bradgrantham/griffin/image-tools/smurf-assets/src/backdrop2-forest.png

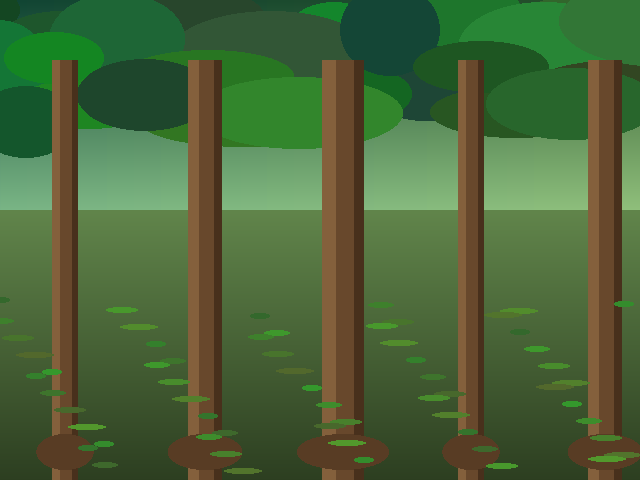
image-tools/smurf-assets/src/backdrop2-forest.png
