bradgrantham/griffin/image-tools/smurf-assets/backdrop1-meadow-preview.png

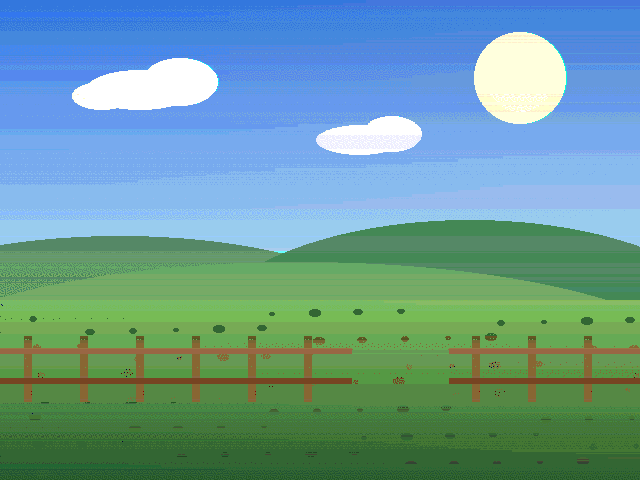
image-tools/smurf-assets/backdrop1-meadow-preview.png
