bradgrantham/griffin/README.md

# m68k-leftovers

An M68000 homebrew SBC.  See the [design notes](griffin.yml).
