bradgrantham/griffin/cpld/compositor/compositor_fit_report.txt

========================================================================
ATF1508 Fitter Report
========================================================================

UTILIZATION SUMMARY
----------------------------------------
  dedicated input                 2/4 	(50%)
  I/O pins                        64/64 	(100%)
  Logic cells                     122/128 	(95%)
  Flip-Flop                       95/128 	(74%)
  Foldback logic                  21/128 	(16%)
  Nodes+FB/MCells                 143/128 	(111%)
  cascade                         0
  input pins                      36
  output pins                     30
  Pts                             389

PER-LAB PLACEMENT
------------------------------------------------------------------------
  LAB A (MC 1-16):  29/16 used  (8 pin, 15 feedback, 6 foldback)  fan-in: 36/40
    MC  3  pin 12  VIDCMD_Q_15
    MC  5  pin 11  VIDCMD_Q_14
    MC  6  pin 10  VIDCMD_Q_9
    MC  8  pin  9  VIDCMD_Q_7
    MC 11  pin  8  RGB_IN_2
    MC 13  pin  6  RGB_IN_1
    MC 14  pin  5  H_ACTIVE
    MC 16  pin  4  set_pix_commit
    MC  1  feedback  staged_word_14
    MC  2  feedback  abc:n321
    MC  3  feedback  XXL_1025
    MC  4  feedback  abc:n341
    MC  5  feedback  sav_src_1
    MC  6  feedback  XXL_1021
    MC  7  feedback  staged_word_9
    MC  8  feedback  staged_word_11
    MC  9  feedback  abc:n325 (QN)
    MC 10  feedback  w_is_set
    MC 11  feedback  abc:n310 (QN)
    MC 12  feedback  abc:n644 (QN)
    MC 13  feedback  XXL_1017
    MC 14  feedback  staged_word_12
    MC 15  feedback  mask_active
    MC  1  FOLDBACK  abc:n340  [from id00117Q]
    MC  7  FOLDBACK  abc:n329 (QN)  [from id00106QN]
    MC  8  FOLDBACK  abc:n293 (QN)  [from id00071QN]
    MC 10  FOLDBACK  abc:n339  [from id00116Q]
    MC 11  FOLDBACK  abc:n295 (QN)  [from id00073QN]
    MC 12  FOLDBACK  abc:n287 (QN)  [from id00065QN]

  LAB B (MC 17-32):  25/16 used  (8 pin, 13 feedback, 4 foldback)  fan-in: 39/40
    MC 17  pin 22  RGB_IN_0
    MC 19  pin 21  RGB_IN_3
    MC 21  pin 20  RGB_IN_4
    MC 24  pin 18  RGB_IN_5
    MC 25  pin 17  RGB_IN_8
    MC 27  pin 16  RGB_IN_7
    MC 29  pin 15  RGB_IN_9
    MC 32  pin 14  TDI
    MC 20  feedback  h_active_d
    MC 21  feedback  staged_word_13
    MC 22  feedback  XXL_1024
    MC 23  feedback  staged_word_3
    MC 24  feedback  abc:n622
    MC 25  feedback  staged_word_5
    MC 26  feedback  staged_word_6
    MC 27  feedback  abc:n609
    MC 28  feedback  cur_src_0
    MC 29  feedback  staged_word_4
    MC 30  feedback  staged_word_2
    MC 31  feedback  abc:n611
    MC 32  feedback  cur_src_1
    MC 29  FOLDBACK  abc:n293 (QN)  [from id00071QN]
    MC 30  FOLDBACK  abc:n340  [from id00117Q]
    MC 31  FOLDBACK  abc:n339  [from id00116Q]
    MC 32  FOLDBACK  abc:n295 (QN)  [from id00073QN]

  LAB C (MC 33-48):  23/16 used  (8 pin, 12 feedback, 3 foldback)  fan-in: 39/40
    MC 35  pin 31  RGB_IN_11
    MC 37  pin 30  RGB_IN_10
    MC 38  pin 29  RGB_IN_6
    MC 40  pin 28  nVIDCMD_RE
    MC 43  pin 27  set_pix_value_7
    MC 45  pin 25  set_pix_target_2
    MC 46  pin 24  set_pix_valid
    MC 48  pin 23  TMS
    MC 33  feedback  ef_at_pop
    MC 34  feedback  staged_word_1
    MC 35  feedback  $abc$1392$nVIDCMD_RE
    MC 36  feedback  abc:n631 (QN)
    MC 37  feedback  abc:n308
    MC 38  feedback  staged_word_7
    MC 39  feedback  staged_word_10
    MC 41  feedback  run_count_0
    MC 42  feedback  run_count_1
    MC 44  feedback  abc:n650
    MC 47  feedback  abc:n653
    MC 48  feedback  XXL_1018
    MC 45  FOLDBACK  abc:n340  [from id00117Q]
    MC 46  FOLDBACK  abc:n339  [from id00116Q]
    MC 47  FOLDBACK  abc:n295 (QN)  [from id00073QN]

  LAB D (MC 49-64):  27/16 used  (8 pin, 13 feedback, 6 foldback)  fan-in: 39/40
    MC 49  pin 41  VIDCMD_Q_4
    MC 51  pin 40  VIDCMD_Q_2
    MC 53  pin 39  VIDCMD_Q_3
    MC 56  pin 37  VIDCMD_Q_6
    MC 57  pin 36  VIDCMD_Q_1
    MC 59  pin 35  VIDCMD_Q_5
    MC 61  pin 34  nVIDCMD_EF
    MC 64  pin 33  VIDCMD_Q_12
    MC 50  feedback  sav_src_0
    MC 52  feedback  cmp_color1_3
    MC 53  feedback  cmp_color1_2
    MC 54  feedback  cmp_color1_4
    MC 55  feedback  staged_word_0
    MC 56  feedback  abc:n617 (QN)
    MC 57  feedback  have_staged
    MC 59  feedback  staged_word_8
    MC 60  feedback  XXL_1023
    MC 61  feedback  XXL_1019
    MC 62  feedback  XXL_1020
    MC 63  feedback  run_count_3
    MC 64  feedback  XXL_1022
    MC 50  FOLDBACK  abc:n295 (QN)  [from id00073QN]
    MC 54  FOLDBACK  abc:n329 (QN)  [from id00106QN]
    MC 55  FOLDBACK  abc:n293 (QN)  [from id00071QN]
    MC 56  FOLDBACK  abc:n340  [from id00117Q]
    MC 57  FOLDBACK  abc:n339  [from id00116Q]
    MC 59  FOLDBACK  abc:n287 (QN)  [from id00065QN]

  LAB E (MC 65-80):  16/16 used  (8 pin, 8 feedback, 0 foldback)  fan-in: 39/40
    MC 65  pin 44  RGB_OUT_7
    MC 67  pin 45  RGB_OUT_8
    MC 69  pin 46  RGB_OUT_5
    MC 72  pin 48  RGB_OUT_4
    MC 73  pin 49  RGB_OUT_3
    MC 75  pin 50  RGB_OUT_0
    MC 77  pin 51  RGB_OUT_1
    MC 80  pin 52  RGB_OUT_2
    MC 66  feedback  cmp_color0_1
    MC 68  feedback  cmp_color0_5
    MC 70  feedback  cmp_color0_2
    MC 71  feedback  cmp_color1_8
    MC 74  feedback  cmp_color1_0
    MC 76  feedback  cmp_color1_7
    MC 78  feedback  cmp_color1_1
    MC 79  feedback  cmp_color1_5

  LAB F (MC 81-96):  18/16 used  (8 pin, 9 feedback, 1 foldback)  fan-in: 32/40
    MC 83  pin 54  set_pix_value_3
    MC 85  pin 55  set_pix_value_1
    MC 86  pin 56  set_pix_value_2
    MC 88  pin 57  RGB_OUT_6
    MC 91  pin 58  RGB_OUT_10
    MC 93  pin 60  RGB_OUT_11
    MC 94  pin 61  RGB_OUT_9
    MC 96  pin 62  TCK
    MC 81  feedback  cmp_color1_10
    MC 82  feedback  run_count_5
    MC 84  feedback  run_count_9
    MC 87  feedback  run_count_10
    MC 89  feedback  run_count_6
    MC 90  feedback  run_count_11
    MC 92  feedback  run_count_7
    MC 95  feedback  XXL_1027
    MC 96  feedback  XXL_1026
    MC 94  FOLDBACK  abc:n645  [from id00422Q]

  LAB G (MC 97-112):  23/16 used  (8 pin, 14 feedback, 1 foldback)  fan-in: 38/40
    MC 97  pin 63  VIDCMD_Q_10
    MC 99  pin 64  VIDCMD_Q_11
    MC101  pin 65  VIDCMD_Q_8
    MC104  pin 67  VIDCMD_Q_13
    MC105  pin 68  VIDCMD_Q_0
    MC107  pin 69  set_pix_value_0
    MC109  pin 70  set_pix_value_5
    MC112  pin 71  TDO
    MC 97  feedback  cmp_color0_0
    MC 98  feedback  cmp_color0_6
    MC 99  feedback  cmp_color1_11
    MC100  feedback  cmp_color0_9
    MC101  feedback  abc:n634 (QN)
    MC102  feedback  cmp_color0_10
    MC103  feedback  cur_colour_0
    MC104  feedback  cmp_color1_6
    MC105  feedback  cur_colour_2
    MC106  feedback  cmp_color1_9
    MC108  feedback  cur_colour_1
    MC110  feedback  cmp_color0_11
    MC111  feedback  cmp_color0_8
    MC112  feedback  abc:n627 (QN)
    MC112  FOLDBACK  abc:n340  [from id00117Q]

  LAB H (MC 113-128):  16/16 used  (8 pin, 8 feedback, 0 foldback)  fan-in: 22/40
    MC115  pin 73  set_pix_value_11
    MC117  pin 74  set_pix_value_10
    MC118  pin 75  set_pix_value_8
    MC120  pin 76  set_pix_value_9
    MC123  pin 77  set_pix_value_6
    MC125  pin 79  set_pix_value_4
    MC126  pin 80  set_pix_target_1
    MC128  pin 81  set_pix_target_0
    MC113  feedback  ef_sync
    MC114  feedback  ef_meta
    MC116  feedback  run_count_8
    MC119  feedback  run_count_2
    MC121  feedback  cmp_color0_7
    MC122  feedback  cmp_color0_3
    MC124  feedback  cmp_color0_4
    MC127  feedback  run_count_4

FOLDBACK ANALYSIS
------------------------------------------------------------------------
  Total foldbacks: 21

  Signals replicated as foldbacks (most replicas first):

    abc:n340                                  5 copies  in LABs: A, B, C, D, G
      consumed by: abc:n617 (QN), abc:n631 (QN), abc:n634 (QN), abc:n627 (QN), abc:n650, abc:n644 (QN), abc:n653, cur_colour_2.D ... +11 more

    abc:n339                                  4 copies  in LABs: A, B, C, D
      consumed by: abc:n609, abc:n611, run_count_1.D, abc:n622, abc:n341, run_count_3.D, XXL_1018, XXL_1019 ... +3 more

    abc:n295 (QN)                             4 copies  in LABs: A, B, C, D
      consumed by: abc:n609, abc:n308, abc:n611, run_count_1.D, abc:n622, run_count_3.D, XXL_1017, XXL_1018 ... +2 more

    abc:n293 (QN)                             3 copies  in LABs: A, B, D
      consumed by: sav_src_1.D, sav_src_0.D, abc:n341, cur_src_0.D, XXL_1025

    abc:n329 (QN)                             2 copies  in LABs: A, D
      consumed by: have_staged.D, XXL_1021, XXL_1025

    abc:n287 (QN)                             2 copies  in LABs: A, D
      consumed by: mask_active.D, have_staged.D, abc:n341

    abc:n645                                  1 copies  in LABs: F
      consumed by: run_count_10.D, run_count_11.D

  Foldback imports per LAB:

    LAB A: 6 foldback(s)
      - abc:n340
      - abc:n329 (QN)
      - abc:n293 (QN)
      - abc:n339
      - abc:n295 (QN)
      - abc:n287 (QN)
    LAB B: 4 foldback(s)
      - abc:n293 (QN)
      - abc:n340
      - abc:n339
      - abc:n295 (QN)
    LAB C: 3 foldback(s)
      - abc:n340
      - abc:n339
      - abc:n295 (QN)
    LAB D: 6 foldback(s)
      - abc:n295 (QN)
      - abc:n329 (QN)
      - abc:n293 (QN)
      - abc:n340
      - abc:n339
      - abc:n287 (QN)
    LAB F: 1 foldback(s)
      - abc:n645
    LAB G: 1 foldback(s)
      - abc:n340

FAN-IN DETAIL
------------------------------------------------------------------------
  LAB A: 36/40 inputs
    I/O pins (6): H_ACTIVE, VIDCMD_Q_14, VIDCMD_Q_15, VIDCMD_Q_9, VIDCMD_Q_11, VIDCMD_Q_12
    Internal (30):
      run_count_9
      staged_word_14
      abc:n310 (QN)
      staged_word_11
      run_count_3
      sav_src_1
      run_count_10
      staged_word_12
      staged_word_13
      w_is_set
      abc:n341
      run_count_0
      $abc$1392$nVIDCMD_RE
      run_count_7
      staged_word_9
      run_count_6
      abc:n308
      staged_word_7
      mask_active
      run_count_2
      cur_src_0
      run_count_5
      cur_src_1
      have_staged
      ef_at_pop
      run_count_1
      staged_word_10
      run_count_8
      run_count_11
      run_count_4

  LAB B: 39/40 inputs
    I/O pins (7): H_ACTIVE, VIDCMD_Q_6, VIDCMD_Q_4, VIDCMD_Q_13, VIDCMD_Q_5, VIDCMD_Q_2, VIDCMD_Q_3
    Internal (32):
      XXL_1021  (unmapped)
      XXL_1025  (unmapped)
      staged_word_3
      staged_word_14
      abc:n310 (QN)
      staged_word_11
      sav_src_1
      mask_active
      run_count_3
      staged_word_1
      staged_word_6
      w_is_set
      run_count_10
      run_count_1
      sav_src_0
      staged_word_2
      abc:n341
      run_count_0
      abc:n308
      have_staged
      staged_word_5
      run_count_5
      run_count_6
      staged_word_13
      staged_word_0
      run_count_11
      run_count_9
      staged_word_4
      run_count_8
      run_count_7
      run_count_2
      run_count_4

  LAB C: 39/40 inputs
    I/O pins (6): H_ACTIVE, VIDCMD_Q_7, VIDCMD_Q_10, VIDCMD_Q_1, nRS, nVIDCMD_EF
    Internal (33):
      XXL_1017  (unmapped)
      XXL_1018  (unmapped)
      ef_sync
      run_count_6
      staged_word_14
      staged_word_1
      mask_active
      staged_word_11
      abc:n310 (QN)
      run_count_10
      run_count_1
      $abc$1392$nVIDCMD_RE
      w_is_set
      run_count_9
      staged_word_8
      run_count_3
      abc:n308
      run_count_7
      staged_word_7
      run_count_0
      run_count_2
      staged_word_12
      staged_word_13
      run_count_4
      run_count_8
      have_staged
      run_count_5
      abc:n609
      staged_word_10
      run_count_11
      ef_meta
      staged_word_5
      ef_at_pop

  LAB D: 39/40 inputs
    I/O pins (4): H_ACTIVE, VIDCMD_Q_0, VIDCMD_Q_8, nRS
    Internal (35):
      XXL_1020  (unmapped)
      run_count_9
      run_count_0
      abc:n310 (QN)
      staged_word_14
      mask_active
      cmp_color1_2
      run_count_3
      sav_src_0
      staged_word_6
      $abc$1392$nVIDCMD_RE
      w_is_set
      run_count_10
      run_count_1
      cmp_color1_4
      staged_word_5
      staged_word_2
      cmp_color1_3
      staged_word_8
      abc:n308
      have_staged
      ef_at_pop
      abc:n611
      run_count_2
      abc:n321
      run_count_6
      run_count_8
      cur_src_0
      run_count_5
      run_count_11
      staged_word_0
      staged_word_4
      run_count_7
      staged_word_3
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
   4 PTs  staged_word_12.D
   4 PTs  staged_word_2.D
   4 PTs  staged_word_5.D
   4 PTs  staged_word_3.D
   4 PTs  staged_word_4.D
   4 PTs  staged_word_7.D
   4 PTs  staged_word_6.D
   4 PTs  staged_word_8.D
   4 PTs  run_count_3.D
   4 PTs  cur_src_1.D
   4 PTs  run_count_7.D

ALL EQUATIONS
------------------------------------------------------------------------
  [ 1 PTs]  nVIDCMD_RE = $abc$1392$nVIDCMD_RE
  [ 1 PTs]  set_pix_target_0.D = staged_word_12
  [ 1 PTs]  set_pix_target_1.D = staged_word_13
  [ 1 PTs]  set_pix_value_0.D = staged_word_0
  [ 1 PTs]  set_pix_value_1.D = staged_word_1
  [ 1 PTs]  set_pix_value_3.D = staged_word_3
  [ 1 PTs]  set_pix_value_2.D = staged_word_2
  [ 1 PTs]  set_pix_value_4.D = staged_word_4
  [ 1 PTs]  set_pix_value_5.D = staged_word_5
  [ 1 PTs]  set_pix_value_6.D = staged_word_6
  [ 1 PTs]  set_pix_value_7.D = staged_word_7
  [ 1 PTs]  set_pix_value_8.D = staged_word_8
  [ 1 PTs]  set_pix_value_9.D = staged_word_9
  [ 1 PTs]  set_pix_value_10.D = staged_word_10
  [ 1 PTs]  h_active_d.D = H_ACTIVE
  [ 1 PTs]  ef_meta.D = nVIDCMD_EF
  [ 1 PTs]  ef_sync.D = ef_meta
  [ 1 PTs]  set_pix_target_2.D = staged_word_14
  [ 1 PTs]  set_pix_value_11.D = staged_word_11
  [ 2 PTs]  ef_at_pop.D = (ef_at_pop # ($abc$1392$nVIDCMD_RE & ef_meta & ef_sync & nVIDCMD_EF))
  [ 3 PTs]  set_pix_valid.D = ((have_staged & !staged_word_14 & w_is_set & staged_word_13) # (have_staged & staged_word_14 & w_is_set & !staged_word_12) # (have_staged & staged_word_14 & w_is_set & !staged_word_13))
  [ 4 PTs]  abc:n310 (QN) = ((run_count_0 & run_count_1 & run_count_2 & run_count_3 & run_count_9 & run_count_4 & run_count_5 & run_count_10 & run_count_6 & run_count_11 & run_count_7 & run_count_8) # (run_count_0 & run_count_1 & run_count_2 & !run_count_3 & mask_active & !ef_at_pop) # (run_count_0 & run_count_1 & run_count_2 & !run_count_3 & mask_active & $abc$1392$nVIDCMD_RE) # !H_ACTIVE)
  [ 2 PTs]  mask_active.D = ((mask_active & abc:n287 (QN)QN) # (H_ACTIVE & run_count_9 & !w_is_set & staged_word_14 & run_count_0 & run_count_1 & run_count_2 & run_count_3 & run_count_4 & run_count_5 & run_count_10 & run_count_6 & have_staged & run_count_11 & run_count_7 & run_count_8))
  [ 2 PTs]  abc:n609 = ((run_count_0 & abc:n295 (QN)QN & staged_word_0) # (run_count_0 & abc:n295 (QN)QN & abc:n339Q))
  [ 3 PTs]  abc:n617 (QN) = ((run_count_5 & abc:n340Q) # (H_ACTIVE & run_count_9 & !w_is_set & run_count_0 & run_count_1 & run_count_2 & run_count_3 & run_count_4 & run_count_5 & run_count_10 & run_count_6 & have_staged & run_count_11 & run_count_7 & run_count_8 & staged_word_5) # (H_ACTIVE & run_count_9 & !w_is_set & staged_word_14 & run_count_0 & run_count_1 & run_count_2 & run_count_3 & run_count_4 & run_count_5 & run_count_10 & run_count_6 & have_staged & run_count_11 & run_count_7 & run_count_8))
  [ 3 PTs]  abc:n631 (QN) = ((run_count_7 & staged_word_7 & H_ACTIVE & run_count_9 & !w_is_set & run_count_0 & run_count_1 & run_count_2 & run_count_3 & run_count_4 & run_count_5 & run_count_10 & run_count_6 & have_staged & run_count_11 & run_count_8) # (run_count_7 & H_ACTIVE & run_count_9 & !w_is_set & staged_word_14 & run_count_0 & run_count_1 & run_count_2 & run_count_3 & run_count_4 & run_count_5 & run_count_10 & run_count_6 & have_staged & run_count_11 & run_count_8) # (run_count_7 & abc:n340Q))
  [ 3 PTs]  abc:n634 (QN) = ((run_count_6 & staged_word_6 & H_ACTIVE & run_count_9 & !w_is_set & run_count_0 & run_count_1 & run_count_2 & run_count_3 & run_count_4 & run_count_5 & run_count_10 & have_staged & run_count_11 & run_count_7 & run_count_8) # (run_count_6 & H_ACTIVE & run_count_9 & !w_is_set & staged_word_14 & run_count_0 & run_count_1 & run_count_2 & run_count_3 & run_count_4 & run_count_5 & run_count_10 & have_staged & run_count_11 & run_count_7 & run_count_8) # (run_count_6 & abc:n340Q))
  [ 3 PTs]  abc:n627 (QN) = ((run_count_8 & abc:n340Q) # (H_ACTIVE & run_count_9 & !w_is_set & run_count_0 & run_count_1 & run_count_2 & run_count_3 & run_count_4 & run_count_5 & run_count_10 & run_count_6 & have_staged & run_count_11 & run_count_7 & run_count_8 & staged_word_8) # (H_ACTIVE & run_count_9 & !w_is_set & staged_word_14 & run_count_0 & run_count_1 & run_count_2 & run_count_3 & run_count_4 & run_count_5 & run_count_10 & run_count_6 & have_staged & run_count_11 & run_count_7 & run_count_8))
  [ 4 PTs]  abc:n650 = ((run_count_11 & !w_is_set & staged_word_12 & staged_word_13 & !staged_word_14) # (run_count_11 & !w_is_set & staged_word_14 & H_ACTIVE & run_count_9 & run_count_0 & run_count_1 & run_count_2 & run_count_3 & run_count_4 & run_count_5 & run_count_10 & run_count_6 & have_staged & run_count_7 & run_count_8) # (run_count_11 & staged_word_11) # (run_count_11 & abc:n340Q))
  [ 4 PTs]  abc:n644 (QN) = ((run_count_9 & !w_is_set & !staged_word_14 & staged_word_12 & staged_word_13) # (run_count_9 & abc:n340Q) # (run_count_9 & staged_word_9) # (H_ACTIVE & run_count_9 & !w_is_set & staged_word_14 & run_count_0 & run_count_1 & run_count_2 & run_count_3 & run_count_4 & run_count_5 & run_count_10 & run_count_6 & have_staged & run_count_11 & run_count_7 & run_count_8))
  [ 4 PTs]  abc:n653 = ((run_count_10 & !w_is_set & staged_word_12 & staged_word_13 & !staged_word_14) # (run_count_10 & !w_is_set & staged_word_14 & H_ACTIVE & run_count_9 & run_count_0 & run_count_1 & run_count_2 & run_count_3 & run_count_4 & run_count_5 & run_count_6 & have_staged & run_count_11 & run_count_7 & run_count_8) # (run_count_10 & staged_word_10) # (run_count_10 & abc:n340Q))
  [ 4 PTs]  RGB_OUT_2.D = ((h_active_d & cur_src_0 & !cur_src_1 & cmp_color1_2) # (h_active_d & cur_src_0 & cur_src_1 & cur_colour_0) # (h_active_d & !cur_src_0 & !cur_src_1 & RGB_IN_2) # (h_active_d & !cur_src_0 & cur_src_1 & cmp_color0_2))
  [ 4 PTs]  RGB_OUT_0.D = ((h_active_d & cur_src_0 & !cur_src_1 & cmp_color1_0) # (h_active_d & cur_src_0 & cur_src_1 & cur_colour_0) # (h_active_d & !cur_src_0 & !cur_src_1 & RGB_IN_0) # (h_active_d & !cur_src_0 & cur_src_1 & cmp_color0_0))
  [ 4 PTs]  RGB_OUT_1.D = ((h_active_d & cur_src_0 & !cur_src_1 & cmp_color1_1) # (h_active_d & cur_src_0 & cur_src_1 & cur_colour_0) # (h_active_d & !cur_src_0 & !cur_src_1 & RGB_IN_1) # (h_active_d & !cur_src_0 & cur_src_1 & cmp_color0_1))
  [ 4 PTs]  RGB_OUT_5.D = ((h_active_d & cur_src_0 & !cur_src_1 & cmp_color1_5) # (h_active_d & cur_src_0 & cur_src_1 & cur_colour_1) # (h_active_d & !cur_src_0 & !cur_src_1 & RGB_IN_5) # (h_active_d & !cur_src_0 & cur_src_1 & cmp_color0_5))
  [ 4 PTs]  RGB_OUT_3.D = ((h_active_d & cur_src_0 & !cur_src_1 & cmp_color1_3) # (h_active_d & !cur_src_0 & cur_src_1 & cmp_color0_3) # (h_active_d & cur_src_0 & cur_src_1 & cur_colour_0) # (h_active_d & !cur_src_0 & !cur_src_1 & RGB_IN_3))
  [ 4 PTs]  RGB_OUT_4.D = ((h_active_d & cur_src_0 & !cur_src_1 & cmp_color1_4) # (h_active_d & cur_src_0 & cur_src_1 & cur_colour_1) # (h_active_d & !cur_src_0 & !cur_src_1 & RGB_IN_4) # (h_active_d & !cur_src_0 & cur_src_1 & cmp_color0_4))
  [ 4 PTs]  RGB_OUT_8.D = ((h_active_d & cur_src_0 & !cur_src_1 & cmp_color1_8) # (h_active_d & cur_src_0 & cur_src_1 & cur_colour_2) # (h_active_d & !cur_src_0 & !cur_src_1 & RGB_IN_8) # (h_active_d & !cur_src_0 & cur_src_1 & cmp_color0_8))
  [ 4 PTs]  RGB_OUT_6.D = ((h_active_d & cur_src_0 & !cur_src_1 & cmp_color1_6) # (h_active_d & cur_src_0 & cur_src_1 & cur_colour_1) # (h_active_d & !cur_src_0 & !cur_src_1 & RGB_IN_6) # (h_active_d & !cur_src_0 & cur_src_1 & cmp_color0_6))
  [ 4 PTs]  RGB_OUT_7.D = ((h_active_d & cur_src_0 & !cur_src_1 & cmp_color1_7) # (h_active_d & !cur_src_0 & cur_src_1 & cmp_color0_7) # (h_active_d & cur_src_0 & cur_src_1 & cur_colour_1) # (h_active_d & !cur_src_0 & !cur_src_1 & RGB_IN_7))
  [ 4 PTs]  RGB_OUT_9.D = ((h_active_d & cur_src_0 & !cur_src_1 & cmp_color1_9) # (h_active_d & cur_src_0 & cur_src_1 & cur_colour_2) # (h_active_d & !cur_src_0 & !cur_src_1 & RGB_IN_9) # (h_active_d & !cur_src_0 & cur_src_1 & cmp_color0_9))
  [ 4 PTs]  RGB_OUT_10.D = ((h_active_d & cur_src_0 & !cur_src_1 & cmp_color1_10) # (h_active_d & !cur_src_0 & cur_src_1 & cmp_color0_10) # (h_active_d & cur_src_0 & cur_src_1 & cur_colour_2) # (h_active_d & !cur_src_0 & !cur_src_1 & RGB_IN_10))
  [ 4 PTs]  RGB_OUT_11.D = ((h_active_d & cur_src_0 & !cur_src_1 & cmp_color1_11) # (h_active_d & cur_src_0 & cur_src_1 & cur_colour_2) # (h_active_d & !cur_src_0 & !cur_src_1 & RGB_IN_11) # (h_active_d & !cur_src_0 & cur_src_1 & cmp_color0_11))
  [ 2 PTs]  cur_colour_2.D = ((abc:n340Q & cur_colour_2) # (staged_word_11 & H_ACTIVE & run_count_9 & !w_is_set & !staged_word_14 & run_count_0 & run_count_1 & run_count_2 & run_count_3 & run_count_4 & run_count_5 & run_count_10 & run_count_6 & have_staged & run_count_11 & run_count_7 & run_count_8))
  [ 3 PTs]  abc:n308 = ((ef_at_pop & !$abc$1392$nVIDCMD_RE & abc:n295 (QN)QN & run_count_9 & run_count_0 & run_count_1 & run_count_2 & run_count_3 & run_count_4 & run_count_5 & run_count_10 & run_count_6 & run_count_11 & run_count_7 & run_count_8 & !have_staged) # (ef_at_pop & !$abc$1392$nVIDCMD_RE & abc:n295 (QN)QN & H_ACTIVE & run_count_9 & run_count_0 & run_count_1 & run_count_2 & run_count_3 & run_count_4 & run_count_5 & run_count_10 & run_count_6 & run_count_11 & run_count_7 & run_count_8) # XXL_1017)
  [ 2 PTs]  cur_colour_0.D = ((abc:n340Q & cur_colour_0) # (staged_word_9 & H_ACTIVE & run_count_9 & !w_is_set & !staged_word_14 & run_count_0 & run_count_1 & run_count_2 & run_count_3 & run_count_4 & run_count_5 & run_count_10 & run_count_6 & have_staged & run_count_11 & run_count_7 & run_count_8))
  [ 2 PTs]  cur_colour_1.D = ((abc:n340Q & cur_colour_1) # (staged_word_10 & H_ACTIVE & run_count_9 & !w_is_set & !staged_word_14 & run_count_0 & run_count_1 & run_count_2 & run_count_3 & run_count_4 & run_count_5 & run_count_10 & run_count_6 & have_staged & run_count_11 & run_count_7 & run_count_8))
  [ 3 PTs]  sav_src_1.D = ((sav_src_1 & abc:n293 (QN)QN) # (!mask_active & cur_src_1 & H_ACTIVE & !w_is_set & staged_word_14 & have_staged & run_count_6 & run_count_5 & run_count_4 & run_count_11 & run_count_10 & run_count_9 & run_count_8 & run_count_7 & run_count_0 & run_count_2 & run_count_1 & run_count_3) # (mask_active & sav_src_1))
  [ 3 PTs]  sav_src_0.D = ((sav_src_0 & abc:n293 (QN)QN) # (!mask_active & cur_src_0 & H_ACTIVE & !w_is_set & staged_word_14 & have_staged & run_count_6 & run_count_5 & run_count_4 & run_count_11 & run_count_10 & run_count_9 & run_count_8 & run_count_7 & run_count_0 & run_count_2 & run_count_1 & run_count_3) # (mask_active & sav_src_0))
  [ 2 PTs]  abc:n321 = ((!staged_word_13 & !staged_word_14 & w_is_set & have_staged & !staged_word_12 & !H_ACTIVE) # (!staged_word_13 & !staged_word_14 & w_is_set & have_staged & !staged_word_12 & run_count_9 & run_count_0 & run_count_1 & run_count_2 & run_count_3 & run_count_4 & run_count_5 & run_count_10 & run_count_6 & run_count_11 & run_count_7 & run_count_8))
  [ 2 PTs]  abc:n325 (QN) = ((w_is_set & staged_word_12 & !staged_word_13 & !staged_word_14 & have_staged & run_count_9 & run_count_0 & run_count_1 & run_count_2 & run_count_3 & run_count_4 & run_count_5 & run_count_10 & run_count_6 & run_count_11 & run_count_7 & run_count_8) # (w_is_set & staged_word_12 & !staged_word_13 & !staged_word_14 & have_staged & !H_ACTIVE))
  [ 4 PTs]  w_is_set.D = ((!abc:n308Q & w_is_set & abc:n310 (QN)QN) # (!abc:n308Q & mask_active & !abc:n310 (QN)QN & staged_word_13) # (abc:n308Q & VIDCMD_Q_15) # (!abc:n308Q & !mask_active & w_is_set))
  [ 4 PTs]  abc:n611 = ((run_count_1 & abc:n295 (QN)QN & run_count_0 & staged_word_1 & staged_word_0 & !abc:n310 (QN)QN) # (run_count_1 & abc:n295 (QN)QN & run_count_0 & abc:n339Q & !abc:n310 (QN)QN) # (run_count_1 & abc:n295 (QN)QN & run_count_0 & H_ACTIVE & run_count_9 & !w_is_set & !staged_word_14 & run_count_2 & run_count_3 & run_count_4 & run_count_5 & run_count_10 & run_count_6 & have_staged & run_count_11 & run_count_7 & run_count_8 & staged_word_1 & staged_word_0) # (run_count_1 & abc:n295 (QN)QN & run_count_0 & abc:n339Q & H_ACTIVE & run_count_9 & !w_is_set & !staged_word_14 & run_count_2 & run_count_3 & run_count_4 & run_count_5 & run_count_10 & run_count_6 & have_staged & run_count_11 & run_count_7 & run_count_8))
  [ 3 PTs]  run_count_0.D = ((!abc:n609Q & H_ACTIVE & run_count_9 & !w_is_set & !staged_word_14 & run_count_0 & run_count_1 & run_count_2 & run_count_3 & run_count_4 & run_count_5 & run_count_10 & run_count_6 & have_staged & run_count_11 & run_count_7 & run_count_8) # (!abc:n609Q & !abc:n310 (QN)QN) # (abc:n609Q & abc:n310 (QN)QN & abc:n340Q))
  [ 4 PTs]  staged_word_13.D = ((!abc:n308Q & staged_word_13 & abc:n310 (QN)QN) # (!abc:n308Q & mask_active & !abc:n310 (QN)QN & staged_word_11) # (abc:n308Q & VIDCMD_Q_13) # (!abc:n308Q & !mask_active & staged_word_13))
  [ 4 PTs]  staged_word_14.D = ((!abc:n308Q & staged_word_14 & abc:n310 (QN)QN) # (!abc:n308Q & mask_active & !abc:n310 (QN)QN & staged_word_12) # (abc:n308Q & VIDCMD_Q_14) # (!abc:n308Q & !mask_active & staged_word_14))
  [ 3 PTs]  have_staged.D = ((!abc:n308Q & have_staged & !H_ACTIVE & !w_is_set) # (!abc:n308Q & have_staged & H_ACTIVE & abc:n287 (QN)QN) # (abc:n308Q & abc:n329 (QN)QN))
  [ 3 PTs]  run_count_1.D = ((!abc:n609Q & run_count_1 & abc:n295 (QN)QN & abc:n339Q) # (abc:n609Q & !run_count_1 & !abc:n310 (QN)QN) # XXL_1018)
  [ 3 PTs]  abc:n622 = ((run_count_0 & run_count_1 & run_count_2 & run_count_3 & abc:n295 (QN)QN & run_count_4 & abc:n340Q & !abc:n310 (QN)QN & abc:n339Q) # (run_count_0 & run_count_1 & run_count_2 & run_count_3 & abc:n295 (QN)QN & staged_word_0 & staged_word_1 & staged_word_2 & staged_word_3 & run_count_4 & abc:n340Q & !abc:n310 (QN)QN) # (run_count_0 & run_count_1 & run_count_2 & run_count_3 & abc:n295 (QN)QN & staged_word_0 & staged_word_1 & staged_word_2 & staged_word_3 & run_count_4 & staged_word_4 & H_ACTIVE & run_count_9 & !w_is_set & !staged_word_14 & run_count_5 & run_count_10 & run_count_6 & have_staged & run_count_11 & run_count_7 & run_count_8))
  [ 2 PTs]  abc:n341 = ((abc:n293 (QN)QN & abc:n339Q & !mask_active) # (abc:n293 (QN)QN & abc:n339Q & abc:n310 (QN)QN & abc:n287 (QN)QN))
  [ 2 PTs]  cmp_color0_2.D = ((!abc:n325 (QN)QN & cmp_color0_2) # (abc:n325 (QN)QN & staged_word_2))
  [ 4 PTs]  staged_word_9.D = ((abc:n308Q & VIDCMD_Q_9) # (!abc:n308Q & mask_active & !abc:n310 (QN)QN & staged_word_7) # (!abc:n308Q & staged_word_9 & abc:n310 (QN)QN) # (!abc:n308Q & staged_word_9 & !mask_active))
  [ 4 PTs]  staged_word_10.D = ((abc:n308Q & VIDCMD_Q_10) # (!abc:n308Q & mask_active & !abc:n310 (QN)QN & staged_word_8) # (!abc:n308Q & staged_word_10 & abc:n310 (QN)QN) # (!abc:n308Q & staged_word_10 & !mask_active))
  [ 2 PTs]  cmp_color0_3.D = ((!abc:n325 (QN)QN & cmp_color0_3) # (abc:n325 (QN)QN & staged_word_3))
  [ 4 PTs]  staged_word_11.D = ((abc:n308Q & VIDCMD_Q_11) # (!abc:n308Q & mask_active & !abc:n310 (QN)QN & staged_word_9) # (!abc:n308Q & staged_word_11 & abc:n310 (QN)QN) # (!abc:n308Q & staged_word_11 & !mask_active))
  [ 4 PTs]  staged_word_12.D = ((abc:n308Q & VIDCMD_Q_12) # (!abc:n308Q & mask_active & !abc:n310 (QN)QN & staged_word_10) # (!abc:n308Q & staged_word_12 & abc:n310 (QN)QN) # (!abc:n308Q & staged_word_12 & !mask_active))
  [ 2 PTs]  cmp_color0_5.D = ((!abc:n325 (QN)QN & cmp_color0_5) # (abc:n325 (QN)QN & staged_word_5))
  [ 1 PTs]  run_count_2.D = (XXL_1019)
  [ 2 PTs]  cmp_color0_4.D = ((!abc:n325 (QN)QN & cmp_color0_4) # (abc:n325 (QN)QN & staged_word_4))
  [ 2 PTs]  cmp_color0_8.D = ((!abc:n325 (QN)QN & cmp_color0_8) # (abc:n325 (QN)QN & staged_word_8))
  [ 2 PTs]  cmp_color0_6.D = ((!abc:n325 (QN)QN & cmp_color0_6) # (abc:n325 (QN)QN & staged_word_6))
  [ 2 PTs]  cmp_color0_7.D = ((!abc:n325 (QN)QN & cmp_color0_7) # (abc:n325 (QN)QN & staged_word_7))
  [ 2 PTs]  cmp_color0_10.D = ((!abc:n325 (QN)QN & cmp_color0_10) # (abc:n325 (QN)QN & staged_word_10))
  [ 2 PTs]  cmp_color1_11.D = ((!abc:n321Q & cmp_color1_11) # (abc:n321Q & staged_word_11))
  [ 2 PTs]  cmp_color0_9.D = ((!abc:n325 (QN)QN & cmp_color0_9) # (abc:n325 (QN)QN & staged_word_9))
  [ 2 PTs]  cmp_color1_2.D = ((!abc:n321Q & cmp_color1_2) # (abc:n321Q & staged_word_2))
  [ 2 PTs]  cmp_color1_0.D = ((!abc:n321Q & cmp_color1_0) # (abc:n321Q & staged_word_0))
  [ 2 PTs]  cmp_color1_1.D = ((!abc:n321Q & cmp_color1_1) # (abc:n321Q & staged_word_1))
  [ 2 PTs]  cmp_color1_5.D = ((!abc:n321Q & cmp_color1_5) # (abc:n321Q & staged_word_5))
  [ 2 PTs]  cmp_color1_3.D = ((!abc:n321Q & cmp_color1_3) # (abc:n321Q & staged_word_3))
  [ 2 PTs]  cmp_color1_4.D = ((!abc:n321Q & cmp_color1_4) # (abc:n321Q & staged_word_4))
  [ 2 PTs]  cmp_color1_8.D = ((!abc:n321Q & cmp_color1_8) # (abc:n321Q & staged_word_8))
  [ 2 PTs]  cmp_color1_6.D = ((!abc:n321Q & cmp_color1_6) # (abc:n321Q & staged_word_6))
  [ 2 PTs]  cmp_color1_7.D = ((!abc:n321Q & cmp_color1_7) # (abc:n321Q & staged_word_7))
  [ 2 PTs]  cmp_color1_10.D = ((!abc:n321Q & cmp_color1_10) # (abc:n321Q & staged_word_10))
  [ 2 PTs]  cmp_color0_11.D = ((!abc:n325 (QN)QN & cmp_color0_11) # (abc:n325 (QN)QN & staged_word_11))
  [ 2 PTs]  cmp_color1_9.D = ((!abc:n321Q & cmp_color1_9) # (abc:n321Q & staged_word_9))
  [ 4 PTs]  staged_word_2.D = ((abc:n308Q & VIDCMD_Q_2) # (!abc:n308Q & mask_active & !abc:n310 (QN)QN & staged_word_0) # (!abc:n308Q & staged_word_2 & abc:n310 (QN)QN) # (!abc:n308Q & staged_word_2 & !mask_active))
  [ 3 PTs]  staged_word_0.D = ((!abc:n308Q & staged_word_0 & abc:n310 (QN)QN) # (!abc:n308Q & staged_word_0 & !mask_active) # (abc:n308Q & VIDCMD_Q_0))
  [ 3 PTs]  staged_word_1.D = ((!abc:n308Q & staged_word_1 & abc:n310 (QN)QN) # (!abc:n308Q & staged_word_1 & !mask_active) # (abc:n308Q & VIDCMD_Q_1))
  [ 4 PTs]  staged_word_5.D = ((abc:n308Q & VIDCMD_Q_5) # (!abc:n308Q & mask_active & !abc:n310 (QN)QN & staged_word_3) # (!abc:n308Q & staged_word_5 & abc:n310 (QN)QN) # (!abc:n308Q & staged_word_5 & !mask_active))
  [ 4 PTs]  staged_word_3.D = ((abc:n308Q & VIDCMD_Q_3) # (!abc:n308Q & mask_active & !abc:n310 (QN)QN & staged_word_1) # (!abc:n308Q & staged_word_3 & abc:n310 (QN)QN) # (!abc:n308Q & staged_word_3 & !mask_active))
  [ 4 PTs]  staged_word_4.D = ((abc:n308Q & VIDCMD_Q_4) # (!abc:n308Q & mask_active & !abc:n310 (QN)QN & staged_word_2) # (!abc:n308Q & staged_word_4 & abc:n310 (QN)QN) # (!abc:n308Q & staged_word_4 & !mask_active))
  [ 4 PTs]  staged_word_7.D = ((abc:n308Q & VIDCMD_Q_7) # (!abc:n308Q & mask_active & !abc:n310 (QN)QN & staged_word_5) # (!abc:n308Q & staged_word_7 & abc:n310 (QN)QN) # (!abc:n308Q & staged_word_7 & !mask_active))
  [ 4 PTs]  staged_word_6.D = ((abc:n308Q & VIDCMD_Q_6) # (!abc:n308Q & mask_active & !abc:n310 (QN)QN & staged_word_4) # (!abc:n308Q & staged_word_6 & abc:n310 (QN)QN) # (!abc:n308Q & staged_word_6 & !mask_active))
  [ 2 PTs]  cmp_color0_0.D = ((!abc:n325 (QN)QN & cmp_color0_0) # (abc:n325 (QN)QN & staged_word_0))
  [ 4 PTs]  staged_word_8.D = ((abc:n308Q & VIDCMD_Q_8) # (!abc:n308Q & mask_active & !abc:n310 (QN)QN & staged_word_6) # (!abc:n308Q & staged_word_8 & abc:n310 (QN)QN) # (!abc:n308Q & staged_word_8 & !mask_active))
  [ 2 PTs]  cmp_color0_1.D = ((!abc:n325 (QN)QN & cmp_color0_1) # (abc:n325 (QN)QN & staged_word_1))
  [ 4 PTs]  run_count_3.D = ((run_count_3 & abc:n295 (QN)QN & !abc:n611Q & abc:n339Q) # (!run_count_3 & abc:n295 (QN)QN & abc:n611Q & run_count_2 & staged_word_2) # (!run_count_3 & abc:n295 (QN)QN & abc:n611Q & run_count_2 & abc:n339Q) # XXL_1020)
  [ 4 PTs]  cur_src_1.D = ((!abc:n341Q & !mask_active & sav_src_1 & abc:n340Q) # (!abc:n341Q & staged_word_13 & H_ACTIVE & run_count_9 & !w_is_set & run_count_0 & run_count_1 & run_count_2 & run_count_3 & run_count_4 & run_count_5 & run_count_10 & run_count_6 & have_staged & run_count_11 & run_count_7 & run_count_8 & abc:n310 (QN)QN) # (!abc:n341Q & staged_word_13 & H_ACTIVE & run_count_9 & !w_is_set & run_count_0 & run_count_1 & run_count_2 & run_count_3 & run_count_4 & run_count_5 & run_count_10 & run_count_6 & have_staged & run_count_11 & run_count_7 & run_count_8 & !mask_active) # XXL_1021)
  [ 3 PTs]  run_count_4.D = (XXL_1022 # XXL_1023 # XXL_1024)
  [ 2 PTs]  run_count_5.D = ((!abc:n617 (QN)QN & abc:n622Q) # (abc:n617 (QN)QN & !abc:n622Q))
  [ 3 PTs]  cur_src_0.D = ((!abc:n341Q & abc:n293 (QN)QN & abc:n340Q & sav_src_0 & abc:n310 (QN)QN) # (!abc:n341Q & abc:n293 (QN)QN & abc:n340Q & sav_src_0 & !mask_active) # XXL_1025)
  [ 2 PTs]  run_count_10.D = ((abc:n653Q & abc:n645Q) # (!abc:n653Q & abc:n617 (QN)QN & abc:n622Q & abc:n627 (QN)QN & abc:n631 (QN)QN & abc:n634 (QN)QN & abc:n644 (QN)QN))
  [ 2 PTs]  run_count_9.D = ((abc:n644 (QN)QN & !abc:n622Q) # XXL_1026)
  [ 4 PTs]  run_count_7.D = ((!abc:n631 (QN)QN & abc:n634 (QN)QN & abc:n622Q & abc:n617 (QN)QN) # (abc:n631 (QN)QN & !abc:n617 (QN)QN) # (abc:n631 (QN)QN & !abc:n622Q) # (abc:n631 (QN)QN & !abc:n634 (QN)QN))
  [ 3 PTs]  run_count_6.D = ((!abc:n634 (QN)QN & abc:n622Q & abc:n617 (QN)QN) # (abc:n634 (QN)QN & !abc:n617 (QN)QN) # (abc:n634 (QN)QN & !abc:n622Q))
  [ 3 PTs]  run_count_11.D = ((abc:n650Q & !abc:n653Q) # (!abc:n650Q & abc:n653Q & abc:n617 (QN)QN & abc:n622Q & abc:n627 (QN)QN & abc:n631 (QN)QN & abc:n634 (QN)QN & abc:n644 (QN)QN) # (abc:n650Q & abc:n645Q))
  [ 1 PTs]  run_count_8.D = (XXL_1027)
  [ 5 PTs]  XXL_1017 = ((ef_at_pop & !$abc$1392$nVIDCMD_RE & abc:n295 (QN)QN & !H_ACTIVE & !mask_active & w_is_set) # (ef_at_pop & !$abc$1392$nVIDCMD_RE & abc:n295 (QN)QN & run_count_9 & run_count_0 & run_count_1 & run_count_2 & run_count_3 & run_count_4 & run_count_5 & run_count_10 & run_count_6 & run_count_11 & run_count_7 & run_count_8 & w_is_set) # (ef_at_pop & !$abc$1392$nVIDCMD_RE & H_ACTIVE & run_count_0 & run_count_1 & run_count_2 & !run_count_3 & mask_active & !have_staged) # (ef_at_pop & !$abc$1392$nVIDCMD_RE & H_ACTIVE & !run_count_0 & run_count_1 & run_count_2 & run_count_3 & mask_active & !have_staged) # (ef_at_pop & !$abc$1392$nVIDCMD_RE & abc:n295 (QN)QN & !mask_active & !have_staged))
  [ 5 PTs]  XXL_1018 = ((abc:n609Q & !abc:n310 (QN)QN & H_ACTIVE & run_count_9 & !w_is_set & staged_word_14 & run_count_0 & run_count_2 & run_count_3 & run_count_4 & run_count_5 & run_count_10 & run_count_6 & have_staged & run_count_11 & run_count_7 & run_count_8) # (abc:n609Q & run_count_1 & H_ACTIVE & run_count_9 & !w_is_set & !staged_word_14 & run_count_0 & run_count_2 & run_count_3 & run_count_4 & run_count_5 & run_count_10 & run_count_6 & have_staged & run_count_11 & run_count_7 & run_count_8 & !staged_word_1) # (run_count_1 & abc:n310 (QN)QN & staged_word_1 & abc:n340Q & abc:n295 (QN)QN) # (run_count_1 & abc:n310 (QN)QN & abc:n340Q & abc:n295 (QN)QN & abc:n339Q) # (!abc:n609Q & run_count_1 & staged_word_1 & abc:n295 (QN)QN))
  [ 5 PTs]  XXL_1019 = ((abc:n611Q & !run_count_2) # (abc:n611Q & H_ACTIVE & run_count_9 & !w_is_set & staged_word_14 & run_count_0 & run_count_1 & run_count_3 & run_count_4 & run_count_5 & run_count_10 & run_count_6 & have_staged & run_count_11 & run_count_7 & run_count_8) # (abc:n611Q & H_ACTIVE & run_count_9 & !w_is_set & run_count_0 & run_count_1 & run_count_3 & run_count_4 & run_count_5 & run_count_10 & run_count_6 & have_staged & run_count_11 & run_count_7 & run_count_8 & !staged_word_2) # (!abc:n611Q & abc:n295 (QN)QN & run_count_2 & staged_word_2) # (!abc:n611Q & abc:n295 (QN)QN & run_count_2 & abc:n339Q))
  [ 5 PTs]  XXL_1020 = ((abc:n295 (QN)QN & abc:n611Q & run_count_2 & staged_word_2 & !staged_word_3 & H_ACTIVE & run_count_9 & !w_is_set & !staged_word_14 & run_count_0 & run_count_1 & run_count_4 & run_count_5 & run_count_10 & run_count_6 & have_staged & run_count_11 & run_count_7 & run_count_8) # (run_count_3 & abc:n295 (QN)QN & !run_count_2 & staged_word_3) # (run_count_3 & abc:n295 (QN)QN & !staged_word_2 & staged_word_3 & H_ACTIVE & run_count_9 & !w_is_set & !staged_word_14 & run_count_0 & run_count_1 & run_count_4 & run_count_5 & run_count_10 & run_count_6 & have_staged & run_count_11 & run_count_7 & run_count_8) # (run_count_3 & abc:n295 (QN)QN & !abc:n611Q & staged_word_3) # (run_count_3 & abc:n295 (QN)QN & !run_count_2 & abc:n339Q))
  [ 5 PTs]  XXL_1021 = ((abc:n341Q & cur_src_1) # (!abc:n341Q & H_ACTIVE & run_count_0 & run_count_1 & run_count_2 & !run_count_3 & mask_active & !abc:n310 (QN)QN & VIDCMD_Q_15 & !VIDCMD_Q_14 & ef_at_pop & !$abc$1392$nVIDCMD_RE) # (!abc:n341Q & H_ACTIVE & run_count_9 & !w_is_set & run_count_0 & run_count_1 & run_count_2 & run_count_3 & run_count_4 & run_count_5 & run_count_10 & run_count_6 & have_staged & run_count_11 & run_count_7 & run_count_8 & staged_word_14) # (!abc:n341Q & staged_word_13 & mask_active & !abc:n310 (QN)QN & abc:n329 (QN)QN & !staged_word_12) # (!abc:n341Q & abc:n310 (QN)QN & sav_src_1 & abc:n340Q))
  [ 5 PTs]  XXL_1022 = ((run_count_4 & abc:n340Q & !abc:n611Q) # (run_count_2 & staged_word_4 & H_ACTIVE & run_count_9 & !w_is_set & run_count_0 & run_count_1 & run_count_3 & run_count_4 & run_count_5 & run_count_10 & run_count_6 & have_staged & run_count_11 & run_count_7 & run_count_8 & !abc:n611Q) # (run_count_2 & !staged_word_4 & run_count_3 & !run_count_4 & staged_word_2 & abc:n611Q & staged_word_3) # (run_count_2 & run_count_3 & !run_count_4 & abc:n611Q & abc:n339Q) # (run_count_2 & !staged_word_4 & H_ACTIVE & run_count_9 & !w_is_set & run_count_0 & run_count_1 & run_count_3 & run_count_5 & run_count_10 & run_count_6 & have_staged & run_count_11 & run_count_7 & run_count_8 & staged_word_2 & abc:n611Q & staged_word_3))
  [ 5 PTs]  XXL_1023 = ((run_count_2 & H_ACTIVE & run_count_9 & !w_is_set & run_count_0 & run_count_1 & run_count_3 & run_count_5 & run_count_10 & run_count_6 & have_staged & run_count_11 & run_count_7 & run_count_8 & abc:n611Q & abc:n339Q) # (!run_count_3 & run_count_4 & abc:n340Q) # (H_ACTIVE & run_count_9 & !w_is_set & run_count_0 & run_count_1 & run_count_4 & run_count_5 & run_count_10 & run_count_6 & have_staged & run_count_11 & run_count_7 & run_count_8 & abc:n340Q & !staged_word_3) # (run_count_2 & staged_word_4 & H_ACTIVE & run_count_9 & !w_is_set & run_count_0 & run_count_1 & run_count_3 & run_count_4 & run_count_5 & run_count_10 & run_count_6 & have_staged & run_count_11 & run_count_7 & run_count_8 & !staged_word_3) # (run_count_2 & H_ACTIVE & run_count_9 & !w_is_set & run_count_0 & run_count_1 & run_count_3 & run_count_4 & run_count_5 & run_count_10 & run_count_6 & have_staged & run_count_11 & run_count_7 & run_count_8 & staged_word_14))
  [ 3 PTs]  XXL_1024 = ((!run_count_2 & run_count_4 & abc:n340Q) # (H_ACTIVE & run_count_9 & !w_is_set & run_count_0 & run_count_1 & run_count_4 & run_count_5 & run_count_10 & run_count_6 & have_staged & run_count_11 & run_count_7 & run_count_8 & !staged_word_2 & abc:n340Q) # (run_count_2 & staged_word_4 & H_ACTIVE & run_count_9 & !w_is_set & run_count_0 & run_count_1 & run_count_3 & run_count_4 & run_count_5 & run_count_10 & run_count_6 & have_staged & run_count_11 & run_count_7 & run_count_8 & !staged_word_2))
  [ 5 PTs]  XXL_1025 = ((!abc:n341Q & abc:n293 (QN)QN & abc:n310 (QN)QN & staged_word_12 & H_ACTIVE & run_count_9 & !w_is_set & !staged_word_14 & run_count_0 & run_count_1 & run_count_2 & run_count_3 & run_count_4 & run_count_5 & run_count_10 & run_count_6 & have_staged & run_count_11 & run_count_7 & run_count_8) # (!abc:n341Q & abc:n293 (QN)QN & !mask_active & staged_word_12 & H_ACTIVE & run_count_9 & !w_is_set & !staged_word_14 & run_count_0 & run_count_1 & run_count_2 & run_count_3 & run_count_4 & run_count_5 & run_count_10 & run_count_6 & have_staged & run_count_11 & run_count_7 & run_count_8) # (abc:n341Q & cur_src_0) # (!abc:n341Q & mask_active & !abc:n310 (QN)QN & staged_word_12 & abc:n329 (QN)QN & staged_word_13) # (!abc:n341Q & mask_active & !abc:n310 (QN)QN & H_ACTIVE & run_count_0 & run_count_1 & run_count_2 & !run_count_3 & VIDCMD_Q_15 & VIDCMD_Q_14 & ef_at_pop & !$abc$1392$nVIDCMD_RE))
  [ 5 PTs]  XXL_1026 = ((abc:n644 (QN)QN & !abc:n631 (QN)QN) # (abc:n644 (QN)QN & !abc:n634 (QN)QN) # (!abc:n644 (QN)QN & abc:n622Q & abc:n631 (QN)QN & abc:n634 (QN)QN & abc:n617 (QN)QN & abc:n627 (QN)QN) # (abc:n644 (QN)QN & !abc:n627 (QN)QN) # (abc:n644 (QN)QN & !abc:n617 (QN)QN))
  [ 5 PTs]  XXL_1027 = ((abc:n627 (QN)QN & !abc:n631 (QN)QN) # (abc:n627 (QN)QN & !abc:n634 (QN)QN) # (!abc:n627 (QN)QN & abc:n622Q & abc:n631 (QN)QN & abc:n634 (QN)QN & abc:n617 (QN)QN) # (abc:n627 (QN)QN & !abc:n617 (QN)QN) # (abc:n627 (QN)QN & !abc:n622Q))
  [ 1 PTs]  set_pix_target_0.C = PIXEL_CLK
  [ 1 PTs]  set_pix_target_0.AR = !nRS
  [ 1 PTs]  set_pix_target_1.C = PIXEL_CLK
  [ 1 PTs]  set_pix_target_1.AR = !nRS
  [ 1 PTs]  set_pix_value_0.C = PIXEL_CLK
  [ 1 PTs]  set_pix_value_0.AR = !nRS
  [ 1 PTs]  set_pix_value_1.C = PIXEL_CLK
  [ 1 PTs]  set_pix_value_1.AR = !nRS
  [ 1 PTs]  set_pix_value_3.C = PIXEL_CLK
  [ 1 PTs]  set_pix_value_3.AR = !nRS
  [ 1 PTs]  set_pix_value_2.C = PIXEL_CLK
  [ 1 PTs]  set_pix_value_2.AR = !nRS
  [ 1 PTs]  set_pix_value_4.C = PIXEL_CLK
  [ 1 PTs]  set_pix_value_4.AR = !nRS
  [ 1 PTs]  set_pix_value_5.C = PIXEL_CLK
  [ 1 PTs]  set_pix_value_5.AR = !nRS
  [ 1 PTs]  set_pix_value_6.C = PIXEL_CLK
  [ 1 PTs]  set_pix_value_6.AR = !nRS
  [ 1 PTs]  set_pix_value_7.C = PIXEL_CLK
  [ 1 PTs]  set_pix_value_7.AR = !nRS
  [ 1 PTs]  set_pix_value_8.C = PIXEL_CLK
  [ 1 PTs]  set_pix_value_8.AR = !nRS
  [ 1 PTs]  set_pix_value_9.C = PIXEL_CLK
  [ 1 PTs]  set_pix_value_9.AR = !nRS
  [ 1 PTs]  set_pix_value_10.C = PIXEL_CLK
  [ 1 PTs]  set_pix_value_10.AR = !nRS
  [ 1 PTs]  h_active_d.C = PIXEL_CLK
  [ 1 PTs]  h_active_d.AR = !nRS
  [ 1 PTs]  ef_meta.C = PIXEL_CLK
  [ 1 PTs]  ef_meta.AR = !nRS
  [ 1 PTs]  ef_sync.C = PIXEL_CLK
  [ 1 PTs]  ef_sync.AR = !nRS
  [ 1 PTs]  set_pix_target_2.C = PIXEL_CLK
  [ 1 PTs]  set_pix_target_2.AR = !nRS
  [ 1 PTs]  set_pix_value_11.C = PIXEL_CLK
  [ 1 PTs]  set_pix_value_11.AR = !nRS
  [ 1 PTs]  ef_at_pop.C = PIXEL_CLK
  [ 1 PTs]  ef_at_pop.AR = !nRS
  [ 1 PTs]  set_pix_valid.C = PIXEL_CLK
  [ 1 PTs]  set_pix_valid.AR = !nRS
  [ 1 PTs]  mask_active.C = PIXEL_CLK
  [ 1 PTs]  mask_active.AR = !nRS
  [ 1 PTs]  RGB_OUT_2.C = PIXEL_CLK
  [ 1 PTs]  RGB_OUT_2.AR = !nRS
  [ 1 PTs]  RGB_OUT_0.C = PIXEL_CLK
  [ 1 PTs]  RGB_OUT_0.AR = !nRS
  [ 1 PTs]  RGB_OUT_1.C = PIXEL_CLK
  [ 1 PTs]  RGB_OUT_1.AR = !nRS
  [ 1 PTs]  RGB_OUT_5.C = PIXEL_CLK
  [ 1 PTs]  RGB_OUT_5.AR = !nRS
  [ 1 PTs]  RGB_OUT_3.C = PIXEL_CLK
  [ 1 PTs]  RGB_OUT_3.AR = !nRS
  [ 1 PTs]  RGB_OUT_4.C = PIXEL_CLK
  [ 1 PTs]  RGB_OUT_4.AR = !nRS
  [ 1 PTs]  RGB_OUT_8.C = PIXEL_CLK
  [ 1 PTs]  RGB_OUT_8.AR = !nRS
  [ 1 PTs]  RGB_OUT_6.C = PIXEL_CLK
  [ 1 PTs]  RGB_OUT_6.AR = !nRS
  [ 1 PTs]  RGB_OUT_7.C = PIXEL_CLK
  [ 1 PTs]  RGB_OUT_7.AR = !nRS
  [ 1 PTs]  RGB_OUT_9.C = PIXEL_CLK
  [ 1 PTs]  RGB_OUT_9.AR = !nRS
  [ 1 PTs]  RGB_OUT_10.C = PIXEL_CLK
  [ 1 PTs]  RGB_OUT_10.AR = !nRS
  [ 1 PTs]  RGB_OUT_11.C = PIXEL_CLK
  [ 1 PTs]  RGB_OUT_11.AR = !nRS
  [ 1 PTs]  cur_colour_2.C = PIXEL_CLK
  [ 1 PTs]  cur_colour_2.AR = !nRS
  [ 1 PTs]  cur_colour_0.C = PIXEL_CLK
  [ 1 PTs]  cur_colour_0.AR = !nRS
  [ 1 PTs]  cur_colour_1.C = PIXEL_CLK
  [ 1 PTs]  cur_colour_1.AR = !nRS
  [ 1 PTs]  sav_src_1.C = PIXEL_CLK
  [ 1 PTs]  sav_src_1.AR = !nRS
  [ 1 PTs]  set_pix_commit.C = PIXEL_CLK
  [ 1 PTs]  set_pix_commit.AR = !nRS
  [ 1 PTs]  sav_src_0.C = PIXEL_CLK
  [ 1 PTs]  sav_src_0.AR = !nRS
  [ 1 PTs]  w_is_set.C = PIXEL_CLK
  [ 1 PTs]  w_is_set.AR = !nRS
  [ 1 PTs]  run_count_0.C = PIXEL_CLK
  [ 1 PTs]  run_count_0.AP = !nRS
  [ 1 PTs]  staged_word_13.C = PIXEL_CLK
  [ 1 PTs]  staged_word_13.AR = !nRS
  [ 1 PTs]  staged_word_14.C = PIXEL_CLK
  [ 1 PTs]  staged_word_14.AR = !nRS
  [ 1 PTs]  have_staged.C = PIXEL_CLK
  [ 1 PTs]  have_staged.AR = !nRS
  [ 1 PTs]  run_count_1.C = PIXEL_CLK
  [ 1 PTs]  run_count_1.AP = !nRS
  [ 1 PTs]  $abc$1392$nVIDCMD_RE.C = PIXEL_CLK
  [ 1 PTs]  $abc$1392$nVIDCMD_RE.AP = !nRS
  [ 1 PTs]  cmp_color0_2.C = PIXEL_CLK
  [ 1 PTs]  cmp_color0_2.AR = !nRS
  [ 1 PTs]  staged_word_9.C = PIXEL_CLK
  [ 1 PTs]  staged_word_9.AR = !nRS
  [ 1 PTs]  staged_word_10.C = PIXEL_CLK
  [ 1 PTs]  staged_word_10.AR = !nRS
  [ 1 PTs]  cmp_color0_3.C = PIXEL_CLK
  [ 1 PTs]  cmp_color0_3.AR = !nRS
  [ 1 PTs]  staged_word_11.C = PIXEL_CLK
  [ 1 PTs]  staged_word_11.AR = !nRS
  [ 1 PTs]  staged_word_12.C = PIXEL_CLK
  [ 1 PTs]  staged_word_12.AR = !nRS
  [ 1 PTs]  cmp_color0_5.C = PIXEL_CLK
  [ 1 PTs]  cmp_color0_5.AR = !nRS
  [ 1 PTs]  run_count_2.C = PIXEL_CLK
  [ 1 PTs]  run_count_2.AP = !nRS
  [ 1 PTs]  cmp_color0_4.C = PIXEL_CLK
  [ 1 PTs]  cmp_color0_4.AR = !nRS
  [ 1 PTs]  cmp_color0_8.C = PIXEL_CLK
  [ 1 PTs]  cmp_color0_8.AR = !nRS
  [ 1 PTs]  cmp_color0_6.C = PIXEL_CLK
  [ 1 PTs]  cmp_color0_6.AR = !nRS
  [ 1 PTs]  cmp_color0_7.C = PIXEL_CLK
  [ 1 PTs]  cmp_color0_7.AR = !nRS
  [ 1 PTs]  cmp_color0_10.C = PIXEL_CLK
  [ 1 PTs]  cmp_color0_10.AR = !nRS
  [ 1 PTs]  cmp_color1_11.C = PIXEL_CLK
  [ 1 PTs]  cmp_color1_11.AP = !nRS
  [ 1 PTs]  cmp_color0_9.C = PIXEL_CLK
  [ 1 PTs]  cmp_color0_9.AR = !nRS
  [ 1 PTs]  cmp_color1_2.C = PIXEL_CLK
  [ 1 PTs]  cmp_color1_2.AP = !nRS
  [ 1 PTs]  cmp_color1_0.C = PIXEL_CLK
  [ 1 PTs]  cmp_color1_0.AP = !nRS
  [ 1 PTs]  cmp_color1_1.C = PIXEL_CLK
  [ 1 PTs]  cmp_color1_1.AP = !nRS
  [ 1 PTs]  cmp_color1_5.C = PIXEL_CLK
  [ 1 PTs]  cmp_color1_5.AP = !nRS
  [ 1 PTs]  cmp_color1_3.C = PIXEL_CLK
  [ 1 PTs]  cmp_color1_3.AP = !nRS
  [ 1 PTs]  cmp_color1_4.C = PIXEL_CLK
  [ 1 PTs]  cmp_color1_4.AP = !nRS
  [ 1 PTs]  cmp_color1_8.C = PIXEL_CLK
  [ 1 PTs]  cmp_color1_8.AP = !nRS
  [ 1 PTs]  cmp_color1_6.C = PIXEL_CLK
  [ 1 PTs]  cmp_color1_6.AP = !nRS
  [ 1 PTs]  cmp_color1_7.C = PIXEL_CLK
  [ 1 PTs]  cmp_color1_7.AP = !nRS
  [ 1 PTs]  cmp_color1_10.C = PIXEL_CLK
  [ 1 PTs]  cmp_color1_10.AP = !nRS
  [ 1 PTs]  cmp_color0_11.C = PIXEL_CLK
  [ 1 PTs]  cmp_color0_11.AR = !nRS
  [ 1 PTs]  cmp_color1_9.C = PIXEL_CLK
  [ 1 PTs]  cmp_color1_9.AP = !nRS
  [ 1 PTs]  staged_word_2.C = PIXEL_CLK
  [ 1 PTs]  staged_word_2.AR = !nRS
  [ 1 PTs]  staged_word_0.C = PIXEL_CLK
  [ 1 PTs]  staged_word_0.AR = !nRS
  [ 1 PTs]  staged_word_1.C = PIXEL_CLK
  [ 1 PTs]  staged_word_1.AR = !nRS
  [ 1 PTs]  staged_word_5.C = PIXEL_CLK
  [ 1 PTs]  staged_word_5.AR = !nRS
  [ 1 PTs]  staged_word_3.C = PIXEL_CLK
  [ 1 PTs]  staged_word_3.AR = !nRS
  [ 1 PTs]  staged_word_4.C = PIXEL_CLK
  [ 1 PTs]  staged_word_4.AR = !nRS
  [ 1 PTs]  staged_word_7.C = PIXEL_CLK
  [ 1 PTs]  staged_word_7.AR = !nRS
  [ 1 PTs]  staged_word_6.C = PIXEL_CLK
  [ 1 PTs]  staged_word_6.AR = !nRS
  [ 1 PTs]  cmp_color0_0.C = PIXEL_CLK
  [ 1 PTs]  cmp_color0_0.AR = !nRS
  [ 1 PTs]  staged_word_8.C = PIXEL_CLK
  [ 1 PTs]  staged_word_8.AR = !nRS
  [ 1 PTs]  cmp_color0_1.C = PIXEL_CLK
  [ 1 PTs]  cmp_color0_1.AR = !nRS
  [ 1 PTs]  run_count_3.C = PIXEL_CLK
  [ 1 PTs]  run_count_3.AP = !nRS
  [ 1 PTs]  cur_src_1.C = PIXEL_CLK
  [ 1 PTs]  cur_src_1.AR = !nRS
  [ 1 PTs]  run_count_4.C = PIXEL_CLK
  [ 1 PTs]  run_count_4.AP = !nRS
  [ 1 PTs]  run_count_5.C = PIXEL_CLK
  [ 1 PTs]  run_count_5.AP = !nRS
  [ 1 PTs]  cur_src_0.C = PIXEL_CLK
  [ 1 PTs]  cur_src_0.AR = !nRS
  [ 1 PTs]  run_count_10.C = PIXEL_CLK
  [ 1 PTs]  run_count_10.AP = !nRS
  [ 1 PTs]  run_count_9.C = PIXEL_CLK
  [ 1 PTs]  run_count_9.AP = !nRS
  [ 1 PTs]  run_count_7.C = PIXEL_CLK
  [ 1 PTs]  run_count_7.AP = !nRS
  [ 1 PTs]  run_count_6.C = PIXEL_CLK
  [ 1 PTs]  run_count_6.AP = !nRS
  [ 1 PTs]  run_count_11.C = PIXEL_CLK
  [ 1 PTs]  run_count_11.AP = !nRS
  [ 1 PTs]  run_count_8.C = PIXEL_CLK
  [ 1 PTs]  run_count_8.AP = !nRS
