bradgrantham/griffin/cpld/engine/super-engine-work/edma2_lever2_fit_report.txt

========================================================================
ATF1508 Fitter Report
========================================================================

UTILIZATION SUMMARY
----------------------------------------
  dedicated input                 4/4 	(100%)
  I/O pins                        58/64 	(90%)
  Logic cells                     124/128 	(96%)
  Flip-Flop                       75/128 	(58%)
  Foldback logic                  20/128 	(15%)
  Nodes+FB/MCells                 143/128 	(111%)
  cascade                         1
  input pins                      25
  output pins                     37
  Pts                             434

PER-LAB PLACEMENT
------------------------------------------------------------------------
  LAB A (MC 1-16):  22/16 used  (7 pin, 11 feedback, 4 foldback)  fan-in: 37/40
    MC  3  pin 12  D_4
    MC  5  pin 11  D_5
    MC  6  pin 10  dest_0
    MC  8  pin  9  nDEPOSIT
    MC 11  pin  8  dest_1
    MC 13  pin  6  dest_2
    MC 14  pin  5  nENGINE_IRQ
    MC  1  feedback  abc:n320
    MC  2  feedback  abc:n295  «bus cycle gate»
    MC  3  feedback  state_3
    MC  4  feedback  state_2
    MC  5  feedback  abc:n403  «bus cycle gate»
    MC  7  feedback  state_6
    MC  9  feedback  $abc$2512$nBGACK
    MC 10  feedback  XXL_1032
    MC 12  feedback  XXL_1033
    MC 15  feedback  XXL_1034
    MC 16  feedback  state_0
    MC  5  FOLDBACK  abc:n281  [from id00029Q]
    MC 11  FOLDBACK  abc:n370  [from id00118Q]
    MC 13  FOLDBACK  abc:n359 (QN)  [from id00107QN]
    MC 14  FOLDBACK  abc:n282  [from id00030Q]

  LAB B (MC 17-32):  24/16 used  (8 pin, 14 feedback, 2 foldback)  fan-in: 37/40
    MC 17  pin 22  nUDS
    MC 19  pin 21  nAS
    MC 21  pin 20  D_11
    MC 24  pin 18  D_0
    MC 25  pin 17  D_2
    MC 27  pin 16  D_8
    MC 29  pin 15  D_3
    MC 32  pin 14  TDI
    MC 18  feedback  src_addr_19
    MC 20  feedback  src_addr_1
    MC 21  feedback  src_addr_2
    MC 22  feedback  src_addr_21
    MC 23  feedback  src_addr_18
    MC 24  feedback  src_addr_3
    MC 25  feedback  XXL_1035
    MC 26  feedback  XXL_1042
    MC 27  feedback  src_addr_22
    MC 28  feedback  src_addr_16
    MC 29  feedback  src_addr_17
    MC 30  feedback  XXL_1041
    MC 31  feedback  XXL_1040
    MC 32  feedback  XXL_1039
    MC 22  FOLDBACK  abc:n405  «bus cycle gate»  [from id00153Q]
    MC 29  FOLDBACK  abc:n309  «bus cycle gate»  [from id00057Q]

  LAB C (MC 33-48):  20/16 used  (8 pin, 9 feedback, 3 foldback)  fan-in: 37/40
    MC 35  pin 31  A_17
    MC 37  pin 30  A_18
    MC 38  pin 29  A_11
    MC 40  pin 28  A_20
    MC 43  pin 27  D_15
    MC 45  pin 25  R_nW
    MC 46  pin 24  D_13
    MC 48  pin 23  TMS
    MC 33  feedback  wait_hblank
    MC 34  feedback  desc_ptr_12
    MC 36  feedback  state_5
    MC 39  feedback  nAS_meta
    MC 42  feedback  stop_after
    MC 43  feedback  desc_ptr_11
    MC 44  feedback  desc_ptr_13
    MC 46  feedback  desc_ptr_6
    MC 47  feedback  desc_ptr_14
    MC 43  FOLDBACK  abc:n387  [from id00135Q]
    MC 44  FOLDBACK  abc:n385  [from id00133Q]
    MC 45  FOLDBACK  abc:n282  [from id00030Q]

  LAB D (MC 49-64):  20/16 used  (6 pin, 10 feedback, 4 foldback)  fan-in: 32/40
    MC 53  pin 39  A_9
    MC 56  pin 37  A_10
    MC 57  pin 36  A_12
    MC 59  pin 35  FC_2
    MC 61  pin 34  FC_1
    MC 64  pin 33  FC_0
    MC 49  feedback  src_addr_4
    MC 50  feedback  src_addr_10
    MC 51  feedback  src_addr_5
    MC 52  feedback  src_addr_9
    MC 54  feedback  src_addr_12
    MC 55  feedback  src_addr_15
    MC 58  feedback  src_addr_6
    MC 60  feedback  src_addr_11
    MC 62  feedback  src_addr_13
    MC 63  feedback  XXL_1036
    MC 57  FOLDBACK  abc:n309  «bus cycle gate»  [from id00057Q]
    MC 59  FOLDBACK  abc:n304  «bus cycle gate»  [from id00052Q]
    MC 61  FOLDBACK  abc:n306  «bus cycle gate»  [from id00054Q]
    MC 64  FOLDBACK  abc:n299  «bus cycle gate»  [from id00047Q]

  LAB E (MC 65-80):  17/16 used  (7 pin, 7 feedback, 3 foldback)  fan-in: 37/40
    MC 65  pin 44  A_8
    MC 67  pin 45  A_7
    MC 72  pin 48  A_0
    MC 73  pin 49  A_1
    MC 75  pin 50  A_6
    MC 77  pin 51  A_2
    MC 80  pin 52  A_5
    MC 66  feedback  desc_ptr_7
    MC 68  feedback  desc_ptr_9
    MC 70  feedback  src_addr_7
    MC 71  feedback  XXL_1037
    MC 74  feedback  desc_ptr_8
    MC 76  feedback  desc_ptr_10
    MC 79  feedback  src_addr_8
    MC 75  FOLDBACK  abc:n383  [from id00131Q]
    MC 77  FOLDBACK  abc:n381  [from id00129Q]
    MC 80  FOLDBACK  abc:n282  [from id00030Q]

  LAB F (MC 81-96):  20/16 used  (8 pin, 9 feedback, 3 foldback)  fan-in: 36/40
    MC 83  pin 54  A_3
    MC 85  pin 55  A_4
    MC 86  pin 56  A_15
    MC 88  pin 57  A_16
    MC 91  pin 58  A_19
    MC 93  pin 60  A_21
    MC 94  pin 61  A_22
    MC 96  pin 62  TCK
    MC 81  feedback  src_addr_20
    MC 82  feedback  desc_ptr_2
    MC 84  feedback  desc_ptr_0
    MC 87  feedback  desc_ptr_3
    MC 89  feedback  dma_en
    MC 90  feedback  words_left_1
    MC 92  feedback  desc_ptr_4
    MC 95  feedback  desc_ptr_1
    MC 96  feedback  desc_ptr_5
    MC 92  FOLDBACK  abc:n378  [from id00126Q]
    MC 93  FOLDBACK  abc:n282  [from id00030Q]
    MC 94  FOLDBACK  abc:n281  [from id00029Q]

  LAB G (MC 97-112):  24/16 used  (8 pin, 15 feedback, 1 foldback)  fan-in: 37/40
    MC 97  pin 63  D_14
    MC 99  pin 64  nLDS
    MC101  pin 65  D_12
    MC104  pin 67  D_10
    MC105  pin 68  D_1
    MC107  pin 69  D_9
    MC109  pin 70  D_7
    MC112  pin 71  TDO
    MC 97  feedback  state_8
    MC 98  feedback  XXL_1043
    MC100  feedback  state_10
    MC101  feedback  abc:n635 (QN)
    MC102  feedback  words_left_0
    MC103  feedback  state_1
    MC104  feedback  words_left_3
    MC105  feedback  words_left_5
    MC106  feedback  abc:n398
    MC107  feedback  words_left_6
    MC108  feedback  words_left_2
    MC109  feedback  XXL_1038
    MC110  feedback  words_left_4
    MC111  feedback  phase_payload
    MC112  feedback  state_4
    MC107  FOLDBACK  abc:n329  [from id00077Q]

  LAB H (MC 113-128):  17/16 used  (6 pin, 11 feedback, 0 foldback)  fan-in: 29/40
    MC115  pin 73  D_6
    MC117  pin 74  A_14
    MC118  pin 75  A_13
    MC120  pin 76  nBG
    MC123  pin 77  nBGACK
    MC125  pin 79  nBR
    MC113  feedback  hblank_sync_d
    MC114  feedback  hblank_meta
    MC115  feedback  nBG_meta
    MC116  feedback  nAS_sync
    MC119  feedback  state_7
    MC120  feedback  nBG_sync
    MC121  feedback  hblank_sync
    MC122  feedback  state_9
    MC124  feedback  src_addr_14
    MC127  feedback  state_11
    MC128  feedback  lds_out

FOLDBACK ANALYSIS
------------------------------------------------------------------------
  Total foldbacks: 20

  Signals replicated as foldbacks (most replicas first):

    abc:n282                                  4 copies  in LABs: A, C, E, F
      consumed by: desc_ptr_2.D, desc_ptr_0.D, desc_ptr_1.D, desc_ptr_3.D, desc_ptr_4.D, desc_ptr_5.D, desc_ptr_7.D, desc_ptr_9.D ... +7 more

    abc:n281                                  2 copies  in LABs: A, F
      consumed by: dma_en.D

    abc:n309  «bus cycle gate»                2 copies  in LABs: B, D
      consumed by: src_addr_15.D, src_addr_16.D

    abc:n370                                  1 copies  in LABs: A
      consumed by: nDEPOSIT.D

    abc:n359 (QN)                             1 copies  in LABs: A

    abc:n405  «bus cycle gate»                1 copies  in LABs: B
      consumed by: src_addr_17.D, src_addr_18.D, src_addr_21.D, XXL_1039, XXL_1040, XXL_1041

    abc:n387                                  1 copies  in LABs: C
      consumed by: desc_ptr_14.D, desc_ptr_13.D

    abc:n385                                  1 copies  in LABs: C
      consumed by: desc_ptr_12.D, desc_ptr_11.D

    abc:n304  «bus cycle gate»                1 copies  in LABs: D
      consumed by: src_addr_10.D, src_addr_9.D, src_addr_11.D

    abc:n306  «bus cycle gate»                1 copies  in LABs: D
      consumed by: src_addr_12.D, src_addr_13.D, XXL_1036

    abc:n299  «bus cycle gate»                1 copies  in LABs: D
      consumed by: src_addr_4.D, src_addr_5.D

    abc:n383                                  1 copies  in LABs: E
      consumed by: desc_ptr_9.D, desc_ptr_10.D

    abc:n381                                  1 copies  in LABs: E
      consumed by: desc_ptr_7.D, desc_ptr_8.D

    abc:n378                                  1 copies  in LABs: F
      consumed by: desc_ptr_3.D, desc_ptr_4.D, desc_ptr_5.D

    abc:n329                                  1 copies  in LABs: G
      consumed by: state_1.D, words_left_6.D, XXL_1043

  Foldback imports per LAB:

    LAB A: 4 foldback(s)
      - abc:n281
      - abc:n370
      - abc:n359 (QN)
      - abc:n282
    LAB B: 2 foldback(s)
      - abc:n405  «bus cycle gate»
      - abc:n309  «bus cycle gate»
    LAB C: 3 foldback(s)
      - abc:n387
      - abc:n385
      - abc:n282
    LAB D: 4 foldback(s)
      - abc:n309  «bus cycle gate»
      - abc:n304  «bus cycle gate»
      - abc:n306  «bus cycle gate»
      - abc:n299  «bus cycle gate»
    LAB E: 3 foldback(s)
      - abc:n383
      - abc:n381
      - abc:n282
    LAB F: 3 foldback(s)
      - abc:n378
      - abc:n282
      - abc:n281
    LAB G: 1 foldback(s)
      - abc:n329

FAN-IN DETAIL
------------------------------------------------------------------------
  LAB A: 37/40 inputs
    I/O pins (16): A_0, A_1, D_12, D_13, D_11, R_nW, dest_2, dest_1, dest_0, nLDS, nDEPOSIT, nBR, nENGINE_IRQ, nRESET, nENGINE_SELECT, nAS
    Internal (21):
      hblank_sync_d
      state_5
      state_1
      state_0
      state_4
      $abc$2512$nBGACK
      desc_ptr_0
      state_3
      hblank_sync
      dma_en
      state_6
      state_9
      state_8
      phase_payload
      nBG_sync
      state_2
      state_10
      nAS_sync
      desc_ptr_1
      state_7
      state_11

  LAB B: 37/40 inputs
    I/O pins (7): D_5, D_0, D_4, D_2, D_3, D_1, D_6
    Internal (30):
      XXL_1041  (unmapped)
      XXL_1040  (unmapped)
      XXL_1042  (unmapped)
      src_addr_19
      src_addr_1
      src_addr_5
      lds_out
      abc:n403  «bus cycle gate»
      src_addr_4
      src_addr_11
      src_addr_10
      src_addr_8
      src_addr_2
      $abc$2512$nBGACK
      src_addr_18
      src_addr_3
      src_addr_9
      src_addr_14
      state_7
      abc:n295  «bus cycle gate»
      src_addr_6
      src_addr_12
      src_addr_16
      src_addr_15
      src_addr_22
      src_addr_21
      src_addr_17
      src_addr_7
      src_addr_20
      src_addr_13

  LAB C: 37/40 inputs
    I/O pins (12): A_0, A_1, D_15, D_14, D_13, D_12, D_11, R_nW, nLDS, nENGINE_SELECT, nAS, nRESET
    Internal (25):
      XXL_1037  (unmapped)
      src_addr_19
      desc_ptr_7
      desc_ptr_12
      stop_after
      desc_ptr_6
      src_addr_18
      phase_payload
      desc_ptr_0
      $abc$2512$nBGACK
      desc_ptr_13
      desc_ptr_3
      desc_ptr_9
      desc_ptr_10
      src_addr_21
      desc_ptr_11
      desc_ptr_2
      desc_ptr_1
      src_addr_12
      state_8
      desc_ptr_14
      desc_ptr_8
      desc_ptr_4
      wait_hblank
      desc_ptr_5

  LAB D: 32/40 inputs
    I/O pins (10): D_15, D_9, D_4, D_14, D_11, D_13, D_6, D_5, D_12, D_10
    Internal (22):
      phase_payload
      src_addr_9
      src_addr_14
      src_addr_1
      src_addr_8
      src_addr_4
      src_addr_2
      src_addr_5
      $abc$2512$nBGACK
      abc:n295  «bus cycle gate»
      src_addr_13
      src_addr_3
      state_7
      src_addr_11
      desc_ptr_12
      desc_ptr_10
      src_addr_12
      src_addr_10
      src_addr_7
      desc_ptr_9
      src_addr_15
      src_addr_6

  LAB E: 37/40 inputs
    I/O pins (11): A_0, A_1, D_7, D_9, D_8, D_6, D_10, R_nW, nLDS, nENGINE_SELECT, nAS
    Internal (26):
      XXL_1035  (unmapped)
      src_addr_9
      src_addr_3
      desc_ptr_7
      desc_ptr_3
      src_addr_6
      desc_ptr_6
      $abc$2512$nBGACK
      desc_ptr_0
      desc_ptr_4
      src_addr_1
      src_addr_8
      src_addr_4
      desc_ptr_1
      desc_ptr_9
      desc_ptr_10
      state_7
      src_addr_2
      phase_payload
      src_addr_5
      desc_ptr_2
      desc_ptr_8
      src_addr_7
      state_8
      abc:n295  «bus cycle gate»
      desc_ptr_5

  LAB F: 36/40 inputs
    I/O pins (12): A_1, A_0, D_5, D_0, D_1, D_2, D_4, D_3, R_nW, nLDS, nAS, nENGINE_SELECT
    Internal (24):
      XXL_1039  (unmapped)
      abc:n320
      state_8
      phase_payload
      $abc$2512$nBGACK
      src_addr_4
      src_addr_16
      src_addr_5
      src_addr_22
      desc_ptr_0
      desc_ptr_4
      src_addr_18
      src_addr_20
      dma_en
      desc_ptr_3
      src_addr_17
      abc:n403  «bus cycle gate»
      state_7
      state_4
      desc_ptr_2
      desc_ptr_1
      words_left_1
      words_left_0
      desc_ptr_5

  LAB G: 37/40 inputs
    I/O pins (6): D_8, D_7, D_4, D_9, D_6, D_10
    Internal (31):
      XXL_1043  (unmapped)
      XXL_1038  (unmapped)
      dma_en
      abc:n320
      state_0
      words_left_5
      state_3
      state_5
      stop_after
      $abc$2512$nBGACK
      state_2
      phase_payload
      desc_ptr_0
      state_6
      words_left_4
      state_1
      lds_out
      wait_hblank
      state_9
      state_7
      desc_ptr_1
      abc:n635 (QN)
      words_left_2
      words_left_0
      words_left_1
      words_left_3
      words_left_6
      state_8
      state_4
      state_10
      state_11

  LAB H: 29/40 inputs
    I/O pins (3): HBLANK, nBG, nRESET
    Internal (26):
      XXL_1033  (unmapped)
      XXL_1034  (unmapped)
      XXL_1036  (unmapped)
      XXL_1032  (unmapped)
      state_3
      hblank_meta
      nBG_meta
      state_1
      state_11
      state_7
      src_addr_13
      nAS_meta
      phase_payload
      src_addr_15
      hblank_sync
      hblank_sync_d
      desc_ptr_13
      dma_en
      state_9
      src_addr_14
      lds_out
      nAS_sync
      $abc$2512$nBGACK
      abc:n398
      state_5
      desc_ptr_14

PRODUCT TERM USAGE (signals using >3 PTs)
------------------------------------------------------------------------
  10 PTs  src_addr_8.D
   5 PTs  src_addr_3.D
   5 PTs  words_left_2.D
   5 PTs  words_left_4.D
   5 PTs  src_addr_7.D
   5 PTs  src_addr_11.D
   5 PTs  src_addr_13.D
   5 PTs  desc_ptr_2.D
   5 PTs  src_addr_16.D
   5 PTs  desc_ptr_5.D
   5 PTs  desc_ptr_6.D
   5 PTs  src_addr_18.D
   5 PTs  desc_ptr_8.D
   5 PTs  desc_ptr_12.D
   5 PTs  desc_ptr_10.D
   5 PTs  desc_ptr_14.D
   5 PTs  src_addr_22.D
   5 PTs  phase_payload.D
   5 PTs  XXL_1032
   5 PTs  XXL_1033
   5 PTs  XXL_1034
   5 PTs  XXL_1035
   5 PTs  XXL_1036
   5 PTs  XXL_1037
   5 PTs  XXL_1038
   5 PTs  XXL_1039
   5 PTs  XXL_1040
   5 PTs  XXL_1041
   5 PTs  XXL_1042
   5 PTs  XXL_1043
   4 PTs  state_6.D
   4 PTs  dest_1.D
   4 PTs  src_addr_4.D
   4 PTs  dest_2.D
   4 PTs  wait_hblank.D
   4 PTs  src_addr_5.D
   4 PTs  src_addr_12.D
   4 PTs  stop_after.D
   4 PTs  dest_0.D
   4 PTs  src_addr_2.D
   4 PTs  words_left_1.D
   4 PTs  words_left_3.D
   4 PTs  src_addr_15.D
   4 PTs  src_addr_10.D
   4 PTs  src_addr_9.D
   4 PTs  desc_ptr_1.D
   4 PTs  desc_ptr_3.D
   4 PTs  desc_ptr_4.D
   4 PTs  desc_ptr_7.D
   4 PTs  src_addr_17.D
   4 PTs  desc_ptr_9.D
   4 PTs  desc_ptr_11.D
   4 PTs  abc:n398
   4 PTs  words_left_5.D
   4 PTs  desc_ptr_13.D
   4 PTs  src_addr_21.D
   4 PTs  words_left_6.D

ALL EQUATIONS
------------------------------------------------------------------------
  [ 1 PTs]  nBGACK = $abc$2512$nBGACK
  [ 1 PTs]  hblank_sync.D = hblank_meta
  [ 1 PTs]  hblank_meta.D = HBLANK
  [ 1 PTs]  state_7.D = state_1
  [ 1 PTs]  state_8.D = state_2
  [ 1 PTs]  nAS_sync.D = nAS_meta
  [ 1 PTs]  nAS_meta.D = nAS.PIN
  [ 1 PTs]  nBG_sync.D = nBG_meta
  [ 1 PTs]  nBG_meta.D = nBG
  [ 0 PTs]  FC_1 = 0
  [ 0 PTs]  FC_0 = 1
  [ 1 PTs]  A_21 = (phase_payload & src_addr_22)
  [ 2 PTs]  A_14 = ((phase_payload & src_addr_15) # (!phase_payload & desc_ptr_14))
  [ 2 PTs]  A_13 = ((phase_payload & src_addr_14) # (!phase_payload & desc_ptr_13))
  [ 2 PTs]  A_12 = ((phase_payload & src_addr_13) # (!phase_payload & desc_ptr_12))
  [ 2 PTs]  A_11 = ((phase_payload & src_addr_12) # (!phase_payload & desc_ptr_11))
  [ 2 PTs]  A_10 = ((phase_payload & src_addr_11) # (!phase_payload & desc_ptr_10))
  [ 2 PTs]  A_9 = ((phase_payload & src_addr_10) # (!phase_payload & desc_ptr_9))
  [ 2 PTs]  A_8 = ((phase_payload & src_addr_9) # (!phase_payload & desc_ptr_8))
  [ 2 PTs]  A_7 = ((phase_payload & src_addr_8) # (!phase_payload & desc_ptr_7))
  [ 2 PTs]  A_6 = ((phase_payload & src_addr_7) # (!phase_payload & desc_ptr_6))
  [ 2 PTs]  A_5 = ((phase_payload & src_addr_6) # (!phase_payload & desc_ptr_5))
  [ 2 PTs]  A_4 = ((phase_payload & src_addr_5) # (!phase_payload & desc_ptr_4))
  [ 2 PTs]  A_3 = ((phase_payload & src_addr_4) # (!phase_payload & desc_ptr_3))
  [ 2 PTs]  A_2 = ((phase_payload & src_addr_3) # (!phase_payload & desc_ptr_2))
  [ 2 PTs]  A_1 = ((phase_payload & src_addr_2) # (!phase_payload & desc_ptr_1))
  [ 2 PTs]  A_0 = ((phase_payload & src_addr_1) # (!phase_payload & desc_ptr_0))
  [ 1 PTs]  hblank_sync_d.D = hblank_sync
  [ 1 PTs]  nLDS = lds_out
  [ 0 PTs]  FC_2 = 1
  [ 1 PTs]  nUDS = lds_out
  [ 0 PTs]  R_nW = 1
  [ 1 PTs]  nAS = lds_out
  [ 0 PTs]  A_22 = 0
  [ 2 PTs]  state_3.D = ((dma_en & !nAS_sync & state_3) # (dma_en & !nBG_sync & state_6))
  [ 1 PTs]  state_9.D = (nAS_sync & state_3 & dma_en)
  [ 2 PTs]  abc:n295  «bus cycle gate» = ((!state_8 & state_7) # (state_8 & !desc_ptr_0 & desc_ptr_1))
  [ 2 PTs]  abc:n320 = ((state_8 & !desc_ptr_0 & !desc_ptr_1) # (!state_8 & state_7))
  [ 2 PTs]  abc:n403  «bus cycle gate» = ((!state_8 & state_7) # (state_8 & !desc_ptr_1 & desc_ptr_0))
  [ 3 PTs]  state_11.D = ((state_11 & dma_en & !hblank_sync_d) # state_5 # (state_11 & dma_en & !hblank_sync))
  [ 3 PTs]  state_2.D = ((state_8 & !desc_ptr_0) # (state_8 & !desc_ptr_1) # (state_9 & !phase_payload))
  [ 4 PTs]  state_6.D = ((dma_en & nBG_sync & state_6) # (dma_en & state_0) # (dma_en & hblank_sync & hblank_sync_d & state_11) # state_10)
  [ 2 PTs]  abc:n635 (QN) = ((abc:n320Q & words_left_0 & words_left_1 & words_left_2 & words_left_3) # (abc:n320Q & !state_7))
  [ 3 PTs]  words_left_0.D = ((abc:n320Q & state_7 & !words_left_0) # (!abc:n320Q & words_left_0) # (abc:n320Q & !state_7 & !D_4))
  [ 4 PTs]  dest_1.D = ((desc_ptr_1 & dest_1.Q) # (!state_8 & dest_1.Q) # (desc_ptr_0 & dest_1.Q) # (!desc_ptr_0 & state_8 & !desc_ptr_1 & D_12))
  [ 3 PTs]  src_addr_1.D = ((abc:n295Q & !src_addr_1 & state_7) # (abc:n295Q & !state_7 & D_1) # (!abc:n295Q & src_addr_1))
  [ 4 PTs]  src_addr_4.D = ((state_7 & abc:n299Q & src_addr_4) # (abc:n295Q & !state_7 & D_4) # (!abc:n295Q & src_addr_4) # (abc:n295Q & state_7 & abc:n299Q & src_addr_3 & src_addr_2 & src_addr_1))
  [ 4 PTs]  dest_2.D = ((desc_ptr_1 & dest_2.Q) # (!state_8 & dest_2.Q) # (desc_ptr_0 & dest_2.Q) # (!desc_ptr_0 & state_8 & !desc_ptr_1 & D_13))
  [ 1 PTs]  state_5.D = (state_8 & desc_ptr_0 & desc_ptr_1 & wait_hblank)
  [ 4 PTs]  wait_hblank.D = ((desc_ptr_1 & wait_hblank) # (!state_8 & wait_hblank) # (desc_ptr_0 & wait_hblank) # (!desc_ptr_0 & state_8 & !desc_ptr_1 & D_15))
  [ 4 PTs]  src_addr_5.D = ((src_addr_5 & state_7 & abc:n299Q) # (abc:n295Q & !state_7 & D_5) # (!abc:n295Q & src_addr_5) # (abc:n295Q & !src_addr_5 & state_7 & src_addr_4 & src_addr_3 & src_addr_2 & src_addr_1))
  [ 2 PTs]  nDEPOSIT.D = ((!state_1 & !state_6 & !state_5 & !state_0 & !state_3 & !state_4 & !state_11 & !state_10 & !state_2 & !state_8 & !state_9) # (abc:n370Q & nDEPOSIT.Q))
  [ 3 PTs]  nBR.D = (XXL_1033 # XXL_1034 # XXL_1032)
  [ 4 PTs]  src_addr_12.D = ((abc:n295Q & !state_7 & D_12) # (!src_addr_12 & abc:n295Q & state_7 & src_addr_7 & src_addr_8 & src_addr_9 & src_addr_10 & src_addr_11 & src_addr_1 & src_addr_2 & src_addr_3 & src_addr_4 & src_addr_5 & src_addr_6) # (src_addr_12 & state_7 & abc:n306Q) # (src_addr_12 & !abc:n295Q))
  [ 4 PTs]  stop_after.D = ((desc_ptr_1 & stop_after) # (!state_8 & stop_after) # (desc_ptr_0 & stop_after) # (!desc_ptr_0 & state_8 & !desc_ptr_1 & D_14))
  [ 4 PTs]  dest_0.D = ((desc_ptr_1 & dest_0.Q) # (!state_8 & dest_0.Q) # (desc_ptr_0 & dest_0.Q) # (!desc_ptr_0 & state_8 & !desc_ptr_1 & D_11))
  [ 4 PTs]  src_addr_2.D = ((state_7 & src_addr_2 & !src_addr_1) # (!abc:n295Q & src_addr_2) # (abc:n295Q & !state_7 & D_2) # (abc:n295Q & state_7 & !src_addr_2 & src_addr_1))
  [ 4 PTs]  words_left_1.D = ((words_left_1 & state_7 & !words_left_0) # (abc:n320Q & !state_7 & !D_5) # (abc:n320Q & !words_left_1 & state_7 & words_left_0) # (!abc:n320Q & words_left_1))
  [ 5 PTs]  src_addr_3.D = ((src_addr_3 & !abc:n295Q) # (!state_7 & abc:n295Q & D_3) # (state_7 & !src_addr_3 & src_addr_1 & abc:n295Q & src_addr_2) # (state_7 & src_addr_3 & !src_addr_2) # (state_7 & src_addr_3 & !src_addr_1))
  [ 5 PTs]  words_left_2.D = ((!abc:n320Q & words_left_2) # (state_7 & words_left_2 & !words_left_0) # (state_7 & abc:n320Q & !words_left_2 & words_left_0 & words_left_1) # (state_7 & words_left_2 & !words_left_1) # (!state_7 & abc:n320Q & !D_6))
  [ 4 PTs]  words_left_3.D = ((words_left_3 & !abc:n635 (QN)QN) # (!D_7 & !state_7 & abc:n320Q) # (!abc:n635 (QN)QN & abc:n320Q & words_left_0 & words_left_1 & words_left_2) # (!D_7 & !state_7 & words_left_3))
  [ 5 PTs]  words_left_4.D = ((!state_7 & words_left_4 & !D_8) # (!abc:n635 (QN)QN & words_left_4) # (abc:n320Q & !state_7 & !D_8) # (abc:n320Q & words_left_3 & words_left_0 & words_left_1 & words_left_2 & state_7 & !words_left_4) # (abc:n320Q & words_left_3 & words_left_0 & words_left_1 & words_left_2 & !abc:n635 (QN)QN))
  [ 4 PTs]  src_addr_15.D = ((abc:n295Q & !state_7 & D_15) # (!src_addr_15 & abc:n295Q & state_7 & src_addr_12 & src_addr_13 & src_addr_14 & src_addr_7 & src_addr_8 & src_addr_9 & src_addr_10 & src_addr_11 & src_addr_1 & src_addr_2 & src_addr_3 & src_addr_4 & src_addr_5 & src_addr_6) # (src_addr_15 & state_7 & abc:n309Q) # (src_addr_15 & !abc:n295Q))
  [ 3 PTs]  dma_en.D = ((!state_4 & !A_0.PIN & !nAS.PIN & !nLDS.PIN & !R_nW.PIN & !nENGINE_SELECT & A_1.PIN & D_0) # (!state_4 & abc:n281Q & A_0.PIN & !nAS.PIN & !nLDS.PIN & !R_nW.PIN & !nENGINE_SELECT & !A_1.PIN) # (!state_4 & abc:n281Q & dma_en))
  [ 5 PTs]  src_addr_7.D = ((!src_addr_7 & state_7 & src_addr_6 & abc:n295Q & src_addr_1 & src_addr_2 & src_addr_3 & src_addr_4 & src_addr_5) # (!state_7 & abc:n295Q & D_7) # (src_addr_7 & !abc:n295Q) # XXL_1035 # (src_addr_7 & state_7 & !src_addr_6))
  [ 4 PTs]  src_addr_10.D = ((src_addr_10 & state_7 & abc:n304Q) # (abc:n295Q & !state_7 & D_10) # (abc:n295Q & !src_addr_10 & state_7 & src_addr_7 & src_addr_8 & src_addr_9 & src_addr_1 & src_addr_2 & src_addr_3 & src_addr_4 & src_addr_5 & src_addr_6) # (!abc:n295Q & src_addr_10))
  [10 PTs]  src_addr_8.D = ((src_addr_8 & state_7 & !src_addr_1) # (src_addr_8 & state_7 & !src_addr_2) # (src_addr_8 & state_7 & !src_addr_3) # (src_addr_8 & state_7 & !src_addr_4) # (src_addr_8 & state_7 & !src_addr_5) # (src_addr_8 & state_7 & !src_addr_6) # (!src_addr_8 & state_7 & src_addr_7 & src_addr_1 & src_addr_2 & src_addr_3 & src_addr_4 & src_addr_5 & src_addr_6 & abc:n295Q) # (!state_7 & abc:n295Q & D_8) # (src_addr_8 & !abc:n295Q) # (src_addr_8 & state_7 & !src_addr_7))
  [ 4 PTs]  src_addr_9.D = ((!state_7 & abc:n295Q & D_9) # (src_addr_9 & !abc:n295Q) # (state_7 & abc:n304Q & abc:n295Q & src_addr_1 & src_addr_2 & src_addr_3 & src_addr_4 & src_addr_5 & src_addr_6 & src_addr_7 & src_addr_8) # (state_7 & abc:n304Q & src_addr_9))
  [ 2 PTs]  src_addr_14.D = (XXL_1036 # (state_7 & src_addr_14 & !src_addr_13))
  [ 5 PTs]  src_addr_11.D = ((abc:n295Q & !state_7 & D_11) # (src_addr_11 & state_7 & abc:n304Q) # (src_addr_11 & state_7 & !src_addr_10) # (!src_addr_11 & abc:n295Q & state_7 & src_addr_10 & src_addr_7 & src_addr_8 & src_addr_9 & src_addr_1 & src_addr_2 & src_addr_3 & src_addr_4 & src_addr_5 & src_addr_6) # (src_addr_11 & !abc:n295Q))
  [ 5 PTs]  src_addr_13.D = ((abc:n295Q & !state_7 & D_13) # (!src_addr_13 & abc:n295Q & state_7 & src_addr_12 & src_addr_7 & src_addr_8 & src_addr_9 & src_addr_10 & src_addr_11 & src_addr_1 & src_addr_2 & src_addr_3 & src_addr_4 & src_addr_5 & src_addr_6) # (src_addr_13 & state_7 & !src_addr_12) # (src_addr_13 & state_7 & abc:n306Q) # (src_addr_13 & !abc:n295Q))
  [ 5 PTs]  desc_ptr_2.D = ((state_8 & desc_ptr_2 & !desc_ptr_0) # (!state_8 & D_2 & A_0.PIN & !nAS.PIN & !nLDS.PIN & !R_nW.PIN & !nENGINE_SELECT & !A_1.PIN) # (state_8 & desc_ptr_2 & !desc_ptr_1) # (!state_8 & desc_ptr_2 & abc:n282Q) # (state_8 & !desc_ptr_2 & desc_ptr_1 & desc_ptr_0))
  [ 3 PTs]  desc_ptr_0.D = ((!state_8 & desc_ptr_0 & abc:n282Q) # (state_8 & !desc_ptr_0) # (!state_8 & D_0 & A_0.PIN & !nAS.PIN & !nLDS.PIN & !R_nW.PIN & !nENGINE_SELECT & !A_1.PIN))
  [ 4 PTs]  desc_ptr_1.D = ((!state_8 & desc_ptr_1 & abc:n282Q) # (!state_8 & D_1 & A_0.PIN & !nAS.PIN & !nLDS.PIN & !R_nW.PIN & !nENGINE_SELECT & !A_1.PIN) # (state_8 & !desc_ptr_1 & desc_ptr_0) # (state_8 & desc_ptr_1 & !desc_ptr_0))
  [ 4 PTs]  desc_ptr_3.D = ((state_8 & abc:n378Q & desc_ptr_2 & desc_ptr_0 & desc_ptr_1) # (state_8 & desc_ptr_3 & abc:n378Q) # (!state_8 & D_3 & A_0.PIN & !nAS.PIN & !nLDS.PIN & !R_nW.PIN & !nENGINE_SELECT & !A_1.PIN) # (!state_8 & desc_ptr_3 & abc:n282Q))
  [ 5 PTs]  src_addr_16.D = ((src_addr_16 & !abc:n403Q) # (!state_7 & abc:n403Q & D_0) # (state_7 & src_addr_16 & abc:n309Q) # (state_7 & src_addr_16 & !src_addr_15) # (state_7 & !src_addr_16 & src_addr_15 & abc:n403Q & src_addr_12 & src_addr_13 & src_addr_14 & src_addr_7 & src_addr_8 & src_addr_9 & src_addr_10 & src_addr_11 & src_addr_1 & src_addr_2 & src_addr_3 & src_addr_4 & src_addr_5 & src_addr_6))
  [ 4 PTs]  desc_ptr_4.D = ((!state_8 & D_4 & A_0.PIN & !nAS.PIN & !nLDS.PIN & !R_nW.PIN & !nENGINE_SELECT & !A_1.PIN) # (!state_8 & desc_ptr_4 & abc:n282Q) # (state_8 & desc_ptr_4 & abc:n378Q) # (state_8 & !desc_ptr_4 & desc_ptr_2 & desc_ptr_3 & desc_ptr_0 & desc_ptr_1))
  [ 5 PTs]  desc_ptr_5.D = ((state_8 & desc_ptr_5 & !desc_ptr_4) # (state_8 & desc_ptr_5 & abc:n378Q) # (!state_8 & D_5 & A_0.PIN & !nAS.PIN & !nLDS.PIN & !R_nW.PIN & !nENGINE_SELECT & !A_1.PIN) # (!state_8 & desc_ptr_5 & abc:n282Q) # (state_8 & !desc_ptr_5 & desc_ptr_4 & desc_ptr_2 & desc_ptr_3 & desc_ptr_0 & desc_ptr_1))
  [ 4 PTs]  desc_ptr_7.D = ((!state_8 & D_7 & A_0.PIN & !nAS.PIN & !nLDS.PIN & !R_nW.PIN & !nENGINE_SELECT & !A_1.PIN) # (!state_8 & desc_ptr_7 & abc:n282Q) # (state_8 & desc_ptr_7 & abc:n381Q) # (state_8 & !desc_ptr_7 & desc_ptr_6 & desc_ptr_0 & desc_ptr_1 & desc_ptr_2 & desc_ptr_3 & desc_ptr_4 & desc_ptr_5))
  [ 4 PTs]  src_addr_17.D = ((src_addr_17 & state_7 & abc:n405Q) # (abc:n403Q & !state_7 & D_1) # (abc:n403Q & !src_addr_17 & state_7 & src_addr_15 & src_addr_16 & src_addr_12 & src_addr_13 & src_addr_14 & src_addr_7 & src_addr_8 & src_addr_9 & src_addr_10 & src_addr_11 & src_addr_1 & src_addr_2 & src_addr_3 & src_addr_4 & src_addr_5 & src_addr_6) # (!abc:n403Q & src_addr_17))
  [ 5 PTs]  desc_ptr_6.D = ((desc_ptr_6 & state_8 & !desc_ptr_2) # (desc_ptr_6 & state_8 & !desc_ptr_3) # (desc_ptr_6 & state_8 & !desc_ptr_4) # XXL_1037 # (desc_ptr_6 & state_8 & !desc_ptr_1))
  [ 4 PTs]  desc_ptr_9.D = ((!state_8 & D_9 & A_0.PIN & !nAS.PIN & !nLDS.PIN & !R_nW.PIN & !nENGINE_SELECT & !A_1.PIN) # (!state_8 & desc_ptr_9 & abc:n282Q) # (state_8 & desc_ptr_9 & abc:n383Q) # (state_8 & !desc_ptr_9 & desc_ptr_6 & desc_ptr_7 & desc_ptr_8 & desc_ptr_0 & desc_ptr_1 & desc_ptr_2 & desc_ptr_3 & desc_ptr_4 & desc_ptr_5))
  [ 5 PTs]  src_addr_18.D = ((!abc:n403Q & src_addr_18) # (state_7 & src_addr_18 & !src_addr_17) # (state_7 & src_addr_18 & abc:n405Q) # (!state_7 & abc:n403Q & D_2) # (state_7 & abc:n403Q & !src_addr_18 & src_addr_17 & src_addr_15 & src_addr_16 & src_addr_12 & src_addr_13 & src_addr_14 & src_addr_7 & src_addr_8 & src_addr_9 & src_addr_10 & src_addr_11 & src_addr_1 & src_addr_2 & src_addr_3 & src_addr_4 & src_addr_5 & src_addr_6))
  [ 5 PTs]  desc_ptr_8.D = ((state_8 & desc_ptr_8 & !desc_ptr_7) # (state_8 & desc_ptr_8 & abc:n381Q) # (!state_8 & D_8 & A_0.PIN & !nAS.PIN & !nLDS.PIN & !R_nW.PIN & !nENGINE_SELECT & !A_1.PIN) # (!state_8 & desc_ptr_8 & abc:n282Q) # (state_8 & !desc_ptr_8 & desc_ptr_7 & desc_ptr_6 & desc_ptr_0 & desc_ptr_1 & desc_ptr_2 & desc_ptr_3 & desc_ptr_4 & desc_ptr_5))
  [ 5 PTs]  desc_ptr_12.D = ((state_8 & desc_ptr_12 & !desc_ptr_11) # (state_8 & desc_ptr_12 & abc:n385Q) # (!state_8 & D_12 & A_0.PIN & !nAS.PIN & !nLDS.PIN & !R_nW.PIN & !nENGINE_SELECT & !A_1.PIN) # (!state_8 & desc_ptr_12 & abc:n282Q) # (state_8 & !desc_ptr_12 & desc_ptr_11 & desc_ptr_9 & desc_ptr_10 & desc_ptr_6 & desc_ptr_7 & desc_ptr_8 & desc_ptr_0 & desc_ptr_1 & desc_ptr_2 & desc_ptr_3 & desc_ptr_4 & desc_ptr_5))
  [ 5 PTs]  desc_ptr_10.D = ((state_8 & desc_ptr_10 & !desc_ptr_9) # (state_8 & desc_ptr_10 & abc:n383Q) # (!state_8 & D_10 & A_0.PIN & !nAS.PIN & !nLDS.PIN & !R_nW.PIN & !nENGINE_SELECT & !A_1.PIN) # (!state_8 & desc_ptr_10 & abc:n282Q) # (state_8 & !desc_ptr_10 & desc_ptr_9 & desc_ptr_6 & desc_ptr_7 & desc_ptr_8 & desc_ptr_0 & desc_ptr_1 & desc_ptr_2 & desc_ptr_3 & desc_ptr_4 & desc_ptr_5))
  [ 4 PTs]  desc_ptr_11.D = ((!state_8 & D_11 & A_0.PIN & !nAS.PIN & !nLDS.PIN & !R_nW.PIN & !nENGINE_SELECT & !A_1.PIN) # (!state_8 & desc_ptr_11 & abc:n282Q) # (state_8 & desc_ptr_11 & abc:n385Q) # (state_8 & !desc_ptr_11 & desc_ptr_9 & desc_ptr_10 & desc_ptr_6 & desc_ptr_7 & desc_ptr_8 & desc_ptr_0 & desc_ptr_1 & desc_ptr_2 & desc_ptr_3 & desc_ptr_4 & desc_ptr_5))
  [ 4 PTs]  abc:n398 = ((!state_10 & !state_0 & !state_1 & !state_2 & !state_3 & !state_4 & !state_5 & !state_6 & !state_11 & words_left_6 & words_left_4 & words_left_5 & words_left_3 & words_left_0 & words_left_1 & words_left_2 & wait_hblank & desc_ptr_0 & desc_ptr_1) # (!state_10 & !state_0 & !state_1 & !state_2 & !state_3 & !state_4 & !state_5 & !state_6 & !state_11 & !state_8 & !state_7) # (!state_10 & !state_0 & !state_1 & !state_2 & !state_3 & !state_4 & !state_5 & !state_6 & !state_11 & wait_hblank & desc_ptr_0 & desc_ptr_1 & !state_7) # (!state_10 & !state_0 & !state_1 & !state_2 & !state_3 & !state_4 & !state_5 & !state_6 & !state_11 & !state_8 & words_left_6 & words_left_4 & words_left_5 & words_left_3 & words_left_0 & words_left_1 & words_left_2))
  [ 5 PTs]  desc_ptr_14.D = ((!state_8 & desc_ptr_14 & abc:n282Q) # (!state_8 & D_14 & A_0.PIN & !nAS.PIN & !nLDS.PIN & !R_nW.PIN & !nENGINE_SELECT & !A_1.PIN) # (state_8 & !desc_ptr_14 & desc_ptr_13 & desc_ptr_11 & desc_ptr_12 & desc_ptr_9 & desc_ptr_10 & desc_ptr_6 & desc_ptr_7 & desc_ptr_8 & desc_ptr_0 & desc_ptr_1 & desc_ptr_2 & desc_ptr_3 & desc_ptr_4 & desc_ptr_5) # (state_8 & desc_ptr_14 & !desc_ptr_13) # (state_8 & desc_ptr_14 & abc:n387Q))
  [ 4 PTs]  words_left_5.D = ((abc:n320Q & state_7 & !words_left_5 & words_left_4 & words_left_3 & words_left_0 & words_left_1 & words_left_2) # (!abc:n320Q & words_left_5) # XXL_1038 # (abc:n320Q & !state_7 & !D_9))
  [ 3 PTs]  state_1.D = ((state_8 & desc_ptr_0 & desc_ptr_1 & !wait_hblank) # (state_7 & abc:n329Q) # (phase_payload & state_9))
  [ 3 PTs]  src_addr_20.D = ((src_addr_20 & state_7 & !src_addr_18) # XXL_1039 # (src_addr_20 & !abc:n403Q))
  [ 5 PTs]  src_addr_22.D = ((state_7 & abc:n403Q & !src_addr_22 & src_addr_18 & src_addr_19 & src_addr_20 & src_addr_21 & src_addr_17 & src_addr_15 & src_addr_16 & src_addr_12 & src_addr_13 & src_addr_14 & src_addr_7 & src_addr_8 & src_addr_9 & src_addr_10 & src_addr_11 & src_addr_1 & src_addr_2 & src_addr_3 & src_addr_4 & src_addr_5 & src_addr_6) # (!abc:n403Q & src_addr_22) # (state_7 & src_addr_22 & !src_addr_18) # XXL_1040 # (!state_7 & abc:n403Q & D_6))
  [ 2 PTs]  src_addr_19.D = (XXL_1041 # (state_7 & abc:n403Q & !src_addr_19 & src_addr_17 & src_addr_18 & src_addr_15 & src_addr_16 & src_addr_12 & src_addr_13 & src_addr_14 & src_addr_7 & src_addr_8 & src_addr_9 & src_addr_10 & src_addr_11 & src_addr_1 & src_addr_2 & src_addr_3 & src_addr_4 & src_addr_5 & src_addr_6))
  [ 4 PTs]  desc_ptr_13.D = ((state_8 & desc_ptr_13 & abc:n387Q) # (state_8 & !desc_ptr_13 & desc_ptr_11 & desc_ptr_12 & desc_ptr_9 & desc_ptr_10 & desc_ptr_6 & desc_ptr_7 & desc_ptr_8 & desc_ptr_0 & desc_ptr_1 & desc_ptr_2 & desc_ptr_3 & desc_ptr_4 & desc_ptr_5) # (!state_8 & desc_ptr_13 & abc:n282Q) # (!state_8 & D_13 & A_0.PIN & !nAS.PIN & !nLDS.PIN & !R_nW.PIN & !nENGINE_SELECT & !A_1.PIN))
  [ 4 PTs]  src_addr_21.D = ((src_addr_21 & state_7 & abc:n405Q) # (src_addr_21 & state_7 & !src_addr_17) # XXL_1042 # (src_addr_21 & state_7 & !src_addr_20))
  [ 1 PTs]  state_10.D = (state_7 & !stop_after & words_left_6 & words_left_4 & words_left_5 & words_left_3 & words_left_0 & words_left_1 & words_left_2)
  [ 1 PTs]  state_4.D = (state_7 & stop_after & words_left_6 & words_left_4 & words_left_5 & words_left_3 & words_left_0 & words_left_1 & words_left_2)
  [ 2 PTs]  lds_out.D = ((!abc:n398Q & lds_out) # (abc:n398Q & !state_9))
  [ 4 PTs]  words_left_6.D = ((abc:n320Q & state_7 & abc:n329Q & words_left_4 & words_left_5 & words_left_3 & words_left_0 & words_left_1 & words_left_2) # (words_left_6 & state_7 & abc:n329Q) # (abc:n320Q & !state_7 & !D_10) # (!abc:n320Q & words_left_6))
  [ 5 PTs]  phase_payload.D = ((state_8 & desc_ptr_0 & desc_ptr_1 & !state_0 & !stop_after & words_left_6 & words_left_4 & words_left_5 & words_left_3 & words_left_0 & words_left_1 & words_left_2) # (state_8 & desc_ptr_0 & desc_ptr_1 & !stop_after & words_left_6 & words_left_4 & words_left_5 & words_left_3 & words_left_0 & words_left_1 & words_left_2 & dma_en) # (state_8 & desc_ptr_0 & desc_ptr_1 & !state_7 & dma_en) # XXL_1043 # (state_8 & desc_ptr_0 & desc_ptr_1 & !state_7 & !state_0))
  [ 5 PTs]  XXL_1032 = ((nBR.Q & dma_en & state_3 & !nAS_sync) # (nBR.Q & state_1) # (nBR.Q & state_2) # (nBR.Q & state_8) # (nBR.Q & state_6 & dma_en))
  [ 5 PTs]  XXL_1033 = ((nBR.Q & state_7) # (nBR.Q & state_5) # (nBR.Q & !dma_en & state_0) # (nBR.Q & !dma_en & state_11) # (nBR.Q & state_9))
  [ 5 PTs]  XXL_1034 = ((!state_11 & !state_1 & !state_2 & !state_8 & !state_9 & !state_7 & !state_5 & !state_0 & !state_10 & !dma_en) # (!state_11 & !state_6 & !state_1 & !state_2 & !state_8 & !state_9 & !state_7 & !state_5 & !state_0 & !state_10 & nAS_sync) # (state_11 & nBR.Q & !hblank_sync) # (state_11 & nBR.Q & !hblank_sync_d) # (!state_11 & !state_6 & !state_3 & !state_1 & !state_2 & !state_8 & !state_9 & !state_7 & !state_5 & !state_0 & !state_10))
  [ 5 PTs]  XXL_1035 = ((src_addr_7 & state_7 & !src_addr_2) # (src_addr_7 & state_7 & !src_addr_3) # (src_addr_7 & state_7 & !src_addr_4) # (src_addr_7 & state_7 & !src_addr_5) # (src_addr_7 & state_7 & !src_addr_1))
  [ 5 PTs]  XXL_1036 = ((src_addr_14 & !abc:n295Q) # (!state_7 & abc:n295Q & D_14) # (state_7 & src_addr_14 & !src_addr_12) # (state_7 & src_addr_14 & abc:n306Q) # (state_7 & !src_addr_14 & src_addr_13 & src_addr_12 & abc:n295Q & src_addr_7 & src_addr_8 & src_addr_9 & src_addr_10 & src_addr_11 & src_addr_1 & src_addr_2 & src_addr_3 & src_addr_4 & src_addr_5 & src_addr_6))
  [ 5 PTs]  XXL_1037 = ((!desc_ptr_6 & state_8 & desc_ptr_5 & desc_ptr_4 & desc_ptr_3 & desc_ptr_2 & desc_ptr_1 & desc_ptr_0) # (!state_8 & D_6 & A_0.PIN & !nAS.PIN & !nLDS.PIN & !R_nW.PIN & !nENGINE_SELECT & !A_1.PIN) # (desc_ptr_6 & !state_8 & abc:n282Q) # (desc_ptr_6 & state_8 & !desc_ptr_0) # (desc_ptr_6 & state_8 & !desc_ptr_5))
  [ 5 PTs]  XXL_1038 = ((words_left_5 & state_7 & !words_left_3) # (words_left_5 & state_7 & !words_left_0) # (words_left_5 & state_7 & !words_left_1) # (words_left_5 & state_7 & !words_left_2) # (words_left_5 & state_7 & !words_left_4))
  [ 5 PTs]  XXL_1039 = ((src_addr_20 & state_7 & abc:n405Q) # (src_addr_20 & state_7 & !src_addr_17) # (!state_7 & abc:n403Q & D_4) # (!src_addr_20 & state_7 & src_addr_19 & src_addr_17 & abc:n403Q & src_addr_18 & src_addr_15 & src_addr_16 & src_addr_12 & src_addr_13 & src_addr_14 & src_addr_7 & src_addr_8 & src_addr_9 & src_addr_10 & src_addr_11 & src_addr_1 & src_addr_2 & src_addr_3 & src_addr_4 & src_addr_5 & src_addr_6) # (src_addr_20 & state_7 & !src_addr_19))
  [ 5 PTs]  XXL_1040 = ((src_addr_22 & state_7 & !src_addr_20) # (src_addr_22 & state_7 & !src_addr_21) # (src_addr_22 & state_7 & abc:n405Q) # (src_addr_22 & state_7 & !src_addr_17) # (src_addr_22 & state_7 & !src_addr_19))
  [ 5 PTs]  XXL_1041 = ((src_addr_19 & state_7 & !src_addr_18) # (src_addr_19 & state_7 & abc:n405Q) # (src_addr_19 & state_7 & !src_addr_17) # (abc:n403Q & !state_7 & D_3) # (!abc:n403Q & src_addr_19))
  [ 5 PTs]  XXL_1042 = ((state_7 & abc:n403Q & !src_addr_21 & src_addr_17 & src_addr_20 & src_addr_19 & src_addr_18 & src_addr_15 & src_addr_16 & src_addr_12 & src_addr_13 & src_addr_14 & src_addr_7 & src_addr_8 & src_addr_9 & src_addr_10 & src_addr_11 & src_addr_1 & src_addr_2 & src_addr_3 & src_addr_4 & src_addr_5 & src_addr_6) # (!abc:n403Q & src_addr_21) # (state_7 & src_addr_21 & !src_addr_18) # (state_7 & src_addr_21 & !src_addr_19) # (!state_7 & abc:n403Q & D_5))
  [ 5 PTs]  XXL_1043 = ((phase_payload & state_7 & abc:n329Q) # (phase_payload & state_7 & stop_after) # (phase_payload & state_8) # (!state_0 & phase_payload & !state_7) # (!dma_en & state_0 & phase_payload))
  [ 1 PTs]  hblank_sync.C = CPUCLK
  [ 1 PTs]  hblank_sync.AR = !nRESET
  [ 1 PTs]  hblank_meta.C = CPUCLK
  [ 1 PTs]  hblank_meta.AR = !nRESET
  [ 1 PTs]  state_7.C = CPUCLK
  [ 1 PTs]  state_7.AR = !nRESET
  [ 1 PTs]  state_8.C = CPUCLK
  [ 1 PTs]  state_8.AR = !nRESET
  [ 1 PTs]  nAS_sync.C = CPUCLK
  [ 1 PTs]  nAS_sync.AP = !nRESET
  [ 1 PTs]  nAS_meta.C = CPUCLK
  [ 1 PTs]  nAS_meta.AP = !nRESET
  [ 1 PTs]  nBG_sync.C = CPUCLK
  [ 1 PTs]  nBG_sync.AP = !nRESET
  [ 1 PTs]  nBG_meta.C = CPUCLK
  [ 1 PTs]  nBG_meta.AP = !nRESET
  [ 1 PTs]  FC_1.OE = !$abc$2512$nBGACK
  [ 1 PTs]  FC_0.OE = !$abc$2512$nBGACK
  [ 1 PTs]  A_21.OE = !$abc$2512$nBGACK
  [ 1 PTs]  A_20.OE = !$abc$2512$nBGACK
  [ 1 PTs]  A_19.OE = !$abc$2512$nBGACK
  [ 1 PTs]  A_18.OE = !$abc$2512$nBGACK
  [ 1 PTs]  A_17.OE = !$abc$2512$nBGACK
  [ 1 PTs]  A_16.OE = !$abc$2512$nBGACK
  [ 1 PTs]  A_15.OE = !$abc$2512$nBGACK
  [ 1 PTs]  A_14.OE = !$abc$2512$nBGACK
  [ 1 PTs]  A_13.OE = !$abc$2512$nBGACK
  [ 1 PTs]  A_12.OE = !$abc$2512$nBGACK
  [ 1 PTs]  A_11.OE = !$abc$2512$nBGACK
  [ 1 PTs]  A_10.OE = !$abc$2512$nBGACK
  [ 1 PTs]  A_9.OE = !$abc$2512$nBGACK
  [ 1 PTs]  A_8.OE = !$abc$2512$nBGACK
  [ 1 PTs]  A_7.OE = !$abc$2512$nBGACK
  [ 1 PTs]  A_6.OE = !$abc$2512$nBGACK
  [ 1 PTs]  A_5.OE = !$abc$2512$nBGACK
  [ 1 PTs]  A_4.OE = !$abc$2512$nBGACK
  [ 1 PTs]  A_3.OE = !$abc$2512$nBGACK
  [ 1 PTs]  A_2.OE = !$abc$2512$nBGACK
  [ 1 PTs]  A_1.OE = !$abc$2512$nBGACK
  [ 1 PTs]  A_0.OE = !$abc$2512$nBGACK
  [ 1 PTs]  hblank_sync_d.C = CPUCLK
  [ 1 PTs]  hblank_sync_d.AR = !nRESET
  [ 1 PTs]  nLDS.OE = !$abc$2512$nBGACK
  [ 1 PTs]  FC_2.OE = !$abc$2512$nBGACK
  [ 1 PTs]  nUDS.OE = !$abc$2512$nBGACK
  [ 1 PTs]  R_nW.OE = !$abc$2512$nBGACK
  [ 1 PTs]  nAS.OE = !$abc$2512$nBGACK
  [ 1 PTs]  A_22.OE = !$abc$2512$nBGACK
  [ 1 PTs]  state_0.C = CPUCLK
  [ 1 PTs]  state_0.AP = !nRESET
  [ 1 PTs]  state_3.C = CPUCLK
  [ 1 PTs]  state_3.AR = !nRESET
  [ 1 PTs]  state_9.C = CPUCLK
  [ 1 PTs]  state_9.AR = !nRESET
  [ 1 PTs]  state_11.C = CPUCLK
  [ 1 PTs]  state_11.AR = !nRESET
  [ 1 PTs]  state_2.C = CPUCLK
  [ 1 PTs]  state_2.AR = !nRESET
  [ 1 PTs]  state_6.C = CPUCLK
  [ 1 PTs]  state_6.AR = !nRESET
  [ 1 PTs]  $abc$2512$nBGACK.C = CPUCLK
  [ 1 PTs]  $abc$2512$nBGACK.AP = !nRESET
  [ 1 PTs]  words_left_0.C = CPUCLK
  [ 1 PTs]  words_left_0.AR = !nRESET
  [ 1 PTs]  dest_1.C = CPUCLK
  [ 1 PTs]  dest_1.AR = !nRESET
  [ 1 PTs]  src_addr_1.C = CPUCLK
  [ 1 PTs]  src_addr_1.AR = !nRESET
  [ 1 PTs]  src_addr_4.C = CPUCLK
  [ 1 PTs]  src_addr_4.AR = !nRESET
  [ 1 PTs]  dest_2.C = CPUCLK
  [ 1 PTs]  dest_2.AR = !nRESET
  [ 1 PTs]  state_5.C = CPUCLK
  [ 1 PTs]  state_5.AR = !nRESET
  [ 1 PTs]  wait_hblank.C = CPUCLK
  [ 1 PTs]  wait_hblank.AR = !nRESET
  [ 1 PTs]  src_addr_5.C = CPUCLK
  [ 1 PTs]  src_addr_5.AR = !nRESET
  [ 1 PTs]  nDEPOSIT.C = CPUCLK
  [ 1 PTs]  nDEPOSIT.AP = !nRESET
  [ 1 PTs]  nBR.C = CPUCLK
  [ 1 PTs]  nBR.AP = !nRESET
  [ 1 PTs]  src_addr_12.C = CPUCLK
  [ 1 PTs]  src_addr_12.AR = !nRESET
  [ 1 PTs]  stop_after.C = CPUCLK
  [ 1 PTs]  stop_after.AR = !nRESET
  [ 1 PTs]  dest_0.C = CPUCLK
  [ 1 PTs]  dest_0.AR = !nRESET
  [ 1 PTs]  src_addr_2.C = CPUCLK
  [ 1 PTs]  src_addr_2.AR = !nRESET
  [ 1 PTs]  words_left_1.C = CPUCLK
  [ 1 PTs]  words_left_1.AR = !nRESET
  [ 1 PTs]  src_addr_3.C = CPUCLK
  [ 1 PTs]  src_addr_3.AR = !nRESET
  [ 1 PTs]  words_left_2.C = CPUCLK
  [ 1 PTs]  words_left_2.AR = !nRESET
  [ 1 PTs]  words_left_3.C = CPUCLK
  [ 1 PTs]  words_left_3.AR = !nRESET
  [ 1 PTs]  src_addr_6.C = CPUCLK
  [ 1 PTs]  src_addr_6.AR = !nRESET
  [ 1 PTs]  words_left_4.C = CPUCLK
  [ 1 PTs]  words_left_4.AR = !nRESET
  [ 1 PTs]  src_addr_15.C = CPUCLK
  [ 1 PTs]  src_addr_15.AR = !nRESET
  [ 1 PTs]  nENGINE_IRQ.C = CPUCLK
  [ 1 PTs]  nENGINE_IRQ.AP = !nRESET
  [ 1 PTs]  dma_en.C = CPUCLK
  [ 1 PTs]  dma_en.AR = !nRESET
  [ 1 PTs]  src_addr_7.C = CPUCLK
  [ 1 PTs]  src_addr_7.AR = !nRESET
  [ 1 PTs]  src_addr_10.C = CPUCLK
  [ 1 PTs]  src_addr_10.AR = !nRESET
  [ 1 PTs]  src_addr_8.C = CPUCLK
  [ 1 PTs]  src_addr_8.AR = !nRESET
  [ 1 PTs]  src_addr_9.C = CPUCLK
  [ 1 PTs]  src_addr_9.AR = !nRESET
  [ 1 PTs]  src_addr_14.C = CPUCLK
  [ 1 PTs]  src_addr_14.AR = !nRESET
  [ 1 PTs]  src_addr_11.C = CPUCLK
  [ 1 PTs]  src_addr_11.AR = !nRESET
  [ 1 PTs]  src_addr_13.C = CPUCLK
  [ 1 PTs]  src_addr_13.AR = !nRESET
  [ 1 PTs]  desc_ptr_2.C = CPUCLK
  [ 1 PTs]  desc_ptr_2.AR = !nRESET
  [ 1 PTs]  desc_ptr_0.C = CPUCLK
  [ 1 PTs]  desc_ptr_0.AR = !nRESET
  [ 1 PTs]  desc_ptr_1.C = CPUCLK
  [ 1 PTs]  desc_ptr_1.AR = !nRESET
  [ 1 PTs]  desc_ptr_3.C = CPUCLK
  [ 1 PTs]  desc_ptr_3.AR = !nRESET
  [ 1 PTs]  src_addr_16.C = CPUCLK
  [ 1 PTs]  src_addr_16.AR = !nRESET
  [ 1 PTs]  desc_ptr_4.C = CPUCLK
  [ 1 PTs]  desc_ptr_4.AR = !nRESET
  [ 1 PTs]  desc_ptr_5.C = CPUCLK
  [ 1 PTs]  desc_ptr_5.AR = !nRESET
  [ 1 PTs]  desc_ptr_7.C = CPUCLK
  [ 1 PTs]  desc_ptr_7.AR = !nRESET
  [ 1 PTs]  src_addr_17.C = CPUCLK
  [ 1 PTs]  src_addr_17.AR = !nRESET
  [ 1 PTs]  desc_ptr_6.C = CPUCLK
  [ 1 PTs]  desc_ptr_6.AR = !nRESET
  [ 1 PTs]  desc_ptr_9.C = CPUCLK
  [ 1 PTs]  desc_ptr_9.AR = !nRESET
  [ 1 PTs]  src_addr_18.C = CPUCLK
  [ 1 PTs]  src_addr_18.AR = !nRESET
  [ 1 PTs]  desc_ptr_8.C = CPUCLK
  [ 1 PTs]  desc_ptr_8.AR = !nRESET
  [ 1 PTs]  desc_ptr_12.C = CPUCLK
  [ 1 PTs]  desc_ptr_12.AR = !nRESET
  [ 1 PTs]  desc_ptr_10.C = CPUCLK
  [ 1 PTs]  desc_ptr_10.AR = !nRESET
  [ 1 PTs]  desc_ptr_11.C = CPUCLK
  [ 1 PTs]  desc_ptr_11.AR = !nRESET
  [ 1 PTs]  desc_ptr_14.C = CPUCLK
  [ 1 PTs]  desc_ptr_14.AR = !nRESET
  [ 1 PTs]  words_left_5.C = CPUCLK
  [ 1 PTs]  words_left_5.AR = !nRESET
  [ 1 PTs]  state_1.C = CPUCLK
  [ 1 PTs]  state_1.AR = !nRESET
  [ 1 PTs]  src_addr_20.C = CPUCLK
  [ 1 PTs]  src_addr_20.AR = !nRESET
  [ 1 PTs]  src_addr_22.C = CPUCLK
  [ 1 PTs]  src_addr_22.AR = !nRESET
  [ 1 PTs]  src_addr_19.C = CPUCLK
  [ 1 PTs]  src_addr_19.AR = !nRESET
  [ 1 PTs]  desc_ptr_13.C = CPUCLK
  [ 1 PTs]  desc_ptr_13.AR = !nRESET
  [ 1 PTs]  src_addr_21.C = CPUCLK
  [ 1 PTs]  src_addr_21.AR = !nRESET
  [ 1 PTs]  state_10.C = CPUCLK
  [ 1 PTs]  state_10.AR = !nRESET
  [ 1 PTs]  state_4.C = CPUCLK
  [ 1 PTs]  state_4.AR = !nRESET
  [ 1 PTs]  lds_out.C = CPUCLK
  [ 1 PTs]  lds_out.AP = !nRESET
  [ 1 PTs]  words_left_6.C = CPUCLK
  [ 1 PTs]  words_left_6.AR = !nRESET
  [ 1 PTs]  phase_payload.C = CPUCLK
  [ 1 PTs]  phase_payload.AR = !nRESET
