bradgrantham/griffin/image-tools/smurf-assets/README.md

# smurf-assets

Generated art for the smurf demo, plus everything the target needs to display
it.  Nothing in this directory is hand-drawn: `make_smurf_assets` writes the
source PNGs in `src/`, `clut_encode` turns the backdrops into `.gc4` pictures,
and `sprite2spans` turns the sprite sheets into a header.  Regenerate the lot
with

    make -C image-tools all assets check

**2026-09-20: the backdrops were micro-HAM and are now 4bpp half rate.**  PIXEL
became index-only behind a sixteen-entry palette RAM; micro-HAM, `pal_fg`,
`pal_bg` and `ham_held` went with it, and `microham_encode` / `microham.h` /
`microham_roundtrip` are deleted.  The replacement is the same 80 words per
line, so nothing about the demo's descriptor budget moved.

## What is here

| file | what it is |
| --- | --- |
| `src/*.png` | generated source art, 8-bit RGB(A) |
| `backdropN-*.gc4` | 4bpp half-rate picture + palette, 77808 bytes |
| `backdropN-*-preview.png` | what the hardware will show, for eyeballing quality |
| `smurf_sprites.h` | span lists for every sprite frame |

## The backdrop mode, in one screen

**320 x 480, four bits per group, half rate.**  Each group is a four-bit index
into the sixteen-entry palette RAM and is held two pixel clocks, so 320 groups
cover the 640-clock line and a line is **80 words** — the same bandwidth
micro-HAM used.  Words are consumed MSB first out of consecutive big-endian
16-bit words; the first group of a line is bits 15..12 of word 0.

The backdrops are encoded with **K = 0**: ONE sixteen-colour palette for the
whole screen, carried in the file's header and loaded once per frame in vertical
blanking as sixteen three-word VIDCMD palette entries.  That is the right
trade for this demo and not a limitation of the format — `clut_encode --k 1..8`
reloads up to eight entries per LINE, which is what a photograph wants
(`image-tools/gc4_format.h`).  The game spends its per-line VIDCMD packet on
sprite spans and has nothing left to pay per-line palette loads with.

Why not attribute mode, the other 80-word-per-line option?  It keeps 640
horizontal resolution but allows only two colours per eight-pixel cell.  These
backdrops are painted scenery with soft vertical gradients, not tiles; the
gradients are exactly what an attribute cell cannot hold, and the sprites are a
COMPOSITOR overlay that never wanted the extra horizontal resolution.

The normative statement of the mode is `cpld/pixel/pixel.v` and
`cpld/pixel/pixel_tb.v`; the model is `super-engine/render.cpp`, and
`clut_roundtrip` fails the build if `clut_encode` and that model ever disagree.

## `.gc4` — the picture

`image-tools/gc4_format.h` is the specification and
`image-tools/gc4_target.h` is the 68000 reader.  In brief, all fields
big-endian:

    0   48 bytes   header: magic 'GCL4', version, K, 320, height, 80,
                   pix_mode, then the sixteen-entry initial palette
    48             palette section: height x (1 + K) words
                   (a load count, then K slots of {index[15:12], colour[11:0]})
    +              pixel section: height x 80 words, contiguous

Both sections are fixed stride and word aligned on purpose: a program reads the
pixel section straight into RAM and points ENGINE descriptors at it without
touching a word, and line n's palette record is a multiply rather than a walk.
At K = 0 the palette section is 480 words of zero counts and costs 960 bytes.

## `smurf_sprites.h` — sprite spans

Generated by `sprite2spans` from a sheet whose transparent colour is magenta
`0xFF00FF`.  Every row of every frame becomes a list of solid horizontal spans:

    struct SpriteSpan { uint16_t x, width, rgb444; };
    struct SpriteRow  { uint16_t first, count; };   // index into the frame's spans
    struct SpriteFrame
    {
        const char *name; uint16_t width, height, max_row_spans;
        const SpriteRow *rows; const SpriteSpan *spans;
    };

`SPRITE_FRAMES[]` / `SPRITE_FRAME_COUNT` enumerate them.  Frames shipped here:

| frame | size | worst row |
| --- | --- | --- |
| `SMURF_WALK0`, `SMURF_WALK1` | 24x32 | 5 spans |
| `SMURF_JUMP`, `SMURF_DUCK`, `SMURF_DEATH` | 24x32 | 5 spans |
| `SMURFETTE_WALK0`, `SMURFETTE_WALK1` | 24x32 | 5 spans |
| `BAT_FLAP0`, `BAT_FLAP1` | 24x16 | 5 spans |
| `FENCE` | 32x40 | 4 spans |

The header stores an `rgb444` per span and takes no position on how it is drawn.
That is the app's call at draw time, and it is not the same cost either way: a
span can go out as a `LITERAL` (two pixels, one word) or `LITERAL` + `HOLD(w-2)`
(any width from four, two words), any colour, exact width, held colours
untouched — widths 1 and 3 cannot be painted that way — or as a SET of
`cmp_held_fg` plus a RUN of `held_fg`, two words and one extra slot.
(`apps/smurf` keeps literals for the eight saturated corners, which were
`RUN_COLOR` words until that record was retired on 2026-10-03.)  The generator
warns above six spans in a row (`--max-spans`), which is the delivery budget for
overlay art; none of the shipped frames exceed it.

## Regeneration

    make -C image-tools assets        # art -> .gc4/-preview.png + header
    make -C image-tools check         # round trip vs the super-engine model

or by hand, which is what the Makefile runs:

    ./make_smurf_assets smurf-assets/src
    ./clut_encode --k 0 --dither fs \
        --preview smurf-assets/backdrop1-meadow-preview.png \
        smurf-assets/src/backdrop1-meadow.png smurf-assets/backdrop1-meadow.gc4
    ./sprite2spans -o smurf-assets/smurf_sprites.h --key FF00FF --max-spans 6 \
        smurf-assets/src/smurf.png,24,32,smurf_walk0,smurf_walk1,smurf_jump,smurf_duck,smurf_death \
        smurf-assets/src/smurfette.png,24,32,smurfette_walk0,smurfette_walk1 \
        smurf-assets/src/bat.png,24,16,bat_flap0,bat_flap1 \
        smurf-assets/src/fence.png,32,40,fence
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
