bradgrantham/griffin/image-tools/smurf-assets/backdrop3-clearing-preview.png

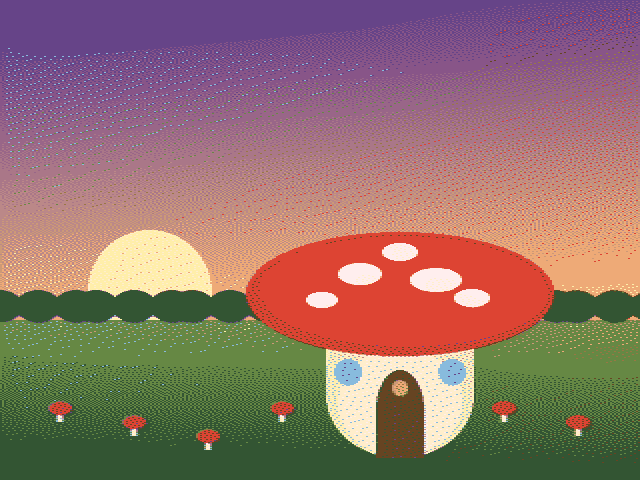
image-tools/smurf-assets/backdrop3-clearing-preview.png
