bradgrantham/griffin/image-tools/smurf-assets/src/backdrop1-meadow.png

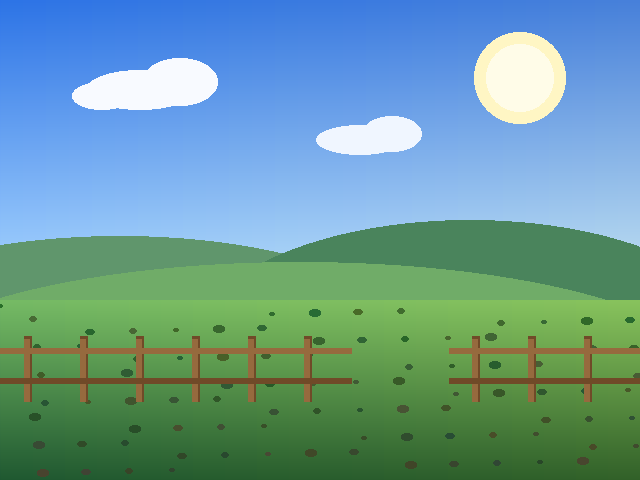
image-tools/smurf-assets/src/backdrop1-meadow.png
