bradgrantham/griffin/package2-evidence/console-shot-after.png

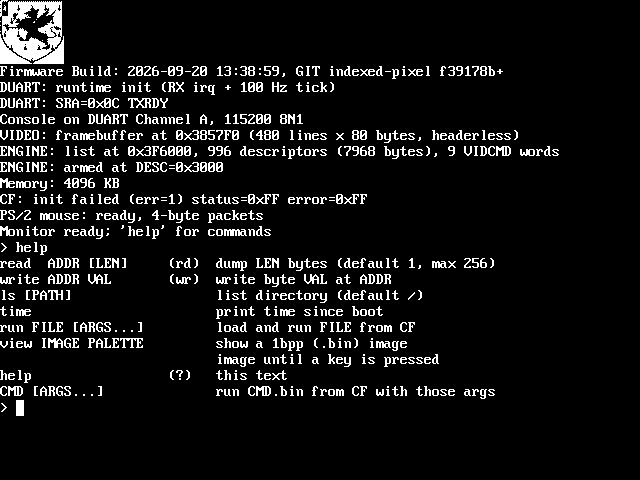
package2-evidence/console-shot-after.png
