bradgrantham/griffin/package2-evidence/console-shot-negative-control.png

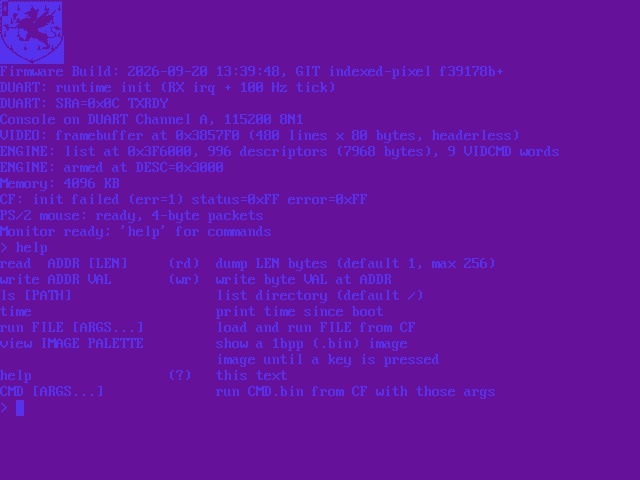
package2-evidence/console-shot-negative-control.png
