bradgrantham/griffin/package3-evidence/shot-console-after.png

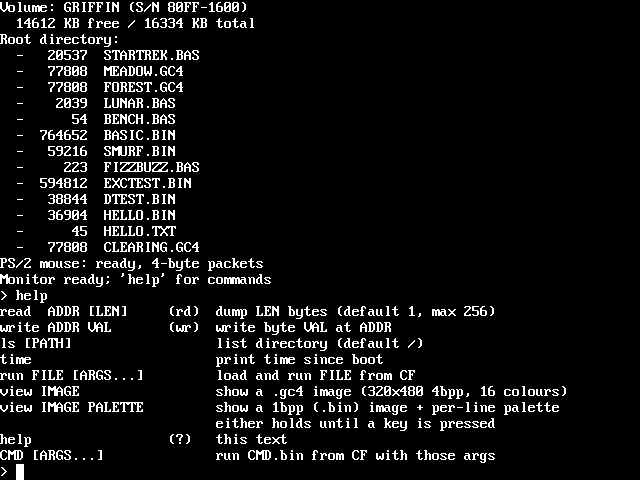
package3-evidence/shot-console-after.png
