bradgrantham/griffin/package3-evidence/shot-dmabench-C1.png

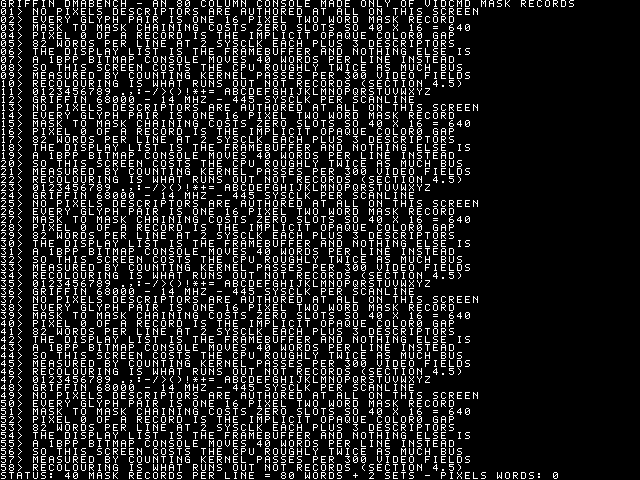
package3-evidence/shot-dmabench-C1.png
