bradgrantham/griffin/package3-evidence/shot-dmabench-C3.png

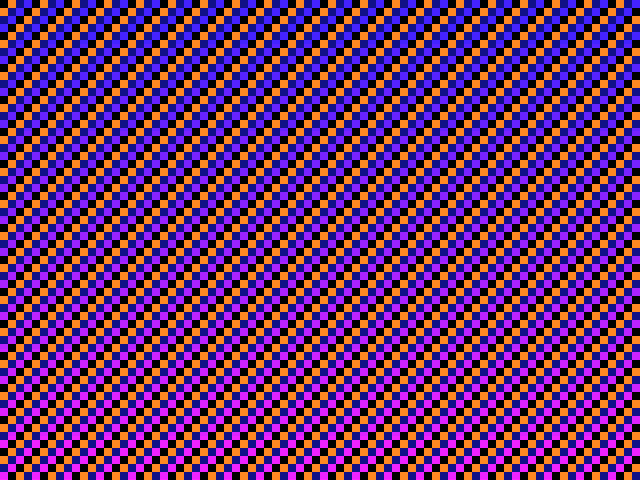
package3-evidence/shot-dmabench-C3.png
