bradgrantham/griffin/package3-evidence/shot-dtest.png

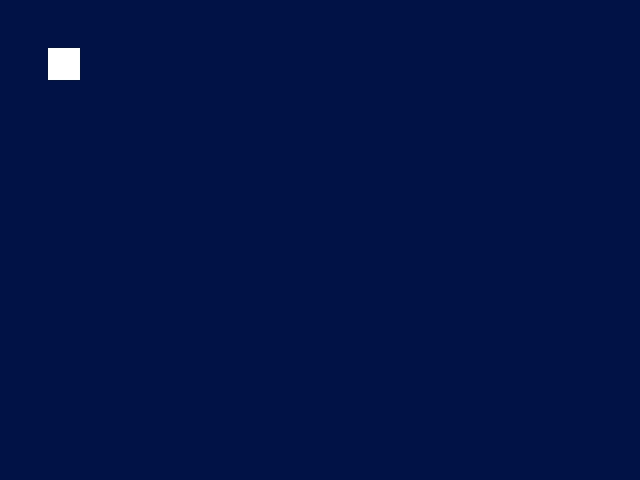
package3-evidence/shot-dtest.png
