bradgrantham/griffin/package3-evidence/shot-smurf-title.png

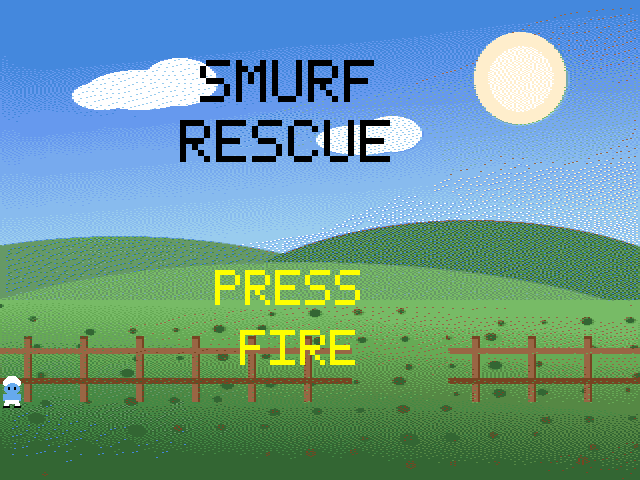
package3-evidence/shot-smurf-title.png
