bradgrantham/griffin/package3-evidence/smurf-meadow-preview-AFTER-4bpp.png

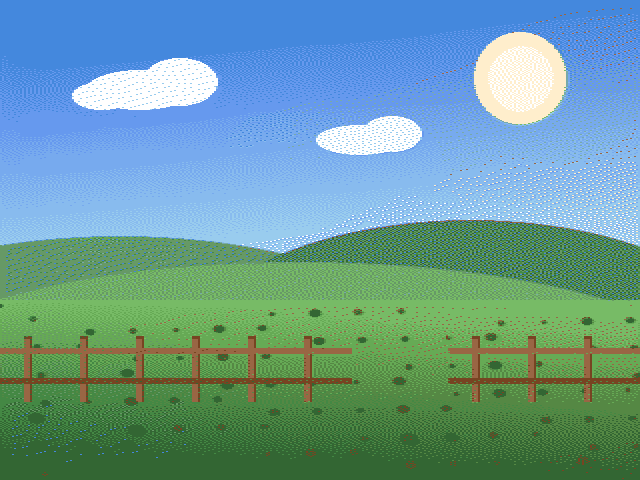
package3-evidence/smurf-meadow-preview-AFTER-4bpp.png
