bradgrantham/griffin/cpld/experiments/literal/pins_r2_pfree.txt

// harvested by the fitter, r2_pfree (free placement) -- NOT FROZEN
//PIN: H_ACTIVE          : 29   (block C)
//PIN: nRS               : 1   (block A)
//PIN: nVIDCMD_EF        : 79   (block H)
//PIN: nVIDCMD_RE        : 24   (block C)
//PIN: PIXEL_CLK         : 83   (block A)
//PIN: RGB_IN_0          : 40   (block D)
//PIN: RGB_IN_1          : 39   (block D)
//PIN: RGB_IN_10         : 37   (block D)
//PIN: RGB_IN_11         : 45   (block E)
//PIN: RGB_IN_2          : 54   (block F)
//PIN: RGB_IN_3          : 55   (block F)
//PIN: RGB_IN_4          : 22   (block B)
//PIN: RGB_IN_5          : 20   (block B)
//PIN: RGB_IN_6          : 21   (block B)
//PIN: RGB_IN_7          : 44   (block E)
//PIN: RGB_IN_8          : 31   (block C)
//PIN: RGB_IN_9          : 25   (block C)
//PIN: RGB_OUT_0         : 52   (block E)
//PIN: RGB_OUT_1         : 51   (block E)
//PIN: RGB_OUT_10        : 69   (block G)
//PIN: RGB_OUT_11        : 67   (block G)
//PIN: RGB_OUT_2         : 50   (block E)
//PIN: RGB_OUT_3         : 49   (block E)
//PIN: RGB_OUT_4         : 61   (block F)
//PIN: RGB_OUT_5         : 58   (block F)
//PIN: RGB_OUT_6         : 60   (block F)
//PIN: RGB_OUT_7         : 68   (block G)
//PIN: RGB_OUT_8         : 57   (block F)
//PIN: RGB_OUT_9         : 70   (block G)
//PIN: set_pix_commit    : 81   (block H)
//PIN: set_pix_target_0  : 16   (block B)
//PIN: set_pix_target_1  : 17   (block B)
//PIN: set_pix_target_2  : 18   (block B)
//PIN: set_pix_valid     : 15   (block B)
//PIN: set_pix_value_0   : 4   (block A)
//PIN: set_pix_value_1   : 6   (block A)
//PIN: set_pix_value_10  : 35   (block D)
//PIN: set_pix_value_11  : 36   (block D)
//PIN: set_pix_value_2   : 5   (block A)
//PIN: set_pix_value_3   : 8   (block A)
//PIN: set_pix_value_4   : 10   (block A)
//PIN: set_pix_value_5   : 9   (block A)
//PIN: set_pix_value_6   : 33   (block D)
//PIN: set_pix_value_7   : 11   (block A)
//PIN: set_pix_value_8   : 34   (block D)
//PIN: set_pix_value_9   : 12   (block A)
//PIN: VIDCMD_Q_0        : 74   (block H)
//PIN: VIDCMD_Q_1        : 80   (block H)
//PIN: VIDCMD_Q_10       : 77   (block H)
//PIN: VIDCMD_Q_11       : 48   (block E)
//PIN: VIDCMD_Q_12       : 56   (block F)
//PIN: VIDCMD_Q_13       : 75   (block H)
//PIN: VIDCMD_Q_14       : 64   (block G)
//PIN: VIDCMD_Q_15       : 27   (block C)
//PIN: VIDCMD_Q_2        : 73   (block H)
//PIN: VIDCMD_Q_3        : 63   (block G)
//PIN: VIDCMD_Q_4        : 76   (block H)
//PIN: VIDCMD_Q_5        : 28   (block C)
//PIN: VIDCMD_Q_6        : 30   (block C)
//PIN: VIDCMD_Q_7        : 65   (block G)
//PIN: VIDCMD_Q_8        : 41   (block D)
//PIN: VIDCMD_Q_9        : 46   (block E)
