bradgrantham/griffin/cpld/experiments/literal/pins_r2s_pfree.txt

// harvested by the fitter, r2s_pfree (free placement) -- NOT FROZEN
//PIN: H_ACTIVE          : 31   (block C)
//PIN: nRS               : 1   (block A)
//PIN: nVIDCMD_EF        : 30   (block C)
//PIN: nVIDCMD_RE        : 34   (block D)
//PIN: PIXEL_CLK         : 83   (block A)
//PIN: RGB_IN_0          : 55   (block F)
//PIN: RGB_IN_1          : 74   (block H)
//PIN: RGB_IN_10         : 56   (block F)
//PIN: RGB_IN_11         : 48   (block E)
//PIN: RGB_IN_2          : 73   (block H)
//PIN: RGB_IN_3          : 28   (block C)
//PIN: RGB_IN_4          : 22   (block B)
//PIN: RGB_IN_5          : 41   (block D)
//PIN: RGB_IN_6          : 39   (block D)
//PIN: RGB_IN_7          : 40   (block D)
//PIN: RGB_IN_8          : 45   (block E)
//PIN: RGB_IN_9          : 46   (block E)
//PIN: RGB_OUT_0         : 52   (block E)
//PIN: RGB_OUT_1         : 50   (block E)
//PIN: RGB_OUT_10        : 67   (block G)
//PIN: RGB_OUT_11        : 68   (block G)
//PIN: RGB_OUT_2         : 51   (block E)
//PIN: RGB_OUT_3         : 61   (block F)
//PIN: RGB_OUT_4         : 49   (block E)
//PIN: RGB_OUT_5         : 60   (block F)
//PIN: RGB_OUT_6         : 57   (block F)
//PIN: RGB_OUT_7         : 58   (block F)
//PIN: RGB_OUT_8         : 70   (block G)
//PIN: RGB_OUT_9         : 69   (block G)
//PIN: set_pix_commit    : 15   (block B)
//PIN: set_pix_target_0  : 17   (block B)
//PIN: set_pix_target_1  : 18   (block B)
//PIN: set_pix_target_2  : 12   (block A)
//PIN: set_pix_valid     : 16   (block B)
//PIN: set_pix_value_0   : 33   (block D)
//PIN: set_pix_value_1   : 35   (block D)
//PIN: set_pix_value_10  : 25   (block C)
//PIN: set_pix_value_11  : 27   (block C)
//PIN: set_pix_value_2   : 4   (block A)
//PIN: set_pix_value_3   : 5   (block A)
//PIN: set_pix_value_4   : 6   (block A)
//PIN: set_pix_value_5   : 8   (block A)
//PIN: set_pix_value_6   : 10   (block A)
//PIN: set_pix_value_7   : 9   (block A)
//PIN: set_pix_value_8   : 11   (block A)
//PIN: set_pix_value_9   : 24   (block C)
//PIN: VIDCMD_Q_0        : 81   (block H)
//PIN: VIDCMD_Q_1        : 80   (block H)
//PIN: VIDCMD_Q_10       : 65   (block G)
//PIN: VIDCMD_Q_11       : 75   (block H)
//PIN: VIDCMD_Q_12       : 21   (block B)
//PIN: VIDCMD_Q_13       : 37   (block D)
//PIN: VIDCMD_Q_14       : 54   (block F)
//PIN: VIDCMD_Q_15       : 44   (block E)
//PIN: VIDCMD_Q_2        : 20   (block B)
//PIN: VIDCMD_Q_3        : 63   (block G)
//PIN: VIDCMD_Q_4        : 29   (block C)
//PIN: VIDCMD_Q_5        : 79   (block H)
//PIN: VIDCMD_Q_6        : 76   (block H)
//PIN: VIDCMD_Q_7        : 36   (block D)
//PIN: VIDCMD_Q_8        : 64   (block G)
//PIN: VIDCMD_Q_9        : 77   (block H)
