bradgrantham/griffin/cpld/experiments/literal/pins_r2st_pfree.txt

// harvested by the fitter, r2st_pfree (free placement) -- NOT FROZEN
//PIN: H_ACTIVE          : 31   (block C)
//PIN: nRS               : 1   (block A)
//PIN: nVIDCMD_EF        : 68   (block G)
//PIN: nVIDCMD_RE        : 17   (block B)
//PIN: PIXEL_CLK         : 83   (block A)
//PIN: RGB_IN_0          : 29   (block C)
//PIN: RGB_IN_1          : 30   (block C)
//PIN: RGB_IN_10         : 65   (block G)
//PIN: RGB_IN_11         : 67   (block G)
//PIN: RGB_IN_2          : 28   (block C)
//PIN: RGB_IN_3          : 41   (block D)
//PIN: RGB_IN_4          : 40   (block D)
//PIN: RGB_IN_5          : 44   (block E)
//PIN: RGB_IN_6          : 35   (block D)
//PIN: RGB_IN_7          : 45   (block E)
//PIN: RGB_IN_8          : 46   (block E)
//PIN: RGB_IN_9          : 54   (block F)
//PIN: RGB_OUT_0         : 51   (block E)
//PIN: RGB_OUT_1         : 52   (block E)
//PIN: RGB_OUT_10        : 70   (block G)
//PIN: RGB_OUT_11        : 69   (block G)
//PIN: RGB_OUT_2         : 50   (block E)
//PIN: RGB_OUT_3         : 49   (block E)
//PIN: RGB_OUT_4         : 48   (block E)
//PIN: RGB_OUT_5         : 60   (block F)
//PIN: RGB_OUT_6         : 61   (block F)
//PIN: RGB_OUT_7         : 58   (block F)
//PIN: RGB_OUT_8         : 57   (block F)
//PIN: RGB_OUT_9         : 56   (block F)
//PIN: set_pix_commit    : 15   (block B)
//PIN: set_pix_target_0  : 20   (block B)
//PIN: set_pix_target_1  : 18   (block B)
//PIN: set_pix_target_2  : 21   (block B)
//PIN: set_pix_valid     : 16   (block B)
//PIN: set_pix_value_0   : 4   (block A)
//PIN: set_pix_value_1   : 5   (block A)
//PIN: set_pix_value_10  : 33   (block D)
//PIN: set_pix_value_11  : 34   (block D)
//PIN: set_pix_value_2   : 6   (block A)
//PIN: set_pix_value_3   : 8   (block A)
//PIN: set_pix_value_4   : 10   (block A)
//PIN: set_pix_value_5   : 9   (block A)
//PIN: set_pix_value_6   : 11   (block A)
//PIN: set_pix_value_7   : 25   (block C)
//PIN: set_pix_value_8   : 24   (block C)
//PIN: set_pix_value_9   : 27   (block C)
//PIN: VIDCMD_Q_0        : 81   (block H)
//PIN: VIDCMD_Q_1        : 80   (block H)
//PIN: VIDCMD_Q_10       : 76   (block H)
//PIN: VIDCMD_Q_11       : 75   (block H)
//PIN: VIDCMD_Q_12       : 74   (block H)
//PIN: VIDCMD_Q_13       : 73   (block H)
//PIN: VIDCMD_Q_14       : 12   (block A)
//PIN: VIDCMD_Q_15       : 63   (block G)
//PIN: VIDCMD_Q_2        : 39   (block D)
//PIN: VIDCMD_Q_3        : 37   (block D)
//PIN: VIDCMD_Q_4        : 36   (block D)
//PIN: VIDCMD_Q_5        : 79   (block H)
//PIN: VIDCMD_Q_6        : 77   (block H)
//PIN: VIDCMD_Q_7        : 22   (block B)
//PIN: VIDCMD_Q_8        : 55   (block F)
//PIN: VIDCMD_Q_9        : 64   (block G)
