bradgrantham/griffin/cpld/experiments/literal/pins_r4_pfree.txt

// harvested by the fitter, r4_pfree (free placement) -- NOT FROZEN
//PIN: H_ACTIVE          : 31   (block C)
//PIN: nRS               : 1   (block A)
//PIN: nVIDCMD_EF        : 48   (block E)
//PIN: nVIDCMD_RE        : 6   (block A)
//PIN: PIXEL_CLK         : 83   (block A)
//PIN: RGB_IN_0          : 54   (block F)
//PIN: RGB_IN_1          : 55   (block F)
//PIN: RGB_IN_10         : 65   (block G)
//PIN: RGB_IN_11         : 51   (block E)
//PIN: RGB_IN_2          : 56   (block F)
//PIN: RGB_IN_3          : 30   (block C)
//PIN: RGB_IN_4          : 22   (block B)
//PIN: RGB_IN_5          : 29   (block C)
//PIN: RGB_IN_6          : 28   (block C)
//PIN: RGB_IN_7          : 37   (block D)
//PIN: RGB_IN_8          : 52   (block E)
//PIN: RGB_IN_9          : 64   (block G)
//PIN: RGB_OUT_0         : 60   (block F)
//PIN: RGB_OUT_1         : 58   (block F)
//PIN: RGB_OUT_10        : 77   (block H)
//PIN: RGB_OUT_11        : 61   (block F)
//PIN: RGB_OUT_2         : 57   (block F)
//PIN: RGB_OUT_3         : 69   (block G)
//PIN: RGB_OUT_4         : 70   (block G)
//PIN: RGB_OUT_5         : 68   (block G)
//PIN: RGB_OUT_6         : 67   (block G)
//PIN: RGB_OUT_7         : 81   (block H)
//PIN: RGB_OUT_8         : 80   (block H)
//PIN: RGB_OUT_9         : 79   (block H)
//PIN: set_pix_commit    : 4   (block A)
//PIN: set_pix_target_0  : 9   (block A)
//PIN: set_pix_target_1  : 8   (block A)
//PIN: set_pix_target_2  : 10   (block A)
//PIN: set_pix_valid     : 5   (block A)
//PIN: set_pix_value_0   : 24   (block C)
//PIN: set_pix_value_1   : 33   (block D)
//PIN: set_pix_value_10  : 16   (block B)
//PIN: set_pix_value_11  : 25   (block C)
//PIN: set_pix_value_2   : 17   (block B)
//PIN: set_pix_value_3   : 15   (block B)
//PIN: set_pix_value_4   : 20   (block B)
//PIN: set_pix_value_5   : 18   (block B)
//PIN: set_pix_value_6   : 21   (block B)
//PIN: set_pix_value_7   : 34   (block D)
//PIN: set_pix_value_8   : 35   (block D)
//PIN: set_pix_value_9   : 36   (block D)
//PIN: VIDCMD_Q_0        : 49   (block E)
//PIN: VIDCMD_Q_1        : 11   (block A)
//PIN: VIDCMD_Q_10       : 75   (block H)
//PIN: VIDCMD_Q_11       : 73   (block H)
//PIN: VIDCMD_Q_12       : 76   (block H)
//PIN: VIDCMD_Q_13       : 46   (block E)
//PIN: VIDCMD_Q_14       : 45   (block E)
//PIN: VIDCMD_Q_15       : 44   (block E)
//PIN: VIDCMD_Q_2        : 50   (block E)
//PIN: VIDCMD_Q_3        : 63   (block G)
//PIN: VIDCMD_Q_4        : 12   (block A)
//PIN: VIDCMD_Q_5        : 41   (block D)
//PIN: VIDCMD_Q_6        : 27   (block C)
//PIN: VIDCMD_Q_7        : 39   (block D)
//PIN: VIDCMD_Q_8        : 40   (block D)
//PIN: VIDCMD_Q_9        : 74   (block H)
