bradgrantham/griffin/cpld/experiments/literal/pins_r4s_pfree.txt

// harvested by the fitter, r4s_pfree (free placement) -- NOT FROZEN
//PIN: H_ACTIVE          : 12   (block A)
//PIN: nRS               : 1   (block A)
//PIN: nVIDCMD_EF        : 17   (block B)
//PIN: nVIDCMD_RE        : 5   (block A)
//PIN: PIXEL_CLK         : 83   (block A)
//PIN: RGB_IN_0          : 54   (block F)
//PIN: RGB_IN_1          : 44   (block E)
//PIN: RGB_IN_10         : 37   (block D)
//PIN: RGB_IN_11         : 39   (block D)
//PIN: RGB_IN_2          : 11   (block A)
//PIN: RGB_IN_3          : 63   (block G)
//PIN: RGB_IN_4          : 74   (block H)
//PIN: RGB_IN_5          : 22   (block B)
//PIN: RGB_IN_6          : 18   (block B)
//PIN: RGB_IN_7          : 25   (block C)
//PIN: RGB_IN_8          : 41   (block D)
//PIN: RGB_IN_9          : 40   (block D)
//PIN: RGB_OUT_0         : 50   (block E)
//PIN: RGB_OUT_1         : 51   (block E)
//PIN: RGB_OUT_10        : 67   (block G)
//PIN: RGB_OUT_11        : 52   (block E)
//PIN: RGB_OUT_2         : 60   (block F)
//PIN: RGB_OUT_3         : 49   (block E)
//PIN: RGB_OUT_4         : 61   (block F)
//PIN: RGB_OUT_5         : 58   (block F)
//PIN: RGB_OUT_6         : 57   (block F)
//PIN: RGB_OUT_7         : 70   (block G)
//PIN: RGB_OUT_8         : 69   (block G)
//PIN: RGB_OUT_9         : 68   (block G)
//PIN: set_pix_commit    : 81   (block H)
//PIN: set_pix_target_0  : 6   (block A)
//PIN: set_pix_target_1  : 8   (block A)
//PIN: set_pix_target_2  : 10   (block A)
//PIN: set_pix_valid     : 4   (block A)
//PIN: set_pix_value_0   : 33   (block D)
//PIN: set_pix_value_1   : 15   (block B)
//PIN: set_pix_value_10  : 24   (block C)
//PIN: set_pix_value_11  : 9   (block A)
//PIN: set_pix_value_2   : 34   (block D)
//PIN: set_pix_value_3   : 48   (block E)
//PIN: set_pix_value_4   : 46   (block E)
//PIN: set_pix_value_5   : 56   (block F)
//PIN: set_pix_value_6   : 55   (block F)
//PIN: set_pix_value_7   : 45   (block E)
//PIN: set_pix_value_8   : 35   (block D)
//PIN: set_pix_value_9   : 36   (block D)
//PIN: VIDCMD_Q_0        : 79   (block H)
//PIN: VIDCMD_Q_1        : 80   (block H)
//PIN: VIDCMD_Q_10       : 75   (block H)
//PIN: VIDCMD_Q_11       : 29   (block C)
//PIN: VIDCMD_Q_12       : 76   (block H)
//PIN: VIDCMD_Q_13       : 16   (block B)
//PIN: VIDCMD_Q_14       : 20   (block B)
//PIN: VIDCMD_Q_15       : 21   (block B)
//PIN: VIDCMD_Q_2        : 27   (block C)
//PIN: VIDCMD_Q_3        : 77   (block H)
//PIN: VIDCMD_Q_4        : 64   (block G)
//PIN: VIDCMD_Q_5        : 30   (block C)
//PIN: VIDCMD_Q_6        : 28   (block C)
//PIN: VIDCMD_Q_7        : 2   (block A)
//PIN: VIDCMD_Q_8        : 65   (block G)
//PIN: VIDCMD_Q_9        : 73   (block H)
