bradgrantham/griffin/cpld/experiments/literal/pins_r4st_pfree.txt

// harvested by the fitter, r4st_pfree (free placement) -- NOT FROZEN
//PIN: H_ACTIVE          : 21   (block B)
//PIN: nRS               : 1   (block A)
//PIN: nVIDCMD_EF        : 77   (block H)
//PIN: nVIDCMD_RE        : 5   (block A)
//PIN: PIXEL_CLK         : 83   (block A)
//PIN: RGB_IN_0          : 15   (block B)
//PIN: RGB_IN_1          : 31   (block C)
//PIN: RGB_IN_10         : 73   (block H)
//PIN: RGB_IN_11         : 16   (block B)
//PIN: RGB_IN_2          : 29   (block C)
//PIN: RGB_IN_3          : 30   (block C)
//PIN: RGB_IN_4          : 54   (block F)
//PIN: RGB_IN_5          : 63   (block G)
//PIN: RGB_IN_6          : 36   (block D)
//PIN: RGB_IN_7          : 64   (block G)
//PIN: RGB_IN_8          : 18   (block B)
//PIN: RGB_IN_9          : 22   (block B)
//PIN: RGB_OUT_0         : 52   (block E)
//PIN: RGB_OUT_1         : 51   (block E)
//PIN: RGB_OUT_10        : 68   (block G)
//PIN: RGB_OUT_11        : 33   (block D)
//PIN: RGB_OUT_2         : 49   (block E)
//PIN: RGB_OUT_3         : 50   (block E)
//PIN: RGB_OUT_4         : 60   (block F)
//PIN: RGB_OUT_5         : 58   (block F)
//PIN: RGB_OUT_6         : 61   (block F)
//PIN: RGB_OUT_7         : 57   (block F)
//PIN: RGB_OUT_8         : 69   (block G)
//PIN: RGB_OUT_9         : 70   (block G)
//PIN: set_pix_commit    : 24   (block C)
//PIN: set_pix_target_0  : 6   (block A)
//PIN: set_pix_target_1  : 9   (block A)
//PIN: set_pix_target_2  : 8   (block A)
//PIN: set_pix_valid     : 4   (block A)
//PIN: set_pix_value_0   : 25   (block C)
//PIN: set_pix_value_1   : 35   (block D)
//PIN: set_pix_value_10  : 34   (block D)
//PIN: set_pix_value_11  : 10   (block A)
//PIN: set_pix_value_2   : 48   (block E)
//PIN: set_pix_value_3   : 45   (block E)
//PIN: set_pix_value_4   : 46   (block E)
//PIN: set_pix_value_5   : 44   (block E)
//PIN: set_pix_value_6   : 55   (block F)
//PIN: set_pix_value_7   : 56   (block F)
//PIN: set_pix_value_8   : 27   (block C)
//PIN: set_pix_value_9   : 28   (block C)
//PIN: VIDCMD_Q_0        : 80   (block H)
//PIN: VIDCMD_Q_1        : 81   (block H)
//PIN: VIDCMD_Q_10       : 75   (block H)
//PIN: VIDCMD_Q_11       : 79   (block H)
//PIN: VIDCMD_Q_12       : 74   (block H)
//PIN: VIDCMD_Q_13       : 76   (block H)
//PIN: VIDCMD_Q_14       : 17   (block B)
//PIN: VIDCMD_Q_15       : 20   (block B)
//PIN: VIDCMD_Q_2        : 40   (block D)
//PIN: VIDCMD_Q_3        : 41   (block D)
//PIN: VIDCMD_Q_4        : 39   (block D)
//PIN: VIDCMD_Q_5        : 37   (block D)
//PIN: VIDCMD_Q_6        : 67   (block G)
//PIN: VIDCMD_Q_7        : 65   (block G)
//PIN: VIDCMD_Q_8        : 12   (block A)
//PIN: VIDCMD_Q_9        : 11   (block A)
