bradgrantham/griffin/cpld/experiments/literal/pins_r5n_pfree.txt

// harvested by the fitter, r5n_pfree (free placement) -- NOT FROZEN
//PIN: H_ACTIVE          : 11   (block A)
//PIN: nRS               : 1   (block A)
//PIN: nVIDCMD_EF        : 44   (block E)
//PIN: nVIDCMD_RE        : 61   (block F)
//PIN: PIXEL_CLK         : 83   (block A)
//PIN: RGB_IN_0          : 55   (block F)
//PIN: RGB_IN_1          : 69   (block G)
//PIN: RGB_IN_10         : 68   (block G)
//PIN: RGB_IN_11         : 40   (block D)
//PIN: RGB_IN_2          : 84   (block A)
//PIN: RGB_IN_3          : 45   (block E)
//PIN: RGB_IN_4          : 76   (block H)
//PIN: RGB_IN_5          : 73   (block H)
//PIN: RGB_IN_6          : 74   (block H)
//PIN: RGB_IN_7          : 80   (block H)
//PIN: RGB_IN_8          : 75   (block H)
//PIN: RGB_IN_9          : 10   (block A)
//PIN: RGB_OUT_0         : 15   (block B)
//PIN: RGB_OUT_1         : 17   (block B)
//PIN: RGB_OUT_10        : 51   (block E)
//PIN: RGB_OUT_11        : 50   (block E)
//PIN: RGB_OUT_2         : 16   (block B)
//PIN: RGB_OUT_3         : 24   (block C)
//PIN: RGB_OUT_4         : 34   (block D)
//PIN: RGB_OUT_5         : 25   (block C)
//PIN: RGB_OUT_6         : 27   (block C)
//PIN: RGB_OUT_7         : 35   (block D)
//PIN: RGB_OUT_8         : 33   (block D)
//PIN: RGB_OUT_9         : 52   (block E)
//PIN: set_pix_commit    : 4   (block A)
//PIN: set_pix_target_0  : 6   (block A)
//PIN: set_pix_target_1  : 18   (block B)
//PIN: set_pix_target_2  : 31   (block C)
//PIN: set_pix_valid     : 5   (block A)
//PIN: set_pix_value_0   : 20   (block B)
//PIN: set_pix_value_1   : 22   (block B)
//PIN: set_pix_value_10  : 46   (block E)
//PIN: set_pix_value_11  : 49   (block E)
//PIN: set_pix_value_2   : 21   (block B)
//PIN: set_pix_value_3   : 28   (block C)
//PIN: set_pix_value_4   : 37   (block D)
//PIN: set_pix_value_5   : 30   (block C)
//PIN: set_pix_value_6   : 29   (block C)
//PIN: set_pix_value_7   : 39   (block D)
//PIN: set_pix_value_8   : 36   (block D)
//PIN: set_pix_value_9   : 48   (block E)
//PIN: VIDCMD_Q_0        : 81   (block H)
//PIN: VIDCMD_Q_1        : 12   (block A)
//PIN: VIDCMD_Q_10       : 58   (block F)
//PIN: VIDCMD_Q_11       : 56   (block F)
//PIN: VIDCMD_Q_12       : 2   (block A)
//PIN: VIDCMD_Q_13       : 54   (block F)
//PIN: VIDCMD_Q_14       : 8   (block A)
//PIN: VIDCMD_Q_15       : 41   (block D)
//PIN: VIDCMD_Q_2        : 67   (block G)
//PIN: VIDCMD_Q_3        : 79   (block H)
//PIN: VIDCMD_Q_4        : 65   (block G)
//PIN: VIDCMD_Q_5        : 64   (block G)
//PIN: VIDCMD_Q_6        : 77   (block H)
//PIN: VIDCMD_Q_7        : 60   (block F)
//PIN: VIDCMD_Q_8        : 63   (block G)
//PIN: VIDCMD_Q_9        : 57   (block F)
