bradgrantham/griffin/board_rev_2_schematic.pdf

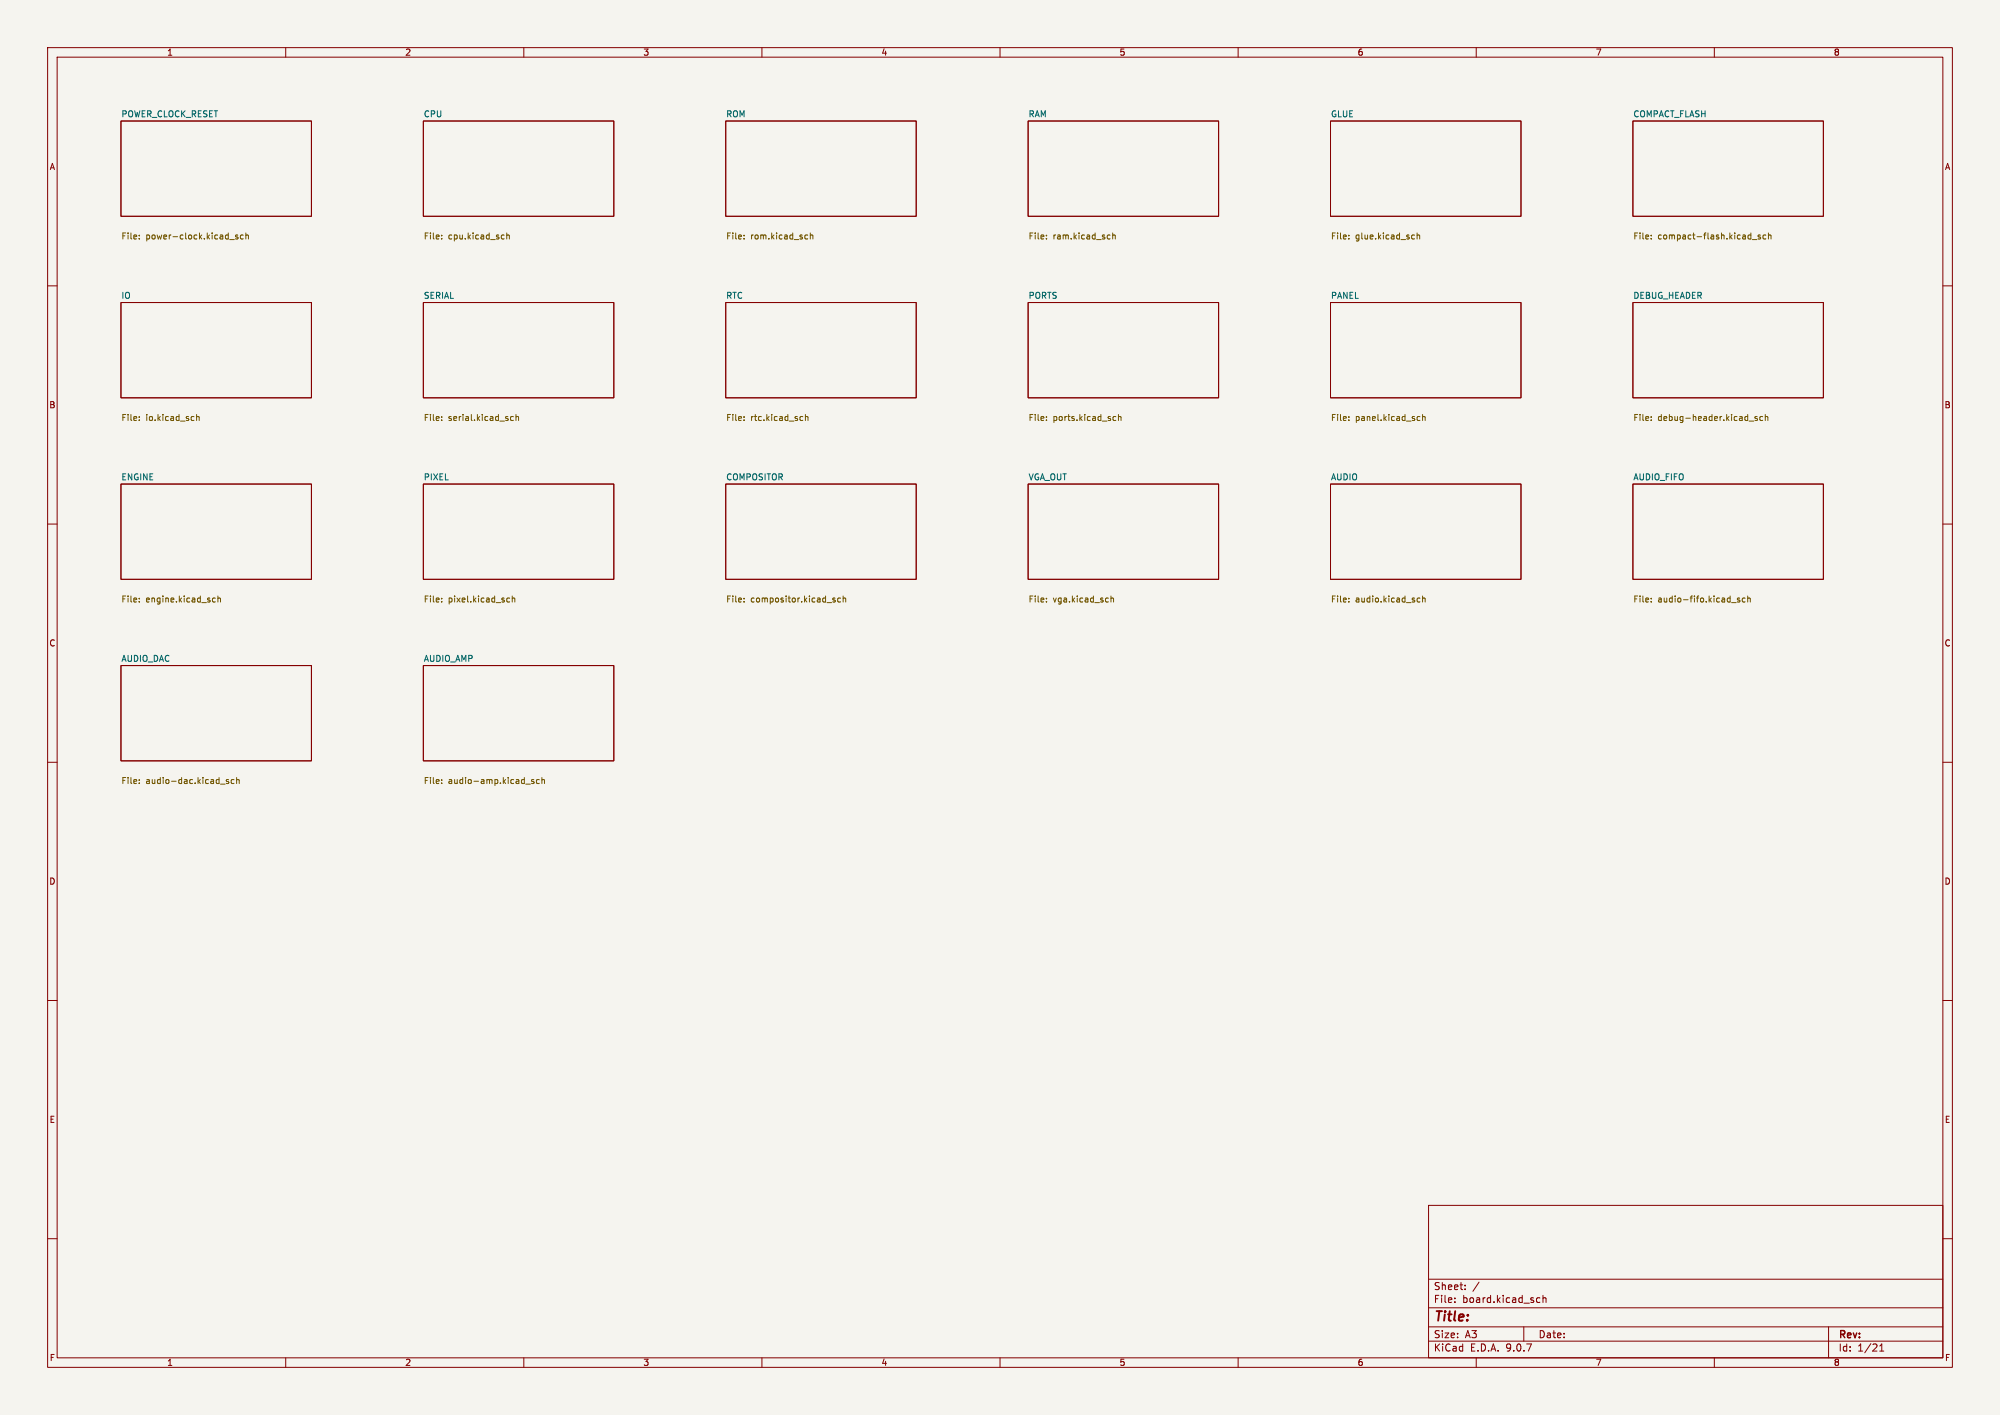
[picture p13: page 1]

File: audio-fifo.kicad_sch PIXEL File: pixel.kicad_sch ENGINE

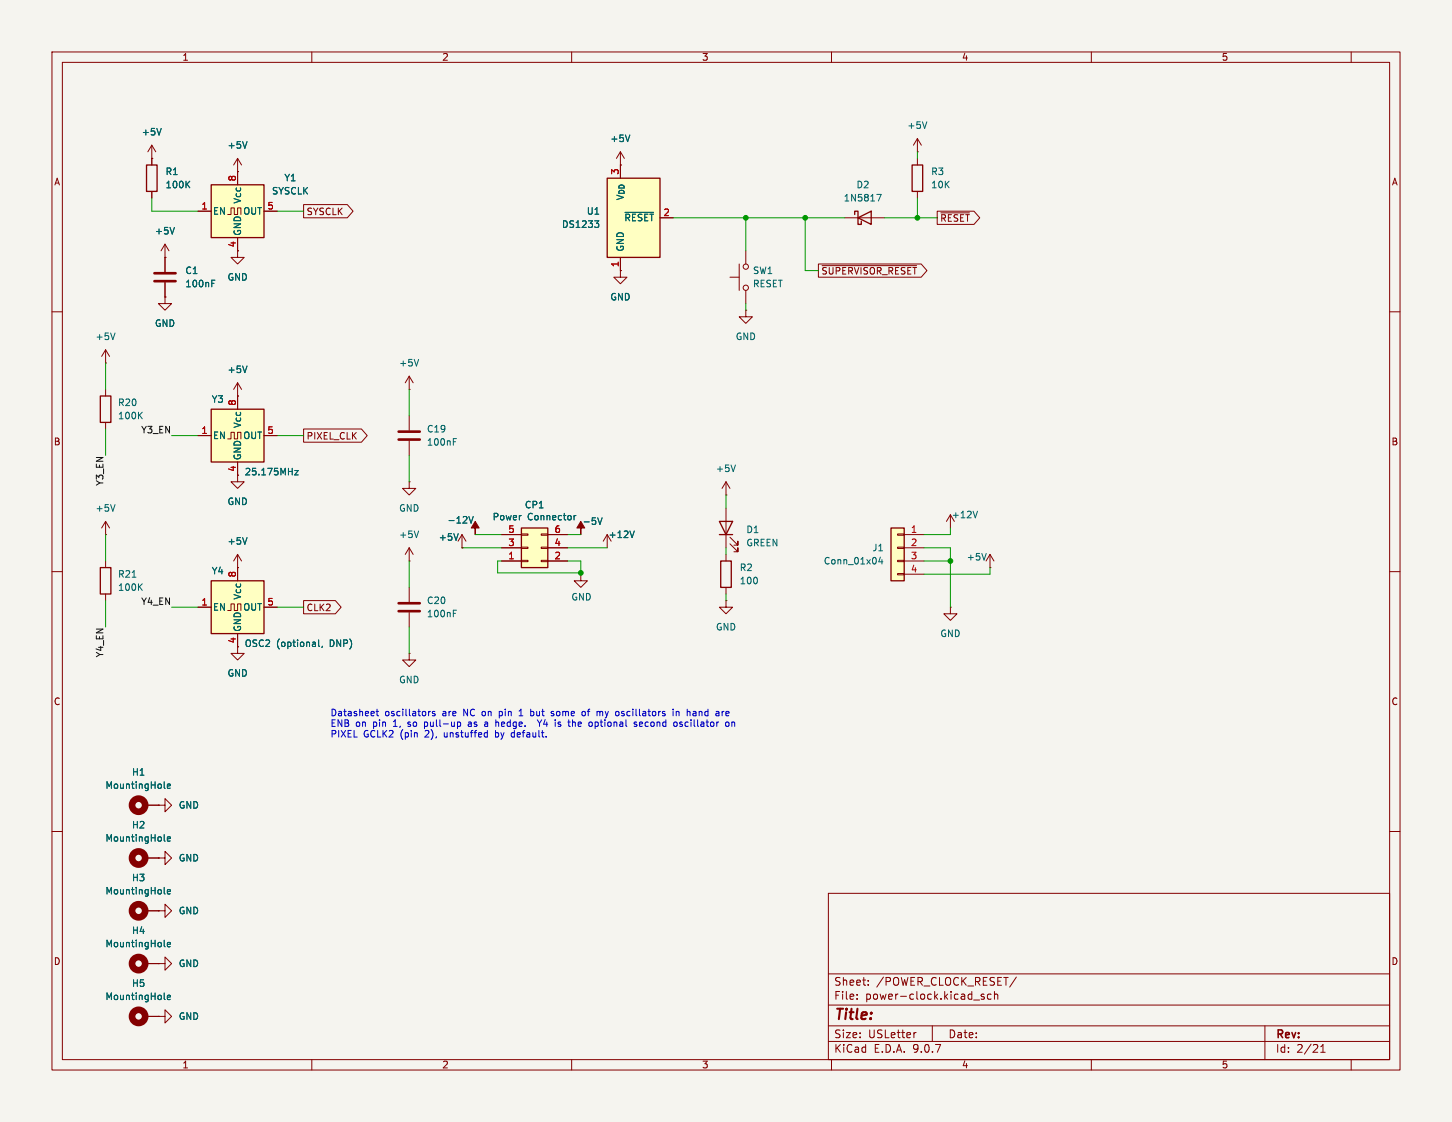
[picture p14: page 2]

1 ~{RESET} U1 2 DS1233 EN 1 Vcc 8 GND

Id: 2/21 Title: File: power-clock.kicad_sch Sheet: /POWER_CLOCK_RESET/ H2 MountingHole

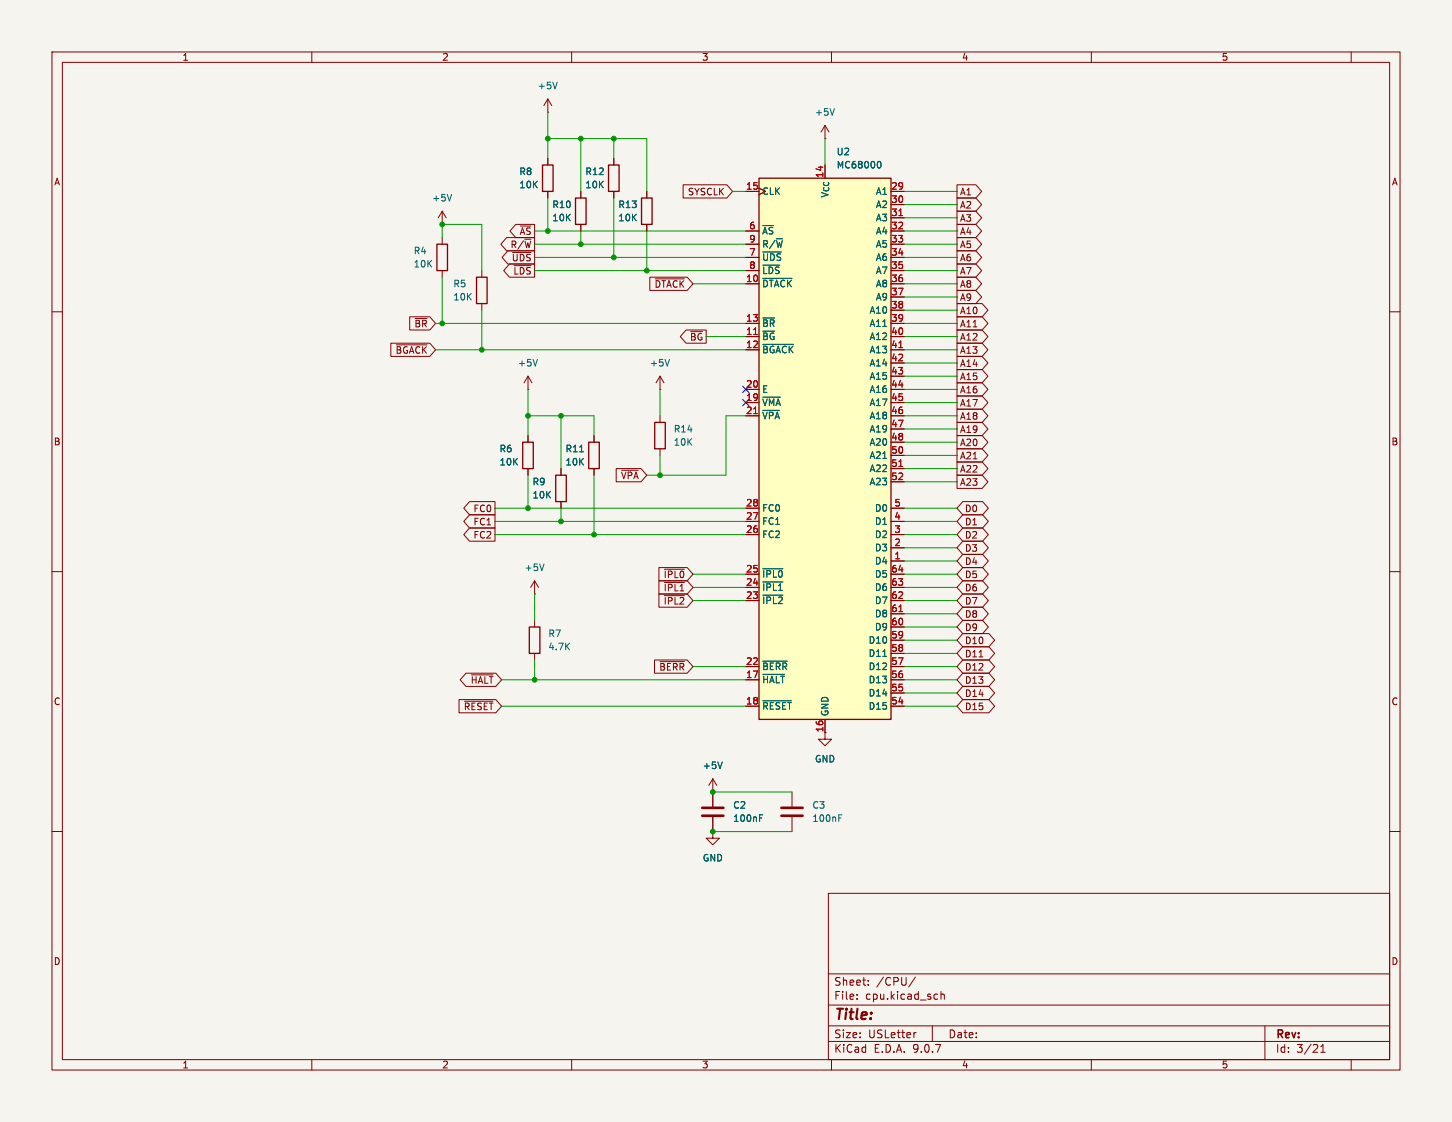
[picture p15: page 3]

Id: 3/21 Title: File: cpu.kicad_sch Sheet: /CPU/

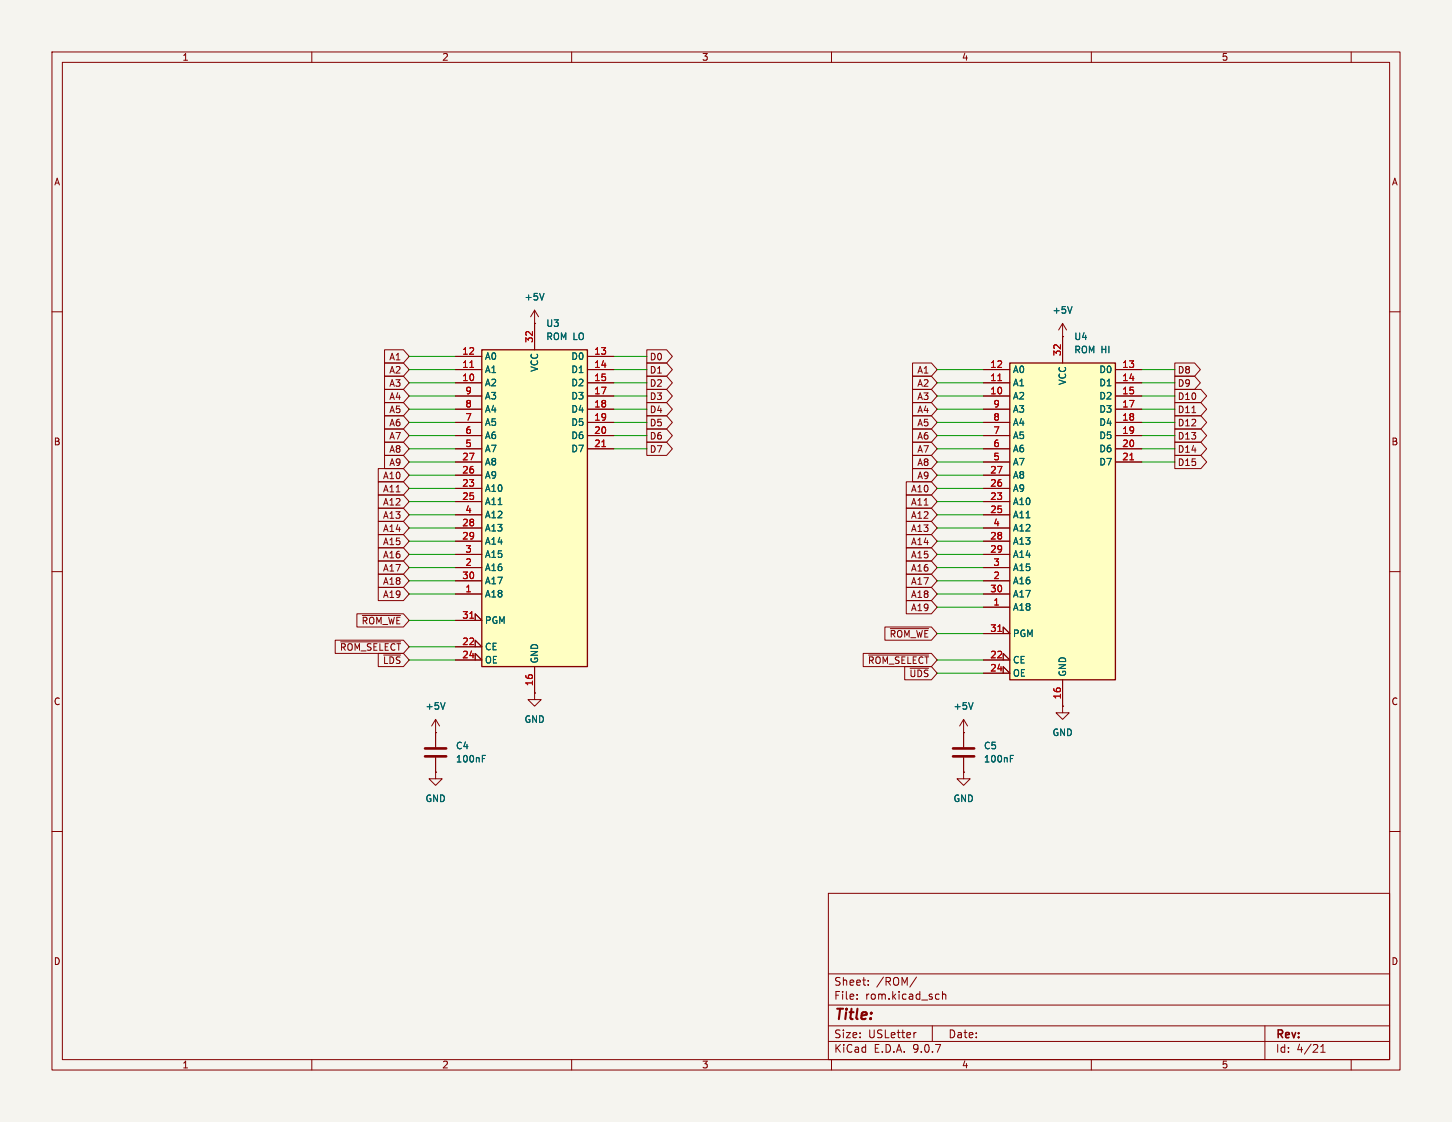
[picture p16: page 4]

Id: 4/21 Title: File: rom.kicad_sch Sheet: /ROM/ GND

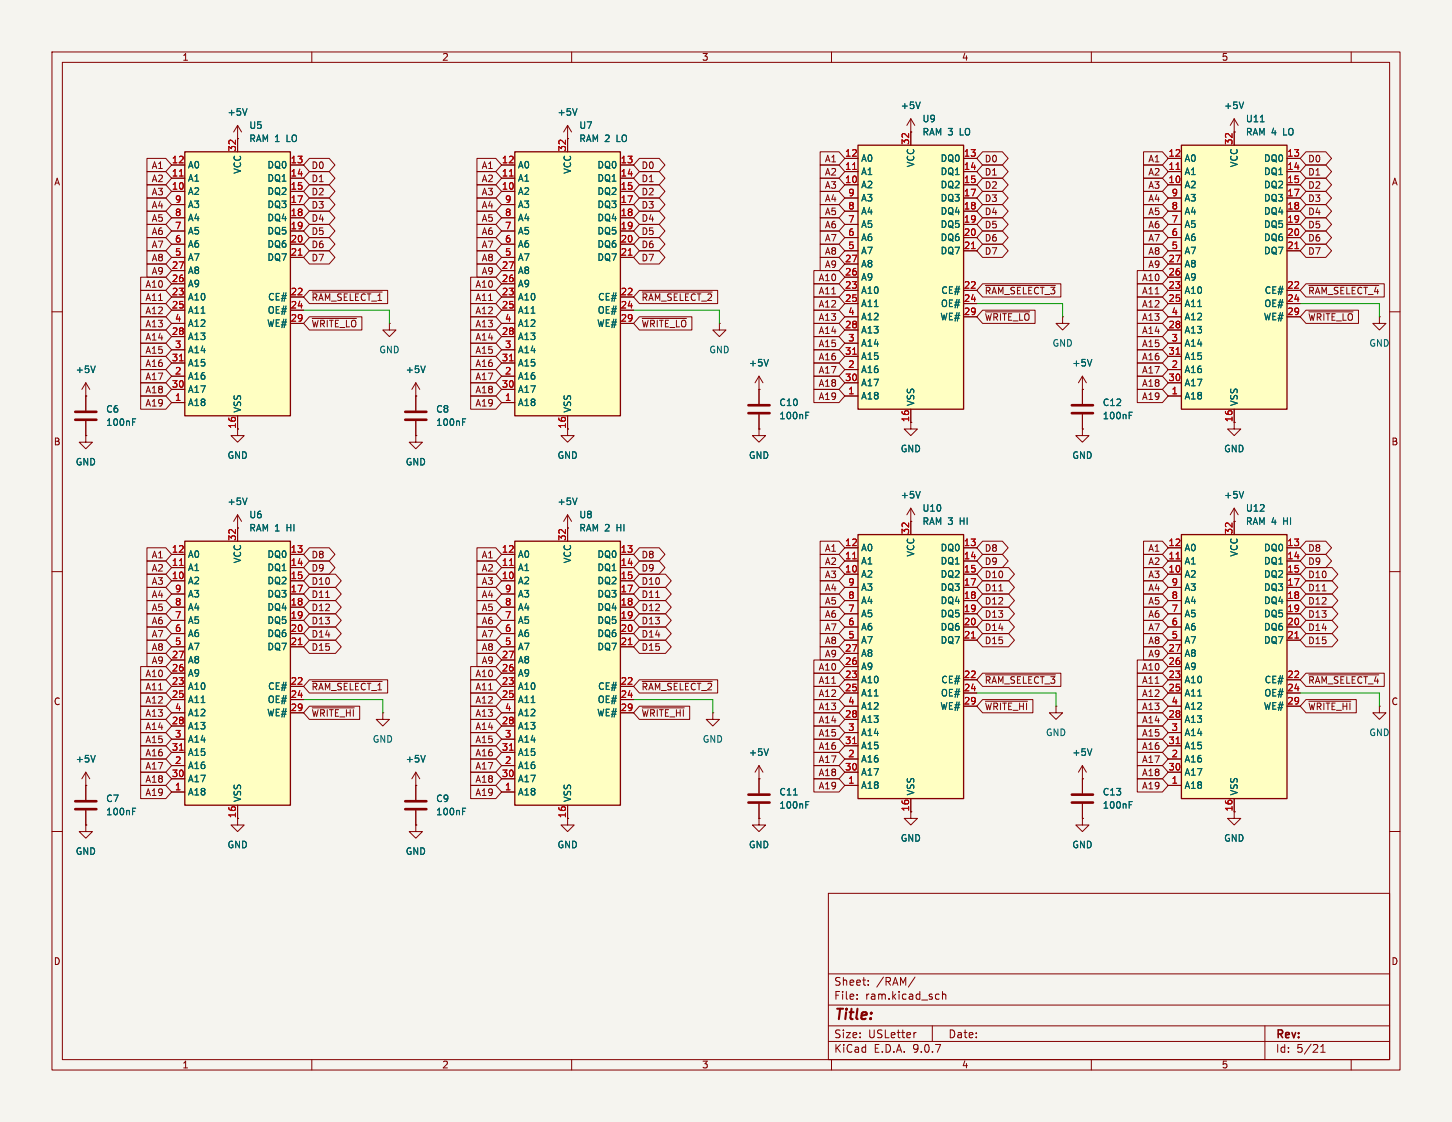
[picture p17: page 5]

Id: 5/21 Title: File: ram.kicad_sch Sheet: /RAM/

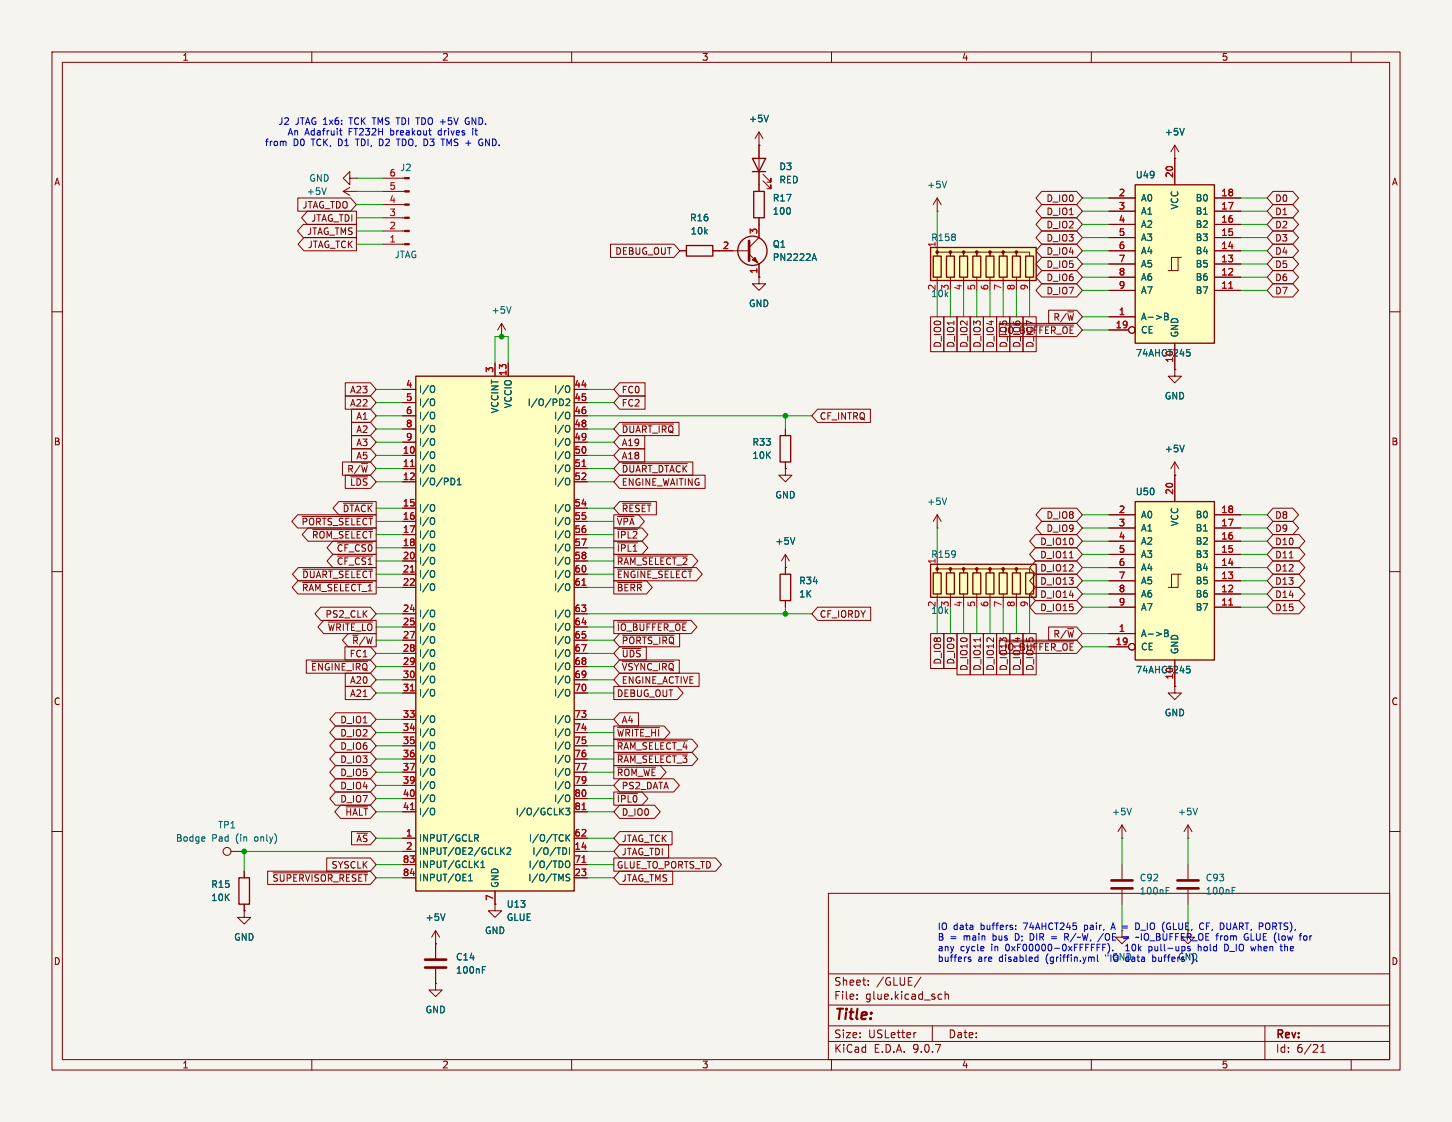
[picture p18: page 6]

Id: 6/21 Title: File: glue.kicad_sch Sheet: /GLUE/ R15
10K GND

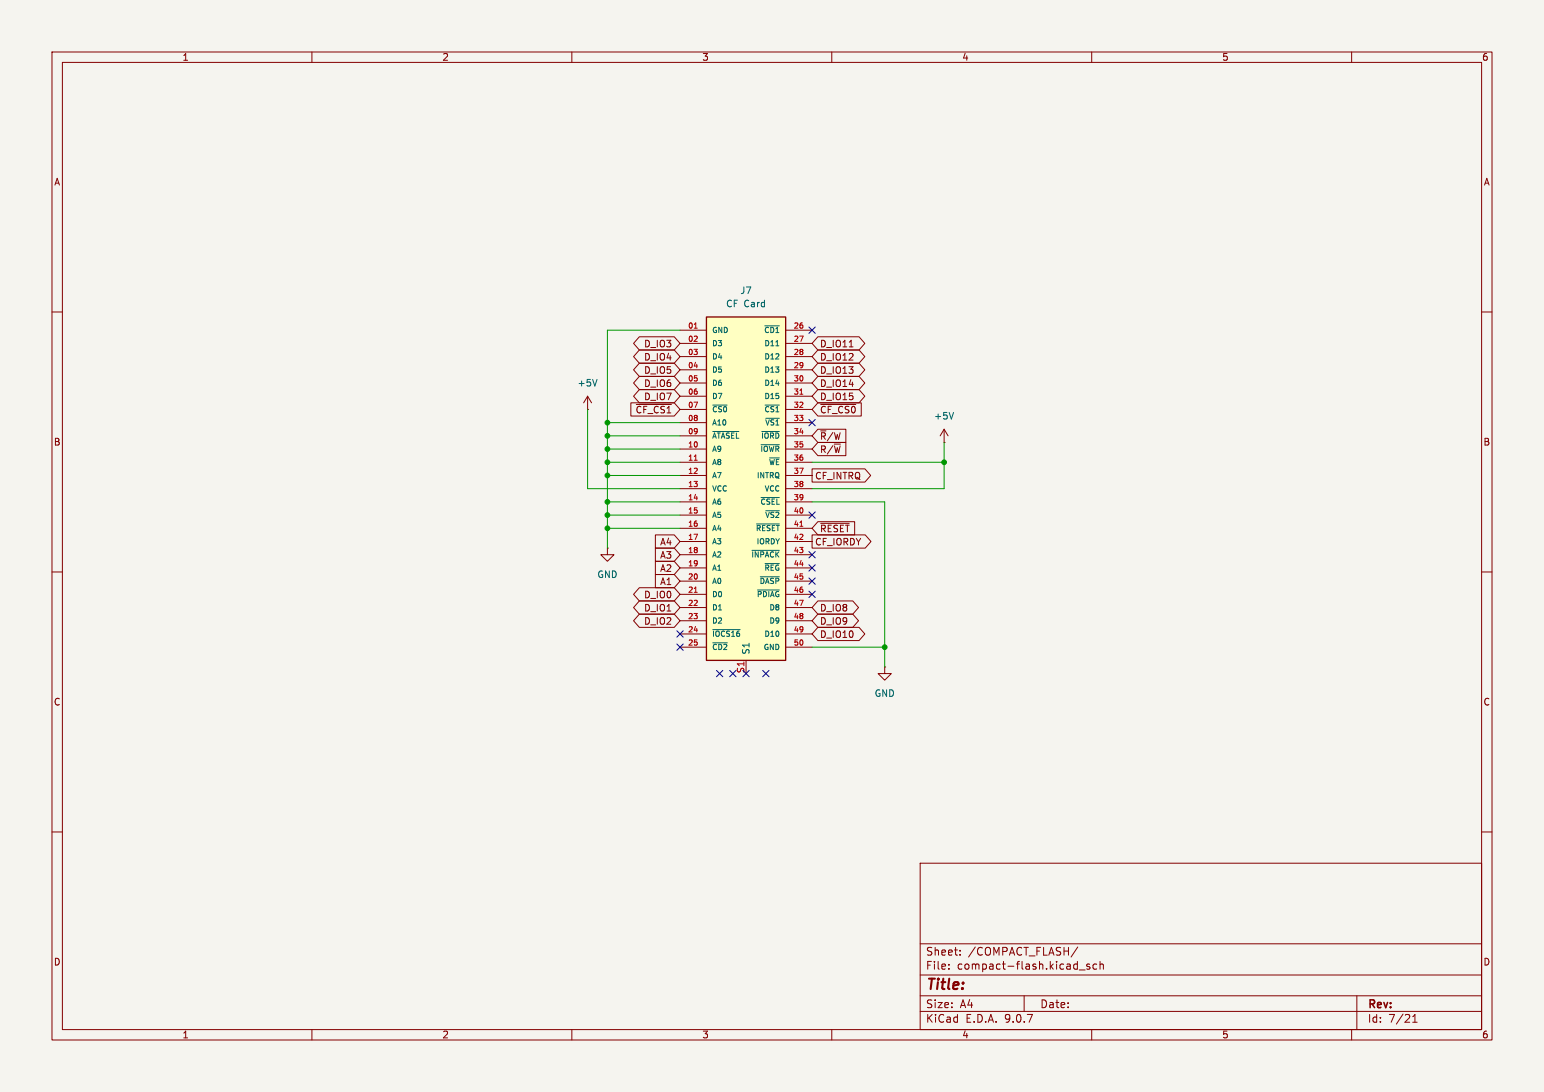
[picture p19: page 7]

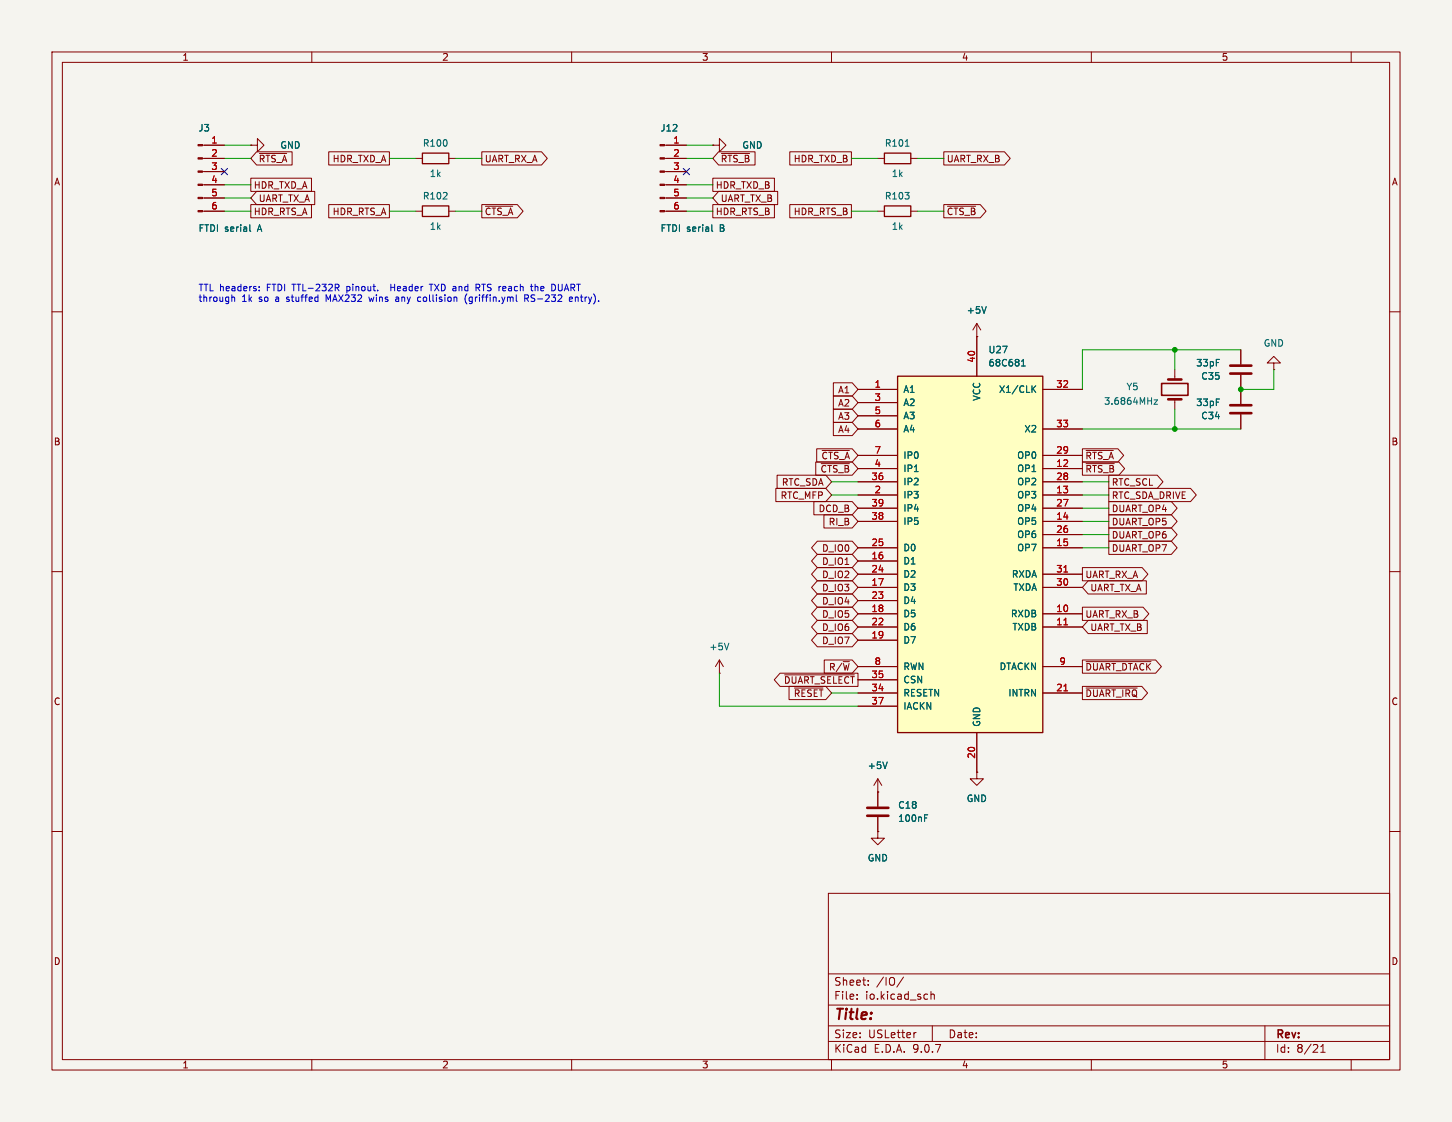
[picture p20: page 8]

Id: 8/21 Title: File: io.kicad_sch Sheet: /IO/

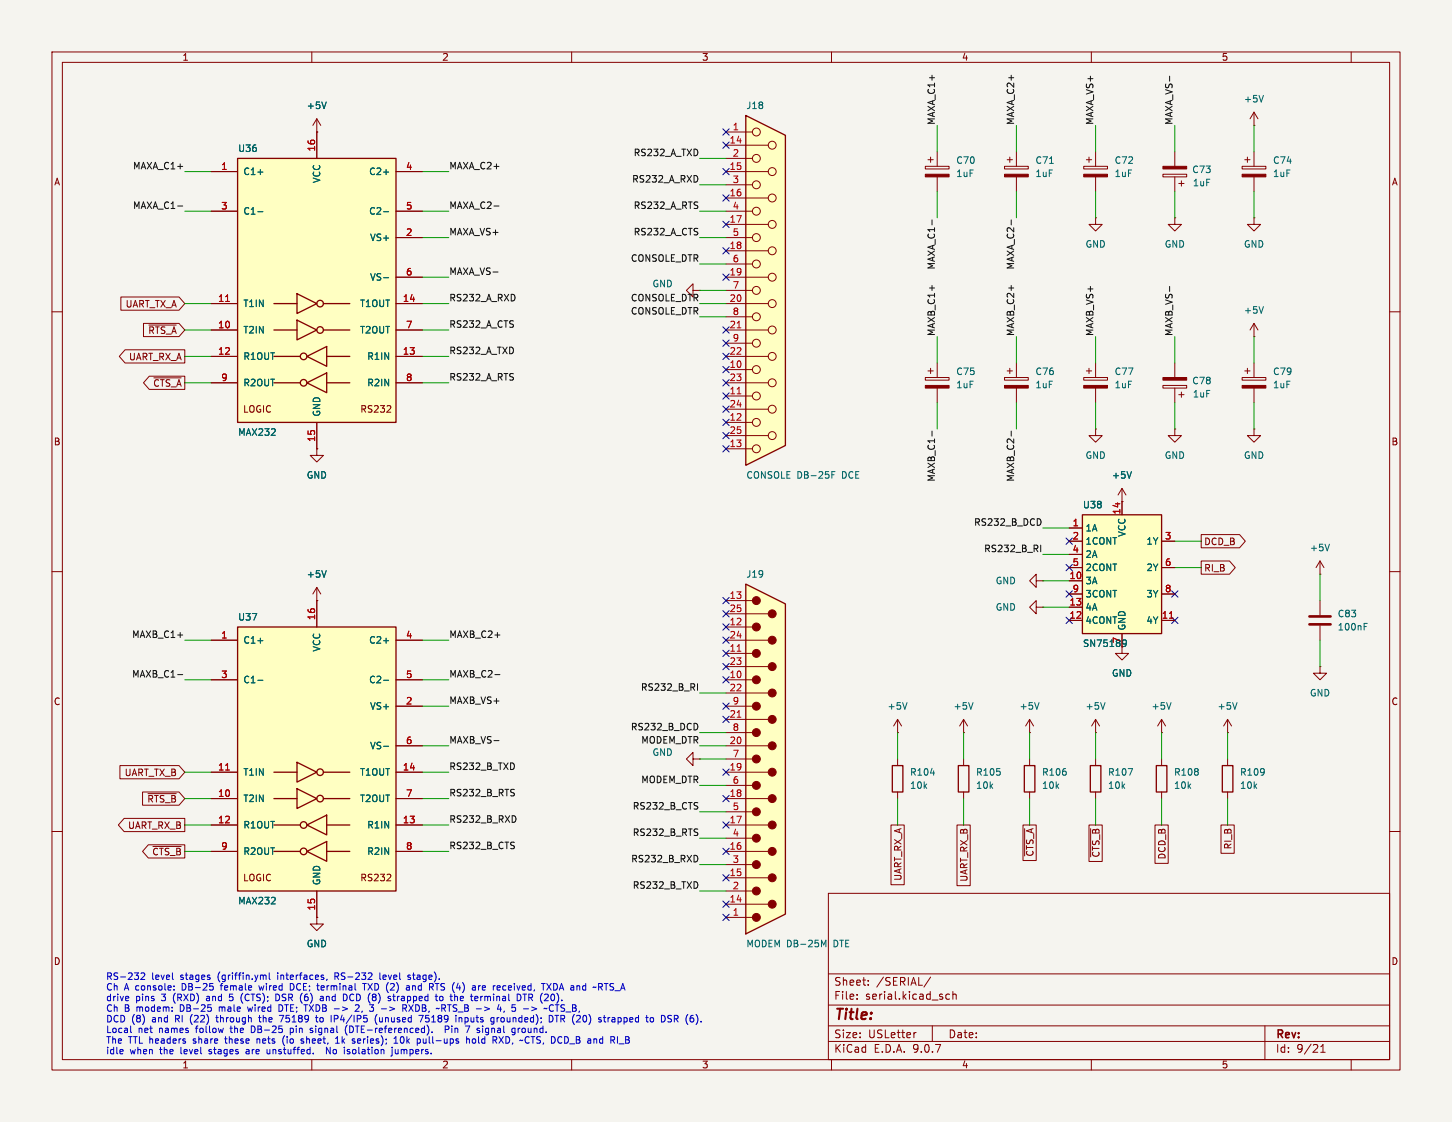
[picture p21: page 9]

Id: 9/21 Title: File: serial.kicad_sch Sheet: /SERIAL/

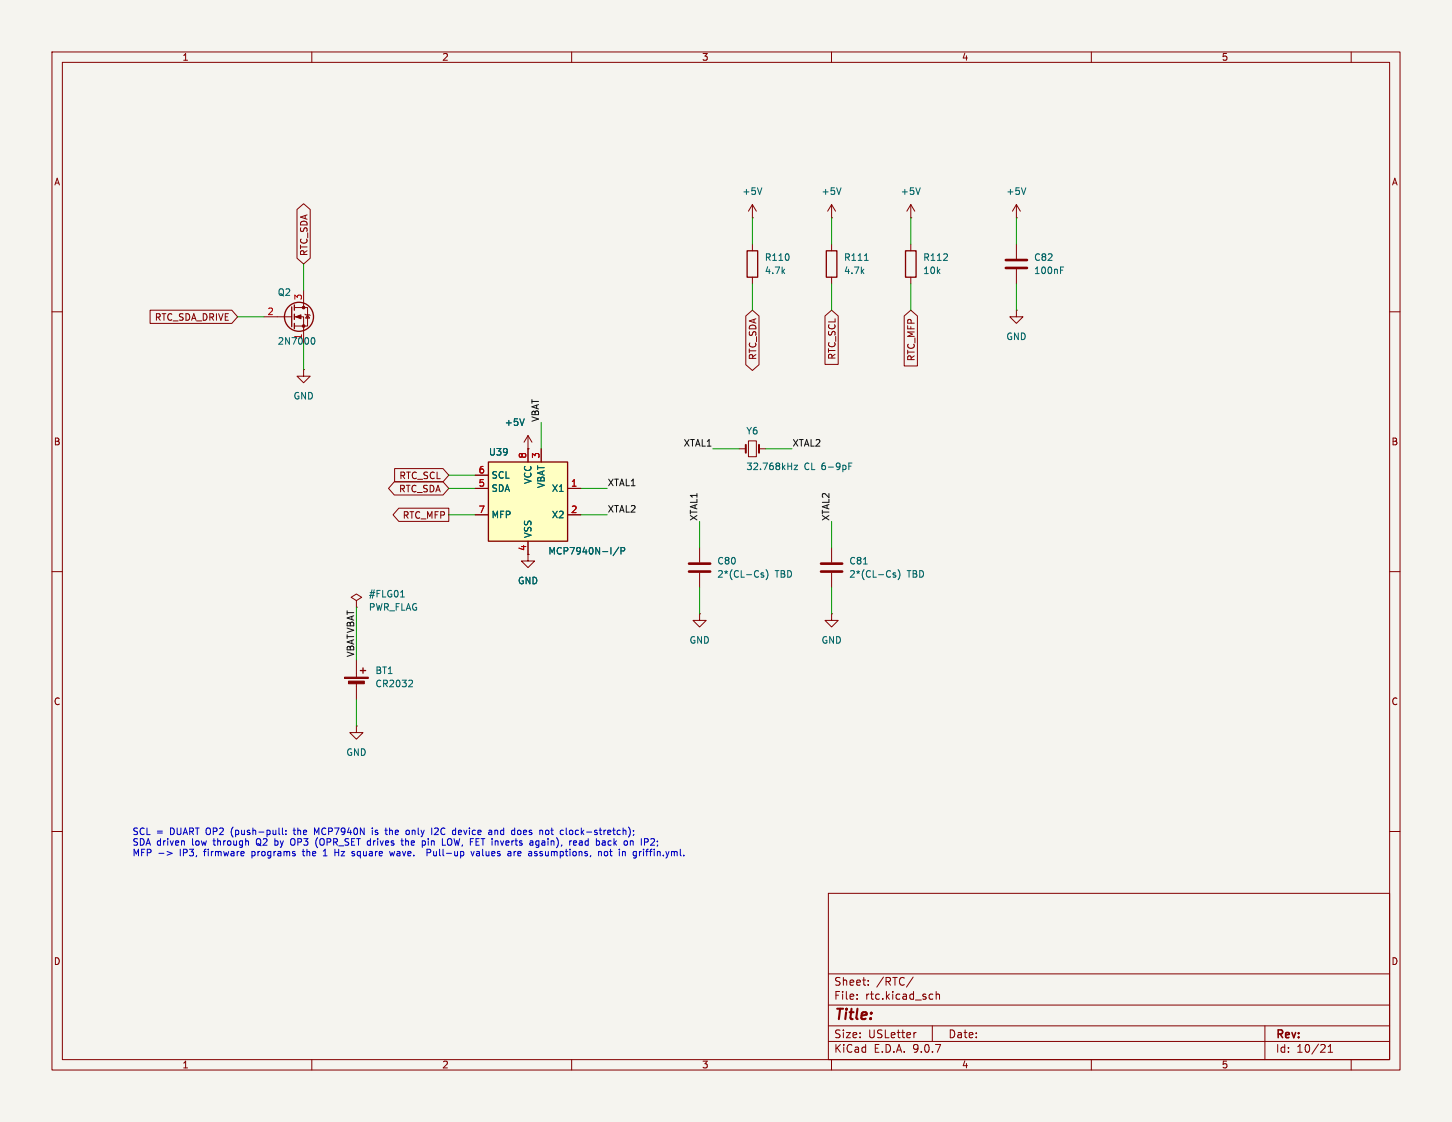
[picture p22: page 10]

Id: 10/21 Title: File: rtc.kicad_sch Sheet: /RTC/ GND

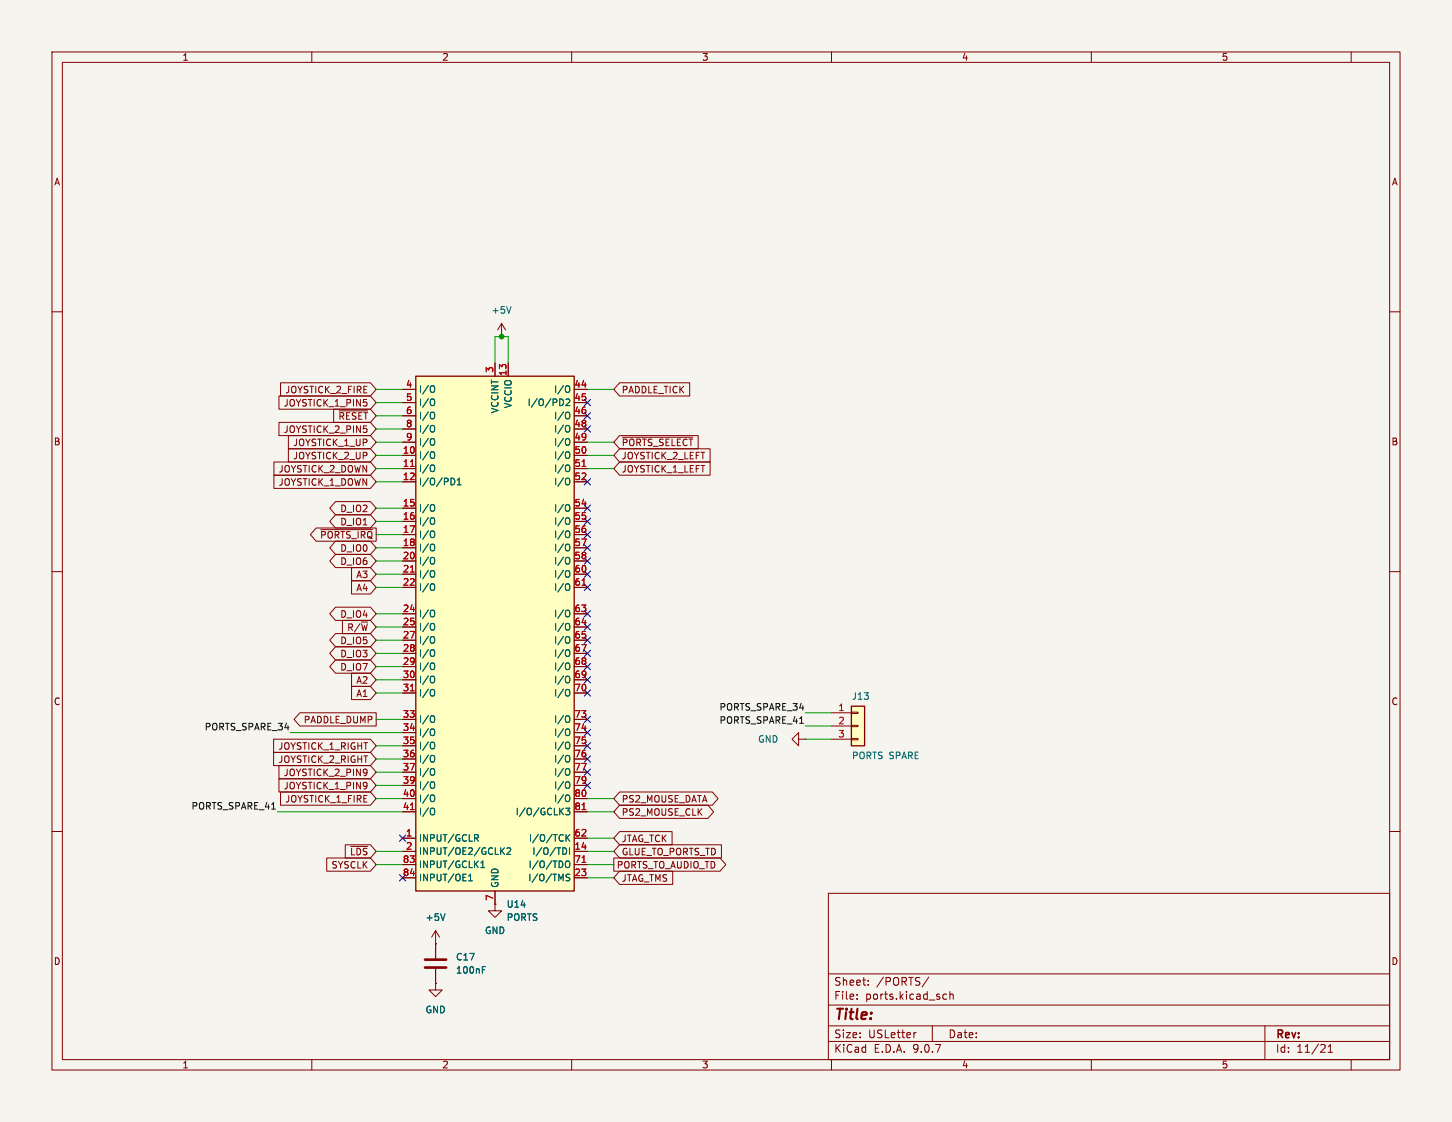
[picture p23: page 11]

J13 PORTS SPARE
Id: 11/21 Title: File: ports.kicad_sch Sheet: /PORTS/ 123

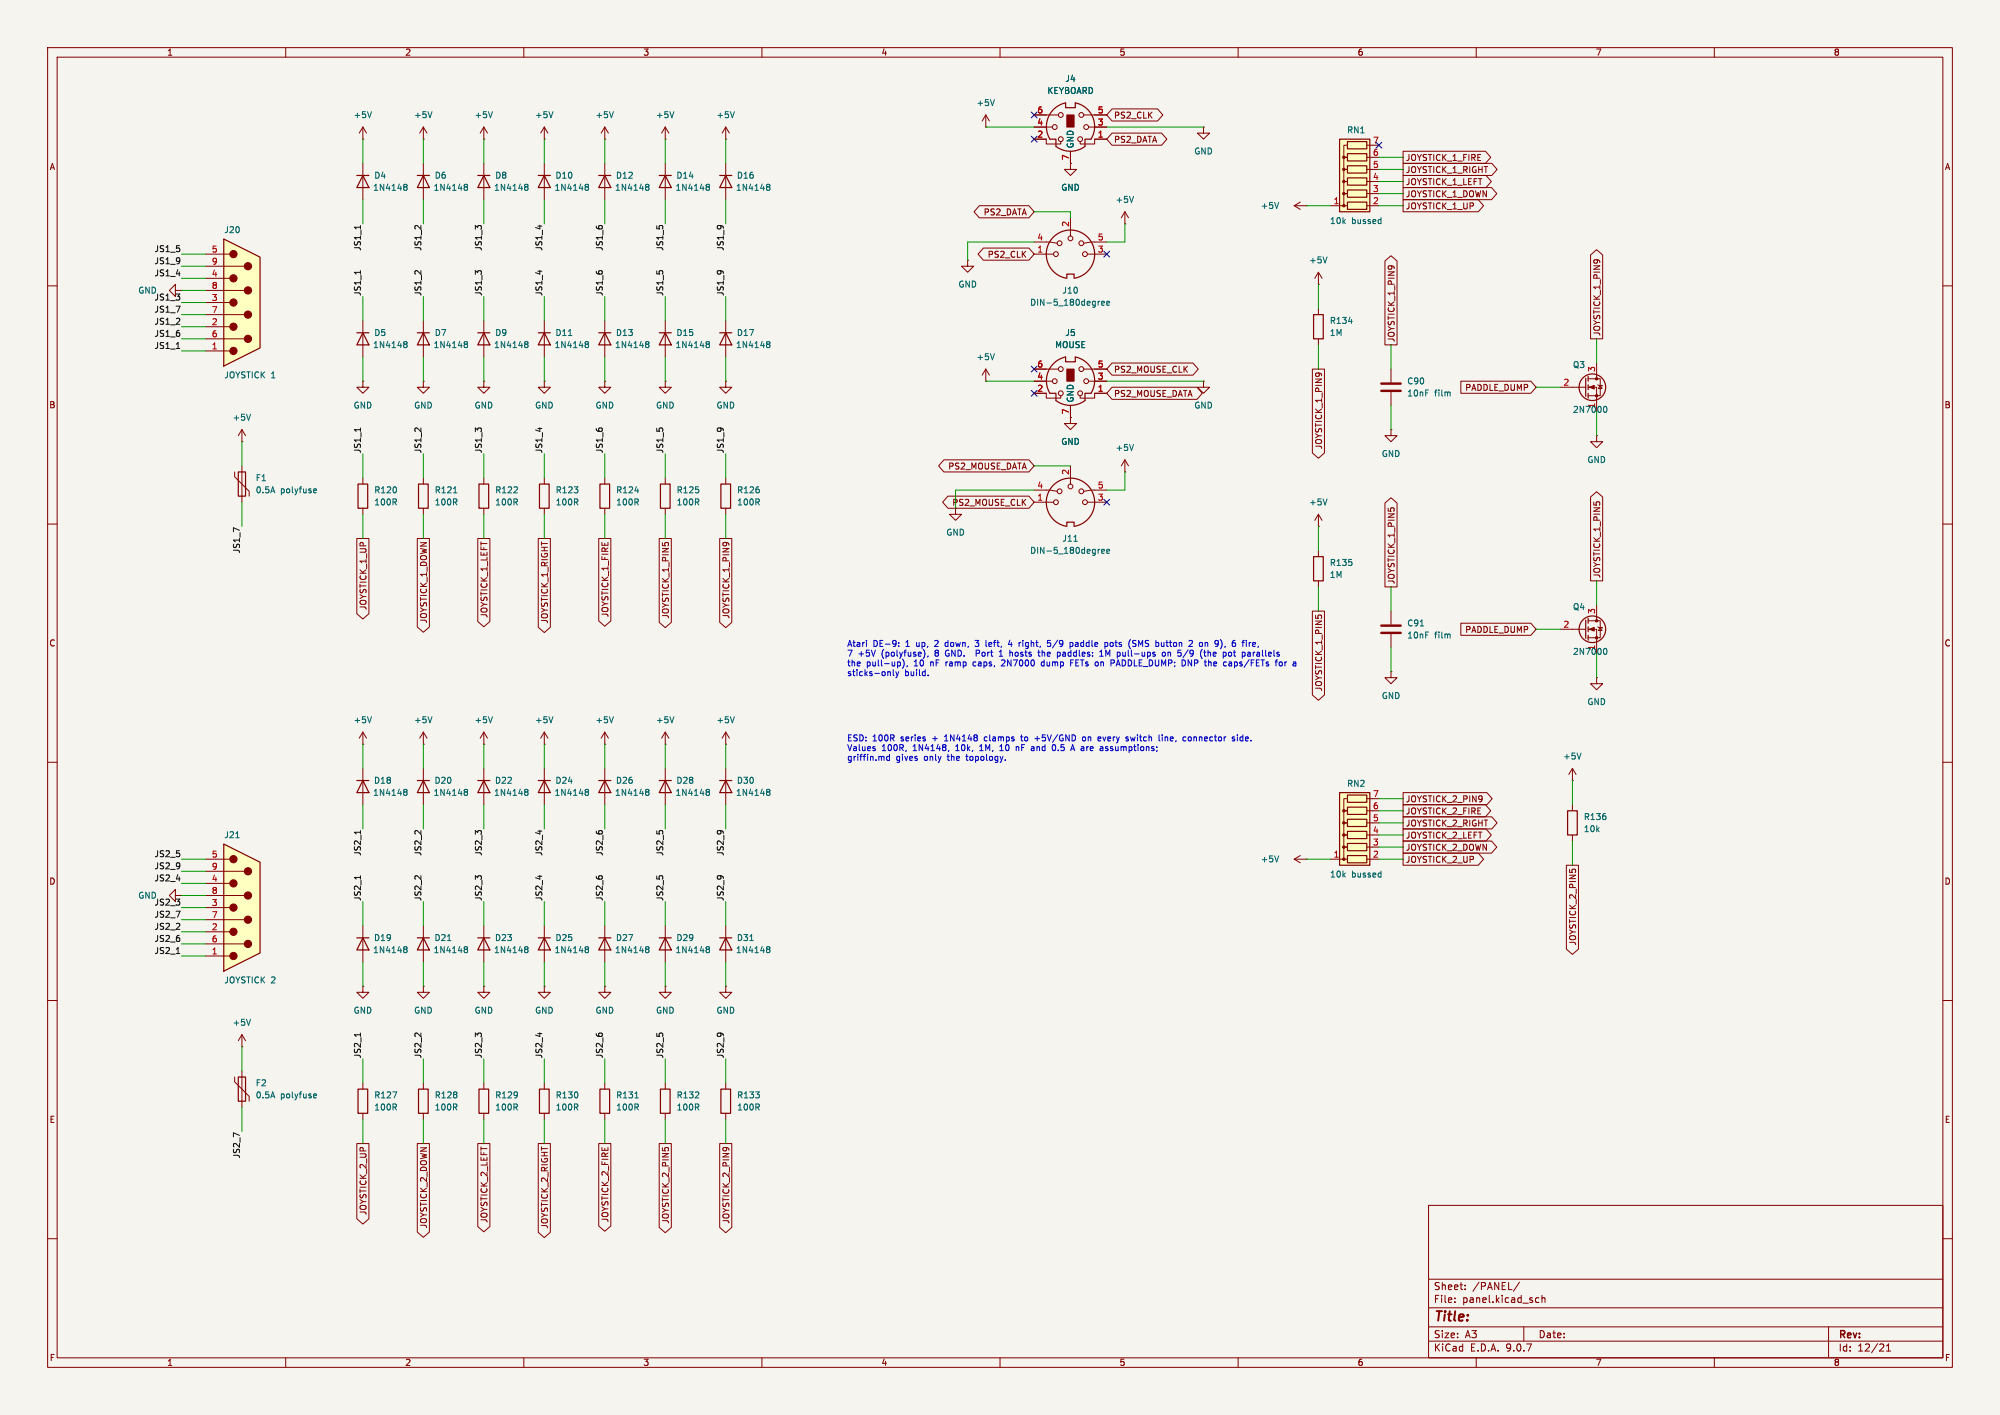
[picture p24: page 12]

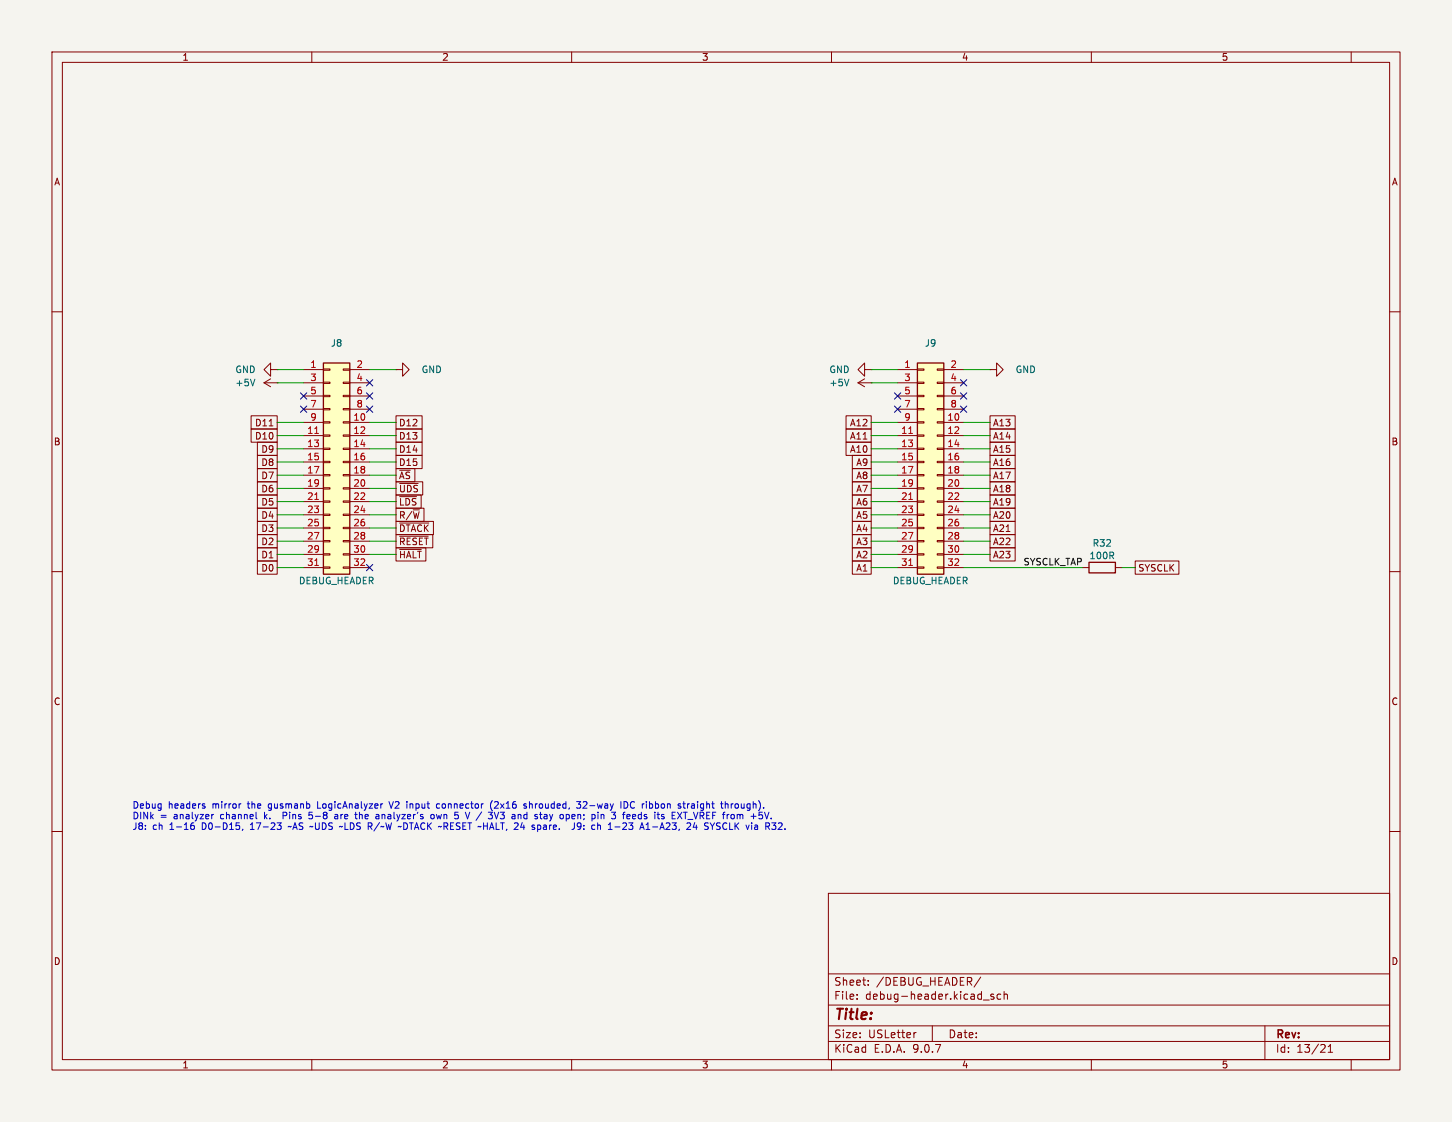
[picture p25: page 13]

Id: 13/21 Title: File: debug-header.kicad_sch Sheet: /DEBUG_HEADER/

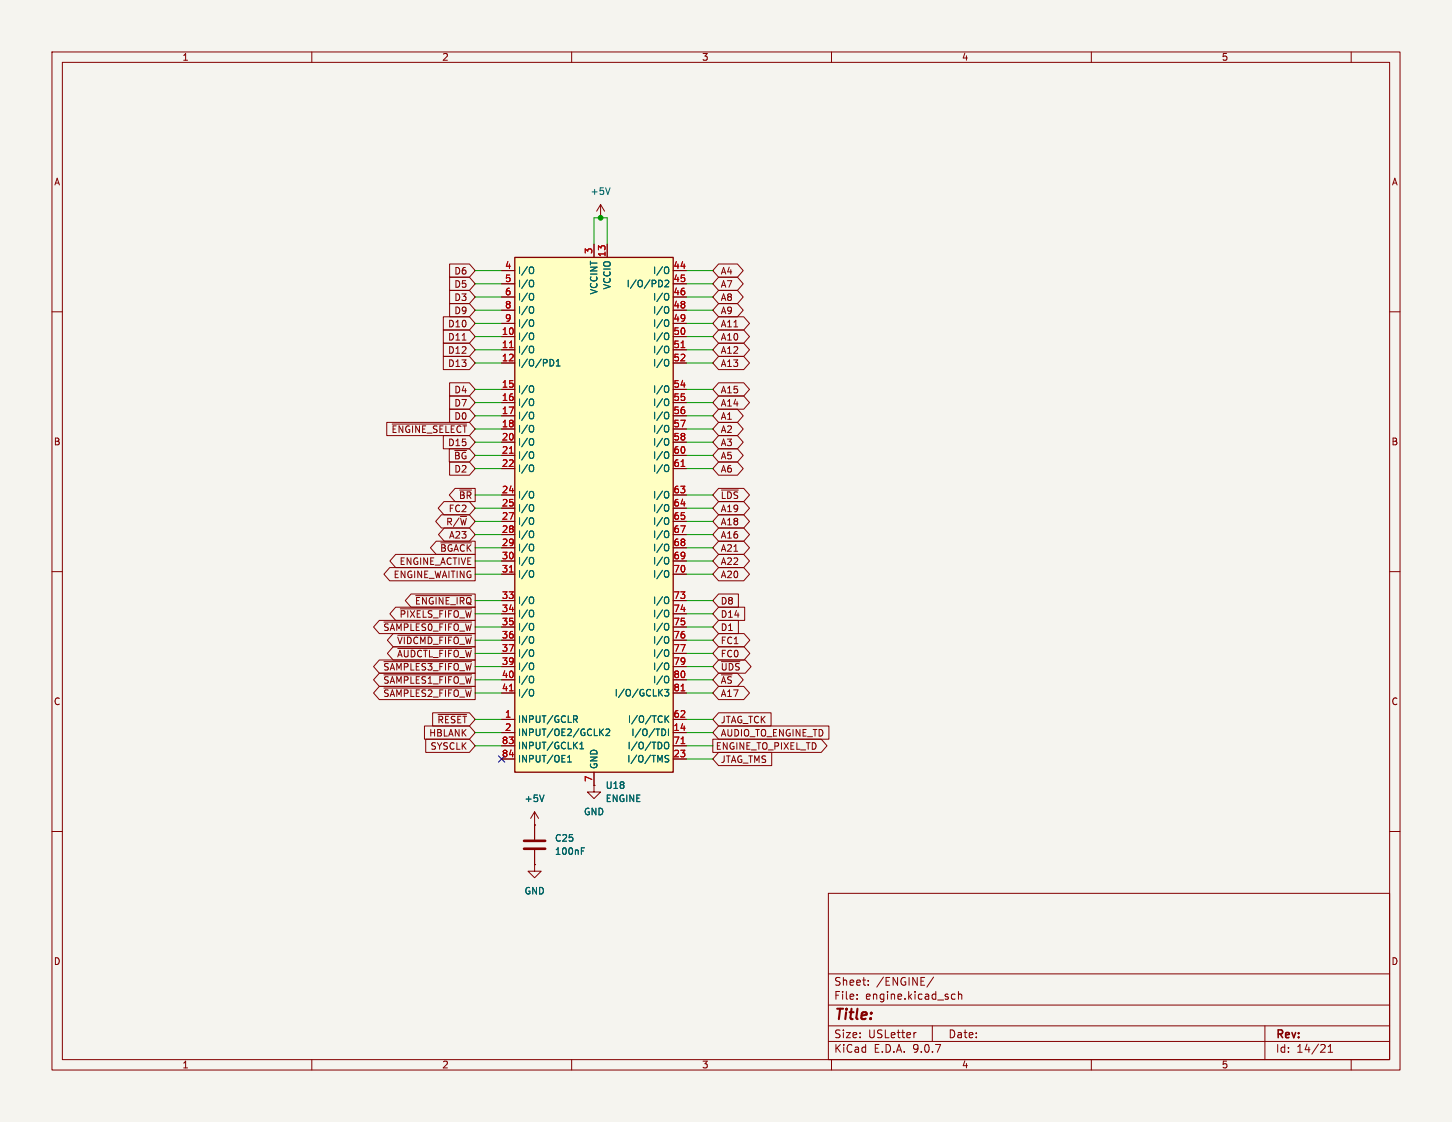
[picture p26: page 14]

Id: 14/21 Title: File: engine.kicad_sch Sheet: /ENGINE/

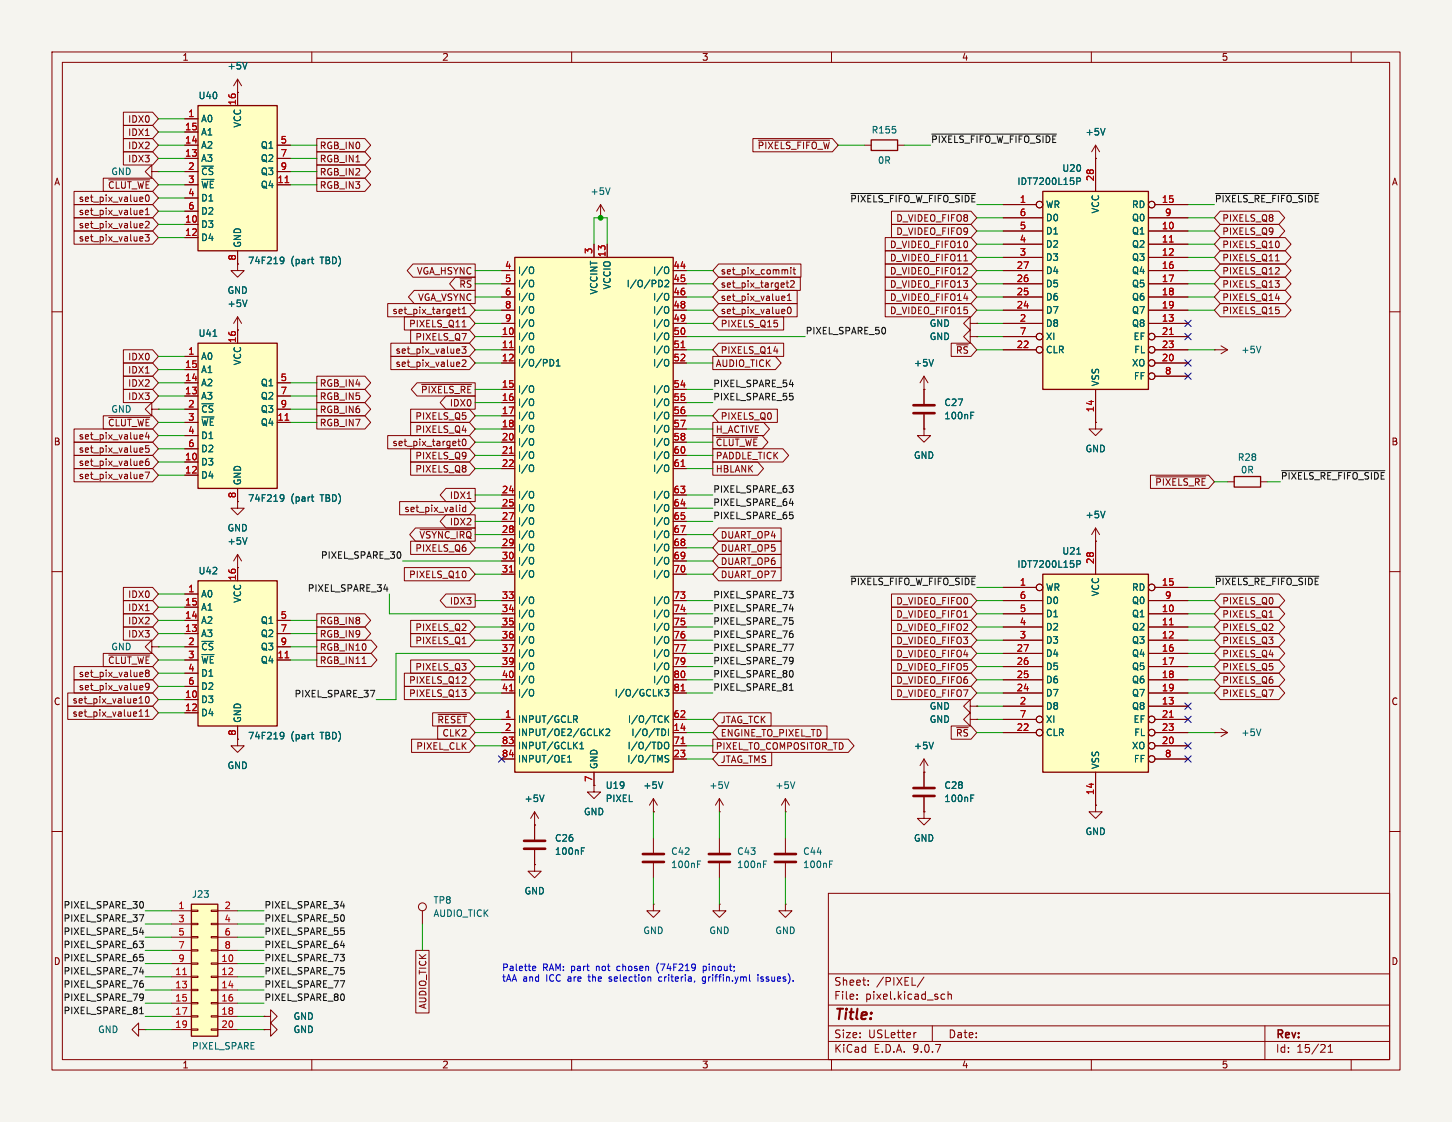
[picture p27: page 15]

Id: 15/21 Title: File: pixel.kicad_sch Sheet: /PIXEL/

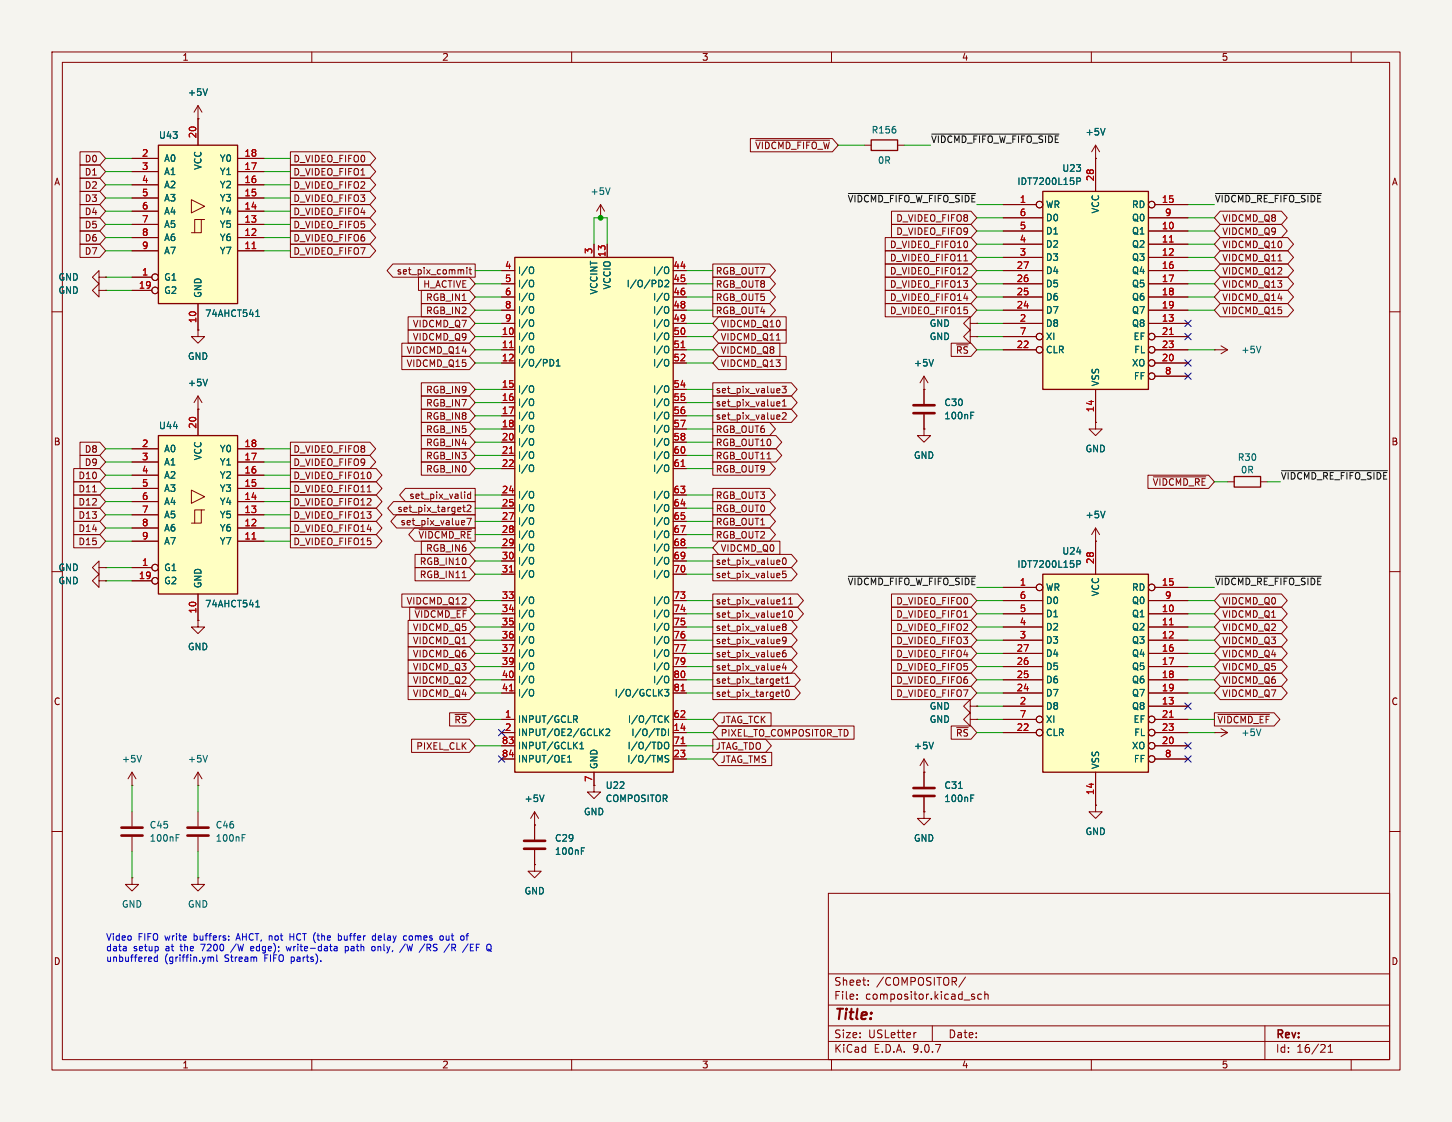
[picture p28: page 16]

Id: 16/21 Title: File: compositor.kicad_sch Sheet: /COMPOSITOR/ GND

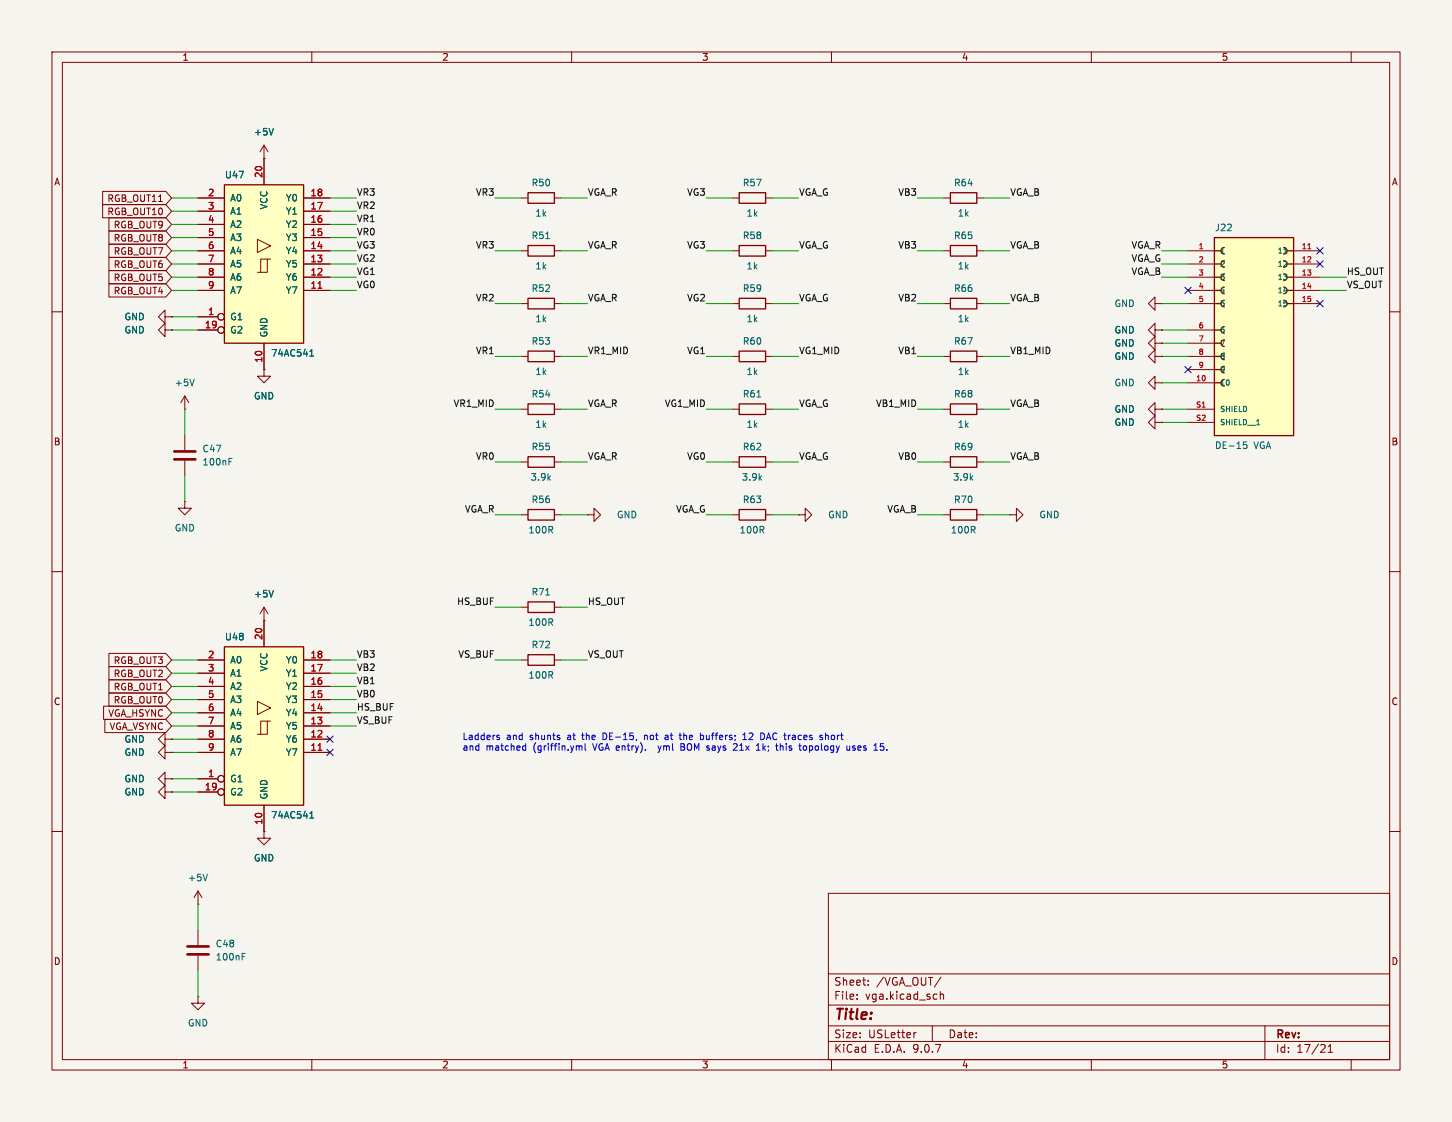
[picture p29: page 17]

Id: 17/21 Title: File: vga.kicad_sch Sheet: /VGA_OUT/

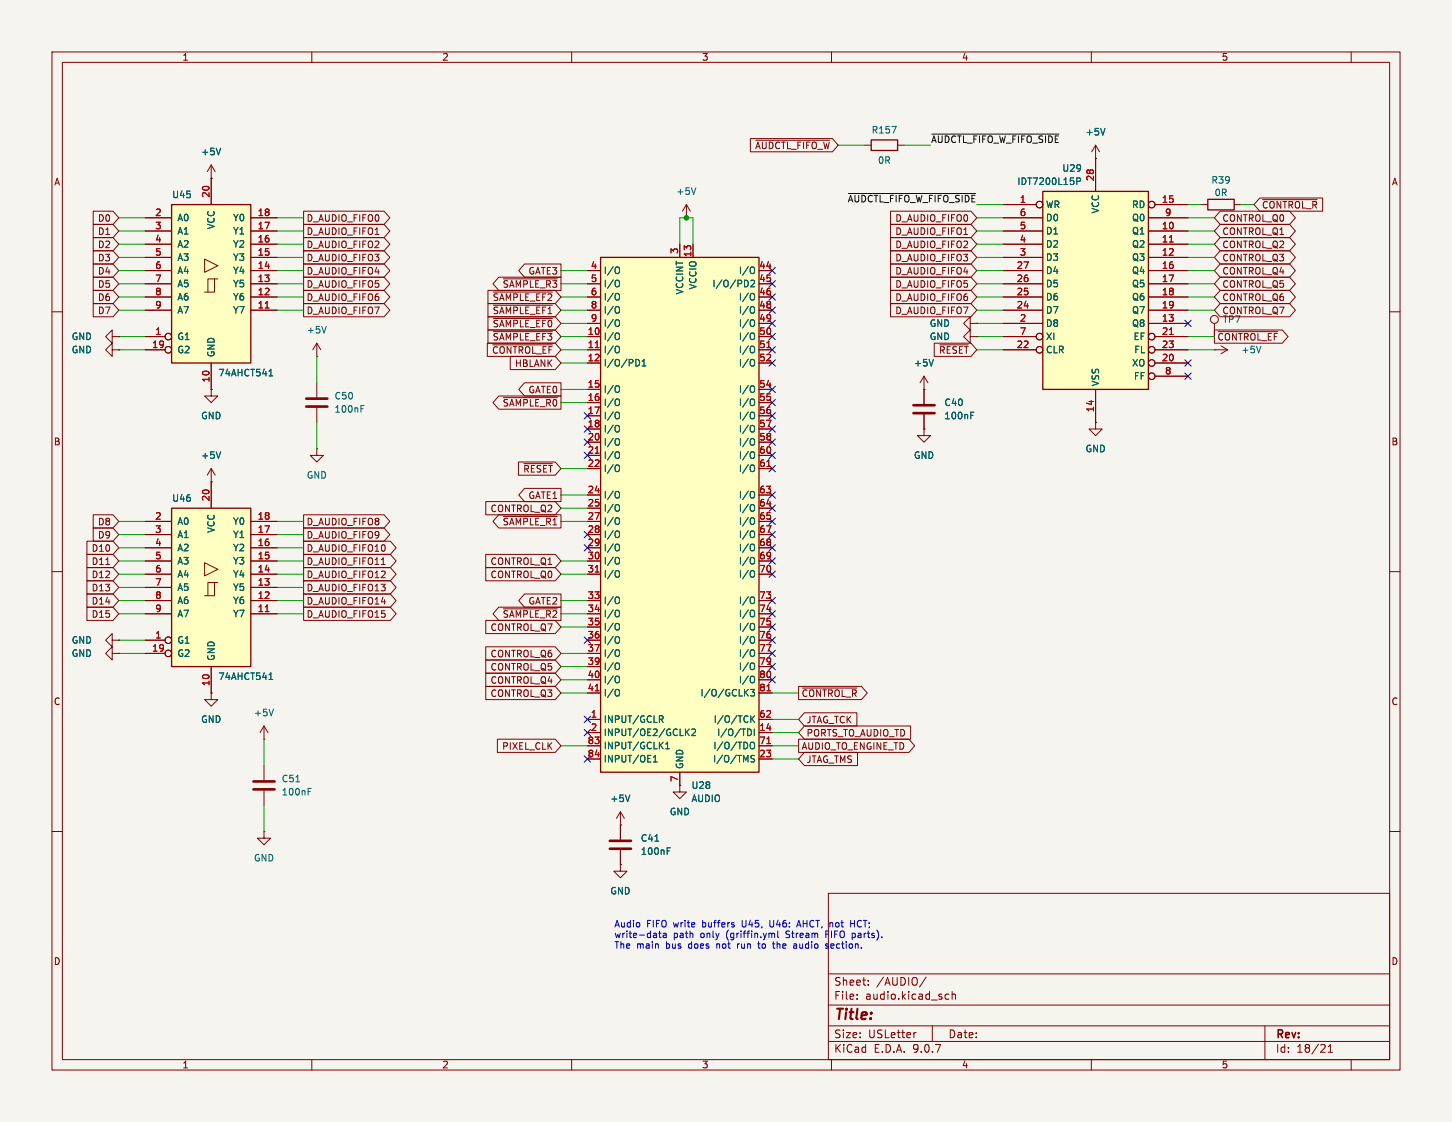
[picture p30: page 18]

Id: 18/21 Title: File: audio.kicad_sch Sheet: /AUDIO/

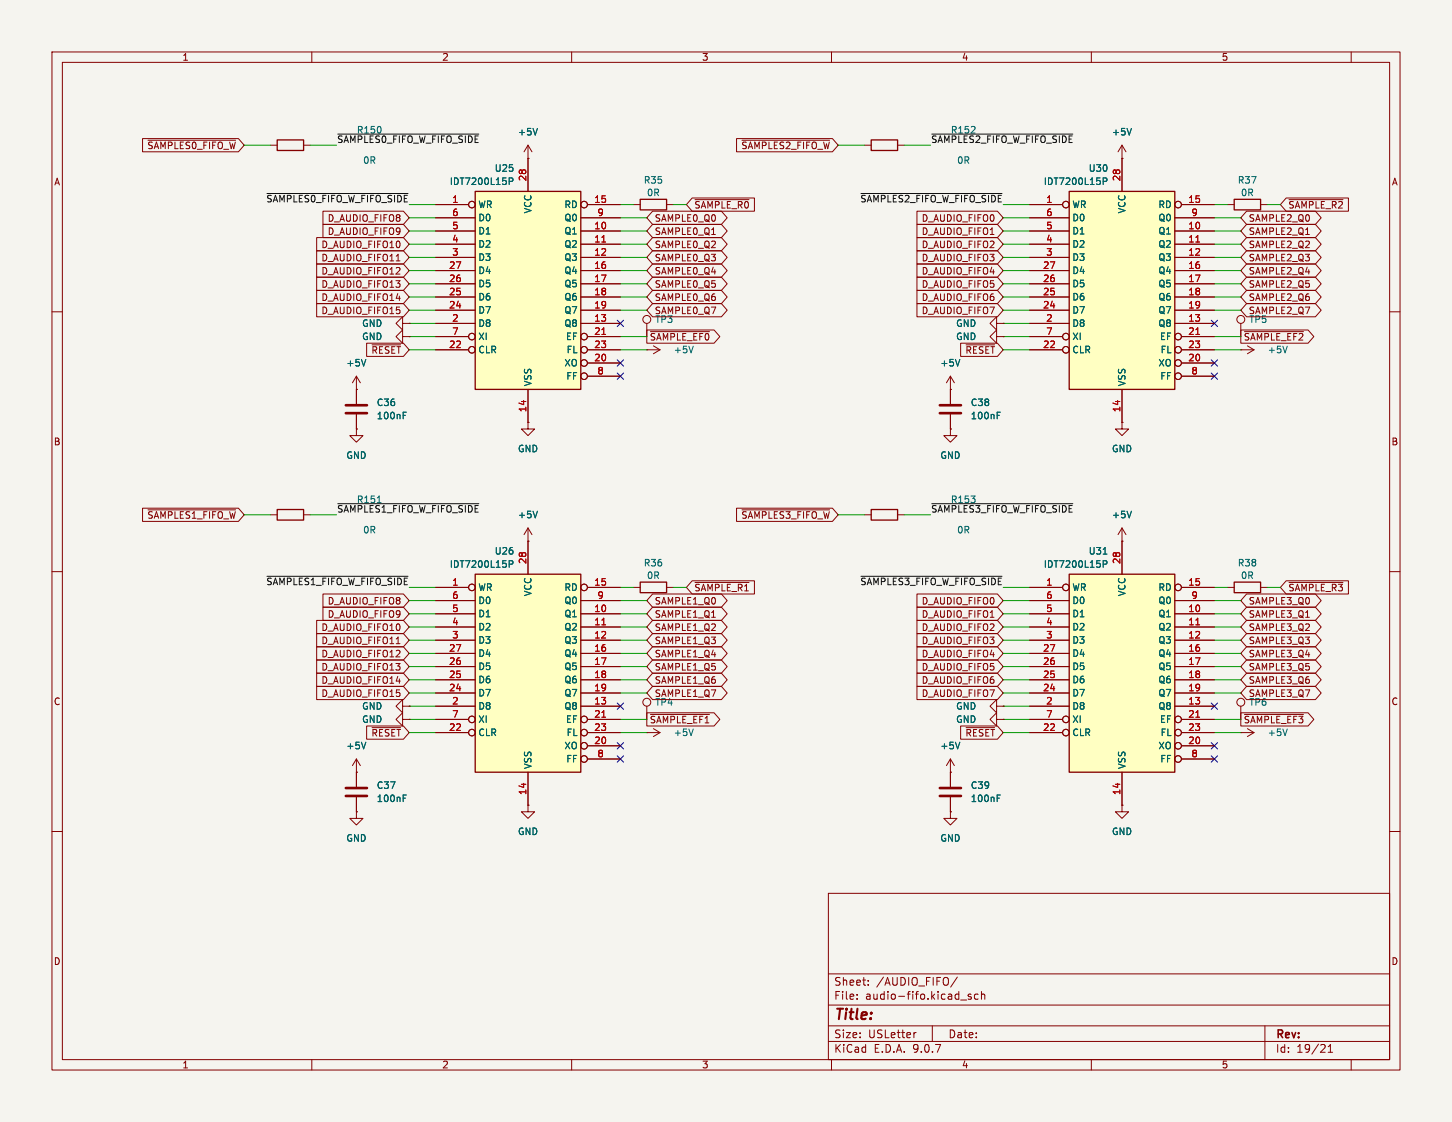
[picture p31: page 19]

Id: 19/21 Title: File: audio-fifo.kicad_sch Sheet: /AUDIO_FIFO/ GND GND

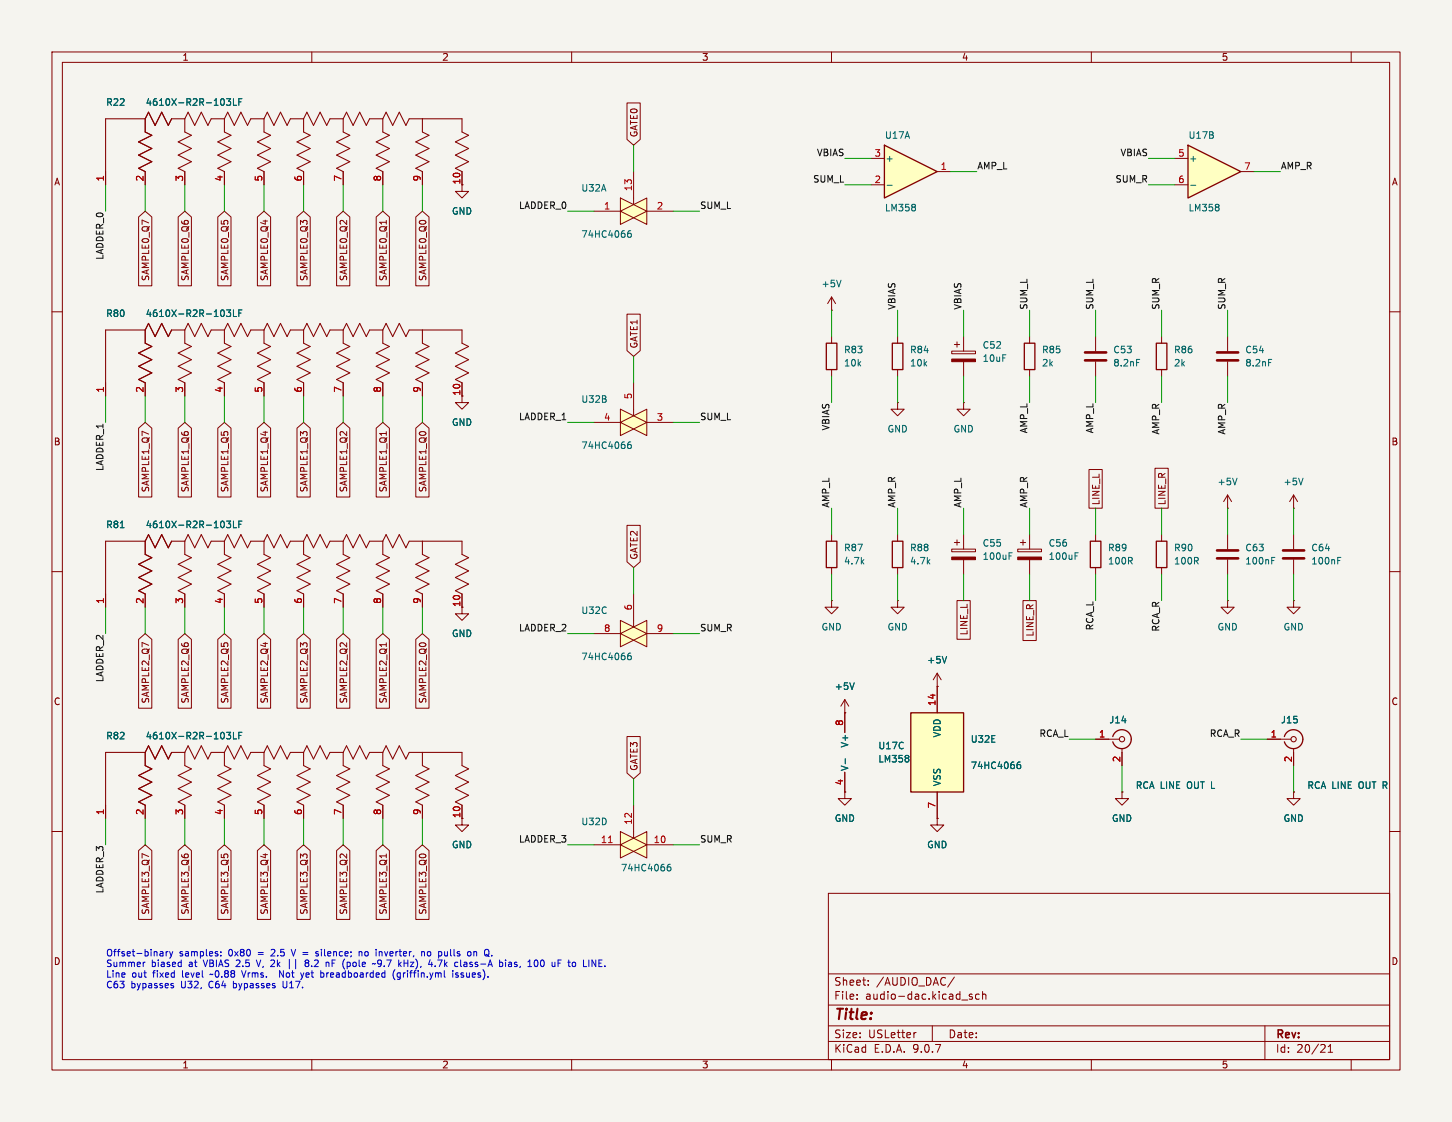
[picture p32: page 20]

2 GND GND GND GND

J15 RCA LINE OUT R GND

Id: 20/21 Title: File: audio-dac.kicad_sch Sheet: /AUDIO_DAC/ GND

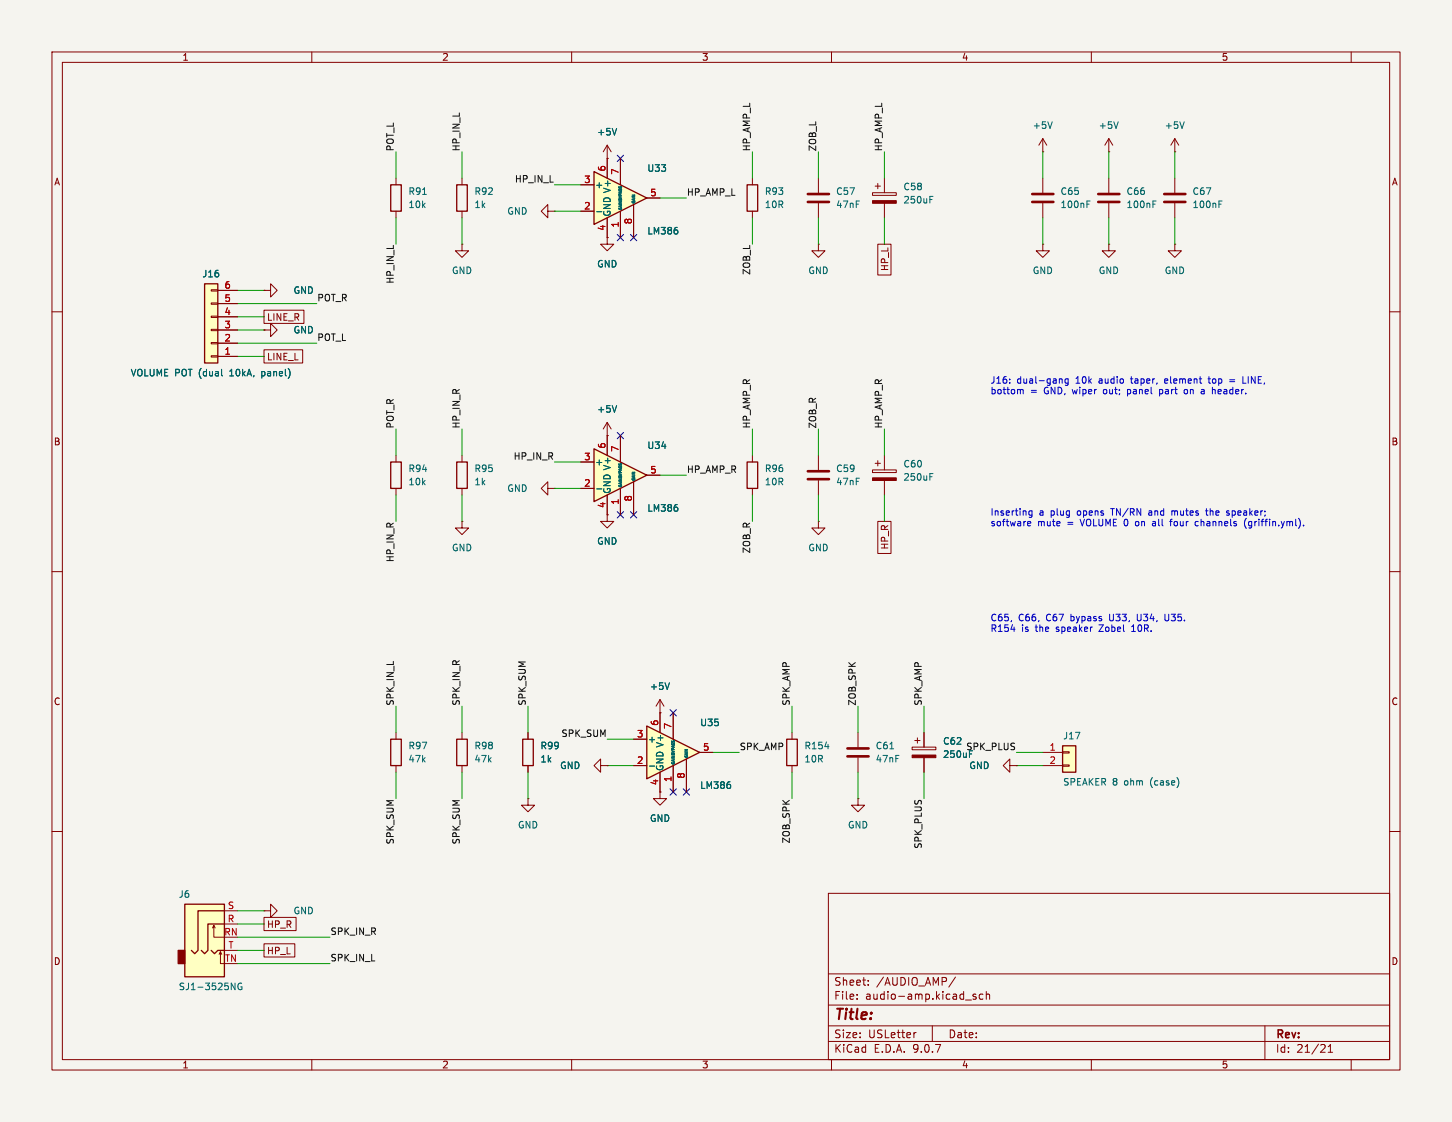
[picture p33: page 21]

J16 VOLUME POT (dual 10kA, panel) 1

Id: 21/21 Title: File: audio-amp.kicad_sch Sheet: /AUDIO_AMP/
