bradgrantham/griffin/board/board_rev_1_pcb.pdf

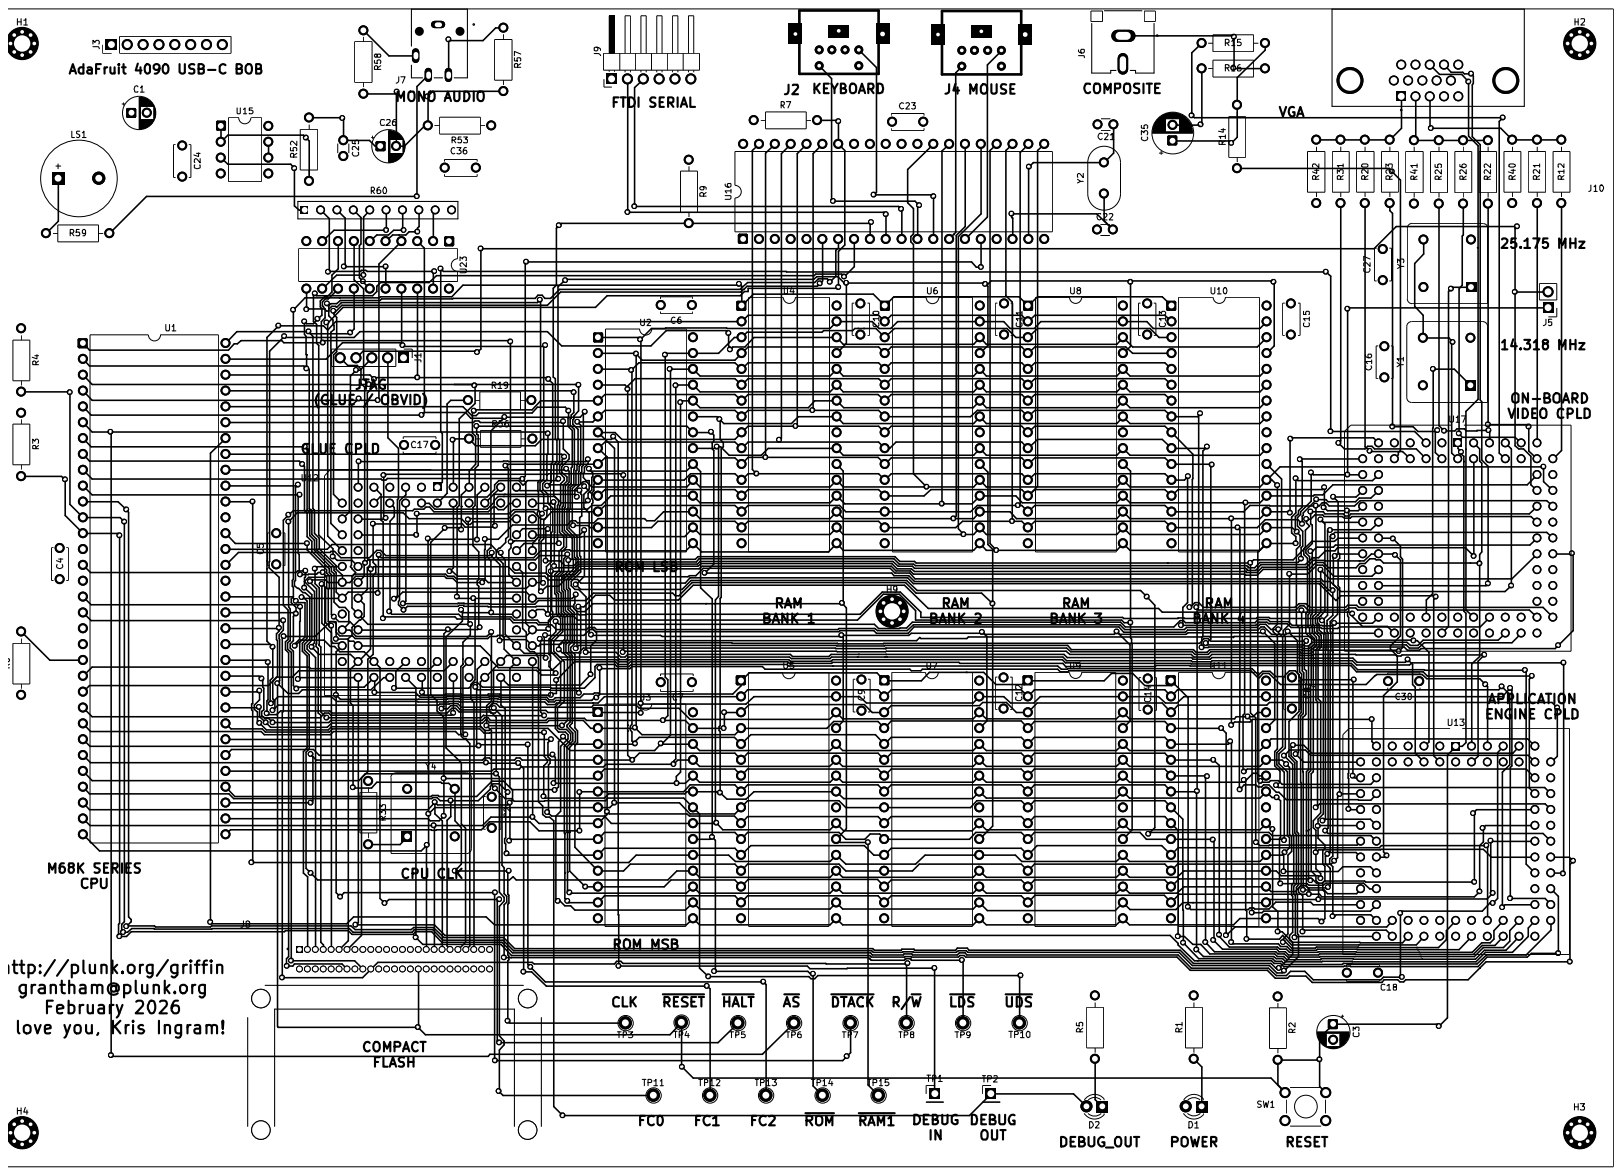
[picture p46: page 1]
