bradgrantham/griffin/board/board.kicad_pcb

## KiCad design board/board.kicad_pcb (2026-11-06)

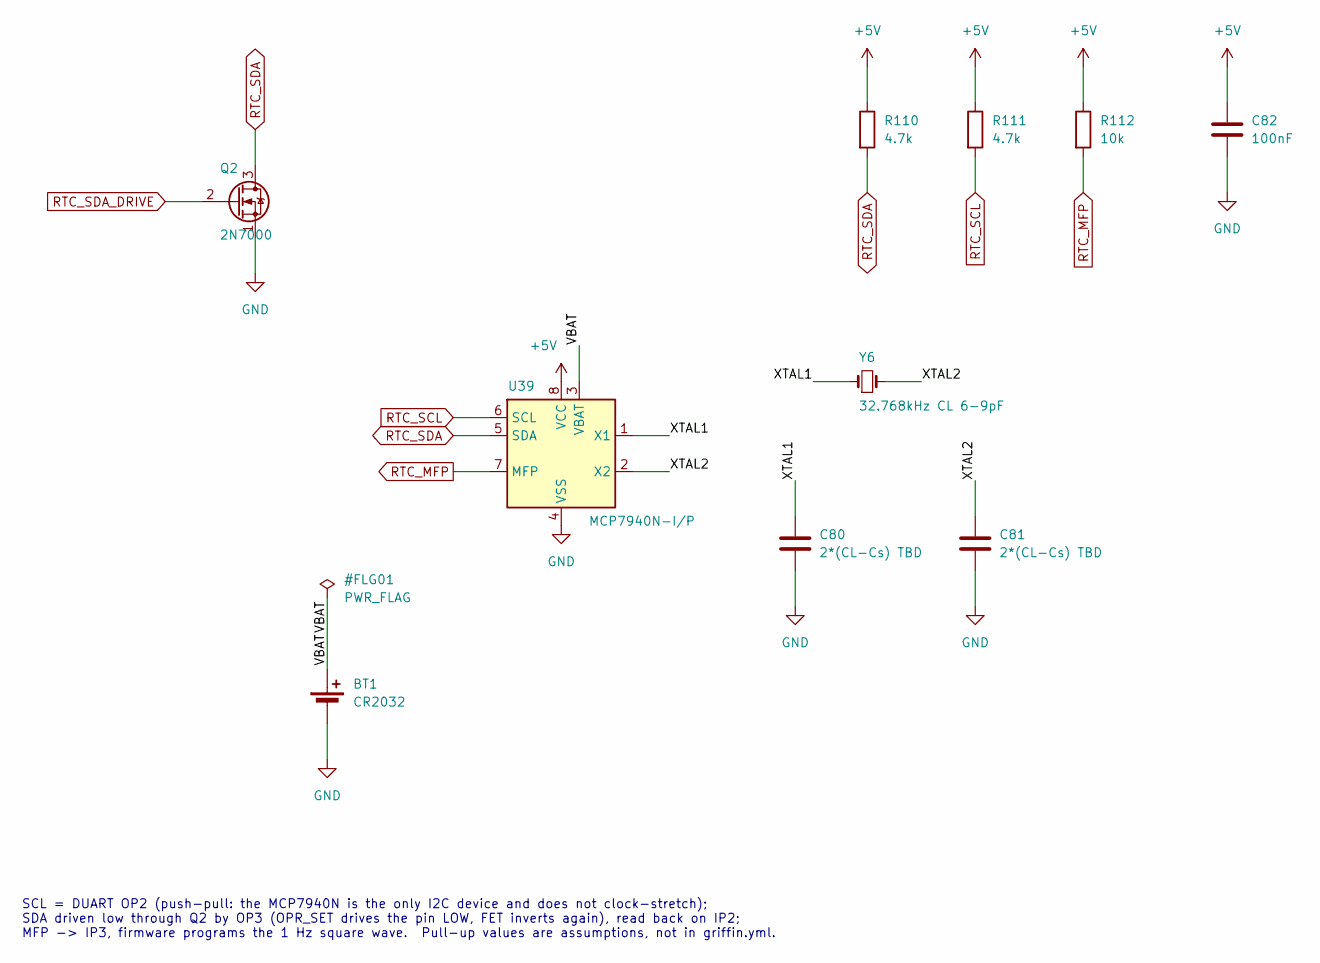
[picture p47: schematic rtc.kicad_sch]

Parts:
BT1: CR2032; BatteryHolder_Keystone_3034_1x20mm
C80, C81: 2*(CL-Cs) TBD; C_Disc_D5.0mm_W2.5mm_P5.00mm
C82: 100nF; C_Disc_D5.0mm_W2.5mm_P5.00mm
Q2: 2N7000; TO-92_Inline
R110, R111: 4.7k; R_Axial_DIN0207_L6.3mm_D2.5mm_P10.16mm_Horizontal
R112: 10k; R_Axial_DIN0207_L6.3mm_D2.5mm_P10.16mm_Horizontal
U39: MCP7940N-I/P; DIP-8_W7.62mm
Y6: 32.768kHz CL 6-9pF; Crystal_C26-LF_D2.1mm_L6.5mm_Vertical

Connections:
+5V: C82.1, R110.1, R111.1, R112.1, U39.8 (VCC); also elsewhere on the board
/RTC/XTAL1: C80.1, U39.1 (X1), Y6.1
/RTC/XTAL2: C81.1, U39.2 (X2), Y6.2
GND: BT1.2 (-), C80.2, C81.2, C82.2, Q2.1 (S), U39.4 (VSS); also elsewhere on the board
RTC_MFP: R112.2, U39.7 (MFP)
RTC_SCL: R111.2, U39.6 (SCL)
RTC_SDA: Q2.3 (D), R110.2, U39.5 (SDA)
RTC_SDA_DRIVE: Q2.2 (G)

Notes on the sheet:
SCL = DUART OP2 (push-pull: the MCP7940N is the only I2C device and does not clock-stretch); SDA driven low through Q2 by OP3 (OPR_SET drives the pin LOW, FET inverts again), read back on IP2; MFP -> IP3, firmware programs the 1 Hz square wave. Pull-up values are assumptions, not in griffin.yml.

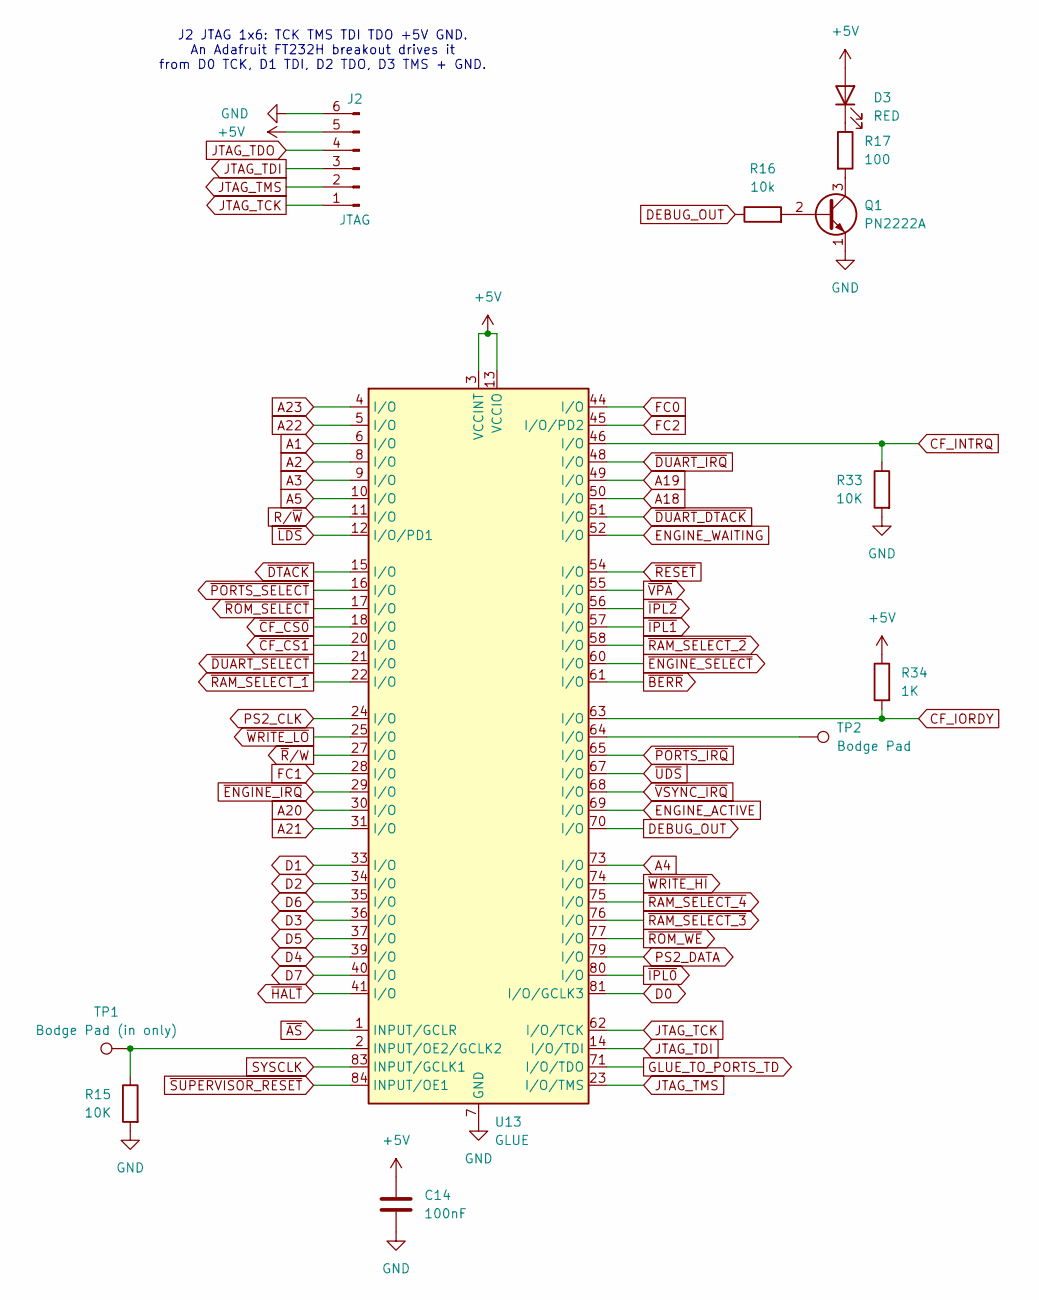
[picture p48: schematic glue.kicad_sch]

Parts:
C14: 100nF; C_Disc_D5.0mm_W2.5mm_P5.00mm
D3: RED; LED_D3.0mm
J2: JTAG; PinHeader_1x06_P2.54mm_Vertical
Q1: PN2222A; TO-92_Inline
R15, R33: 10K; R_Axial_DIN0207_L6.3mm_D2.5mm_P10.16mm_Horizontal
R16: 10k; R_Axial_DIN0207_L6.3mm_D2.5mm_P10.16mm_Horizontal
R17: 100; R_Axial_DIN0207_L6.3mm_D2.5mm_P10.16mm_Horizontal
R34: 1K; R_Axial_DIN0207_L6.3mm_D2.5mm_P10.16mm_Horizontal
TP1: Bodge Pad (in only)
TP2: Bodge Pad
U13: GLUE; PLCC-84_THT-Socket

Connections:
+5V: C14.1, D3.2 (A), J2.5, R34.1, U13.3 (VCCINT), U13.13 (VCCIO), U13.26 (VCCIO), U13.38 (VCCIO), U13.43 (VCCINT), U13.53 (VCCIO), U13.66 (VCCIO), U13.78 (VCCIO); also elsewhere on the board
A1: U13.6 (I/O); also elsewhere on the board
A2: U13.8 (I/O); also elsewhere on the board
A3: U13.9 (I/O); also elsewhere on the board
A4: U13.73 (I/O); also elsewhere on the board
A5: U13.10 (I/O); also elsewhere on the board
A18: U13.50 (I/O); also elsewhere on the board
A19: U13.49 (I/O); also elsewhere on the board
A20: U13.30 (I/O); also elsewhere on the board
A21: U13.31 (I/O); also elsewhere on the board
A22: U13.5 (I/O); also elsewhere on the board
A23: U13.4 (I/O); also elsewhere on the board
CF_INTRQ: R33.1, U13.46 (I/O); also elsewhere on the board
CF_IORDY: R34.2, U13.63 (I/O); also elsewhere on the board
D0: U13.81 (I/O/GCLK3); also elsewhere on the board
D1: U13.33 (I/O); also elsewhere on the board
D2: U13.34 (I/O); also elsewhere on the board
D3: U13.36 (I/O); also elsewhere on the board
D4: U13.39 (I/O); also elsewhere on the board
D5: U13.37 (I/O); also elsewhere on the board
D6: U13.35 (I/O); also elsewhere on the board
D7: U13.40 (I/O); also elsewhere on the board
DEBUG_OUT: R16.1, U13.70 (I/O)
ENGINE_ACTIVE: U13.69 (I/O); also elsewhere on the board
ENGINE_WAITING: U13.52 (I/O); also elsewhere on the board
FC0: U13.44 (I/O); also elsewhere on the board
FC1: U13.28 (I/O); also elsewhere on the board
FC2: U13.45 (I/O/PD2); also elsewhere on the board
GLUE_TO_PORTS_TD: U13.71 (I/O/TDO); also elsewhere on the board
GND: C14.2, J2.6, Q1.1 (E), R15.2, R33.2, U13.7 (GND), U13.19 (GND), U13.32 (GND), U13.42 (GND), U13.47 (GND), U13.59 (GND), U13.72 (GND), U13.82 (GND); also elsewhere on the board
JTAG_TCK: J2.1, U13.62 (I/O/TCK); also elsewhere on the board
JTAG_TDI: J2.3, U13.14 (I/O/TDI)
JTAG_TDO: J2.4; also elsewhere on the board
JTAG_TMS: J2.2, U13.23 (I/O/TMS); also elsewhere on the board
unnamed: D3.1 (K), R17.1
unnamed: Q1.2 (B), R16.2
unnamed: Q1.3 (C), R17.2
unnamed: TP2.1, U13.64 (I/O)
unnamed: R15.1, TP1.1, U13.2 (INPUT/OE2/GCLK2)
PS2_CLK: U13.24 (I/O); also elsewhere on the board
PS2_DATA: U13.79 (I/O); also elsewhere on the board
R/~W: U13.11 (I/O); also elsewhere on the board
SYSCLK: U13.83 (INPUT/GCLK1); also elsewhere on the board
~AS: U13.1 (INPUT/GCLR); also elsewhere on the board
~BERR: U13.61 (I/O); also elsewhere on the board
~CF_CS0: U13.18 (I/O); also elsewhere on the board
~CF_CS1: U13.20 (I/O); also elsewhere on the board
~DTACK: U13.15 (I/O); also elsewhere on the board
~DUART_DTACK: U13.51 (I/O)
~DUART_IRQ: U13.48 (I/O)
~DUART_SELECT: U13.21 (I/O)
~ENGINE_IRQ: U13.29 (I/O); also elsewhere on the board
~ENGINE_SELECT: U13.60 (I/O); also elsewhere on the board
~HALT: U13.41 (I/O); also elsewhere on the board
~IPL0: U13.80 (I/O); also elsewhere on the board
~IPL1: U13.57 (I/O); also elsewhere on the board
~IPL2: U13.56 (I/O); also elsewhere on the board
~LDS: U13.12 (I/O/PD1); also elsewhere on the board
~PORTS_IRQ: U13.65 (I/O); also elsewhere on the board
~PORTS_SELECT: U13.16 (I/O); also elsewhere on the board
~RAM_SELECT_1: U13.22 (I/O); also elsewhere on the board
~RAM_SELECT_2: U13.58 (I/O); also elsewhere on the board
~RAM_SELECT_3: U13.76 (I/O); also elsewhere on the board
~RAM_SELECT_4: U13.75 (I/O); also elsewhere on the board
~RESET: U13.54 (I/O); also elsewhere on the board
~ROM_SELECT: U13.17 (I/O); also elsewhere on the board
~ROM_WE: U13.77 (I/O); also elsewhere on the board
~R/W: U13.27 (I/O); also elsewhere on the board
~SUPERVISOR_RESET: U13.84 (INPUT/OE1); also elsewhere on the board
~UDS: U13.67 (I/O); also elsewhere on the board
~VPA: U13.55 (I/O); also elsewhere on the board
~VSYNC_IRQ: U13.68 (I/O); also elsewhere on the board
~WRITE_HI: U13.74 (I/O); also elsewhere on the board
~WRITE_LO: U13.25 (I/O); also elsewhere on the board

Notes on the sheet:
J2 JTAG 1x6: TCK TMS TDI TDO +5V GND. An Adafruit FT232H breakout drives it from D0 TCK, D1 TDI, D2 TDO, D3 TMS + GND.

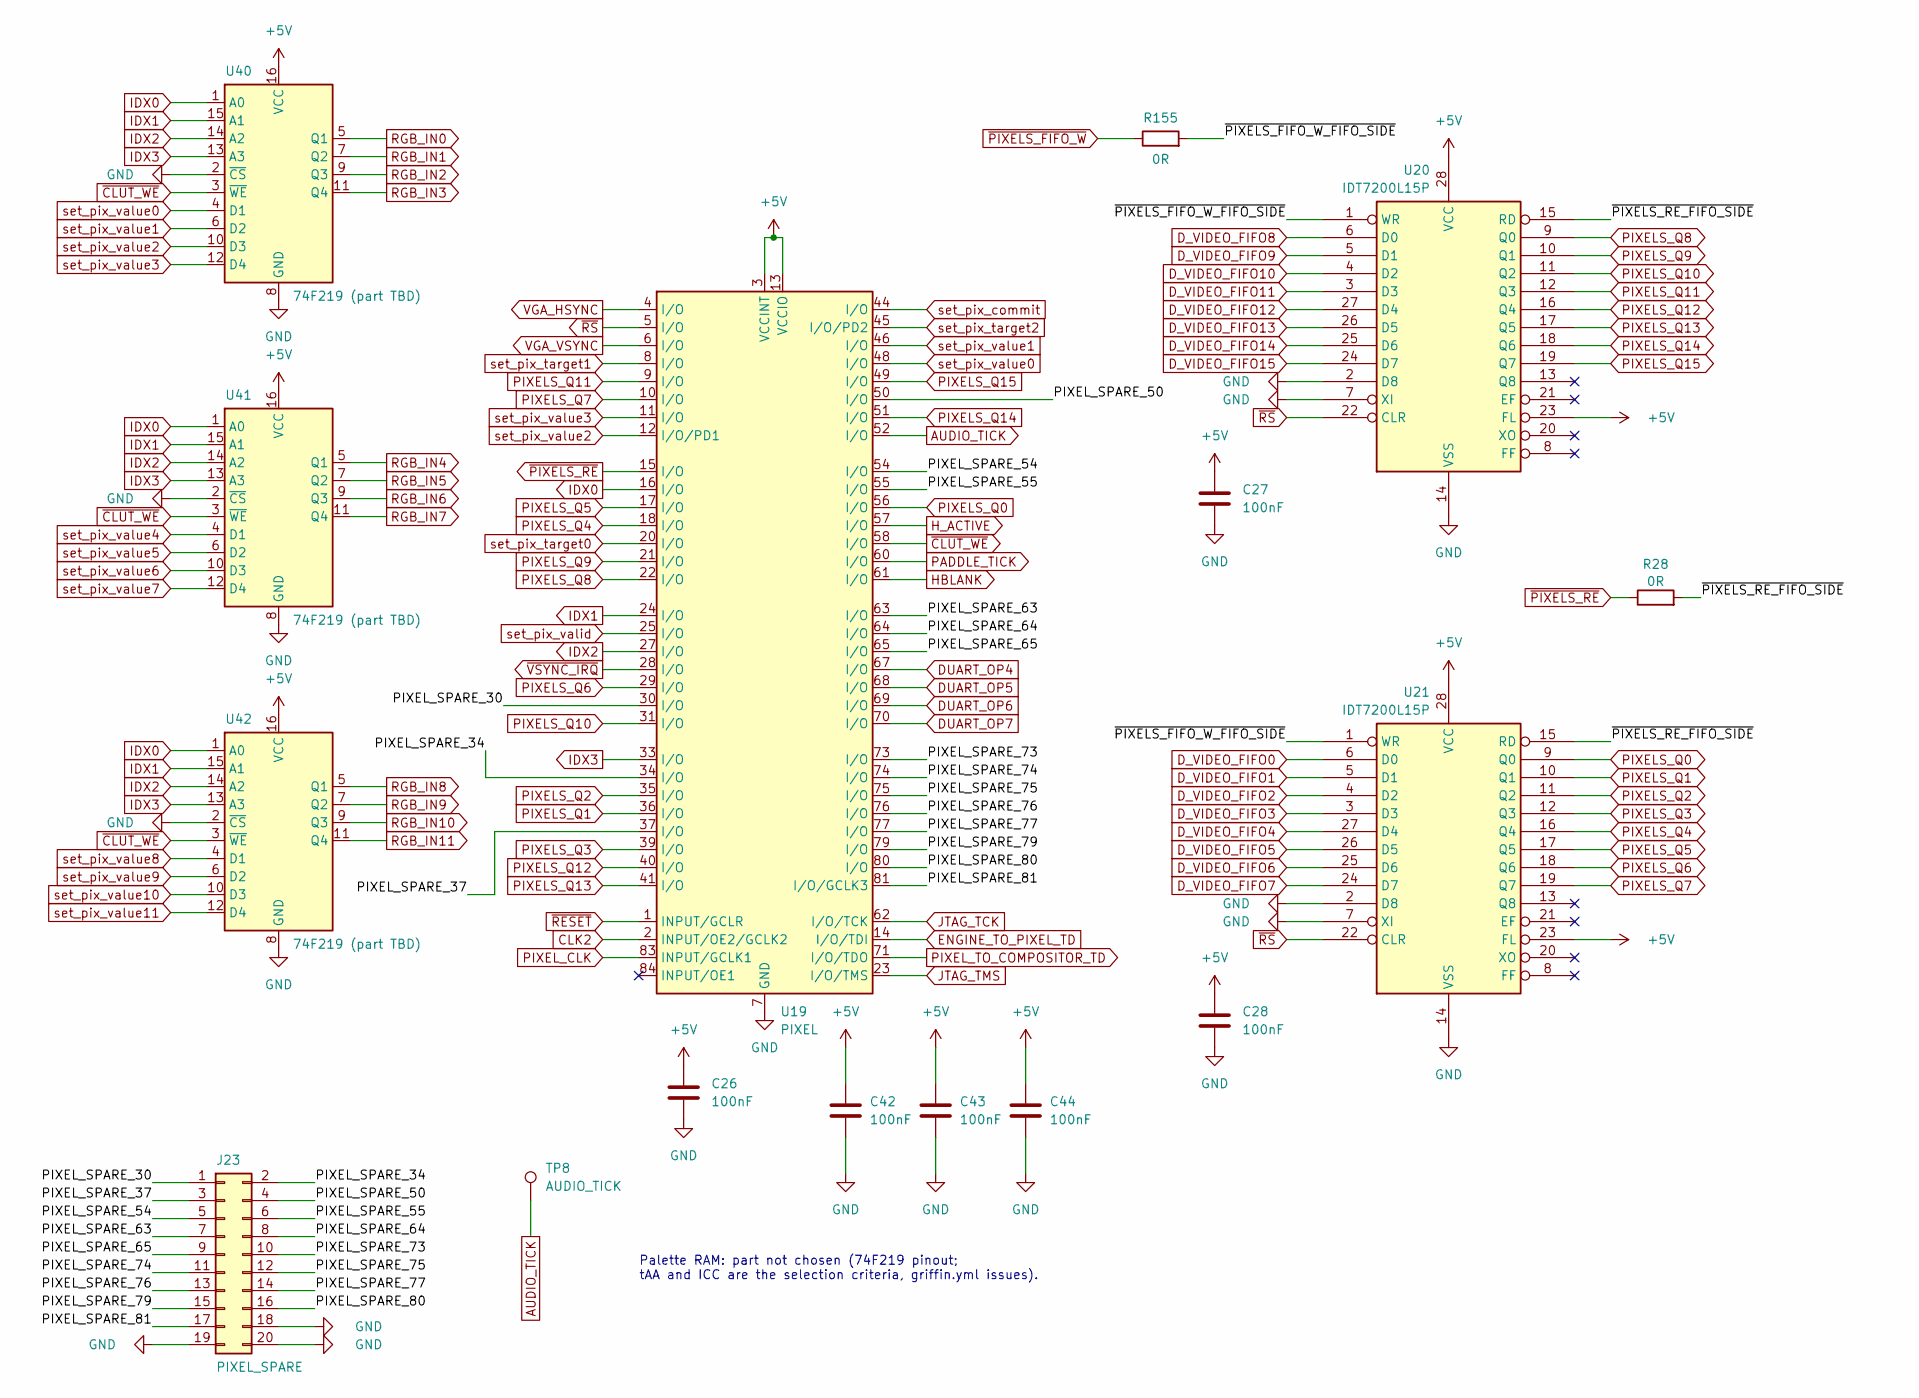
[picture p49: schematic pixel.kicad_sch]

Parts:
C26, C27, C28, C42, C43, C44: 100nF; C_Disc_D5.0mm_W2.5mm_P5.00mm
J23: PIXEL_SPARE; PinHeader_2x10_P2.54mm_Vertical
R28, R155: 0R; R_Axial_DIN0207_L6.3mm_D2.5mm_P10.16mm_Horizontal
TP8: AUDIO_TICK; TestPoint_Pad_D1.5mm
U19: PIXEL; PLCC-84_THT-Socket
U20, U21: IDT7200L15P; DIP-28_W7.62mm
U40, U41, U42: 74F219 (part TBD); DIP-16_W7.62mm

Connections:
+5V: C26.1, C27.1, C28.1, C42.1, C43.1, C44.1, U19.3 (VCCINT), U19.13 (VCCIO), U19.26 (VCCIO), U19.38 (VCCIO), U19.43 (VCCINT), U19.53 (VCCIO), U19.66 (VCCIO), U19.78 (VCCIO), U20.23 (FL), U20.28 (VCC), U21.23 (FL), U21.28 (VCC), U40.16 (VCC), U41.16 (VCC), U42.16 (VCC); also elsewhere on the board
/PIXEL/PIXEL_SPARE_30: J23.1, U19.30 (I/O)
/PIXEL/PIXEL_SPARE_34: J23.2, U19.34 (I/O)
/PIXEL/PIXEL_SPARE_37: J23.3, U19.37 (I/O)
/PIXEL/PIXEL_SPARE_50: J23.4, U19.50 (I/O)
/PIXEL/PIXEL_SPARE_54: J23.5, U19.54 (I/O)
/PIXEL/PIXEL_SPARE_55: J23.6, U19.55 (I/O)
/PIXEL/PIXEL_SPARE_63: J23.7, U19.63 (I/O)
/PIXEL/PIXEL_SPARE_64: J23.8, U19.64 (I/O)
/PIXEL/PIXEL_SPARE_65: J23.9, U19.65 (I/O)
/PIXEL/PIXEL_SPARE_73: J23.10, U19.73 (I/O)
/PIXEL/PIXEL_SPARE_74: J23.11, U19.74 (I/O)
/PIXEL/PIXEL_SPARE_75: J23.12, U19.75 (I/O)
/PIXEL/PIXEL_SPARE_76: J23.13, U19.76 (I/O)
/PIXEL/PIXEL_SPARE_77: J23.14, U19.77 (I/O)
/PIXEL/PIXEL_SPARE_79: J23.15, U19.79 (I/O)
/PIXEL/PIXEL_SPARE_80: J23.16, U19.80 (I/O)
/PIXEL/PIXEL_SPARE_81: J23.17, U19.81 (I/O/GCLK3)
/PIXEL/~PIXELS_FIFO_W_FIFO_SIDE: R155.2, U20.1 (WR), U21.1 (WR)
/PIXEL/~PIXELS_RE_FIFO_SIDE: R28.2, U20.15 (RD), U21.15 (RD)
AUDIO_TICK: TP8.1, U19.52 (I/O)
CLK2: U19.2 (INPUT/OE2/GCLK2); also elsewhere on the board
DUART_OP4: U19.67 (I/O)
DUART_OP5: U19.68 (I/O)
DUART_OP6: U19.69 (I/O)
DUART_OP7: U19.70 (I/O)
D_VIDEO_FIFO0: U21.6 (D0); also elsewhere on the board
D_VIDEO_FIFO1: U21.5 (D1); also elsewhere on the board
D_VIDEO_FIFO2: U21.4 (D2); also elsewhere on the board
D_VIDEO_FIFO3: U21.3 (D3); also elsewhere on the board
D_VIDEO_FIFO4: U21.27 (D4); also elsewhere on the board
D_VIDEO_FIFO5: U21.26 (D5); also elsewhere on the board
D_VIDEO_FIFO6: U21.25 (D6); also elsewhere on the board
D_VIDEO_FIFO7: U21.24 (D7); also elsewhere on the board
D_VIDEO_FIFO8: U20.6 (D0); also elsewhere on the board
D_VIDEO_FIFO9: U20.5 (D1); also elsewhere on the board
D_VIDEO_FIFO10: U20.4 (D2); also elsewhere on the board
D_VIDEO_FIFO11: U20.3 (D3); also elsewhere on the board
D_VIDEO_FIFO12: U20.27 (D4); also elsewhere on the board
D_VIDEO_FIFO13: U20.26 (D5); also elsewhere on the board
D_VIDEO_FIFO14: U20.25 (D6); also elsewhere on the board
D_VIDEO_FIFO15: U20.24 (D7); also elsewhere on the board
ENGINE_TO_PIXEL_TD: U19.14 (I/O/TDI); also elsewhere on the board
GND: C26.2, C27.2, C28.2, C42.2, C43.2, C44.2, J23.18, J23.19, J23.20, U19.7 (GND), U19.19 (GND), U19.32 (GND), U19.42 (GND), U19.47 (GND), U19.59 (GND), U19.72 (GND), U19.82 (GND), U20.2 (D8), U20.7 (XI), U20.14 (VSS), U21.2 (D8), U21.7 (XI), U21.14 (VSS), U40.2 (~CS), U40.8 (GND), U41.2 (~CS), U41.8 (GND), U42.2 (~CS), U42.8 (GND); also elsewhere on the board
HBLANK: U19.61 (I/O); also elsewhere on the board
H_ACTIVE: U19.57 (I/O); also elsewhere on the board
IDX0: U19.16 (I/O), U40.1 (A0), U41.1 (A0), U42.1 (A0)
IDX1: U19.24 (I/O), U40.15 (A1), U41.15 (A1), U42.15 (A1)
IDX2: U19.27 (I/O), U40.14 (A2), U41.14 (A2), U42.14 (A2)
IDX3: U19.33 (I/O), U40.13 (A3), U41.13 (A3), U42.13 (A3)
JTAG_TCK: U19.62 (I/O/TCK); also elsewhere on the board
JTAG_TMS: U19.23 (I/O/TMS); also elsewhere on the board
PADDLE_TICK: U19.60 (I/O); also elsewhere on the board
PIXELS_Q0: U19.56 (I/O), U21.9 (Q0)
PIXELS_Q1: U19.36 (I/O), U21.10 (Q1)
PIXELS_Q2: U19.35 (I/O), U21.11 (Q2)
PIXELS_Q3: U19.39 (I/O), U21.12 (Q3)
PIXELS_Q4: U19.18 (I/O), U21.16 (Q4)
PIXELS_Q5: U19.17 (I/O), U21.17 (Q5)
PIXELS_Q6: U19.29 (I/O), U21.18 (Q6)
PIXELS_Q7: U19.10 (I/O), U21.19 (Q7)
PIXELS_Q8: U19.22 (I/O), U20.9 (Q0)
PIXELS_Q9: U19.21 (I/O), U20.10 (Q1)
PIXELS_Q10: U19.31 (I/O), U20.11 (Q2)
PIXELS_Q11: U19.9 (I/O), U20.12 (Q3)
PIXELS_Q12: U19.40 (I/O), U20.16 (Q4)
PIXELS_Q13: U19.41 (I/O), U20.17 (Q5)
PIXELS_Q14: U19.51 (I/O), U20.18 (Q6)
PIXELS_Q15: U19.49 (I/O), U20.19 (Q7)
PIXEL_CLK: U19.83 (INPUT/GCLK1); also elsewhere on the board
PIXEL_TO_COMPOSITOR_TD: U19.71 (I/O/TDO); also elsewhere on the board
RGB_IN0: U40.5 (Q1); also elsewhere on the board
RGB_IN1: U40.7 (Q2); also elsewhere on the board
RGB_IN2: U40.9 (Q3); also elsewhere on the board
RGB_IN3: U40.11 (Q4); also elsewhere on the board
RGB_IN4: U41.5 (Q1); also elsewhere on the board
RGB_IN5: U41.7 (Q2); also elsewhere on the board
RGB_IN6: U41.9 (Q3); also elsewhere on the board
RGB_IN7: U41.11 (Q4); also elsewhere on the board
RGB_IN8: U42.5 (Q1); also elsewhere on the board
RGB_IN9: U42.7 (Q2); also elsewhere on the board
RGB_IN10: U42.9 (Q3); also elsewhere on the board
RGB_IN11: U42.11 (Q4); also elsewhere on the board
VGA_HSYNC: U19.4 (I/O); also elsewhere on the board
VGA_VSYNC: U19.6 (I/O); also elsewhere on the board
set_pix_commit: U19.44 (I/O); also elsewhere on the board
set_pix_target0: U19.20 (I/O); also elsewhere on the board
set_pix_target1: U19.8 (I/O); also elsewhere on the board
set_pix_target2: U19.45 (I/O/PD2); also elsewhere on the board
set_pix_valid: U19.25 (I/O); also elsewhere on the board
set_pix_value0: U19.48 (I/O), U40.4 (D1); also elsewhere on the board
set_pix_value1: U19.46 (I/O), U40.6 (D2); also elsewhere on the board
set_pix_value2: U19.12 (I/O/PD1), U40.10 (D3); also elsewhere on the board
set_pix_value3: U19.11 (I/O), U40.12 (D4); also elsewhere on the board
set_pix_value4: U41.4 (D1); also elsewhere on the board
set_pix_value5: U41.6 (D2); also elsewhere on the board
set_pix_value6: U41.10 (D3); also elsewhere on the board
set_pix_value7: U41.12 (D4); also elsewhere on the board
set_pix_value8: U42.4 (D1); also elsewhere on the board
set_pix_value9: U42.6 (D2); also elsewhere on the board
set_pix_value10: U42.10 (D3); also elsewhere on the board
set_pix_value11: U42.12 (D4); also elsewhere on the board
~CLUT_WE: U19.58 (I/O), U40.3 (~WE), U41.3 (~WE), U42.3 (~WE)
~PIXELS_FIFO_W: R155.1; also elsewhere on the board
~PIXELS_RE: R28.1, U19.15 (I/O)
~RESET: U19.1 (INPUT/GCLR); also elsewhere on the board
~RS: U19.5 (I/O), U20.22 (CLR), U21.22 (CLR); also elsewhere on the board
~VSYNC_IRQ: U19.28 (I/O); also elsewhere on the board

Notes on the sheet:
Palette RAM: part not chosen (74F219 pinout; tAA and ICC are the selection criteria, griffin.yml issues).

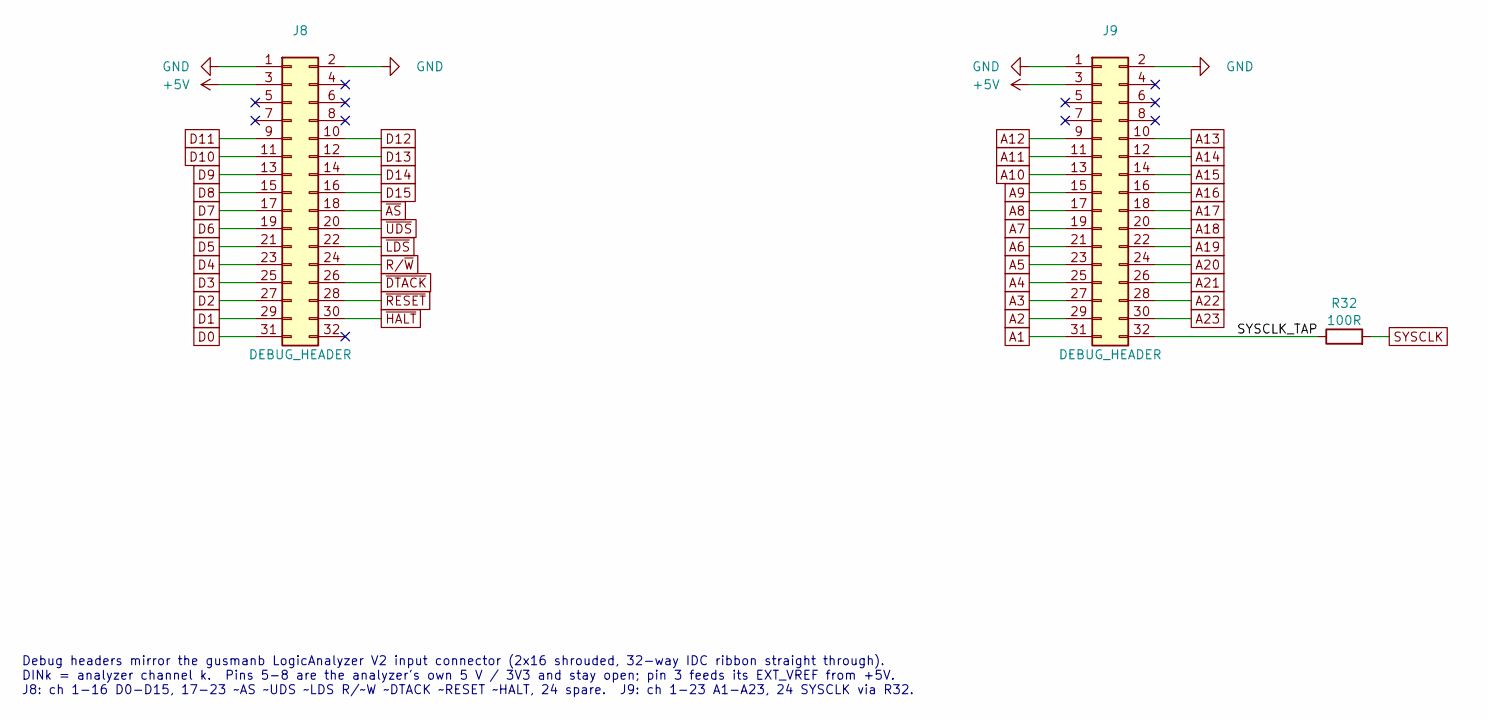
[picture p50: schematic debug-header.kicad_sch]

Parts:
J8, J9: DEBUG_HEADER; IDC-Header_2x16_P2.54mm_Vertical
R32: 100R; R_Axial_DIN0207_L6.3mm_D2.5mm_P10.16mm_Horizontal

Connections:
+5V: J8.3, J9.3; also elsewhere on the board
/DEBUG_HEADER/SYSCLK_TAP: J9.32, R32.1
A1: J9.31; also elsewhere on the board
A2: J9.29; also elsewhere on the board
A3: J9.27; also elsewhere on the board
A4: J9.25; also elsewhere on the board
A5: J9.23; also elsewhere on the board
A6: J9.21; also elsewhere on the board
A7: J9.19; also elsewhere on the board
A8: J9.17; also elsewhere on the board
A9: J9.15; also elsewhere on the board
A10: J9.13; also elsewhere on the board
A11: J9.11; also elsewhere on the board
A12: J9.9; also elsewhere on the board
A13: J9.10; also elsewhere on the board
A14: J9.12; also elsewhere on the board
A15: J9.14; also elsewhere on the board
A16: J9.16; also elsewhere on the board
A17: J9.18; also elsewhere on the board
A18: J9.20; also elsewhere on the board
A19: J9.22; also elsewhere on the board
A20: J9.24; also elsewhere on the board
A21: J9.26; also elsewhere on the board
A22: J9.28; also elsewhere on the board
A23: J9.30; also elsewhere on the board
D0: J8.31; also elsewhere on the board
D1: J8.29; also elsewhere on the board
D2: J8.27; also elsewhere on the board
D3: J8.25; also elsewhere on the board
D4: J8.23; also elsewhere on the board
D5: J8.21; also elsewhere on the board
D6: J8.19; also elsewhere on the board
D7: J8.17; also elsewhere on the board
D8: J8.15; also elsewhere on the board
D9: J8.13; also elsewhere on the board
D10: J8.11; also elsewhere on the board
D11: J8.9; also elsewhere on the board
D12: J8.10; also elsewhere on the board
D13: J8.12; also elsewhere on the board
D14: J8.14; also elsewhere on the board
D15: J8.16; also elsewhere on the board
GND: J8.1, J8.2, J9.1, J9.2; also elsewhere on the board
R/~W: J8.24; also elsewhere on the board
SYSCLK: R32.2; also elsewhere on the board
~AS: J8.18; also elsewhere on the board
~DTACK: J8.26; also elsewhere on the board
~HALT: J8.30; also elsewhere on the board
~LDS: J8.22; also elsewhere on the board
~RESET: J8.28; also elsewhere on the board
~UDS: J8.20; also elsewhere on the board

Notes on the sheet:
Debug headers mirror the gusmanb LogicAnalyzer V2 input connector (2x16 shrouded, 32-way IDC ribbon straight through). DINk = analyzer channel k. Pins 5-8 are the analyzer's own 5 V / 3V3 and stay open; pin 3 feeds its EXT_VREF from +5V. J8: ch 1-16 D0-D15, 17-23 ~AS ~UDS ~LDS R/~W ~DTACK ~RESET ~H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

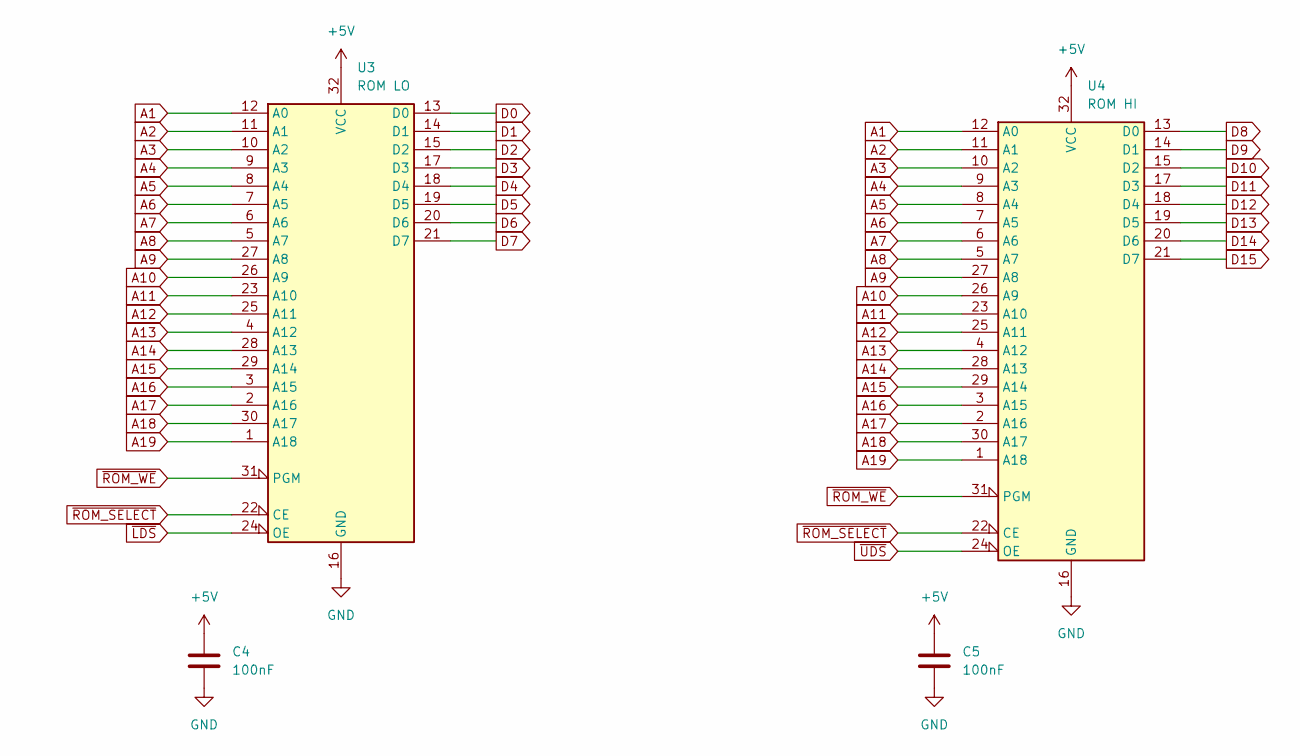
[picture p51: schematic rom.kicad_sch]

Parts:
C4, C5: 100nF; C_Disc_D5.0mm_W2.5mm_P5.00mm
U3: ROM LO; DIP-32_W15.24mm
U4: ROM HI; DIP-32_W15.24mm

Connections:
+5V: C4.1, C5.1, U3.32 (VCC), U4.32 (VCC); also elsewhere on the board
A1: U3.12 (A0), U4.12 (A0); also elsewhere on the board
A2: U3.11 (A1), U4.11 (A1); also elsewhere on the board
A3: U3.10 (A2), U4.10 (A2); also elsewhere on the board
A4: U3.9 (A3), U4.9 (A3); also elsewhere on the board
A5: U3.8 (A4), U4.8 (A4); also elsewhere on the board
A6: U3.7 (A5), U4.7 (A5); also elsewhere on the board
A7: U3.6 (A6), U4.6 (A6); also elsewhere on the board
A8: U3.5 (A7), U4.5 (A7); also elsewhere on the board
A9: U3.27 (A8), U4.27 (A8); also elsewhere on the board
A10: U3.26 (A9), U4.26 (A9); also elsewhere on the board
A11: U3.23 (A10), U4.23 (A10); also elsewhere on the board
A12: U3.25 (A11), U4.25 (A11); also elsewhere on the board
A13: U3.4 (A12), U4.4 (A12); also elsewhere on the board
A14: U3.28 (A13), U4.28 (A13); also elsewhere on the board
A15: U3.29 (A14), U4.29 (A14); also elsewhere on the board
A16: U3.3 (A15), U4.3 (A15); also elsewhere on the board
A17: U3.2 (A16), U4.2 (A16); also elsewhere on the board
A18: U3.30 (A17), U4.30 (A17); also elsewhere on the board
A19: U3.1 (A18), U4.1 (A18); also elsewhere on the board
D0: U3.13 (D0); also elsewhere on the board
D1: U3.14 (D1); also elsewhere on the board
D2: U3.15 (D2); also elsewhere on the board
D3: U3.17 (D3); also elsewhere on the board
D4: U3.18 (D4); also elsewhere on the board
D5: U3.19 (D5); also elsewhere on the board
D6: U3.20 (D6); also elsewhere on the board
D7: U3.21 (D7); also elsewhere on the board
D8: U4.13 (D0); also elsewhere on the board
D9: U4.14 (D1); also elsewhere on the board
D10: U4.15 (D2); also elsewhere on the board
D11: U4.17 (D3); also elsewhere on the board
D12: U4.18 (D4); also elsewhere on the board
D13: U4.19 (D5); also elsewhere on the board
D14: U4.20 (D6); also elsewhere on the board
D15: U4.21 (D7); also elsewhere on the board
GND: C4.2, C5.2, U3.16 (GND), U4.16 (GND); also elsewhere on the board
~LDS: U3.24 (OE); also elsewhere on the board
~ROM_SELECT: U3.22 (CE), U4.22 (CE); also elsewhere on the board
~ROM_WE: U3.31 (PGM), U4.31 (PGM); also elsewhere on the board
~UDS: U4.24 (OE); also elsewhere on the board

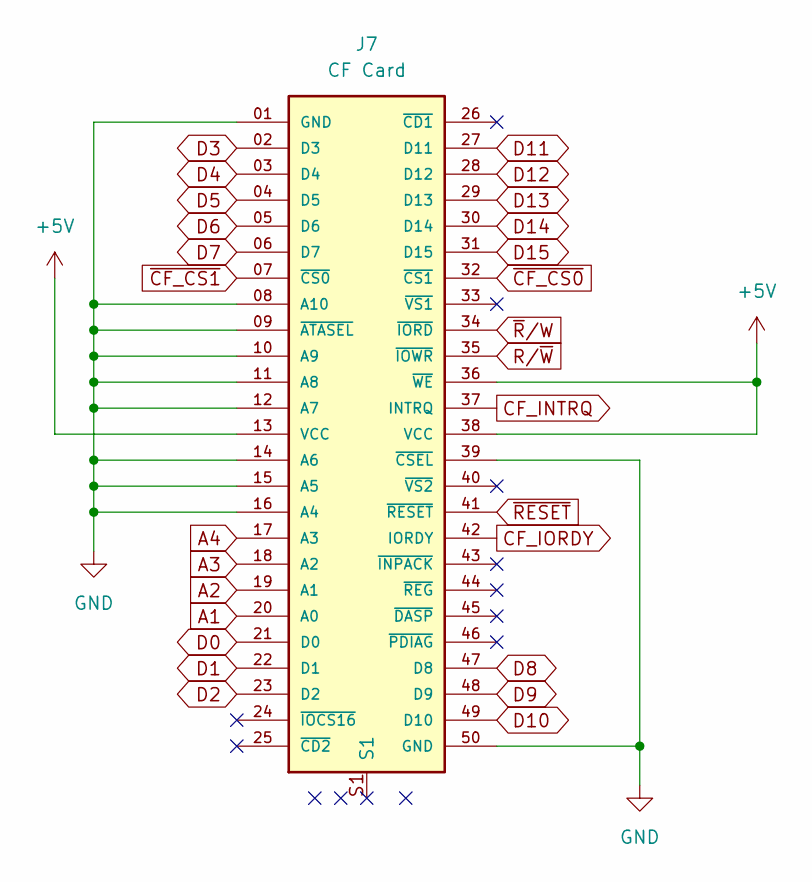
[picture p52: schematic compact-flash.kicad_sch]

Parts:
J7: CF Card; SAMTEC_CFT-125-01-L-D-RA-01-SL; PARTREV A

Connections:
+5V: J7.13 (VCC), J7.36 (~WE), J7.38 (VCC); also elsewhere on the board
A1: J7.20 (A0); also elsewhere on the board
A2: J7.19 (A1); also elsewhere on the board
A3: J7.18 (A2); also elsewhere on the board
A4: J7.17 (A3); also elsewhere on the board
CF_INTRQ: J7.37 (INTRQ); also elsewhere on the board
CF_IORDY: J7.42 (IORDY); also elsewhere on the board
D0: J7.21 (D0); also elsewhere on the board
D1: J7.22 (D1); also elsewhere on the board
D2: J7.23 (D2); also elsewhere on the board
D3: J7.02 (D3); also elsewhere on the board
D4: J7.03 (D4); also elsewhere on the board
D5: J7.04 (D5); also elsewhere on the board
D6: J7.05 (D6); also elsewhere on the board
D7: J7.06 (D7); also elsewhere on the board
D8: J7.47 (D8); also elsewhere on the board
D9: J7.48 (D9); also elsewhere on the board
D10: J7.49 (D10); also elsewhere on the board
D11: J7.27 (D11); also elsewhere on the board
D12: J7.28 (D12); also elsewhere on the board
D13: J7.29 (D13); also elsewhere on the board
D14: J7.30 (D14); also elsewhere on the board
D15: J7.31 (D15); also elsewhere on the board
GND: J7.01 (GND), J7.08 (A10), J7.09 (~ATASEL), J7.10 (A9), J7.11 (A8), J7.12 (A7), J7.14 (A6), J7.15 (A5), J7.16 (A4), J7.39 (~CSEL), J7.50 (GND); also elsewhere on the board
R/~W: J7.35 (~IOWR); also elsewhere on the board
S2: J7.S2
S3: J7.S3
S4: J7.S4
~CF_CS0: J7.32 (~CS1); also elsewhere on the board
~CF_CS1: J7.07 (~CS0); also elsewhere on the board
~RESET: J7.41 (~RESET); also elsewhere on the board
~R/W: J7.34 (~IORD); also elsewhere on the board

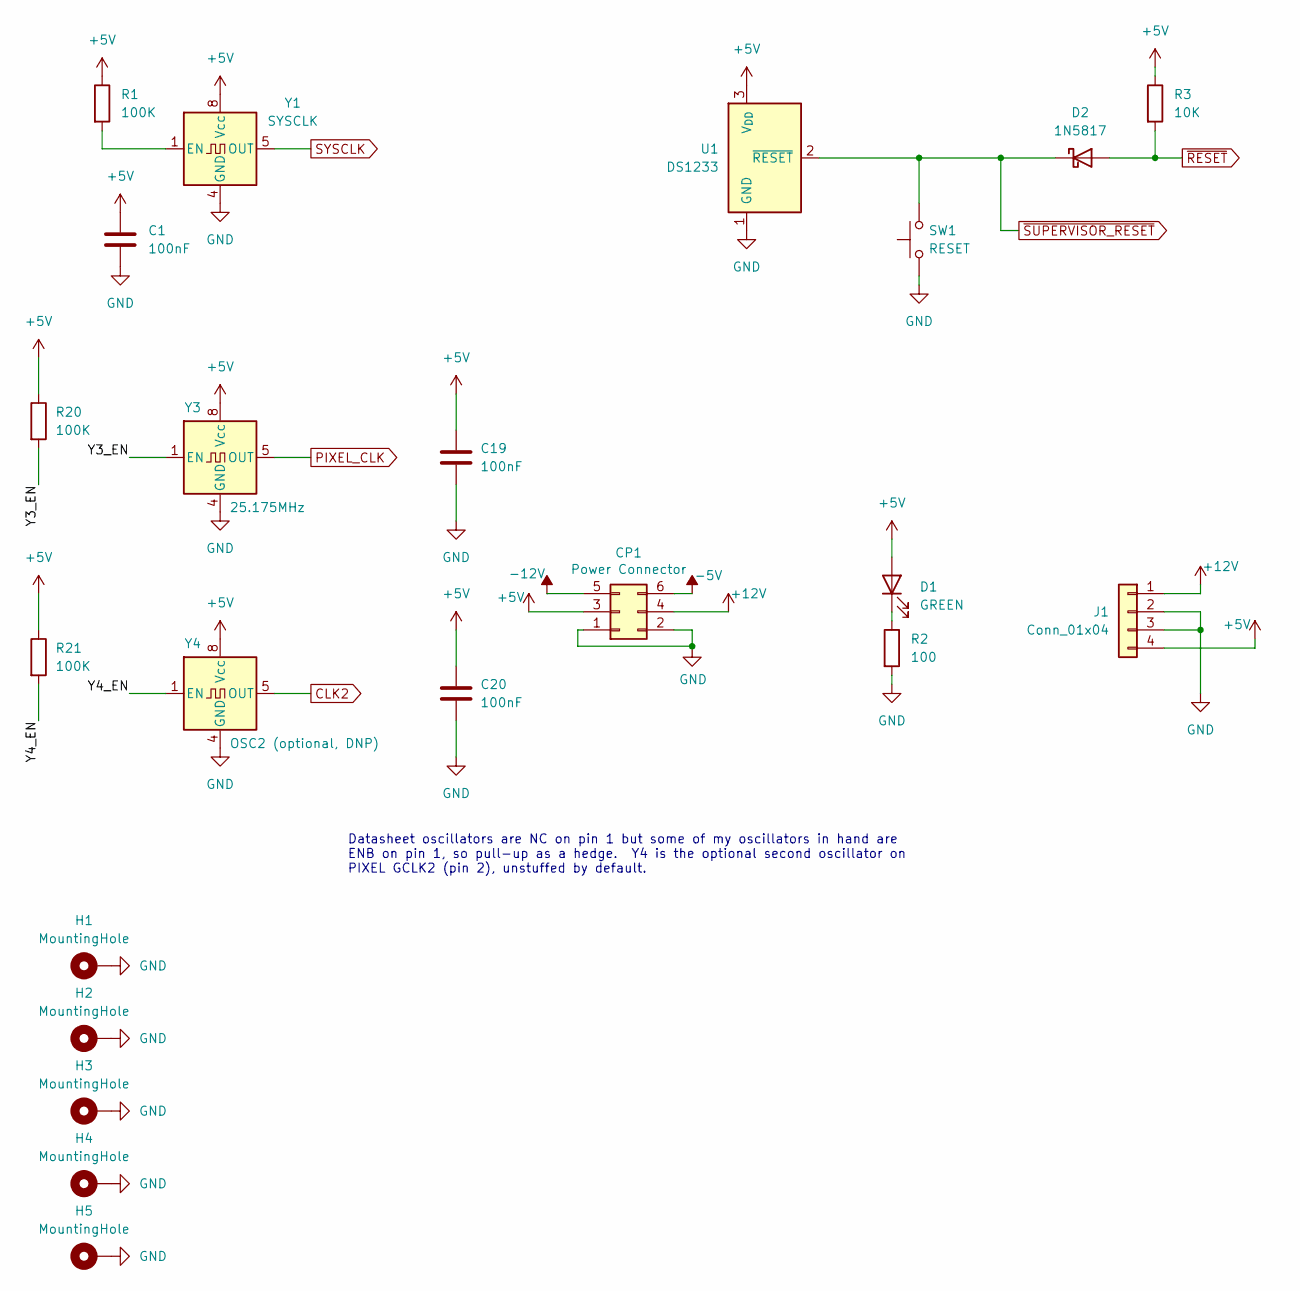
[picture p53: schematic power-clock.kicad_sch]

Parts:
C1, C19, C20: 100nF; C_Disc_D5.0mm_W2.5mm_P5.00mm
CP1: Power Connector; POWER; DigiKey A14226-ND
D1: GREEN; LED_D3.0mm
D2: 1N5817; D_DO-41_SOD81_P10.16mm_Horizontal
H1, H2, H3, H4, H5: MountingHole; MountingHole_2.5mm_Pad_Via
J1: Conn_01x04
R1, R20, R21: 100K; R_Axial_DIN0207_L6.3mm_D2.5mm_P10.16mm_Horizontal
R2: 100; R_Axial_DIN0207_L6.3mm_D2.5mm_P10.16mm_Horizontal
R3: 10K; R_Axial_DIN0207_L6.3mm_D2.5mm_P10.16mm_Horizontal
SW1: RESET; SW_TH_Tactile_Omron_B3F-106x
U1: DS1233
Y1: SYSCLK; Oscillator_DIP-8
Y3: 25.175MHz; Oscillator_DIP-8
Y4: OSC2 (optional, DNP); Oscillator_DIP-8

Connections:
+5V: C1.1, C19.1, C20.1, CP1.3, D1.2 (A), J1.4, R1.1, R3.1, R20.1, R21.1, U1.3 (V_{DD}), Y1.8 (Vcc), Y3.8 (Vcc), Y4.8 (Vcc); also elsewhere on the board
/POWER_CLOCK_RESET/Y3_EN: R20.2, Y3.1 (EN)
/POWER_CLOCK_RESET/Y4_EN: R21.2, Y4.1 (EN)
CLK2: Y4.5 (OUT); also elsewhere on the board
GND: C1.2, C19.2, C20.2, CP1.1, CP1.2, H1.1, H2.1, H3.1, H4.1, H5.1, J1.2, J1.3, R2.2, SW1.1, U1.1 (GND), Y1.4 (GND), Y3.4 (GND), Y4.4 (GND); also elsewhere on the board
unnamed: CP1.4, J1.1
unnamed: D1.1 (K), R2.1
unnamed: R1.2, Y1.1 (EN)
PIXEL_CLK: Y3.5 (OUT); also elsewhere on the board
SYSCLK: Y1.5 (OUT); also elsewhere on the board
~RESET: D2.2 (A), R3.2; also elsewhere on the board
~SUPERVISOR_RESET: D2.1 (K), SW1.2, U1.2 (~RESET); also elsewhere on the board

Notes on the sheet:
Datasheet oscillators are NC on pin 1 but some of my oscillators in hand are ENB on pin 1, so pull-up as a hedge. Y4 is the optional second oscillator on PIXEL GCLK2 (pin 2), unstuffed by default.
