bradgrantham/griffin/board/board.kicad_pcb

## KiCad design board/board.kicad_pcb (continued)

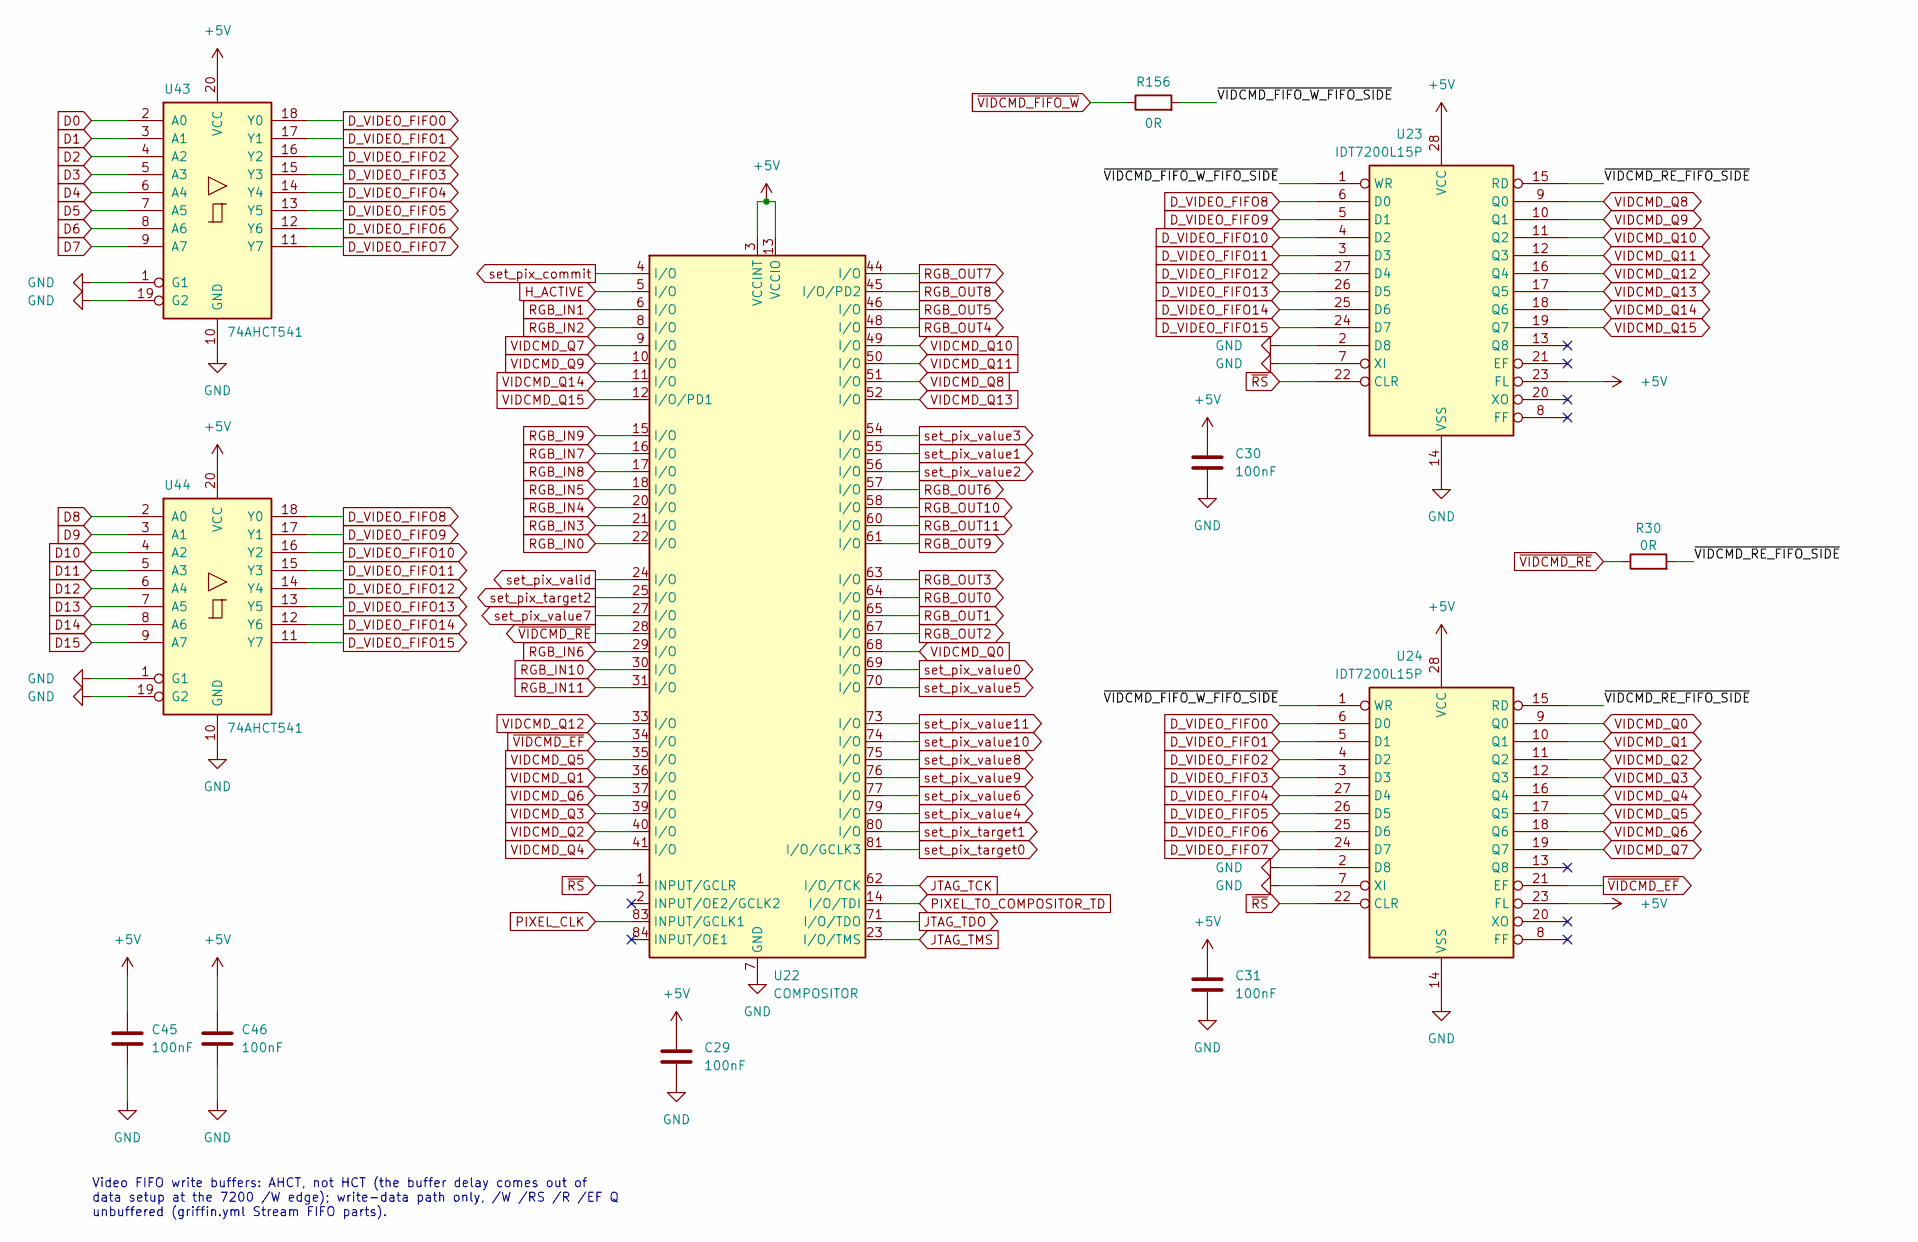
[picture p54: schematic compositor.kicad_sch]

Parts:
C29, C30, C31, C45, C46: 100nF; C_Disc_D5.0mm_W2.5mm_P5.00mm
R30, R156: 0R; R_Axial_DIN0207_L6.3mm_D2.5mm_P10.16mm_Horizontal
U22: COMPOSITOR; PLCC-84_THT-Socket
U23, U24: IDT7200L15P; DIP-28_W7.62mm
U43, U44: 74AHCT541; DIP-20_W7.62mm

Connections:
+5V: C29.1, C30.1, C31.1, C45.1, C46.1, U22.3 (VCCINT), U22.13 (VCCIO), U22.26 (VCCIO), U22.38 (VCCIO), U22.43 (VCCINT), U22.53 (VCCIO), U22.66 (VCCIO), U22.78 (VCCIO), U23.23 (FL), U23.28 (VCC), U24.23 (FL), U24.28 (VCC), U43.20 (VCC), U44.20 (VCC); also elsewhere on the board
/COMPOSITOR/~VIDCMD_FIFO_W_FIFO_SIDE: R156.2, U23.1 (WR), U24.1 (WR)
/COMPOSITOR/~VIDCMD_RE_FIFO_SIDE: R30.2, U23.15 (RD), U24.15 (RD)
D0: U43.2 (A0); also elsewhere on the board
D1: U43.3 (A1); also elsewhere on the board
D2: U43.4 (A2); also elsewhere on the board
D3: U43.5 (A3); also elsewhere on the board
D4: U43.6 (A4); also elsewhere on the board
D5: U43.7 (A5); also elsewhere on the board
D6: U43.8 (A6); also elsewhere on the board
D7: U43.9 (A7); also elsewhere on the board
D8: U44.2 (A0); also elsewhere on the board
D9: U44.3 (A1); also elsewhere on the board
D10: U44.4 (A2); also elsewhere on the board
D11: U44.5 (A3); also elsewhere on the board
D12: U44.6 (A4); also elsewhere on the board
D13: U44.7 (A5); also elsewhere on the board
D14: U44.8 (A6); also elsewhere on the board
D15: U44.9 (A7); also elsewhere on the board
D_VIDEO_FIFO0: U24.6 (D0), U43.18 (Y0); also elsewhere on the board
D_VIDEO_FIFO1: U24.5 (D1), U43.17 (Y1); also elsewhere on the board
D_VIDEO_FIFO2: U24.4 (D2), U43.16 (Y2); also elsewhere on the board
D_VIDEO_FIFO3: U24.3 (D3), U43.15 (Y3); also elsewhere on the board
D_VIDEO_FIFO4: U24.27 (D4), U43.14 (Y4); also elsewhere on the board
D_VIDEO_FIFO5: U24.26 (D5), U43.13 (Y5); also elsewhere on the board
D_VIDEO_FIFO6: U24.25 (D6), U43.12 (Y6); also elsewhere on the board
D_VIDEO_FIFO7: U24.24 (D7), U43.11 (Y7); also elsewhere on the board
D_VIDEO_FIFO8: U23.6 (D0), U44.18 (Y0); also elsewhere on the board
D_VIDEO_FIFO9: U23.5 (D1), U44.17 (Y1); also elsewhere on the board
D_VIDEO_FIFO10: U23.4 (D2), U44.16 (Y2); also elsewhere on the board
D_VIDEO_FIFO11: U23.3 (D3), U44.15 (Y3); also elsewhere on the board
D_VIDEO_FIFO12: U23.27 (D4), U44.14 (Y4); also elsewhere on the board
D_VIDEO_FIFO13: U23.26 (D5), U44.13 (Y5); also elsewhere on the board
D_VIDEO_FIFO14: U23.25 (D6), U44.12 (Y6); also elsewhere on the board
D_VIDEO_FIFO15: U23.24 (D7), U44.11 (Y7); also elsewhere on the board
GND: C29.2, C30.2, C31.2, C45.2, C46.2, U22.7 (GND), U22.19 (GND), U22.32 (GND), U22.42 (GND), U22.47 (GND), U22.59 (GND), U22.72 (GND), U22.82 (GND), U23.2 (D8), U23.7 (XI), U23.14 (VSS), U24.2 (D8), U24.7 (XI), U24.14 (VSS), U43.1 (G1), U43.10 (GND), U43.19 (G2), U44.1 (G1), U44.10 (GND), U44.19 (G2); also elsewhere on the board
H_ACTIVE: U22.5 (I/O); also elsewhere on the board
JTAG_TCK: U22.62 (I/O/TCK); also elsewhere on the board
JTAG_TDO: U22.71 (I/O/TDO); also elsewhere on the board
JTAG_TMS: U22.23 (I/O/TMS); also elsewhere on the board
PIXEL_CLK: U22.83 (INPUT/GCLK1); also elsewhere on the board
PIXEL_TO_COMPOSITOR_TD: U22.14 (I/O/TDI); also elsewhere on the board
RGB_IN0: U22.22 (I/O); also elsewhere on the board
RGB_IN1: U22.6 (I/O); also elsewhere on the board
RGB_IN2: U22.8 (I/O); also elsewhere on the board
RGB_IN3: U22.21 (I/O); also elsewhere on the board
RGB_IN4: U22.20 (I/O); also elsewhere on the board
RGB_IN5: U22.18 (I/O); also elsewhere on the board
RGB_IN6: U22.29 (I/O); also elsewhere on the board
RGB_IN7: U22.16 (I/O); also elsewhere on the board
RGB_IN8: U22.17 (I/O); also elsewhere on the board
RGB_IN9: U22.15 (I/O); also elsewhere on the board
RGB_IN10: U22.30 (I/O); also elsewhere on the board
RGB_IN11: U22.31 (I/O); also elsewhere on the board
RGB_OUT0: U22.64 (I/O); also elsewhere on the board
RGB_OUT1: U22.65 (I/O); also elsewhere on the board
RGB_OUT2: U22.67 (I/O); also elsewhere on the board
RGB_OUT3: U22.63 (I/O); also elsewhere on the board
RGB_OUT4: U22.48 (I/O); also elsewhere on the board
RGB_OUT5: U22.46 (I/O); also elsewhere on the board
RGB_OUT6: U22.57 (I/O); also elsewhere on the board
RGB_OUT7: U22.44 (I/O); also elsewhere on the board
RGB_OUT8: U22.45 (I/O/PD2); also elsewhere on the board
RGB_OUT9: U22.61 (I/O); also elsewhere on the board
RGB_OUT10: U22.58 (I/O); also elsewhere on the board
RGB_OUT11: U22.60 (I/O); also elsewhere on the board
VIDCMD_Q0: U22.68 (I/O), U24.9 (Q0)
VIDCMD_Q1: U22.36 (I/O), U24.10 (Q1)
VIDCMD_Q2: U22.40 (I/O), U24.11 (Q2)
VIDCMD_Q3: U22.39 (I/O), U24.12 (Q3)
VIDCMD_Q4: U22.41 (I/O), U24.16 (Q4)
VIDCMD_Q5: U22.35 (I/O), U24.17 (Q5)
VIDCMD_Q6: U22.37 (I/O), U24.18 (Q6)
VIDCMD_Q7: U22.9 (I/O), U24.19 (Q7)
VIDCMD_Q8: U22.51 (I/O), U23.9 (Q0)
VIDCMD_Q9: U22.10 (I/O), U23.10 (Q1)
VIDCMD_Q10: U22.49 (I/O), U23.11 (Q2)
VIDCMD_Q11: U22.50 (I/O), U23.12 (Q3)
VIDCMD_Q12: U22.33 (I/O), U23.16 (Q4)
VIDCMD_Q13: U22.52 (I/O), U23.17 (Q5)
VIDCMD_Q14: U22.11 (I/O), U23.18 (Q6)
VIDCMD_Q15: U22.12 (I/O/PD1), U23.19 (Q7)
set_pix_commit: U22.4 (I/O); also elsewhere on the board
set_pix_target0: U22.81 (I/O/GCLK3); also elsewhere on the board
set_pix_target1: U22.80 (I/O); also elsewhere on the board
set_pix_target2: U22.25 (I/O); also elsewhere on the board
set_pix_valid: U22.24 (I/O); also elsewhere on the board
set_pix_value0: U22.69 (I/O); also elsewhere on the board
set_pix_value1: U22.55 (I/O); also elsewhere on the board
set_pix_value2: U22.56 (I/O); also elsewhere on the board
set_pix_value3: U22.54 (I/O); also elsewhere on the board
set_pix_value4: U22.79 (I/O); also elsewhere on the board
set_pix_value5: U22.70 (I/O); also elsewhere on the board
set_pix_value6: U22.77 (I/O); also elsewhere on the board
set_pix_value7: U22.27 (I/O); also elsewhere on the board
set_pix_value8: U22.75 (I/O); also elsewhere on the board
set_pix_value9: U22.76 (I/O); also elsewhere on the board
set_pix_value10: U22.74 (I/O); also elsewhere on the board
set_pix_value11: U22.73 (I/O); also elsewhere on the board
~RS: U22.1 (INPUT/GCLR), U23.22 (CLR), U24.22 (CLR); also elsewhere on the board
~VIDCMD_EF: U22.34 (I/O), U24.21 (EF)
~VIDCMD_FIFO_W: R156.1; also elsewhere on the board
~VIDCMD_RE: R30.1, U22.28 (I/O)

Notes on the sheet:
Video FIFO write buffers: AHCT, not HCT (the buffer delay comes out of data setup at the 7200 /W edge); write-data path only, /W /RS /R /EF Q unbuffered (griffin.yml Stream FIFO parts).

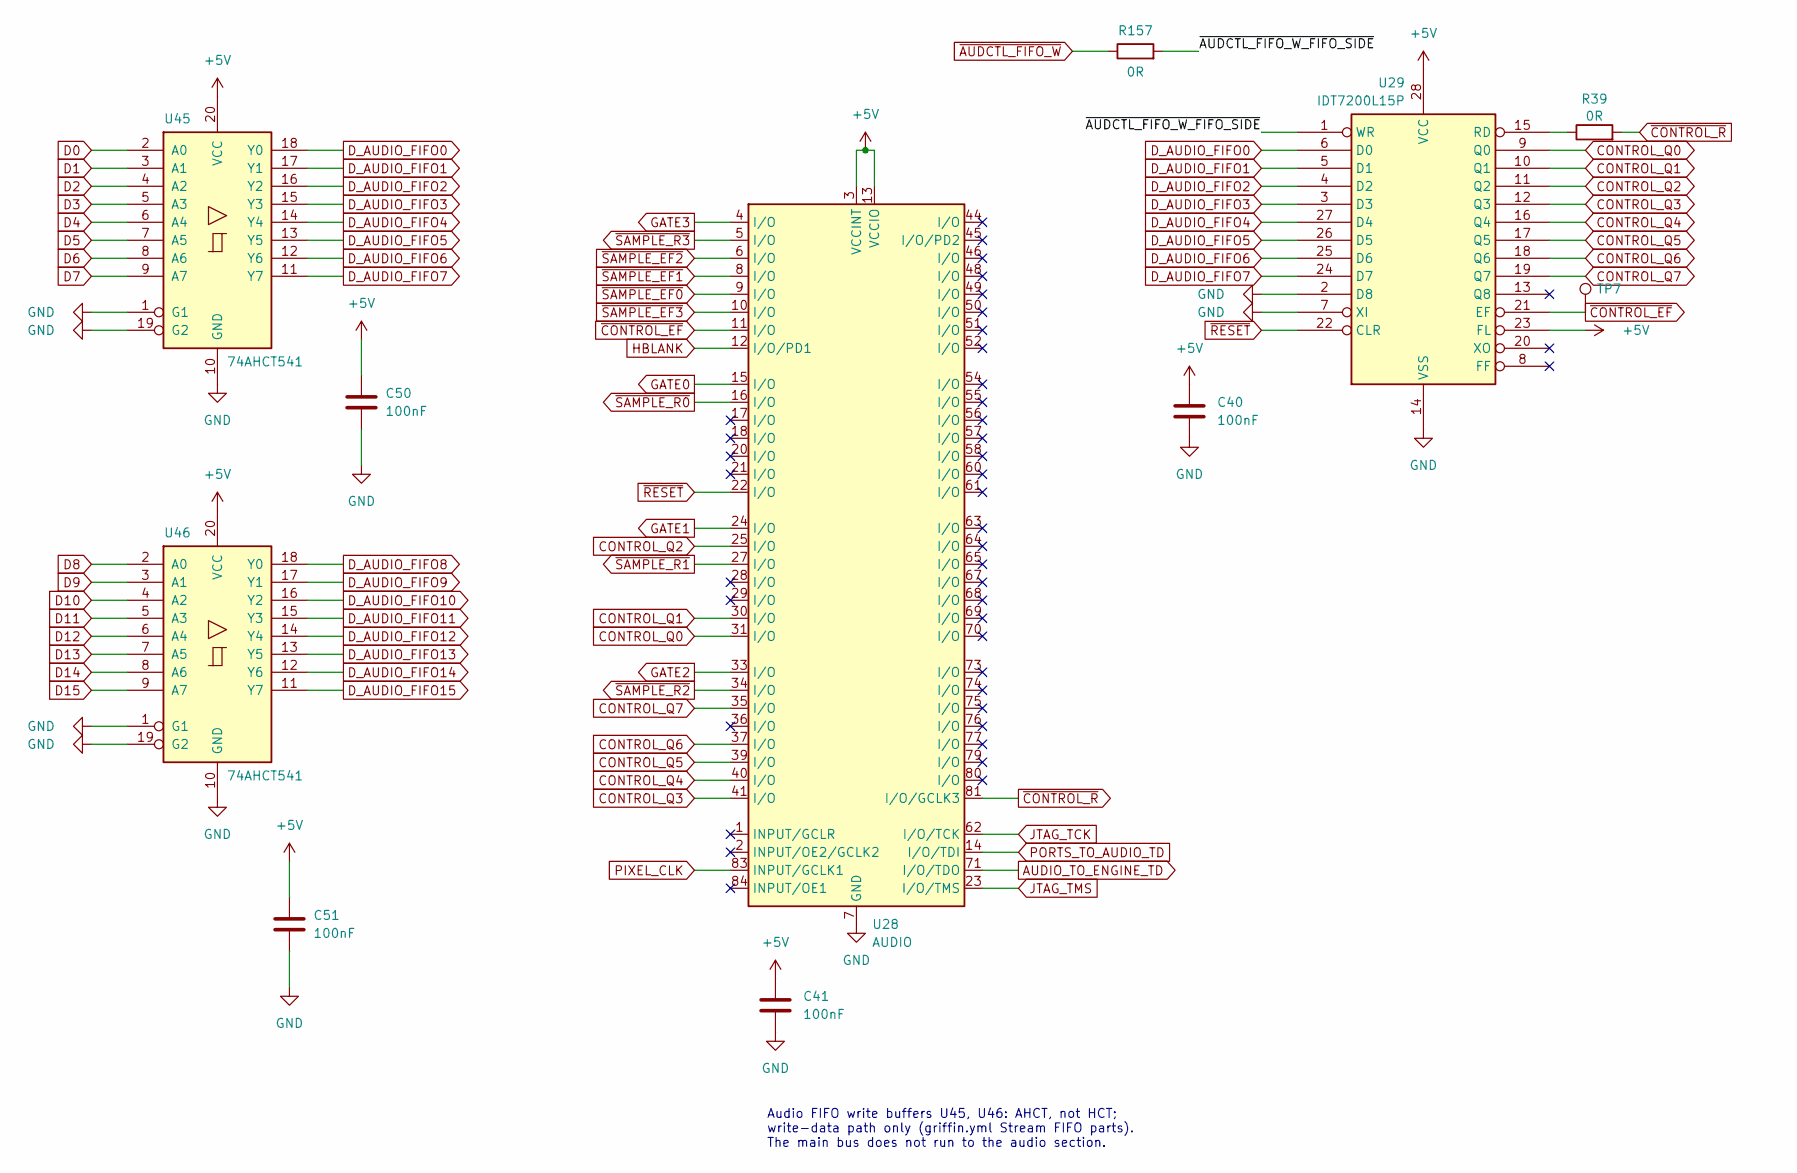
[picture p55: schematic audio.kicad_sch]

Parts:
C40, C41, C50, C51: 100nF; C_Disc_D5.0mm_W2.5mm_P5.00mm
R39, R157: 0R; R_Axial_DIN0207_L6.3mm_D2.5mm_P10.16mm_Horizontal
TP7: TestPoint; TestPoint_Pad_D1.5mm
U28: AUDIO; PLCC-84_THT-Socket
U29: IDT7200L15P; DIP-28_W7.62mm
U45, U46: 74AHCT541; DIP-20_W7.62mm

Connections:
+5V: C40.1, C41.1, C50.1, C51.1, U28.3 (VCCINT), U28.13 (VCCIO), U28.26 (VCCIO), U28.38 (VCCIO), U28.43 (VCCINT), U28.53 (VCCIO), U28.66 (VCCIO), U28.78 (VCCIO), U29.23 (FL), U29.28 (VCC), U45.20 (VCC), U46.20 (VCC); also elsewhere on the board
/AUDIO/~AUDCTL_FIFO_W_FIFO_SIDE: R157.2, U29.1 (WR)
AUDIO_TO_ENGINE_TD: U28.71 (I/O/TDO); also elsewhere on the board
CONTROL_Q0: U28.31 (I/O), U29.9 (Q0)
CONTROL_Q1: U28.30 (I/O), U29.10 (Q1)
CONTROL_Q2: U28.25 (I/O), U29.11 (Q2)
CONTROL_Q3: U28.41 (I/O), U29.12 (Q3)
CONTROL_Q4: U28.40 (I/O), U29.16 (Q4)
CONTROL_Q5: U28.39 (I/O), U29.17 (Q5)
CONTROL_Q6: U28.37 (I/O), U29.18 (Q6)
CONTROL_Q7: U28.35 (I/O), U29.19 (Q7)
D0: U45.2 (A0); also elsewhere on the board
D1: U45.3 (A1); also elsewhere on the board
D2: U45.4 (A2); also elsewhere on the board
D3: U45.5 (A3); also elsewhere on the board
D4: U45.6 (A4); also elsewhere on the board
D5: U45.7 (A5); also elsewhere on the board
D6: U45.8 (A6); also elsewhere on the board
D7: U45.9 (A7); also elsewhere on the board
D8: U46.2 (A0); also elsewhere on the board
D9: U46.3 (A1); also elsewhere on the board
D10: U46.4 (A2); also elsewhere on the board
D11: U46.5 (A3); also elsewhere on the board
D12: U46.6 (A4); also elsewhere on the board
D13: U46.7 (A5); also elsewhere on the board
D14: U46.8 (A6); also elsewhere on the board
D15: U46.9 (A7); also elsewhere on the board
D_AUDIO_FIFO0: U29.6 (D0), U45.18 (Y0); also elsewhere on the board
D_AUDIO_FIFO1: U29.5 (D1), U45.17 (Y1); also elsewhere on the board
D_AUDIO_FIFO2: U29.4 (D2), U45.16 (Y2); also elsewhere on the board
D_AUDIO_FIFO3: U29.3 (D3), U45.15 (Y3); also elsewhere on the board
D_AUDIO_FIFO4: U29.27 (D4), U45.14 (Y4); also elsewhere on the board
D_AUDIO_FIFO5: U29.26 (D5), U45.13 (Y5); also elsewhere on the board
D_AUDIO_FIFO6: U29.25 (D6), U45.12 (Y6); also elsewhere on the board
D_AUDIO_FIFO7: U29.24 (D7), U45.11 (Y7); also elsewhere on the board
D_AUDIO_FIFO8: U46.18 (Y0); also elsewhere on the board
D_AUDIO_FIFO9: U46.17 (Y1); also elsewhere on the board
D_AUDIO_FIFO10: U46.16 (Y2); also elsewhere on the board
D_AUDIO_FIFO11: U46.15 (Y3); also elsewhere on the board
D_AUDIO_FIFO12: U46.14 (Y4); also elsewhere on the board
D_AUDIO_FIFO13: U46.13 (Y5); also elsewhere on the board
D_AUDIO_FIFO14: U46.12 (Y6); also elsewhere on the board
D_AUDIO_FIFO15: U46.11 (Y7); also elsewhere on the board
GATE0: U28.15 (I/O); also elsewhere on the board
GATE1: U28.24 (I/O); also elsewhere on the board
GATE2: U28.33 (I/O); also elsewhere on the board
GATE3: U28.4 (I/O); also elsewhere on the board
GND: C40.2, C41.2, C50.2, C51.2, U28.7 (GND), U28.19 (GND), U28.32 (GND), U28.42 (GND), U28.47 (GND), U28.59 (GND), U28.72 (GND), U28.82 (GND), U29.2 (D8), U29.7 (XI), U29.14 (VSS), U45.1 (G1), U45.10 (GND), U45.19 (G2), U46.1 (G1), U46.10 (GND), U46.19 (G2); also elsewhere on the board
HBLANK: U28.12 (I/O/PD1); also elsewhere on the board
JTAG_TCK: U28.62 (I/O/TCK); also elsewhere on the board
JTAG_TMS: U28.23 (I/O/TMS); also elsewhere on the board
unnamed: R39.1, U29.15 (RD)
PIXEL_CLK: U28.83 (INPUT/GCLK1); also elsewhere on the board
PORTS_TO_AUDIO_TD: U28.14 (I/O/TDI); also elsewhere on the board
~AUDCTL_FIFO_W: R157.1; also elsewhere on the board
~CONTROL_EF: TP7.1, U28.11 (I/O), U29.21 (EF)
~CONTROL_R: R39.2, U28.81 (I/O/GCLK3)
~RESET: U28.22 (I/O), U29.22 (CLR); also elsewhere on the board
~SAMPLE_EF0: U28.9 (I/O); also elsewhere on the board
~SAMPLE_EF1: U28.8 (I/O); also elsewhere on the board
~SAMPLE_EF2: U28.6 (I/O); also elsewhere on the board
~SAMPLE_EF3: U28.10 (I/O); also elsewhere on the board
~SAMPLE_R0: U28.16 (I/O); also elsewhere on the board
~SAMPLE_R1: U28.27 (I/O); also elsewhere on the board
~SAMPLE_R2: U28.34 (I/O); also elsewhere on the board
~SAMPLE_R3: U28.5 (I/O); also elsewhere on the board

Notes on the sheet:
Audio FIFO write buffers U45, U46: AHCT, not HCT; write-data path only (griffin.yml Stream FIFO parts). The main bus does not run to the audio section.

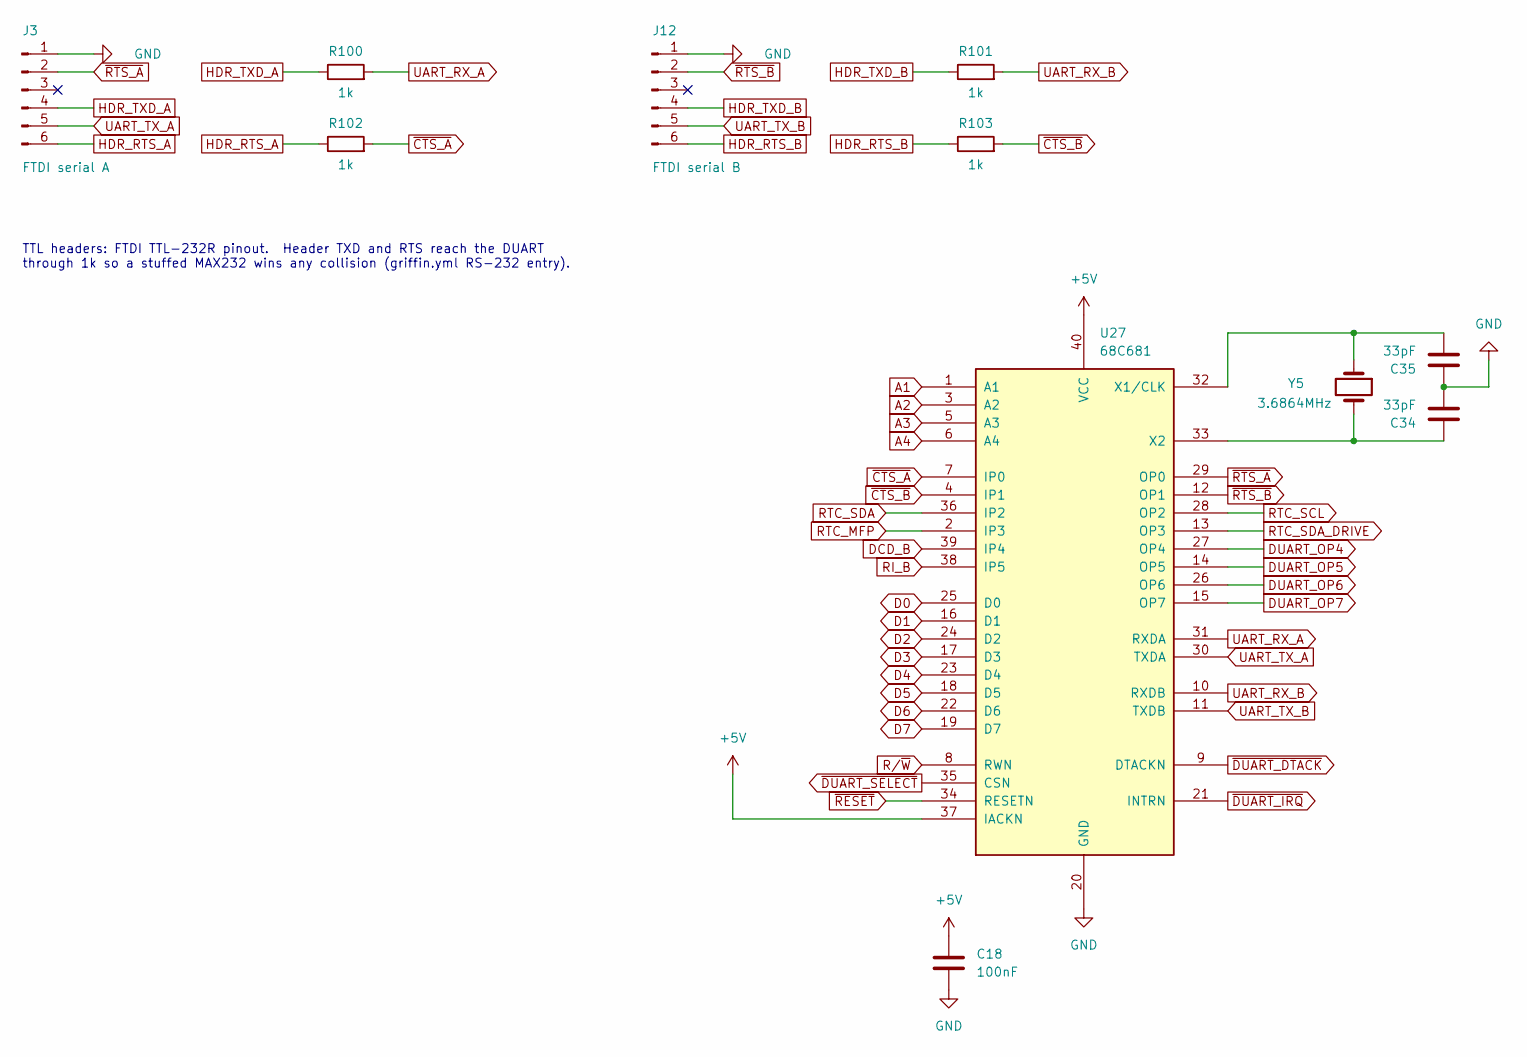
[picture p56: schematic io.kicad_sch]

Parts:
C18: 100nF; C_Disc_D5.0mm_W2.5mm_P5.00mm
C34, C35: 33pF; C_Disc_D3.0mm_W1.6mm_P2.50mm
J3: FTDI serial A; PinHeader_1x06_P2.54mm_Vertical
J12: FTDI serial B; PinHeader_1x06_P2.54mm_Vertical
R100, R101, R102, R103: 1k; R_Axial_DIN0207_L6.3mm_D2.5mm_P10.16mm_Horizontal
U27: 68C681
Y5: 3.6864MHz; Resonator-2Pin_W10.0mm_H5.0mm

Connections:
+5V: C18.1, U27.37 (IACKN), U27.40 (VCC); also elsewhere on the board
GND: C18.2, C34.2, C35.1, J3.1, J12.1, U27.20 (GND); also elsewhere on the board
HDR_RTS_A: J3.6, R102.1
HDR_RTS_B: J12.6, R103.1
HDR_TXD_A: J3.4, R100.1
HDR_TXD_B: J12.4, R101.1
unnamed: C35.2, U27.32 (X1/CLK), Y5.1
unnamed: C34.1, U27.33 (X2), Y5.2
UART_RX_A: R100.2, U27.31 (RXDA); also elsewhere on the board
UART_RX_B: R101.2, U27.10 (RXDB); also elsewhere on the board
UART_TX_A: J3.5, U27.30 (TXDA); also elsewhere on the board
UART_TX_B: J12.5, U27.11 (TXDB); also elsewhere on the board
~CTS_A: R102.2, U27.7 (IP0); also elsewhere on the board
~CTS_B: R103.2, U27.4 (IP1); also elsewhere on the board
~RTS_A: J3.2, U27.29 (OP0); also elsewhere on the board
~RTS_B: J12.2, U27.12 (OP1); also elsewhere on the board

Notes on the sheet:
TTL headers: FTDI TTL-232R pinout. Header TXD and RTS reach the DUART through 1k so a stuffed MAX232 wins any collision (griffin.yml RS-232 entry).

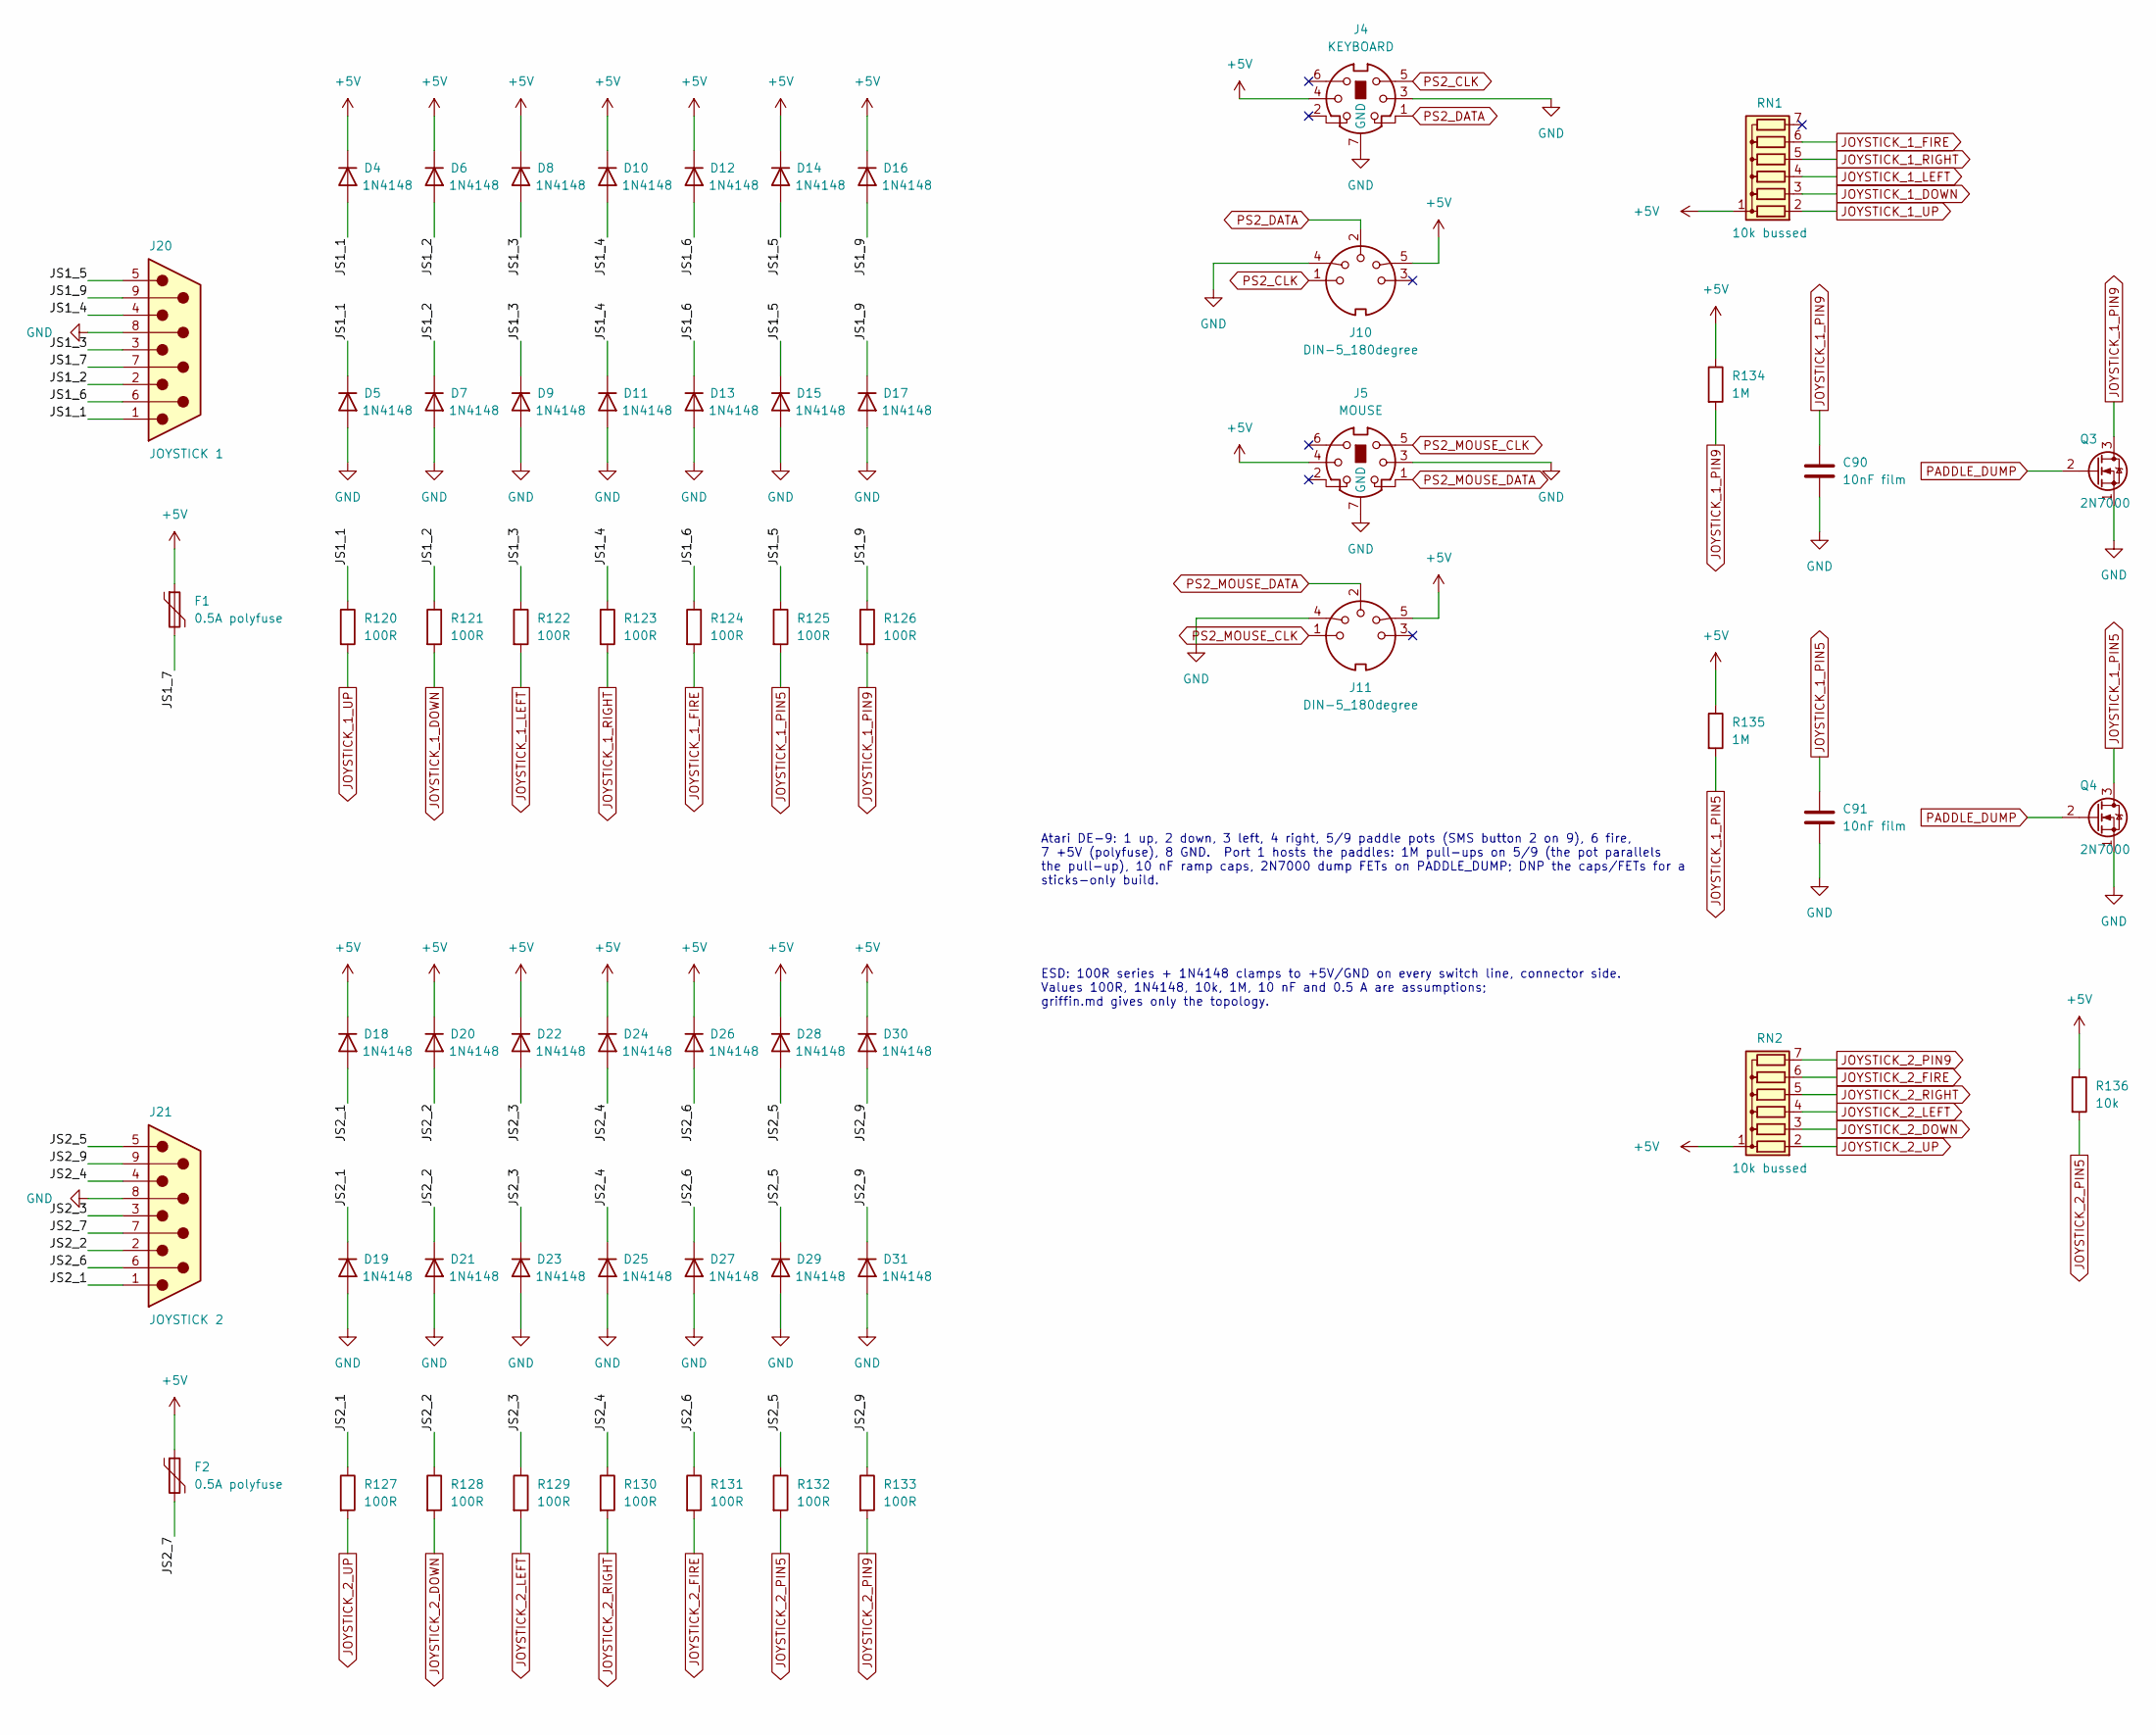
[picture p57: schematic panel.kicad_sch]

Parts:
C90, C91: 10nF film; C_Rect_L7.2mm_W2.5mm_P5.00mm
D4, D5, D6, D7, D8, D9, D10, D11, D12, D13, D14, D15, D16, D17, D18, D19, D20, D21, D22, D23, D24, D25, D26, D27, D28, D29, D30, D31: 1N4148; D_DO-35_SOD27_P7.62mm_Horizontal
F1, F2: 0.5A polyfuse; Fuse_Bourns_MF-RHT050
J4: KEYBOARD; Mini_din6
J5: MOUSE; Mini_din6
J10, J11: DIN-5_180degree
J20: JOYSTICK 1; DSUB-9_Pins_Horizontal_P2.77x2.84mm_EdgePinOffset4.94mm_Hou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
J21: JOYSTICK 2; DSUB-9_Pins_Horizontal_P2.77x2.84mm_EdgePinOffset4.94mm_Hou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
Q3, Q4: 2N7000; TO-92_Inline
R120, R121, R122, R123, R124, R125, R126, R127, R128, R129, R130, R131, R132, R133: 100R; R_Axial_DIN0207_L6.3mm_D2.5mm_P10.16mm_Horizontal
R134, R135: 1M; R_Axial_DIN0207_L6.3mm_D2.5mm_P10.16mm_Horizontal
R136: 10k; R_Axial_DIN0207_L6.3mm_D2.5mm_P10.16mm_Horizontal
RN1, RN2: 10k bussed; R_Array_SIP7

Connections:
+5V: D4.1 (K), D6.1 (K), D8.1 (K), D10.1 (K), D12.1 (K), D14.1 (K), D16.1 (K), D18.1 (K), D20.1 (K), D22.1 (K), D24.1 (K), D26.1 (K), D28.1 (K), D30.1 (K), F1.1, F2.1, J4.4, J5.4, J10.5, J11.5, R134.1, R135.1, R136.1, RN1.1 (common), RN2.1 (common); also elsewhere on the board
/PANEL/JS1_1: D4.2 (A), D5.1 (K), J20.1, R120.1
/PANEL/JS1_2: D6.2 (A), D7.1 (K), J20.2, R121.1
/PANEL/JS1_3: D8.2 (A), D9.1 (K), J20.3, R122.1
/PANEL/JS1_4: D10.2 (A), D11.1 (K), J20.4, R123.1
/PANEL/JS1_5: D14.2 (A), D15.1 (K), J20.5, R125.1
/PANEL/JS1_6: D12.2 (A), D13.1 (K), J20.6, R124.1
/PANEL/JS1_7: F1.2, J20.7
/PANEL/JS1_9: D16.2 (A), D17.1 (K), J20.9, R126.1
/PANEL/JS2_1: D18.2 (A), D19.1 (K), J21.1, R127.1
/PANEL/JS2_2: D20.2 (A), D21.1 (K), J21.2, R128.1
/PANEL/JS2_3: D22.2 (A), D23.1 (K), J21.3, R129.1
/PANEL/JS2_4: D24.2 (A), D25.1 (K), J21.4, R130.1
/PANEL/JS2_5: D28.2 (A), D29.1 (K), J21.5, R132.1
/PANEL/JS2_6: D26.2 (A), D27.1 (K), J21.6, R131.1
/PANEL/JS2_7: F2.2, J21.7
/PANEL/JS2_9: D30.2 (A), D31.1 (K), J21.9, R133.1
GND: C90.2, C91.2, D5.2 (A), D7.2 (A), D9.2 (A), D11.2 (A), D13.2 (A), D15.2 (A), D17.2 (A), D19.2 (A), D21.2 (A), D23.2 (A), D25.2 (A), D27.2 (A), D29.2 (A), D31.2 (A), J4.3, J4.7 (GND), J5.3, J5.7 (GND), J10.4, J11.4, J20.8, J21.8, Q3.1 (S), Q4.1 (S); also elsewhere on the board
JOYSTICK_1_DOWN: R121.2, RN1.3 (R2); also elsewhere on the board
JOYSTICK_1_FIRE: R124.2, RN1.6 (R5); also elsewhere on the board
JOYSTICK_1_LEFT: R122.2, RN1.4 (R3); also elsewhere on the board
JOYSTICK_1_PIN5: C91.1, Q4.3 (D), R125.2, R135.2; also elsewhere on the board
JOYSTICK_1_PIN9: C90.1, Q3.3 (D), R126.2, R134.2; also elsewhere on the board
JOYSTICK_1_RIGHT: R123.2, RN1.5 (R4); also elsewhere on the board
JOYSTICK_1_UP: R120.2, RN1.2 (R1); also elsewhere on the board
JOYSTICK_2_DOWN: R128.2, RN2.3 (R2); also elsewhere on the board
JOYSTICK_2_FIRE: R131.2, RN2.6 (R5); also elsewhere on the board
JOYSTICK_2_LEFT: R129.2, RN2.4 (R3); also elsewhere on the board
JOYSTICK_2_PIN5: R132.2, R136.2; also elsewhere on the board
JOYSTICK_2_PIN9: R133.2, RN2.7 (R6); also elsewhere on the board
JOYSTICK_2_RIGHT: R130.2, RN2.5 (R4); also elsewhere on the board
JOYSTICK_2_UP: R127.2, RN2.2 (R1); also elsewhere on the board
PADDLE_DUMP: Q3.2 (G), Q4.2 (G); also elsewhere on the board
PS2_CLK: J4.5, J10.1; also elsewhere on the board
PS2_DATA: J4.1, J10.2; also elsewhere on the board
PS2_MOUSE_CLK: J5.5, J11.1; also elsewhere on the board
PS2_MOUSE_DATA: J5.1, J11.2; also elsewhere on the board

Notes on the sheet:
Atari DE-9: 1 up, 2 down, 3 left, 4 right, 5/9 paddle pots (SMS button 2 on 9), 6 fire, 7 +5V (polyfuse), 8 GND. Port 1 hosts the paddles: 1M pull-ups on 5/9 (the pot parallels the pull-up), 10 nF ramp caps, 2N7000 dump FETs on PADDLE_DUMP; DNP the caps/FETs for a sticks-only build.
ESD: 100R series + 1N4148 clamps to +5V/GND on every switch line, connector side. Values 100R, 1N4148, 10k, 1M, 10 nF and 0.5 A are assumptions; griffin.md gives only the topology.
