bradgrantham/griffin/board/board.kicad_pcb

## KiCad design board/board.kicad_pcb (continued)

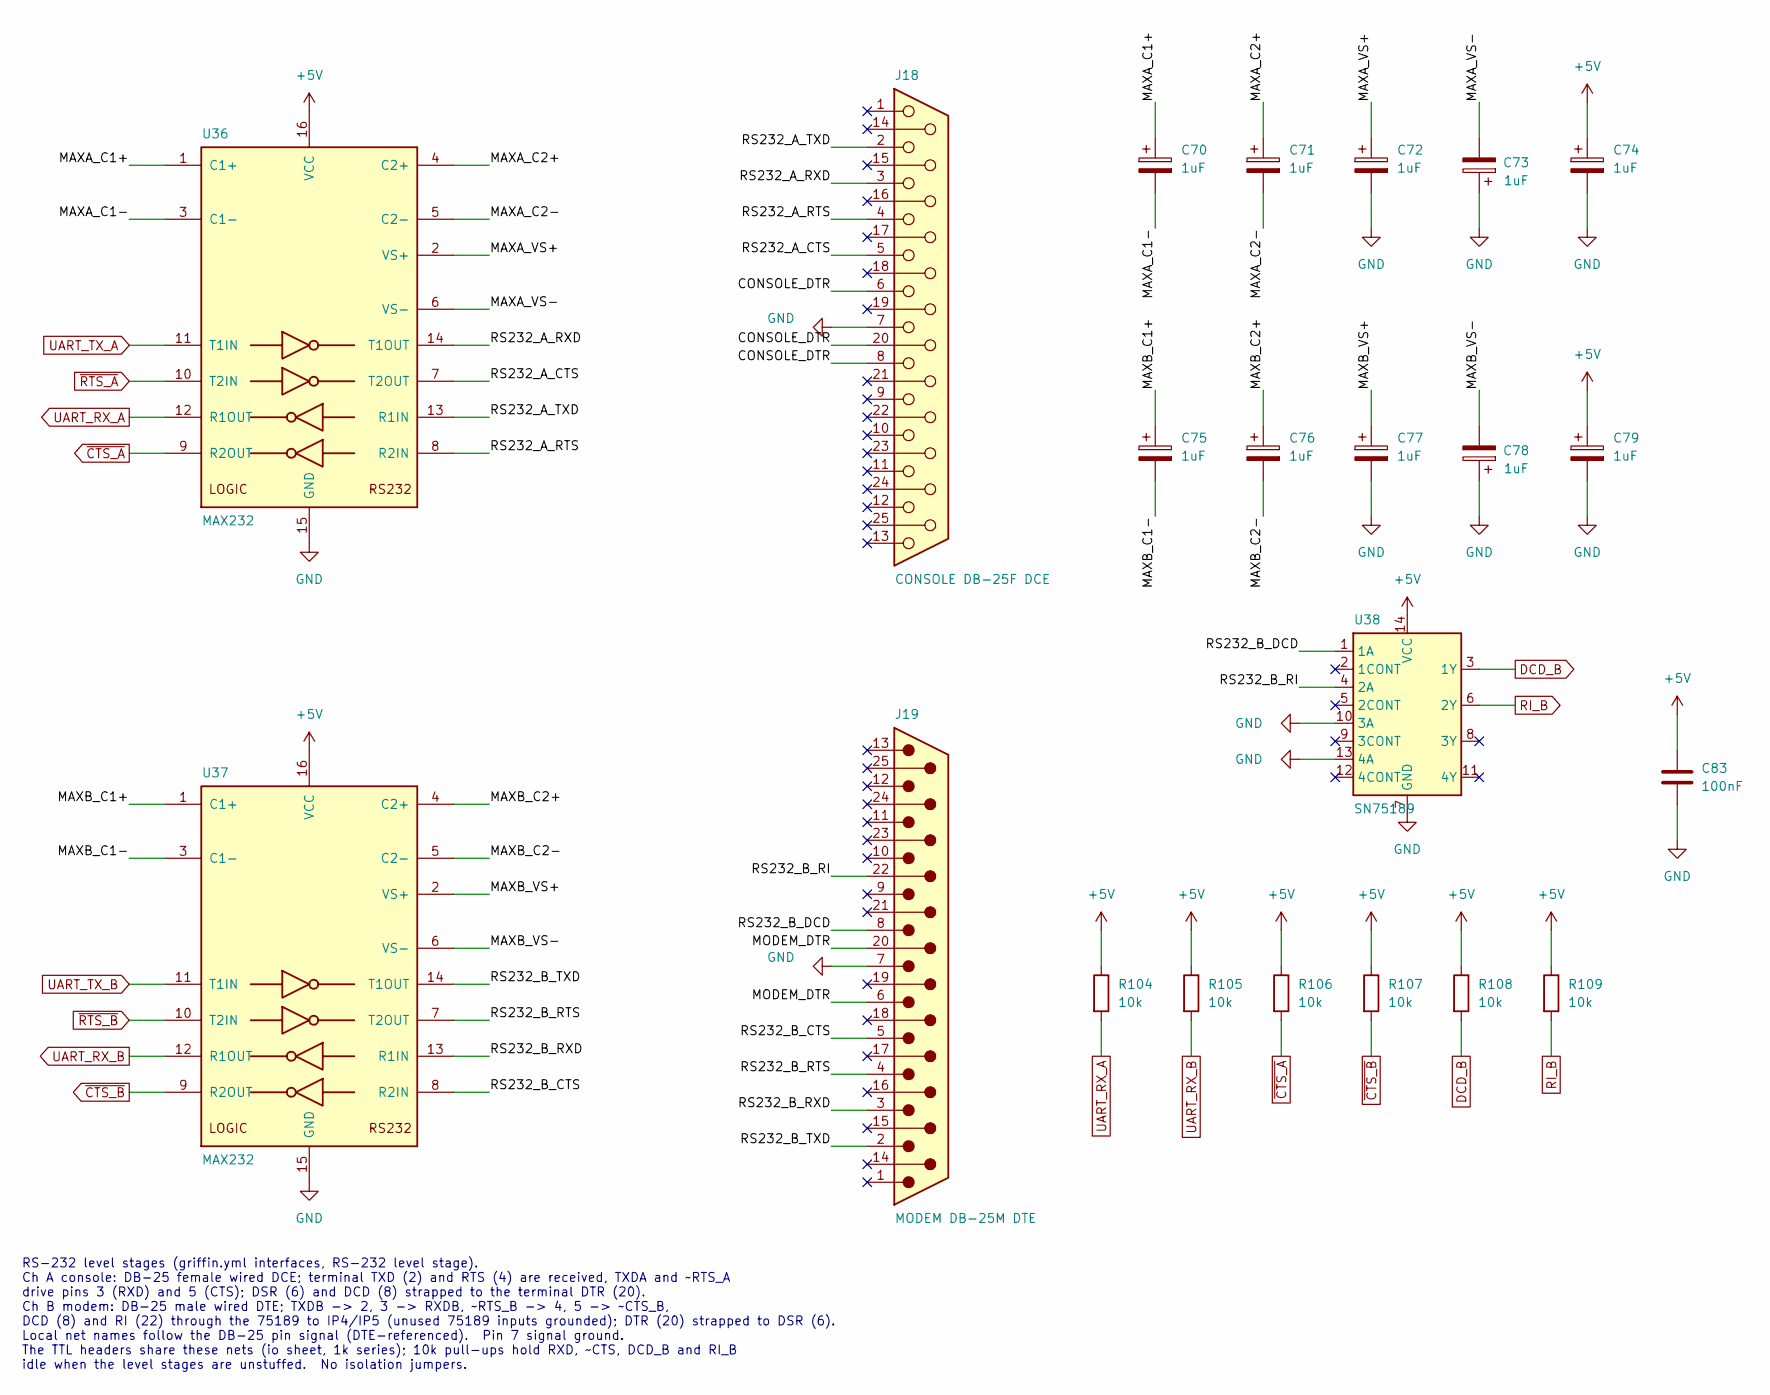
[picture p58: schematic serial.kicad_sch]

Parts:
C70, C71, C72, C73, C74, C75, C76, C77, C78, C79: 1uF; CP_Radial_D5.0mm_P2.00mm
C83: 100nF; C_Disc_D5.0mm_W2.5mm_P5.00mm
J18: CONSOLE DB-25F DCE; DSUB-25_Socket_Horizontal_P2.77x2.84mm_EdgePinOffset7.70mm_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
J19: MODEM DB-25M DTE; DSUB-25_Pins_Horizontal_P2.77x2.84mm_EdgePinOffset7.70mm_Ho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
R104, R105, R106, R107, R108, R109: 10k; R_Axial_DIN0207_L6.3mm_D2.5mm_P10.16mm_Horizontal
U36, U37: MAX232; DIP-16_W7.62mm
U38: SN75189; DIP-14_W7.62mm

Connections:
+5V: C74.1, C79.1, C83.1, R104.1, R105.1, R106.1, R107.1, R108.1, R109.1, U36.16 (VCC), U37.16 (VCC), U38.14 (VCC); also elsewhere on the board
/SERIAL/CONSOLE_DTR: J18.6, J18.8, J18.20
/SERIAL/MAXA_C1+: C70.1, U36.1 (C1+)
/SERIAL/MAXA_C1-: C70.2, U36.3 (C1-)
/SERIAL/MAXA_C2+: C71.1, U36.4 (C2+)
/SERIAL/MAXA_C2-: C71.2, U36.5 (C2-)
/SERIAL/MAXA_VS+: C72.1, U36.2 (VS+)
/SERIAL/MAXA_VS-: C73.2, U36.6 (VS-)
/SERIAL/MAXB_C1+: C75.1, U37.1 (C1+)
/SERIAL/MAXB_C1-: C75.2, U37.3 (C1-)
/SERIAL/MAXB_C2+: C76.1, U37.4 (C2+)
/SERIAL/MAXB_C2-: C76.2, U37.5 (C2-)
/SERIAL/MAXB_VS+: C77.1, U37.2 (VS+)
/SERIAL/MAXB_VS-: C78.2, U37.6 (VS-)
/SERIAL/MODEM_DTR: J19.6, J19.20
/SERIAL/RS232_A_CTS: J18.5, U36.7 (T2OUT)
/SERIAL/RS232_A_RTS: J18.4, U36.8 (R2IN)
/SERIAL/RS232_A_RXD: J18.3, U36.14 (T1OUT)
/SERIAL/RS232_A_TXD: J18.2, U36.13 (R1IN)
/SERIAL/RS232_B_CTS: J19.5, U37.8 (R2IN)
/SERIAL/RS232_B_DCD: J19.8, U38.1 (1A)
/SERIAL/RS232_B_RI: J19.22, U38.4 (2A)
/SERIAL/RS232_B_RTS: J19.4, U37.7 (T2OUT)
/SERIAL/RS232_B_RXD: J19.3, U37.13 (R1IN)
/SERIAL/RS232_B_TXD: J19.2, U37.14 (T1OUT)
DCD_B: R108.2, U38.3 (1Y)
GND: C72.2, C73.1, C74.2, C77.2, C78.1, C79.2, C83.2, J18.7, J19.7, U36.15 (GND), U37.15 (GND), U38.7 (GND), U38.10 (3A), U38.13 (4A); also elsewhere on the board
RI_B: R109.2, U38.6 (2Y)
UART_RX_A: R104.2, U36.12 (R1OUT); also elsewhere on the board
UART_RX_B: R105.2, U37.12 (R1OUT); also elsewhere on the board
UART_TX_A: U36.11 (T1IN); also elsewhere on the board
UART_TX_B: U37.11 (T1IN); also elsewhere on the board
~CTS_A: R106.2, U36.9 (R2OUT); also elsewhere on the board
~CTS_B: R107.2, U37.9 (R2OUT); also elsewhere on the board
~RTS_A: U36.10 (T2IN); also elsewhere on the board
~RTS_B: U37.10 (T2IN); also elsewhere on the board

Notes on the sheet:
RS-232 level stages (griffin.yml interfaces, RS-232 level stage). Ch A console: DB-25 female wired DCE; terminal TXD (2) and RTS (4) are received, TXDA and ~RTS_A drive pins 3 (RXD) and 5 (CTS); DSR (6) and DCD (8) strapped to the terminal DTR (20). Ch B modem: DB-25 male wired DTE; TXDB -> 2, 3 ->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

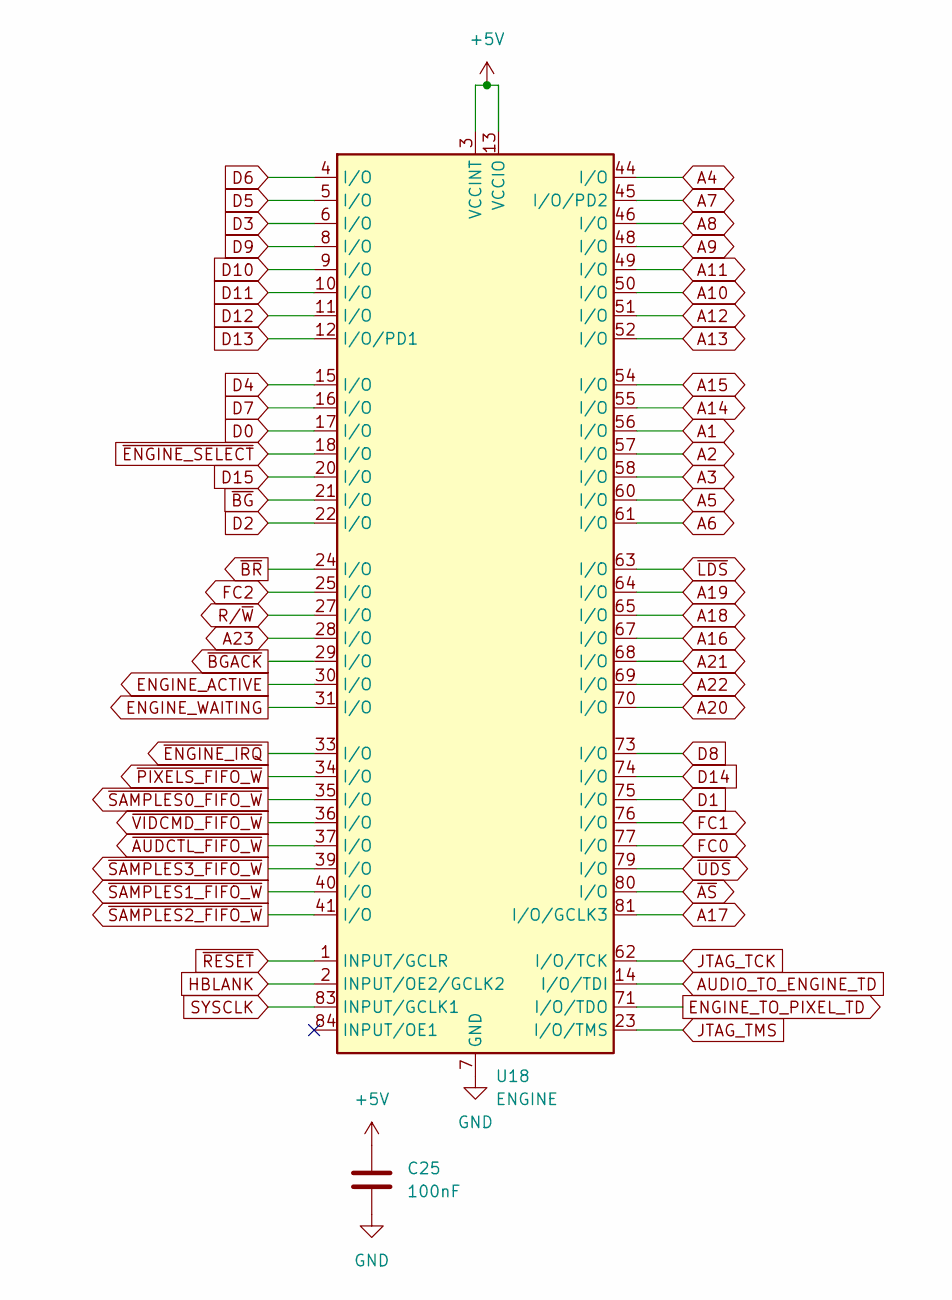
[picture p59: schematic engine.kicad_sch]

Parts:
C25: 100nF; C_Disc_D5.0mm_W2.5mm_P5.00mm
U18: ENGINE; PLCC-84_THT-Socket

Connections:
+5V: C25.1, U18.3 (VCCINT), U18.13 (VCCIO), U18.26 (VCCIO), U18.38 (VCCIO), U18.43 (VCCINT), U18.53 (VCCIO), U18.66 (VCCIO), U18.78 (VCCIO); also elsewhere on the board
A1: U18.56 (I/O); also elsewhere on the board
A2: U18.57 (I/O); also elsewhere on the board
A3: U18.58 (I/O); also elsewhere on the board
A4: U18.44 (I/O); also elsewhere on the board
A5: U18.60 (I/O); also elsewhere on the board
A6: U18.61 (I/O); also elsewhere on the board
A7: U18.45 (I/O/PD2); also elsewhere on the board
A8: U18.46 (I/O); also elsewhere on the board
A9: U18.48 (I/O); also elsewhere on the board
A10: U18.50 (I/O); also elsewhere on the board
A11: U18.49 (I/O); also elsewhere on the board
A12: U18.51 (I/O); also elsewhere on the board
A13: U18.52 (I/O); also elsewhere on the board
A14: U18.55 (I/O); also elsewhere on the board
A15: U18.54 (I/O); also elsewhere on the board
A16: U18.67 (I/O); also elsewhere on the board
A17: U18.81 (I/O/GCLK3); also elsewhere on the board
A18: U18.65 (I/O); also elsewhere on the board
A19: U18.64 (I/O); also elsewhere on the board
A20: U18.70 (I/O); also elsewhere on the board
A21: U18.68 (I/O); also elsewhere on the board
A22: U18.69 (I/O); also elsewhere on the board
A23: U18.28 (I/O); also elsewhere on the board
AUDIO_TO_ENGINE_TD: U18.14 (I/O/TDI); also elsewhere on the board
D0: U18.17 (I/O); also elsewhere on the board
D1: U18.75 (I/O); also elsewhere on the board
D2: U18.22 (I/O); also elsewhere on the board
D3: U18.6 (I/O); also elsewhere on the board
D4: U18.15 (I/O); also elsewhere on the board
D5: U18.5 (I/O); also elsewhere on the board
D6: U18.4 (I/O); also elsewhere on the board
D7: U18.16 (I/O); also elsewhere on the board
D8: U18.73 (I/O); also elsewhere on the board
D9: U18.8 (I/O); also elsewhere on the board
D10: U18.9 (I/O); also elsewhere on the board
D11: U18.10 (I/O); also elsewhere on the board
D12: U18.11 (I/O); also elsewhere on the board
D13: U18.12 (I/O/PD1); also elsewhere on the board
D14: U18.74 (I/O); also elsewhere on the board
D15: U18.20 (I/O); also elsewhere on the board
ENGINE_ACTIVE: U18.30 (I/O); also elsewhere on the board
ENGINE_TO_PIXEL_TD: U18.71 (I/O/TDO); also elsewhere on the board
ENGINE_WAITING: U18.31 (I/O); also elsewhere on the board
FC0: U18.77 (I/O); also elsewhere on the board
FC1: U18.76 (I/O); also elsewhere on the board
FC2: U18.25 (I/O); also elsewhere on the board
GND: C25.2, U18.7 (GND), U18.19 (GND), U18.32 (GND), U18.42 (GND), U18.47 (GND), U18.59 (GND), U18.72 (GND), U18.82 (GND); also elsewhere on the board
HBLANK: U18.2 (INPUT/OE2/GCLK2); also elsewhere on the board
JTAG_TCK: U18.62 (I/O/TCK); also elsewhere on the board
JTAG_TMS: U18.23 (I/O/TMS); also elsewhere on the board
R/~W: U18.27 (I/O); also elsewhere on the board
SYSCLK: U18.83 (INPUT/GCLK1); also elsewhere on the board
~AS: U18.80 (I/O); also elsewhere on the board
~AUDCTL_FIFO_W: U18.37 (I/O); also elsewhere on the board
~BGACK: U18.29 (I/O); also elsewhere on the board
~BG: U18.21 (I/O); also elsewhere on the board
~BR: U18.24 (I/O); also elsewhere on the board
~ENGINE_IRQ: U18.33 (I/O); also elsewhere on the board
~ENGINE_SELECT: U18.18 (I/O); also elsewhere on the board
~LDS: U18.63 (I/O); also elsewhere on the board
~PIXELS_FIFO_W: U18.34 (I/O); also elsewhere on the board
~RESET: U18.1 (INPUT/GCLR); also elsewhere on the board
~SAMPLES0_FIFO_W: U18.35 (I/O); also elsewhere on the board
~SAMPLES1_FIFO_W: U18.40 (I/O); also elsewhere on the board
~SAMPLES2_FIFO_W: U18.41 (I/O); also elsewhere on the board
~SAMPLES3_FIFO_W: U18.39 (I/O); also elsewhere on the board
~UDS: U18.79 (I/O); also elsewhere on the board
~VIDCMD_FIFO_W: U18.36 (I/O); also elsewhere on the board

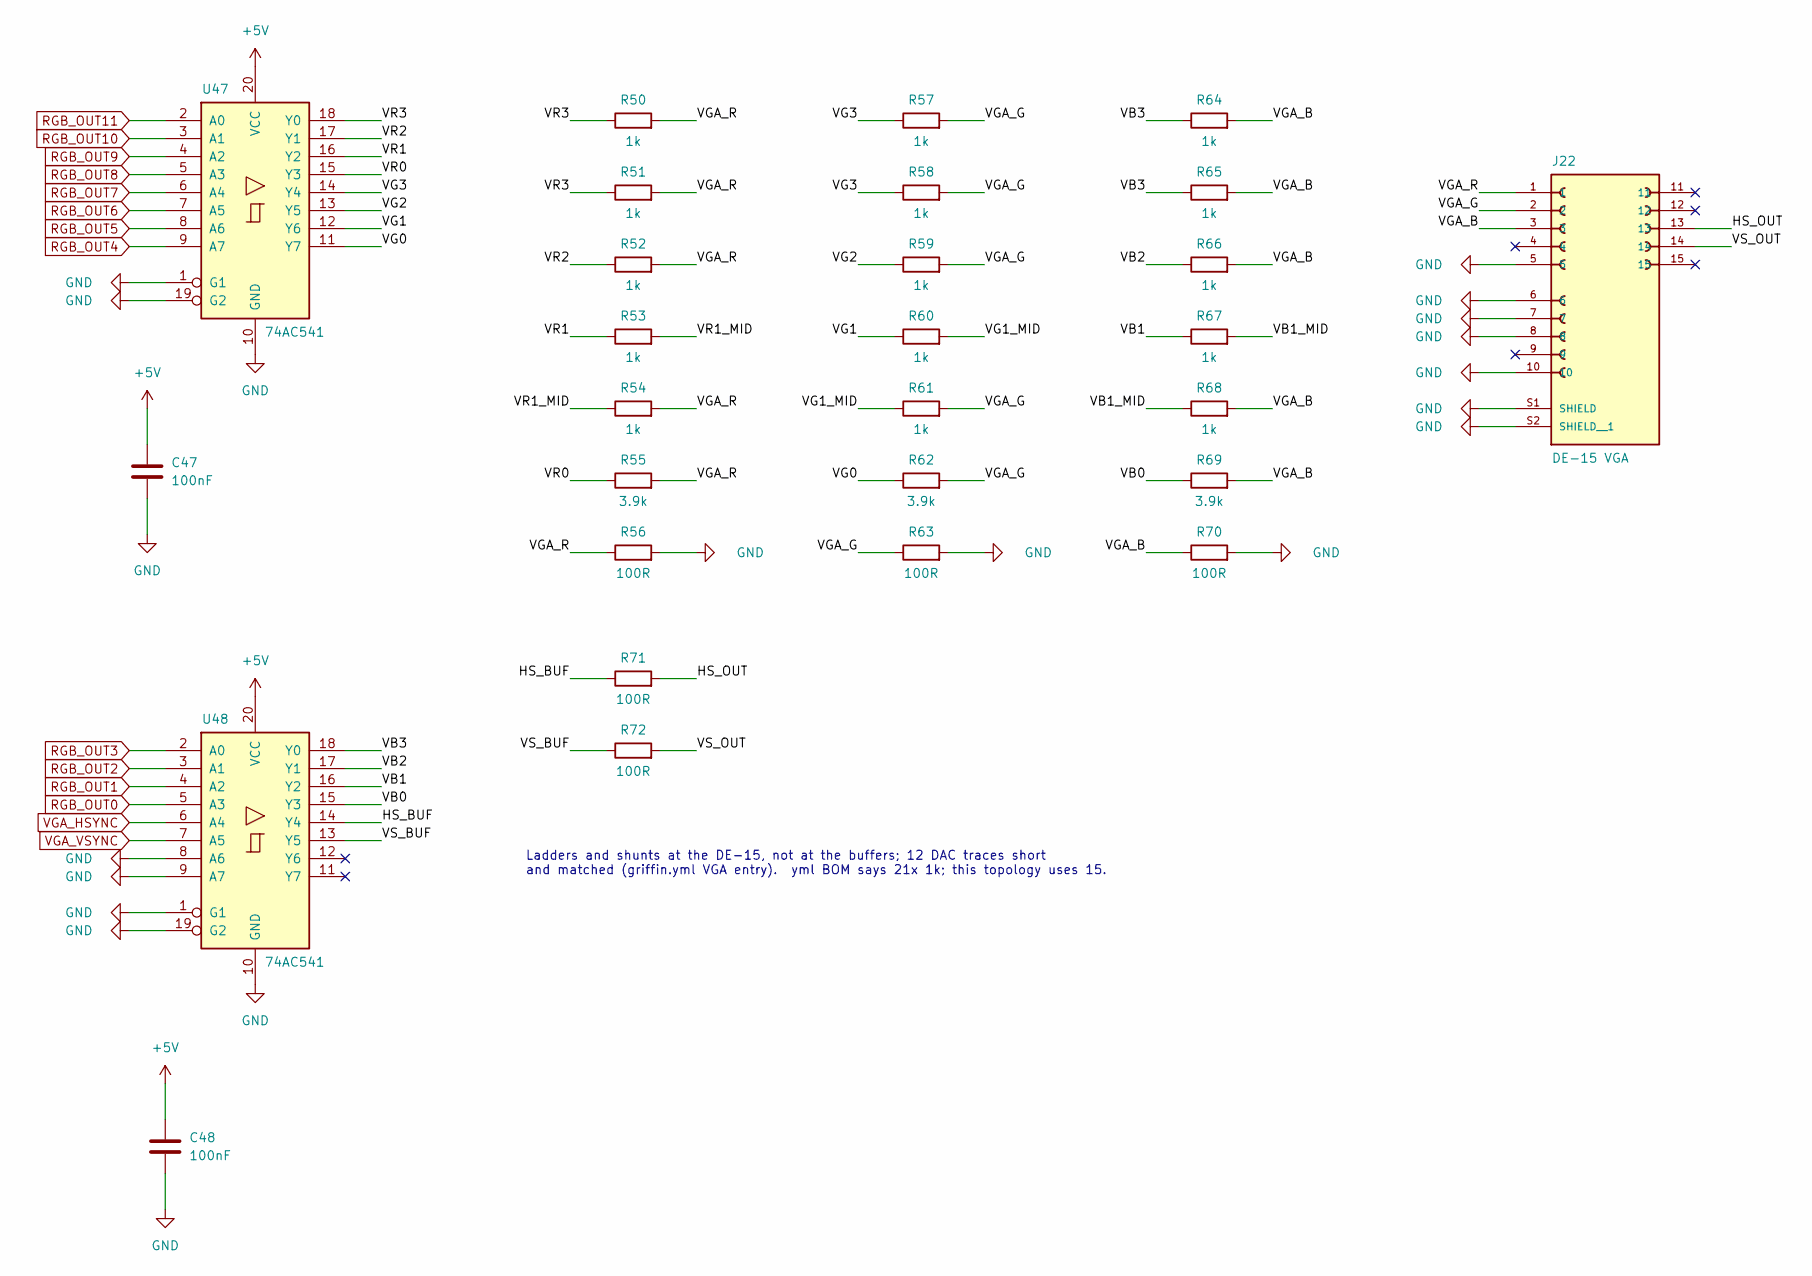
[picture p60: schematic vga.kicad_sch]

Parts:
C47, C48: 100nF; C_Disc_D5.0mm_W2.5mm_P5.00mm
J22: DE-15 VGA; AMPHENOL_ICD15S13E4GX00LF
R50, R51, R52, R53, R54, R57, R58, R59, R60, R61, R64, R65, R66, R67, R68: 1k; R_Axial_DIN0207_L6.3mm_D2.5mm_P10.16mm_Horizontal
R55, R62, R69: 3.9k; R_Axial_DIN0207_L6.3mm_D2.5mm_P10.16mm_Horizontal
R56, R63, R70, R71, R72: 100R; R_Axial_DIN0207_L6.3mm_D2.5mm_P10.16mm_Horizontal
U47, U48: 74AC541; DIP-20_W7.62mm

Connections:
+5V: C47.1, C48.1, U47.20 (VCC), U48.20 (VCC); also elsewhere on the board
/VGA_OUT/HS_BUF: R71.1, U48.14 (Y4)
/VGA_OUT/HS_OUT: J22.13, R71.2
/VGA_OUT/VB0: R69.1, U48.15 (Y3)
/VGA_OUT/VB1: R67.1, U48.16 (Y2)
/VGA_OUT/VB1_MID: R67.2, R68.1
/VGA_OUT/VB2: R66.1, U48.17 (Y1)
/VGA_OUT/VB3: R64.1, R65.1, U48.18 (Y0)
/VGA_OUT/VG0: R62.1, U47.11 (Y7)
/VGA_OUT/VG1: R60.1, U47.12 (Y6)
/VGA_OUT/VG1_MID: R60.2, R61.1
/VGA_OUT/VG2: R59.1, U47.13 (Y5)
/VGA_OUT/VG3: R57.1, R58.1, U47.14 (Y4)
/VGA_OUT/VGA_B: J22.3, R64.2, R65.2, R66.2, R68.2, R69.2, R70.1
/VGA_OUT/VGA_G: J22.2, R57.2, R58.2, R59.2, R61.2, R62.2, R63.1
/VGA_OUT/VGA_R: J22.1, R50.2, R51.2, R52.2, R54.2, R55.2, R56.1
/VGA_OUT/VR0: R55.1, U47.15 (Y3)
/VGA_OUT/VR1: R53.1, U47.16 (Y2)
/VGA_OUT/VR1_MID: R53.2, R54.1
/VGA_OUT/VR2: R52.1, U47.17 (Y1)
/VGA_OUT/VR3: R50.1, R51.1, U47.18 (Y0)
/VGA_OUT/VS_BUF: R72.1, U48.13 (Y5)
/VGA_OUT/VS_OUT: J22.14, R72.2
GND: C47.2, C48.2, J22.5, J22.6, J22.7, J22.8, J22.10, J22.S1 (SHIELD), J22.S2 (SHIELD__1), R56.2, R63.2, R70.2, U47.1 (G1), U47.10 (GND), U47.19 (G2), U48.1 (G1), U48.8 (A6), U48.9 (A7), U48.10 (GND), U48.19 (G2); also elsewhere on the board
RGB_OUT0: U48.5 (A3); also elsewhere on the board
RGB_OUT1: U48.4 (A2); also elsewhere on the board
RGB_OUT2: U48.3 (A1); also elsewhere on the board
RGB_OUT3: U48.2 (A0); also elsewhere on the board
RGB_OUT4: U47.9 (A7); also elsewhere on the board
RGB_OUT5: U47.8 (A6); also elsewhere on the board
RGB_OUT6: U47.7 (A5); also elsewhere on the board
RGB_OUT7: U47.6 (A4); also elsewhere on the board
RGB_OUT8: U47.5 (A3); also elsewhere on the board
RGB_OUT9: U47.4 (A2); also elsewhere on the board
RGB_OUT10: U47.3 (A1); also elsewhere on the board
RGB_OUT11: U47.2 (A0); also elsewhere on the board
VGA_HSYNC: U48.6 (A4); also elsewhere on the board
VGA_VSYNC: U48.7 (A5); also elsewhere on the board

Notes on the sheet:
Ladders and shunts at the DE-15, not at the buffers; 12 DAC traces short and matched (griffin.yml VGA entry). yml BOM says 21x 1k; this topology uses 15.

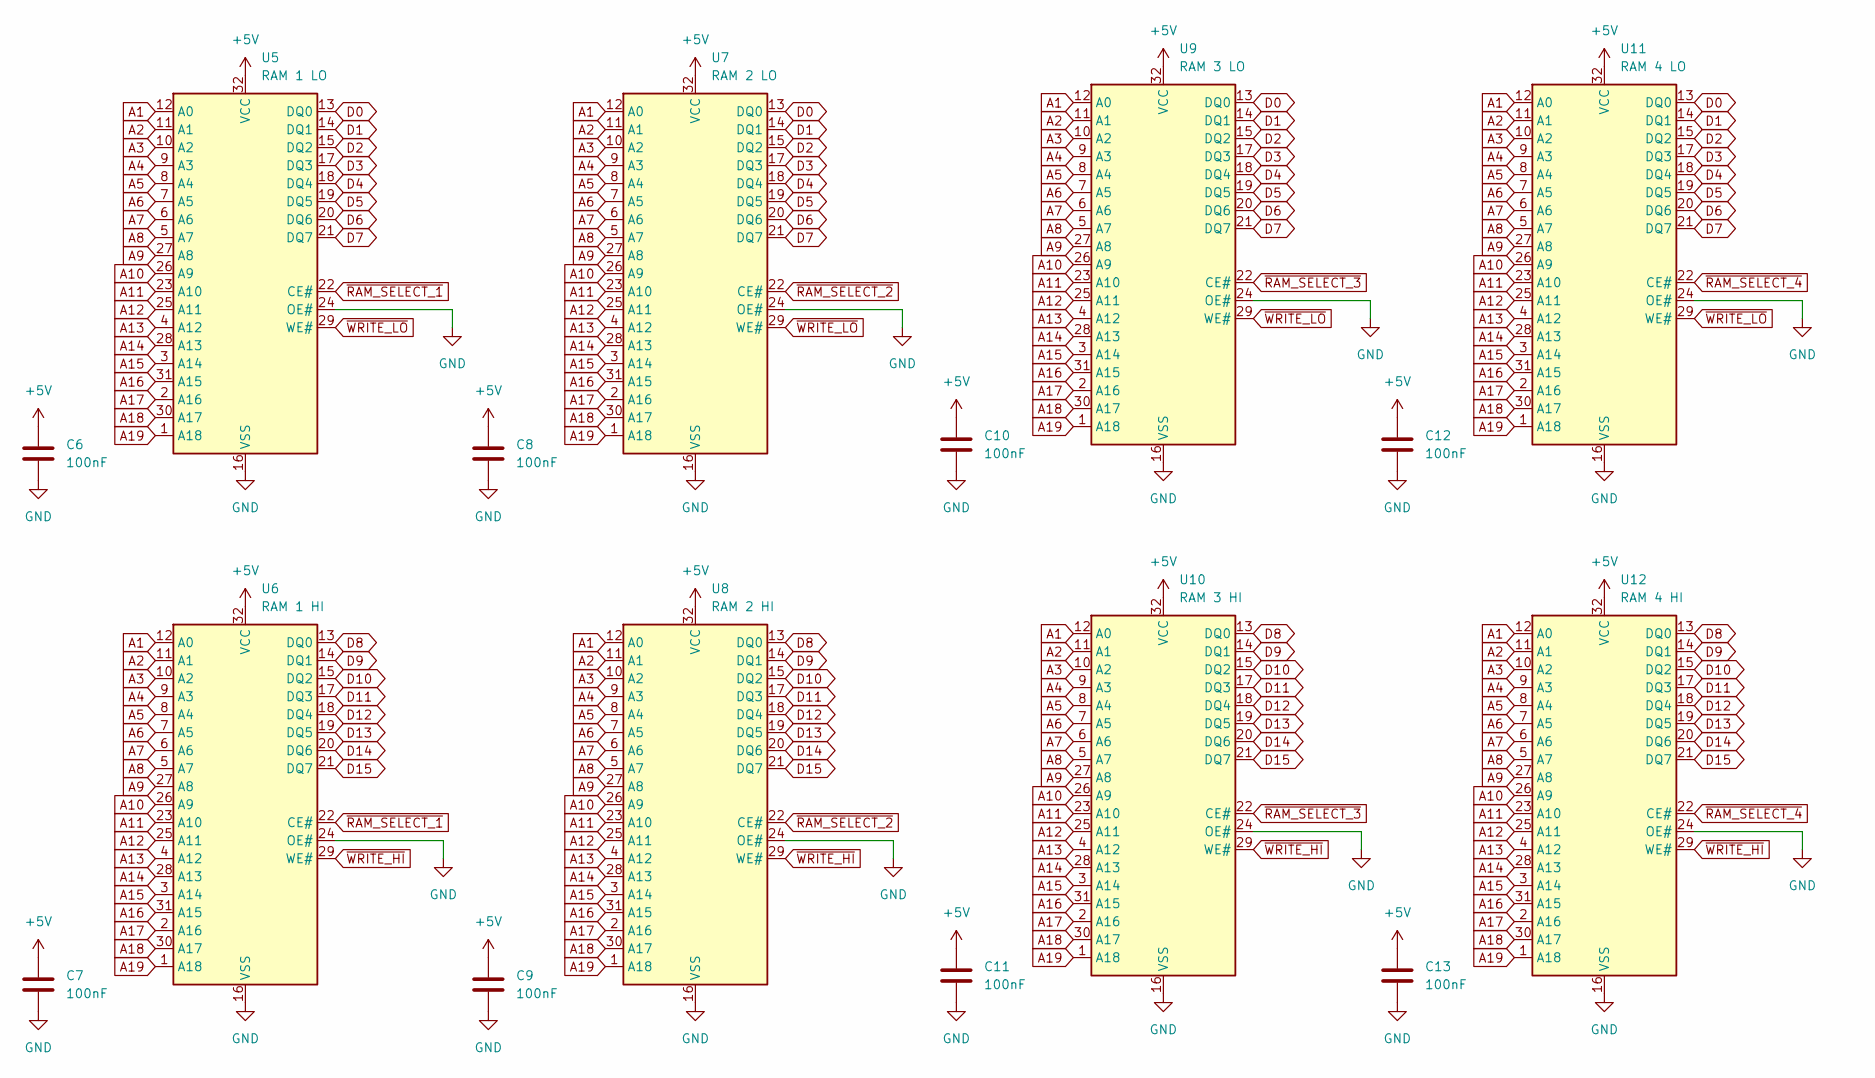
[picture p61: schematic ram.kicad_sch]

Parts:
C6, C7, C8, C9, C10, C11, C12, C13: 100nF; C_Disc_D5.0mm_W2.5mm_P5.00mm
U5: RAM 1 LO; DIP-32_W15.24mm
U6: RAM 1 HI; DIP-32_W15.24mm
U7: RAM 2 LO; DIP-32_W15.24mm
U8: RAM 2 HI; DIP-32_W15.24mm
U9: RAM 3 LO; DIP-32_W15.24mm
U10: RAM 3 HI; DIP-32_W15.24mm
U11: RAM 4 LO; DIP-32_W15.24mm
U12: RAM 4 HI; DIP-32_W15.24mm

Connections:
+5V: C6.1, C7.1, C8.1, C9.1, C10.1, C11.1, C12.1, C13.1, U5.32 (VCC), U6.32 (VCC), U7.32 (VCC), U8.32 (VCC), U9.32 (VCC), U10.32 (VCC), U11.32 (VCC), U12.32 (VCC); also elsewhere on the board
A1: U5.12 (A0), U6.12 (A0), U7.12 (A0), U8.12 (A0), U9.12 (A0), U10.12 (A0), U11.12 (A0), U12.12 (A0); also elsewhere on the board
A2: U5.11 (A1), U6.11 (A1), U7.11 (A1), U8.11 (A1), U9.11 (A1), U10.11 (A1), U11.11 (A1), U12.11 (A1); also elsewhere on the board
A3: U5.10 (A2), U6.10 (A2), U7.10 (A2), U8.10 (A2), U9.10 (A2), U10.10 (A2), U11.10 (A2), U12.10 (A2); also elsewhere on the board
A4: U5.9 (A3), U6.9 (A3), U7.9 (A3), U8.9 (A3), U9.9 (A3), U10.9 (A3), U11.9 (A3), U12.9 (A3); also elsewhere on the board
A5: U5.8 (A4), U6.8 (A4), U7.8 (A4), U8.8 (A4), U9.8 (A4), U10.8 (A4), U11.8 (A4), U12.8 (A4); also elsewhere on the board
A6: U5.7 (A5), U6.7 (A5), U7.7 (A5), U8.7 (A5), U9.7 (A5), U10.7 (A5), U11.7 (A5), U12.7 (A5); also elsewhere on the board
A7: U5.6 (A6), U6.6 (A6), U7.6 (A6), U8.6 (A6), U9.6 (A6), U10.6 (A6), U11.6 (A6), U12.6 (A6); also elsewhere on the board
A8: U5.5 (A7), U6.5 (A7), U7.5 (A7), U8.5 (A7), U9.5 (A7), U10.5 (A7), U11.5 (A7), U12.5 (A7); also elsewhere on the board
A9: U5.27 (A8), U6.27 (A8), U7.27 (A8), U8.27 (A8), U9.27 (A8), U10.27 (A8), U11.27 (A8), U12.27 (A8); also elsewhere on the board
A10: U5.26 (A9), U6.26 (A9), U7.26 (A9), U8.26 (A9), U9.26 (A9), U10.26 (A9), U11.26 (A9), U12.26 (A9); also elsewhere on the board
A11: U5.23 (A10), U6.23 (A10), U7.23 (A10), U8.23 (A10), U9.23 (A10), U10.23 (A10), U11.23 (A10), U12.23 (A10); also elsewhere on the board
A12: U5.25 (A11), U6.25 (A11), U7.25 (A11), U8.25 (A11), U9.25 (A11), U10.25 (A11), U11.25 (A11), U12.25 (A11); also elsewhere on the board
A13: U5.4 (A12), U6.4 (A12), U7.4 (A12), U8.4 (A12), U9.4 (A12), U10.4 (A12), U11.4 (A12), U12.4 (A12); also elsewhere on the board
A14: U5.28 (A13), U6.28 (A13), U7.28 (A13), U8.28 (A13), U9.28 (A13), U10.28 (A13), U11.28 (A13), U12.28 (A13); also elsewhere on the board
A15: U5.3 (A14), U6.3 (A14), U7.3 (A14), U8.3 (A14), U9.3 (A14), U10.3 (A14), U11.3 (A14), U12.3 (A14); also elsewhere on the board
A16: U5.31 (A15), U6.31 (A15), U7.31 (A15), U8.31 (A15), U9.31 (A15), U10.31 (A15), U11.31 (A15), U12.31 (A15); also elsewhere on the board
A17: U5.2 (A16), U6.2 (A16), U7.2 (A16), U8.2 (A16), U9.2 (A16), U10.2 (A16), U11.2 (A16), U12.2 (A16); also elsewhere on the board
A18: U5.30 (A17), U6.30 (A17), U7.30 (A17), U8.30 (A17), U9.30 (A17), U10.30 (A17), U11.30 (A17), U12.30 (A17); also elsewhere on the board
A19: U5.1 (A18), U6.1 (A18), U7.1 (A18), U8.1 (A18), U9.1 (A18), U10.1 (A18), U11.1 (A18), U12.1 (A18); also elsewhere on the board
D0: U5.13 (DQ0), U7.13 (DQ0), U9.13 (DQ0), U11.13 (DQ0); also elsewhere on the board
D1: U5.14 (DQ1), U7.14 (DQ1), U9.14 (DQ1), U11.14 (DQ1); also elsewhere on the board
D2: U5.15 (DQ2), U7.15 (DQ2), U9.15 (DQ2), U11.15 (DQ2); also elsewhere on the board
D3: U5.17 (DQ3), U7.17 (DQ3), U9.17 (DQ3), U11.17 (DQ3); also elsewhere on the board
D4: U5.18 (DQ4), U7.18 (DQ4), U9.18 (DQ4), U11.18 (DQ4); also elsewhere on the board
D5: U5.19 (DQ5), U7.19 (DQ5), U9.19 (DQ5), U11.19 (DQ5); also elsewhere on the board
D6: U5.20 (DQ6), U7.20 (DQ6), U9.20 (DQ6), U11.20 (DQ6); also elsewhere on the board
D7: U5.21 (DQ7), U7.21 (DQ7), U9.21 (DQ7), U11.21 (DQ7); also elsewhere on the board
D8: U6.13 (DQ0), U8.13 (DQ0), U10.13 (DQ0), U12.13 (DQ0); also elsewhere on the board
D9: U6.14 (DQ1), U8.14 (DQ1), U10.14 (DQ1), U12.14 (DQ1); also elsewhere on the board
D10: U6.15 (DQ2), U8.15 (DQ2), U10.15 (DQ2), U12.15 (DQ2); also elsewhere on the board
D11: U6.17 (DQ3), U8.17 (DQ3), U10.17 (DQ3), U12.17 (DQ3); also elsewhere on the board
D12: U6.18 (DQ4), U8.18 (DQ4), U10.18 (DQ4), U12.18 (DQ4); also elsewhere on the board
D13: U6.19 (DQ5), U8.19 (DQ5), U10.19 (DQ5), U12.19 (DQ5); also elsewhere on the board
D14: U6.20 (DQ6), U8.20 (DQ6), U10.20 (DQ6), U12.20 (DQ6); also elsewhere on the board
D15: U6.21 (DQ7), U8.21 (DQ7), U10.21 (DQ7), U12.21 (DQ7); also elsewhere on the board
GND: C6.2, C7.2, C8.2, C9.2, C10.2, C11.2, C12.2, C13.2, U5.16 (VSS), U5.24 (OE#), U6.16 (VSS), U6.24 (OE#), U7.16 (VSS), U7.24 (OE#), U8.16 (VSS), U8.24 (OE#), U9.16 (VSS), U9.24 (OE#), U10.16 (VSS), U10.24 (OE#), U11.16 (VSS), U11.24 (OE#), U12.16 (VSS), U12.24 (OE#); also elsewhere on the board
~RAM_SELECT_1: U5.22 (CE#), U6.22 (CE#); also elsewhere on the board
~RAM_SELECT_2: U7.22 (CE#), U8.22 (CE#); also elsewhere on the board
~RAM_SELECT_3: U9.22 (CE#), U10.22 (CE#); also elsewhere on the board
~RAM_SELECT_4: U11.22 (CE#), U12.22 (CE#); also elsewhere on the board
~WRITE_HI: U6.29 (WE#), U8.29 (WE#), U10.29 (WE#), U12.29 (WE#); also elsewhere on the board
~WRITE_LO: U5.29 (WE#), U7.29 (WE#), U9.29 (WE#), U11.29 (WE#); also elsewhere on the board

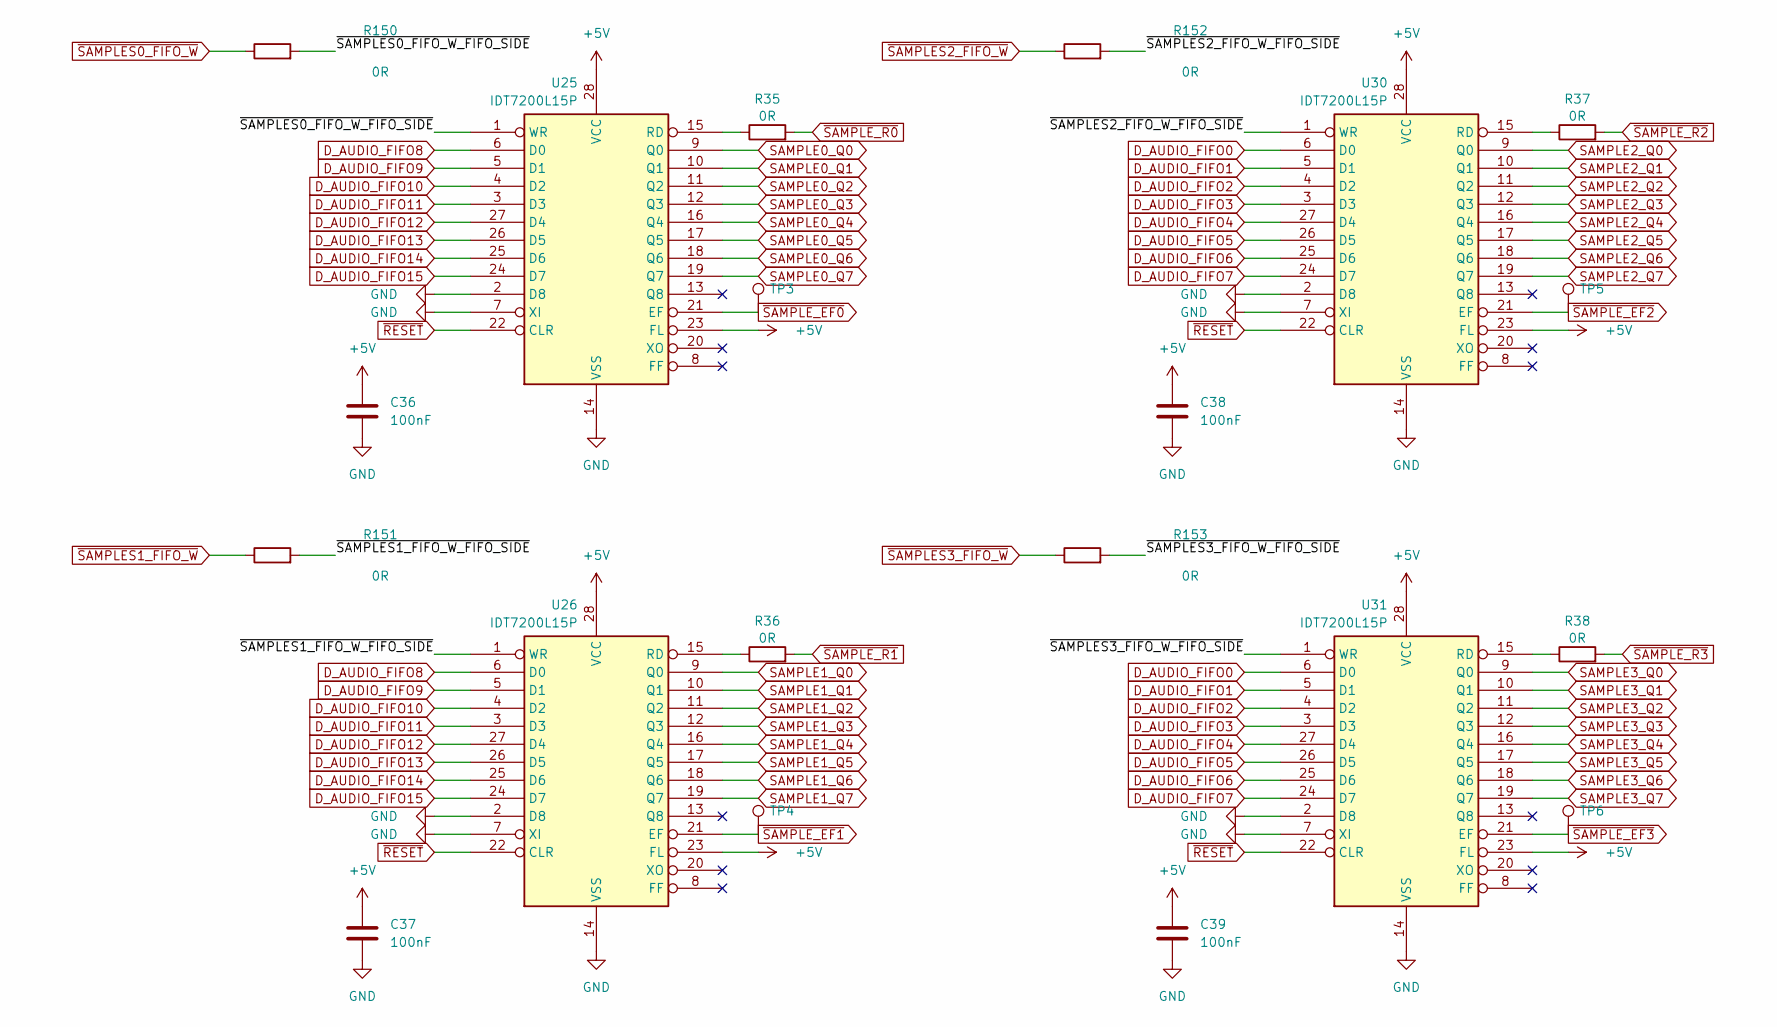
[picture p62: schematic audio-fifo.kicad_sch]

Parts:
C36, C37, C38, C39: 100nF; C_Disc_D5.0mm_W2.5mm_P5.00mm
R35, R36, R37, R38, R150, R151, R152, R153: 0R; R_Axial_DIN0207_L6.3mm_D2.5mm_P10.16mm_Horizontal
TP3, TP4, TP5, TP6: TestPoint; TestPoint_Pad_D1.5mm
U25, U26, U30, U31: IDT7200L15P; DIP-28_W7.62mm

Connections:
+5V: C36.1, C37.1, C38.1, C39.1, U25.23 (FL), U25.28 (VCC), U26.23 (FL), U26.28 (VCC), U30.23 (FL), U30.28 (VCC), U31.23 (FL), U31.28 (VCC); also elsewhere on the board
/AUDIO_FIFO/~SAMPLES0_FIFO_W_FIFO_SIDE: R150.2, U25.1 (WR)
/AUDIO_FIFO/~SAMPLES1_FIFO_W_FIFO_SIDE: R151.2, U26.1 (WR)
/AUDIO_FIFO/~SAMPLES2_FIFO_W_FIFO_SIDE: R152.2, U30.1 (WR)
/AUDIO_FIFO/~SAMPLES3_FIFO_W_FIFO_SIDE: R153.2, U31.1 (WR)
D_AUDIO_FIFO0: U30.6 (D0), U31.6 (D0); also elsewhere on the board
D_AUDIO_FIFO1: U30.5 (D1), U31.5 (D1); also elsewhere on the board
D_AUDIO_FIFO2: U30.4 (D2), U31.4 (D2); also elsewhere on the board
D_AUDIO_FIFO3: U30.3 (D3), U31.3 (D3); also elsewhere on the board
D_AUDIO_FIFO4: U30.27 (D4), U31.27 (D4); also elsewhere on the board
D_AUDIO_FIFO5: U30.26 (D5), U31.26 (D5); also elsewhere on the board
D_AUDIO_FIFO6: U30.25 (D6), U31.25 (D6); also elsewhere on the board
D_AUDIO_FIFO7: U30.24 (D7), U31.24 (D7); also elsewhere on the board
D_AUDIO_FIFO8: U25.6 (D0), U26.6 (D0); also elsewhere on the board
D_AUDIO_FIFO9: U25.5 (D1), U26.5 (D1); also elsewhere on the board
D_AUDIO_FIFO10: U25.4 (D2), U26.4 (D2); also elsewhere on the board
D_AUDIO_FIFO11: U25.3 (D3), U26.3 (D3); also elsewhere on the board
D_AUDIO_FIFO12: U25.27 (D4), U26.27 (D4); also elsewhere on the board
D_AUDIO_FIFO13: U25.26 (D5), U26.26 (D5); also elsewhere on the board
D_AUDIO_FIFO14: U25.25 (D6), U26.25 (D6); also elsewhere on the board
D_AUDIO_FIFO15: U25.24 (D7), U26.24 (D7); also elsewhere on the board
GND: C36.2, C37.2, C38.2, C39.2, U25.2 (D8), U25.7 (XI), U25.14 (VSS), U26.2 (D8), U26.7 (XI), U26.14 (VSS), U30.2 (D8), U30.7 (XI), U30.14 (VSS), U31.2 (D8), U31.7 (XI), U31.14 (VSS); also elsewhere on the board
unnamed: R35.1, U25.15 (RD)
unnamed: R36.1, U26.15 (RD)
unnamed: R37.1, U30.15 (RD)
unnamed: R38.1, U31.15 (RD)
SAMPLE0_Q0: U25.9 (Q0); also elsewhere on the board
SAMPLE0_Q1: U25.10 (Q1); also elsewhere on the board
SAMPLE0_Q2: U25.11 (Q2); also elsewhere on the board
SAMPLE0_Q3: U25.12 (Q3); also elsewhere on the board
SAMPLE0_Q4: U25.16 (Q4); also elsewhere on the board
SAMPLE0_Q5: U25.17 (Q5); also elsewhere on the board
SAMPLE0_Q6: U25.18 (Q6); also elsewhere on the board
SAMPLE0_Q7: U25.19 (Q7); also elsewhere on the board
SAMPLE1_Q0: U26.9 (Q0); also elsewhere on the board
SAMPLE1_Q1: U26.10 (Q1); also elsewhere on the board
SAMPLE1_Q2: U26.11 (Q2); also elsewhere on the board
SAMPLE1_Q3: U26.12 (Q3); also elsewhere on the board
SAMPLE1_Q4: U26.16 (Q4); also elsewhere on the board
SAMPLE1_Q5: U26.17 (Q5); also elsewhere on the board
SAMPLE1_Q6: U26.18 (Q6); also elsewhere on the board
SAMPLE1_Q7: U26.19 (Q7); also elsewhere on the board
SAMPLE2_Q0: U30.9 (Q0); also elsewhere on the board
SAMPLE2_Q1: U30.10 (Q1); also elsewhere on the board
SAMPLE2_Q2: U30.11 (Q2); also elsewhere on the board
SAMPLE2_Q3: U30.12 (Q3); also elsewhere on the board
SAMPLE2_Q4: U30.16 (Q4); also elsewhere on the board
SAMPLE2_Q5: U30.17 (Q5); also elsewhere on the board
SAMPLE2_Q6: U30.18 (Q6); also elsewhere on the board
SAMPLE2_Q7: U30.19 (Q7); also elsewhere on the board
SAMPLE3_Q0: U31.9 (Q0); also elsewhere on the board
SAMPLE3_Q1: U31.10 (Q1); also elsewhere on the board
SAMPLE3_Q2: U31.11 (Q2); also elsewhere on the board
SAMPLE3_Q3: U31.12 (Q3); also elsewhere on the board
SAMPLE3_Q4: U31.16 (Q4); also elsewhere on the board
SAMPLE3_Q5: U31.17 (Q5); also elsewhere on the board
SAMPLE3_Q6: U31.18 (Q6); also elsewhere on the board
SAMPLE3_Q7: U31.19 (Q7); also elsewhere on the board
~RESET: U25.22 (CLR), U26.22 (CLR), U30.22 (CLR), U31.22 (CLR); also elsewhere on the board
~SAMPLES0_FIFO_W: R150.1; also elsewhere on the board
~SAMPLES1_FIFO_W: R151.1; also elsewhere on the board
~SAMPLES2_FIFO_W: R152.1; also elsewhere on the board
~SAMPLES3_FIFO_W: R153.1; also elsewhere on the board
~SAMPLE_EF0: TP3.1, U25.21 (EF); also elsewhere on the board
~SAMPLE_EF1: TP4.1, U26.21 (EF); also elsewhere on the board
~SAMPLE_EF2: TP5.1, U30.21 (EF); also elsewhere on the board
~SAMPLE_EF3: TP6.1, U31.21 (EF); also elsewhere on the board
~SAMPLE_R0: R35.2; also elsewhere on the board
~SAMPLE_R1: R36.2; also elsewhere on the board
~SAMPLE_R2: R37.2; also elsewhere on the board
~SAMPLE_R3: R38.2; also elsewhere on the board
