bradgrantham/griffin/board/board.kicad_pcb

## KiCad design board/board.kicad_pcb (continued)

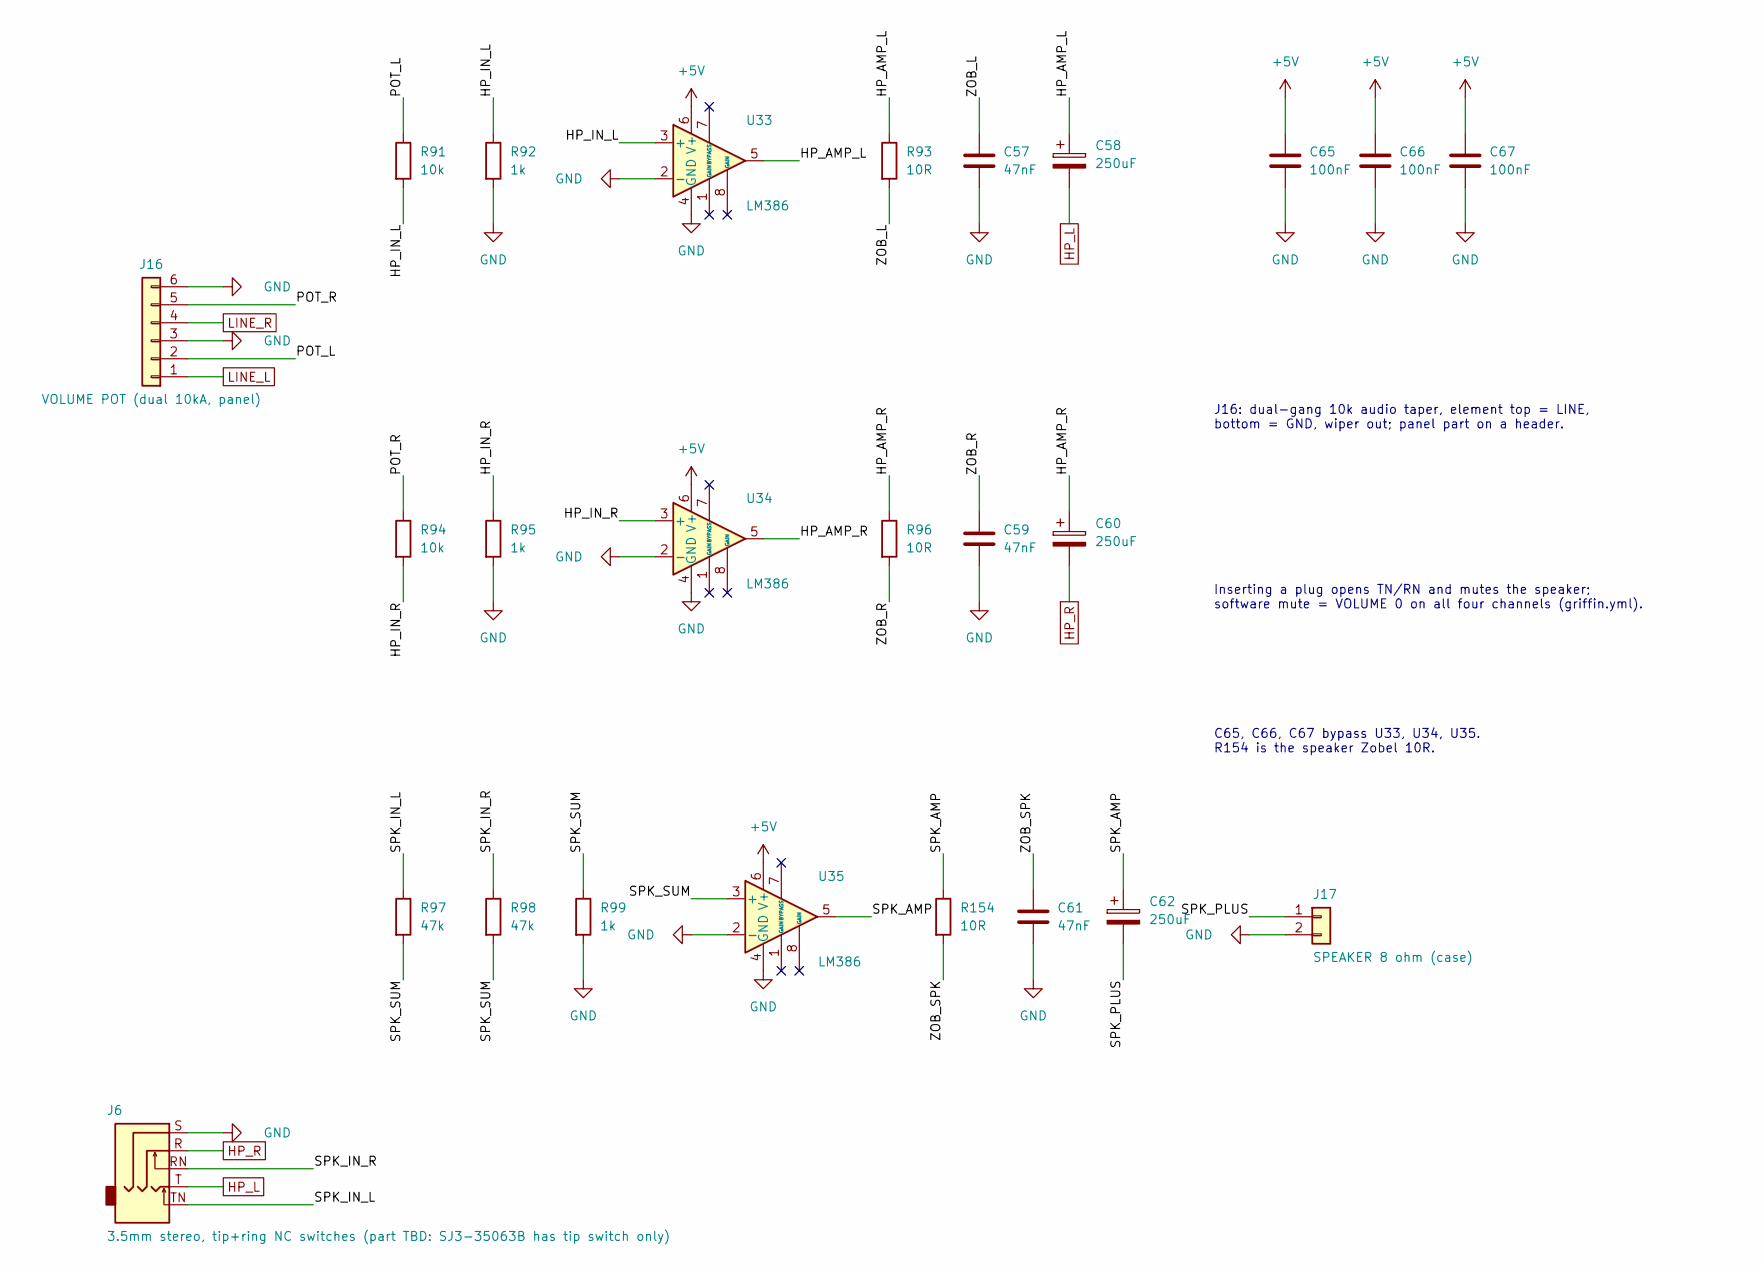
[picture p63: schematic audio-amp.kicad_sch]

Parts:
C57, C59, C61: 47nF; C_Rect_L7.2mm_W2.5mm_P5.00mm
C58, C60, C62: 250uF; CP_Radial_D8.0mm_P3.50mm
C65, C66, C67: 100nF; C_Disc_D5.0mm_W2.5mm_P5.00mm
J6: 3.5mm stereo, tip+ring NC switches (part TBD: SJ3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
J16: VOLUME POT (dual 10kA, panel); PinHeader_1x06_P2.54mm_Vertical
J17: SPEAKER 8 ohm (case); PinHeader_1x02_P2.54mm_Vertical
R91, R94: 10k; R_Axial_DIN0207_L6.3mm_D2.5mm_P10.16mm_Horizontal
R92, R95, R99: 1k; R_Axial_DIN0207_L6.3mm_D2.5mm_P10.16mm_Horizontal
R93, R96, R154: 10R; R_Axial_DIN0207_L6.3mm_D2.5mm_P10.16mm_Horizontal
R97, R98: 47k; R_Axial_DIN0207_L6.3mm_D2.5mm_P10.16mm_Horizontal
U33, U34, U35: LM386; DIP-8_W7.62mm

Connections:
+5V: C65.1, C66.1, C67.1, U33.6 (V+), U34.6 (V+), U35.6 (V+); also elsewhere on the board
/AUDIO_AMP/HP_AMP_L: C58.1, R93.1, U33.5
/AUDIO_AMP/HP_AMP_R: C60.1, R96.1, U34.5
/AUDIO_AMP/HP_IN_L: R91.2, R92.1, U33.3 (+)
/AUDIO_AMP/HP_IN_R: R94.2, R95.1, U34.3 (+)
/AUDIO_AMP/POT_L: J16.2, R91.1
/AUDIO_AMP/POT_R: J16.5, R94.1
/AUDIO_AMP/SPK_AMP: C62.1, R154.1, U35.5
/AUDIO_AMP/SPK_IN_L: J6.TN, R97.1
/AUDIO_AMP/SPK_IN_R: J6.RN, R98.1
/AUDIO_AMP/SPK_PLUS: C62.2, J17.1
/AUDIO_AMP/SPK_SUM: R97.2, R98.2, R99.1, U35.3 (+)
/AUDIO_AMP/ZOB_L: C57.1, R93.2
/AUDIO_AMP/ZOB_R: C59.1, R96.2
/AUDIO_AMP/ZOB_SPK: C61.1, R154.2
GND: C57.2, C59.2, C61.2, C65.2, C66.2, C67.2, J6.S, J16.3, J16.6, J17.2, R92.2, R95.2, R99.2, U33.2 (-), U33.4 (GND), U34.2 (-), U34.4 (GND), U35.2 (-), U35.4 (GND); also elsewhere on the board
HP_L: C58.2, J6.T
HP_R: C60.2, J6.R
LINE_L: J16.1; also elsewhere on the board
LINE_R: J16.4; also elsewhere on the board

Notes on the sheet:
Inserting a plug opens TN/RN and mutes the speaker; software mute = VOLUME 0 on all four channels (griffin.yml).
C65, C66, C67 bypass U33, U34, U35. R154 is the speaker Zobel 10R.
J16: dual-gang 10k audio taper, element top = LINE, bottom = GND, wiper out; panel part on a header.

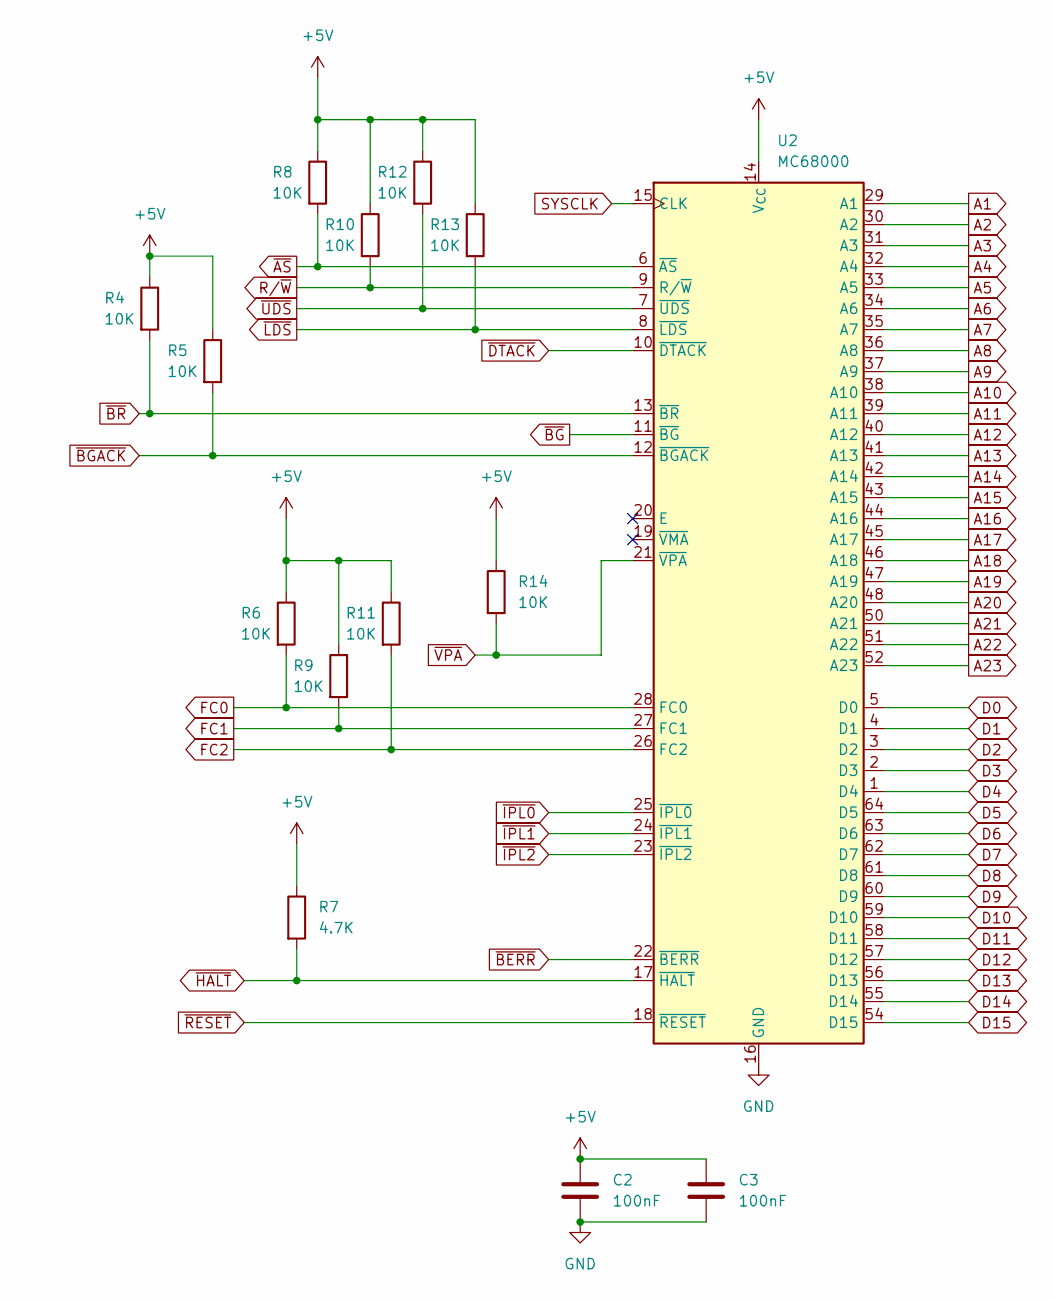
[picture p64: schematic cpu.kicad_sch]

Parts:
C2, C3: 100nF; C_Disc_D5.0mm_W2.5mm_P5.00mm
R4, R5, R6, R8, R9, R10, R11, R12, R13, R14: 10K; R_Axial_DIN0207_L6.3mm_D2.5mm_P10.16mm_Horizontal
R7: 4.7K; R_Axial_DIN0207_L6.3mm_D2.5mm_P10.16mm_Horizontal
U2: MC68000; DIP-64_W22.86mm

Connections:
+5V: C2.1, C3.1, R4.1, R5.1, R6.1, R7.1, R8.1, R9.1, R10.1, R11.1, R12.1, R13.1, R14.1, U2.14 (V_{CC}), U2.49 (V_{CC}); also elsewhere on the board
A1: U2.29 (A1); also elsewhere on the board
A2: U2.30 (A2); also elsewhere on the board
A3: U2.31 (A3); also elsewhere on the board
A4: U2.32 (A4); also elsewhere on the board
A5: U2.33 (A5); also elsewhere on the board
A6: U2.34 (A6); also elsewhere on the board
A7: U2.35 (A7); also elsewhere on the board
A8: U2.36 (A8); also elsewhere on the board
A9: U2.37 (A9); also elsewhere on the board
A10: U2.38 (A10); also elsewhere on the board
A11: U2.39 (A11); also elsewhere on the board
A12: U2.40 (A12); also elsewhere on the board
A13: U2.41 (A13); also elsewhere on the board
A14: U2.42 (A14); also elsewhere on the board
A15: U2.43 (A15); also elsewhere on the board
A16: U2.44 (A16); also elsewhere on the board
A17: U2.45 (A17); also elsewhere on the board
A18: U2.46 (A18); also elsewhere on the board
A19: U2.47 (A19); also elsewhere on the board
A20: U2.48 (A20); also elsewhere on the board
A21: U2.50 (A21); also elsewhere on the board
A22: U2.51 (A22); also elsewhere on the board
A23: U2.52 (A23); also elsewhere on the board
D0: U2.5 (D0); also elsewhere on the board
D1: U2.4 (D1); also elsewhere on the board
D2: U2.3 (D2); also elsewhere on the board
D3: U2.2 (D3); also elsewhere on the board
D4: U2.1 (D4); also elsewhere on the board
D5: U2.64 (D5); also elsewhere on the board
D6: U2.63 (D6); also elsewhere on the board
D7: U2.62 (D7); also elsewhere on the board
D8: U2.61 (D8); also elsewhere on the board
D9: U2.60 (D9); also elsewhere on the board
D10: U2.59 (D10); also elsewhere on the board
D11: U2.58 (D11); also elsewhere on the board
D12: U2.57 (D12); also elsewhere on the board
D13: U2.56 (D13); also elsewhere on the board
D14: U2.55 (D14); also elsewhere on the board
D15: U2.54 (D15); also elsewhere on the board
FC0: R6.2, U2.28 (FC0); also elsewhere on the board
FC1: R9.2, U2.27 (FC1); also elsewhere on the board
FC2: R11.2, U2.26 (FC2); also elsewhere on the board
GND: C2.2, C3.2, U2.16 (GND), U2.53 (GND); also elsewhere on the board
R/~W: R10.2, U2.9 (R/~W); also elsewhere on the board
SYSCLK: U2.15 (CLK); also elsewhere on the board
~AS: R8.2, U2.6 (~AS); also elsewhere on the board
~BERR: U2.22 (~BERR); also elsewhere on the board
~BGACK: R5.2, U2.12 (~BGACK); also elsewhere on the board
~BG: U2.11 (~BG); also elsewhere on the board
~BR: R4.2, U2.13 (~BR); also elsewhere on the board
~DTACK: U2.10 (~DTACK); also elsewhere on the board
~HALT: R7.2, U2.17 (~HALT); also elsewhere on the board
~IPL0: U2.25 (~IPL0); also elsewhere on the board
~IPL1: U2.24 (~IPL1); also elsewhere on the board
~IPL2: U2.23 (~IPL2); also elsewhere on the board
~LDS: R13.2, U2.8 (~LDS); also elsewhere on the board
~RESET: U2.18 (~RESET); also elsewhere on the board
~UDS: R12.2, U2.7 (~UDS); also elsewhere on the board
~VPA: R14.2, U2.21 (~VPA); also elsewhere on the board

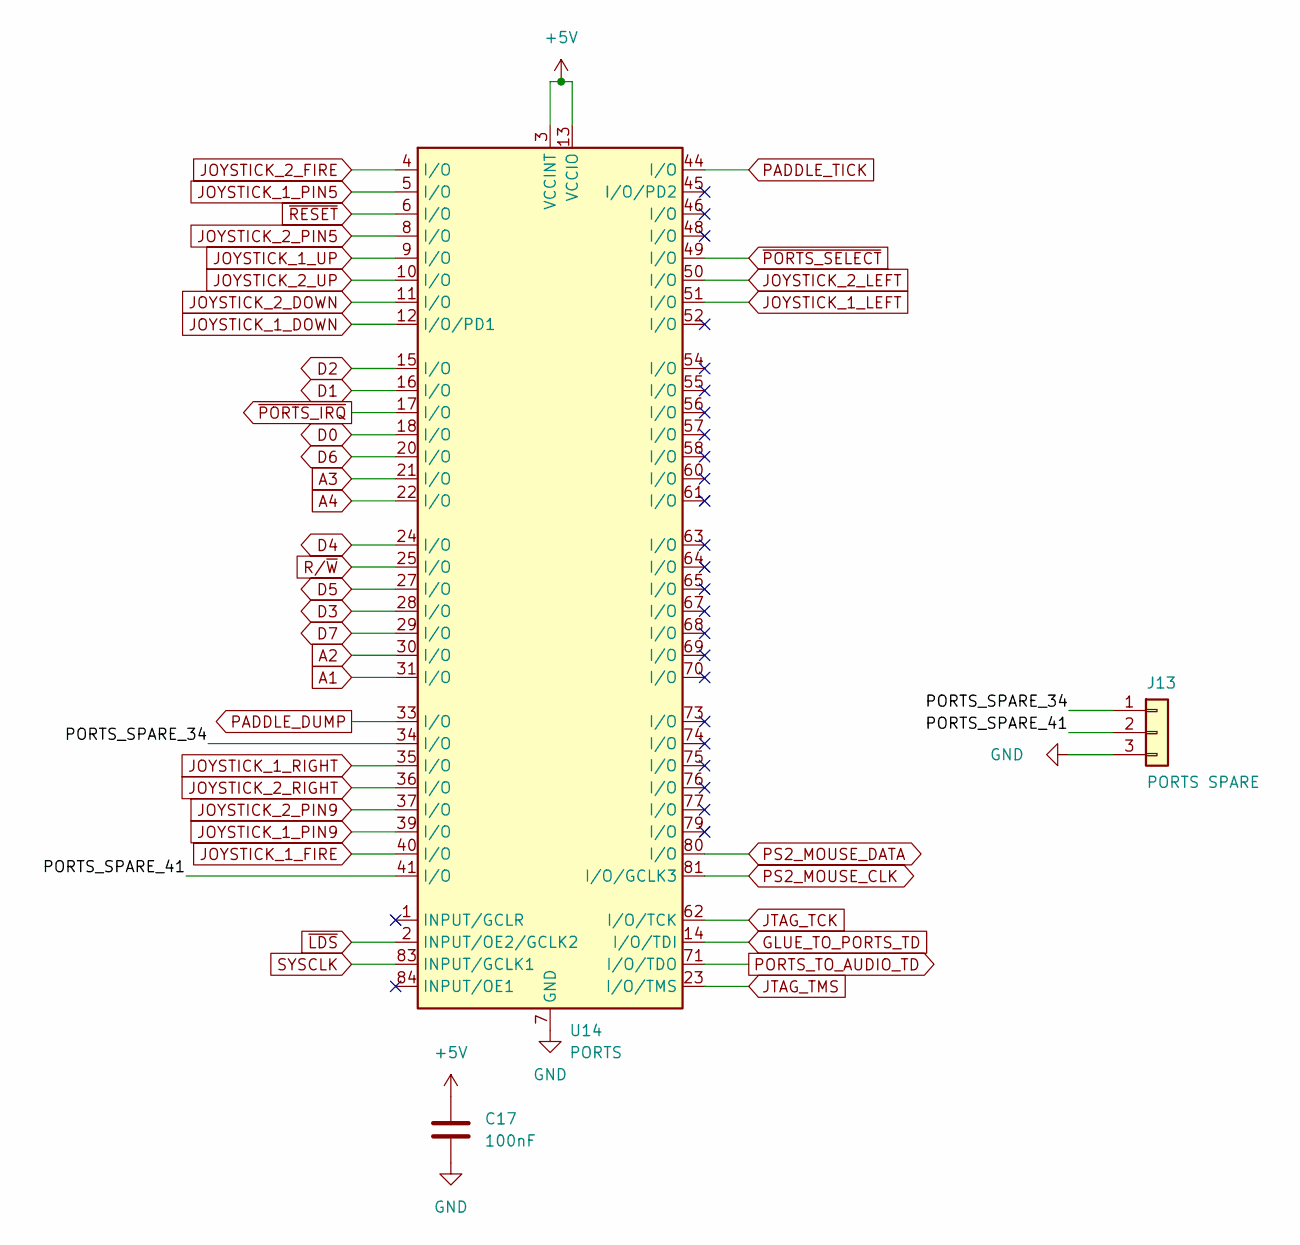
[picture p65: schematic ports.kicad_sch]

Parts:
C17: 100nF; C_Disc_D5.0mm_W2.5mm_P5.00mm
J13: PORTS SPARE; PinHeader_1x03_P2.54mm_Vertical
U14: PORTS; PLCC-84_THT-Socket

Connections:
+5V: C17.1, U14.3 (VCCINT), U14.13 (VCCIO), U14.26 (VCCIO), U14.38 (VCCIO), U14.43 (VCCINT), U14.53 (VCCIO), U14.66 (VCCIO), U14.78 (VCCIO); also elsewhere on the board
/PORTS/PORTS_SPARE_34: J13.1, U14.34 (I/O)
/PORTS/PORTS_SPARE_41: J13.2, U14.41 (I/O)
A1: U14.31 (I/O); also elsewhere on the board
A2: U14.30 (I/O); also elsewhere on the board
A3: U14.21 (I/O); also elsewhere on the board
A4: U14.22 (I/O); also elsewhere on the board
D0: U14.18 (I/O); also elsewhere on the board
D1: U14.16 (I/O); also elsewhere on the board
D2: U14.15 (I/O); also elsewhere on the board
D3: U14.28 (I/O); also elsewhere on the board
D4: U14.24 (I/O); also elsewhere on the board
D5: U14.27 (I/O); also elsewhere on the board
D6: U14.20 (I/O); also elsewhere on the board
D7: U14.29 (I/O); also elsewhere on the board
GLUE_TO_PORTS_TD: U14.14 (I/O/TDI); also elsewhere on the board
GND: C17.2, J13.3, U14.7 (GND), U14.19 (GND), U14.32 (GND), U14.42 (GND), U14.47 (GND), U14.59 (GND), U14.72 (GND), U14.82 (GND); also elsewhere on the board
JOYSTICK_1_DOWN: U14.12 (I/O/PD1); also elsewhere on the board
JOYSTICK_1_FIRE: U14.40 (I/O); also elsewhere on the board
JOYSTICK_1_LEFT: U14.51 (I/O); also elsewhere on the board
JOYSTICK_1_PIN5: U14.5 (I/O); also elsewhere on the board
JOYSTICK_1_PIN9: U14.39 (I/O); also elsewhere on the board
JOYSTICK_1_RIGHT: U14.35 (I/O); also elsewhere on the board
JOYSTICK_1_UP: U14.9 (I/O); also elsewhere on the board
JOYSTICK_2_DOWN: U14.11 (I/O); also elsewhere on the board
JOYSTICK_2_FIRE: U14.4 (I/O); also elsewhere on the board
JOYSTICK_2_LEFT: U14.50 (I/O); also elsewhere on the board
JOYSTICK_2_PIN5: U14.8 (I/O); also elsewhere on the board
JOYSTICK_2_PIN9: U14.37 (I/O); also elsewhere on the board
JOYSTICK_2_RIGHT: U14.36 (I/O); also elsewhere on the board
JOYSTICK_2_UP: U14.10 (I/O); also elsewhere on the board
JTAG_TCK: U14.62 (I/O/TCK); also elsewhere on the board
JTAG_TMS: U14.23 (I/O/TMS); also elsewhere on the board
PADDLE_DUMP: U14.33 (I/O); also elsewhere on the board
PADDLE_TICK: U14.44 (I/O); also elsewhere on the board
PORTS_TO_AUDIO_TD: U14.71 (I/O/TDO); also elsewhere on the board
PS2_MOUSE_CLK: U14.81 (I/O/GCLK3); also elsewhere on the board
PS2_MOUSE_DATA: U14.80 (I/O); also elsewhere on the board
R/~W: U14.25 (I/O); also elsewhere on the board
SYSCLK: U14.83 (INPUT/GCLK1); also elsewhere on the board
~LDS: U14.2 (INPUT/OE2/GCLK2); also elsewhere on the board
~PORTS_IRQ: U14.17 (I/O); also elsewhere on the board
~PORTS_SELECT: U14.49 (I/O); also elsewhere on the board
~RESET: U14.6 (I/O); also elsewhere on the board

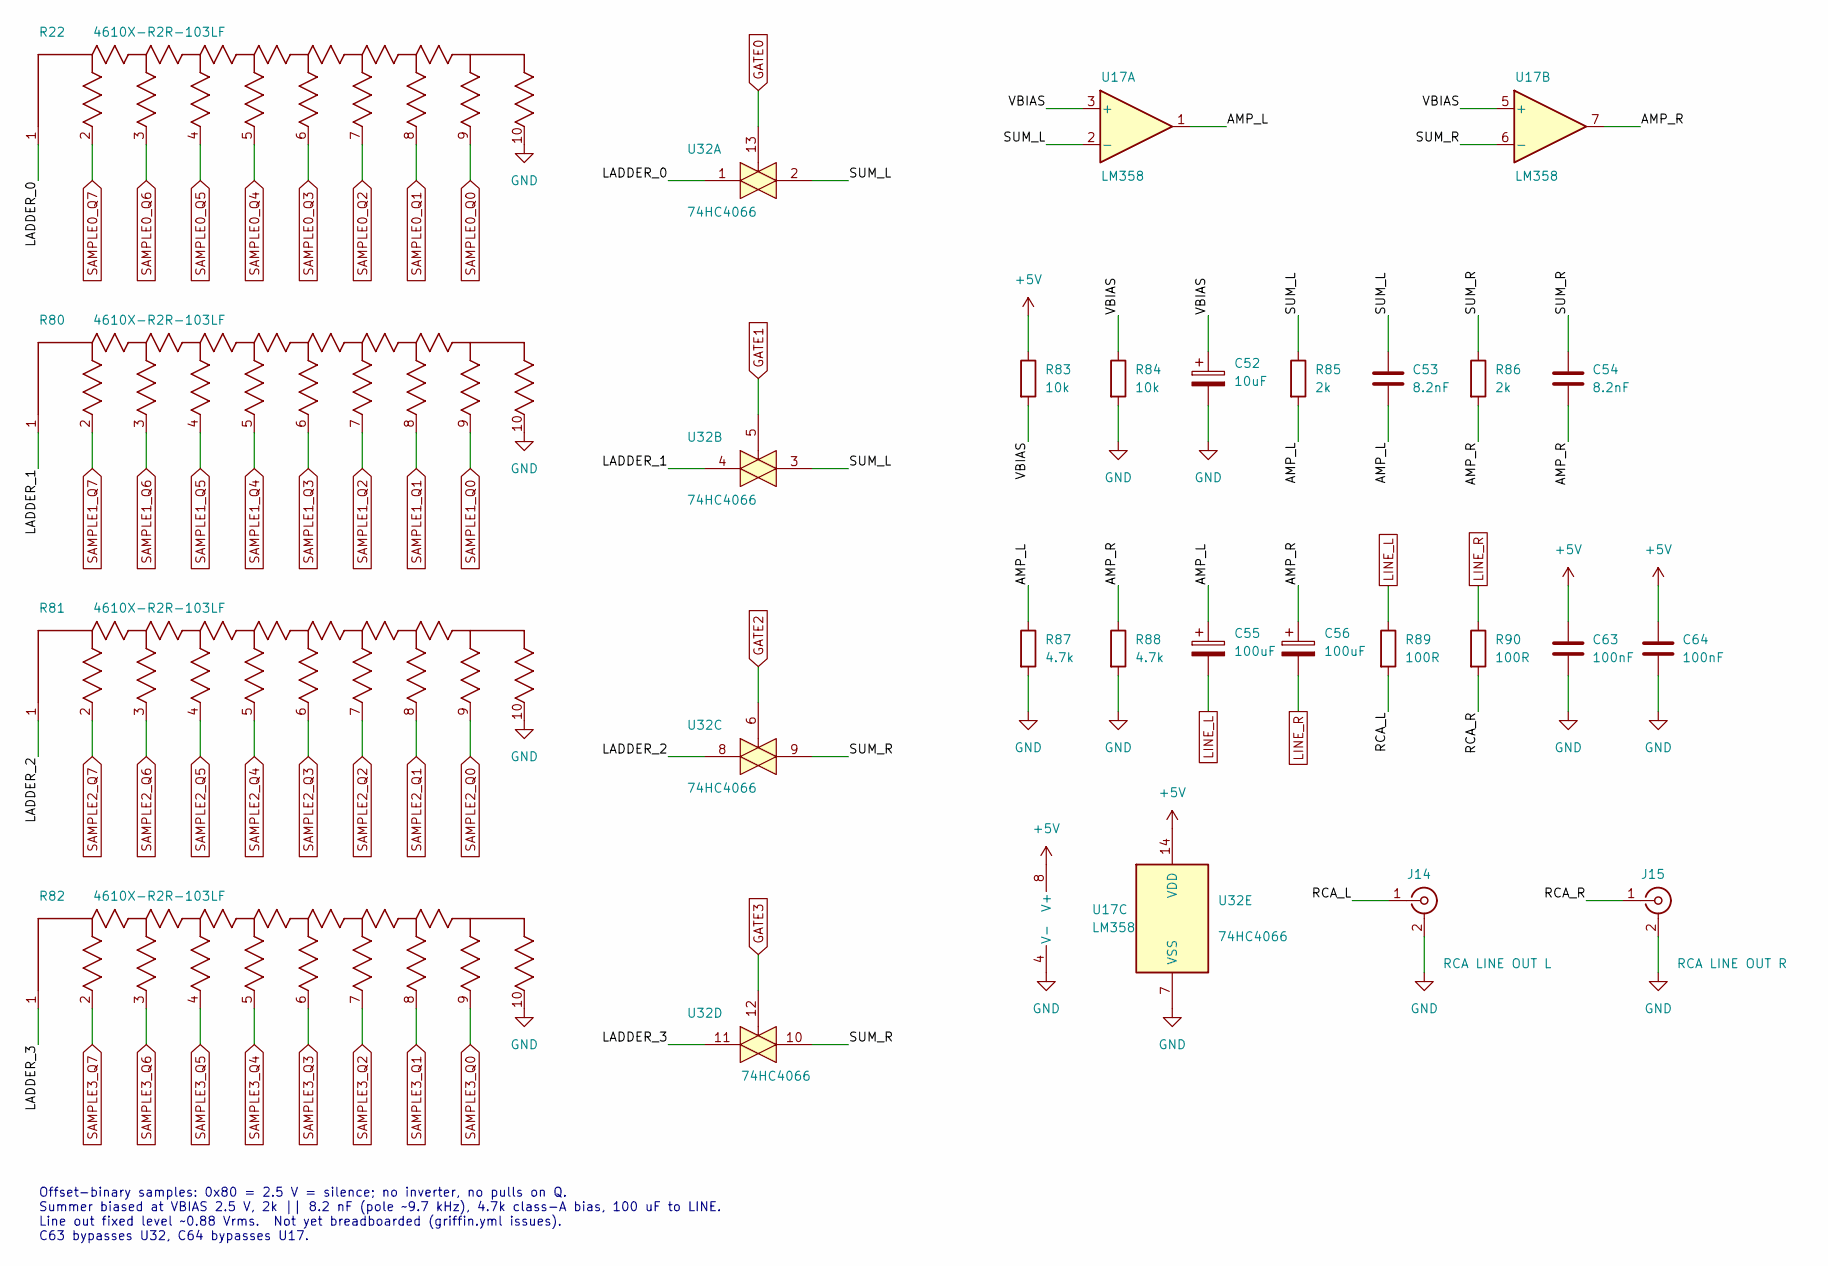
[picture p66: schematic audio-dac.kicad_sch]

Parts:
C52: 10uF; CP_Radial_D5.0mm_P2.00mm
C53, C54: 8.2nF; C_Rect_L7.2mm_W2.5mm_P5.00mm
C55, C56: 100uF; CP_Radial_D6.3mm_P2.50mm
C63, C64: 100nF; C_Disc_D5.0mm_W2.5mm_P5.00mm
J14: RCA LINE OUT L; CUI_RCJ-044
J15: RCA LINE OUT R; CUI_RCJ-044
R22, R80, R81, R82: 4610X-R2R-103LF; BO_4610X
R83, R84: 10k; R_Axial_DIN0207_L6.3mm_D2.5mm_P10.16mm_Horizontal
R85, R86: 2k; R_Axial_DIN0207_L6.3mm_D2.5mm_P10.16mm_Horizontal
R87, R88: 4.7k; R_Axial_DIN0207_L6.3mm_D2.5mm_P10.16mm_Horizontal
R89, R90: 100R; R_Axial_DIN0207_L6.3mm_D2.5mm_P10.16mm_Horizontal
U17: LM358; DIP-8_W7.62mm
U32: 74HC4066; DIP-14_W7.62mm

Connections:
+5V: C63.1, C64.1, R83.1, U17.8 (V+), U32.14 (VDD); also elsewhere on the board
/AUDIO_DAC/AMP_L: C53.2, C55.1, R85.2, R87.1, U17.1
/AUDIO_DAC/AMP_R: C54.2, C56.1, R86.2, R88.1, U17.7
/AUDIO_DAC/LADDER_0: R22.1, U32.1
/AUDIO_DAC/LADDER_1: R80.1, U32.4
/AUDIO_DAC/LADDER_2: R81.1, U32.8
/AUDIO_DAC/LADDER_3: R82.1, U32.11
/AUDIO_DAC/RCA_L: J14.1 (In), R89.2
/AUDIO_DAC/RCA_R: J15.1 (In), R90.2
/AUDIO_DAC/SUM_L: C53.1, R85.1, U17.2 (-), U32.2, U32.3
/AUDIO_DAC/SUM_R: C54.1, R86.1, U17.6 (-), U32.9, U32.10
/AUDIO_DAC/VBIAS: C52.1, R83.2, R84.1, U17.3 (+), U17.5 (+)
GATE0: U32.13; also elsewhere on the board
GATE1: U32.5; also elsewhere on the board
GATE2: U32.6; also elsewhere on the board
GATE3: U32.12; also elsewhere on the board
GND: C52.2, C63.2, C64.2, J14.2 (Ext), J15.2 (Ext), R22.10, R80.10, R81.10, R82.10, R84.2, R87.2, R88.2, U17.4 (V-), U32.7 (VSS); also elsewhere on the board
LINE_L: C55.2, R89.1; also elsewhere on the board
LINE_R: C56.2, R90.1; also elsewhere on the board
SAMPLE0_Q0: R22.9; also elsewhere on the board
SAMPLE0_Q1: R22.8; also elsewhere on the board
SAMPLE0_Q2: R22.7; also elsewhere on the board
SAMPLE0_Q3: R22.6; also elsewhere on the board
SAMPLE0_Q4: R22.5; also elsewhere on the board
SAMPLE0_Q5: R22.4; also elsewhere on the board
SAMPLE0_Q6: R22.3; also elsewhere on the board
SAMPLE0_Q7: R22.2; also elsewhere on the board
SAMPLE1_Q0: R80.9; also elsewhere on the board
SAMPLE1_Q1: R80.8; also elsewhere on the board
SAMPLE1_Q2: R80.7; also elsewhere on the board
SAMPLE1_Q3: R80.6; also elsewhere on the board
SAMPLE1_Q4: R80.5; also elsewhere on the board
SAMPLE1_Q5: R80.4; also elsewhere on the board
SAMPLE1_Q6: R80.3; also elsewhere on the board
SAMPLE1_Q7: R80.2; also elsewhere on the board
SAMPLE2_Q0: R81.9; also elsewhere on the board
SAMPLE2_Q1: R81.8; also elsewhere on the board
SAMPLE2_Q2: R81.7; also elsewhere on the board
SAMPLE2_Q3: R81.6; also elsewhere on the board
SAMPLE2_Q4: R81.5; also elsewhere on the board
SAMPLE2_Q5: R81.4; also elsewhere on the board
SAMPLE2_Q6: R81.3; also elsewhere on the board
SAMPLE2_Q7: R81.2; also elsewhere on the board
SAMPLE3_Q0: R82.9; also elsewhere on the board
SAMPLE3_Q1: R82.8; also elsewhere on the board
SAMPLE3_Q2: R82.7; also elsewhere on the board
SAMPLE3_Q3: R82.6; also elsewhere on the board
SAMPLE3_Q4: R82.5; also elsewhere on the board
SAMPLE3_Q5: R82.4; also elsewhere on the board
SAMPLE3_Q6: R82.3; also elsewhere on the board
SAMPLE3_Q7: R82.2; also elsewhere on the board

Notes on the sheet:
Offset-binary samples: 0x80 = 2.5 V = silence; no inverter, no pulls on Q. Summer biased at VBIAS 2.5 V, 2k || 8.2 nF (pole ~9.7 kHz), 4.7k class-A bias, 100 uF to LINE. Line out fixed level ~0.88 Vrms. Not yet breadboarded (griffin.yml issues). C63 bypasses U32, C64 bypasses U17.

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
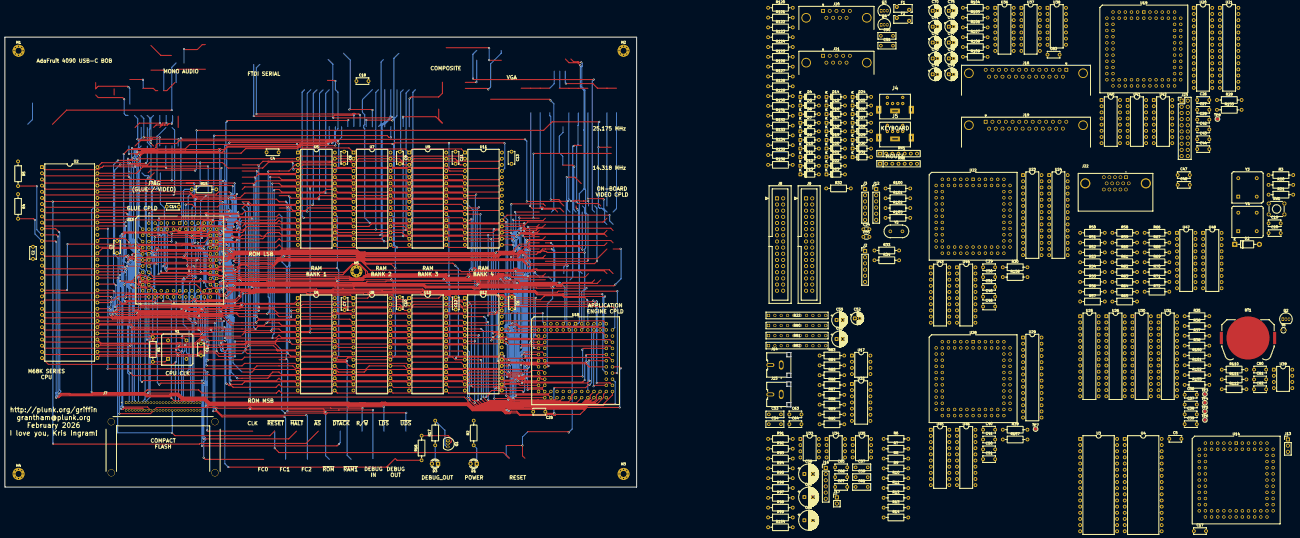
[picture p67: board board.kicad_pcb from above]

Board: 4 copper layers, 324.3 x 185.6 mm, 305 parts (0 on the bottom side), 443 nets.
