bradgrantham/griffin/super-engine/main.cpp

// main.cpp — drive every validation case, print the budget report, write the
// artifacts, and exit nonzero if anything failed.
//
// First host-side test in this repo, so: no test framework, assert-with-message
// only.  A failing check prints file:line and a sentence and bumps a counter;
// every case still runs, because the point of the suite is the *table*, not the
// first stop.  Everything is integer arithmetic seeded from constants, so two
// runs produce byte-identical stdout and byte-identical artifacts.

#include <cstdint>
#include <cstdio>
#include <cstdlib>
#include <cstring>
#include <string>
#include <vector>

#include "author.h"
#include "descriptor.h"
#include "interpret.h"
#include "render.h"

#include "../apps/lib/griffin_cursor.h"
#include "../apps/lib/griffin_cursor_chain.h"

using namespace SuperEngine;

namespace
{

int g_failures = 0;

#define CHECK(cond, ...)                                              \
    do                                                                \
    {                                                                 \
        if (!(cond))                                                  \
        {                                                             \
            fprintf(stderr, "  FAIL %s:%d: ", __FILE__, __LINE__);     \
            fprintf(stderr, __VA_ARGS__);                             \
            fprintf(stderr, "\n");                                    \
            g_failures++;                                             \
        }                                                             \
    } while (0)

// ---------------------------------------------------------------------------
// RAM map for the suite
// ---------------------------------------------------------------------------
//
// One flat 4 MB image, exactly what the engine sees.  Regions are spaced out
// rather than packed so a descriptor that walks off the end of one lands in
// zeroes rather than in the next region's data.
//
// Note what is NOT here any more: there is no palette table and no register
// scratch area.  Palette, mode and pixel_skip values now live inside the VIDCMD
// SET words themselves, which removed a whole class of aliasing bug — the
// previous round of this suite had two frames' lists sharing one MODE scratch
// word, and frame N+1's pixel_skip leaked into frame N's deposits.

constexpr uint32_t FB_BASE            = 0x001000;
constexpr uint32_t FB_STRIDE_BYTES    = 88;    // 704 pixels: 640 visible + 64 of scroll
constexpr uint32_t FB_WORDS_PER_LINE  = FB_STRIDE_BYTES / 2;
constexpr uint32_t FB_LINES           = 600;   // 480 visible + 120 of vertical scroll

// The two entries a plain 1bpp playfield selects at pix_base 0.  Distinct from
// every held colour the sprite cases use, so a visibility count can tell
// composited pixels from playfield ones.
inline constexpr Rgb444 PLAYFIELD_BG = rgb444(0, 0, 5);
inline constexpr Rgb444 PLAYFIELD_FG = rgb444(10, 10, 2);

// The sixteen-entry palette the deeper modes load, once per frame.  Distinct,
// non-black and nowhere near the compositor's held colours, so a pixel's colour
// names its entry and a missing load (the RAM powers up random) is obvious.
inline constexpr std::array<Rgb444, PALETTE_ENTRIES> TEST_PALETTE = {
    rgb444(1, 1, 1),    rgb444(15, 0, 0),   rgb444(0, 15, 0),   rgb444(0, 0, 15),
    rgb444(15, 15, 0),  rgb444(15, 0, 15),  rgb444(0, 15, 15),  rgb444(9, 9, 9),
    rgb444(7, 3, 0),    rgb444(3, 7, 0),    rgb444(0, 3, 7),    rgb444(7, 0, 3),
    rgb444(12, 6, 3),   rgb444(3, 12, 6),   rgb444(6, 3, 12),   rgb444(14, 14, 10),
};

constexpr uint32_t FB_SOLID_BASE      = 0x010000;   // every bit set, for the slot regression
constexpr uint32_t FB_WEB_BASE        = 0x040000;   // the Tempest wireframe, drawn once

// The three deeper planes, all 80 words a line and all given the same 88-word
// stride with scroll headroom.  ONE buffer serves both rates in each: a
// HALF-RATE line consumes the first half of the words, so the half-rate
// expectation is the full-rate one indexed by k/2.
constexpr uint32_t FB_IDX2_BASE       = 0x080000;   // 2bpp, 80 words
constexpr uint32_t FB_IDX2_STRIDE     = 176;
constexpr uint32_t FB_IDX4_BASE       = 0x020000;   // 4bpp half rate, 80 words
constexpr uint32_t FB_IDX4_STRIDE     = 176;
constexpr uint32_t FB_ATTR_BASE       = 0x0A0000;   // attribute cells, 80 / 40 words
constexpr uint32_t FB_ATTR_STRIDE     = 176;

// The VIDCMD records are per-frame data — they carry this frame's palette
// ramp, its pixel_skip and its tile masks — so they need double buffering
// exactly as much as the descriptor table does.  Only the table has to live in
// the top 64K; the VIDCMD regions are ordinary RAM, which makes it easy to
// forget that the CPU is authoring frame N+1's records while the engine is
// still reading frame N's.
// m11-static-pieces: the read-only fragments a sprite line is assembled from,
// and the scratch area the monolithic form copies them into.  Both are written
// once, before any frame, which is the whole claim of the pieces form.
constexpr uint32_t SP_DATA_BASE         = 0x200000;
constexpr uint32_t SP_PROGRAM_BASE      = 0x210000;

constexpr uint32_t VIDCMD_BASE          = 0x100000;
constexpr uint32_t VIDCMD_REGION_BYTES  = 0x028000;   // 480 lines x 320 bytes, rounded up
constexpr uint32_t AUDIO_BASE           = 0x060000;
constexpr uint32_t AUDIO_SOURCE_PAIRS = 1024;

// Two 32K halves of the 64K descriptor window: the CPU authors the next frame's
// list into the half the engine is not reading.  M5 asserts the halves really
// are disjoint from every address the running list touches.
constexpr uint32_t TABLE_A            = DESC_TABLE_BASE;
constexpr uint32_t TABLE_B            = DESC_TABLE_BASE + DESC_TABLE_BYTES / 2;
constexpr uint32_t TABLE_HALF_BYTES   = DESC_TABLE_BYTES / 2;

// The audio FIFOs start empty, so the very first list has to prime them as
// well as carry vertical blanking's share.  A real driver does this once at
// startup (audio/scheduler.h keeps a margin instead); here it is one bigger
// preamble on list A.  Without it the steady-state low water is 1 sample.
constexpr uint32_t AUDIO_PRIME_PAIRS  = 48;

// ---------------------------------------------------------------------------
// Frame lock
// ---------------------------------------------------------------------------
//
// Every list ends on a wait_hblank/stop_after pacer, so nENGINE_IRQ always
// fires just after raster line 479's HBLANK edge no matter how heavy the frame
// was.  The ISR then re-arms somewhere inside line 480, and the list's leading
// wait_hblank pacers walk it to the top of frame: lines 480..523 is 44 HBLANK
// edges, after which the first *pixel* group's wait lands on line 524's edge
// and its words are consumed by line 0 of the next raster frame.
//
// Consequence: the images this suite renders are raster frames 1 and 2, never
// frame 0, which is the frame during which the engine gets armed.
constexpr uint32_t VBLANK_PACING_LINES = 44;
constexpr uint32_t FIRST_ARM_LINE      = 480;
constexpr uint32_t FIRST_ARM_PIXEL     = 100;   // comfortably before that line's h=640
constexpr uint32_t RENDER_FIRST_FRAME  = 1;
constexpr uint32_t RENDER_FRAMES       = 2;

// 68000 interrupt latency plus the ISR's table swap and DESC write.  200 SYSCLK
// is 14.3 us at 14 MHz; case M5 measures how much more the list can absorb
// before it slips a line.
constexpr uint64_t REARM_LATENCY_CYCLES = 200;

uint64_t first_arm_cycle()
{
    return sysclk_of_pixel(static_cast<uint64_t>(FIRST_ARM_LINE) * H_TOTAL + FIRST_ARM_PIXEL);
}

uint64_t run_end_cycle()
{
    const uint64_t frames = RENDER_FIRST_FRAME + RENDER_FRAMES;
    return sysclk_of_pixel((frames * V_TOTAL + 1) * static_cast<uint64_t>(H_TOTAL));
}

// ---------------------------------------------------------------------------
// Artifact writers
// ---------------------------------------------------------------------------

void write_ppm(const std::string &path, const FrameImage &img)
{
    FILE *f = fopen(path.c_str(), "wb");
    if (f == nullptr)
    {
        fprintf(stderr, "  FAIL cannot open %s for writing\n", path.c_str());
        g_failures++;
        return;
    }
    fprintf(f, "P6\n%u %u\n255\n", H_ACTIVE, V_ACTIVE);
    std::vector<uint8_t> row(static_cast<size_t>(H_ACTIVE) * 3);
    for (uint32_t y = 0; y < V_ACTIVE; y++)
    {
        for (uint32_t x = 0; x < H_ACTIVE; x++)
        {
            uint8_t r = 0;
            uint8_t g = 0;
            uint8_t b = 0;
            rgb444_to_rgb888(img.pixels[y * H_ACTIVE + x], r, g, b);
            row[x * 3 + 0] = r;
            row[x * 3 + 1] = g;
            row[x * 3 + 2] = b;
        }
        fwrite(row.data(), 1, row.size(), f);
    }
    fclose(f);
}

void put_u32_le(FILE *f, uint32_t v)
{
    const uint8_t b[4] = {static_cast<uint8_t>(v), static_cast<uint8_t>(v >> 8),
                          static_cast<uint8_t>(v >> 16), static_cast<uint8_t>(v >> 24)};
    fwrite(b, 1, 4, f);
}

void put_u16_le(FILE *f, uint16_t v)
{
    const uint8_t b[2] = {static_cast<uint8_t>(v), static_cast<uint8_t>(v >> 8)};
    fwrite(b, 1, 2, f);
}

// 8-bit unsigned stereo PCM, the format the deposit word already is.  Audio was
// not touched by the move to 12-bit colour.
void write_wav(const std::string &path, const std::vector<uint8_t> &samples)
{
    FILE *f = fopen(path.c_str(), "wb");
    if (f == nullptr)
    {
        fprintf(stderr, "  FAIL cannot open %s for writing\n", path.c_str());
        g_failures++;
        return;
    }
    const uint32_t data_bytes = static_cast<uint32_t>(samples.size());
    fwrite("RIFF", 1, 4, f);
    put_u32_le(f, 36 + data_bytes);
    fwrite("WAVEfmt ", 1, 8, f);
    put_u32_le(f, 16);                       // PCM fmt chunk size
    put_u16_le(f, 1);                        // PCM
    put_u16_le(f, 2);                        // stereo
    put_u32_le(f, AUDIO_SAMPLE_RATE);
    put_u32_le(f, AUDIO_SAMPLE_RATE * 2);    // byte rate
    put_u16_le(f, 2);                        // block align
    put_u16_le(f, 8);                        // bits per sample
    fwrite("data", 1, 4, f);
    put_u32_le(f, data_bytes);
    fwrite(samples.data(), 1, data_bytes, f);
    fclose(f);
}

// ---------------------------------------------------------------------------
// Static-asset drawing: the Tempest well
// ---------------------------------------------------------------------------
//
// This models the CPU rasterizing a level's wireframe into the 1bpp bitmap
// once, at level start.  Integer Bresenham, no floating point, so the asset is
// byte-identical on every host and between runs.  Nothing here runs per frame —
// that is the entire claim the tempest-web case exists to demonstrate.

void plot_1bpp(Memory ram, uint32_t base, uint32_t stride, int32_t x, int32_t y)
{
    if (x < 0 || y < 0 || x >= static_cast<int32_t>(H_ACTIVE) ||
        y >= static_cast<int32_t>(V_ACTIVE))
    {
        return;
    }
    const uint32_t addr = base + static_cast<uint32_t>(y) * stride +
                          (static_cast<uint32_t>(x) / 16u) * 2u;
    ram[addr] = static_cast<uint16_t>(ram[addr] | (0x8000u >> (static_cast<uint32_t>(x) % 16u)));
}

void draw_line_1bpp(Memory ram, uint32_t base, uint32_t stride,
                    int32_t x0, int32_t y0, int32_t x1, int32_t y1)
{
    const int32_t dx = (x1 > x0) ? (x1 - x0) : (x0 - x1);
    const int32_t dy = (y1 > y0) ? (y0 - y1) : (y1 - y0);   // negative magnitude
    const int32_t sx = (x0 < x1) ? 1 : -1;
    const int32_t sy = (y0 < y1) ? 1 : -1;
    int32_t err = dx + dy;

    for (;;)
    {
        plot_1bpp(ram, base, stride, x0, y0);
        if (x0 == x1 && y0 == y1)
        {
            break;
        }
        const int32_t e2 = 2 * err;
        if (e2 >= dy)
        {
            err += dy;
            x0 += sx;
        }
        if (e2 <= dx)
        {
            err += dx;
            y0 += sy;
        }
    }
}

// 16 lanes: the near (outer) rim polygon, the far (inner) rim polygon, and a
// spoke joining each pair of corresponding vertices.
void draw_tempest_web(Memory ram, uint32_t base, uint32_t stride)
{
    for (uint32_t i = 0; i < TEMPEST_LANES; i++)
    {
        const uint32_t j = (i + 1) % TEMPEST_LANES;
        draw_line_1bpp(ram, base, stride, tempest_outer_x(i), tempest_outer_y(i),
                       tempest_outer_x(j), tempest_outer_y(j));
        draw_line_1bpp(ram, base, stride, tempest_inner_x(i), tempest_inner_y(i),
                       tempest_inner_x(j), tempest_inner_y(j));
        draw_line_1bpp(ram, base, stride, tempest_inner_x(i), tempest_inner_y(i),
                       tempest_outer_x(i), tempest_outer_y(i));
    }
}

// Cheap order-sensitive checksum, used to prove the bitmap is never rewritten.
uint32_t checksum_region(Memory ram, uint32_t base, uint32_t bytes)
{
    uint32_t h = 2166136261u;
    for (uint32_t off = 0; off < bytes; off += 2)
    {
        h = (h ^ ram[base + off]) * 16777619u;
    }
    return h;
}

// ---------------------------------------------------------------------------
// Case plumbing
// ---------------------------------------------------------------------------

struct CaseSpec
{
    std::string name;
    std::string title;
    FrameParams base;
    uint32_t    v_scroll_step = 0;
    uint32_t    h_scroll_step = 0;
};

struct GroupBudget
{
    uint32_t max_busy   = 0;
    double   mean_busy  = 0.0;
    uint32_t max_spill  = 0;
    double   mean_spill = 0.0;
    uint32_t max_active = 0;
};

// Per-line budget over the groups that actually feed displayed lines; the 44
// vblank pacers and the vblank preamble are deliberately excluded so the
// numbers mean "what a visible scanline costs".
GroupBudget group_budget(const InterpretResult &ir)
{
    GroupBudget b;
    uint64_t total_busy  = 0;
    uint64_t total_spill = 0;
    uint32_t n           = 0;

    for (uint32_t frame = RENDER_FIRST_FRAME; frame < RENDER_FIRST_FRAME + RENDER_FRAMES; frame++)
    {
        for (uint32_t line = 0; line < V_ACTIVE; line++)
        {
            const size_t g = static_cast<size_t>(frame) * V_TOTAL + line;
            if (g >= ir.groups.size() || !ir.groups[g].used)
            {
                continue;
            }
            const GroupStat &s = ir.groups[g];
            total_busy += s.busy_cycles;
            n++;
            if (s.busy_cycles > b.max_busy)
            {
                b.max_busy = s.busy_cycles;
            }
            if (s.active_busy_cycles > b.max_active)
            {
                b.max_active = s.active_busy_cycles;
            }

            const uint64_t hblank_end = sysclk_of_pixel(static_cast<uint64_t>(g) * H_TOTAL);
            const uint32_t spill = (s.last_busy_end > hblank_end)
                                       ? static_cast<uint32_t>(s.last_busy_end - hblank_end)
                                       : 0u;
            total_spill += spill;
            if (spill > b.max_spill)
            {
                b.max_spill = spill;
            }
        }
    }

    if (n > 0)
    {
        b.mean_busy  = static_cast<double>(total_busy) / n;
        b.mean_spill = static_cast<double>(total_spill) / n;
    }
    return b;
}

struct CaseResult
{
    AuthorResult    author[RENDER_FRAMES];
    InterpretResult interp;
    RenderResult    rendered;
    GroupBudget     budget;
    uint32_t        vidcmd_words_total = 0;
    uint32_t        vidcmd_words_min   = 0xFFFFFFFF;
    uint32_t        vidcmd_words_max   = 0;
    double          vidcmd_words_mean  = 0.0;
    uint32_t        vidcmd_records_max = 0;
    double          vidcmd_records_mean = 0.0;
    uint32_t        vidcmd_slot_min    = 0xFFFFFFFF;
    uint32_t        vidcmd_slot_max    = 0;
    uint32_t        vidcmd_stretch_max = 0;
    uint32_t        vidcmd_stretch_lines = 0;
    std::vector<uint8_t>     line_words;   // frame 2's per-line VIDCMD word count
    std::vector<std::string> artifacts;
};

// Build both frames' lists and run them back to back through the interpreter.
CaseResult run_case(const CaseSpec &spec, Memory ram, uint64_t rearm_latency)
{
    CaseResult out;

    const uint32_t tables[RENDER_FRAMES] = {TABLE_A, TABLE_B};
    InterpretParams ip;
    ip.arbitration_cycles   = spec.base.arbitration_cycles;
    ip.start_cycle          = first_arm_cycle();
    ip.end_cycle            = run_end_cycle();
    ip.rearm_latency_cycles = rearm_latency;

    std::vector<uint8_t>  line_words(V_ACTIVE, 0);
    std::vector<uint8_t>  line_records(V_ACTIVE, 0);
    std::vector<uint16_t> line_slots(V_ACTIVE, 0);
    std::vector<uint16_t> line_stretch(V_ACTIVE, 0);

    uint32_t audio_pair_cursor = 0;
    for (uint32_t f = 0; f < RENDER_FRAMES; f++)
    {
        FrameParams fp         = spec.base;
        fp.table_base          = tables[f];
        fp.table_bytes         = TABLE_HALF_BYTES;
        fp.vidcmd_base         = spec.base.vidcmd_base + f * VIDCMD_REGION_BYTES;
        fp.frame_index         = spec.base.frame_index + f;
        fp.v_scroll_lines      = spec.base.v_scroll_lines + f * spec.v_scroll_step;
        fp.h_scroll_pixels     = spec.base.h_scroll_pixels + f * spec.h_scroll_step;
        fp.vblank_pacing_lines = VBLANK_PACING_LINES;
        fp.audio_preamble_pairs =
            spec.base.audio_preamble_pairs + ((f == 0) ? AUDIO_PRIME_PAIRS : 0);
        fp.audio_frame_pair_base = audio_pair_cursor;
        audio_pair_cursor += fp.audio_preamble_pairs +
                             (V_ACTIVE / spec.base.audio_burst_interval) * spec.base.audio_burst_pairs;

        write_vidcmd_records(fp, ram, line_words, line_records, line_slots, line_stretch);

        out.author[f] = author_frame(fp, ram, line_words);
        ip.arm_addresses.push_back(tables[f]);

        // Accumulate over BOTH frames: the tempest case moves its objects
        // between them, so frame 2 can be the denser one.
        uint32_t words_sum   = 0;
        uint32_t records_sum = 0;
        for (uint32_t line = 0; line < V_ACTIVE; line++)
        {
            words_sum += line_words[line];
            records_sum += line_records[line];
            if (line_words[line] < out.vidcmd_words_min)   { out.vidcmd_words_min = line_words[line]; }
            if (line_words[line] > out.vidcmd_words_max)   { out.vidcmd_words_max = line_words[line]; }
            if (line_records[line] > out.vidcmd_records_max) { out.vidcmd_records_max = line_records[line]; }
            if (line_slots[line] < out.vidcmd_slot_min)    { out.vidcmd_slot_min = line_slots[line]; }
            if (line_slots[line] > out.vidcmd_slot_max)    { out.vidcmd_slot_max = line_slots[line]; }
            if (line_stretch[line] > out.vidcmd_stretch_max)
            {
                out.vidcmd_stretch_max = line_stretch[line];
            }
            if (line_stretch[line] > 0)
            {
                out.vidcmd_stretch_lines++;
            }
        }
        if (f == 0)
        {
            out.vidcmd_words_total = words_sum;
        }
        out.vidcmd_words_mean   = static_cast<double>(words_sum) / V_ACTIVE;
        out.vidcmd_records_mean = static_cast<double>(records_sum) / V_ACTIVE;
        out.line_words          = line_words;
    }

    out.interp = interpret(ram, ip);

    RenderParams rp;
    rp.first_frame   = RENDER_FIRST_FRAME;
    rp.frame_count   = RENDER_FRAMES;
    rp.audio_enabled = spec.base.audio;
    rp.skew_pix      = spec.base.skew_pix;
    rp.skew_cmp      = spec.base.skew_cmp;
    out.rendered     = render(out.interp.events, rp);

    out.budget = group_budget(out.interp);
    return out;
}

void print_report(const CaseSpec &spec, const CaseResult &res)
{
    printf("\n=== %s — %s ===\n", spec.name.c_str(), spec.title.c_str());

    const AuthorResult &a0 = res.author[0];
    const AuthorResult &a1 = res.author[1];
    const InterpretResult &ir = res.interp;
    const RenderResult &rr = res.rendered;

    const uint64_t span = (ir.last_cycle > ir.first_cycle) ? (ir.last_cycle - ir.first_cycle) : 1;
    const double util = 100.0 * static_cast<double>(ir.busy_cycles) / static_cast<double>(span);

    printf("  descriptors/frame   %6u          table bytes %6u / %u per half (%u total window)\n",
           a0.descriptor_count, a0.table_bytes, TABLE_HALF_BYTES, DESC_TABLE_BYTES);
    printf("  payload words/frame %6u          of which pacing %u\n",
           a0.payload_words, a0.pacing_words);
    printf("  PIXELS words/line   %6u          VIDCMD words/line %u..%u (mean %.2f), %u/frame\n",
           spec.base.pure_vidcmd
               ? 0u
               : pixel_words_for(spec.base.mode, spec.base.h_scroll_pixels % 16),
           res.vidcmd_words_min, res.vidcmd_words_max, res.vidcmd_words_mean,
           res.vidcmd_words_total);
    printf("  VIDCMD records/line max %3u  mean %.2f\n",
           res.vidcmd_records_max, res.vidcmd_records_mean);
    printf("  VIDCMD slots/line   %6u..%-6u framing %s (%s)\n",
           res.vidcmd_slot_min, res.vidcmd_slot_max,
           (spec.base.framing == FramingMode::CUSHION) ? "CUSHION" : "JIT    ",
           (spec.base.framing == FramingMode::CUSHION) ? "occupancy must be exactly 640"
                                                       : "<= 640, hold covers the rest");
    printf("  VIDCMD cadence      stretch max %3u slot(s) on %u of %u lines "
           "(fetch = %u slots/word)\n",
           res.vidcmd_stretch_max, res.vidcmd_stretch_lines, V_ACTIVE * RENDER_FRAMES,
           VIDCMD_SLOTS_PER_WORD);
    printf("  bus utilization     %6.1f%%         over %llu SYSCLK of the 2-frame run\n",
           util, static_cast<unsigned long long>(span));
    printf("  per-line SYSCLK     max %4u  mean %6.1f   (line = %llu SYSCLK, %.0f%% worst)\n",
           res.budget.max_busy, res.budget.mean_busy,
           static_cast<unsigned long long>(LINE_SYSCLK),
           100.0 * res.budget.max_busy / static_cast<double>(LINE_SYSCLK));
    printf("  HBLANK spill        max %4u  mean %6.1f   (HBLANK = %llu SYSCLK)\n",
           res.budget.max_spill, res.budget.mean_spill,
           static_cast<unsigned long long>(HBLANK_SYSCLK));
    printf("  active-video steal  max %4u SYSCLK/line\n", res.budget.max_active);
    printf("  IRQ count           %6u          descriptors executed %u\n",
           ir.irq_count, ir.descriptor_count);
    printf("  table window used   0x%06X..0x%06X\n", ir.table_low, ir.table_high);

    if (a1.descriptor_count != a0.descriptor_count || a1.table_bytes != a0.table_bytes)
    {
        printf("  frame 2 list        %6u descriptors, %u bytes\n",
               a1.descriptor_count, a1.table_bytes);
    }

    printf("  PIXELS FIFO         high %3u  low %3u  tiled words %u  overflows %u  (depth %u)\n",
           rr.stats.pixels_fifo_high, rr.stats.pixels_fifo_low, rr.stats.pixels_tiled_words,
           rr.stats.pixels_overflows, PIXELS_FIFO_WORDS);
    printf("  PIXELS line-start   banked words min %3u  max %3u\n",
           rr.stats.pixels_line_start_min, rr.stats.pixels_line_start_max);
    printf("  palette             writes %u  bad fillers %u  disturbed-on-DAC %u  "
           "unloaded reads %u\n",
           res.rendered.stats.palette_writes, res.rendered.stats.palette_bad_filler,
           res.rendered.stats.palette_disturbed_visible,
           res.rendered.stats.palette_unwritten_reads);
    printf("  VIDCMD FIFO         high %3u  low %3u  popped %u  overflows %u\n",
           rr.stats.vidcmd_fifo_high, rr.stats.vidcmd_fifo_low, rr.stats.vidcmd_words_popped,
           rr.stats.vidcmd_overflows);
    printf("  VIDCMD holds        cadence %u  starved %u   (cadence = the 2-clock fetch, "
           "starved = a dry FIFO)\n",
           rr.stats.vidcmd_cadence_slots, rr.stats.vidcmd_hold_slots);
    printf("  VIDCMD framing      overruns %u  late words %u  LITERAL %u  MASK %u "
           "(mask stalls %u)  stream leftovers %u\n",
           rr.stats.vidcmd_overruns, rr.stats.vidcmd_late_words, rr.stats.vidcmd_literals,
           rr.stats.vidcmd_mask_records, rr.stats.vidcmd_mask_stalls,
           rr.stats.vidcmd_stream_leftovers);
    if (spec.base.audio)
    {
        printf("  AUDIO FIFO (ch 0)   high %4u low %4u underruns %u  overflows %u  (depth %u)\n",
               rr.audio_fifo_high, rr.audio_fifo_low, rr.audio_underruns,
               rr.audio_overflows, AUDIO_FIFO_SAMPLES);
        printf("  AUDIO samples/ch    %u deposited inside the %u rendered frames, %u consumed\n",
               rr.audio_pairs_deposited, RENDER_FRAMES, rr.audio_pairs_consumed);
    }

    for (const std::string &v : ir.violations)
    {
        printf("  VIOLATION  %s\n", v.c_str());
    }

    if (!res.artifacts.empty())
    {
        printf("  artifacts          ");
        for (const std::string &s : res.artifacts)
        {
            printf(" %s", s.c_str());
        }
        printf("\n");
    }
}

// Common structural checks every case must satisfy.
void check_case(const CaseSpec &spec, const CaseResult &res)
{
    const AuthorResult &a0 = res.author[0];
    const AuthorResult &a1 = res.author[1];
    const InterpretResult &ir = res.interp;
    const RenderResult &rr = res.rendered;

    CHECK(!a0.table_overflow, "%s: frame 1 list overflowed its %u-byte table half",
          spec.name.c_str(), TABLE_HALF_BYTES);
    CHECK(!a1.table_overflow, "%s: frame 2 list overflowed its %u-byte table half",
          spec.name.c_str(), TABLE_HALF_BYTES);
    CHECK(ir.violations.empty(), "%s: interpreter reported %zu structural violations",
          spec.name.c_str(), ir.violations.size());
    CHECK(ir.irq_count == RENDER_FRAMES, "%s: expected %u IRQs, got %u",
          spec.name.c_str(), RENDER_FRAMES, ir.irq_count);
    CHECK(ir.descriptor_count == a0.descriptor_count + a1.descriptor_count,
          "%s: executed %u descriptors, authored %u",
          spec.name.c_str(), ir.descriptor_count, a0.descriptor_count + a1.descriptor_count);
    CHECK(res.budget.max_busy < LINE_SYSCLK,
          "%s: worst line costs %u SYSCLK, more than the %llu-SYSCLK line",
          spec.name.c_str(), res.budget.max_busy, static_cast<unsigned long long>(LINE_SYSCLK));

    // Framing: the two disciplines make different promises, so the checker
    // asserts different things.  This is the whole point of FramingMode — the
    // hardware rule is one rule, and only the list builder knows which contract
    // it signed up to.
    if (spec.base.framing == FramingMode::CUSHION)
    {
        // Records are buffered ahead in VBLANK, so the OCCUPANCY must close
        // exactly and hold must never engage for want of data.  The occupancy
        // the author reports comes from vidcmd_plan_line(); the render model
        // drives the same fetch engine independently against real deposit
        // cycles, so the overrun counter below is what cross-checks the two —
        // if the planner's arithmetic were wrong the line would overrun here.
        CHECK(res.vidcmd_slot_min == H_ACTIVE && res.vidcmd_slot_max == H_ACTIVE,
              "%s: cushion list occupancy ranges %u..%u, must be exactly %u on every line",
              spec.name.c_str(), res.vidcmd_slot_min, res.vidcmd_slot_max, H_ACTIVE);
        CHECK(rr.stats.vidcmd_hold_slots == 0,
              "%s: cushion list held on an empty FIFO for %u slots — the cushion ran out",
              spec.name.c_str(), rr.stats.vidcmd_hold_slots);
        CHECK(rr.stats.vidcmd_overruns == 0,
              "%s: %u records were still running at the h=%u fall, so a leftover plays at "
              "slot 0 of the next line", spec.name.c_str(), rr.stats.vidcmd_overruns, H_ACTIVE);
    }
    else
    {
        // JIT lists deliberately under-fill and let hold replicate the last
        // source, so hold slots are the mechanism rather than a fault.  What
        // must hold instead is the DELIVERY DEADLINE: every word of a line's
        // packet has to be in the FIFO before that line's pixel 0, or the
        // packet resumes at the wrong x and only self-heals at the next empty
        // boundary (compositor_tb's LATE_FILL).
        CHECK(res.vidcmd_slot_max <= H_ACTIVE,
              "%s: JIT list has a line of %u slots, more than the %u available",
              spec.name.c_str(), res.vidcmd_slot_max, H_ACTIVE);
        CHECK(rr.stats.vidcmd_late_words == 0,
              "%s: %u VIDCMD words arrived after their line had already started — the "
              "hblank delivery deadline was missed",
              spec.name.c_str(), rr.stats.vidcmd_late_words);
    }

    // PIXELS tiling is legal by construction (pixel.v has no empty flag and a
    // 7200 holds Q), so a short fill is a bandwidth compressor.  The bitmap
    // cases do not want one, so a nonzero count means the list is wrong; the
    // pure-VIDCMD screens never fill PIXELS at all and tile on purpose, which is
    // exactly what makes passthrough a settable third colour there.
    if (!spec.base.pure_vidcmd)
    {
        CHECK(rr.stats.pixels_tiled_words == 0,
              "%s: PIXEL tiled its last word %u times — the pixel stream came up short",
              spec.name.c_str(), rr.stats.pixels_tiled_words);
    }
    CHECK(rr.stats.pixels_overflows == 0, "%s: PIXELS FIFO overflowed %u times",
          spec.name.c_str(), rr.stats.pixels_overflows);

    // THE PALETTE, and all three of these are list-builder bugs rather than
    // model assertions: nothing in hardware clears the RAM, the filler is not
    // optional, and a write steals four pixel slots (vidcmd-spec.md §3.2).
    CHECK(rr.stats.palette_unwritten_reads == 0,
          "%s: %u pixels were painted out of palette entries the list never loaded — the "
          "RAM powers up UNDEFINED", spec.name.c_str(), rr.stats.palette_unwritten_reads);
    CHECK(rr.stats.palette_bad_filler == 0,
          "%s: %u palette writes stored the wrong colour — a three-word entry's filler is "
          "missing or carries a different value", spec.name.c_str(),
          rr.stats.palette_bad_filler);
    CHECK(rr.stats.palette_disturbed_visible == 0,
          "%s: %u palette-write slots reached the DAC through passthrough — the four slots "
          "after a clut_data SET must be in blanking or covered", spec.name.c_str(),
          rr.stats.palette_disturbed_visible);
    CHECK(rr.stats.vidcmd_overflows == 0, "%s: VIDCMD FIFO overflowed %u times",
          spec.name.c_str(), rr.stats.vidcmd_overflows);
    CHECK(rr.stats.vidcmd_mask_stalls == 0,
          "%s: a MASK stalled for %u slots waiting for its data word — the record's two "
          "words were not delivered together", spec.name.c_str(), rr.stats.vidcmd_mask_stalls);
    if (spec.base.screen == ScreenStyle::NONE && spec.base.sprites != SpriteStyle::MASK_SPRITES)
    {
        CHECK(rr.stats.vidcmd_mask_records == 0,
              "%s: %u stray `01` MASK records reached the compositor — this case emits none",
              spec.name.c_str(), rr.stats.vidcmd_mask_records);
    }

    if (spec.base.audio)
    {
        CHECK(rr.audio_underruns == 0, "%s: audio underran %u times",
              spec.name.c_str(), rr.audio_underruns);
        CHECK(rr.audio_overflows == 0, "%s: audio FIFO overflowed %u times",
              spec.name.c_str(), rr.audio_overflows);
    }
}

void write_artifacts(const CaseSpec &spec, CaseResult &res)
{
    for (uint32_t f = 0; f < RENDER_FRAMES; f++)
    {
        const std::string path = spec.name + "-f" + std::to_string(f + 1) + ".ppm";
        write_ppm(path, res.rendered.frames[f]);
        res.artifacts.push_back(path);
    }
    if (spec.base.audio && !res.rendered.audio.empty())
    {
        const std::string path = spec.name + ".wav";
        write_wav(path, res.rendered.audio);
        res.artifacts.push_back(path);
    }
}

// ---------------------------------------------------------------------------
// Case-specific content checks
// ---------------------------------------------------------------------------

Rgb444 at(const FrameImage &img, uint32_t x, uint32_t y)
{
    return img.pixels[y * H_ACTIVE + x];
}

// The vertical scroll must move the image by exactly `step` lines and nothing
// else, so frame 2 row y has to equal frame 1 row y+step everywhere.
void check_vertical_scroll(const CaseSpec &spec, const CaseResult &res, uint32_t step)
{
    if (step == 0)
    {
        return;
    }
    const FrameImage &f1 = res.rendered.frames[0];
    const FrameImage &f2 = res.rendered.frames[1];
    uint32_t mismatched = 0;
    for (uint32_t y = 0; y + step < V_ACTIVE; y++)
    {
        for (uint32_t x = 0; x < H_ACTIVE; x++)
        {
            if (at(f2, x, y) != at(f1, x, y + step))
            {
                mismatched++;
            }
        }
    }
    printf("  scroll check        frame 2 == frame 1 shifted up %u lines: %u mismatched pixels\n",
           step, mismatched);
    CHECK(mismatched == 0, "%s: vertical scroll of %u lines does not match (%u pixels differ)",
          spec.name.c_str(), step, mismatched);
}

// The sprites must actually be visible.  With TILE gone every painted pixel
// comes from a RUN whose source is a held colour, so counting pixels that equal
// held_fg or held_bg counts exactly the art — and the total is hand-derivable
// from the bitmap, which is what makes it a real check rather than a tautology.
void check_tiles_visible(const CaseSpec &spec, const CaseResult &res, uint32_t expect)
{
    const FrameImage &f1 = res.rendered.frames[0];
    uint32_t painted = 0;
    for (uint32_t y = 0; y < V_ACTIVE; y++)
    {
        for (uint32_t x = 0; x < H_ACTIVE; x++)
        {
            const Rgb444 c = at(f1, x, y);
            if (c == spec.base.held_fg || c == spec.base.held_bg)
            {
                painted++;
            }
        }
    }
    printf("  span coverage       %u pixels painted with a held colour (expected %u)\n",
           painted, expect);
    CHECK(painted == expect, "%s: spans painted %u pixels, expected exactly %u",
          spec.name.c_str(), painted, expect);
}

// The emulator will not drive these models the way make check does: it holds a
// PixelUnit and a CompositorUnit across scanlines and advances them a line at a
// time, lumping each line's deposits into its HBLANK.  Running that driver here
// against the same events is what keeps the two paths from diverging — and it
// is a real check, because the two disagree the moment a list is starved
// enough for delivery ORDER within a line to matter.
void check_incremental_api(const CaseSpec &spec, const CaseResult &res)
{
    RenderParams rp;
    rp.first_frame   = RENDER_FIRST_FRAME;
    rp.frame_count   = RENDER_FRAMES;
    rp.audio_enabled = spec.base.audio;
    rp.skew_pix      = spec.base.skew_pix;
    rp.skew_cmp      = spec.base.skew_cmp;

    const RenderResult inc = render_line_at_a_time(res.interp.events, rp);

    uint32_t differing = 0;
    for (uint32_t f = 0; f < RENDER_FRAMES; f++)
    {
        for (size_t i = 0; i < inc.frames[f].pixels.size(); i++)
        {
            if (inc.frames[f].pixels[i] != res.rendered.frames[f].pixels[i])
            {
                differing++;
            }
        }
    }
    printf("  incremental API     line-at-a-time driver vs clock-accurate: %u differing pixels\n",
           differing);
    CHECK(differing == 0,
          "%s: the per-line driver the emulator will use disagrees with the clock-accurate "
          "one on %u pixels", spec.name.c_str(), differing);
}

// ---------------------------------------------------------------------------
// Fetch-cadence traces — the model against compositor_tb.v's normative ones
// ---------------------------------------------------------------------------
//
// These drive the two units the way the testbench drives the DUT — push a
// line's words, run one HBLANK, then take slots — instead of going through a
// display list, so they pin the COMPOSITOR laws themselves rather than a
// list builder's use of them.  Every expectation below is DERIVED from
// compositor.v's header and matches a named check in compositor_tb.v:
//
//   L1  entry-edge commit: a record's effect lands on the edge ending the slot
//       it occupies, and that slot's pixel shows it.
//   L2  one slot per record when it executes; RUN(N) banked before the line
//       occupies slots 0..N-1.
//   L4  fetch cadence 2 slots per word: a word captured on the edge ending
//       slot k executes no earlier than the edge ending slot k+1.
//   L5  banked pair: a record staged with a second parked on Q executes on
//       slot k and the parked one on slot k+1.
//
// The pixel stream is all ones, so passthrough resolves to pix_pal_fg and a
// passthrough span is distinguishable from every held colour used here.
// Drive one palette entry into PIXEL the way the three-word VIDCMD entry does,
// but directly — no COMPOSITOR here, so the bus is held by hand.  The clock
// count is the measured sequence: the data SET's commit, then the three-clock
// address window with the pulse in the middle, then the recovery guard.
void palette_load_direct(PixelUnit &pix, uint32_t index, Rgb444 colour)
{
    pix.set_register(SET_PIX_CLUT_INDEX, index);
    pix.set_value_bus(colour);
    pix.blank_clock();

    pix.set_register(SET_PIX_CLUT_DATA, colour);   // clock 0: the commit
    pix.set_value_bus(colour);
    pix.blank_clock();                            // clock 1: setup
    pix.set_value_bus(colour);                    // the filler holds the bus
    pix.blank_clock();                            // clock 2: the pulse
    pix.blank_clock();                            // clock 3: hold / recovery
    pix.blank_clock();                            // clock 4: the guard
}

// The direct form of a RUN-ON entry: no index SET, so the write lands where the
// previous write's post-increment left clut_index (pixel.v, clut_pair_tb S2r).
void palette_load_next_direct(PixelUnit &pix, Rgb444 colour)
{
    pix.set_register(SET_PIX_CLUT_DATA, colour);   // clock 0: the commit
    pix.set_value_bus(colour);
    pix.blank_clock();                            // clock 1: setup
    pix.set_value_bus(colour);                    // the filler holds the bus
    pix.blank_clock();                            // clock 2: the pulse
    pix.blank_clock();                            // clock 3: hold / recovery
    pix.blank_clock();                            // clock 4: the guard
}

void palette_load_identity(PixelUnit &pix)
{
    // One indexed entry and fifteen run-on entries, so every case that loads
    // the identity palette through here also exercises the post-increment.
    palette_load_direct(pix, 0, static_cast<Rgb444>(0));
    for (uint32_t i = 1; i < PALETTE_ENTRIES; i++)
    {
        palette_load_next_direct(pix, static_cast<Rgb444>(i));
    }
}

constexpr Rgb444 TRACE_PASSTHROUGH = rgb444(9, 10, 3);

// A palette write needs the four slots after its data SET covered by a
// non-passthrough source.  The SOURCE is what covers them, not the record: a SET
// does not touch cur_src, so one opaque RUN in front of an entry holds the cover
// over the entry's own slots and the guard, and the first record that may resume
// passthrough is the one after the filler's successor (vidcmd-spec.md §3.2).
constexpr uint32_t PALETTE_COVER_SLOTS = 1;

std::vector<Rgb444> trace_slots(const std::vector<uint16_t> &words, uint32_t slots)
{
    PixelUnit      pix;
    CompositorUnit cmp;
    pix.power_on_reset();
    cmp.reset();          // the traces are a line INSIDE a frame, i.e. after /RS

    // The playfield is all ones, so 1bpp at base 0 selects PALETTE ENTRY 1: load
    // it and passthrough has a known colour.  Nothing else in the palette is
    // touched, so a trace that accidentally read another entry would show the
    // RAM's random power-up contents.
    palette_load_direct(pix, 1, TRACE_PASSTHROUGH);
    for (uint32_t i = 0; i < PIXELS_WORDS_1BPP + 1; i++)
    {
        pix.push_word(0xFFFF);
    }
    for (uint16_t w : words)
    {
        cmp.push_word(w);
    }
    for (uint32_t i = 0; i < H_BLANK; i++)
    {
        // PIX_PRELOAD, where the raster generator puts it: without it the line's
        // first word is never fetched and its first sixteen pixels come out of
        // the shifter's reset value.
        if (i == H_BLANK - PIXEL_FETCH_LEAD)
        {
            pix.arm_preload();
        }
        cmp.blank_clock(pix);
    }
    pix.begin_line();

    std::vector<Rgb444> out;
    out.reserve(slots);
    for (uint32_t i = 0; i < slots; i++)
    {
        out.push_back(cmp.active_slot(pix));
    }
    return out;
}

void check_cadence_traces()
{
    printf("\n=== compositor-cadence — the model against compositor_tb.v's traces ===\n");

    const Rgb444 reset_fg = VIDCMD_RESET_HELD_FG;

    // NORMATIVE_M0.  RUN(fg,1) and the SET are banked as a pair in HBLANK, so
    // L5 puts the SET on slot 1 — exactly where the 1-word-per-clock design put
    // it.  L4 then puts the tail RUN on slot 3, and slot 2 HOLDs the held_fg
    // the SET just wrote, so the tail is blind to the cadence.
    {
        const std::vector<uint16_t> w = {vidcmd_run(RUN_SRC_HELD_FG, 1),
                                         vidcmd_set(SET_CMP_HELD_FG, 0x0F0),
                                         vidcmd_run(RUN_SRC_HELD_FG, 637)};
        const std::vector<Rgb444> px = trace_slots(w, H_ACTIVE);
        uint32_t bad = 0;
        for (uint32_t i = 1; i < H_ACTIVE; i++)
        {
            if (px[i] != 0x0F0)
            {
                bad++;
            }
        }
        printf("  M0                  px0 0x%03X px1 0x%03X px2 0x%03X, %u tail exceptions\n",
               px[0], px[1], px[2], bad);
        CHECK(px[0] == reset_fg, "trace M0: pixel 0 is 0x%03X, expected the pre-SET held_fg 0x%03X",
              px[0], reset_fg);
        CHECK(px[1] == 0x0F0, "trace M0: the SET must land on pixel 1 (banked pair), got 0x%03X",
              px[1]);
        CHECK(bad == 0, "trace M0: %u pixels of the tail are not the SET value", bad);
    }

    // PAIR_LOCAL.  RUN(fg,4) occupies slots 0..3 (L2) and banks SET(fg) staged
    // with SET(bg) parked while it counts, so the two SETs execute on slots 4
    // and 5 (L5).  Slot 6 is the HOLD behind the pair (L4) and RUN(bg) follows
    // on slot 7.
    {
        const std::vector<uint16_t> w = {vidcmd_run(RUN_SRC_HELD_FG, 4),
                                         vidcmd_set(SET_CMP_HELD_FG, 0x1B2),
                                         vidcmd_set(SET_CMP_HELD_BG, 0x3C4),
                                         vidcmd_run(RUN_SRC_HELD_BG, 600)};
        const std::vector<Rgb444> px = trace_slots(w, 16);
        printf("  pair                slots 0..7 %03X %03X %03X %03X %03X %03X %03X %03X\n",
               px[0], px[1], px[2], px[3], px[4], px[5], px[6], px[7]);
        CHECK(px[0] == reset_fg && px[3] == reset_fg,
              "trace pair: slots 0..3 must be the old held_fg");
        CHECK(px[4] == 0x1B2 && px[5] == 0x1B2,
              "trace pair: the SETs must land on slots 4 and 5 (banked pair), got 0x%03X 0x%03X",
              px[4], px[5]);
        CHECK(px[6] == 0x1B2, "trace pair: slot 6 must HOLD the new held_fg, got 0x%03X", px[6]);
        CHECK(px[7] == 0x3C4, "trace pair: RUN(bg) must start on slot 7, got 0x%03X", px[7]);
    }

    // BACK_TO_BACK_SETS.  L5 gives the first SET slot 1 behind a one-slot RUN;
    // L4 gives every SET after that a slot of its own plus a HOLD slot, so the
    // burst lands on slots 1, 3, 5.
    {
        const std::vector<uint16_t> w = {vidcmd_run(RUN_SRC_HELD_FG, 1),
                                         vidcmd_set(SET_CMP_HELD_FG, 0x111),
                                         vidcmd_set(SET_CMP_HELD_FG, 0x222),
                                         vidcmd_set(SET_CMP_HELD_FG, 0x333),
                                         vidcmd_run(RUN_SRC_HELD_FG, 600)};
        const std::vector<Rgb444> px = trace_slots(w, 16);
        printf("  triple burst        slots 0..6 %03X %03X %03X %03X %03X %03X %03X\n",
               px[0], px[1], px[2], px[3], px[4], px[5], px[6]);
        CHECK(px[0] == reset_fg, "trace burst: slot 0 is the RUN's own pixel");
        CHECK(px[1] == 0x111 && px[3] == 0x222 && px[5] == 0x333,
              "trace burst: the three SETs must land on slots 1, 3, 5 — got 0x%03X 0x%03X 0x%03X "
              "at those slots", px[1], px[3], px[5]);
        CHECK(px[2] == 0x111 && px[4] == 0x222,
              "trace burst: slots 2 and 4 must HOLD the value behind them");
    }

    // ONE_PX_SPANS.  Three one-slot RUNs, c1 (RED), c0 (GREEN), c1 again, the
    // held colours loaded eagerly in HBLANK (RUN_COLOR, which this trace used
    // to use, is retired; the record class and so the timing are the same).
    // RED is staged and GREEN parked at the line
    // start, so RED takes slot 0 and GREEN slot 1 (L5); slot 2 HOLDs GREEN; the
    // third record is captured on the edge ending slot 2 and executes on slot 3
    // (L4) with slot 4 its HOLD; the passthrough RUN then executes on slot 5.
    {
        const std::vector<uint16_t> w = {vidcmd_set(SET_CMP_COLOR1, 0xF00),
                                         vidcmd_set(SET_CMP_COLOR0, 0x0F0),
                                         vidcmd_run(RUN_SRC_COLOR1, 1),
                                         vidcmd_run(RUN_SRC_COLOR0, 1),
                                         vidcmd_run(RUN_SRC_COLOR1, 1),
                                         vidcmd_run(RUN_SRC_PASSTHROUGH, 637)};
        const std::vector<Rgb444> px = trace_slots(w, H_ACTIVE);
        uint32_t bad = 0;
        for (uint32_t i = 5; i < H_ACTIVE; i++)
        {
            if (px[i] != TRACE_PASSTHROUGH)
            {
                bad++;
            }
        }
        printf("  one-px spans        slots 0..5 %03X %03X %03X %03X %03X %03X, %u tail "
               "exceptions\n", px[0], px[1], px[2], px[3], px[4], px[5], bad);
        CHECK(px[0] == 0xF00 && px[1] == 0x0F0 && px[2] == 0x0F0,
              "trace 1px: R then G on adjacent slots (pair) with slot 2 holding G");
        CHECK(px[3] == 0xF00 && px[4] == 0xF00,
              "trace 1px: the third span is one cadence later, slots 3 and 4");
        CHECK(bad == 0, "trace 1px: passthrough must resume at slot 5 (%u exceptions)", bad);
    }

    // SUSTAINED_2SLOT.  A line of one-slot RUNs alternating c1 (RED) and c0
    // (GREEN), loaded eagerly in HBLANK: record 1 paints slot 0 as
    // the staged half of the opening pair, and every record after that paints
    // its own slot plus the HOLD slot behind it, so record k >= 2 covers slots
    // 2k-3 and 2k-2 and N records reach only slot 2N-2.  A full 256-word FIFO
    // therefore covers 511 of the 640 slots — the cadence, not the depth, is
    // what a dense line runs out of.
    {
        constexpr uint32_t RECORDS = VIDCMD_FIFO_WORDS;
        constexpr uint32_t COVERED = 2 * RECORDS - 1;
        std::vector<uint16_t> w = {vidcmd_set(SET_CMP_COLOR1, 0xF00),
                                   vidcmd_set(SET_CMP_COLOR0, 0x0F0)};
        for (uint32_t i = 0; i < RECORDS - 2; i++)
        {
            w.push_back(vidcmd_run((i % 2) == 0 ? RUN_SRC_COLOR1 : RUN_SRC_COLOR0, 1));
        }
        // The two eager SETs take two of the FIFO's words, so the line has two
        // records fewer than the FIFO's depth: 254 records reach slot 506.
        const std::vector<Rgb444> px = trace_slots(w, COVERED - 4);
        uint32_t off = 0;
        for (uint32_t i = 0; i < COVERED - 4; i++)
        {
            const Rgb444 want = (i == 0) ? 0xF00 : ((((i - 1) / 2) % 2) == 0 ? 0x0F0 : 0xF00);
            if (px[i] != want)
            {
                off++;
            }
        }
        printf("  sustained 2-slot    %u of %u one-slot records reach the screen, %u pixels off "
               "the pattern\n", RECORDS, H_ACTIVE, off);
        CHECK(off == 0,
              "trace sustained: %u pixels do not follow the 2-slot cadence pattern", off);
    }

    // THE CADENCE CEILING, clean-room: 1-px spans at a fixed pitch, with the
    // whole line already in the FIFO so nothing about DELIVERY can confound it.
    // A span alternating with a (pitch-1)-px gap averages pitch/2 slots per
    // record against the fetch's requirement of VIDCMD_SLOTS_PER_WORD, so the
    // tightest pitch that still lands where it was authored is
    // TEMPEST_STRESS_MIN_PITCH = 4.  Hand-derived pixel counts:
    //
    //   pitch >= 4  no HOLD lands inside the band: SPANS spans, SPANS pixels.
    //   pitch 3     half a slot lost per record, so the deficit lands as one
    //               HOLD per span (widening it to 2 px, same count as pitch 2)
    //               AND as a rightward drift of one pixel per span, which the
    //               count cannot see and the pitch-4 case is the guard against.
    //   pitch 2     the bank pays for the first span only, every span after it
    //               carries a HOLD, and a HOLD keeps the span's own source —
    //               so each of those renders 2 px: 1 + 2*(SPANS-1).
    {
        constexpr uint32_t SPANS   = 32;
        constexpr uint32_t FIRST_X = 64;
        printf("  cadence ceiling     pitch  authored px  painted px  verdict\n");
        for (uint32_t pitch : {2u, 3u, 4u, 6u})
        {
            const Rgb444 magenta = rgb444(15, 0, 15);
            std::vector<uint16_t> w = {vidcmd_set(SET_CMP_COLOR1, magenta)};
            uint32_t x = 0;
            for (uint32_t i = 0; i < SPANS; i++)
            {
                const uint32_t sx = FIRST_X + i * pitch;
                if (sx > x)
                {
                    w.push_back(vidcmd_run(RUN_SRC_PASSTHROUGH, sx - x));
                }
                w.push_back(vidcmd_run(RUN_SRC_COLOR1, 1));
                x = sx + 1;
            }
            w.push_back(vidcmd_run(RUN_SRC_PASSTHROUGH, H_ACTIVE - x));

            const std::vector<Rgb444> px = trace_slots(w, H_ACTIVE);
            uint32_t painted = 0;
            for (Rgb444 c : px)
            {
                if (c == magenta)
                {
                    painted++;
                }
            }
            const bool sustains = pitch >= TEMPEST_STRESS_MIN_PITCH;
            printf("                      %5u  %11u  %10u  %s\n", pitch, SPANS, painted,
                   sustains ? "lands as authored" : "STRETCHED, spans widen");
            if (sustains)
            {
                CHECK(painted == SPANS,
                      "trace cadence: a %u-pixel pitch averages %u slots per record and must "
                      "land as authored — %u pixels painted, expected %u",
                      pitch, pitch / 2, painted, SPANS);
            }
            if (pitch == 2)
            {
                CHECK(painted == 1 + 2 * (SPANS - 1),
                      "trace cadence: at a 2-pixel pitch every span but the banked first one "
                      "must render two pixels wide — %u painted, expected %u",
                      painted, 1 + 2 * (SPANS - 1));
            }
        }
    }
}

// ---------------------------------------------------------------------------
// PIXEL mode traces — the model against cpld/pixel/pixel_tb.v
// ---------------------------------------------------------------------------
//
// These drive PixelUnit ALONE, the way pixel_tb.v drives the DUT: SET the
// registers during blanking, load the palette, fill the FIFO with a line's
// stream, run the raster's blanking with PIX_PRELOAD in it, then take 640 pixel
// clocks.  Every case names the pixel_tb.v case it mirrors, and every
// expectation is derived from the mode definition here — not read out of the
// model — so a disagreement is a real disagreement.
//
// WHAT IS ASSERTED PER CASE, and the second one is the reason this section was
// rewritten: (1) the 640 per-pixel indices, and (2) THE WORDS THE LINE READ.
// The old model had no fetch cadence at all — it pulled bits out of a buffer on
// demand — so it could not see the read count, which is how it missed two
// shipped RTL bugs.  This model reads the FIFO on the clocks the chip does, so
// `words_consumed` is pixel_tb.v's per-line /RE count, and the whole
// mode-by-skip matrix below is that bench's table at the real 640 width.
//
// THE PALETTE IS PART OF EVERY CASE.  PIXEL emits an index; the colour comes
// from a RAM that nothing resets.  The traces load an IDENTITY palette (entry i
// holds colour i), so an index error and a colour error are the same error and
// the expectation is the index itself.  PALETTE_UNLOADED at the end is the
// negative control on that: a case that forgets an entry reads the RAM's random
// power-up contents and the model says so.

struct PixelLine
{
    std::vector<uint32_t> idx;              // the palette index of each pixel
    uint32_t              words_consumed = 0;
    uint32_t              tiled_words    = 0;
    uint32_t              unwritten      = 0;
};

// One visible line out of a freshly powered-up PixelUnit, with the raster's own
// blanking in front of it so PIX_PRELOAD lands where timing.v puts it:
// PIXEL_FETCH_LEAD clocks before the first consumption clock.
PixelLine pixel_line(uint32_t mode, const std::vector<uint16_t> &words,
                     uint32_t base, uint32_t skip, bool load_palette = true)
{
    RenderStats stats;
    PixelUnit   pix;
    pix.power_on_reset();
    pix.attach_stats(&stats);
    pix.set_counting(true);

    if (load_palette)
    {
        palette_load_identity(pix);
    }

    pix.set_register(SET_PIX_BASE, base);
    pix.blank_clock();
    pix.set_register(SET_PIX_MODE, mode);
    pix.blank_clock();
    pix.set_register(SET_PIX_PIXEL_SKIP, skip);
    pix.blank_clock();

    for (uint16_t w : words)
    {
        pix.push_word(w);
    }

    const uint32_t before = pix.fifo_count();
    for (uint32_t h = 0; h < H_BLANK; h++)
    {
        if (h == H_BLANK - PIXEL_FETCH_LEAD)
        {
            pix.arm_preload();
        }
        pix.blank_clock();
    }
    pix.begin_line();

    PixelLine out;
    out.idx.reserve(H_ACTIVE);
    for (uint32_t i = 0; i < H_ACTIVE; i++)
    {
        // With the identity palette the colour IS the index.
        out.idx.push_back(pix.next_pixel() & 0xFu);
    }
    out.words_consumed = before - pix.fifo_count();
    out.tiled_words    = stats.pixels_tiled_words;
    out.unwritten      = stats.palette_unwritten_reads;
    return out;
}

// A line's stream, long enough for any mode: a fixed pseudo-random word list, so
// every expectation below is a function of the mode and not of the data.
std::vector<uint16_t> stream_words(uint32_t n)
{
    std::vector<uint16_t> w;
    w.reserve(n);
    uint32_t x = 0xA53C1234u;
    for (uint32_t i = 0; i < n; i++)
    {
        x ^= x << 13;
        x ^= x >> 17;
        x ^= x << 5;
        w.push_back(static_cast<uint16_t>(x & 0xFFFFu));
    }
    return w;
}

// THE EXPECTATION, derived from the mode definition and nothing else: group g of
// the line is `w` bits of the words the line read, concatenated, starting at
// stream bit `skip_fine + g*w`, MSB first, and zero once those words run out.
// This is pixel_tb.v's model_group(), and with production clamps its
// displacement and lead-deficit terms are both zero.
uint32_t stream_group(const std::vector<uint16_t> &words, uint32_t reads,
                      uint32_t start_bit, uint32_t g, uint32_t w)
{
    uint32_t v = 0;
    for (uint32_t i = 0; i < w; i++)
    {
        const uint32_t bitn = start_bit + g * w + i;
        const uint32_t wi   = bitn / 16u;
        const uint32_t bit  = (wi < reads) ? ((words[wi] >> (15u - (bitn % 16u))) & 1u) : 0u;
        v = (v << 1) | bit;
    }
    return v;
}

// The index a mode makes of a group, straight out of the table in descriptor.h.
uint32_t mode_index(uint32_t mode, uint32_t base, uint32_t group, uint32_t attr_colour)
{
    switch (pixel_mode_depth(mode))
    {
        case PIXEL_DEPTH_ATTR:
            return (group != 0) ? ((attr_colour >> 4) & 0xFu) : (attr_colour & 0xFu);
        case PIXEL_DEPTH_4BPP:
            return group & 0xFu;
        case PIXEL_DEPTH_2BPP:
            return (base & 0xCu) | (group & 3u);
        default:
            return (base & 0xEu) | (group & 1u);
    }
}

// The whole line's expectation for a non-attribute mode.
std::vector<uint32_t> expect_line(uint32_t mode, uint32_t base, uint32_t skip,
                                  const std::vector<uint16_t> &words, uint32_t reads)
{
    const uint32_t w    = pixels_bits_per_group(mode);
    const bool     half = pixel_mode_half_rate(mode);
    const uint32_t s    = pixels_skip_effective(mode, skip);

    std::vector<uint32_t> want(H_ACTIVE);
    for (uint32_t p = 0; p < H_ACTIVE; p++)
    {
        const uint32_t g = half ? (p / 2u) : p;
        want[p] = mode_index(mode, base, stream_group(words, reads, s, g, w), 0);
    }
    return want;
}

// Attribute mode's expectation: one word per eight-group cell, PIXELS_Q[15:8]
// the colour byte and PIXELS_Q[7:0] the pattern, pattern MSB first.
std::vector<uint32_t> expect_attr_line(uint32_t mode, const std::vector<uint16_t> &words)
{
    const bool half = pixel_mode_half_rate(mode);

    std::vector<uint32_t> want(H_ACTIVE);
    for (uint32_t p = 0; p < H_ACTIVE; p++)
    {
        const uint32_t g      = half ? (p / 2u) : p;
        const uint32_t cell   = g / 8u;
        const uint32_t colour = (words[cell] >> 8) & 0xFFu;
        const uint32_t bit    = (words[cell] >> (7u - (g % 8u))) & 1u;
        want[p] = bit != 0 ? ((colour >> 4) & 0xFu) : (colour & 0xFu);
    }
    return want;
}

uint32_t index_mismatches(const PixelLine &line, const std::vector<uint32_t> &want,
                          uint32_t first, uint32_t last)
{
    uint32_t bad = 0;
    for (uint32_t k = first; k <= last; k++)
    {
        if (line.idx[k] != want[k])
        {
            bad++;
        }
    }
    return bad;
}

void report_pixel_case(const char *name, const char *tb_case, const PixelLine &line,
                       uint32_t bad, uint32_t checked, uint32_t want_words)
{
    printf("  %-16s %-10s %4u pixels checked, %u wrong, %2u words read (want %u)\n",
           name, tb_case, checked, bad, line.words_consumed, want_words);
    CHECK(bad == 0, "pixel trace %s: %u of %u checked pixels are wrong", name, bad, checked);
    CHECK(line.words_consumed == want_words,
          "pixel trace %s: the line read %u PIXELS words, pixel_tb.v's /RE count law says "
          "%u", name, line.words_consumed, want_words);
    CHECK(line.unwritten == 0,
          "pixel trace %s: %u pixels came out of palette entries nobody loaded", name,
          line.unwritten);
}

void check_pixel_modes()
{
    printf("\n=== pixel-modes — the model against cpld/pixel/pixel_tb.v ===\n");

    const std::vector<uint16_t> w = stream_words(128);

    // --- the four depths at full rate, and both rates where defined ---------
    //
    // pixel_tb.v cases A (1bpp full), B (2bpp full), C (4bpp half), D (attr
    // full), E (attr half), F (1bpp half), each re-run at the real 640 width by
    // its case W.  pix_base picks the PAIR in 1bpp and the QUAD in 2bpp.
    struct ModeCase
    {
        const char *name;
        const char *tb;
        uint32_t    mode;
        uint32_t    base;
        uint32_t    words;
    };
    const ModeCase MODES[] = {
        {"1BPP",      "A / W", pixel_mode(PIXEL_DEPTH_1BPP, false), 0xA, PIXELS_WORDS_1BPP},
        {"1BPP_HALF", "F / W", pixel_mode(PIXEL_DEPTH_1BPP, true),  0xA, PIXELS_WORDS_1BPP_HALF},
        {"2BPP",      "B / W", pixel_mode(PIXEL_DEPTH_2BPP, false), 0xC, PIXELS_WORDS_2BPP},
        {"2BPP_HALF", "W",     pixel_mode(PIXEL_DEPTH_2BPP, true),  0xC, PIXELS_WORDS_2BPP_HALF},
        {"4BPP_HALF", "C / W", pixel_mode(PIXEL_DEPTH_4BPP, true),  0x0, PIXELS_WORDS_4BPP_HALF},
    };
    for (const ModeCase &m : MODES)
    {
        const PixelLine line = pixel_line(m.mode, w, m.base, 0);
        const std::vector<uint32_t> want = expect_line(m.mode, m.base, 0, w, m.words);
        report_pixel_case(m.name, m.tb, line,
                          index_mismatches(line, want, 0, H_ACTIVE - 1), H_ACTIVE, m.words);
    }

    // --- the attribute word, both rates (pixel_tb.v D / E / D2 / E2) --------
    {
        const uint32_t mode = pixel_mode(PIXEL_DEPTH_ATTR, false);
        const PixelLine line = pixel_line(mode, w, 0, 0);
        report_pixel_case("ATTR", "D / D2", line,
                          index_mismatches(line, expect_attr_line(mode, w), 0, H_ACTIVE - 1),
                          H_ACTIVE, PIXELS_WORDS_ATTR);
    }
    {
        const uint32_t mode = pixel_mode(PIXEL_DEPTH_ATTR, true);
        const PixelLine line = pixel_line(mode, w, 0, 0);
        report_pixel_case("ATTR_HALF", "E / E2", line,
                          index_mismatches(line, expect_attr_line(mode, w), 0, H_ACTIVE - 1),
                          H_ACTIVE, PIXELS_WORDS_ATTR_HALF);
    }

    // --- pix_base: 1bpp selects a PAIR, 2bpp a QUAD -------------------------
    //
    // The same stream through two different bases must paint the same PATTERN
    // out of different entries, which is what makes a per-line base change a
    // free recolour and a mid-line one pixel-exact (m0/m2).
    {
        const uint32_t mode = pixel_mode(PIXEL_DEPTH_1BPP, false);
        const PixelLine a = pixel_line(mode, w, 0x0, 0);
        const PixelLine b = pixel_line(mode, w, 0x6, 0);
        uint32_t bad = 0;
        for (uint32_t k = 0; k < H_ACTIVE; k++)
        {
            if ((a.idx[k] & 1u) != (b.idx[k] & 1u) || (b.idx[k] & 0xEu) != 0x6u)
            {
                bad++;
            }
        }
        printf("  %-16s %-10s pair 0/1 vs 6/7: %u pixels disagree\n",
               "BASE_PAIR", "A", bad);
        CHECK(bad == 0, "pixel trace BASE_PAIR: %u pixels do not follow {base[3:1], bit}",
              bad);
    }
    {
        const uint32_t mode = pixel_mode(PIXEL_DEPTH_2BPP, false);
        const PixelLine a = pixel_line(mode, w, 0x0, 0);
        const PixelLine b = pixel_line(mode, w, 0x8, 0);
        uint32_t bad = 0;
        for (uint32_t k = 0; k < H_ACTIVE; k++)
        {
            if ((a.idx[k] & 3u) != (b.idx[k] & 3u) || (b.idx[k] & 0xCu) != 0x8u)
            {
                bad++;
            }
        }
        printf("  %-16s %-10s quad 0..3 vs 8..B: %u pixels disagree\n",
               "BASE_QUAD", "B", bad);
        CHECK(bad == 0, "pixel trace BASE_QUAD: %u pixels do not follow {base[3:2], dibit}",
              bad);
    }

    // --- pixel_skip: the whole matrix, words AND leading pixels -------------
    //
    // pixel_tb.v's SKIP_TABLE at the real 640 width.  The word count is
    //
    //     record + (effective skip != 0)
    //
    // and the effective skip is the register truncated to four bits, then the
    // depth clamp, then the cap — 14 (1bpp either rate), 12 (2bpp full), 14
    // (2bpp half), 12 (4bpp half).  Attribute mode refuses skip entirely.  The
    // leading pixels are checked against the same start-bit law, which is what
    // proves the clamp CLAMPS rather than being ignored.
    {
        const struct { const char *name; uint32_t mode; uint32_t base; uint32_t record; } SK[] = {
            {"1bpp",      pixel_mode(PIXEL_DEPTH_1BPP, false), 0xA, PIXELS_WORDS_1BPP},
            {"1bpp half", pixel_mode(PIXEL_DEPTH_1BPP, true),  0xA, PIXELS_WORDS_1BPP_HALF},
            {"2bpp",      pixel_mode(PIXEL_DEPTH_2BPP, false), 0xC, PIXELS_WORDS_2BPP},
            {"2bpp half", pixel_mode(PIXEL_DEPTH_2BPP, true),  0xC, PIXELS_WORDS_2BPP_HALF},
            {"4bpp half", pixel_mode(PIXEL_DEPTH_4BPP, true),  0x0, PIXELS_WORDS_4BPP_HALF},
            {"attr",      pixel_mode(PIXEL_DEPTH_ATTR, false), 0x0, PIXELS_WORDS_ATTR},
        };
        uint32_t cells = 0;
        uint32_t bad_words = 0;
        uint32_t bad_px = 0;
        for (const auto &m : SK)
        {
            for (uint32_t skip = 0; skip <= 17; skip++)
            {
                const uint32_t eff  = pixels_skip_effective(m.mode, skip);
                const uint32_t want = m.record + (eff != 0 ? PIXELS_SKIP_EXTRA_WORDS : 0u);
                const PixelLine line = pixel_line(m.mode, w, m.base, skip);
                cells++;
                if (line.words_consumed != want)
                {
                    bad_words++;
                    printf("    skip %2u %-9s read %u words, want %u\n", skip, m.name,
                           line.words_consumed, want);
                }
                if (pixel_mode_depth(m.mode) != PIXEL_DEPTH_ATTR)
                {
                    const std::vector<uint32_t> exp =
                        expect_line(m.mode, m.base, skip, w, want);
                    // The leading 64 pixels: enough to cover the first four
                    // words in every mode, and independent of the tail.
                    const uint32_t b = index_mismatches(line, exp, 0, 63);
                    if (b != 0)
                    {
                        bad_px += b;
                        printf("    skip %2u %-9s %u of the leading 64 pixels wrong\n",
                               skip, m.name, b);
                    }
                }
            }
        }
        printf("  %-16s %-10s %u mode/skip cells: %u word counts wrong, %u leading "
               "pixels wrong\n", "SKIP_MATRIX", "W / skip", cells, bad_words, bad_px);
        CHECK(bad_words == 0, "SKIP_MATRIX: %u of %u cells read the wrong number of words",
              bad_words, cells);
        CHECK(bad_px == 0, "SKIP_MATRIX: %u leading pixels are wrong under skip", bad_px);
    }

    // --- THE SKIPPED LINE'S TAIL SHOWS REAL DATA ----------------------------
    //
    // The one visible semantic change from the retired byte engine: with the
    // extra word read, the last pixels of a scrolled line are stream data, not
    // the zeros the old decoder shifted in.  pixel_tb.v's mut5 is the negative
    // control on the allowance itself.
    {
        const uint32_t mode = pixel_mode(PIXEL_DEPTH_1BPP, false);
        const PixelLine line = pixel_line(mode, w, 0x0, 3);
        const std::vector<uint32_t> want =
            expect_line(mode, 0x0, 3, w, PIXELS_WORDS_1BPP + 1);
        const uint32_t bad = index_mismatches(line, want, H_ACTIVE - 16, H_ACTIVE - 1);
        uint32_t nonzero = 0;
        for (uint32_t k = H_ACTIVE - 16; k < H_ACTIVE; k++)
        {
            nonzero += (line.idx[k] & 1u);
        }
        printf("  %-16s %-10s skip 3: %u words, last 16 pixels %u wrong, %u of them set\n",
               "SKIP_TAIL", "skip", line.words_consumed, bad, nonzero);
        CHECK(bad == 0, "SKIP_TAIL: %u of the last 16 pixels are wrong", bad);
        CHECK(line.words_consumed == PIXELS_WORDS_1BPP + 1,
              "SKIP_TAIL: a skipped line must read record+1 = %u words, not %u",
              PIXELS_WORDS_1BPP + 1, line.words_consumed);
    }

    // --- RESET: an untouched chip is 1bpp full rate out of entries 0 and 1 --
    {
        RenderStats stats;
        PixelUnit   pix;
        pix.power_on_reset();
        pix.attach_stats(&stats);
        pix.set_counting(true);
        palette_load_identity(pix);
        pix.reset();                 // /RS, which does NOT clear the RAM
        for (uint16_t v : w)
        {
            pix.push_word(v);
        }
        for (uint32_t h = 0; h < H_BLANK; h++)
        {
            if (h == H_BLANK - PIXEL_FETCH_LEAD)
            {
                pix.arm_preload();
            }
            pix.blank_clock();
        }
        pix.begin_line();
        uint32_t bad = 0;
        for (uint32_t k = 0; k < H_ACTIVE; k++)
        {
            const uint32_t got  = pix.next_pixel() & 0xFu;
            const uint32_t want = (w[k / 16] >> (15u - (k % 16u))) & 1u;
            bad += (got == want) ? 0u : 1u;
        }
        printf("  %-16s %-10s /RS leaves mode 0, base 0, skip 0 and the RAM LOADED: "
               "%u wrong, %u unloaded reads\n", "RESET_1BPP", "R", bad,
               stats.palette_unwritten_reads);
        CHECK(bad == 0, "RESET_1BPP: an untouched chip must render 1bpp out of entries 0 "
              "and 1 — %u pixels wrong", bad);
        CHECK(stats.palette_unwritten_reads == 0,
              "RESET_1BPP: /RS must NOT clear the palette RAM, but %u reads found entries "
              "unloaded", stats.palette_unwritten_reads);
    }

    // --- THE NEGATIVE CONTROL ON THE RANDOM POWER-UP ------------------------
    //
    // A case that forgets to load the entries it displays must FAIL, and this is
    // the proof that it does: the same line with no palette load at all comes
    // out of the RAM's reproducible random contents, so it does not match the
    // identity expectation and the model counts every unloaded read.
    {
        const uint32_t mode = pixel_mode(PIXEL_DEPTH_1BPP, false);
        const PixelLine line = pixel_line(mode, w, 0xA, 0, false);
        const std::vector<uint32_t> want = expect_line(mode, 0xA, 0, w, PIXELS_WORDS_1BPP);
        const uint32_t bad = index_mismatches(line, want, 0, H_ACTIVE - 1);
        printf("  %-16s %-10s no palette load: %u of %u pixels wrong, %u unloaded reads\n",
               "PALETTE_UNLOADED", "S0", bad, H_ACTIVE, line.unwritten);
        CHECK(bad > 0,
              "PALETTE_UNLOADED: the RAM must power up UNDEFINED — with no load at all the "
              "line matched the loaded expectation, so something is clearing it to a "
              "convenient value");
        CHECK(line.unwritten == H_ACTIVE,
              "PALETTE_UNLOADED: %u of %u pixels should have been flagged as reads of "
              "entries nobody loaded", line.unwritten, H_ACTIVE);
    }

    printf("  MEASURED         words/line 40/20 1bpp, 80/40 2bpp, -/80 4bpp, 80/40 attr; "
           "skip caps 14/12/14/12; +1 word on any non-zero skip\n");
}
// ---------------------------------------------------------------------------
// PALETTE traces — the model against cpld/pixel/clut_pair_tb.v
// ---------------------------------------------------------------------------
//
// clut_pair_tb.v instantiates COMPOSITOR, PIXEL and three behavioural RAMs and
// is GROUND TRUTH for everything here.  Its cases and the checks below:
//
//   S1a/S1b  the two illegal third words — another PIXEL-target SET, a
//            COMPOSITOR colour SET — both of which STORE THEIR OWN PAYLOAD in
//            the entry.  DETECTED, and the model stores the wrong colour too.
//   S1c      the contract: SET clut_index, SET clut_data, same-value SET 7.
//   S3       eight entries reloaded in ONE HBLANK, then the line that uses them.
//   S6       a write behind a cmp_color RUN mid-line: undisturbed.
//   S6-neg   the same write under passthrough: three clocks of undefined RGB
//            reach RGB_OUT.  DETECTED.
//   S8       a sixteen-entry load in vertical blank, then one line per mode.
//
// These drive the two units directly, like the cadence and mask traces, because
// the claim is about the WRITE WINDOW and not about a list builder.

struct PaletteTrace
{
    std::vector<Rgb444> px;
    RenderStats         stats;
    Rgb444              entry_after[PALETTE_ENTRIES] = {};
};
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
int main()
{
    std::vector<uint16_t> ram_words(RAM_BYTES / 2, 0);
    Memory ram{std::span<uint16_t>(ram_words)};

    // Source data every case shares.
    write_test_pattern_1bpp(ram, FB_BASE, FB_STRIDE_BYTES, FB_WORDS_PER_LINE, FB_LINES);
    write_solid_pattern_1bpp(ram, FB_SOLID_BASE, FB_STRIDE_BYTES, FB_WORDS_PER_LINE, FB_LINES);
    write_test_pattern_indexed2(ram, FB_IDX2_BASE, FB_IDX2_STRIDE, FB_LINES);
    write_test_pattern_indexed4_half(ram, FB_IDX4_BASE, FB_IDX4_STRIDE, FB_LINES);
    write_test_pattern_attr(ram, FB_ATTR_BASE, FB_ATTR_STRIDE, PIXELS_WORDS_ATTR, FB_LINES);
    write_audio_source(ram, AUDIO_BASE, AUDIO_SOURCE_PAIRS);
    draw_tempest_web(ram, FB_WEB_BASE, FB_STRIDE_BYTES);

    FrameParams common;
    common.fb_base         = FB_BASE;
    common.fb_stride_bytes = FB_STRIDE_BYTES;
    common.vidcmd_base     = VIDCMD_BASE;
    common.audio_base      = AUDIO_BASE;
    common.audio_source_pairs = AUDIO_SOURCE_PAIRS;

    printf("Griffin super-engine display-list + VIDCMD validation suite\n");
    printf("  SYSCLK %llu Hz, pixel clock %llu Hz, %ux%u of %ux%u, line %llu SYSCLK, "
           "HBLANK %llu SYSCLK\n",
           static_cast<unsigned long long>(SYSCLK_HZ),
           static_cast<unsigned long long>(PIXEL_CLK_HZ),
           H_ACTIVE, V_ACTIVE, H_TOTAL, V_TOTAL,
           static_cast<unsigned long long>(LINE_SYSCLK),
           static_cast<unsigned long long>(HBLANK_SYSCLK));
    printf("  colour R4G4B4 (12-bit), 3 deposit strobes + 1 spare, VIDCMD slot framing\n");
    printf("  arbitration model %u SYSCLK/descriptor, re-arm latency %llu SYSCLK, "
           "%u vblank pacing lines\n",
           ENGINE_ARBITRATION_CYCLES, static_cast<unsigned long long>(REARM_LATENCY_CYCLES),
           VBLANK_PACING_LINES);
    printf("  skew MEASURED: SET->PIXEL %u px, SET->COMPOSITOR %u px (dedicated value bus, "
           "both land in the SET's own slot)\n",
           SKEW_PIX_TARGET, SKEW_CMP_TARGET);
    printf("  rendering raster frames %u and %u (frame 0 is the arming frame)\n",
           RENDER_FIRST_FRAME, RENDER_FIRST_FRAME + 1);
    printf("  VIDCMD fetch %u slots/word, banked pair gap %u slot, on-chip bank %u records\n",
           VIDCMD_SLOTS_PER_WORD, VIDCMD_PAIR_SLOT_GAP, VIDCMD_BANK_DEPTH);
    printf("  PIXEL is INDEX-ONLY: mode[1:0] depth (1bpp / 2bpp / 4bpp / attribute), "
           "mode[2] half rate, mode[3] reserved\n");
    printf("  palette 16 x 12 in external RAM, NEVER RESET, random at power-up; "
           "%u VIDCMD words per entry\n", PALETTE_WORDS_PER_ENTRY);
    printf("  PIXELS words/line   full rate %u 1bpp, %u 2bpp, %u attr (4bpp UNDEFINED); "
           "half rate %u / %u / %u / %u 4bpp\n",
           PIXELS_WORDS_1BPP, PIXELS_WORDS_2BPP, PIXELS_WORDS_ATTR,
           PIXELS_WORDS_1BPP_HALF, PIXELS_WORDS_2BPP_HALF, PIXELS_WORDS_ATTR_HALF,
           PIXELS_WORDS_4BPP_HALF);

    // The laws first, directly against the two units, before any list builder
    // gets to interpret them.
    check_pixel_modes();
    check_palette_traces();
    check_cadence_traces();
    check_mask_traces();
    check_literal_traces();

    // --- Normative slot-arithmetic regression ---------------------------------
    {
        CaseSpec s;
        s.name  = "m0-slot-regression";
        s.title = "NORMATIVE: RUN(pt,1) SET(pix_pal_fg,C2) RUN(pt,637) over all-fg bits";
        s.base  = common;
        s.base.fb_base         = FB_SOLID_BASE;
        s.base.slot_regression = true;
        s.base.regression_c1   = rgb444(15, 0, 0);
        s.base.regression_c2   = rgb444(0, 0, 15);
        // The two PAIRS the mid-line SET(pix_base) switches between, loaded once
        // per frame in vertical blanking: base 0 is {c1, c1} and base
        // REGRESSION_BASE_HI is {c2, c2}, so the pixel a SET lands on is named by
        // its colour and not by the bitmap.
        s.base.palette[0] = s.base.regression_c1;
        s.base.palette[1] = s.base.regression_c1;
        s.base.palette[REGRESSION_BASE_HI | 0] = s.base.regression_c2;
        s.base.palette[REGRESSION_BASE_HI | 1] = s.base.regression_c2;
        s.base.palette_entries = PALETTE_ENTRIES;
        CaseResult r = run_case(s, ram, REARM_LATENCY_CYCLES);
        write_artifacts(s, r);
        print_report(s, r);
        check_case(s, r);

        const FrameImage &f1 = r.rendered.frames[0];
        uint32_t bad_first = 0;
        uint32_t bad_rest  = 0;
        for (uint32_t y = 0; y < V_ACTIVE; y++)
        {
            if (at(f1, 0, y) != s.base.regression_c1)
            {
                bad_first++;
            }
            for (uint32_t x = 1; x < H_ACTIVE; x++)
            {
                if (at(f1, x, y) != s.base.regression_c2)
                {
                    bad_rest++;
                }
            }
        }
        printf("  normative result    pixel 0 = 0x%03X on %u/%u lines, pixels 1..639 = 0x%03X "
               "with %u exceptions\n",
               s.base.regression_c1, V_ACTIVE - bad_first, V_ACTIVE, s.base.regression_c2, bad_rest);
        CHECK(bad_first == 0,
              "m0-slot-regression: pixel 0 is not C1 on %u lines — the SET committed too early",
              bad_first);
        CHECK(bad_rest == 0,
              "m0-slot-regression: %u pixels in 1..639 are not C2 — the SET committed too late",
              bad_rest);
    }

    // --- M1: vertical scroll, and the JIT / short-line discipline -------------
    {
        CaseSpec s;
        s.name  = "m1-vscroll-jit";
        s.title = "1bpp vertical scroll with a 9-word-per-FRAME VIDCMD preamble";
        s.base  = common;
        s.base.framing            = FramingMode::JIT;
        s.base.jit_frame_preamble = true;
        // Deliberately NOT the /RS defaults (0xFFF/0x000), so the render proves
        // the preamble's SETs actually landed rather than passing by accident.
        s.base.held_fg = rgb444(13, 13, 15);
        s.base.held_bg = rgb444(0, 0, 2);
        s.v_scroll_step = 16;
        CaseResult r = run_case(s, ram, REARM_LATENCY_CYCLES);
        write_artifacts(s, r);
        print_report(s, r);
        check_case(s, r);
        check_vertical_scroll(s, r, s.v_scroll_step);
        check_incremental_api(s, r);

        // This is the firmware console's list shape: NINE VIDCMD words buy the
        // whole 480-line frame, because compositor.v holds the last source to
        // the end of a line and a line that gets no fill keeps holding.  Nine
        // and not three since the palette became a RAM: two three-word table
        // entries for the console's two colours, then SET(pix_base),
        // SET(pix_mode) and the one-slot passthrough RUN.
        printf("  JIT framing         %u VIDCMD words for the whole frame (%u..%u per line); "
               "hold covered %u slots\n",
               r.vidcmd_words_total, r.vidcmd_words_min, r.vidcmd_words_max,
               r.rendered.stats.vidcmd_hold_slots);
        CHECK(r.vidcmd_words_total == 2 * PALETTE_WORDS_PER_ENTRY + 3,
              "m1-vscroll-jit: expected exactly %u VIDCMD words per frame (two palette "
              "entries, base, mode and the RUN), got %u",
              2 * PALETTE_WORDS_PER_ENTRY + 3, r.vidcmd_words_total);
        CHECK(r.rendered.stats.vidcmd_hold_slots > 0,
              "m1-vscroll-jit: hold never engaged, so the short-line discipline is not "
              "actually being exercised");

        // Every pixel must be one of the preamble's two colours: hold has to
        // carry passthrough across 479 lines that were never filled.
        const FrameImage &f1 = r.rendered.frames[0];
        uint32_t off_palette = 0;
        for (Rgb444 c : f1.pixels)
        {
            if (c != s.base.held_fg && c != s.base.held_bg)
            {
                off_palette++;
            }
        }
        printf("  hold coverage       %u of %u pixels are neither preamble colour\n",
               off_palette, static_cast<uint32_t>(f1.pixels.size()));
        CHECK(off_palette == 0,
              "m1-vscroll-jit: %u pixels are not one of the preamble colours, so hold did "
              "not carry the frame", off_palette);
    }

    // --- M2: per-line colours + horizontal scroll -----------------------------
    GroupBudget m2_budget;
    {
        CaseSpec s;
        s.name  = "m2-perline";
        s.title = "per-line palette / mode / pixel_skip as blank-region VIDCMD SETs";
        s.base  = common;
        s.base.per_line_palette = true;
        s.base.per_line_mode    = true;
        s.h_scroll_step         = 3;
        CaseResult r = run_case(s, ram, REARM_LATENCY_CYCLES);
        write_artifacts(s, r);
        print_report(s, r);
        check_case(s, r);
        m2_budget = r.budget;

        // Frame 2 scrolls 3 pixels: word offset 0, pixel_skip 3.  Under the old
        // 3-bit MODE field this was near the edge of what was representable; a
        // 12-bit SET value now covers a whole word's worth of skip.
        const FrameImage &f1 = r.rendered.frames[0];
        const FrameImage &f2 = r.rendered.frames[1];
        uint32_t matched = 0;
        for (uint32_t x = 0; x + 3 < H_ACTIVE; x++)
        {
            if (at(f2, x, 250) == at(f1, x + 3, 250))
            {
                matched++;
            }
        }
        check_incremental_api(s, r);
        printf("  h-scroll check      frame 2 row 250 == frame 1 shifted left 3 px: %u/%u\n",
               matched, H_ACTIVE - 3);
        CHECK(matched == H_ACTIVE - 3, "m2-perline: horizontal scroll of 3 px matched only %u/%u",
              matched, H_ACTIVE - 3);
    }

    // --- M2b: mid-line palette change, now pixel-exact -------------------------
    {
        CaseSpec s;
        s.name  = "m2-split";
        s.title = "mid-line recolour by SET(pix_base), placed by VIDCMD slot arithmetic";
        s.base  = common;
        s.base.per_line_palette = true;
        s.base.per_line_mode    = true;
        s.base.mid_line_split   = true;
        s.base.split_pixel      = 320;
        s.base.split_fg         = rgb444(15, 0, 0);
        s.base.split_bg         = rgb444(0, 15, 0);
        // The two PAIRS the banked SET(pix_base) pair switches to, loaded once
        // per frame in vertical blanking.  Both entries of each pair carry ONE
        // colour, so the pixel a SET landed on is named by its colour whatever
        // the bitmap says there.  Entries 0 and 1 are the per-line ramp and are
        // rewritten in every HBLANK.
        s.base.palette[SPLIT_BASE_MID | 0] = s.base.split_bg;
        s.base.palette[SPLIT_BASE_MID | 1] = s.base.split_bg;
        s.base.palette[SPLIT_BASE_HI  | 0] = s.base.split_fg;
        s.base.palette[SPLIT_BASE_HI  | 1] = s.base.split_fg;
        s.base.palette_entries  = PALETTE_ENTRIES;
        CaseResult r = run_case(s, ram, REARM_LATENCY_CYCLES);
        write_artifacts(s, r);
        print_report(s, r);
        check_case(s, r);

        // Hand-computed expectation on line 100 of frame 1 (h_scroll 0):
        //   entries 0/1 are the line's own ramp: fg rgb444(3,12,15), bg (0,0,5)
        //   pattern bit(x,y) = ((x+y)/16)&1, and line 100 is not a marker row
        //   x=319: (419/16)=26 even -> bit 0 -> entry 0, the line's own bg
        //   x=320: the FIRST SET(pix_base) owns this slot -> the MID pair, which
        //          carries split_bg in BOTH entries
        //   x=336: the SECOND SET owned slot 321 -> the HI pair, split_fg
        const FrameImage &f1 = r.rendered.frames[0];
        const Rgb444 line_fg = line_palette_fg(100);
        const Rgb444 line_bg = line_palette_bg(100);
        printf("  split check         x=319 0x%03X (want 0x%03X), x=320 0x%03X (want 0x%03X), "
               "x=336 0x%03X (want 0x%03X)\n",
               at(f1, 319, 100), line_bg, at(f1, 320, 100), s.base.split_bg,
               at(f1, 336, 100), s.base.split_fg);
        CHECK(at(f1, 319, 100) == line_bg,
              "m2-split: pixel 319 is 0x%03X, expected the line's own bg 0x%03X",
              at(f1, 319, 100), line_bg);
        CHECK(at(f1, 320, 100) == s.base.split_bg,
              "m2-split: pixel 320 is 0x%03X, expected the MID pair's 0x%03X — the first "
              "SET(pix_base) did not land on its own slot", at(f1, 320, 100), s.base.split_bg);
        CHECK(at(f1, 336, 100) == s.base.split_fg,
              "m2-split: pixel 336 is 0x%03X, expected the split fg 0x%03X",
              at(f1, 336, 100), s.base.split_fg);

        // Nothing before the split may have changed.
        uint32_t early = 0;
        for (uint32_t x = 0; x < 320; x++)
        {
            const Rgb444 c = at(f1, x, 100);
            if (c != line_fg && c != line_bg)
            {
                early++;
            }
        }
        CHECK(early == 0, "m2-split: %u pixels before the split already show a split colour",
              early);
        (void)line_fg;

        // Skew compensation: re-author and re-render with a nonzero, asymmetric
        // cross-chip skew.  The list changes shape (the leading RUN shortens),
        // but the image must not, or the compensation is not doing its job.
        CaseSpec sk = s;
        sk.base.skew_pix = 3;
        sk.base.skew_cmp = 1;
        CaseResult rk = run_case(sk, ram, REARM_LATENCY_CYCLES);
        bool identical = true;
        for (uint32_t f = 0; f < RENDER_FRAMES && identical; f++)
        {
            identical = (rk.rendered.frames[f].pixels == r.rendered.frames[f].pixels);
        }
        printf("  skew compensation   re-run at SET->PIXEL %u px / SET->COMPOSITOR %u px: "
               "image %s\n",
               sk.base.skew_pix, sk.base.skew_cmp, identical ? "IDENTICAL" : "DIFFERS");
        CHECK(identical,
              "m2-split: compensating for a %u-pixel PIXEL-target skew changed the image, so "
              "the list builder's compensation is wrong", sk.base.skew_pix);

        // Restore the case's own authoring so the report and artifacts match.
        run_case(s, ram, REARM_LATENCY_CYCLES);
    }

    // --- ATTRIBUTE MODE, full rate: 80-column coloured text cells --------------
    //
    // One {fg[3:0], bg[3:0], pattern[7:0]} word per eight-pixel cell, so a
    // coloured 80-column text screen costs the same 80 words a line a 2bpp
    // picture does and needs no per-cell VIDCMD at all: the colours are IN the
    // stream.  With a TMS9918 palette loaded this is its Graphics II word.
    {
        CaseSpec s;
        s.name  = "m2-attr";
        s.title = "attribute mode: 80 coloured text cells a line, colours in the stream";
        s.base  = common;
        s.base.mode             = PixelMode::ATTR;
        s.base.fb_base          = FB_ATTR_BASE;
        s.base.fb_stride_bytes  = FB_ATTR_STRIDE;
        s.base.per_line_mode    = true;
        s.base.palette          = TEST_PALETTE;
        s.base.palette_entries  = PALETTE_ENTRIES;
        CaseResult r = run_case(s, ram, REARM_LATENCY_CYCLES);
        write_artifacts(s, r);
        print_report(s, r);
        check_case(s, r);

        const uint32_t words = pixel_words_for(s.base.mode, 0);
        printf("  stream cost         %u words/line, one per eight-pixel cell\n", words);
        CHECK(words == PIXELS_WORDS_ATTR,
              "m2-attr: %u words/line, expected %u", words, PIXELS_WORDS_ATTR);

        const FrameImage ref = attr_reference_frame(s.base);
        const uint32_t differing = compare_frames("attr", r, ref);
        CHECK(differing == 0,
              "m2-attr: %u pixels differ from the host-rasterized reference — the colour "
              "byte, the pattern byte or the cell boundary is wrong", differing);

        // The colour byte must belong to ITS OWN cell.  attr_colour changes one
        // clock after the load, which is the only edge that keeps the previous
        // cell's last pixel out of the new cell's colours (pixel.v; pixel_tb.v's
        // mut4 and mut6 are the negative controls).  Measured here as: the two
        // pixels either side of a cell boundary follow their own cells.
        const FrameImage &f1 = r.rendered.frames[0];
        uint32_t seam_bad = 0;
        for (uint32_t y = 0; y < V_ACTIVE; y++)
        {
            for (uint32_t cell = 1; cell < PIXELS_WORDS_ATTR; cell++)
            {
                const uint32_t x = cell * 8u;
                if (at(f1, x, y) != ref.pixels[y * H_ACTIVE + x] ||
                    at(f1, x - 1, y) != ref.pixels[y * H_ACTIVE + x - 1])
                {
                    seam_bad++;
                }
            }
        }
        printf("  cell seams          %u boundaries checked, %u wrong: the colour byte "
               "changes on the cell's first pixel and not before\n",
               (PIXELS_WORDS_ATTR - 1) * V_ACTIVE, seam_bad);
        CHECK(seam_bad == 0, "m2-attr: %u cell boundaries take the wrong cell's colour",
              seam_bad);
    }

    // --- M8: 2bpp, four entries a line, and a mid-line QUAD switch -------------
    uint32_t m8_vidcmd_words = 0;
    {
        CaseSpec s;
        s.name  = "m8-idx2bpp";
        s.title = "2bpp: 80 words/line, a palette quad, and a mid-line SET(pix_base)";
        s.base  = common;
        s.base.mode             = PixelMode::TWO_BPP;
        s.base.fb_base          = FB_IDX2_BASE;
        s.base.fb_stride_bytes  = FB_IDX2_STRIDE;
        s.base.per_line_mode    = true;
        s.base.palette          = TEST_PALETTE;
        s.base.palette_entries  = PALETTE_ENTRIES;
        // THE WHOLE PALETTE ONCE PER FRAME, in the frame's own preamble: sixteen
        // three-word entries, 48 words, all of them in blanking where the write's
        // four disturbed pixel slots cannot be seen.  Nothing in hardware clears
        // the RAM, so this is also the assertion that the entries survive 479
        // lines and the /RS between frames.
        //
        // A mid-line recolour of all four indices at once, by switching the QUAD
        // rather than by writing the RAM: two SET(pix_base) records as the
        // leading RUN's banked pair, so they land on consecutive slots.  A
        // mid-line palette WRITE would need three words per entry and four
        // covered slots; a base switch is one word and is pixel-exact.
        s.base.mid_line_split   = true;
        s.base.split_pixel      = 320;
        CaseResult r = run_case(s, ram, REARM_LATENCY_CYCLES);
        write_artifacts(s, r);
        print_report(s, r);
        check_case(s, r);

        const uint32_t words = pixel_words_for(s.base.mode, 0);
        printf("  stream rate         %u words/line at two stream bits per pixel clock\n",
               words);
        CHECK(words == PIXELS_WORDS_2BPP,
              "m8-idx2bpp: %u words/line, expected %u", words, PIXELS_WORDS_2BPP);

        const FrameImage ref = indexed2_reference_frame(s.base);
        const uint32_t differing = compare_frames("idx2bpp", r, ref);
        CHECK(differing == 0,
              "m8-idx2bpp: %u pixels differ from the host-rasterized reference — the dibit "
              "index, the palette quad or the mid-line SET seam is wrong", differing);

        // The palette load survived the frame: the last line's colours come out
        // of entries loaded in line 0's blanking.
        CHECK(r.rendered.stats.palette_unwritten_reads == 0,
              "m8-idx2bpp: %u pixels read palette entries nobody loaded",
              r.rendered.stats.palette_unwritten_reads);
        CHECK(r.rendered.stats.palette_bad_filler == 0,
              "m8-idx2bpp: %u palette writes stored the wrong colour — a filler is missing "
              "or carries the wrong value", r.rendered.stats.palette_bad_filler);
        CHECK(r.rendered.stats.palette_disturbed_visible == 0,
              "m8-idx2bpp: %u palette-write slots reached the DAC through passthrough; the "
              "frame's entries are all loaded in blanking, so none should",
              r.rendered.stats.palette_disturbed_visible);

        // The mid-line seam, pixel by pixel: slot 320 takes the MID quad and
        // slot 321 onwards the HI quad, each SET visible in its own slot.
        const FrameImage &f1 = r.rendered.frames[0];
        {
            const uint32_t probe = 100;
            const uint32_t code_at_320 = idx2_pattern_code(320, probe);
            const uint32_t code_at_336 = idx2_pattern_code(336, probe);
            const Rgb444 want_320 =
                TEST_PALETTE[palette_index_2bpp(SPLIT_BASE_MID, code_at_320)];
            const Rgb444 want_336 =
                TEST_PALETTE[palette_index_2bpp(SPLIT_BASE_HI, code_at_336)];
            printf("  split seam          line %u: x=319 0x%03X, x=320 0x%03X (want the MID "
                   "quad's 0x%03X), x=336 0x%03X (want the HI quad's 0x%03X)\n",
                   probe, at(f1, 319, probe), at(f1, 320, probe), want_320,
                   at(f1, 336, probe), want_336);
            CHECK(at(f1, 320, probe) == want_320,
                  "m8-idx2bpp: pixel 320 of line %u is 0x%03X, expected 0x%03X — the first "
                  "SET(pix_base) did not land on its own slot",
                  probe, at(f1, 320, probe), want_320);
            CHECK(at(f1, 336, probe) == want_336,
                  "m8-idx2bpp: pixel 336 of line %u is 0x%03X, expected 0x%03X — the second "
                  "SET(pix_base) did not land one slot later",
                  probe, at(f1, 336, probe), want_336);
        }

        // All four codes are on the screen, in the quad the base names.
        uint32_t per_code[4] = {0, 0, 0, 0};
        for (uint32_t y = 0; y < V_ACTIVE; y++)
        {
            for (uint32_t x = 0; x < H_ACTIVE; x++)
            {
                per_code[idx2_pattern_code(x, y)]++;
            }
        }
        const uint32_t want_quarter = (H_ACTIVE / 4u) * V_ACTIVE;
        printf("  four codes          %u / %u / %u / %u pixels (want %u each)\n",
               per_code[0], per_code[1], per_code[2], per_code[3], want_quarter);
        CHECK(per_code[0] == want_quarter && per_code[3] == want_quarter,
              "m8-idx2bpp: the pattern does not spend a quarter of the frame on each code");

        // Per-line delivery budget: the pixel stream AND the line's records, in
        // words, against the same 66%-of-the-bus cap the screen cases use.
        m8_vidcmd_words = r.vidcmd_words_max;
        const uint32_t line_total = words + r.vidcmd_words_max;
        printf("  line word budget    %u PIXELS + %u VIDCMD = %u words/line against the "
               "%u-word cap (%u%% of the %llu-SYSCLK line)\n",
               words, r.vidcmd_words_max, line_total, VIDCMD_WORDS_PER_LINE_CAP,
               VIDCMD_BUS_BUDGET_PERCENT, static_cast<unsigned long long>(LINE_SYSCLK));
        CHECK(line_total <= VIDCMD_WORDS_PER_LINE_CAP,
              "m8-idx2bpp: %u words/line (%u pixel + %u VIDCMD) is over the %u-word cap",
              line_total, words, r.vidcmd_words_max, VIDCMD_WORDS_PER_LINE_CAP);
    }

    // --- M10: 4bpp at half rate, all sixteen entries on every line -------------
    //
    // The deepest defined mode: 320 groups of four bits, each group two pixels
    // wide, indexing the whole palette with no pix_base at all.  4bpp at FULL
    // rate is UNDEFINED by design (two fetch triggers inside the eight-clock
    // end-of-line window) and the suite never emits it.
    {
        CaseSpec s;
        s.name  = "m10-idx4-half";
        s.title = "4bpp half rate: 80 words/line, all sixteen palette entries";
        s.base  = common;
        s.base.mode             = PixelMode::HALF_FOUR_BPP;
        s.base.fb_base          = FB_IDX4_BASE;
        s.base.fb_stride_bytes  = FB_IDX4_STRIDE;
        s.base.per_line_mode    = true;
        s.base.palette          = TEST_PALETTE;
        s.base.palette_entries  = PALETTE_ENTRIES;
        CaseResult r = run_case(s, ram, REARM_LATENCY_CYCLES);
        write_artifacts(s, r);
        print_report(s, r);
        check_case(s, r);

        const uint32_t words = pixel_words_for(s.base.mode, 0);
        printf("  stream cost         %u words/line for 320 four-bit groups\n", words);
        CHECK(words == PIXELS_WORDS_4BPP_HALF,
              "m10-idx4-half: %u words/line, expected %u", words, PIXELS_WORDS_4BPP_HALF);
        CHECK(!pixels_mode_defined(pixel_mode(PIXEL_DEPTH_4BPP, false)),
              "m10-idx4-half: 4bpp at FULL rate must be refused by the model, not computed");

        const FrameImage ref = indexed4_half_reference_frame(s.base);
        const uint32_t differing = compare_frames("idx4half", r, ref);
        CHECK(differing == 0,
              "m10-idx4-half: %u pixels differ from the host-rasterized reference — the "
              "nibble index or the half-rate pairing is wrong", differing);

        // Every entry is used, and every group spans exactly two pixels.
        const FrameImage &f1 = r.rendered.frames[0];
        bool seen[PALETTE_ENTRIES] = {};
        uint32_t split = 0;
        for (uint32_t y = 0; y < V_ACTIVE; y++)
        {
            for (uint32_t k = 0; k < H_ACTIVE / 2; k++)
            {
                seen[idx4_pattern_code(k, y)] = true;
                if (at(f1, 2 * k, y) != at(f1, 2 * k + 1, y))
                {
                    split++;
                }
            }
        }
        uint32_t used = 0;
        for (bool b : seen)
        {
            used += b ? 1u : 0u;
        }
        printf("  palette coverage    %u of %u entries displayed, %u groups span other than "
               "two slots\n", used, PALETTE_ENTRIES, split);
        CHECK(used == PALETTE_ENTRIES,
              "m10-idx4-half: only %u of %u entries were displayed", used, PALETTE_ENTRIES);
        CHECK(split == 0,
              "m10-idx4-half: %u groups do not span exactly two pixel clocks", split);
    }

    // --- M9: half rate, with MASK sprites at full pixel resolution -------------
    {
        CaseSpec s;
        s.name  = "m9-halfrate";
        s.title = "half rate: a 320-wide playfield under 640-wide MASK sprites";
        s.base  = common;
        s.base.mode             = PixelMode::HALF_1BPP;
        s.base.per_line_palette = true;
        s.base.per_line_mode    = true;
        s.base.sprites          = SpriteStyle::MASK_SPRITES;
        s.base.held_fg          = rgb444(15, 15, 0);
        s.base.held_bg          = rgb444(2, 0, 8);
        CaseResult r = run_case(s, ram, REARM_LATENCY_CYCLES);
        write_artifacts(s, r);
        print_report(s, r);
        check_case(s, r);

        const uint32_t m9_half_1bpp_words = pixel_words_for(s.base.mode, 0);
        printf("  stream cost         %u words/line, half of 1bpp's %u — 320 groups across "
               "the same 640-clock window\n", m9_half_1bpp_words, PIXELS_WORDS_1BPP);
        CHECK(m9_half_1bpp_words == PIXELS_WORDS_1BPP_HALF,
              "m9-halfrate: half-rate 1bpp is %u words/line, expected %u",
              m9_half_1bpp_words, PIXELS_WORDS_1BPP_HALF);

        const FrameImage ref = halfrate_reference_frame(s.base);
        const uint32_t differing = compare_frames("halfrate", r, ref);
        CHECK(differing == 0,
              "m9-halfrate: %u pixels differ from the host-rasterized reference — the group "
              "pairing or a mask dibit is landing on the wrong pixel", differing);

        // THE GROUP LAW, measured off the frame rather than asserted from the
        // authoring: outside the sprite cells every 2k / 2k+1 pair must be one
        // colour, because one consumed group is held for exactly two pixel
        // clocks.  A group held for one clock, three, or with the pair phase
        // inverted breaks this immediately.
        const FrameImage &f1 = r.rendered.frames[0];
        uint32_t pairs_checked = 0;
        uint32_t pairs_split   = 0;
        uint32_t mask_splits   = 0;
        for (uint32_t y = 0; y < V_ACTIVE; y++)
        {
            for (uint32_t k = 0; k < H_ACTIVE / 2; k++)
            {
                const uint32_t x = 2 * k;
                const bool differs = at(f1, x, y) != at(f1, x + 1, y);
                if (in_mask_sprite(x) || in_mask_sprite(x + 1))
                {
                    mask_splits += differs ? 1u : 0u;
                    continue;
                }
                pairs_checked++;
                pairs_split += differs ? 1u : 0u;
            }
        }
        printf("  group law           %u playfield groups checked, %u span less than 2 "
               "slots\n", pairs_checked, pairs_split);
        CHECK(pairs_split == 0,
              "m9-halfrate: %u of %u playfield groups do not span exactly 2 pixel clocks",
              pairs_split, pairs_checked);

        // AND THE INTEROP STATEMENT, as its own number: inside the sprite cells
        // adjacent pixels DO differ, because a MASK steps one dibit per
        // pixel-clock slot and COMPOSITOR never learns what rate PIXEL is
        // running at.  Half rate is a stream-side gate inside PIXEL alone.
        printf("  MASK interop        %u adjacent pairs inside the sprite cells differ: a "
               "mask keeps full %u-pixel resolution over a %u-wide playfield\n",
               mask_splits, H_ACTIVE, H_ACTIVE / 2);
        CHECK(mask_splits > 0,
              "m9-halfrate: no adjacent pair inside a sprite cell differs, so the MASK "
              "records are being quantized to the playfield's groups");
        CHECK(r.rendered.stats.vidcmd_mask_records / RENDER_FRAMES ==
                  MASK_SPRITE_COUNT * V_ACTIVE,
              "m9-halfrate: %u MASK records per frame, expected %u",
              r.rendered.stats.vidcmd_mask_records / RENDER_FRAMES,
              MASK_SPRITE_COUNT * V_ACTIVE);

        // The same case in ATTRIBUTE mode at half rate: a 320-wide tile screen,
        // 40 words a line, under the same full-resolution sprites.  Same 320
        // groups, same group law — which is what says half rate is one gate and
        // not a per-mode special case.
        CaseSpec t = s;
        t.name  = "m9-halfrate-attr";
        t.title = "half rate in attribute mode: a 320-wide tile screen, 40 words/line";
        t.base.mode             = PixelMode::HALF_ATTR;
        t.base.fb_base          = FB_ATTR_BASE;
        t.base.fb_stride_bytes  = FB_ATTR_STRIDE;
        t.base.per_line_palette = false;
        t.base.palette          = TEST_PALETTE;
        t.base.palette_entries  = PALETTE_ENTRIES;
        CaseResult tr = run_case(t, ram, REARM_LATENCY_CYCLES);
        write_artifacts(t, tr);
        print_report(t, tr);
        check_case(t, tr);

        const uint32_t m9_half_attr_words = pixel_words_for(t.base.mode, 0);
        const FrameImage &g1 = tr.rendered.frames[0];
        uint32_t attr_pairs_split = 0;
        for (uint32_t y = 0; y < V_ACTIVE; y++)
        {
            for (uint32_t k = 0; k < H_ACTIVE / 2; k++)
            {
                const uint32_t x = 2 * k;
                if (in_mask_sprite(x) || in_mask_sprite(x + 1))
                {
                    continue;
                }
                if (at(g1, x, y) != at(g1, x + 1, y))
                {
                    attr_pairs_split++;
                }
            }
        }
        printf("  half+attribute      %u words/line (half of %u), %u split groups\n",
               m9_half_attr_words, PIXELS_WORDS_ATTR, attr_pairs_split);
        CHECK(m9_half_attr_words == PIXELS_WORDS_ATTR_HALF,
              "m9-halfrate-attr: %u words/line, expected %u",
              m9_half_attr_words, PIXELS_WORDS_ATTR_HALF);
        CHECK(attr_pairs_split == 0,
              "m9-halfrate-attr: %u playfield groups do not span exactly 2 pixel clocks",
              attr_pairs_split);
    }

    uint32_t m3_cursor_words = 0;
    uint32_t m3_sprite_words = 0;

    // --- M3: cursor -----------------------------------------------------------
    {
        CaseSpec s;
        s.name  = "m3-cursor";
        s.title = "1bpp plus a 16x16 arrow cursor, decomposed into held-colour spans";
        s.base  = common;
        s.base.sprites    = SpriteStyle::CURSOR;
        s.base.cursor_x = 300;
        s.base.cursor_y = 200;
        // Neither held colour may equal PIXEL's default palette (0xFFF / 0x000)
        // or the visibility count cannot tell composited from not.
        s.base.held_fg = rgb444(15, 0, 0);
        s.base.held_bg = rgb444(0, 0, 15);
        // The PLAYFIELD's two entries.  These cases paint their sprites out of
        // COMPOSITOR's held colours, but the 1bpp bitmap underneath still comes
        // out of the palette RAM — which nothing clears, so the list has to load
        // it or the picture is the RAM's random power-up contents.
        s.base.palette[0] = PLAYFIELD_BG;
        s.base.palette[1] = PLAYFIELD_FG;
        s.base.palette_entries = 2;
        CaseResult r = run_case(s, ram, REARM_LATENCY_CYCLES);
        write_artifacts(s, r);
        print_report(s, r);
        check_case(s, r);
        // The arrow mask has 84 opaque pixels and every one of them is painted
        // with a held colour — plus, since 2026-08-19, the HOLD slots the fetch
        // cadence spends inside the art, because a HOLD keeps the current
        // source and the current source there IS a held colour.
        //
        // Derived per row from L4/L5, not measured.  A row's records are
        // {RUN(pt,gap), seg, seg, ...}; the leading RUN and the first segment
        // are the line's banked pair, so the first segment lands on its
        // authored slot and every later segment lands one slot after the
        // previous segment ENDS if that segment was long enough to cover a
        // fetch, and two slots after it starts otherwise.  Rows 0,1 (single
        // segment) and 5..10 (segments >= 4 px) are exact; rows 2 and 13,15
        // add 2 HOLDs each, rows 3,12,14 add 1, and row 11 — six 1-px segments
        // with a 1-px hole — adds 5.  2+1+0+0+0+0+0+0+0+5+1+2+1+2 = 14.
        check_tiles_visible(s, r, 84 + 14);
        printf("  cadence regression  the arrow's 84 opaque pixels now paint %u: %u rows carry\n"
               "                      1-px fg/bg segments, and at the 2-clock fetch each of\n"
               "                      those costs a HOLD slot that keeps the art's own held\n"
               "                      colour.  Worst row +5 (six 1-px segments).  The line\n"
               "                      still frames exactly %u — the stretch comes out of the\n"
               "                      trailing filler — so the damage stays on its own row.\n",
               84 + 14, r.vidcmd_stretch_lines / RENDER_FRAMES, H_ACTIVE);
        m3_cursor_words = r.vidcmd_words_max;
    }

    // --- M3b: four sprites per line, the worst case ---------------------------
    {
        CaseSpec s;
        s.name  = "m3-sprites";
        s.title = "worst case: four sprites per line as spans, plus covering runs";
        s.base  = common;
        s.base.sprites   = SpriteStyle::FOUR_SPRITES;
        s.base.held_fg = rgb444(15, 15, 0);
        s.base.held_bg = rgb444(8, 0, 8);
        s.base.palette[0] = PLAYFIELD_BG;
        s.base.palette[1] = PLAYFIELD_FG;
        s.base.palette_entries = 2;
        CaseResult r = run_case(s, ram, REARM_LATENCY_CYCLES);
        write_artifacts(s, r);
        print_report(s, r);
        check_case(s, r);
        // 4 sprites x 480 lines; the diamond's popcount over a 16-row cycle is
        // 2*(2+4+6+8+10+12+14+16) = 144, i.e. 9 per row on average.
        check_tiles_visible(s, r, 4 * 144 * (V_ACTIVE / 16));
        m3_sprite_words = r.vidcmd_words_max;
    }

    // --- M6: the console screen, entirely out of MASK records ------------------
    {
        CaseSpec s;
        s.name  = "m6-console";
        s.title = "80x60 text screen as MASK groups: pure VIDCMD, no PIXELS descriptors";
        s.base  = common;
        s.base.screen      = ScreenStyle::CONSOLE;
        s.base.pure_vidcmd = true;
        CaseResult r = run_case(s, ram, REARM_LATENCY_CYCLES);
        write_artifacts(s, r);
        print_report(s, r);
        check_case(s, r);

        const uint32_t px0_bad = console_pixel0_violations();
        printf("  layout invariant    %u of %u groups want ink on a record's implicit pixel 0 "
               "(the 8-px cell's blank column 0 is what keeps it 0)\n",
               px0_bad, (H_ACTIVE / MASK_SLOTS) * V_ACTIVE);
        CHECK(px0_bad == 0,
              "m6-console: %u mask groups want ink on pixel 0, which the record cannot "
              "express — the cell layout is wrong", px0_bad);

        const FrameImage ref = console_reference_frame();
        const uint32_t differing = compare_frames("console", r, ref);
        CHECK(differing == 0,
              "m6-console: %u pixels differ from the host-rasterized reference — the MASK "
              "records do not reproduce the text screen", differing);

        // Per-line delivery budget.  A full-width line is every group a record
        // plus the two per-line SETs; the cap is the 66% bus figure the rest of
        // the suite sits at (descriptor.h).
        uint32_t worst   = 0;
        uint32_t typical = 0;
        uint32_t blank_lines = 0;
        std::array<uint32_t, 256> hist{};
        for (uint8_t n : r.line_words)
        {
            hist[n]++;
            if (n > worst)
            {
                worst = n;
            }
            if (n <= 3)
            {
                blank_lines++;
            }
        }
        for (uint32_t n = 0; n < hist.size(); n++)
        {
            if (hist[n] > hist[typical])
            {
                typical = n;
            }
        }
        printf("  console budget      worst line %u words, most common %u words (%u lines), "
               "%u all-background lines\n", worst, typical, hist[typical], blank_lines);
        printf("                      full-width ceiling %u words (%u groups x %u + 2 SETs) "
               "vs the %u-word cap\n",
               CONSOLE_FULL_LINE_WORDS, H_ACTIVE / MASK_SLOTS, MASK_RECORD_WORDS,
               VIDCMD_WORDS_PER_LINE_CAP);
        printf("                      %u SYSCLK/line worst against the %llu-SYSCLK line "
               "(%u%% budget = %u SYSCLK)\n",
               r.budget.max_busy, static_cast<unsigned long long>(LINE_SYSCLK),
               VIDCMD_BUS_BUDGET_PERCENT, VIDCMD_LINE_SYSCLK_BUDGET);
        CHECK(worst <= VIDCMD_WORDS_PER_LINE_CAP,
              "m6-console: worst line is %u VIDCMD words, over the %u-word delivery cap",
              worst, VIDCMD_WORDS_PER_LINE_CAP);
        CHECK(CONSOLE_FULL_LINE_WORDS <= VIDCMD_WORDS_PER_LINE_CAP,
              "m6-console: even a full-width console line (%u words) would not fit the "
              "%u-word cap, so the screen mode is not deliverable",
              CONSOLE_FULL_LINE_WORDS, VIDCMD_WORDS_PER_LINE_CAP);
        CHECK(blank_lines > 0,
              "m6-console: no line collapsed its blank groups into RUNs, so the RUN-gap half "
              "of the encoding is not being exercised");

        // The third colour, in situ: the title row, the status row and every
        // row's "NN>" prefix are dibit 00.
        uint32_t alt_px = 0;
        for (Rgb444 c : r.rendered.frames[0].pixels)
        {
            if (c == CONSOLE_ALT_COLOR)
            {
                alt_px++;
            }
        }
        printf("  third colour in use %u pixels are dibit-00 passthrough at 0x%03X "
               "(pix_pal_bg), painted with no SET between the groups that carry them\n",
               alt_px, CONSOLE_ALT_COLOR);
        printf("                      *** MODEL BEHAVIOUR pending verification against "
               "pixel.v — see the THIRD COLOUR probe above ***\n");
        CHECK(alt_px > 0,
              "m6-console: no passthrough pixels rendered, so the third colour is not being "
              "exercised");

        // The group is bigger than HBLANK and that is fine: an 82-word deposit
        // is 164 SYSCLK against an 89-SYSCLK HBLANK, so most lines' VIDCMD words
        // land during the previous line's ACTIVE video.  Under CUSHION that is
        // legal by construction — what matters is that the words are in the FIFO
        // before the line they belong to starts, and the compositor eats a
        // mask's two words over sixteen slots (one word per ~4.4 SYSCLK) against
        // an engine that delivers one per 2.  Both dry counters are what say so.
        printf("  delivery            %u words spill past HBLANK into the previous line's "
               "active video; FIFO high %u, dry 0, cadence holds %u\n",
               r.rendered.stats.vidcmd_late_words / RENDER_FRAMES,
               r.rendered.stats.vidcmd_fifo_high, r.rendered.stats.vidcmd_cadence_slots);
        CHECK(r.rendered.stats.vidcmd_hold_slots == 0,
              "m6-console: the compositor ran dry for %u slots — the spill is not covered by "
              "the cushion", r.rendered.stats.vidcmd_hold_slots);

        printf("  headline            %u MASK records per frame paint an 80x60 text screen "
               "with ZERO PIXELS words;\n"
               "                      the display list IS the framebuffer, and a text cell "
               "costs one word.\n",
               r.rendered.stats.vidcmd_mask_records / RENDER_FRAMES);
    }

    // --- M7: the kiosk menu ----------------------------------------------------
    {
        CaseSpec s;
        s.name  = "m7-kiosk";
        s.title = "large-text menu: one MASK record per big glyph, SET pairs, LITERAL+HOLD bar";
        s.base  = common;
        s.base.screen      = ScreenStyle::KIOSK;
        s.base.pure_vidcmd = true;
        CaseResult r = run_case(s, ram, REARM_LATENCY_CYCLES);
        write_artifacts(s, r);
        print_report(s, r);
        check_case(s, r);

        const uint32_t px0_bad = kiosk_pixel0_violations();
        printf("  layout invariant    %u mask groups want ink on their implicit pixel 0 "
               "(the x%u font is 15 px in a 16-px cell, so column 0 is always blank)\n",
               px0_bad, KIOSK_SCALE_X);
        CHECK(px0_bad == 0,
              "m7-kiosk: %u mask groups want ink on pixel 0 — a big font wider than %u px "
              "would need two records per glyph and force its middle column to color0",
              px0_bad, MASK_SLOTS - 1);

        const FrameImage ref = kiosk_reference_frame();
        const uint32_t differing = compare_frames("kiosk", r, ref);
        CHECK(differing == 0,
              "m7-kiosk: %u pixels differ from the host-rasterized reference — the mid-item "
              "SET seam or a mask group is landing on the wrong pixel", differing);

        // THE [SET,SET,MASK] SEAM, measured off the rendered frame rather than
        // asserted from the authoring.  Item 0 is "PLAY" then a recolour then
        // "DEMO"; the recolour sits BETWEEN two mask groups, so by the derived
        // law it costs MASK_GAP_AFTER_MASK_SET_SET slots and "DEMO" starts that
        // many pixels later.  "PLAY"'s last record ends at 192; "DEMO"'s first
        // record is a 16-pixel cell whose column 0 is blank, so the first ink
        // pixel after the seam is (seam start + gap + 1).
        {
            const KioskLinePlan plan = kiosk_plan_line(145);
            const uint32_t after_play = plan.seg[0].x0 + plan.seg[0].records * KIOSK_CELL_W;
            const Rgb444   bg = plan.background_color;
            uint32_t first_ink = after_play;
            while (first_ink < H_ACTIVE &&
                   at(r.rendered.frames[0], first_ink, 145) == bg)
            {
                first_ink++;
            }
            const uint32_t seam = (first_ink - 1) - after_play;
            printf("  SET,SET seam        \"PLAY\" ends at x=%u, \"DEMO\"'s cell starts at "
                   "x=%u: seam %u slot(s)\n", after_play, first_ink - 1, seam);
            printf("                      derived: the mask holds staged_word, so only ONE "
                   "word parks on Q and the two\n"
                   "                      SETs cannot pair — each costs its own slot plus a "
                   "cadence HOLD, %u + %u = %u.\n",
                   MASK_GAP_AFTER_MASK_SET, MASK_GAP_AFTER_MASK_SET,
                   MASK_GAP_AFTER_MASK_SET_SET);
            CHECK(seam == MASK_GAP_AFTER_MASK_SET_SET,
                  "m7-kiosk: the [SET,SET,MASK] group seam renders as %u slot(s), the laws "
                  "give %u", seam, MASK_GAP_AFTER_MASK_SET_SET);
        }

        uint32_t worst = 0;
        for (uint8_t n : r.line_words)
        {
            if (n > worst)
            {
                worst = n;
            }
        }
        // The reported stretch is the SET seams, not starvation: the authored
        // slot SUM does not include the cadence's HOLD slots, so a line with a
        // recolour reads as stretched even though it frames exactly 640 and the
        // FIFO never runs dry.  That is what the two counters below separate.
        printf("  kiosk cadence       stretch max %u slot(s) on %u lines = the SET seams, "
               "not starvation (dry slots %u, occupancy %u..%u)\n",
               r.vidcmd_stretch_max, r.vidcmd_stretch_lines / RENDER_FRAMES,
               r.rendered.stats.vidcmd_hold_slots, r.vidcmd_slot_min, r.vidcmd_slot_max);
        CHECK(r.vidcmd_stretch_max <= MASK_GAP_AFTER_MASK_SET_SET - 1,
              "m7-kiosk: a line stretched %u slots, more than the %u the mid-item SET seam "
              "accounts for", r.vidcmd_stretch_max, MASK_GAP_AFTER_MASK_SET_SET - 1);
        printf("  kiosk budget        worst line %u words; sparse recolouring (one SET pair "
               "per menu item, not per group) FITS the %u-word cap\n",
               worst, VIDCMD_WORDS_PER_LINE_CAP);
        printf("                      full-density recolouring — a SET pair in front of "
               "EVERY 16-pixel group — costs\n"
               "                      %u groups x (2 SETs + %u mask words) = %u words/line, "
               "which BLOWS the %u-word cap;\n"
               "                      and it does not even fit the LINE: %u x (%u + %u) = %u "
               "slots against %u available.\n",
               H_ACTIVE / MASK_SLOTS, MASK_RECORD_WORDS, KIOSK_FULL_DENSITY_WORDS,
               VIDCMD_WORDS_PER_LINE_CAP, H_ACTIVE / MASK_SLOTS, MASK_SLOTS,
               MASK_GAP_AFTER_MASK_SET_SET, KIOSK_FULL_DENSITY_SLOTS, H_ACTIVE);
        CHECK(worst <= VIDCMD_WORDS_PER_LINE_CAP,
              "m7-kiosk: worst line is %u VIDCMD words, over the %u-word delivery cap",
              worst, VIDCMD_WORDS_PER_LINE_CAP);
        CHECK(KIOSK_FULL_DENSITY_WORDS > VIDCMD_WORDS_PER_LINE_CAP,
              "m7-kiosk: full-density recolouring (%u words) now fits the %u-word cap, so "
              "the budget arithmetic this case prints needs re-deriving",
              KIOSK_FULL_DENSITY_WORDS, VIDCMD_WORDS_PER_LINE_CAP);
        CHECK(KIOSK_FULL_DENSITY_SLOTS > H_ACTIVE,
              "m7-kiosk: full-density recolouring now fits in %u slots", H_ACTIVE);

        // The LITERAL + HOLD highlight bar, and the mask backgrounds that have
        // to match it: inside a mask, dibit 00 is PASSTHROUGH, not "the span
        // underneath", so the bar's colour has to be re-stated as cmp_color0.
        const Rgb444 bar = KIOSK_HIGHLIGHT_COLOR;
        uint32_t bar_px = 0;
        for (Rgb444 c : r.rendered.frames[0].pixels)
        {
            if (c == bar)
            {
                bar_px++;
            }
        }
        printf("  highlight bar       %u pixels at 0x%03X: LITERAL + HOLD spans across the line plus "
               "the selected item's cmp_color0,\n"
               "                      which must be stated separately because a mask's "
               "dibit 00 is passthrough, not the span under it.\n", bar_px, bar);
        CHECK(bar_px > H_ACTIVE, "m7-kiosk: the highlight bar painted only %u pixels", bar_px);
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
