bradgrantham/griffin/emulator/emulator.cpp

#include <algorithm>
#include <array>
#include <chrono>
#include <ctime>
#include <cmath>
#include <cstdint>
#include <cinttypes>
#include <cstdlib>
#include <deque>
#include <thread>
#include <vector>

#include <SDL3/SDL.h>

#include "../griffin.generated.h"

// The display-list pipeline is not re-implemented here.  super-engine/ is the
// semantics authority — its EngineWalker is edma3.v's descriptor state machine
// and its PixelUnit/CompositorUnit are pixel.v and compositor.v, all validated
// against cpld/compositor/compositor_tb.v by `make -C super-engine check`.  The
// emulator is one of that suite's two drivers; the suite itself is the other,
// so a behaviour that only exists here is a bug rather than a convenience.
#include "descriptor.h"
#include "audio_chip.h"
#include "scheduler.h"
#include "interpret.h"
#include "render.h"

// pty.h / util.h pull in termios.h which #defines EXTB, colliding with
// a Moira enum member.  Include Moira first, then the PTY header.
#include "Moira.h"

#include <fcntl.h>
#include <sys/ioctl.h>
#include <sys/select.h>
#include <sys/stat.h>
#include <termios.h>
#include <unistd.h>
#ifdef __APPLE__
#include <util.h>
#include <sys/disk.h>
#else
#include <pty.h>
#endif

constexpr uint32_t DEBUG_BUS = 0x0001;
constexpr uint32_t DEBUG_IO = 0x0002;
constexpr uint32_t DEBUG_UART = 0x0004;
constexpr uint32_t DEBUG_DISASSEMBLE = 0x0008;
constexpr uint32_t DEBUG_DEBUG_BIT = 0x0010;
constexpr uint32_t DEBUG_CF = 0x0020;
constexpr uint32_t DEBUG_DUART = 0x0040;
constexpr uint32_t DEBUG_SPEED = 0x0080;
constexpr uint32_t debug = 0; // DEBUG_BUS | DEBUG_IO | DEBUG_UART;

using namespace Griffin;


// PTY-based console for serial emulation.
// The master fd acts like the UART: write() sends to the terminal,
// read() receives keystrokes.  Works on macOS and Linux.
struct PTYConsole
{
    // The console funnels reads through read_fd and writes through write_fd.
    // For the default pty both are the master fd; for automation they can be
    // stdin/stdout or input/output files.
    int master_fd = -1;             // pty master (owned), -1 if not a pty
    int read_fd = -1;
    int write_fd = -1;
    bool close_read_fd = false;     // close read_fd in dtor (file mode)
    bool close_write_fd = false;    // close write_fd in dtor (file mode)
    mutable bool have_pending = false;
    mutable uint8_t pending = 0;
    mutable bool input_eof = false; // read() returned 0 — no more console input

    // Default interactive console: allocate a pty and print the slave path.
    bool open(const char *label = "Console PTY")
    {
        int slave_fd;
        if(openpty(&master_fd, &slave_fd, NULL, NULL, NULL) < 0)
        {
            perror("openpty");
            return false;
        }
        fprintf(stderr, "%s: %s\n", label, ttyname(slave_fd));
        close(slave_fd);
        fcntl(master_fd, F_SETFL, O_NONBLOCK);
        read_fd = master_fd;
        write_fd = master_fd;
        return true;
    }

    // Console on stdin/stdout, for piped automation.
    bool open_stdio()
    {
        read_fd = STDIN_FILENO;
        write_fd = STDOUT_FILENO;
        fcntl(read_fd, F_SETFL, O_NONBLOCK);
        return true;
    }

    // Connect to an EXISTING device/pty bidirectionally (e.g. the host end
    // of a socat pty bridge).  Unlike open() this doesn't allocate a pty --
    // it opens a stable path someone else owns, so the peer (host pppd) can
    // be set up once and outlive many emulator runs.  Raw mode so no line
    // discipline mangles PPP's HDLC bytes.
    bool open_dev(const char* path)
    {
        int fd = ::open(path, O_RDWR | O_NONBLOCK | O_NOCTTY);
        if (fd < 0) { perror(path); return false; }
        struct termios t;
        if (tcgetattr(fd, &t) == 0)
        {
            cfmakeraw(&t);
            tcsetattr(fd, TCSANOW, &t);
        }
        read_fd = fd;
        write_fd = fd;
        close_read_fd = true;   // sole owner of this fd
        return true;
    }

    // Console backed by files; either path may be null to disable that side.
    bool open_files(const char* in_path, const char* out_path)
    {
        if(in_path)
        {
            read_fd = ::open(in_path, O_RDONLY | O_NONBLOCK);
            if(read_fd < 0) { perror(in_path); return false; }
            close_read_fd = true;
        }
        if(out_path)
        {
            write_fd = ::open(out_path, O_WRONLY | O_CREAT | O_TRUNC, 0644);
            if(write_fd < 0) { perror(out_path); return false; }
            close_write_fd = true;
        }
        return true;
    }

    ~PTYConsole()
    {
        if(master_fd >= 0)
        {
            close(master_fd);
        }
        if(close_read_fd && read_fd >= 0)
        {
            close(read_fd);
        }
        if(close_write_fd && write_fd >= 0)
        {
            close(write_fd);
        }
    }

    // On macOS, FIONREAD on a PTY master is unreliable: it can return a
    // positive count when no readable bytes are actually available (it
    // appears to reflect pending master-write data, not master-readable
    // data).  The resulting non-blocking read() then returns EAGAIN and
    // the DUART emulation would enqueue spurious 0x00 bytes, drowning
    // real keystrokes.  Instead, actually attempt a non-blocking read
    // and cache a single byte.
    bool is_data_ready() const
    {
        if(have_pending)
        {
            return true;
        }
        if(read_fd < 0)
        {
            return false;
        }
        uint8_t b;
        ssize_t n = read(read_fd, &b, 1);
        if(n == 1)
        {
            pending = b;
            have_pending = true;
            return true;
        }
        if(n == 0)
        {
            input_eof = true;
        }
        return false;
    }

    // Read one byte.  Returns true if a byte was read.
    bool receive(uint8_t *out) const
    {
        if(have_pending)
        {
            *out = pending;
            have_pending = false;
            return true;
        }
        if(read_fd < 0)
        {
            return false;
        }
        ssize_t n = read(read_fd, out, 1);
        if(n == 0)
        {
            input_eof = true;
        }
        return n == 1;
    }

    void send(uint8_t ch) const
    {
        if(write_fd >= 0)
        {
            write(write_fd, &ch, 1);
        }
    }
};

// ---------------------------------------------------------------------------
// Compact Flash emulation — True IDE 8-bit PIO register model
// ---------------------------------------------------------------------------

struct CFState
{
    int fd = -1;
    bool read_only = false;
    uint64_t file_size = 0;

    uint8_t error = 0;
    uint8_t features = 0;
    uint8_t sector_count = 0;
    uint8_t sector_num = 0;     // LBA 7:0
    uint8_t cyl_lo = 0;         // LBA 15:8
    uint8_t cyl_hi = 0;         // LBA 23:16
    uint8_t drive_head = 0;     // LBA 27:24 + flags
    uint8_t status = 0;
    uint8_t command = 0;

    uint8_t data_buf[512];
    int data_idx = 0;
    int data_len = 0;
    int sectors_remaining = 0;
    bool is_write = false;

    uint8_t identify_buf[512];

    bool is_present() const { return fd >= 0; }

    // Store an ATA string into the identify buffer at the given word offset.
    // ATA strings have the first char of each word in the high byte.
    // In 8-bit PIO mode the low byte is read first, so we store:
    //   buf[word*2]   = second char (low byte)
    //   buf[word*2+1] = first char  (high byte)
    static void set_ata_string(uint8_t *buf, int word_start, int word_count, const char *str)
    {
        int len = word_count * 2;
        int slen = strlen(str);
        for (int i = 0; i < len; i += 2)
        {
            char c0 = (i < slen) ? str[i] : ' ';
            char c1 = (i + 1 < slen) ? str[i + 1] : ' ';
            buf[word_start * 2 + i]     = c1;  // low byte = second char
            buf[word_start * 2 + i + 1] = c0;  // high byte = first char
        }
    }

    void build_identify()
    {
        memset(identify_buf, 0, 512);
        uint32_t sectors = file_size / 512;

        // Word 0: general config — CF flag + non-removable
        identify_buf[0] = 0x8A;
        identify_buf[1] = 0x84;

        // Word 1: default cylinders
        uint16_t cyls = (sectors > 16 * 63) ? (sectors / (16 * 63)) : 1;
        if (cyls > 16383)
        {
            cyls = 16383;
        }
        identify_buf[2] = cyls & 0xFF;
        identify_buf[3] = (cyls >> 8) & 0xFF;

        // Word 3: default heads
        identify_buf[6] = 16;
        identify_buf[7] = 0;

        // Word 6: sectors per track
        identify_buf[12] = 63;
        identify_buf[13] = 0;

        // Words 7-8: number of sectors in card (CHS compat)
        uint32_t chs_sectors = (uint32_t)cyls * 16 * 63;
        if (chs_sectors > sectors)
        {
            chs_sectors = sectors;
        }
        identify_buf[14] = chs_sectors & 0xFF;
        identify_buf[15] = (chs_sectors >> 8) & 0xFF;
        identify_buf[16] = (chs_sectors >> 16) & 0xFF;
        identify_buf[17] = (chs_sectors >> 24) & 0xFF;

        // Words 10-19: serial number
        set_ata_string(identify_buf, 10, 10, "GRIFFIN00001");

        // Words 23-26: firmware revision
        set_ata_string(identify_buf, 23, 4, "EMU 1.0");

        // Words 27-46: model string
        set_ata_string(identify_buf, 27, 20, "GRIFFIN CF EMULATOR");

        // Word 49: capabilities — LBA supported (bit 9)
        identify_buf[98] = 0x00;
        identify_buf[99] = 0x02;  // bit 9 = LBA

        // Words 60-61: total addressable LBA sectors
        identify_buf[120] = sectors & 0xFF;
        identify_buf[121] = (sectors >> 8) & 0xFF;
        identify_buf[122] = (sectors >> 16) & 0xFF;
        identify_buf[123] = (sectors >> 24) & 0xFF;
    }

    bool open(const char *path, bool ro)
    {
        read_only = ro;
        fd = ::open(path, ro ? O_RDONLY : O_RDWR);
        if (fd < 0)
        {
            perror(path);
            return false;
        }
        struct stat st;
        if (fstat(fd, &st) < 0)
        {
            perror("fstat");
            ::close(fd);
            fd = -1;
            return false;
        }
        file_size = st.st_size;
        if (S_ISBLK(st.st_mode) || S_ISCHR(st.st_mode))
        {
#ifdef __APPLE__
            uint64_t block_count = 0;
            uint32_t block_size = 0;
            if (ioctl(fd, DKIOCGETBLOCKCOUNT, &block_count) < 0
                || ioctl(fd, DKIOCGETBLOCKSIZE, &block_size) < 0)
            {
                perror("ioctl(DKIOCGETBLOCK*)");
                ::close(fd);
                fd = -1;
                return false;
            }
            file_size = (off_t)block_count * (off_t)block_size;
#else
            // Fall back to seeking to end for other platforms.
            off_t end = lseek(fd, 0, SEEK_END);
            if (end < 0)
            {
                perror("lseek");
                ::close(fd);
                fd = -1;
                return false;
            }
            file_size = end;
            lseek(fd, 0, SEEK_SET);
#endif
        }
        if (file_size < 512)
        {
            fprintf(stderr, "CF image too small (%llu bytes, need at least 512)\n",
                    (unsigned long long)file_size);
            ::close(fd);
            fd = -1;
            return false;
        }
        status = CF_STATUS_DRDY;
        build_identify();
        uint32_t sectors = file_size / 512;
        fprintf(stderr, "CF: %s (%u sectors, %llu bytes%s)\n",
                path, sectors, (unsigned long long)file_size,
                ro ? ", read-only" : "");
        return true;
    }

    ~CFState()
    {
        if (fd >= 0)
        {
            ::close(fd);
        }
    }

    uint32_t lba() const
    {
        return (uint32_t)sector_num
             | ((uint32_t)cyl_lo << 8)
             | ((uint32_t)cyl_hi << 16)
             | ((uint32_t)(drive_head & 0x0F) << 24);
    }

    void load_sector()
    {
        uint32_t addr = lba();
        if (sectors_remaining > 0 && data_idx >= data_len)
        {
            // Advance LBA for multi-sector reads
            addr = lba();
        }
        off_t offset = (off_t)addr * 512;
        if (offset + 512 > (off_t)file_size)
        {
            // Beyond end of file — return zeros
            memset(data_buf, 0, 512);
        }
        else
        {
            lseek(fd, offset, SEEK_SET);
            ssize_t n = ::read(fd, data_buf, 512);
            if (n < 512)
            {
                memset(data_buf + (n > 0 ? n : 0), 0, 512 - (n > 0 ? n : 0));
            }
        }
        data_idx = 0;
        data_len = 512;
    }

    void flush_sector()
    {
        if (read_only)
        {
            error = 0x04;  // ABRT
            status = CF_STATUS_DRDY | CF_STATUS_ERR;
            return;
        }
        uint32_t addr = lba();
        off_t offset = (off_t)addr * 512;
        if (offset + 512 <= (off_t)file_size)
        {
            lseek(fd, offset, SEEK_SET);
            ::write(fd, data_buf, 512);
        }
    }

    void advance_lba()
    {
        // Increment the LBA stored across the registers
        uint32_t a = lba() + 1;
        sector_num = a & 0xFF;
        cyl_lo = (a >> 8) & 0xFF;
        cyl_hi = (a >> 16) & 0xFF;
        drive_head = (drive_head & 0xF0) | ((a >> 24) & 0x0F);
    }

    void execute_command(uint8_t cmd)
    {
        command = cmd;
        switch (cmd)
        {
            case CF_CMD_IDENTIFY:
                memcpy(data_buf, identify_buf, 512);
                data_idx = 0;
                data_len = 512;
                status = CF_STATUS_DRDY | CF_STATUS_DRQ;
                error = 0;
                if (debug & DEBUG_CF)
                {
                    printf("[CF: IDENTIFY]\n");
                }
                break;

            case CF_CMD_READ_SECTORS:
                sectors_remaining = sector_count == 0 ? 256 : sector_count;
                is_write = false;
                load_sector();
                sectors_remaining--;
                status = CF_STATUS_DRDY | CF_STATUS_DRQ;
                error = 0;
                if (debug & DEBUG_CF)
                {
                    printf("[CF: READ %d sector(s) at LBA %u]\n",
                           sector_count == 0 ? 256 : sector_count, lba());
                }
                break;

            case CF_CMD_WRITE_SECTORS:
                sectors_remaining = sector_count == 0 ? 256 : sector_count;
                is_write = true;
                data_idx = 0;
                data_len = 512;
                status = CF_STATUS_DRDY | CF_STATUS_DRQ;
                error = 0;
                if (debug & DEBUG_CF)
                {
                    printf("[CF: WRITE %d sector(s) at LBA %u]\n",
                           sector_count == 0 ? 256 : sector_count, lba());
                }
                break;

            case CF_CMD_SET_FEATURES:
                // Acknowledge; 8-bit mode is implicit in emulation
                status = CF_STATUS_DRDY;
                error = 0;
                if (debug & DEBUG_CF)
                {
                    printf("[CF: SET FEATURES 0x%02X]\n", features);
                }
                break;

            default:
                // Unknown command — set ABRT error
                error = 0x04;
                status = CF_STATUS_DRDY | CF_STATUS_ERR;
                if (debug & DEBUG_CF)
                {
                    printf("[CF: unknown command 0x%02X]\n", cmd);
                }
                break;
        }
    }

    uint8_t read_reg(uint32_t abs_addr)
    {
        if (!is_present())
        {
            return 0xFF;  // no device
        }

        if (abs_addr == CF_DATA)
        {
            if (!(status & CF_STATUS_DRQ) || is_write)
            {
                return 0xFF;
            }
            uint8_t val = data_buf[data_idx++];
            if (data_idx >= data_len)
            {
                if (sectors_remaining > 0)
                {
                    // Multi-sector: advance and load next
                    advance_lba();
                    load_sector();
                    sectors_remaining--;
                }
                else
                {
                    // Transfer complete
                    status = CF_STATUS_DRDY;
                }
            }
            return val;
        }
        else if (abs_addr == CF_ERROR)
        {
            return error;
        }
        else if (abs_addr == CF_SECTOR_COUNT)
        {
            return sector_count;
        }
        else if (abs_addr == CF_SECTOR_NUM)
        {
            return sector_num;
        }
        else if (abs_addr == CF_CYL_LO)
        {
            return cyl_lo;
        }
        else if (abs_addr == CF_CYL_HI)
        {
            return cyl_hi;
        }
        else if (abs_addr == CF_DRIVE_HEAD)
        {
            return drive_head;
        }
        else if (abs_addr == CF_STATUS)
        {
            return status;
        }
        return 0xFF;
    }

    void write_reg(uint32_t abs_addr, uint8_t val)
    {
        if (!is_present())
        {
            return;
        }

        if (abs_addr == CF_DATA)
        {
            if (!(status & CF_STATUS_DRQ) || !is_write)
            {
                return;
            }
            data_buf[data_idx++] = val;
            if (data_idx >= data_len)
            {
                // Sector buffer full — write it out
                flush_sector();
                sectors_remaining--;
                if (sectors_remaining > 0)
                {
                    advance_lba();
                    data_idx = 0;
                    data_len = 512;
                    status = CF_STATUS_DRDY | CF_STATUS_DRQ;
                }
                else
                {
                    status = CF_STATUS_DRDY;
                }
            }
        }
        else if (abs_addr == CF_FEATURES)
        {
            features = val;
        }
        else if (abs_addr == CF_SECTOR_COUNT)
        {
            sector_count = val;
        }
        else if (abs_addr == CF_SECTOR_NUM)
        {
            sector_num = val;
        }
        else if (abs_addr == CF_CYL_LO)
        {
            cyl_lo = val;
        }
        else if (abs_addr == CF_CYL_HI)
        {
            cyl_hi = val;
        }
        else if (abs_addr == CF_DRIVE_HEAD)
        {
            drive_head = val;
        }
        else if (abs_addr == CF_COMMAND)
        {
            execute_command(val);
        }
    }
};

// ---------------------------------------------------------------------------
// Raw stdin watcher for the interactive exit escape: ~. at line start exits
// (like ssh).  Other typed bytes are discarded — console I/O is the DUART
// PTY, not the emulator's own stdin.
// ---------------------------------------------------------------------------

struct StdinConsole
{
    struct termios orig_termios;
    bool raw_mode = false;
    int escape_state = 1;  // 0=normal, 1=line start, 2=saw tilde
    bool have_pending = false;
    uint8_t pending = 0;

    bool open()
    {
        if (!isatty(STDIN_FILENO))
        {
            return false;
        }
        tcgetattr(STDIN_FILENO, &orig_termios);
        struct termios raw = orig_termios;
        cfmakeraw(&raw);
        raw.c_oflag |= OPOST | ONLCR;
        tcsetattr(STDIN_FILENO, TCSANOW, &raw);
        fcntl(STDIN_FILENO, F_SETFL, O_NONBLOCK);
        raw_mode = true;
        fprintf(stderr, "stdin: raw mode, ~. to exit\n");
        return true;
    }

    ~StdinConsole()
    {
        if (raw_mode)
        {
            tcsetattr(STDIN_FILENO, TCSANOW, &orig_termios);
        }
    }

    // Returns: 1 = byte in *out, 0 = no data, -1 = exit requested (~.)
    int poll(uint8_t *out)
    {
        if (have_pending)
        {
            *out = pending;
            have_pending = false;
            return 1;
        }

        if (!raw_mode)
        {
            return 0;
        }

        uint8_t ch;
        ssize_t n = ::read(STDIN_FILENO, &ch, 1);
        if (n != 1)
        {
            return 0;
        }

        if (escape_state == 2)
        {
            if (ch == '.')
            {
                return -1;
            }
            if (ch == '~')
            {
                escape_state = 0;
                *out = '~';
                return 1;
            }
            pending = ch;
            have_pending = true;
            escape_state = (ch == '\r' || ch == '\n') ? 1 : 0;
            *out = '~';
            return 1;
        }

        if (escape_state == 1 && ch == '~')
        {
            escape_state = 2;
            return 0;
        }

        escape_state = (ch == '\r' || ch == '\n') ? 1 : 0;
        *out = ch;
        return 1;
    }
};

// ---------------------------------------------------------------------------
// 68681 DUART emulation — Channel A UART via PTY, counter/timer, interrupts
//
// Minimal subset: Channel A TX/RX through the PTY, counter/timer for
// periodic interrupts (e.g. 59.95 Hz tick), ISR/IMR for IPL assertion.
// Channel B, I/O ports, and BRG details are stubs.
// ---------------------------------------------------------------------------


// MCP7940N real-time clock on the DUART's OP2/OP3/IP2/IP3 pins (griffin.yml
// "DUART" pin wiring): an I2C slave bit-banged by the firmware (firmware/
// rtc.cpp), driven here from OPR writes.  Pin levels: SCL = ~OPR[2]; the
// master releases SDA when OPR[3] = 1 (OP3 low, FET off) and pulls it low when
// OPR[3] = 0.  SDA as read back on IP2 is the AND of the master's and the
// slave's pulls.  MFP on IP3 is the 1 Hz square wave once CONTROL.SQWEN is
// set, else the CONTROL.OUT level (alarms are not modelled).
//
// Time runs on the GUEST clock (SYSCLK cycles), so --no-throttle runs the
// clock fast but MFP and the registers stay consistent with each other.  On
// start the registers hold the host's wall clock (UTC) with ST and VBATEN set;
// --rtc-blank starts a factory-fresh part (all zero, oscillator stopped),
// --rtc-epoch N starts at a fixed time, --no-rtc leaves the address unanswered.
// The model puts the MFP rising edge at the seconds rollover; whether the chip
// does is a bench measurement still owed (griffin.log, RTC prove-out).
struct MCP7940NState
{
    static constexpr unsigned REG_COUNT = 0x60;      // 0x00..0x1F control, 0x20..0x5F SRAM
    static constexpr uint8_t I2C_ADDR = static_cast<uint8_t>(RTC_I2C_ADDR);

    bool present = true;
    uint8_t regs[REG_COUNT] = {};

    // Time base
    bool running = false;
    uint32_t epoch_at_base = 0;
    uint64_t base_clock = 0;

    // Bus state as last driven by the master, and the slave's own pull.
    bool scl = true;
    bool sda_master = false;    // reset: OPR = 0 holds SDA low through the FET
    bool sda_slave = true;      // true = released

    enum class State { IDLE, ADDR, REG, DATA_W, DATA_R };
    State state = State::IDLE;
    uint8_t shift = 0;
    int bitcount = 0;
    uint8_t pointer = 0;
    bool ack_this_byte = false;

    bool mfp = false;

    static uint8_t bcd(unsigned v) { return static_cast<uint8_t>(((v / 10) << 4) | (v % 10)); }
    static unsigned unbcd(uint8_t v) { return (v >> 4) * 10 + (v & 0x0F); }

    // Howard Hinnant's civil <-> days, as firmware/rtc.cpp uses.
    static uint32_t epoch_from_civil(unsigned y, unsigned m, unsigned d, unsigned hh, unsigned mm, unsigned ss)
    {
        if (m <= 2) { y -= 1; }
        unsigned era = y / 400;
        unsigned yoe = y - era * 400;
        unsigned doy = (153 * ((m > 2) ? m - 3 : m + 9) + 2) / 5 + d - 1;
        unsigned doe = yoe * 365 + yoe / 4 - yoe / 100 + doy;
        uint32_t days = era * 146097 + doe - 719468;
        return days * 86400U + hh * 3600U + mm * 60U + ss;
    }

    static void civil_from_epoch(uint32_t epoch, unsigned &y, unsigned &m, unsigned &d,
                                 unsigned &hh, unsigned &mm, unsigned &ss, unsigned &wd)
    {
        uint32_t days = epoch / 86400U;
        uint32_t rem = epoch % 86400U;
        hh = rem / 3600U; mm = (rem / 60U) % 60U; ss = rem % 60U;
        wd = (days + 4U) % 7U;
        uint32_t z = days + 719468U;
        uint32_t era = z / 146097U;
        uint32_t doe = z - era * 146097U;
        uint32_t yoe = (doe - doe / 1460U + doe / 36524U - doe / 146096U) / 365U;
        uint32_t yy = yoe + era * 400U;
        uint32_t doy = doe - (365U * yoe + yoe / 4U - yoe / 100U);
        uint32_t mp = (5U * doy + 2U) / 153U;
        d = doy - (153U * mp + 2U) / 5U + 1U;
        m = (mp < 10U) ? mp + 3U : mp - 9U;
        y = yy + ((m <= 2U) ? 1U : 0U);
    }

    void start_with_epoch(uint32_t epoch)
    {
        running = true;
        epoch_at_base = epoch;
        base_clock = 0;
        regs[0x03] = 0x08;                              // VBATEN
        regs[0x00] = 0x80;                              // ST
        refresh_time_regs(0);
    }

    uint32_t current_epoch(uint64_t clock) const
    {
        if (!running) { return epoch_at_base; }
        return epoch_at_base + static_cast<uint32_t>((clock - base_clock) / SYSCLK_HZ);
    }

    // Encode the running time into 0x00..0x06, keeping the control bits.
    void refresh_time_regs(uint64_t clock)
    {
        unsigned y, m, d, hh, mm, ss, wd;
        civil_from_epoch(current_epoch(clock), y, m, d, hh, mm, ss, wd);
        if (y < 2000 || y > 2099) { return; }           // outside the chip's calendar: leave as is
        regs[0x00] = static_cast<uint8_t>((regs[0x00] & 0x80) | bcd(ss));
        regs[0x01] = bcd(mm);
        regs[0x02] = bcd(hh);                           // 24-hour format
        regs[0x03] = static_cast<uint8_t>((regs[0x03] & 0x18) | (running ? 0x20 : 0) | (wd + 1));
        regs[0x04] = bcd(d);
        bool leap = (y % 4 == 0);                       // 2000..2099: every fourth year
        regs[0x05] = static_cast<uint8_t>((leap ? 0x20 : 0) | bcd(m));
        regs[0x06] = bcd(y - 2000);
    }

    // The guest wrote one of 0x00..0x06: rebase the time on the registers.
    void apply_time_regs(uint64_t clock)
    {
        unsigned ss = unbcd(regs[0x00] & 0x7F);
        unsigned mm = unbcd(regs[0x01] & 0x7F);
        uint8_t hr = regs[0x02];
        unsigned hh;
        if (hr & 0x40) {
            hh = unbcd(hr & 0x1F) % 12 + ((hr & 0x20) ? 12 : 0);
        } else {
            hh = unbcd(hr & 0x3F);
        }
        unsigned d = unbcd(regs[0x04] & 0x3F);
        unsigned m = unbcd(regs[0x05] & 0x1F);
        unsigned y = 2000 + unbcd(regs[0x06]);
        bool valid = m >= 1 && m <= 12 && d >= 1 && d <= 31 && hh <= 23 && mm <= 59 && ss <= 59;
        epoch_at_base = valid ? epoch_from_civil(y, m, d, hh, mm, ss) : 0;
        base_clock = clock;
        running = (regs[0x00] & 0x80) != 0;
    }

    void write_reg(uint8_t reg, uint8_t val, uint64_t clock)
    {
        if (reg >= REG_COUNT) { return; }
        if (reg == 0x03) { val = static_cast<uint8_t>((val & ~0x20) | (regs[0x03] & 0x20)); }   // OSCRUN read-only
        if (reg == 0x05) { val = static_cast<uint8_t>((val & ~0x20) | (regs[0x05] & 0x20)); }   // LPYR read-only
        regs[reg] = val;
        if (reg <= 0x06) {
            apply_time_regs(clock);
            refresh_time_regs(clock);
        }
    }

    bool sda_bus() const { return sda_master && sda_slave; }

    // MFP level now; also the IP3 the DUART samples.
    bool mfp_level(uint64_t clock) const
    {
        uint8_t control = regs[0x07];
        if ((control & 0x40) == 0) { return (control & 0x80) != 0; }     // OUT bit
        if (!running) { return mfp; }
        uint64_t in_second = (clock - base_clock) % SYSCLK_HZ;
        unsigned fs = control & 0x03;                   // 0: 1 Hz, 1: 4.096 kHz, 2: 8.192 kHz, 3: 32.768 kHz
        if (fs == 0) { return in_second < SYSCLK_HZ / 2; }
        uint64_t f = (fs == 1) ? 4096 : (fs == 2) ? 8192 : 32768;
        return ((in_second * f * 2) / SYSCLK_HZ) % 2 == 0;
    }

    void tick(uint64_t clock) { mfp = mfp_level(clock); }

    // The master moved SCL and/or SDA (an OPR write).  Run the slave.
    void bus_update(bool new_scl, bool new_sda_master, uint64_t clock)
    {
        if (!present) { scl = new_scl; sda_master = new_sda_master; return; }
        bool sda_prev = sda_bus();
        sda_master = new_sda_master;
        bool sda_now = sda_bus();

        if (scl && new_scl) {
            if (sda_prev && !sda_now && sda_slave) {         // START / repeated START
                state = State::ADDR; shift = 0; bitcount = 0; sda_slave = true;
                refresh_time_regs(clock);
            } else if (!sda_prev && sda_now) {               // STOP
                state = State::IDLE; sda_slave = true; bitcount = 0;
            }
            return;
        }

        bool rising = !scl && new_scl;
        bool falling = scl && !new_scl;
        scl = new_scl;
        if (state == State::IDLE) { return; }

        if (state == State::DATA_R) {
            // Slave transmits: bits change on falling edges, the master's ACK
            // is sampled on the ninth rising edge.
            if (falling) {
                if (bitcount < 8) {
                    sda_slave = (shift & 0x80) != 0; shift = static_cast<uint8_t>(shift << 1); bitcount++;
                } else if (bitcount == 8) {
                    sda_slave = true;                       // release for the master's ACK
                    bitcount = 9;
                } else {
                    // after the ACK slot
                    if (ack_this_byte) {
                        pointer = static_cast<uint8_t>((pointer + 1) % REG_COUNT);
                        shift = regs[pointer];
                        sda_slave = (shift & 0x80) != 0; shift = static_cast<uint8_t>(shift << 1); bitcount = 1;
                    } else {
                        state = State::IDLE; sda_slave = true;
                    }
                }
            } else if (rising && bitcount == 9) {
                ack_this_byte = !sda_master;
                bitcount = 10;
            }
            return;
        }

        // Slave receives (ADDR, REG, DATA_W).
        if (rising) {
            if (bitcount < 8) {
                shift = static_cast<uint8_t>((shift << 1) | (sda_now ? 1 : 0));
                bitcount++;
            }
            return;
        }
        if (!falling) { return; }
        if (bitcount == 8) {
            // Eighth bit clocked in: decide and drive the ACK.
            switch (state) {
                case State::ADDR:
                    ack_this_byte = (shift >> 1) == I2C_ADDR;
                    break;
                case State::REG:
                    pointer = static_cast<uint8_t>(shift % REG_COUNT);
                    ack_this_byte = true;
                    break;
                case State::DATA_W:
                    write_reg(pointer, shift, clock);
                    pointer = static_cast<uint8_t>((pointer + 1) % REG_COUNT);
                    ack_this_byte = true;
                    break;
                default: break;
            }
            sda_slave = !ack_this_byte;
            bitcount = 9;
        } else if (bitcount == 9) {
            // ACK slot over: release, move on.
            sda_slave = true;
            if (!ack_this_byte) { state = State::IDLE; bitcount = 0; return; }
            switch (state) {
                case State::ADDR:
                    if (shift & 1) {
                        state = State::DATA_R;
                        shift = regs[pointer];
                        sda_slave = (shift & 0x80) != 0; shift = static_cast<uint8_t>(shift << 1); bitcount = 1;
                        return;
                    }
                    state = State::REG;
                    break;
                case State::REG:    state = State::DATA_W; break;
                case State::DATA_W: break;
                default: break;
            }
            shift = 0; bitcount = 0;
        }
    }
};

struct DUARTState
{
    // Channel A
    bool tx_enabled = false;
    bool rx_enabled = false;
    int mr_pointer_a = 0;       // 0 = next rw hits MR1, 1 = MR2+
    uint8_t mr_a[2] = {0, 0};  // stored but not interpreted

    // Channel B (stub)
    bool tx_enabled_b = false;
    bool rx_enabled_b = false;
    int mr_pointer_b = 0;
    uint8_t mr_b[2] = {0, 0};

    // Interrupt
    uint8_t imr = 0;
    bool ctr_ready = false;     // latched; clears on STOPCC read

    // Counter/timer
    uint8_t acr = 0;
    uint8_t ctur = 0xFF;
    uint8_t ctlr = 0xFF;
    bool ctr_running = false;
    uint64_t ctr_next_fire = 0; // in SYSCLK units
    uint64_t ctr_start_clock = 0; // SYSCLK at STARTCC; origin for the live count
    uint16_t ctr_latch = 0;       // value latched by a CUR read (68681 protocol)

    // IVR (accepted but unused — autovector mode)
    uint8_t ivr = 0x0F;

    // Output port
    uint8_t opcr = 0;
    uint8_t opr = 0;

    // Input port: IP0/IP1 (~CTS) read 0, IP2 = RTC SDA, IP3 = RTC MFP, IP4/IP5
    // (DCD/RI) read 0.  ipcr_delta accumulates IP0..IP3 changes until IPCR is
    // read; ISR.IPC is the delta masked by ACR[3:0].
    MCP7940NState rtc;
    uint8_t ip_last = 0;
    uint8_t ipcr_delta = 0;

    uint8_t ip_now() const
    {
        return static_cast<uint8_t>((rtc.sda_bus() ? DUART_IP_RTC_SDA : 0) |
                                    (rtc.mfp ? DUART_IP_RTC_MFP : 0));
    }

    void update_ip()
    {
        uint8_t now = ip_now();
        ipcr_delta = static_cast<uint8_t>(ipcr_delta | ((now ^ ip_last) & 0x0F));
        ip_last = now;
    }

    DUARTState()
    {
        rtc.tick(0);
        ip_last = ip_now();
    }

    // SYSCLK at the current bus write; IO_write8 sets it before write_reg.
    uint64_t write_clock = 0;

    // OP2 = SCL (pin = ~OPR[2]); OP3 high (OPR[3] = 0) pulls SDA low.
    void drive_rtc_bus()
    {
        bool scl = (opr & DUART_OP_RTC_SCL) == 0;
        bool sda_released = (opr & DUART_OP_RTC_SDA_DRIVE) != 0;
        rtc.bus_update(scl, sda_released, write_clock);
        update_ip();
    }

    uint16_t preload() const
    {
        return (static_cast<uint16_t>(ctur) << 8) | ctlr;
    }

    // Counter/timer period between IRQs in SYSCLK cycles.
    // Counter mode: one IRQ per preload countdown.
    // Timer mode: one IRQ per full square-wave period = 2*preload input cycles
    // (matches MC68681 hardware — preload alone gives only the half-period).
    uint64_t ctr_period_sysclk() const
    {
        uint32_t p = preload();
        if (p == 0)
        {
            p = 0x10000;  // 68681 treats 0 as 65536
        }
        uint64_t cycles = p;
        if ((acr & 0x40) != 0)
        {
            cycles *= 2;
        }
        return cycles * SYSCLK_HZ / DUART_CLOCK;
    }

    // Live 16-bit down-counter value (preload -> 0, repeating).  The 68681
    // counter itself always spans one preload countdown regardless of C/T mode,
    // so this is independent of the ACR square-wave doubling used for IRQs.
    uint16_t live_count(uint64_t clock_now) const
    {
        if (!ctr_running)
        {
            return preload();
        }
        uint32_t p = preload();
        if (p == 0)
        {
            p = 0x10000;
        }
        uint64_t countdown = static_cast<uint64_t>(p) * SYSCLK_HZ / DUART_CLOCK;
        if (countdown == 0)
        {
            return 0;
        }
        uint64_t elapsed = (clock_now >= ctr_start_clock)
                               ? (clock_now - ctr_start_clock) : 0;
        uint64_t phase = elapsed % countdown;              // 0 .. countdown-1
        uint64_t remaining = countdown - phase;            // countdown .. 1
        return static_cast<uint16_t>(static_cast<uint64_t>(p) * remaining / countdown);
    }

    // CUR (0x0D) latches the live count and returns its high byte; CLR (0x0F)
    // returns the low byte of the value latched by the preceding CUR read.
    uint8_t read_counter_byte(uint32_t abs, uint64_t clock_now)
    {
        if (abs == DUART_CUR)
        {
            ctr_latch = live_count(clock_now);
            return static_cast<uint8_t>(ctr_latch >> 8);
        }
        return static_cast<uint8_t>(ctr_latch & 0xFF);
    }

    // Advance timer state — call periodically from poll_io
    void check_timer(uint64_t clock_now)
    {
        rtc.tick(clock_now);
        update_ip();
        if (!ctr_running)
        {
            return;
        }
        while (clock_now >= ctr_next_fire)
        {
            ctr_ready = true;
            ctr_next_fire += ctr_period_sysclk();
        }
    }

    // Compute ISR from live state (a = channel A console, b = channel B)
    uint8_t isr(const PTYConsole &a, const PTYConsole &b) const
    {
        uint8_t val = 0;
        if (tx_enabled)
        {
            val |= DUART_ISR_TXRDYA_MASK;   // TX always ready
        }
        if (rx_enabled && a.is_data_ready())
        {
            val |= DUART_ISR_RXRDYA_MASK;
        }
        if (tx_enabled_b)
        {
            val |= DUART_ISR_TXRDYB_MASK;
        }
        if (rx_enabled_b && b.is_data_ready())
        {
            val |= DUART_ISR_RXRDYB_MASK;
        }
        if (ctr_ready)
        {
            val |= DUART_ISR_CTR_READY_MASK;
        }
        if ((ipcr_delta & acr & 0x0F) != 0)
        {
            val |= DUART_ISR_IPC_MASK;
        }
        return val;
    }

    bool irq_pending(const PTYConsole &a, const PTYConsole &b) const
    {
        return (isr(a, b) & imr) != 0;
    }

    // --- Command register decode (shared by CRA and CRB) ---
    static void apply_command(uint8_t val, bool &tx_en, bool &rx_en,
                              int &mr_ptr, uint8_t mr[2])
    {
        uint8_t ec = (val & DUART_CRA_EC_MASK) >> DUART_CRA_EC_SHIFT;
        uint8_t tc = (val & DUART_CRA_TC_MASK) >> DUART_CRA_TC_SHIFT;
        uint8_t mc = (val & DUART_CRA_MC_MASK) >> DUART_CRA_MC_SHIFT;

        if (ec == 1) { rx_en = true; }
        if (ec == 2) { rx_en = false; }
        if (tc == 1) { tx_en = true; }
        if (tc == 2) { tx_en = false; }

        switch (mc)
        {
            case 1: mr_ptr = 0; break;                     // reset MR pointer
            case 2: rx_en = false; break;                   // reset receiver
            case 3: tx_en = false; break;                   // reset transmitter
            case 4: break;                                  // reset error status (no-op)
            case 5: case 6: case 7: break;                  // break commands (no-op)
        }
    }

    uint8_t read_reg(uint32_t abs_addr, const PTYConsole &pty,
                     const PTYConsole &pty_b)
    {
        switch (abs_addr)
        {
            case DUART_MR1A:  // MR1A/MR2A share address; pointer auto-advances
            {
                uint8_t val = mr_a[mr_pointer_a];
                if (mr_pointer_a == 0)
                {
                    mr_pointer_a = 1;
                }
                return val;
            }
            case DUART_SRA:
            {
                uint8_t val = 0;
                if (rx_enabled && pty.is_data_ready())
                {
                    val |= DUART_SRA_RXRDY_MASK;
                }
                if (tx_enabled)
                {
                    val |= DUART_SRA_TXRDY_MASK | DUART_SRA_TXEMT_MASK;
                }
                return val;
            }
            case DUART_RBA:
            {
                uint8_t ch = 0;
                if (rx_enabled)
                {
                    pty.receive(&ch);
                }
                return ch;
            }
            case DUART_IPCR:
            {
                uint8_t val = static_cast<uint8_t>((ipcr_delta << 4) | ip_now());
                ipcr_delta = 0;
                return val;
            }
            case DUART_ISR:     return isr(pty, pty_b);
            case DUART_CUR:     return 0;
            case DUART_CLR:     return 0;
            case DUART_MR1B:  // MR1B/MR2B share address
            {
                uint8_t val = mr_b[mr_pointer_b];
                if (mr_pointer_b == 0)
                {
                    mr_pointer_b = 1;
                }
                return val;
            }
            case DUART_SRB:
            {
                uint8_t val = 0;
                if (rx_enabled_b && pty_b.is_data_ready())
                {
                    val |= DUART_SRA_RXRDY_MASK;    // SRB shares SRA's layout
                }
                if (tx_enabled_b)
                {
                    val |= DUART_SRA_TXRDY_MASK | DUART_SRA_TXEMT_MASK;
                }
                return val;
            }
            case DUART_RBB:
            {
                uint8_t ch = 0;
                if (rx_enabled_b)
                {
                    pty_b.receive(&ch);
                }
                return ch;
            }
            case DUART_IVR:     return ivr;
            case DUART_IP:      return ip_now();
            case DUART_STARTCC:
                ctr_running = true;
                // ctr_next_fire == 0 signals "needs initialization" — caller
                // sets it using getClock() after this returns.
                return 0;
            case DUART_STOPCC:
                // In Timer mode (ACR[6]=1), STOPCC only clears the IRQ
                // status; the counter keeps free-running.  In Counter
                // mode it fully halts the counter.
                ctr_ready = false;
                if ((acr & 0x40) == 0)
                {
                    ctr_running = false;
                    ctr_next_fire = 0;
                }
                return 0;
            default:
                return 0;
        }
    }

    void write_reg(uint32_t abs_addr, uint8_t val, const PTYConsole &pty,
                   const PTYConsole &pty_b)
    {
        switch (abs_addr)
        {
            case DUART_MR1A:  // MR1A/MR2A share address
                mr_a[mr_pointer_a] = val;
                if (mr_pointer_a == 0)
                {
                    mr_pointer_a = 1;
                }
                break;
            case DUART_CSRA:
                break;  // accept and ignore
            case DUART_CRA:
                apply_command(val, tx_enabled, rx_enabled, mr_pointer_a, mr_a);
                if (debug & DEBUG_DUART)
                {
                    printf("[DUART CRA: 0x%02X → tx=%d rx=%d]\n", val, tx_enabled, rx_enabled);
                }
                break;
            case DUART_TBA:
                if (tx_enabled)
                {
                    pty.send(val);
                }
                break;
            case DUART_ACR:     acr = val; break;
            case DUART_IMR:
                imr = val;
                if (debug & DEBUG_DUART)
                {
                    printf("[DUART IMR: 0x%02X]\n", val);
                }
                break;
            case DUART_CTUR:    ctur = val; break;
            case DUART_CTLR:    ctlr = val; break;
            case DUART_MR1B:  // MR1B/MR2B share address
                mr_b[mr_pointer_b] = val;
                if (mr_pointer_b == 0)
                {
                    mr_pointer_b = 1;
                }
                break;
            case DUART_CSRB:    break;
            case DUART_CRB:
                apply_command(val, tx_enabled_b, rx_enabled_b, mr_pointer_b, mr_b);
                break;
            case DUART_TBB:
                if (tx_enabled_b)
                {
                    pty_b.send(val);
                }
                break;
            case DUART_IVR:     ivr = val; break;
            case DUART_OPCR:    opcr = val; break;
            case DUART_OPR_SET: opr |= val; drive_rtc_bus(); break;
            case DUART_OPR_CLR: opr &= ~val; drive_rtc_bus(); break;
        }
    }
};

// R4G4B4 to ARGB8888.  Nibble replication (x17) is the DAC's own transfer
// function, and it is the same rule super-engine's PPM writer uses, so a
// --screenshot and a suite artifact of the same list are directly comparable.
// (r3g3b2_to_argb is gone with rev-1 VIDEO: the pipeline is 12-bit end to end.)
static uint32_t rgb444_to_argb(SuperEngine::Rgb444 c)
{
    const uint8_t r8 = SuperEngine::rgb444_channel_to_8(SuperEngine::rgb444_r(c));
    const uint8_t g8 = SuperEngine::rgb444_channel_to_8(SuperEngine::rgb444_g(c));
    const uint8_t b8 = SuperEngine::rgb444_channel_to_8(SuperEngine::rgb444_b(c));
    return 0xFF000000u | (uint32_t(r8) << 16) | (uint32_t(g8) << 8) | b8;
}

struct VideoState
{
    // 800 pixel clocks per line at 25.175 MHz, converted to SYSCLK (14 MHz)
    // via Bresenham: GCD(14000000,25175000)=25000 → 560/1007
    static constexpr uint64_t LINE_NUM = 800ULL * 560;  // 448000
    static constexpr uint64_t LINE_DEN = 1007;
    static constexpr int V_TOTAL = 525;
    static constexpr int V_ACTIVE = 480;
    static constexpr int V_SYNC_START = 490;
    static constexpr int H_ACTIVE = 640;

    uint64_t clock_next_line = 0;
    uint64_t frac_accum = 0;
    int v_cnt = 0;

    // Free-running count of scanlines emitted.  TIMING toggles PADDLE_TICK and
    // AUDIO_TICK once per scanline (at h_cnt == 0, from reset, with no
    // frame-boundary exception), and PORTS counts their falling edges, so the
    // delta of this counter is PORTS' entire timebase: its paddle and audio
    // rates cannot drift from the raster the way a private timer would.
    uint64_t line_count = 0;

    // TIMING's vsync pulse is latched in GLUE now, not in VIDEO — there is no
    // VIDEO peripheral any more and PIXEL/COMPOSITOR have no bus at all.  The
    // latch lives here because this is where vsync is generated; GLUE's
    // VSYNC_STATUS/VSYNC_CLEAR registers read and W1C it (see IO_read8).
    bool vsync_pending = false;

    SDL_Window *window = nullptr;
    SDL_Renderer *renderer = nullptr;
    SDL_Texture *texture = nullptr;
    bool sdl_ok = false;
    bool headless = false;          // skip SDL window; framebuffer still filled
    bool want_pixels = true;        // false => nobody views the fb: skip PIXEL,
                                     // COMPOSITOR and the ARGB conversion
                                     // (headless with no screenshot).  The
                                     // descriptor walk, its DMA stall and the
                                     // audio deposits still run, so guest
                                     // timing is unchanged — see service_video.
    std::vector<uint32_t> framebuffer;

    bool init()
    {
        // The framebuffer and scanline timing must exist even when no SDL
        // window is created (headless), because the DMA engine still fills it.
        framebuffer.resize(H_ACTIVE * V_ACTIVE, 0xFF000000u);

        // Seed the timing accumulator
        frac_accum = LINE_NUM;
        clock_next_line = frac_accum / LINE_DEN;
        frac_accum %= LINE_DEN;

        if (headless)
        {
            return true;
        }

        if (!SDL_Init(SDL_INIT_VIDEO))
        {
            fprintf(stderr, "SDL_Init failed: %s\n", SDL_GetError());
            return false;
        }
        window = SDL_CreateWindow("Griffin Video", H_ACTIVE, V_ACTIVE, 0);
        if (!window)
        {
            fprintf(stderr, "SDL_CreateWindow failed: %s\n", SDL_GetError());
            SDL_Quit();
            return false;
        }
        renderer = SDL_CreateRenderer(window, nullptr);
        if (!renderer)
        {
            fprintf(stderr, "SDL_CreateRenderer failed: %s\n", SDL_GetError());
            SDL_DestroyWindow(window);
            SDL_Quit();
            return false;
        }
        texture = SDL_CreateTexture(renderer, SDL_PIXELFORMAT_ARGB8888,
                                    SDL_TEXTUREACCESS_STREAMING,
                                    H_ACTIVE, V_ACTIVE);
        if (!texture)
        {
            fprintf(stderr, "SDL_CreateTexture failed: %s\n", SDL_GetError());
            SDL_DestroyRenderer(renderer);
            SDL_DestroyWindow(window);
            SDL_Quit();
            return false;
        }
        sdl_ok = true;

        return true;
    }

    // Save the current framebuffer to a BMP file.  Works headless — wraps the
    // existing ARGB8888 pixels in a surface, which needs no window or renderer.
    void dump_framebuffer(const char* path)
    {
        if (framebuffer.empty())
        {
            return;
        }
        SDL_Surface* surface = SDL_CreateSurfaceFrom(
            H_ACTIVE, V_ACTIVE, SDL_PIXELFORMAT_ARGB8888,
            framebuffer.data(), H_ACTIVE * sizeof(uint32_t));
        if (!surface)
        {
            fprintf(stderr, "SDL_CreateSurfaceFrom failed: %s\n", SDL_GetError());
            return;
        }
        if (!SDL_SaveBMP(surface, path))
        {
            fprintf(stderr, "SDL_SaveBMP(%s) failed: %s\n", path, SDL_GetError());
        }
        else
        {
            fprintf(stderr, "Wrote screenshot: %s\n", path);
        }
        SDL_DestroySurface(surface);
    }

    ~VideoState()
    {
        if (texture)  { SDL_DestroyTexture(texture); }
        if (renderer) { SDL_DestroyRenderer(renderer); }
        if (window)   { SDL_DestroyWindow(window); }
        if (sdl_ok)   { SDL_Quit(); }
    }

    // COMPOSITOR hands over one line of R4G4B4; this is only the DAC.
    void store_scanline(int line, const SuperEngine::Rgb444 *src)
    {
        uint32_t *row = &framebuffer[line * H_ACTIVE];
        for (int i = 0; i < H_ACTIVE; i++)
        {
            row[i] = rgb444_to_argb(src[i]);
        }
    }

    void present_frame()
    {
        if (!sdl_ok)
        {
            return;
        }
        SDL_UpdateTexture(texture, nullptr, framebuffer.data(),
                          H_ACTIVE * sizeof(uint32_t));
        SDL_RenderTexture(renderer, texture, nullptr, nullptr);
        SDL_RenderPresent(renderer);
    }

    // `service_line(v_cnt, stall)` does everything one scanline needs: advance
    // the ENGINE walker over that line's HBLANK edge, run PIXEL/COMPOSITOR
    // through the blanking interval and then the 640 active slots, and store
    // the result.  It is a callback because all of that needs the emulator's
    // RAM and PORTS, which VideoState deliberately does not know about.
    template<typename ServiceFn>
    uint32_t check_timer(uint64_t clock_now, ServiceFn&& service_line)
    {
        uint32_t stall_cycles = 0;
        while (clock_now >= clock_next_line)
        {
            service_line(v_cnt, stall_cycles);

            // VSYNC IRQ: hardware latches at (v_cnt==V_SYNC_START && h_last) —
            // the END of line 490.  In this model that is the current iteration,
            // before v_cnt is advanced.  Latching after the increment (i.e. when
            // v_cnt becomes V_SYNC_START) fires one line early and shifts the
            // per-line VIDCMD packet's effect down by a scanline.
            if (v_cnt == V_SYNC_START)
            {
                vsync_pending = true;
                present_frame();
            }

            v_cnt++;
            line_count++;       // one scanline == one PADDLE_TICK/AUDIO_TICK toggle

            if (v_cnt >= V_TOTAL)
            {
                v_cnt = 0;
            }

            frac_accum += LINE_NUM;
            uint64_t advance = frac_accum / LINE_DEN;
            frac_accum %= LINE_DEN;
            clock_next_line += advance;
        }
        return stall_cycles;
    }

    // There is no VIDEO register file any more: rev-1's CTRL/CLRINT/CLRERR
    // went with the chip.  Everything that used to configure video —
    // enable, palette, mode — is now in-band as VIDCMD SET instructions, and
    // the only CPU-visible bit left is the vsync latch, which GLUE owns.
    bool irq_pending() const { return vsync_pending; }
    void clear_irq() { vsync_pending = false; }
};

// ---------------------------------------------------------------------------
// ENGINE — display-list DMA engine (ATF1508AS CPLD, cpld/engine/edma3.v).
//
// Rev-1's ENGINE streamed a fixed 42 words per scanline from {SOURCE_PAGE,
// line*stride}.  This one walks a descriptor table in RAM's top 64K: the CPU
// writes the first descriptor's word address to DESC, which arms it, and the
// engine bus-masters its way through the list, strobing each payload word into
// one of three FIFOs.  There is no read path — no STATUS, no SOURCE_PAGE — so
// reads of the region return open bus.
//
// The state machine itself is NOT reimplemented here.  SuperEngine::EngineWalker
// is that machine, shared verbatim with super-engine/, and this struct is only
// the register decode plus the emulator's per-line driver bookkeeping.
//
// KNOWN SIMPLIFICATION, in the same spirit as rev-1's DMA-lump note: the walker
// is advanced once per scanline boundary and a whole line's deposits land at
// once, rather than spreading across the bus cycles that carried them.  Lumping
// is strictly EARLIER than hardware, so it cannot manufacture a FIFO fill that
// real timing would have missed — it can only hide a late one.  Lists that are
// marginal on delivery therefore look cleaner here than on the bench; the
// suite's clock-accurate driver is where that gets checked.  Intra-line tearing
// is not modelled for the same reason.
// ---------------------------------------------------------------------------

struct EngineState
{
    // Per-descriptor bus cost comes from descriptor.h's model (arbitration +
    // assert + 4-word fetch + 2 SYSCLK/payload word + release), so the stall
    // the CPU is charged is derived from the actual list rather than from a
    // fixed per-line constant the way rev-1's WORDS_PER_LINE was.
    SuperEngine::EngineWalker walker{SuperEngine::ENGINE_ARBITRATION_CYCLES};

    // DESC carries a 15-bit WORD address inside the descriptor page; edma3.v
    // forms {8'h3F, desc_ptr} from it.
    static uint32_t desc_byte_address(uint16_t val)
    {
        return SuperEngine::DESC_TABLE_BASE |
               ((static_cast<uint32_t>(val) & ENGINE_DESC_ADDR_MASK) << 1);
    }

    // ENGINE itself has no readable registers: GLUE answers DTACK and the
    // bus floats.  Its state is read through GLUE_ENGINE_STATUS.
    static constexpr uint8_t OPEN_BUS = 0xFF;
};

// ---------------------------------------------------------------------------
// PS/2 keyboard emulation — mirrors the GLUE PS/2 frame engine.
//
// GLUE assembles a whole frame and raises IRQ4 once per byte (RX_READY),
// validating parity/framing in hardware.  Here we model the device side:
// translate SDL key events into PS/2 Set 2 byte streams and deliver one
// assembled byte (RX_READY + PS2_RX_DATA) per ~1 ms as emulated time
// advances.  A PS2_TX_DATA write is treated as an instant, acknowledged
// host->device transmission (TX_DONE).
// ---------------------------------------------------------------------------

// Returns the set-2 make code, with 0xE0-prefixed (extended) keys encoded as
// 0xE0xx in the high/low bytes.  0 = unmapped.
static uint16_t sdl_to_ps2_set2(SDL_Scancode sc)
{
    switch (sc)
    {
        case SDL_SCANCODE_A: return 0x1C;
        case SDL_SCANCODE_B: return 0x32;
        case SDL_SCANCODE_C: return 0x21;
        case SDL_SCANCODE_D: return 0x23;
        case SDL_SCANCODE_E: return 0x24;
        case SDL_SCANCODE_F: return 0x2B;
        case SDL_SCANCODE_G: return 0x34;
        case SDL_SCANCODE_H: return 0x33;
        case SDL_SCANCODE_I: return 0x43;
        case SDL_SCANCODE_J: return 0x3B;
        case SDL_SCANCODE_K: return 0x42;
        case SDL_SCANCODE_L: return 0x4B;
        case SDL_SCANCODE_M: return 0x3A;
        case SDL_SCANCODE_N: return 0x31;
        case SDL_SCANCODE_O: return 0x44;
        case SDL_SCANCODE_P: return 0x4D;
        case SDL_SCANCODE_Q: return 0x15;
        case SDL_SCANCODE_R: return 0x2D;
        case SDL_SCANCODE_S: return 0x1B;
        case SDL_SCANCODE_T: return 0x2C;
        case SDL_SCANCODE_U: return 0x3C;
        case SDL_SCANCODE_V: return 0x2A;
        case SDL_SCANCODE_W: return 0x1D;
        case SDL_SCANCODE_X: return 0x22;
        case SDL_SCANCODE_Y: return 0x35;
        case SDL_SCANCODE_Z: return 0x1A;
        case SDL_SCANCODE_1: return 0x16;
        case SDL_SCANCODE_2: return 0x1E;
        case SDL_SCANCODE_3: return 0x26;
        case SDL_SCANCODE_4: return 0x25;
        case SDL_SCANCODE_5: return 0x2E;
        case SDL_SCANCODE_6: return 0x36;
        case SDL_SCANCODE_7: return 0x3D;
        case SDL_SCANCODE_8: return 0x3E;
        case SDL_SCANCODE_9: return 0x46;
        case SDL_SCANCODE_0: return 0x45;
        case SDL_SCANCODE_RETURN:    return 0x5A;
        case SDL_SCANCODE_SPACE:     return 0x29;
        case SDL_SCANCODE_BACKSPACE: return 0x66;
        case SDL_SCANCODE_ESCAPE:    return 0x76;
        case SDL_SCANCODE_TAB:       return 0x0D;

        case SDL_SCANCODE_LSHIFT:    return 0x12;
        case SDL_SCANCODE_RSHIFT:    return 0x59;
        case SDL_SCANCODE_LCTRL:     return 0x14;
        case SDL_SCANCODE_LALT:      return 0x11;
        case SDL_SCANCODE_CAPSLOCK:  return 0x58;

        case SDL_SCANCODE_MINUS:        return 0x4E;
        case SDL_SCANCODE_EQUALS:       return 0x55;
        case SDL_SCANCODE_LEFTBRACKET:  return 0x54;
        case SDL_SCANCODE_RIGHTBRACKET: return 0x5B;
        case SDL_SCANCODE_SEMICOLON:    return 0x4C;
        case SDL_SCANCODE_APOSTROPHE:   return 0x52;
        case SDL_SCANCODE_GRAVE:        return 0x0E;
        case SDL_SCANCODE_COMMA:        return 0x41;
        case SDL_SCANCODE_PERIOD:       return 0x49;
        case SDL_SCANCODE_SLASH:        return 0x4A;
        case SDL_SCANCODE_BACKSLASH:    return 0x5D;

        case SDL_SCANCODE_RCTRL:     return 0xE014;
        case SDL_SCANCODE_RALT:      return 0xE011;
        case SDL_SCANCODE_UP:        return 0xE075;
        case SDL_SCANCODE_DOWN:      return 0xE072;
        case SDL_SCANCODE_RIGHT:     return 0xE074;
        case SDL_SCANCODE_LEFT:      return 0xE06B;
        case SDL_SCANCODE_HOME:      return 0xE06C;
        case SDL_SCANCODE_END:       return 0xE069;
        case SDL_SCANCODE_PAGEUP:    return 0xE07D;
        case SDL_SCANCODE_PAGEDOWN:  return 0xE07A;
        case SDL_SCANCODE_INSERT:    return 0xE070;
        case SDL_SCANCODE_DELETE:    return 0xE071;

        default: return 0;
    }
}

// Odd-parity bit for x: 0 if x already has an odd number of 1s, else 1.
// Matches the firmware's odd_parity_bit() so the parity GLUE reports for
// a received byte makes the firmware's check pass.
static inline bool ps2_odd_parity_bit(uint8_t x)
{
    x ^= x >> 4;
    x ^= x >> 2;
    x ^= x >> 1;
    return ((x & 1u) ^ 1u) != 0;
}

struct PS2State;

// Device side of one PS/2 channel.  The frame engine above/below the hook is
// identical for both channels; only the attached device's command set and
// its self-initiated traffic differ.
struct PS2Device
{
    virtual ~PS2Device() = default;

    // Host->device byte (a PS2_TX_DATA write).  Responses are queued back
    // through the channel's normal RX pacing.
    virtual void command(uint64_t clock_now, uint8_t byte, PS2State &channel) = 0;

    // Device-initiated traffic, polled from the channel's timer service.  A
    // keyboard is purely reactive and needs nothing here; a streaming mouse
    // emits report packets on its own sample-rate cadence.
    virtual void service(uint64_t clock_now, PS2State &channel)
    {
        (void)clock_now;
        (void)channel;
    }
};

// Frame-level PS/2 model, mirroring the GLUE PS/2 frame engine: GLUE
// assembles whole frames, so we deliver one full byte (RX_READY +
// PS2_RX_DATA) per ~1 ms and treat a PS2_TX_DATA write as an instant,
// always-acknowledged host->device transmission (TX_DONE).
//
// The engine is address-agnostic: griffin.yml deliberately gives the PORTS
// mouse channel the same register offsets as the GLUE keyboard channel, so
// one instance serves either by taking the channel base address.  The device
// behaviour hangs off the PS2Device hook.
struct PS2State
{
    static constexpr uint64_t byte_period_sysclk = SYSCLK_HZ / 1000; // ~1 ms

    // Channel register offsets.  Taken from the GLUE keyboard channel and
    // asserted equal to the PORTS mouse channel's, so the shared layout that
    // makes one engine serve both is checked by the compiler, not by comment.
    static constexpr uint32_t OFFSET_TX_DATA = GLUE_PS2_TX_DATA - GLUE_BASE;
    static constexpr uint32_t OFFSET_STATUS  = GLUE_PS2_STATUS  - GLUE_BASE;
    static constexpr uint32_t OFFSET_CLEAR   = GLUE_PS2_CLEAR   - GLUE_BASE;
    static constexpr uint32_t OFFSET_CTRL    = GLUE_PS2_CTRL    - GLUE_BASE;
    static constexpr uint32_t OFFSET_RX_DATA = GLUE_PS2_RX_DATA - GLUE_BASE;
    static_assert(PORTS_PS2_MOUSE_TX_DATA - PORTS_BASE == OFFSET_TX_DATA);
    static_assert(PORTS_PS2_MOUSE_STATUS  - PORTS_BASE == OFFSET_STATUS);
    static_assert(PORTS_PS2_MOUSE_CLEAR   - PORTS_BASE == OFFSET_CLEAR);
    static_assert(PORTS_PS2_MOUSE_CTRL    - PORTS_BASE == OFFSET_CTRL);
    static_assert(PORTS_PS2_MOUSE_RX_DATA - PORTS_BASE == OFFSET_RX_DATA);

    uint32_t   base = GLUE_BASE;
    PS2Device *device = nullptr;

    std::deque<uint8_t> rx_bytes;
    uint64_t next_deliver_clock = 0;
    uint8_t  rx_data = 0;
    bool     rx_ready = false;
    bool     tx_done = false;
    // false = device acknowledged.  Resets true to match the RTL, which comes
    // up with TX_ACK set (glue.v `tx_ack <= 1'b1`, ports.v
    // `transmit_acknowledge <= 1'b1`) so an idle channel does not claim an
    // acknowledgement that never happened.
    bool     tx_ack_failed = true;
    uint8_t  ctrl = 0;

    bool init(uint32_t channel_base, PS2Device &attached)
    {
        base = channel_base;
        device = &attached;
        return true;
    }

    // Queue a device->host byte for timed delivery.
    void enqueue_byte(uint64_t clock_now, uint8_t byte)
    {
        if (rx_bytes.empty())
        {
            next_deliver_clock = clock_now + byte_period_sysclk;
        }
        rx_bytes.push_back(byte);
    }

    // Bytes still waiting to be shifted in.  A device that generates its own
    // traffic uses this to throttle itself instead of growing the queue
    // without bound when the guest is not draining the channel.
    size_t backlog() const { return rx_bytes.size(); }

    void check_timer(uint64_t clock_now)
    {
        if (device)
        {
            device->service(clock_now, *this);
        }
        if (!rx_ready && !rx_bytes.empty()
            && clock_now >= next_deliver_clock)
        {
            rx_data = rx_bytes.front();
            rx_bytes.pop_front();
            rx_ready = true;
            if (!rx_bytes.empty())
            {
                next_deliver_clock = clock_now + byte_period_sysclk;
            }
        }
    }

    // True for any address this channel decodes, including the parity-1 alias
    // of PS2_TX_DATA (parity rides address bit 1).
    bool is_addr(uint32_t abs_addr) const
    {
        uint32_t offset = abs_addr - base;
        return offset == OFFSET_TX_DATA
            || offset == OFFSET_TX_DATA + PS2_TX_DATA_PARITY
            || offset == OFFSET_STATUS
            || offset == OFFSET_CTRL
            || offset == OFFSET_RX_DATA;
    }

    uint8_t read_reg(uint32_t abs_addr) const
    {
        uint32_t offset = abs_addr - base;
        if (offset == OFFSET_STATUS)
        {
            uint8_t v = 0;
            if (rx_ready)      { v |= GLUE_PS2_STATUS_RX_READY_MASK; }
            if (tx_done)       { v |= GLUE_PS2_STATUS_TX_DONE_MASK; }
            if (tx_ack_failed) { v |= GLUE_PS2_STATUS_TX_ACK_MASK; }
            if (rx_ready && ps2_odd_parity_bit(rx_data))
            {
                v |= GLUE_PS2_STATUS_RX_PARITY_MASK;
            }
            // Idle-high live pin bits (debug).
            v |= GLUE_PS2_STATUS_DATA_LIVE_MASK;
            v |= GLUE_PS2_STATUS_CLK_LIVE_MASK;
            return v;
        }
        if (offset == OFFSET_RX_DATA)
        {
            return rx_data;
        }
        return 0;
    }

    void write_reg(uint32_t abs_addr, uint8_t val, uint64_t clock_now)
    {
        uint32_t offset = abs_addr - base;
        if (offset == OFFSET_CLEAR)
        {
            if (val & GLUE_PS2_CLEAR_RX_READY_MASK) { rx_ready = false; }
            if (val & GLUE_PS2_CLEAR_TX_DONE_MASK)  { tx_done = false; }
        }
        else if (offset == OFFSET_CTRL)
        {
            ctrl = val;
        }
        else if (offset == OFFSET_TX_DATA
                 || offset == OFFSET_TX_DATA + PS2_TX_DATA_PARITY)
        {
            // PS2_TX_DATA (0x09) or its parity-1 alias (0x0B): instant,
            // always-acked host->device transmission; the attached device
            // then responds to the command.
            tx_ack_failed = false;
            tx_done = true;
            if (device)
            {
                device->command(clock_now, val, *this);
            }
        }
    }

    bool irq_pending() const { return rx_ready || tx_done; }
};

// Generic PS/2 keyboard: host commands get real responses (0xFA ACK, ident
// bytes, BAT after reset) so guests that fully initialize the keyboard (Linux
// atkbd probe, u-boot's enable/LED writes) behave as they will on hardware.
// Responses ride the channel's 1 ms/byte RX pacing along with scancodes.
struct PS2Keyboard : PS2Device
{
    // Reset -> BAT completion delay.  Real keyboards take 500-750 ms; use
    // 300 ms so atkbd's reset timeout (guest jiffies) is comfortably met
    // while bounded test runs stay short.
    static constexpr uint64_t bat_delay_sysclk = SYSCLK_HZ * 3 / 10;

    uint64_t bat_due_clock = 0;        // nonzero: BAT (0xAA) pending after reset
    uint8_t  pending_cmd = 0;          // 0xED/0xF3 awaiting their data byte
    uint8_t  leds = 0;
    uint8_t  typematic = 0;
    bool     scanning = true;

    void service(uint64_t clock_now, PS2State &channel) override
    {
        if (bat_due_clock != 0 && clock_now >= bat_due_clock)
        {
            bat_due_clock = 0;
            channel.enqueue_byte(clock_now, 0xAA);      // BAT passed
        }
    }

    void command(uint64_t clock_now, uint8_t byte, PS2State &channel) override
    {
        if (pending_cmd == 0xED)        // set LEDs: data byte
        {
            leds = byte;
            pending_cmd = 0;
            channel.enqueue_byte(clock_now, 0xFA);
            return;
        }
        if (pending_cmd == 0xF3)        // set typematic: data byte
        {
            typematic = byte;
            pending_cmd = 0;
            channel.enqueue_byte(clock_now, 0xFA);
            return;
        }
        switch (byte)
        {
            case 0xFF:                  // reset
                channel.rx_bytes.clear();
                pending_cmd = 0;
                leds = 0;
                scanning = true;
                channel.enqueue_byte(clock_now, 0xFA);
                bat_due_clock = clock_now + bat_delay_sysclk;
                break;
            case 0xF2:                  // read ID: MF2 keyboard
                channel.enqueue_byte(clock_now, 0xFA);
                channel.enqueue_byte(clock_now, 0xAB);
                channel.enqueue_byte(clock_now, 0x83);
                break;
            case 0xED:                  // set LEDs (data byte follows)
            case 0xF3:                  // set typematic (data byte follows)
                pending_cmd = byte;
                channel.enqueue_byte(clock_now, 0xFA);
                break;
            case 0xF4:                  // enable scanning
                scanning = true;
                channel.enqueue_byte(clock_now, 0xFA);
                break;
            case 0xF5:                  // disable scanning
                scanning = false;
                channel.enqueue_byte(clock_now, 0xFA);
                break;
            case 0xEE:                  // echo
                channel.enqueue_byte(clock_now, 0xEE);
                break;
            default:                    // unrecognized: resend
                channel.enqueue_byte(clock_now, 0xFE);
                break;
        }
    }
};

// Standard PS/2 mouse with the Microsoft IntelliMouse extension.  Unlike the
// keyboard it is not purely reactive: once data reporting is enabled in
// stream mode it emits 3- (or 4-, with the wheel) byte movement packets at
// its programmed sample rate whenever the accumulated state has changed.
struct PS2Mouse : PS2Device
{
    // Reset -> BAT completion delay, same rationale as the keyboard's.
    static constexpr uint64_t bat_delay_sysclk = SYSCLK_HZ * 3 / 10;

    // Post-reset defaults from the PS/2 mouse spec.
    static constexpr uint8_t DEFAULT_SAMPLE_RATE = 100;   // reports/second
    static constexpr uint8_t DEFAULT_RESOLUTION  = 2;     // 4 counts/mm

    // Device IDs: 0x00 = plain 3-button, 0x03 = IntelliMouse with a wheel.
    static constexpr uint8_t ID_STANDARD    = 0x00;
    static constexpr uint8_t ID_INTELLIMOUSE = 0x03;

    // Button bits, in PS/2 packet-byte-0 order.
    static constexpr uint8_t BUTTON_LEFT   = 0x01;
    static constexpr uint8_t BUTTON_RIGHT  = 0x02;
    static constexpr uint8_t BUTTON_MIDDLE = 0x04;

    // Movement fields are 9-bit two's complement: 8 bits in the data byte and
    // the sign in packet byte 0.
    static constexpr int MOVE_MIN = -256;
    static constexpr int MOVE_MAX = 255;

    // Don't pile up packets the guest is not draining; the channel delivers
    // one byte per millisecond, so a slow ISR must be allowed to fall behind
    // exactly as a real mouse would be inhibited.
    static constexpr size_t MAX_BACKLOG = PS2_RX_QUEUE_SIZE;

    uint8_t  sample_rate = DEFAULT_SAMPLE_RATE;
    uint8_t  resolution = DEFAULT_RESOLUTION;
    bool     scaling_2_1 = false;
    bool     stream_mode = true;       // false = remote (host polls with 0xEB)
    bool     reporting = false;        // data reporting enabled (0xF4)
    uint8_t  device_id = ID_STANDARD;
    uint8_t  pending_cmd = 0;          // 0xF3/0xE8 awaiting their data byte
    uint64_t bat_due_clock = 0;
    uint64_t next_report_clock = 0;

    // IntelliMouse "knock": set-sample-rate 200, 100, 80 in a row switches the
    // device to ID 3 and 4-byte packets with a wheel.
    int knock_stage = 0;

    // Host-side state waiting to be turned into packets.
    int     accum_dx = 0;
    int     accum_dy = 0;              // PS/2 convention: positive is up
    int     accum_dz = 0;              // wheel detents
    uint8_t buttons = 0;
    bool    state_changed = false;

    uint64_t report_period_sysclk() const
    {
        uint8_t rate = sample_rate != 0 ? sample_rate : DEFAULT_SAMPLE_RATE;
        return SYSCLK_HZ / rate;
    }

    void set_defaults()
    {
        sample_rate = DEFAULT_SAMPLE_RATE;
        resolution = DEFAULT_RESOLUTION;
        scaling_2_1 = false;
        stream_mode = true;
        reporting = false;
        knock_stage = 0;
    }

    // --- host-side input, from SDL or the --mouse-in script ---
    void move(int dx, int dy, int dz = 0)
    {
        accum_dx += dx;
        accum_dy += dy;
        accum_dz += dz;
        state_changed = true;
    }

    void set_buttons(uint8_t mask)
    {
        buttons = mask & (BUTTON_LEFT | BUTTON_RIGHT | BUTTON_MIDDLE);
        state_changed = true;
    }

    static int clamp_move(int v)
    {
        return v < MOVE_MIN ? MOVE_MIN : (v > MOVE_MAX ? MOVE_MAX : v);
    }

    void send_packet(uint64_t clock_now, PS2State &channel)
    {
        int dx = clamp_move(accum_dx);
        int dy = clamp_move(accum_dy);
        uint8_t byte0 = 0x08 | (buttons & 0x07)
                      | ((dx < 0) ? 0x10 : 0)
                      | ((dy < 0) ? 0x20 : 0)
                      | ((accum_dx != dx) ? 0x40 : 0)   // X overflow
                      | ((accum_dy != dy) ? 0x80 : 0);  // Y overflow
        accum_dx -= dx;
        accum_dy -= dy;
        channel.enqueue_byte(clock_now, byte0);
        channel.enqueue_byte(clock_now, static_cast<uint8_t>(dx & 0xFF));
        channel.enqueue_byte(clock_now, static_cast<uint8_t>(dy & 0xFF));
        if (device_id == ID_INTELLIMOUSE)
        {
            int dz = accum_dz < -8 ? -8 : (accum_dz > 7 ? 7 : accum_dz);
            accum_dz -= dz;
            channel.enqueue_byte(clock_now, static_cast<uint8_t>(dz & 0x0F));
        }
        else
        {
            accum_dz = 0;   // no wheel in the packet: discard it
        }
        state_changed = (accum_dx != 0) || (accum_dy != 0) || (accum_dz != 0);
    }

    void service(uint64_t clock_now, PS2State &channel) override
    {
        if (bat_due_clock != 0 && clock_now >= bat_due_clock)
        {
            bat_due_clock = 0;
            channel.enqueue_byte(clock_now, 0xAA);          // BAT passed
            channel.enqueue_byte(clock_now, device_id);     // then the ID
        }
        if (!reporting || !stream_mode)
        {
            return;
        }
        if (clock_now < next_report_clock)
        {
            return;
        }
        next_report_clock = clock_now + report_period_sysclk();
        if (!state_changed || channel.backlog() >= MAX_BACKLOG)
        {
            return;
        }
        send_packet(clock_now, channel);
    }

    void command(uint64_t clock_now, uint8_t byte, PS2State &channel) override
    {
        if (pending_cmd == 0xF3)         // set sample rate: data byte
        {
            sample_rate = byte;
            pending_cmd = 0;
            // IntelliMouse knock: 200, 100, 80 in that order.
            if (byte == 200)      { knock_stage = 1; }
            else if (byte == 100) { knock_stage = (knock_stage == 1) ? 2 : 0; }
            else if (byte == 80)
            {
                if (knock_stage == 2) { device_id = ID_INTELLIMOUSE; }
                knock_stage = 0;
            }
            else                  { knock_stage = 0; }
            channel.enqueue_byte(clock_now, 0xFA);
            return;
        }
        if (pending_cmd == 0xE8)         // set resolution: data byte
        {
            resolution = byte & 0x03;
            pending_cmd = 0;
            channel.enqueue_byte(clock_now, 0xFA);
            return;
        }
        switch (byte)
        {
            case 0xFF:                   // reset
                channel.rx_bytes.clear();
                pending_cmd = 0;
                set_defaults();
                device_id = ID_STANDARD;
                accum_dx = accum_dy = accum_dz = 0;
                buttons = 0;
                state_changed = false;
                channel.enqueue_byte(clock_now, 0xFA);
                bat_due_clock = clock_now + bat_delay_sysclk;
                break;
            case 0xF6:                   // set defaults
                set_defaults();
                channel.enqueue_byte(clock_now, 0xFA);
                break;
            case 0xF5:                   // disable data reporting
                reporting = false;
                channel.enqueue_byte(clock_now, 0xFA);
                break;
            case 0xF4:                   // enable data reporting
                reporting = true;
                next_report_clock = clock_now + report_period_sysclk();
                channel.enqueue_byte(clock_now, 0xFA);
                break;
            case 0xF3:                   // set sample rate (data byte follows)
            case 0xE8:                   // set resolution (data byte follows)
                pending_cmd = byte;
                channel.enqueue_byte(clock_now, 0xFA);
                break;
            case 0xF2:                   // get device ID
                channel.enqueue_byte(clock_now, 0xFA);
                channel.enqueue_byte(clock_now, device_id);
                break;
            case 0xF0:                   // set remote (polled) mode
                stream_mode = false;
                channel.enqueue_byte(clock_now, 0xFA);
                break;
            case 0xEA:                   // set stream mode
                stream_mode = true;
                next_report_clock = clock_now + report_period_sysclk();
                channel.enqueue_byte(clock_now, 0xFA);
                break;
            case 0xEB:                   // read data (one packet on demand)
                channel.enqueue_byte(clock_now, 0xFA);
                send_packet(clock_now, channel);
                break;
            case 0xE9:                   // status request
                channel.enqueue_byte(clock_now, 0xFA);
                channel.enqueue_byte(clock_now,
                    static_cast<uint8_t>((reporting ? 0x20 : 0)
                                         | (stream_mode ? 0 : 0x40)
                                         | (scaling_2_1 ? 0x10 : 0)
                                         | (buttons & 0x07)));
                channel.enqueue_byte(clock_now, resolution);
                channel.enqueue_byte(clock_now, sample_rate);
                break;
            case 0xE7:                   // set scaling 2:1
                scaling_2_1 = true;
                channel.enqueue_byte(clock_now, 0xFA);
                break;
            case 0xE6:                   // set scaling 1:1
                scaling_2_1 = false;
                channel.enqueue_byte(clock_now, 0xFA);
                break;
            default:                     // unrecognized: resend
                channel.enqueue_byte(clock_now, 0xFE);
                break;
        }
    }
};

// ---------------------------------------------------------------------------
// Audio sink — host capture (--wav-out) and host playback.
//
// The AUDIO chip model hands over one stereo frame every second scanline
// (AUDIO_SAMPLES_PER_SECOND): its analog output, the two summers through the
// output stage's pole, whether or not any channel is playing.  That makes the
// sample rate a property of the raster alone, so a capture is exactly as
// deterministic as the run.
//
// This is a sink only: nothing here is ever read back into the emulation, so
// neither the capture nor the playback can perturb guest timing.  Playback
// therefore never blocks — if the host device queue backs up (it always will
// under --no-throttle, where the guest outruns real time) the samples are
// dropped, not waited on.
// ---------------------------------------------------------------------------

class AudioOutput
{
public:
    ~AudioOutput() { close(); }

    // Canonical 44-byte PCM WAV, 8-bit unsigned, stereo.  The header is rewritten at close
    // with the final frame count.
    bool open_wav(const char *path)
    {
        wav = fopen(path, "wb");
        if (!wav)
        {
            fprintf(stderr, "--wav-out: cannot open %s for writing\n", path);
            return false;
        }
        wav_path = path;
        wav_frames = 0;
        write_wav_header();
        return true;
    }

    // Best-effort host playback: any failure is a single warning, never fatal.
    // SDL is asked for the DAC's own format and rate and converts as needed.
    void open_playback()
    {
        if (!SDL_InitSubSystem(SDL_INIT_AUDIO))
        {
            fprintf(stderr, "Warning: SDL audio init failed (%s); no sound\n",
                    SDL_GetError());
            return;
        }
        SDL_AudioSpec spec = {};
        spec.format = SDL_AUDIO_U8;
        spec.channels = CHANNELS;
        spec.freq = SAMPLE_RATE_HZ;
        stream = SDL_OpenAudioDeviceStream(SDL_AUDIO_DEVICE_DEFAULT_PLAYBACK,
                                           &spec, nullptr, nullptr);
        if (!stream)
        {
            fprintf(stderr, "Warning: SDL_OpenAudioDeviceStream failed (%s); "
                    "no sound\n", SDL_GetError());
            SDL_QuitSubSystem(SDL_INIT_AUDIO);
            return;
        }
        SDL_ResumeAudioStreamDevice(stream);
    }

    bool active() const { return wav != nullptr || stream != nullptr; }

    // One stereo frame, called every second scanline by the AUDIO chip model.
    void sample(uint8_t left, uint8_t right)
    {
        if (!active())
        {
            return;
        }
        pending[pending_bytes++] = left;
        pending[pending_bytes++] = right;
        if (wav)
        {
            wav_frames++;
        }
        if (pending_bytes >= pending.size())
        {
            flush();
        }
    }

    void close()
    {
        flush();
        if (stream)
        {
            SDL_DestroyAudioStream(stream);   // also closes the bound device
            stream = nullptr;
            SDL_QuitSubSystem(SDL_INIT_AUDIO);
        }
        if (wav)
        {
            fseek(wav, 0, SEEK_SET);
            write_wav_header();
            fclose(wav);
            wav = nullptr;
            fprintf(stderr, "Wrote %" PRIu32 " audio frames: %s\n",
                    wav_frames, wav_path);
        }
    }

private:
    static constexpr int SAMPLE_RATE_HZ = static_cast<int>(AUDIO_SAMPLES_PER_SECOND);
    static constexpr int CHANNELS = 2;
    static constexpr uint32_t BYTES_PER_FRAME = CHANNELS;    // u8 per channel

    // Roughly a quarter second of host queue.  Past that the device is behind
    // the guest and catching up would only add latency, so drop instead.
    static constexpr int QUEUE_LIMIT_BYTES = SAMPLE_RATE_HZ * BYTES_PER_FRAME / 4;

    FILE *wav = nullptr;
    const char *wav_path = nullptr;
    uint32_t wav_frames = 0;
    SDL_AudioStream *stream = nullptr;
    bool drop_reported = false;
    std::array<uint8_t, 2048> pending{};
    size_t pending_bytes = 0;

    void flush()
    {
        if (pending_bytes == 0)
        {
            return;
        }
        if (wav)
        {
            fwrite(pending.data(), 1, pending_bytes, wav);
        }
        if (stream)
        {
            if (SDL_GetAudioStreamQueued(stream) > QUEUE_LIMIT_BYTES)
            {
                if (!drop_reported)
                {
                    drop_reported = true;
                    fprintf(stderr, "Audio: host queue behind the guest, "
                            "dropping samples\n");
                }
            }
            else
            {
                SDL_PutAudioStreamData(stream, pending.data(),
                                       static_cast<int>(pending_bytes));
            }
        }
        pending_bytes = 0;
    }

    void put_u32(uint32_t v)
    {
        uint8_t b[4] = {static_cast<uint8_t>(v), static_cast<uint8_t>(v >> 8),
                        static_cast<uint8_t>(v >> 16), static_cast<uint8_t>(v >> 24)};
        fwrite(b, 1, sizeof(b), wav);
    }

    void put_u16(uint16_t v)
    {
        uint8_t b[2] = {static_cast<uint8_t>(v), static_cast<uint8_t>(v >> 8)};
        fwrite(b, 1, sizeof(b), wav);
    }

    void write_wav_header()
    {
        uint32_t data_bytes = wav_frames * BYTES_PER_FRAME;
        fwrite("RIFF", 1, 4, wav);
        put_u32(36 + data_bytes);
        fwrite("WAVEfmt ", 1, 8, wav);
        put_u32(16);                                    // PCM fmt chunk size
        put_u16(1);                                     // PCM
        put_u16(CHANNELS);
        put_u32(SAMPLE_RATE_HZ);
        put_u32(SAMPLE_RATE_HZ * BYTES_PER_FRAME);      // byte rate
        put_u16(BYTES_PER_FRAME);                       // block align
        put_u16(8);                                     // bits per sample
        fwrite("data", 1, 4, wav);
        put_u32(data_bytes);
    }
};

// ---------------------------------------------------------------------------
// PORTS — the fourth ATF1508AS CPLD (cpld/ports/ports.v), at PORTS_BASE.
//
// Byte-wide registers, zero wait states (GLUE decodes the region and answers
// DTACK for it, as it does for CF), and a single wire-ORed level-2 IRQ.  It
// holds a PS/2 mouse frame engine, two joystick ports, two paddle counters
// with a shared dump control.  (Rev 1 also popped the audio FIFO pair here;
// rev 2's AUDIO chip pops its own FIFOs, see AudioChipState.)
//
// PORTS has NO timebase of its own: everything periodic runs off the square
// wave TIMING emits for it, PADDLE_TICK, which toggles once per scanline;
// PORTS counts only its FALLING edges (a both-edges detector does not fit in
// the CPLD), so paddles step at 15.734 kHz -- deliberately, because full
// scale 255 counts is then 16.2 ms, one frame, which is the Atari 2600's
// scanline-counted pot measurement window.  Here that means
// advance_scanlines() is driven from VideoState's scanline counter, never
// from a private timer -- a private timer would drift against the raster and
// destroy the design property.  The mouse channel is the exception: it is in
// the SYSCLK domain and rides the existing per-instruction timer service.
// ---------------------------------------------------------------------------

// One paddle: an 8-bit upcounter advanced by each PADDLE_TICK falling edge
// (one per two scanlines) while the pot's comparator sense line is still low,
// saturating at 0xFF and held at zero while PADDLE_CONTROL.DUMP drives the
// discharge FET.  This models what the RTL does, not RC physics: the host
// supplies a knob position in the same units as the count, and the sense line
// goes high once the ramp reaches it, which freezes the counter there.
struct PaddleCounter
{
    uint8_t position = 0;      // host knob position, 0..255 tick times of ramp
    uint8_t count = 0;

    // The comparator output as PORTS sees it: low while the cap is still
    // charging (dump asserted, or the ramp has not reached the knob yet).
    bool sense_high(bool dump) const { return !dump && count >= position; }

    void tick(bool dump)
    {
        if (dump)
        {
            count = 0;
            return;
        }
        if (count == 0xFF || sense_high(dump))
        {
            return;             // saturated, or frozen at the crossing
        }
        count++;
    }
};

struct PortsState
{
    // --- PS/2 mouse channel (same engine as the GLUE keyboard) ---
    PS2State mouse;
    PS2Mouse mouse_device;

    // --- joystick ports: 1 bits = switch closed (registers read active low) ---
    static constexpr int JOYSTICK_PORTS = 2;
    uint8_t joystick_pressed[JOYSTICK_PORTS] = {0, 0};

    // --- paddles ---
    PaddleCounter paddle_a;
    PaddleCounter paddle_b;
    bool paddle_dump = false;

    bool tick_phase = false;            // level of PADDLE_TICK: it toggles once
                                        // per line and the falling edge
                                        // (phase 1 -> 0) is the event

    bool init()
    {
        return mouse.init(PORTS_BASE, mouse_device);
    }

    // --- PADDLE_TICK -----------------------------------------------------

    // Advance by `lines` VGA scanlines and deliver the tick events they carry.
    // TIMING toggles the tick at the start of every line, PORTS counts the
    // falling edges, so an event lands at the start of every even-numbered
    // line counted from reset: `tick_phase` carries the tick's current level
    // between calls and the count of falling edges crossed is just the number
    // of times that level returns to 0.
    void advance_scanlines(uint32_t lines)
    {
        if (lines == 0)
        {
            return;
        }
        uint32_t phased = lines + (tick_phase ? 1u : 0u);
        uint32_t events = phased / 2;
        tick_phase = (phased & 1u) != 0;
        if (events == 0)
        {
            return;
        }

        // Paddle counters saturate, so more than a full-scale ramp of events
        // can never change them further.
        uint32_t paddle_steps = std::min<uint32_t>(events, 256);
        for (uint32_t i = 0; i < paddle_steps; i++)
        {
            paddle_a.tick(paddle_dump);
            paddle_b.tick(paddle_dump);
        }
    }

    // --- SYSCLK-domain service (mouse only) ------------------------------

    void check_timer(uint64_t clock_now) { mouse.check_timer(clock_now); }

    // --- registers -------------------------------------------------------

    uint8_t joystick_byte(int port) const
    {
        // Bit 7 reads 1; switch bits are active low straight from the DE-9.
        uint8_t v = static_cast<uint8_t>(0xFF & ~joystick_pressed[port]);
        if (port == 0)
        {
            // Port 1 pins 9 and 5 double as the paddle pot comparator levels:
            // the paddle pulls the line low while its cap charges, and so does
            // a button on the same pin, so the bit is the AND of both.
            if (!paddle_a.sense_high(paddle_dump))
            {
                v &= ~PORTS_JOYSTICK_PORT_1_PIN9_MASK;
            }
            if (!paddle_b.sense_high(paddle_dump))
            {
                v &= ~PORTS_JOYSTICK_PORT_1_PIN5_MASK;
            }
        }
        return v;
    }

    uint8_t read_reg(uint32_t abs_addr) const
    {
        switch (abs_addr)
        {
            case PORTS_JOYSTICK_PORT_1: return joystick_byte(0);
            case PORTS_JOYSTICK_PORT_2: return joystick_byte(1);
            case PORTS_PADDLE_A_COUNT:  return paddle_a.count;
            case PORTS_PADDLE_B_COUNT:  return paddle_b.count;
            default:
                break;
        }
        if (mouse.is_addr(abs_addr))
        {
            return mouse.read_reg(abs_addr);
        }
        return 0;
    }

    void write_reg(uint32_t abs_addr, uint8_t val, uint64_t clock_now)
    {
        if (abs_addr == PORTS_PADDLE_CONTROL)
        {
            paddle_dump = (val & PORTS_PADDLE_CONTROL_DUMP_MASK) != 0;
            if (paddle_dump)
            {
                paddle_a.count = 0;
                paddle_b.count = 0;
            }
            return;
        }
        if (mouse.is_addr(abs_addr))
        {
            mouse.write_reg(abs_addr, val, clock_now);
        }
    }

    // The mouse is the only PORTS interrupt source.
    bool irq_pending() const { return mouse.irq_pending(); }
};

// ---------------------------------------------------------------------------
// Scripted PS/2 keystroke injection (--ps2-in): drives the PS2State model
// from a file so keyboard-input paths can be tested unattended (headless
// runs get no SDL key events).  Directives, one per line:
//   # comment
//   delay MS         wait MS emulated milliseconds before the next directive
//   text STRING      type STRING as set-2 make/break sequences (\r, \\ escapes)
//   raw HH HH ...    inject raw set-2 bytes (e.g. "raw AA" = a stray BAT)
// Bytes go through PS2State::enqueue_byte, so the normal 1 ms/byte RX
// pacing and IRQ flow apply.  Scripts should delay past boot stages they
// don't target: whatever guest is live consumes the scancodes.
// ---------------------------------------------------------------------------

struct PS2Script
{
    struct Event
    {
        uint64_t delay_sysclk = 0;          // nonzero: pause
        std::deque<uint8_t> bytes;          // else: inject these
    };

    std::deque<Event> events;
    uint64_t resume_clock = 0;

    // ASCII -> set-2 make code (+ shift requirement).  Codes match
    // sdl_to_ps2_set2 above.
    static bool ascii_to_set2(char c, uint8_t &code, bool &shift)
    {
        static const uint8_t letters[26] = {
            0x1C,0x32,0x21,0x23,0x24,0x2B,0x34,0x33,0x43,0x3B,0x42,0x4B,0x3A,
            0x31,0x44,0x4D,0x15,0x2D,0x1B,0x2C,0x3C,0x2A,0x1D,0x22,0x35,0x1A,
        };
        static const uint8_t digits[10] = {
            0x45,0x16,0x1E,0x26,0x25,0x2E,0x36,0x3D,0x3E,0x46,
        };
        // Plain and shifted punctuation, same make code.
        struct Punct { char plain, shifted; uint8_t code; };
        static const Punct puncts[] = {
            { '-','_',0x4E }, { '=','+',0x55 }, { '[','{',0x54 },
            { ']','}',0x5B }, { '\\','|',0x5D }, { ';',':',0x4C },
            { '\'','"',0x52 }, { '`','~',0x0E }, { ',','<',0x41 },
            { '.','>',0x49 }, { '/','?',0x4A },
        };
        // Shifted digits: )!@#$%^&*(
        static const char shifted_digits[11] = ")!@#$%^&*(";

        shift = false;
        if (c >= 'a' && c <= 'z') { code = letters[c - 'a']; return true; }
        if (c >= 'A' && c <= 'Z') { code = letters[c - 'A']; shift = true; return true; }
        if (c >= '0' && c <= '9') { code = digits[c - '0']; return true; }
        switch (c)
        {
            case ' ':  code = 0x29; return true;
            case '\r': case '\n': code = 0x5A; return true;
            case '\t': code = 0x0D; return true;
            case '\b': code = 0x66; return true;
            case 0x1B: code = 0x76; return true;    // ESC
        }
        for (const Punct &p : puncts)
        {
            if (c == p.plain)   { code = p.code; return true; }
            if (c == p.shifted) { code = p.code; shift = true; return true; }
        }
        for (int i = 0; i < 10; i++)
        {
            if (c == shifted_digits[i]) { code = digits[i]; shift = true; return true; }
        }
        return false;
    }

    static void emit_char(std::deque<uint8_t> &out, char c)
    {
        uint8_t code;
        bool shift;
        if (!ascii_to_set2(c, code, shift))
        {
            fprintf(stderr, "ps2 script: no set-2 mapping for 0x%02X; skipped\n",
                    (unsigned char)c);
            return;
        }
        if (shift) { out.push_back(0x12); }             // LShift make
        out.push_back(code);                            // make
        out.push_back(0xF0); out.push_back(code);       // break
        if (shift) { out.push_back(0xF0); out.push_back(0x12); }
    }

    bool load(const char *path)
    {
        FILE *fp = fopen(path, "r");
        if (!fp)
        {
            fprintf(stderr, "ps2 script: cannot open %s\n", path);
            return false;
        }
        char line[1024];
        int lineno = 0;
        bool ok = true;
        while (fgets(line, sizeof line, fp))
        {
            lineno++;
            char *p = line;
            while (*p == ' ' || *p == '\t') { p++; }
            size_t len = strlen(p);
            while (len > 0 && (p[len-1] == '\n' || p[len-1] == '\r')) { p[--len] = '\0'; }
            if (*p == '\0' || *p == '#') { continue; }

            if (strncmp(p, "delay ", 6) == 0)
            {
                Event ev;
                ev.delay_sysclk = strtoull(p + 6, nullptr, 0) * (SYSCLK_HZ / 1000);
                events.push_back(ev);
            }
            else if (strncmp(p, "text ", 5) == 0)
            {
                Event ev;
                for (const char *s = p + 5; *s; s++)
                {
                    char c = *s;
                    if (c == '\\' && s[1] != '\0')
                    {
                        s++;
                        switch (*s)
                        {
                            case 'r': c = '\r'; break;
                            case 'n': c = '\n'; break;
                            case 't': c = '\t'; break;
                            case 'e': c = 0x1B; break;
                            case '\\': c = '\\'; break;
                            default:
                                fprintf(stderr, "ps2 script:%d: unknown escape \\%c\n",
                                        lineno, *s);
                                ok = false;
                                continue;
                        }
                    }
                    emit_char(ev.bytes, c);
                }
                events.push_back(ev);
            }
            else if (strncmp(p, "raw ", 4) == 0)
            {
                Event ev;
                const char *s = p + 4;
                char *end;
                while (*s)
                {
                    unsigned long v = strtoul(s, &end, 16);
                    if (end == s) { break; }
                    ev.bytes.push_back(static_cast<uint8_t>(v));
                    s = end;
                }
                events.push_back(ev);
            }
            else
            {
                fprintf(stderr, "ps2 script:%d: unknown directive: %s\n", lineno, p);
                ok = false;
            }
        }
        fclose(fp);
        return ok;
    }

    void service(uint64_t clock_now, PS2State &ps2)
    {
        while (!events.empty() && clock_now >= resume_clock)
        {
            Event &ev = events.front();
            if (ev.delay_sysclk != 0)
            {
                resume_clock = clock_now + ev.delay_sysclk;
            }
            else
            {
                for (uint8_t b : ev.bytes)
                {
                    ps2.enqueue_byte(clock_now, b);
                }
            }
            events.pop_front();
        }
    }
};

// ---------------------------------------------------------------------------
// Scripted PS/2 mouse input (--mouse-in): the mouse counterpart of PS2Script,
// driving the PS2Mouse device model so mouse paths can be tested unattended
// (headless runs get no SDL events).  Directives, one per line:
//   # comment
//   delay MS          wait MS emulated milliseconds before the next directive
//   move DX DY        accumulate movement (PS/2 sign: +Y is up)
//   button LMR        hold exactly these buttons ("none" releases all)
//   click L           press, hold CLICK_HOLD_MS, release
//   raw HH HH ...     inject raw device->host bytes into the mouse channel
// Movement and button changes only become packets when the guest has enabled
// data reporting, exactly as on hardware.
// ---------------------------------------------------------------------------

struct MouseScript
{
    static constexpr uint64_t CLICK_HOLD_MS = 50;

    struct Event
    {
        uint64_t delay_sysclk = 0;          // nonzero: pause
        bool     have_move = false;
        int      dx = 0;
        int      dy = 0;
        bool     have_buttons = false;
        uint8_t  buttons = 0;
        std::deque<uint8_t> raw;
    };

    std::deque<Event> events;
    uint64_t resume_clock = 0;

    // "LMR", "lr", "none" -> a PS/2 button mask.
    static bool parse_buttons(const char *s, uint8_t &mask)
    {
        mask = 0;
        if (strncmp(s, "none", 4) == 0)
        {
            return true;
        }
        for (; *s; s++)
        {
            switch (*s)
            {
                case 'L': case 'l': mask |= PS2Mouse::BUTTON_LEFT; break;
                case 'M': case 'm': mask |= PS2Mouse::BUTTON_MIDDLE; break;
                case 'R': case 'r': mask |= PS2Mouse::BUTTON_RIGHT; break;
                case ' ': case '\t': break;
                default: return false;
            }
        }
        return true;
    }

    bool load(const char *path)
    {
        FILE *fp = fopen(path, "r");
        if (!fp)
        {
            fprintf(stderr, "mouse script: cannot open %s\n", path);
            return false;
        }
        char line[1024];
        int lineno = 0;
        bool ok = true;
        while (fgets(line, sizeof line, fp))
        {
            lineno++;
            char *p = line;
            while (*p == ' ' || *p == '\t') { p++; }
            size_t len = strlen(p);
            while (len > 0 && (p[len-1] == '\n' || p[len-1] == '\r')) { p[--len] = '\0'; }
            if (*p == '\0' || *p == '#') { continue; }

            if (strncmp(p, "delay ", 6) == 0)
            {
                Event ev;
                ev.delay_sysclk = strtoull(p + 6, nullptr, 0) * (SYSCLK_HZ / 1000);
                events.push_back(ev);
            }
            else if (strncmp(p, "move ", 5) == 0)
            {
                Event ev;
                if (sscanf(p + 5, "%d %d", &ev.dx, &ev.dy) != 2)
                {
                    fprintf(stderr, "mouse script:%d: move wants DX DY\n", lineno);
                    ok = false;
                    continue;
                }
                ev.have_move = true;
                events.push_back(ev);
            }
            else if (strncmp(p, "button ", 7) == 0)
            {
                Event ev;
                if (!parse_buttons(p + 7, ev.buttons))
                {
                    fprintf(stderr, "mouse script:%d: button wants L/M/R or none\n", lineno);
                    ok = false;
                    continue;
                }
                ev.have_buttons = true;
                events.push_back(ev);
            }
            else if (strncmp(p, "click ", 6) == 0)
            {
                uint8_t mask;
                if (!parse_buttons(p + 6, mask) || mask == 0)
                {
                    fprintf(stderr, "mouse script:%d: click wants L/M/R\n", lineno);
                    ok = false;
                    continue;
                }
                Event press;
                press.have_buttons = true;
                press.buttons = mask;
                events.push_back(press);
                Event hold;
                hold.delay_sysclk = CLICK_HOLD_MS * (SYSCLK_HZ / 1000);
                events.push_back(hold);
                Event release;
                release.have_buttons = true;
                release.buttons = 0;
                events.push_back(release);
            }
            else if (strncmp(p, "raw ", 4) == 0)
            {
                Event ev;
                const char *s = p + 4;
                char *end;
                while (*s)
                {
                    unsigned long v = strtoul(s, &end, 16);
                    if (end == s) { break; }
                    ev.raw.push_back(static_cast<uint8_t>(v));
                    s = end;
                }
                events.push_back(ev);
            }
            else
            {
                fprintf(stderr, "mouse script:%d: unknown directive: %s\n", lineno, p);
                ok = false;
            }
        }
        fclose(fp);
        return ok;
    }

    void service(uint64_t clock_now, PortsState &ports)
    {
        while (!events.empty() && clock_now >= resume_clock)
        {
            Event &ev = events.front();
            if (ev.delay_sysclk != 0)
            {
                resume_clock = clock_now + ev.delay_sysclk;
            }
            else
            {
                if (ev.have_move)
                {
                    ports.mouse_device.move(ev.dx, ev.dy);
                }
                if (ev.have_buttons)
                {
                    ports.mouse_device.set_buttons(ev.buttons);
                }
                for (uint8_t b : ev.raw)
                {
                    ports.mouse.enqueue_byte(clock_now, b);
                }
            }
            events.pop_front();
        }
    }
};

// ---------------------------------------------------------------------------
// Scripted joystick / paddle input (--joystick-in).  Same shape as the PS/2
// scripts.  Directives, one per line:
//   # comment
//   delay MS            wait MS emulated milliseconds
//   stick1 NAME...      hold exactly these port-1 switches ("none" releases)
//   stick2 NAME...      same for port 2
//   paddle-a N          set paddle A knob position, 0..255
//   paddle-b N          set paddle B knob position
// Switch names: up down left right fire pin9 pin5 (and "none").
// ---------------------------------------------------------------------------

struct JoystickScript
{
    struct Event
    {
        uint64_t delay_sysclk = 0;      // nonzero: pause
        int      stick = -1;            // 0/1: set that port's pressed mask
        uint8_t  pressed = 0;
        int      paddle = -1;           // 0 = A, 1 = B
        uint8_t  position = 0;
    };

    std::deque<Event> events;
    uint64_t resume_clock = 0;

    static bool parse_switches(const char *s, uint8_t &mask)
    {
        struct Name { const char *name; uint32_t bit; };
        static const Name names[] = {
            { "up",    PORTS_JOYSTICK_PORT_1_UP_MASK },
            { "down",  PORTS_JOYSTICK_PORT_1_DOWN_MASK },
            { "left",  PORTS_JOYSTICK_PORT_1_LEFT_MASK },
            { "right", PORTS_JOYSTICK_PORT_1_RIGHT_MASK },
            { "fire",  PORTS_JOYSTICK_PORT_1_FIRE_MASK },
            { "pin9",  PORTS_JOYSTICK_PORT_1_PIN9_MASK },
            { "pin5",  PORTS_JOYSTICK_PORT_1_PIN5_MASK },
        };
        // Port 2 uses the same bit order, so one table serves both.
        static_assert(PORTS_JOYSTICK_PORT_1_FIRE_MASK == PORTS_JOYSTICK_PORT_2_FIRE_MASK);

        mask = 0;
        while (*s)
        {
            while (*s == ' ' || *s == '\t') { s++; }
            if (*s == '\0') { break; }
            size_t len = 0;
            while (s[len] && s[len] != ' ' && s[len] != '\t') { len++; }
            bool found = false;
            if (len == 4 && strncmp(s, "none", 4) == 0)
            {
                found = true;
            }
            for (const Name &n : names)
            {
                if (strlen(n.name) == len && strncmp(s, n.name, len) == 0)
                {
                    mask |= static_cast<uint8_t>(n.bit);
                    found = true;
                    break;
                }
            }
            if (!found)
            {
                return false;
            }
            s += len;
        }
        return true;
    }

    bool load(const char *path)
    {
        FILE *fp = fopen(path, "r");
        if (!fp)
        {
            fprintf(stderr, "joystick script: cannot open %s\n", path);
            return false;
        }
        char line[1024];
        int lineno = 0;
        bool ok = true;
        while (fgets(line, sizeof line, fp))
        {
            lineno++;
            char *p = line;
            while (*p == ' ' || *p == '\t') { p++; }
            size_t len = strlen(p);
            while (len > 0 && (p[len-1] == '\n' || p[len-1] == '\r')) { p[--len] = '\0'; }
            if (*p == '\0' || *p == '#') { continue; }

            if (strncmp(p, "delay ", 6) == 0)
            {
                Event ev;
                ev.delay_sysclk = strtoull(p + 6, nullptr, 0) * (SYSCLK_HZ / 1000);
                events.push_back(ev);
            }
            else if (strncmp(p, "stick1 ", 7) == 0 || strncmp(p, "stick2 ", 7) == 0)
            {
                Event ev;
                ev.stick = (p[5] == '1') ? 0 : 1;
                if (!parse_switches(p + 7, ev.pressed))
                {
                    fprintf(stderr, "joystick script:%d: unknown switch name in: %s\n",
                            lineno, p);
                    ok = false;
                    continue;
                }
                events.push_back(ev);
            }
            else if (strncmp(p, "paddle-a ", 9) == 0 || strncmp(p, "paddle-b ", 9) == 0)
            {
                Event ev;
                ev.paddle = (p[7] == 'a') ? 0 : 1;
                unsigned long v = strtoul(p + 9, nullptr, 0);
                if (v > 255)
                {
                    fprintf(stderr, "joystick script:%d: paddle position %lu > 255\n",
                            lineno, v);
                    ok = false;
                    continue;
                }
                ev.position = static_cast<uint8_t>(v);
                events.push_back(ev);
            }
            else
            {
                fprintf(stderr, "joystick script:%d: unknown directive: %s\n", lineno, p);
                ok = false;
            }
        }
        fclose(fp);
        return ok;
    }

    void service(uint64_t clock_now, PortsState &ports)
    {
        while (!events.empty() && clock_now >= resume_clock)
        {
            Event &ev = events.front();
            if (ev.delay_sysclk != 0)
            {
                resume_clock = clock_now + ev.delay_sysclk;
            }
            else if (ev.stick >= 0)
            {
                ports.joystick_pressed[ev.stick] = ev.pressed;
            }
            else if (ev.paddle >= 0)
            {
                PaddleCounter &paddle = (ev.paddle == 0) ? ports.paddle_a : ports.paddle_b;
                paddle.position = ev.position;
            }
            events.pop_front();
        }
    }
};

// ---------------------------------------------------------------------------
// Real-time clock governor
//
// Paces emulation to wall-clock speed.  Called every THROTTLE_INTERVAL
// instructions; sleeps if the emulator is running ahead of real time.
// ---------------------------------------------------------------------------

static constexpr int THROTTLE_INTERVAL = 1000;

struct ClockGovernor
{
    uint64_t base_clock = 0;
    double clock_hz = SYSCLK_HZ;
    std::chrono::steady_clock::time_point base_time;

    void reset(uint64_t emu_clock, uint32_t hz)
    {
        base_clock = emu_clock;
        clock_hz = hz;
        base_time = std::chrono::steady_clock::now();
    }

    void throttle(uint64_t emu_clock)
    {
        using namespace std::chrono;
        double emu_seconds = static_cast<double>(emu_clock - base_clock) / clock_hz;
        duration<double> wall_elapsed = steady_clock::now() - base_time;
        double ahead = emu_seconds - wall_elapsed.count();
        if (ahead > 0.001)
        {
            std::this_thread::sleep_for(duration<double>(ahead));
        }
    }
};

// ---------------------------------------------------------------------------
// AUDIO — the four-channel chip (cpld/audio/audio.v).
//
// The model is audio/audio_chip.{h,cpp}, the chip's executable spec, compiled
// in unchanged the way the super-engine models are, so the emulator cannot
// drift from the RTL's bench.  ENGINE deposits reach it by destination code:
// AUDCTL (3) is the control FIFO, SAMPLES0..3 (4..7) the channels, one byte
// per word in the lane the FIFO's data pins sit on (channels 0,1 D[15:8];
// 2,3 and control D[7:0]).  It is clocked from the raster alone: 50 steps per
// scanline (the chip's divider is HBLANK-locked), handed over by the same
// scanline counter that drives PORTS.
//
// The host hears the analog model (the two summers through their 9.7 kHz
// pole) sampled every second line, 15,734 Hz, the rate the WAV and SDL sinks
// already use.  The guest reads nothing back; the developer's only view of
// the FIFOs is here: a dropped deposit (a full FIFO) is reported on stderr
// the first time per FIFO, and every run ends with a per-channel summary of
// drops and of the times each channel ran dry after holding samples.
// ---------------------------------------------------------------------------

struct AudioChipState
{
    griffin::audio::AudioChip chip;
    griffin::audio::AnalogRender analog;
    AudioOutput *audio_out = nullptr;

    uint64_t lines = 0;
    bool     had_samples[griffin::audio::CHANNELS] = {};
    uint64_t dry_events[griffin::audio::CHANNELS] = {};
    bool     drop_reported[griffin::audio::CHANNELS + 1] = {};

    AudioChipState()
    {
        analog.configure(9700.0);       // griffin.yml Audio output stage: 2k || 8.2 nF
    }

    void deposit(uint8_t destination, uint16_t word)
    {
        if (destination == SuperEngine::DEST_AUDCTL_FIFO_W)
        {
            if (!chip.deposit_control(static_cast<uint8_t>(word & 0xFF)))
            {
                report_drop(griffin::audio::CHANNELS, "AUDCTL");
            }
            return;
        }
        const int channel = destination - SuperEngine::DEST_SAMPLES0_FIFO_W;
        if (channel >= 0 && channel < griffin::audio::CHANNELS)
        {
            if (!chip.deposit_sample(channel, SuperEngine::audio_channel_byte(channel, word)))
            {
                static const char *const NAMES[griffin::audio::CHANNELS] =
                    { "SAMPLES0", "SAMPLES1", "SAMPLES2", "SAMPLES3" };
                report_drop(channel, NAMES[channel]);
            }
        }
    }

    void advance_scanlines(uint32_t count)
    {
        for (uint32_t l = 0; l < count; l++)
        {
            for (int s = 0; s < griffin::audio::STEPS_PER_LINE; s++)
            {
                chip.step();
                analog.step(chip);
            }
            for (int c = 0; c < griffin::audio::CHANNELS; c++)
            {
                const bool has = !chip.fifo_empty(c);
                if (had_samples[c] && !has)
                {
                    dry_events[c]++;
                }
                had_samples[c] = has;
            }
            lines++;
            if ((lines & 1) == 0 && audio_out)
            {
                audio_out->sample(to_u8(analog.left), to_u8(analog.right));
            }
        }
    }

    void print_summary() const
    {
        fprintf(stderr, "AUDIO chip: %" PRIu64 " lines, %" PRIu64 " control records\n",
                lines, chip.stats.control_records);
        for (int c = 0; c < griffin::audio::CHANNELS; c++)
        {
            fprintf(stderr, "  channel %d: pops %" PRIu64 ", deposits dropped %" PRIu64
                    ", ran dry %" PRIu64 " times, max fill %u\n",
                    c, chip.stats.pops[c], chip.stats.deposits_dropped[c], dry_events[c],
                    static_cast<unsigned>(chip.stats.max_fill[c]));
        }
        fprintf(stderr, "  control: bytes dropped %" PRIu64 ", max fill %u\n",
                chip.stats.control_dropped, static_cast<unsigned>(chip.stats.max_control_fill));
    }

private:
    // Two channels at full scale and full volume sum to about +/-250 in the
    // model's units (one 8-bit LSB of one channel); halve it into the host's
    // unsigned 8-bit format, midscale 0x80.
    static uint8_t to_u8(double v)
    {
        long code = std::lround(v / 2.0) + 128;
        return static_cast<uint8_t>(std::clamp(code, 0L, 255L));
    }

    void report_drop(int index, const char *name)
    {
        if (!drop_reported[index])
        {
            drop_reported[index] = true;
            fprintf(stderr, "AUDIO: %s FIFO full at scanline %" PRIu64
                    ", deposit dropped (first occurrence; summary at exit)\n", name, lines);
        }
    }
};
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
