bradgrantham/griffin/firmware/rom.cpp

#include <string>
#include <cstdio>
#include <cstdint>
#include <cstdarg>
#include <cstring>
#include <cstdlib>
#include <cerrno>

#include "../griffin.generated.h"
#include "../griffin.generated.refs.h"
#include "../griffin_abi.h"
// #include "splash.h"

#include "ps2.h"
#include "mouse.h"
#include "textport.h"
#include "vt102.h"
#include "early_log.h"
#include "rtc.h"
#include "splash.h"

using namespace Griffin::reg;

extern "C" {
#include "ff.h"
}


// ---------------------------------------------------------------------------
// Compact Flash (True IDE, 8-bit PIO)
// ---------------------------------------------------------------------------

enum cf_error : int { CF_OK = 0, CF_TIMEOUT, CF_ERR };

struct cf_info
{
    char     model[41];       // words 27-46, null-terminated
    char     serial[21];      // words 10-19, null-terminated
    char     firmware_rev[9]; // words 23-26, null-terminated
    uint32_t lba_sectors;     // words 60-61
};

static constexpr uint32_t CF_POLL_LIMIT = 500000;

// Power-on poll limit for cf_init.  CF spec allows up to 31 seconds
// for BSY to clear after power-on; ~2 seconds covers most cards.
// Each iteration is ~50 SYSCLK; scale the count from SYSCLK_HZ so the
// wall-clock duration stays constant if the system clock changes.
static constexpr uint32_t CF_INIT_POLL_LIMIT = (Griffin::SYSCLK_HZ / 50) * 2;

// Wait for BSY to clear.  Returns CF_TIMEOUT if limit exceeded.
static cf_error cf_wait_ready()
{
    for (uint32_t i = 0; i < CF_POLL_LIMIT; i++)
    {
        if (!(CF_STATUS & Griffin::CF_STATUS_BSY))
        {
            return CF_OK;
        }
    }
    return CF_TIMEOUT;
}

// Wait for BSY clear and DRQ set.  Returns CF_ERR if device signals error.
static cf_error cf_wait_drq()
{
    for (uint32_t i = 0; i < CF_POLL_LIMIT; i++)
    {
        uint8_t s = CF_STATUS;
        if (s & Griffin::CF_STATUS_ERR)
        {
            return CF_ERR;
        }
        if (!(s & Griffin::CF_STATUS_BSY) && (s & Griffin::CF_STATUS_DRQ))
        {
            return CF_OK;
        }
    }
    return CF_TIMEOUT;
}

// Set LBA address and sector count into CF registers.
static void cf_set_lba(uint32_t lba, uint8_t count)
{
    CF_SECTOR_COUNT  = count;
    CF_SECTOR_NUM    = lba & 0xFF;
    CF_CYL_LO     = (lba >> 8) & 0xFF;
    CF_CYL_HI     = (lba >> 16) & 0xFF;
    CF_DRIVE_HEAD = Griffin::CF_DH_LBA | ((lba >> 24) & 0x0F);
}

// Initialize CF card: wait for ready, set 8-bit PIO mode.
extern "C" cf_error cf_init()
{
    // Wait for BSY clear with extended power-on timeout.
    for (uint32_t i = 0; i < CF_INIT_POLL_LIMIT; i++)
    {
        if (!(CF_STATUS & Griffin::CF_STATUS_BSY))
        {
            goto bsy_clear;
        }
    }
    return CF_TIMEOUT;

bsy_clear:
    // Wait for DRDY
    for (uint32_t i = 0; i < CF_INIT_POLL_LIMIT; i++)
    {
        if (CF_STATUS & Griffin::CF_STATUS_DRDY)
        {
            goto drdy_ok;
        }
    }
    return CF_TIMEOUT;

drdy_ok:
    // 16-bit True IDE PIO is the power-on default; no SET FEATURES step.
    return CF_OK;
}

// Read the 512-byte IDENTIFY DEVICE block into caller-provided buffer.
extern "C" cf_error cf_identify(uint8_t buf[512])
{
    cf_error err = cf_wait_ready();
    if (err != CF_OK)
    {
        return err;
    }

    CF_DRIVE_HEAD = Griffin::CF_DH_LBA;
    CF_COMMAND    = Griffin::CF_CMD_IDENTIFY;

    err = cf_wait_drq();
    if (err != CF_OK)
    {
        return err;
    }

    for (int i = 0; i < 512; i += 2)
    {
        uint16_t w = CF_DATA;
        buf[i]     = static_cast<uint8_t>(w & 0xFF);
        buf[i + 1] = static_cast<uint8_t>(w >> 8);
    }
    return CF_OK;
}

// Extract an ATA string from the identify block.
// ATA strings store first char of each word-pair in the high byte, but the
// driver stores each 16-bit data word low byte first, so adjacent bytes are
// swapped.
static void cf_extract_string(const uint8_t *buf, int word_start, int word_count, char *out)
{
    int byte_off = word_start * 2;
    int len = word_count * 2;
    for (int i = 0; i < len; i += 2)
    {
        out[i]     = buf[byte_off + i + 1];
        out[i + 1] = buf[byte_off + i];
    }
    // Trim trailing spaces and null-terminate
    int end = len;
    while (end > 0 && out[end - 1] == ' ')
    {
        end--;
    }
    out[end] = '\0';
}

// Parse the raw 512-byte identify block into a cf_info struct.
void cf_parse_identify(const uint8_t buf[512], cf_info *info)
{
    cf_extract_string(buf, 27, 20, info->model);
    cf_extract_string(buf, 10, 10, info->serial);
    cf_extract_string(buf, 23, 4,  info->firmware_rev);

    // Words 60-61: total LBA sectors (little-endian words, stored low byte first)
    info->lba_sectors = static_cast<uint32_t>(buf[120])
                      | (static_cast<uint32_t>(buf[121]) << 8)
                      | (static_cast<uint32_t>(buf[122]) << 16)
                      | (static_cast<uint32_t>(buf[123]) << 24);
}

// Read count sectors starting at lba into buf.
// buf must be at least count * 512 bytes.
extern "C" cf_error cf_read_sectors(uint32_t lba, uint8_t count, uint8_t *buf)
{
    cf_error err = cf_wait_ready();
    if (err != CF_OK)
    {
        return err;
    }

    cf_set_lba(lba, count);
    CF_COMMAND = Griffin::CF_CMD_READ_SECTORS;

    for (int sec = 0; sec < count; sec++)
    {
        err = cf_wait_drq();
        if (err != CF_OK)
        {
            return err;
        }
        for (int i = 0; i < 256; i++)
        {
            uint16_t w = CF_DATA;
            *buf++ = static_cast<uint8_t>(w & 0xFF);
            *buf++ = static_cast<uint8_t>(w >> 8);
        }
    }
    return CF_OK;
}

// Write count sectors starting at lba from buf.
// buf must be at least count * 512 bytes.
extern "C" cf_error cf_write_sectors(uint32_t lba, uint8_t count, const uint8_t *buf)
{
    cf_error err = cf_wait_ready();
    if (err != CF_OK)
    {
        return err;
    }

    cf_set_lba(lba, count);
    CF_COMMAND = Griffin::CF_CMD_WRITE_SECTORS;

    for (int sec = 0; sec < count; sec++)
    {
        err = cf_wait_drq();
        if (err != CF_OK)
        {
            return err;
        }
        for (int i = 0; i < 256; i++)
        {
            uint16_t lo = *buf++;
            uint16_t hi = *buf++;
            CF_DATA = static_cast<uint16_t>(lo | (hi << 8));
        }
    }

    // Wait for the card to finish writing
    return cf_wait_ready();
}

// ---------------------------------------------------------------------------
// Debug serial output
// ---------------------------------------------------------------------------

// Console putchar.  Routes to the 68681 DUART Channel A, which crt0's
// early init brings up at 115200 8N1 before main() runs.  Replaces the
// former GLUE timer bit-bang serial.
extern "C" void duart_putchar(uint8_t ch);   // defined below

extern "C" void debug_serial_putchar(const char s)
{
    duart_putchar(static_cast<uint8_t>(s));
}

extern "C" void panic(const char *s);

asm(
    ".global panic\n"
    "panic:\n"
    "    move.l 4(%sp), %a1\n"
    "    jmp monitor_panic\n"
);

// GLUE CONFIG shadow access — defined in crt0.s
extern "C" void glue_config_set_bits(uint8_t mask);
extern "C" void glue_config_clear_bits(uint8_t mask);

extern "C" {

void debug_printf(const char *fmt, ...)
{
    va_list args;
    char dummy[512];

    va_start(args, fmt);
    vsprintf(dummy, fmt, args);
    va_end(args);

    for(const char* s = dummy; *s; s++)
    {
        // '\n' → '\r\n' so the VT102 replay and any serial-side terminal
        // both advance to column 0.
        if (*s == '\n')
        {
            early_log_push('\r');
            debug_serial_putchar('\r');
        }
        early_log_push(static_cast<uint8_t>(*s));
        debug_serial_putchar(*s);
    }
}

extern volatile uint32_t memory_size;
extern volatile uint8_t cpu_is_68010;   // crt0 boot probe: MOVEC executed
extern const char *build_date;
extern const char *build_provenance;

// event ring buffer (written by ISR in crt0.s, read by main)
constexpr size_t EVT_QUEUE_SIZE = 256;  // must match crt0.s
extern volatile uint8_t evt_queue[EVT_QUEUE_SIZE];
extern volatile uint32_t evt_head;
extern volatile uint32_t evt_tail;
extern volatile uint8_t evt_overflow;

// UART RX ring buffer (written by _duart_isr in crt0.s, read by duart_getchar)
constexpr size_t UART_RX_QUEUE_SIZE = 256;  // must match crt0.s
extern volatile uint8_t uart_rx_queue[UART_RX_QUEUE_SIZE];
extern volatile uint32_t uart_rx_head;
extern volatile uint32_t uart_rx_tail;
extern volatile uint8_t uart_rx_overflow;

// DUART CTR_READY ISR increments this at 100 Hz (emulator path).
extern volatile uint32_t tick_counter;

// VIDEO ISR increments this on every VBLANK (~60 Hz at VGA 640x480@60).
extern volatile uint32_t video_frame_counter;

// Seconds since the Unix epoch, UTC.  _duart_isr (crt0.s) increments it on
// every rising edge of the RTC's 1 Hz MFP square wave (DUART IP3
// change-of-state IRQ) when rtc_from_mfp is nonzero, else once per 100
// CTR_READY ticks (no RTC: the clock runs from the build time).
// rtc_load_clock sets it from the chip at boot and sys_settime on a set.
extern volatile uint32_t rtc_seconds;
extern volatile uint8_t rtc_from_mfp;
extern volatile uint8_t rtc_fallback_ticks;

}; // extern "C"

// Milliseconds since boot.
extern "C" uint32_t get_milliseconds()
{
//     return (video_frame_counter * 1000U) / 60U; // Possible alternate timebase
   return tick_counter * 10U;
}

// SR interrupt-mask critical section for the two-word updates the DUART ISR
// also touches.  Level 7 is masked too; nothing on the board uses it.
static inline uint16_t irq_save()
{
    uint16_t sr;
    asm volatile("move.w %%sr,%0\n\tori.w #0x0700,%%sr" : "=d"(sr) : : "memory");
    return sr;
}

static inline void irq_restore(uint16_t sr)
{
    asm volatile("move.w %0,%%sr" : : "d"(sr) : "memory");
}

// Seconds since the Unix epoch, UTC: the ISR-driven counter.
extern "C" uint32_t get_epoch_seconds()
{
    return rtc_seconds;
}

static void set_epoch_seconds(uint32_t epoch)
{
    uint16_t sr = irq_save();
    rtc_seconds = epoch;
    irq_restore(sr);
}

// Boot: take the wall clock from the RTC, aligned to its MFP edge so the
// ISR-driven counter starts in phase with the chip's own second.  Without a
// chip the clock starts at the firmware build time (BUILD_EPOCH, stamped by
// the Makefile) and runs from the MFP-less fallback of the 100 Hz tick.
static bool rtc_clock_from_chip = false;

static void rtc_load_clock()
{
    if (!rtc_present()) {
        debug_printf("RTC: not present, clock starts at the build time\n");
        return;
    }

    // Wait for a rising MFP edge, at most 1.2 s (the ISR counts the same
    // edge; the chip read below lands after it either way).
    uint32_t start = get_milliseconds();
    bool last = rtc_mfp_level();
    while (get_milliseconds() - start < 1200U) {
        bool now = rtc_mfp_level();
        if (now && !last) {
            break;
        }
        last = now;
    }

    uint32_t epoch;
    if (!rtc_read_time(&epoch)) {
        debug_printf("RTC: time registers unreadable or never set; clock starts at the build time\n");
        return;
    }
    set_epoch_seconds(epoch);
    rtc_clock_from_chip = true;

    rtc_civil_t c;
    rtc_civil_from_epoch(epoch, &c);
    debug_printf("RTC: %04u-%02u-%02u %02u:%02u:%02u UTC\n",
                 c.year, c.month, c.day, c.hour, c.minute, c.second);
}

// SYS_SETTIME and the monitor's `date` setter.  The counter is always set;
// the chip is written when there is one.
extern "C" long sys_settime(uint32_t epoch)
{
    set_epoch_seconds(epoch);
    if (!rtc_present()) {
        return -ENODEV;
    }
    if (!rtc_write_time(epoch)) {
        return -EIO;
    }
    rtc_clock_from_chip = true;
    return 0;
}


extern "C" void delay_milliseconds(uint32_t millis)
{
    uint32_t then = get_milliseconds();
    while(get_milliseconds() - then < millis);
}

// ---------------------------------------------------------------------------
// 68681 DUART — Channel A console (115200 8N1)
// ---------------------------------------------------------------------------

// CRA/CRB command encodings
static constexpr uint8_t DUART_CMD_RESET_MR_PTR = 0x10;  // MC=1
static constexpr uint8_t DUART_CMD_RESET_RX     = 0x20;  // MC=2
static constexpr uint8_t DUART_CMD_RESET_TX     = 0x30;  // MC=3
static constexpr uint8_t DUART_CMD_RESET_ERR    = 0x40;  // MC=4
static constexpr uint8_t DUART_CMD_ENABLE_TXRX  = 0x05;  // EC=1, TC=1

extern "C" void duart_putchar(uint8_t ch)
{
    while (!(DUART_SRA & Griffin::DUART_SRA_TXRDY_MASK))
        ;
    DUART_TBA = ch;
}

extern "C" uint8_t duart_getchar()
{
    // Spin until the ISR has deposited a byte.  Head is only advanced
    // here (single consumer); tail is only advanced by the ISR.  On
    // the 68000 an aligned long-word read is atomic, so no masking
    // of interrupts is required around these indices.
    while (uart_rx_head == uart_rx_tail)
        ;
    uint8_t ch = uart_rx_queue[uart_rx_head];
    uart_rx_head = (uart_rx_head + 1) & (UART_RX_QUEUE_SIZE - 1);
    return ch;
}

extern "C" bool duart_received_ready()
{
    return uart_rx_head != uart_rx_tail;
}

// Defined in syscalls.c — switches write()/read() to DUART backend
extern "C" void duart_console_enable();

// Runtime DUART setup: RX interrupt + 100 Hz C/T tick.  The baud rate
// and 8N1 framing (115200) are already programmed by crt0's early
// duart_early_tx_init, so this must NOT re-touch CSRA/MR or the BRG
// Extend bits (set for Ch A via CRA 0x80 (Rx) and CRA 0xA0 (Tx) — misc
// commands in the upper nibble; the CRA values used here —
// 0x20/0x40/0x05 — don't disturb them, and ACR is written with bit7=0 so
// Bit Rate Set #1 is preserved).  It only flushes RX, sets the C/T tick,
// and enables interrupts.
static void duart_runtime_init()
{
    debug_printf("DUART: runtime init (RX irq + 100 Hz tick)\n");

    // RX queue state (.monitor_data is NOLOAD, not cleared by BSS init).
    uart_rx_head = 0;
    uart_rx_tail = 0;
    uart_rx_overflow = 0;

    // Flush the RX path (baud/format left as the early init set them).
    // Do NOT reset TX — that would interrupt the live console.
    DUART_CRA = DUART_CMD_RESET_RX;
    DUART_CRA = DUART_CMD_RESET_ERR;

    // Probe and configure the RTC first: its MFP interrupt enable goes into
    // ACR, and IP3 floats (and would storm) when no chip is on it.
    bool rtc = rtc_init();
    debug_printf("RTC: MCP7940N %s\n", rtc ? "acknowledged" : "did not answer");
    rtc_seconds = BUILD_EPOCH;
    rtc_fallback_ticks = 100;
    rtc_from_mfp = rtc ? 1 : 0;

    // ACR: BRG set 0 (bit 7 = 0, baud unchanged), C/T = Timer mode on
    // X1/CLK direct (bits 6:4 = 110) for the system tick, IP3
    // change-of-state IRQ when the RTC is there.
    DUART_ACR = static_cast<uint8_t>((0x6U << Griffin::DUART_ACR_CT_MODE_SHIFT) |
                                     (rtc ? Griffin::DUART_ACR_IP3_INT_EN_MASK : 0U));

    // C/T preload: Timer mode fires every square-wave half-period
    // = preload input cycles.  TICK_HZ is a firmware convention.
    static constexpr uint32_t TICK_HZ = 100;
    static constexpr uint32_t TICK_PRELOAD = Griffin::DUART_CLOCK / TICK_HZ / 2;
    static_assert(TICK_PRELOAD > 0 && TICK_PRELOAD < 0x10000,
                  "DUART tick preload must fit in 16 bits");
    DUART_CTUR = (TICK_PRELOAD >> 8) & 0xFF;
    DUART_CTLR =  TICK_PRELOAD       & 0xFF;

    // RXRDYA + CTR_READY (+ IPC for the RTC) share the level-5 autovector;
    // _duart_isr distinguishes them via the ISR snapshot.
    DUART_IMR = static_cast<uint8_t>(Griffin::DUART_ISR_RXRDYA_MASK | Griffin::DUART_ISR_CTR_READY_MASK |
                                     (rtc ? Griffin::DUART_ISR_IPC_MASK : 0U));
    DUART_IVR = 0x0;

    DUART_CRA = DUART_CMD_ENABLE_TXRX;

    // Read STARTCC to kick off the C/T (the read itself is the side effect).
    uint8_t startcc_discard = DUART_STARTCC;
    (void)startcc_discard;

    uint8_t sra = DUART_SRA;
    debug_printf("DUART: SRA=0x%02X%s\n", sra,
                 (sra & Griffin::DUART_SRA_TXRDY_MASK) ? " TXRDY" : " (no TXRDY!)");
}

[[maybe_unused]] static void dump_hex(uint32_t base_addr, const uint8_t *data, int size)
{
    int offset = 0;
    while (size > 0)
    {
        int howmany = (size < 16) ? size : 16;

        printf("  0x%06lX: ", static_cast<unsigned long>(base_addr + offset));
        for (int i = 0; i < howmany; i++)
        {
            printf("%02X ", data[i]);
        }
        printf("\n");

        printf("            ");
        for (int i = 0; i < howmany; i++)
        {
            char c = data[i];
            printf(" %c ", (c >= 0x20 && c <= 0x7E) ? c : '.');
        }
        printf("\n");

        size -= howmany;
        data += howmany;
        offset += howmany;
    }
}

static FATFS fatfs;

// List one directory of the mounted filesystem.  Shared by the boot-time
// CF report and the monitor's "ls" command.
static void list_directory(const char *path)
{
    DIR dir;
    FILINFO fno;
    FRESULT res = f_opendir(&dir, path);
    if (res != FR_OK)
    {
        printf("ls: cannot open %s (FatFS err %d)\n", path, res);
        return;
    }
    for (;;)
    {
        res = f_readdir(&dir, &fno);
        if (res != FR_OK || fno.fname[0] == '\0')
        {
            break;
        }
        printf("  %c %7lu  %s\n",
               (fno.fattrib & AM_DIR) ? 'd' : '-',
               static_cast<unsigned long>(fno.fsize), fno.fname);
    }
    f_closedir(&dir);
}

static void cf_mount_and_list()
{
    cf_error err = cf_init();
    if (err != CF_OK)
    {
        printf("CF: init failed (err=%d) status=0x%02X error=0x%02X\n",
               err, CF_STATUS, CF_ERROR);
        return;
    }
    printf("CF: init OK\n");

    uint8_t id_buf[512];
    err = cf_identify(id_buf);
    if (err != CF_OK)
    {
        printf("CF: identify failed (err=%d) status=0x%02X error=0x%02X\n",
               err, CF_STATUS, CF_ERROR);
        return;
    }

    cf_info info;
    cf_parse_identify(id_buf, &info);
    printf("CF: %s, firmware %s, serial %s\n", info.model, info.firmware_rev, info.serial);
    printf("CF: sectors:  %lu, capacity: %lu KB\n",
           static_cast<unsigned long>(info.lba_sectors), static_cast<unsigned long>(info.lba_sectors / 2));

    // Mount filesystem
    FRESULT res = f_mount(&fatfs, "", 1);
    if (res != FR_OK)
    {
        printf("CF: mount failed (FatFS err=%d)\n", res);
        return;
    }
    printf("CF: filesystem mounted\n");

    // Print volume label
    char label[12];
    DWORD vsn;
    res = f_getlabel("", label, &vsn);
    if (res == FR_OK)
    {
        if (label[0])
        {
            printf("Volume: %s (S/N %04X-%04X)\n",
                   label, static_cast<unsigned>(vsn >> 16), static_cast<unsigned>(vsn & 0xFFFF));
        }
        else
        {
            printf("Volume: (no label) (S/N %04X-%04X)\n",
                   static_cast<unsigned>(vsn >> 16), static_cast<unsigned>(vsn & 0xFFFF));
        }
    }

    // Print free space
    DWORD free_clust;
    FATFS *fs_ptr;
    res = f_getfree("", &free_clust, &fs_ptr);
    if (res == FR_OK)
    {
        unsigned long free_kb = static_cast<unsigned long>(free_clust * fs_ptr->csize) / 2;
        unsigned long total_kb = static_cast<unsigned long>((fs_ptr->n_fatent - 2) * fs_ptr->csize) / 2;
        printf("  %lu KB free / %lu KB total\n", free_kb, total_kb);
    }

    printf("Root directory:\n");
    list_directory("/");
}

// NOTE: play_audio() (GLUE timer + AUDIO_DAC sample pacing) was removed
// with the GLUE timer.  Deterministic audio sample timing now needs a
// different source (e.g. the DUART C/T or a future DMA path).

// Pop one byte from the event ring buffer.  Returns false if empty.
// No interrupt masking needed — head is only modified here (single consumer).
[[maybe_unused]] static bool evt_pop(uint8_t *out)
{
    uint32_t h = evt_head;
    if(h == evt_tail)
    {
        return false;
    }
    *out = evt_queue[h];
    evt_head = (h + 1) & (EVT_QUEUE_SIZE - 1);
    return true;
}

extern "C" {
extern long read(int file, void *__buf, size_t len);
};

// Parse an ASCII hex string; if end is non-null it receives a pointer to the
// first non-hex character.  Used by the monitor's ADDR/VAL/LEN arguments.
static uint32_t parse_hex(const char *s, const char **end)
{
    uint32_t val = 0;
    while (*s)
    {
        char c = *s;
        if (c >= '0' && c <= '9')
        {
            val = (val << 4) | (c - '0');
        }
        else if (c >= 'a' && c <= 'f')
        {
            val = (val << 4) | (c - 'a' + 10);
        }
        else if (c >= 'A' && c <= 'F')
        {
            val = (val << 4) | (c - 'A' + 10);
        }
        else
        {
            break;
        }
        s++;
    }
    if (end)
    {
        *end = s;
    }
    return val;
}

// ---------------------------------------------------------------------------
// Video framebuffer and the ENGINE display list
//
// Rev-1 streamed a fixed 42 words per scanline and carried the palette in band
// as a 4-byte header.  Rev 2 has no VIDEO chip: ENGINE walks a descriptor list
// in RAM, PIXEL unpacks a headerless 1bpp plane, and everything that used to be
// a video register — palette, mode, pixel_skip — arrives as VIDCMD SET
// instructions in the same list.  So the framebuffer is now plain: 480 lines of
// 80 bytes, word aligned, no header, no stride padding, no page alignment.
//
// The encoders come from super-engine/descriptor.h, which is the same header
// the emulator's ENGINE/PIXEL/COMPOSITOR models and the validation suite use.
// It is bare-metal by construction (only <cstdint>/<cstddef>/<span> and the
// generated header) and this is its first build for the target.
// ---------------------------------------------------------------------------

#include "../super-engine/descriptor.h"

namespace se   = SuperEngine;
namespace gtxt = griffin::textport;

static uint32_t FB_ADDR                  = 0;
static constexpr unsigned FB_LINES       = 480;
static constexpr unsigned FB_WORDS_PER_LINE = se::PIXELS_WORDS_1BPP;      // 40
static constexpr unsigned FB_STRIDE      = FB_WORDS_PER_LINE * 2;         // 80
static constexpr unsigned FB_BYTES       = FB_LINES * FB_STRIDE;          // 38400

// MICRO-HAM IS RETIRED (2026-09-20, the indexed PIXEL).  PIXEL is index-only
// now: there is no HAM decoder, no pal_fg/pal_bg/ham_held, and a `.ham` file has
// no mode to be displayed in.  Pictures are shown by apps/view (.gcx files,
// image-tools/gcx_target.h), not by the ROM.

// Console colours, as R4G4B4 palette entries.  The console's 1bpp plane at
// pix_base 0 selects ENTRY 1 for a set bit and ENTRY 0 for a clear one, and the
// frame preamble loads both — nothing in hardware clears the palette RAM, but
// nothing initialises it either.
static constexpr se::Rgb444 CONSOLE_FG = 0x0FFF;   // white, palette entry 1
static constexpr se::Rgb444 CONSOLE_BG = 0x0000;   // black, palette entry 0
static constexpr unsigned   CONSOLE_PIX_BASE = 0;

// ---------------------------------------------------------------------------
// Display-list window
//
// edma3.v's descriptor pointer is 15 bits of WORD address inside a hard-wired
// page, so every descriptor has to live in 0x3F0000..0x3FFFFF and be 8-byte
// aligned.  linker.ld reserves the whole page (0x3F0000..0x3FFFFF) for it and
// drops _stack_top below the window, because the stack used to start at
// 0x400000 and would have grown straight down through the table.
//
// The window is split by the direct-video syscalls, not by the hardware:
//
//   0x3F0000 +-------------------------------+
//            | console table   0x1F40 (1000  |  the CONSOLE list and its VIDCMD
//            |                  descriptors) |  payload live entirely below the
//   0x3F1F40 | console VIDCMD  0x00C0        |  app carve, so they survive an
//   0x3F2000 +-------------------------------+  app owning it
//            | GRIFFIN_APP_DESC_BASE, 56 KB  |
//            | carved out for an application |  handed to the app by
//            | holding direct video access   |  SYS_VIDEO_DIRECT_START
//   0x400000 +-------------------------------+
//
// The firmware's only list is the console's, so the region above it is unused
// while no app holds direct access.
// ---------------------------------------------------------------------------
extern "C" char _displaylist_start[];

// Must match linker.ld's _displaylist_size / _displaylist_start; checked
// against the linker symbol at runtime in video_framebuffer_init().
static constexpr uint32_t DL_SIZE  = 0x10000;
static constexpr uint32_t DL_START = se::DESC_TABLE_BASE + 0x10000 - DL_SIZE;   // 0x3F0000

// Console: table + payload sized to land exactly on the app carve boundary.
static constexpr uint32_t DL_CONSOLE_TABLE_BYTES  = 0x1F40;   // 1000 descriptors
static constexpr uint32_t DL_CONSOLE_VIDCMD_BYTES = 0x00C0;   // 96 words

static_assert(DL_START + DL_CONSOLE_TABLE_BYTES + DL_CONSOLE_VIDCMD_BYTES
                  <= GRIFFIN_APP_DESC_BASE,
              "the console list and its VIDCMD payload must fit below the app "
              "descriptor carve, or an app holding direct video would clobber "
              "the console");
static_assert(DL_START + DL_SIZE == GRIFFIN_APP_DESC_BASE + GRIFFIN_APP_DESC_BYTES,
              "the display-list window must end at the top of the descriptor page");

static uint32_t dl_table_base = 0;    // 0x3F0000
static uint32_t dl_max_desc = 0;      // descriptor capacity of the active list's region
static uint32_t dl_vidcmd_base = 0;   // just above the active list's table
static uint32_t dl_vidcmd_bytes = 0;  // payload capacity of the active list's region
static uint32_t dl_desc_count = 0;    // descriptors emitted into the current list
static uint32_t dl_vidcmd_used = 0;   // VIDCMD payload words emitted
static bool     dl_overflow = false;

// The vsync ISR re-arms from this every frame (crt0.s).  It is the word
// address of the list's first descriptor within the descriptor page.
extern "C" uint16_t engine_desc_word_addr;
extern "C" volatile uint32_t video_frame_counter;
extern "C" volatile uint32_t engine_frame_counter;

static void dl_reset(uint32_t table_bytes, uint32_t vidcmd_bytes)
{
    dl_max_desc     = table_bytes / se::DESC_BYTES;
    dl_vidcmd_base  = dl_table_base + table_bytes;
    dl_vidcmd_bytes = vidcmd_bytes;
    dl_desc_count   = 0;
    dl_vidcmd_used  = 0;
    dl_overflow     = false;
}

static void dl_emit(const se::Descriptor &d)
{
    if (dl_desc_count >= dl_max_desc)
    {
        dl_overflow = true;
        return;
    }
    const se::DescriptorWords w = se::encode_descriptor(d);
    uint16_t *p = reinterpret_cast<uint16_t *>(dl_table_base + dl_desc_count * se::DESC_BYTES);
    for (unsigned i = 0; i < se::DESC_WORDS; i++)
    {
        p[i] = w.w[i];
    }
    dl_desc_count++;
}

// A wait_hblank descriptor with no strobe and one payload word consumes
// exactly one HBLANK edge and deposits nothing: the cheapest possible way to
// spend a scanline.  edma3.v has no wait-VBLANK, so a run of these is how a
// list armed mid-vblank walks to the top of the frame, and one more with
// stop_after pins the end-of-frame IRQ to a fixed scanline.
static void dl_emit_pacer(bool stop_after)
{
    se::Descriptor d;
    d.src         = FB_ADDR;          // any readable word; nothing latches it
    d.count       = 1;
    d.destination = se::DEST_NONE;
    d.wait_hblank = true;
    d.stop_after  = stop_after;
    dl_emit(d);
}

// Append VIDCMD words to the payload area and return their byte address.
static uint32_t dl_put_vidcmd(const uint16_t *words, unsigned n)
{
    const uint32_t at = dl_vidcmd_base + dl_vidcmd_used * 2;
    if ((dl_vidcmd_used + n) * 2 > dl_vidcmd_bytes)
    {
        dl_overflow = true;
        return at;
    }
    uint16_t *p = reinterpret_cast<uint16_t *>(at);
    for (unsigned i = 0; i < n; i++)
    {
        p[i] = words[i];
    }
    dl_vidcmd_used += n;
    return at;
}

// One scanline of 1bpp pixels: two 20-word PIXELS descriptors, the first
// waiting for the HBLANK edge that opens the line.  20 words is
// ENGINE_WORDS_PER_BURST and splits the 40-word line evenly.
static void dl_emit_pixel_line(unsigned line, bool wait_first)
{
    const uint32_t src = FB_ADDR + line * FB_STRIDE;
    for (unsigned half = 0; half < 2; half++)
    {
        se::Descriptor d;
        d.src         = src + half * (FB_WORDS_PER_LINE / 2) * 2;
        d.count       = FB_WORDS_PER_LINE / 2;
        d.destination = se::DEST_PIXELS_FIFO_W;
        d.wait_hblank = wait_first && (half == 0);
        dl_emit(d);
    }
}

// ---------------------------------------------------------------------------
// Walking from the vsync ISR to the top of the frame
//
// The list is armed inside line V_SYNC_START (490): TIMING latches vsync at the
// start of that line and the ISR runs a few hundred cycles later.  Every
// wait_hblank descriptor after that consumes one scanline boundary, so the list
// needs one pacer for each of lines 491..524 before its first visible-line
// group lands on line 0.
//
// This count is the one number in the list that depends on interrupt latency
// rather than on arithmetic.  There is a full scanline (~445 SYSCLK, 32 us) of
// slack, so it is not tight, but if the ISR ever slipped past a boundary the
// whole image would shift by one line — cosmetic on a text console, and
// visible immediately.
// ---------------------------------------------------------------------------
static constexpr unsigned VBLANK_WALK_LINES = 34;   // lines 491..524

// The console's entire VIDCMD budget: EIGHT words, once per frame —
// {palette entry 0, palette entry 1, SET pix_base, SET pix_mode,
// RUN(passthrough,1)}, where entry 0 is the three words of vidcmd-spec.md §3.2
// (SET clut_index, SET clut_data, the same-value filler) and entry 1 the
// two-word run-on entry the post-increment allows (SET clut_data, filler).
// COMPOSITOR holds the last source to the end of a line and a line that receives
// no records at all keeps holding, so one 1-slot passthrough RUN paints all 480
// lines.  Everything here is consumed during vertical blanking and costs no slot
// at all — which is also the only place a palette write is unconditionally
// legal, since the four pixel slots after a clut_data SET are disturbed.

// Descriptor and payload budgets, checked here where VBLANK_WALK_LINES is in
// scope.  The console's is the one that matters for correctness: it is what
// keeps the console list below GRIFFIN_APP_DESC_BASE.
static constexpr unsigned CONSOLE_PREAMBLE_WORDS = se::palette_table_words(2) + 3;
static constexpr unsigned CONSOLE_DESCRIPTORS = 1 + VBLANK_WALK_LINES + 2 * FB_LINES + 1;

static_assert(CONSOLE_DESCRIPTORS * se::DESC_BYTES <= DL_CONSOLE_TABLE_BYTES,
              "console display list outgrew its below-the-carve table region");
static_assert(CONSOLE_PREAMBLE_WORDS * 2 <= DL_CONSOLE_VIDCMD_BYTES,
              "console frame preamble outgrew its below-the-carve payload region");

static void dl_build_console_list()
{
    dl_reset(DL_CONSOLE_TABLE_BYTES, DL_CONSOLE_VIDCMD_BYTES);

    // The two palette entries the 1bpp plane selects, then base and mode.  The
    // palette RAM is NEVER reset — not by /RS, not at power-up — so these two
    // entries are what makes the console a picture rather than noise; /RS does
    // clear pix_base and pix_mode, which is why they are re-sent every frame.
    static_assert((CONSOLE_PIX_BASE & 1u) == 0,
                  "the run-on entry lands at base | 1 only if base is even");
    const se::PaletteEntryWords bg = se::vidcmd_palette_entry(CONSOLE_PIX_BASE | 0u,
                                                             CONSOLE_BG);
    const se::PaletteNextWords  fg = se::vidcmd_palette_next(CONSOLE_FG);   // base | 1
    const uint16_t preamble[CONSOLE_PREAMBLE_WORDS] = {
        bg.w[0], bg.w[1], bg.w[2],
        fg.w[0], fg.w[1],
        se::vidcmd_set(se::SET_PIX_BASE, CONSOLE_PIX_BASE),
        se::vidcmd_set(se::SET_PIX_MODE,
                       se::pixel_mode(se::PIXEL_DEPTH_1BPP, false)),
        se::vidcmd_run(se::RUN_SRC_PASSTHROUGH, 1),
    };
    const uint32_t pre_addr = dl_put_vidcmd(preamble, CONSOLE_PREAMBLE_WORDS);

    // Not wait_hblank: this runs the instant DESC is written, which is inside
    // vertical blanking, which is exactly where a frame preamble belongs — and
    // where the palette writes' disturbed pixel slots do not exist.
    se::Descriptor pre;
    pre.src         = pre_addr;
    pre.count       = CONSOLE_PREAMBLE_WORDS;
    pre.destination = se::DEST_VIDCMD_FIFO_W;
    dl_emit(pre);

    for (unsigned i = 0; i < VBLANK_WALK_LINES; i++)
    {
        dl_emit_pacer(false);
    }
    for (unsigned line = 0; line < FB_LINES; line++)
    {
        dl_emit_pixel_line(line, true);
    }
    dl_emit_pacer(true);
}

// ---------------------------------------------------------------------------
// Textport demo: drive an 80x30 VT102-compatible textport on the framebuffer
// ---------------------------------------------------------------------------

namespace griffin::textport {
    extern const FontRenderer font_8x16_renderer;
    extern const FontRenderer font_8x8_renderer;
    extern const FontRenderer font_6x10_renderer;
    extern const uint8_t font_8x16_bits[256 * 16];
}

// ---------------------------------------------------------------------------
// Bitmap-text smoke test: route lorem-ipsum through Vt102Parser::put,
// using only printable ASCII (no ESC, no control chars, no UTF-8).  This
// exercises only the parser's S::Normal printable fast path, which is a
// one-line delegation to Textport::put_glyph.
// Cursor blink is intentionally NOT ticked.
// ---------------------------------------------------------------------------
[[maybe_unused]] static void bitmap_text_test()
{
    static const char lorem[] =
        "Lorem ipsum dolor sit amet, consectetur adipiscing elit, sed do "
        "eiusmod tempor incididunt ut labore et dolore magna aliqua. Ut "
        "enim ad minim veniam, quis nostrud exercitation ullamco laboris "
        "nisi ut aliquip ex ea commodo consequat. Duis aute irure dolor "
        "in reprehenderit in voluptate velit esse cillum dolore eu fugiat "
        "nulla pariatur. Excepteur sint occaecat cupidatat non proident, "
        "sunt in culpa qui officia deserunt mollit anim id est laborum.";

    gtxt::g_textport.configure(
        reinterpret_cast<uint8_t*>(FB_ADDR),
        FB_STRIDE,                        // headerless 80-byte pixel plane
        &gtxt::font_8x16_renderer,
        80U, 24U,
        0);
    gtxt::g_vt102.reset();

    for (int rep = 0; rep < 10; ++rep)
    {
        for (const char* s = lorem; *s; ++s)
        {
            gtxt::g_vt102.put(static_cast<uint8_t>(*s));
        }
    }
}

// Caller for the VT102 parser when it needs to send a reply (e.g. cursor
// position report) — routes to the DUART so the host sees it.
extern "C" void textport_uart_responder(const char* s, size_t n)
{
    for (size_t i = 0; i < n; ++i)
    {
        duart_putchar(static_cast<uint8_t>(s[i]));
    }
}

// syscalls.c hook — flips the textport-enabled flag in the console tee.
extern "C" void textport_console_set_enabled(int on);

// Bring up the on-screen console.  After this returns, printf goes to
// DUART AND the textport, the early-log ring is drained onto the textport,
// and the splash (if any) sits at the top of the screen waiting to scroll
// off as text fills.
static void textport_console_enable()
{
    constexpr unsigned CONSOLE_COLS   = 80;
    constexpr unsigned CONSOLE_ROWS   = 30;

    const auto& fr = gtxt::font_8x16_renderer;
    const unsigned font_h = fr.font->height;

    gtxt::g_vt102.set_responder(&textport_uart_responder);
    // Headerless plane: pixel_offset 0, stride 80.  The palette is not in the
    // framebuffer any more — it is the two SETs in the list's frame preamble —
    // so there is no palette word to stamp and nothing to restamp after a
    // clear or a scroll.
    gtxt::g_textport.configure(
        reinterpret_cast<uint8_t*>(FB_ADDR),
        FB_STRIDE,
        &fr,
        CONSOLE_COLS, CONSOLE_ROWS,
        0);
    gtxt::g_vt102.reset();

    // Splash sits at the top of the FB; the Textport's char buffer for
    // those rows is still ' ', so the cursor avoids them until scrolling
    // evicts them.
    splash_blit_topleft(reinterpret_cast<uint8_t*>(FB_ADDR), FB_STRIDE);
    const unsigned splash_rows = splash_rows_for_font_height(font_h);
    gtxt::g_textport.move_to(0, static_cast<int>(splash_rows));

    // Replay everything we captured since boot.  Each byte goes straight
    // into the VT102 parser — the syscalls tee has NOT been told the
    // textport is up yet, so we don't double-emit to DUART.
    early_log_replay(&gtxt::textport_vt102_putchar);
    early_log_freeze();

    // Re-emit info that crt0 sent only via duart_puts (and so isn't in
    // the ring) plus what's now interesting on the visible console.
    textport_console_set_enabled(1);
    if (uint32_t dropped = early_log_dropped_count(); dropped)
    {
        printf("[early-log: %lu bytes dropped to overflow]\n",
               static_cast<unsigned long>(dropped));
    }
    printf("CPU: MC%s, Memory: %ld KB\n", cpu_is_68010 ? "68010" : "68000", memory_size);
}

// The framebuffer is an ordinary heap allocation now: ENGINE descriptors carry
// a full 22-bit source address, so the 64K page alignment rev-1's SOURCE_PAGE
// forced is gone.  Only word alignment matters (the engine reads 16-bit words,
// and the textport's long movers want 4).
static void *fb_raw = nullptr;   // retained base of the framebuffer allocation (never freed)

static void fb_alloc()
{
    if (FB_ADDR != 0)
    {
        return;
    }
    fb_raw = malloc(FB_BYTES + 4);
    if (fb_raw == nullptr)
    {
        printf("FB: alloc of %u bytes FAILED -- video disabled\n", FB_BYTES);
        return;
    }
    FB_ADDR = (reinterpret_cast<uint32_t>(fb_raw) + 3u) & ~3u;
}

static void video_framebuffer_init()
{
    fb_alloc();
    if (FB_ADDR == 0)
    {
        return;
    }

    // DL_START mirrors linker.ld's _displaylist_start so the region sizes above
    // can be static_asserted against GRIFFIN_APP_DESC_BASE; if the two ever
    // drift apart those asserts are checking the wrong window, so say so and
    // leave video off rather than scribble somewhere unexpected.
    dl_table_base = reinterpret_cast<uint32_t>(_displaylist_start);
    if (dl_table_base != DL_START)
    {
        printf("ENGINE: linker display list at 0x%06lX, rom.cpp expects 0x%06lX -- video disabled\n",
               static_cast<unsigned long>(dl_table_base),
               static_cast<unsigned long>(DL_START));
        dl_table_base = 0;
        return;
    }

    debug_printf("VIDEO: framebuffer at 0x%06lX (%u lines x %u bytes, headerless)\n",
                 static_cast<unsigned long>(FB_ADDR),
                 static_cast<unsigned>(FB_LINES), static_cast<unsigned>(FB_STRIDE));

    dl_build_console_list();
    if (dl_overflow)
    {
        printf("ENGINE: console list does not fit its %lu-byte region -- video disabled\n",
               static_cast<unsigned long>(DL_CONSOLE_TABLE_BYTES + DL_CONSOLE_VIDCMD_BYTES));
        return;
    }

    // What the vsync ISR writes to DESC every frame: the word address of the
    // first descriptor inside the descriptor page.
    engine_desc_word_addr =
        static_cast<uint16_t>((dl_table_base - se::DESC_TABLE_BASE) >> 1);

    printf("ENGINE: list at 0x%06lX, %lu descriptors (%lu bytes), %lu VIDCMD words\n",
           static_cast<unsigned long>(dl_table_base),
           static_cast<unsigned long>(dl_desc_count),
           static_cast<unsigned long>(dl_desc_count * se::DESC_BYTES),
           static_cast<unsigned long>(dl_vidcmd_used));

    // Arm it once by hand; from here the vsync ISR re-arms every frame.  There
    // is no readback to confirm with — ENGINE is write-only, the region reads
    // back as open bus — so the descriptor address is what gets printed.
    ENGINE_CTRL = Griffin::ENGINE_CTRL_ENABLE_MASK;
    ENGINE_DESC = engine_desc_word_addr;

    // Only now let the latched vsync reach IPL: GLUE keeps latching it from
    // reset, but the level-6 ISR is only meaningful once there is a list for
    // it to re-arm.  Before this the CPU could still poll VSYNC_STATUS.
    glue_config_set_bits(Griffin::GLUE_CONFIG_VSYNC_IRQ_EN_MASK);

    printf("ENGINE: armed at DESC=0x%04X\n",
           static_cast<unsigned>(engine_desc_word_addr));
}

// ---------------------------------------------------------------------------
// Direct video access — SYS_VIDEO_DIRECT_START / SYS_VIDEO_DIRECT_END
//
// The firmware's claim on ENGINE is exactly two things: the level-6 vsync ISR
// re-arming ENGINE_DESC from engine_desc_word_addr every frame, and the console
// display list sitting at dl_table_base.  Handing the hardware to an app is
// therefore just dropping the first (mask VSYNC_IRQ_EN, and gate the re-arm in
// the ISR itself so a stray latched vsync cannot sneak one in) and promising
// not to touch the app's carve.  ENGINE finishes the frame it is parked on and
// idles, because the list's trailing stop_after pacer disarms it and nothing
// re-arms; the app then writes its own DESC whenever it likes.
//
// POLLING IS THE SUPPORTED MODEL.  An app paces itself by watching
// GLUE_VSYNC_STATUS bit 0 and write-1-to-clearing GLUE_VSYNC_CLEAR.  The
// VSYNC_IRQ_EN bit stays syscall-owned rather than app-owned because GLUE
// CONFIG is write-only and shadowed by the firmware (glue_config_shadow in
// crt0.s), so an app has no way to read-modify-write it safely.
//
// See griffin_abi.h for the carve constants and the full ownership contract.
// ---------------------------------------------------------------------------

// Nonzero while an app holds direct access.  Lives in crt0.s so _vsync_isr can
// tst.b it; cleared explicitly in _start because .monitor_data is NOLOAD and
// deliberately not zeroed.
extern "C" volatile uint8_t video_direct_mode;

// Level-6 autovector (vector 30) in the RAM vector table, saved across a direct
// session so an app that installs its own handler cannot leave it installed.
static constexpr uint32_t VECTOR_LEVEL6_ADDR = 30 * 4;
static uint32_t video_direct_saved_vector = 0;

// The vector table lives at address 0, which every C++ compiler assumes is
// unmapped: a plain reinterpret_cast of a small constant trips -Warray-bounds
// ("source object is likely at address zero").  Laundering the address through
// an empty asm makes it opaque to that analysis without emitting an
// instruction.  The 68000 really does keep its vectors down there.
static volatile uint32_t *vector_slot(uint32_t addr)
{
    asm("" : "+r"(addr));
    return reinterpret_cast<volatile uint32_t *>(addr);
}

extern "C" long sys_video_direct_start(long info_ptr)
{
    if (video_direct_mode != 0)
    {
        errno = EBUSY;
        return -1;
    }
    if (FB_ADDR == 0 || dl_table_base == 0)
    {
        errno = ENODEV;
        return -1;
    }
    if (info_ptr == 0)
    {
        errno = EFAULT;
        return -1;
    }

    video_direct_saved_vector = *vector_slot(VECTOR_LEVEL6_ADDR);

    // Order matters: stop the ISR re-arming before the IRQ is masked, so there
    // is no window where a vsync taken between the two writes re-arms the
    // firmware list on top of whatever the app is about to install.
    video_direct_mode = 1;
    glue_config_clear_bits(Griffin::GLUE_CONFIG_VSYNC_IRQ_EN_MASK);
    GLUE_VSYNC_CLEAR = Griffin::GLUE_VSYNC_CLEAR_VSYNC_PENDING_MASK;

    GriffinVideoDirectInfo *info = reinterpret_cast<GriffinVideoDirectInfo *>(info_ptr);
    info->desc_table_base  = GRIFFIN_APP_DESC_BASE;
    info->desc_table_bytes = GRIFFIN_APP_DESC_BYTES;
    return 0;
}

extern "C" long sys_video_direct_end(void)
{
    if (video_direct_mode == 0)
    {
        return 0;   // idempotent: never taken, or already given back
    }

    *vector_slot(VECTOR_LEVEL6_ADDR) = video_direct_saved_vector;
    video_direct_mode = 0;

    // Unconditionally rebuild: the app may have armed anything at all, so
    // nothing about the previous list can be trusted.  The framebuffer is NOT in the carve or
    // in the app region (it is a firmware heap allocation up above
    // _firmware_ram), so the console text page is still intact and must NOT be
    // cleared here.  Apps run supervisor and could scribble on it anyway; that
    // is a bug in the app, not something this can defend against.
    dl_build_console_list();

    // Re-enable ENGINE without aborting: any write to CTRL acks a pending
    // level-3 IRQ, and ENABLE=1 leaves it running for the vsync ISR to arm.
    ENGINE_CTRL = Griffin::ENGINE_CTRL_ENABLE_MASK;

    GLUE_VSYNC_CLEAR = Griffin::GLUE_VSYNC_CLEAR_VSYNC_PENDING_MASK;
    glue_config_set_bits(Griffin::GLUE_CONFIG_VSYNC_IRQ_EN_MASK);
    return 0;   // the next vsync ISR writes DESC and the console is back
}

// SYS_VIDEO_VSYNC_IRQ: the interrupt pacing model of griffin_abi.h.  Only the
// enable bit moves here; the handler is whatever the app put in the level-6
// vector (saved at START, restored at END).  The latch is cleared first so a
// vsync that was latched while the IRQ was masked does not fire the app's
// handler mid-frame the instant it is enabled.
extern "C" long sys_video_vsync_irq(long enable)
{
    if (video_direct_mode == 0)
    {
        errno = EPERM;
        return -1;
    }
    if (enable != 0)
    {
        GLUE_VSYNC_CLEAR = Griffin::GLUE_VSYNC_CLEAR_VSYNC_PENDING_MASK;
        glue_config_set_bits(Griffin::GLUE_CONFIG_VSYNC_IRQ_EN_MASK);
    }
    else
    {
        glue_config_clear_bits(Griffin::GLUE_CONFIG_VSYNC_IRQ_EN_MASK);
    }
    return 0;
}

void process_ps2_inputs()
{
    uint16_t err_data = ps2_get_err_data();
    auto err_flags = ps2_get_err_flags();
    if(err_flags)
    {
        printf("ps2 err: 0x%02X (%s%s%s) data=0x%04X\n",
            err_flags,
            (err_flags & PS2_ERROR_FRAMING) ? "framing " : "",
            (err_flags & PS2_ERROR_PARITY) ? "parity " : "",
            (err_flags & PS2_ERROR_OVERRUN) ? "overrun " : "",
            err_data);
    }

    bool saw_BAT_code = false;
    while(ps2_received_ready())
    {
        uint8_t byte = ps2_getchar();
        printf("ps2: 0x%02X\n", byte);
        if(byte == 0xAA)
        {
            saw_BAT_code = true;
        }
    }
    if(saw_BAT_code)
    {
        printf("ps2: BAT OK, sending 0xED\n");
        ps2_send_byte(0xED);
        printf("ps2: BAT OK, sending 0x00\n");
        ps2_send_byte(0x00);
        printf("ps2: BAT OK, sent 0xED, enqueued 0x00\n");
    }
}

// Mainline mouse drain, the counterpart of process_ps2_inputs().  mouse.cpp
// only assembles packets; all reporting happens here.  Printing every packet
// would flood the console (a moving mouse reports ~40-100 times a second), so
// only button transitions are announced, carrying the current position with
// them.
static void process_mouse_input()
{
    static uint8_t last_buttons = 0;

    mouse_poll();

    mouse_report_t report;
    mouse_get_report(&report);
    if (report.buttons != last_buttons)
    {
        last_buttons = report.buttons;
        printf("mouse: x=%ld y=%ld wheel=%ld buttons=%c%c%c\n",
               static_cast<long>(report.x), static_cast<long>(report.y),
               static_cast<long>(report.wheel),
               (report.buttons & MOUSE_BUTTON_LEFT) ? 'L' : '-',
               (report.buttons & MOUSE_BUTTON_MIDDLE) ? 'M' : '-',
               (report.buttons & MOUSE_BUTTON_RIGHT) ? 'R' : '-');
    }
}

extern "C" int load_and_run_app(const char *path, int argc, char **argv);  // firmware/loader.cpp
extern "C" bool console_input_ready(void);           // firmware/syscalls.c
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
