bradgrantham/griffin/(commit log)

2026-02-24 get initial rom working
    * fix bunches of assumptions and errors
    * add soft uart for receiving ROM bitbang serial
    [emulator.cpp]
2026-02-25 get printf working
2026-02-27 add no-stack print routine to bitbanged 9600 serial
2026-02-27 improve UART sampling hygeine
2026-02-27 print approximate emulated clocks / second
2026-02-27 probe memory size and print a message
2026-02-27 switch to SDL
2026-02-28 update JTAG bypass and 8051 PS/2 pins
    [composite.kicad_sch, io.kicad_sch]
2026-03-01 JTAG bypass, GLUE A18, OBVID pins
    Fix up JTAG bypass again
    Switch GLUE A6 to GLUE A18
    Clean up some OBVID pins
    [board.kicad_pcb, composite.kicad_sch, glue.kicad_sch]
2026-03-03 Run VPA from GLUE to CPU
    * delete old ENGINE_IACK line and pullup - interrupts will be autovectored
    * run VPA between GLUE and CPU
    [cpu.kicad_sch, expansion.kicad_sch, glue.kicad_sch]
2026-03-04 generate constants, make some board design machine-readable
2026-03-04 change OBVID to VIDEO
    [board.kicad_sch, composite.kicad_sch, glue.kicad_sch]
2026-03-04 Fix VIDEO_LINES_COUNT width, document dtack, clean up register references
    - VIDEO_LINES_COUNT moved to offset 0x0C, width 16 (8-bit at 0x0D couldn't
    represent 480 visible lines for VGA 640x480)
    - VIDEO and ENGINE dtack documented as 0 wait states at 12 and 20 MHz
    - ENGINE and IO_MCU handshake dtack signals annotated with inline comments
    - griffin.md: replace raw 0x12 addresses with VIDEO_ARM_SNOOP by name
    - Regenerate griffin.generated.* with above changes
    [griffin.generated.h, griffin.yml]
2026-03-08 Update LED bodge from DEBUG_IN to DEBUG_OUT
    Replaced DEBUG_IN LED with DEBUG_OUT LED in documentation.
2026-03-08 CPUCLK -> SYSCLK
    [composite.kicad_sch, cpu.kicad_sch, expansion.kicad_sch, glue.kicad_sch, power-clock.kicad_sch, test-points.kicad_sch]
2026-03-08 start over hand-coding GLUE Verilog
2026-03-10 add DEBUG_OUT LED driver to isolate from logic
    [glue.kicad_sch]
2026-03-11 use correct symbol and footprint for 2222
    [glue.kicad_sch]
2026-03-11 add VPA bodge detail
    [griffin.yml]
2026-03-16 checkpoint working config; GLUE blinks an LED
2026-03-17 more notes, no JTAG IDC, UART RX in GLUE, drop IO SPI
2026-03-17 UART RX in GLUE
2026-03-17 initial stab at most GLUE, partially generated
2026-03-18 make both glue and video, first dep is .svf
2026-03-18 add WSs, move to GLUE UART block
2026-03-19 fix two UART TX bugs
    [glue.v]
2026-03-19 fix access for RX_DATA
    [griffin.yml]
2026-03-19 add UART RX and some output sound
2026-03-19 remove UART RX as it was too big for CPLD.
    [glue.v]
2026-03-21 report bus error, detect double bus fault, fix audio latch
    [glue.v]
2026-03-23 pull down IO MCU reset
    [griffin.yml]
2026-03-24 stubbed IO MCU firmware, test UART
2026-03-24 UART spin notes
2026-03-24 add UART bodge
2026-03-26 implement IO_RESET through GLUE
2026-03-26 simplify board spin and then add let CPLD compile assign pins
2026-03-27 add CLAUDE guidance
    [chip-inventory.csv]
2026-03-27 add checkpoint KiCAD output for Rev 1
    [board-B_Cu.gbr, board-B_Mask.gbr, board-B_Paste.gbr, board-B_Silkscreen.gbr, board-Edge_Cuts.gbr, board-F_Cu.gbr, board-F_Mask.gbr, board-F_Paste.gbr]
2026-03-28 remove double bus fault sense, add VIDEO_STALL enable
    * use constant based on clock for UART
    * Add enable for VIDEO_STALL
    * remove double bus fault sensing
    * fix TX UART
    [glue.v]
2026-03-29 add more test points and USB attachments
2026-03-29 hand tweak and extend sanity check ROM to working
    * use no RAM in initila bringup
    * tweak bitbang UART for timing discrepancy
    * do all RAM tests and then print the result on any failure
2026-03-30 make 'maybe' section of board spin notes
2026-03-30 use GLUE UART, make beeps once
    * Switch to GLUE UART for all output
    * Make happy beeps on RAM test success
    * Make sad beeps on RAM test fail
2026-03-30 add initial compact flash support
    * add CF to emulator
    * add rom probe init of CF and dump first sector
2026-03-30 add TIMER register to GLUE
    * Add timer register to YAML
    * Implement timer in glue.v
    * Emulate timer in emulator.cpp
    * Use timer for tones in sanity.s
2026-03-30 fix timer
2026-03-30 add files to ignore in GLUE CPLD build
2026-03-30 add CF card footprint
2026-03-30 add build number to GLUE bitfile
2026-03-30 clarify ROM and IO MCU in board rev
2026-03-30 add sanity testing to ROM firmware
    * Add exception handlers that blink
    * Wait for HALT to settle with a loop
    * Set DEBUG_OUT high at end of startup, otherwise breaks UART encoding
    * Add memory test
    * Add GLUE build ID
2026-03-31 Add a startup sound
    * Add play_audio() function that uses GLUE_TIMER stall to clock audio writes
    * Link in startup.raw and play it
    [rom.cpp]
2026-03-31 add IO MCU ID, clock MHz, startup sound, emulator audio (broken)
    [emulator.cpp, glue.v, rom.cpp]
2026-03-31 fix IO ID, purge SDL, use Hz for clock
    [emulator.cpp, main.c, rom.cpp]
2026-03-31 pullup PS/2 CLKs in case INT pullups insufficient
2026-03-31 fire irq on IDENTITY, fix long TX block on bus
    [main.c]
2026-04-03 add debug prints
2026-04-03 Add CF card probe and listing
2026-04-03 add debug prints on IO processor ISR
2026-04-03 hook up signals to GLUE and bus and set to disabled or tristate
2026-04-03 initial debug_in uart rx (untested)
2026-04-03 print what's on the bus before driving it
2026-04-03 move IO-MCU functionality to GLUE
    * Add a systick timer to GLUE
    * Drop UART RX from GLUE
2026-04-03 simplify and then extend GLUE to handle some IO functions
    * remove UART TX - bitbang using GLUE_TIMER
    * remove traces of UART RX - bitbang using GLUE_TIMER
    * replace IO IRQ with GLUE IRQ
    * add system tick and IRQ
    * mark IO absent
    [glue.v]
2026-04-03 extend emulator to handle new GLUE functionality
2026-04-03 use GLUE_TIMER to bitbang UART TX, handle UART RX
2026-04-04 note bitbanged TIMER RX and TX are working
2026-04-04 remove traces of IO_MCU
2026-04-04 remove traces of IO MCU and BUILD_ID
2026-04-04 Revert "move to loadable SYSTICK"
    This reverts commit 15719b66014456c1fa72332819296052d1302863.
    Turns out it used *more* of the CPLD.
    [glue.v, griffin.yml]
2026-04-04 only have 200Hz and 180Hz tick, use a config shadow
2026-04-05 Note that UART RX is polled
2026-04-05 ENGINE: replace read mux/IRQ with stride-based row advance and EOL
    - ROW_STRIDE register (2-bit, multiples of 64 words) replaces ROW_WORDS
    - EOL input from VIDEO triggers row advance (clear low 6 bits, add stride)
    - ADVANCE write-only register uses same row_advanced logic for field 1 offset
    - Status register reduced to single overrun bit (NEED_WORD while DMA busy)
    - Removed: full register read mux, frame_done, IRQ, row_col counter
    - Fits 108/128 macrocells (84%), down from 116 (90%)
    [engine.v]
2026-04-05 update docs and YML for ENGINE DMA design
    - griffin.yml: ENGINE registers, bodge signals, description
    - griffin.md: ENGINE section rewritten with HALT-based DMA architecture
    - ENGINE-programming.md: programmer guide for progressive and interlaced
    mode init and VSYNC ISR, including stride-swap trick for field 1 offset
    [griffin.yml]
2026-04-06 fix VIDEO to cooperate with ENGINE, update machine spec
    [video.v]
2026-04-06 tighten ENGINE/VIDEO/GLUE integration
2026-04-06 remove two bodges that can run on existing traces
    [griffin.yml]
2026-04-06 add video DMA setup and splash screen
2026-04-07 change name of PROBE_JTAG
2026-04-07 change name of PROBE_JTAG, add PROBE_ENGINE
2026-04-07 VIDEO: palette + STATUS regs; drop GLUE VIDEO_STALL; doc/yml cleanup
    Add the first CPU-visible VIDEO registers: PALETTE (0x0E, W16, two
    R3G3B2 entries) and STATUS (0x07, R8, LINE_TOGGLE = v_cnt[0]). Each
    1bpp framebuffer pixel now indexes the two-entry palette and the 8 bits
    unpack onto the existing VGA R3G3B2 DAC ladders. Reset defaults are
    black/white so existing firmware behavior is preserved. STATUS exposes
    v_cnt[0] so the CPU can busywait-pace audio writes or reload PALETTE
    per visible scanline for more than two colors.
    A 1-cycle pipeline (current_pixel_reg/active_video_reg) is required on
    the color outputs — without it the VGA color FFs need ~43 fanin signals
    and overflow LAB A's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
    [emulator.cpp, glue.v, griffin.yml, video.v]
2026-04-08 change TIMER to 8 bits & sysclk, use palette reg, mask irqs
2026-04-08 note to build glue before making source changes
2026-04-09 use constants for ENGINE and GLUE DTACK
2026-04-13 add 68681 DUART support: register defs, codegen clock, emulation, firmware init
    - griffin.yml: full MC68681 register map (32 registers across 16 offsets),
    bit definitions for SRA/CRA/ISR, peripheral clock field (3.6864 MHz)
    - codegen.py: emit peripheral clock constants (DUART_CLOCK) in C++, asm, Verilog
    - emulator: DUARTState with Channel A UART via PTY, counter/timer, interrupt
    generation at IPL 5, switch/case register dispatch
    - firmware: duart_init() configures 115200 8N1 via internal timer (ACR=0xE0,
    preload=1, CSRA=0xDD), boot sequence uses debug bit-bang then switches
    console to DUART after init verified
    - syscalls.c: function-pointer console switchover (debug_serial → duart)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
2026-04-17 add raw stdin mode for debug UART RX
2026-04-18 cut video down to timing, add CLRINT
2026-04-18 implement and use the video interrupt
2026-04-20 fix video interrupt
2026-04-21 add bus error decoder
    [decode_buserr.py]
2026-04-26 make PS2 signal names shorter
    [glue.v, griffin.yml]
2026-04-27 implement audio DMA through ENGINE CPLD
2026-04-27 redo PS2 into C so I can fix it; mostly works now
    [rom.cpp]
2026-04-28 switch to 68681 systick
2026-05-03 checkpoint tightening of warnings
2026-05-10 checkpoint bringup of DMA for video
2026-05-11 implement DMA video in emulator
2026-05-12 handle using a block device as CF card
2026-05-12 make current
2026-05-13 start shift at top of frame; remove background
2026-05-13 turn on video after DUART; use printf; change palettes
2026-05-24 route debug and printf to textport; print badge
2026-05-29 add draft per-line palette image viewer; fix memory size print
    [rom.cpp]
2026-06-02 emulate per-line palette write, approach hw correctness
    [emulator.cpp, engine.v, griffin.yml, rom.cpp, video.v]
2026-06-03 Add video stats probe
2026-06-05 move to palette inline with framebuffer
2026-06-19 implement PS/2 in GLUE; implement 115200 for XR68C681
2026-06-19 Add video FIFO wiring guide for PCB v1
2026-06-21 Reconcile Rev 2 sections with griffin.yml and design decisions
    Update Strategy/Summary/Board-changes for the Rev 2 plan: 68010@14MHz,
    2x AS6C6416 (12MB, 2-select decode), 2x SST39SF040 PLCC flash with
    FLASH_WE_EN-gated ~ROM_WE + JTAG-boundary-scan stretch, XR68C681,
    FT4232H 4-channel bridge (Ch D = host RESET/HALT, 74LVC245 xlate),
    DS3231 RTC on I2C via DUART (N-FET SDA), 16-bit CF, VGA-only video,
    in-band palette, dedicated ATF1504 FIFO stereo audio, IRQ map fix.
    Remove stale GLUE-timer/bit-bang-serial bullets.
    Claude-Session: https://claude.ai/code/session_01JvgD7jwaP3ANRuHsc5YB7F
2026-06-22 checkpoint more PCB rev 2 work
2026-06-28 Enforce griffin.yml as build single-source-of-truth; track generated files
    - subdir Makefiles (firmware/cpld/sanity) delegate include regeneration to the
    root, keyed to griffin.yml/codegen.py: auto-regen before build, no needless
    rebuilds when current; firmware objects now depend on the generated headers
    - codegen.py output made deterministic (dropped the embedded date) so the
    generated files diff cleanly
    - track griffin.generated.{h,inc,ld,vh,refs.h} (were gitignored) for reviewable
    propagation diffs; keep .codegen.stamp ignored
    - root targets: check-generated (regenerate-and-diff), check-codegen
    (regenerates-clean), install-hooks; hooks/pre-commit runs check-generated
    Schema dri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
2026-06-28 Fix schema drift; promote validate to a hard gate
    - hw_schema.yml: allow a bit-level 'default' field. codegen ORs bit defaults
    into each register reset value (reg_default), so it was valid data the schema
    was wrongly rejecting.
    - griffin.yml: DUART part is now a quoted string "XR68C681" (was the unquoted
    int 68681, which failed the schema's string type and named the wrong part).
    - Makefile: check-generated now depends on validate, so the pre-commit hook
    enforces schema-valid AND generated-files-current; dropped the interim
    check-codegen target.
    make validate now passes, so it can serve as a real gate.
    Claude-Session: https:/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
    [griffin.yml, hw_schema.yml]
2026-06-28 Wire emulator (CMake) into the griffin.yml regen chain
    emulator.cpp includes ../griffin.generated.h but nothing regenerated it — the
    emulator was the last consumer outside the single-source-of-truth guarantee.
    Add a custom command (OUTPUT griffin.generated.h, DEPENDS griffin.yml +
    codegen.py) that delegates to `make -C .. codegen`, wrapped in a
    griffin_generated target that the emulator target now depends on. Same delegate-
    to-root pattern as the firmware/cpld/sanity Makefiles, so editing the YAML
    regenerates the includes before the emulator builds.
    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
2026-06-28 Sweep consumers for hardcoded values that should come from griffin.yml
    Phase 0 closes from the consumer side: make sure firmware/emulator/Verilog
    reference the generated symbols instead of carrying private copies.
    - emulator: wait_state_penalty decoded the IO sub-region with a magic
    (addr >> 18) & 0x3 == 1/3; replace with the generated CF_BASE/CF_SIZE and
    AUDIO_BASE/AUDIO_SIZE so the address map has one source.
    - firmware: FB_PAGE was a second literal (0x0F) that had to track FB_ADDR
    (0x0F0000) by hand; derive it as FB_ADDR >> 16 (ENGINE_SOURCE_PAGE = A[23:16]).
    Already clean: rom.cpp/ps2.cpp use the generated Griffin:: symbols throughout;
    glue/video/engine.v all include griffin.gene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
    [emulator.cpp, rom.cpp]
2026-06-28 Relocate firmware RAM high; 4MB linker region; runtime-allocated framebuffer
    Restructures the RAM map so loaded applications get a fixed, immutable low
    base while firmware keeps its private data up high, and makes the linker see
    the board's true 4MB.
    - codegen: merge peripherals sharing a linker section into one ORIGIN/LENGTH
    spanning lowest base..highest end. Marking RAM_BANK_1..4 as section: ram
    now yields RAM_LENGTH = 0x400000 (was 0x100000 from bank 1 alone), so the
    linker MEMORY region covers all four contiguous banks.
    - linker.ld: app region 0x001000.._firmware_ram (0x380000) is left free for
    loaded programs; firmware .data/.bss/heap start at _firmware_ram and the
    supervis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
    [emulator.cpp, griffin.yml, rom.cpp]
2026-06-30 Add the application loader; run hello.bin from CF at boot
    Item 5: a loader that reads a flat app binary into the app region and runs it,
    completing the load-execute-return chain.
    - firmware/loader.cpp: load_and_run_app(path) opens the file via the newlib
    console/FatFs layer, reads it to _app_base (0x1000) bounded by _firmware_ram,
    and enters it at offset 0. It provides the strong app_exit() that overrides
    the weak stub in syscall_dispatch.cpp: when the app issues SYS_EXIT, app_exit
    longjmps back to the loader's setjmp point, unwinding the app's frames (and
    the abandoned TRAP #15 frame) so control returns cleanly. No I-cache flush
    is needed (68000/68010 have none).
    - rom.cpp ma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
    [loader.cpp, rom.cpp]
2026-07-21 Add VIDEO CTRL.IRQENB and switch emulator to 68010
    The Linux port's kernel timer bring-up hit a hard livelock: VIDEO's vsync
    IRQ has no mask (only CLRINT to acknowledge), and the vsync generator
    free-runs regardless of CTRL.ENABLE. Once interrupts are unmasked with no
    video driver installed yet, the unacked latch retriggers on every RTE,
    forever. Add CTRL.IRQENB (bit 1, default 0) to gate ~VIDEO_IRQ at the pin
    while leaving the latch itself unconditional, matching DUART's ISR/IMR
    split -- a late unmask still sees a pending vsync instead of losing it.
    Mirror the same behavior into the emulator's VideoState, switch the
    emulator to model a 68010 (setModel), and add a shared dump_cpu_state()
    he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
2026-07-24 ENGINE: stream SRAM at 2 cycles/word instead of full bus cycles
    Replace the per-word ADDR/WAIT_DTACK/LATCH 68000 bus cycle (7 clocks/word)
    with page-mode streaming: AS/UDS/LDS assert once per burst and hold, the
    address advances every 2 CPUCLK cycles, and /W strobes in the second cycle
    of each pair. DTACK is ignored -- the framebuffer is always 0-WS 55 ns
    SRAM selected combinationally by GLUE, so timing is known by construction
    (~55 ns data-setup slack per 143 ns word). The DTACK synchronizer and a
    state go away: ENGINE drops from ~97% to 71% of macrocells.
    Raise ENGINE_WORDS_PER_BURST 10 -> 20 to amortize the BR/BG/BGACK
    handshake; a burst is now ~2.9 us, still under half the 6.35 us hbl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
    [emulator.cpp, engine.v, griffin.generated.h, griffin.yml]
2026-07-25 emulator: smooth (bus-cycle-granular) video-DMA stall + debug tooling
    Deliver the per-scanline ENGINE DMA stall by spreading it across CPU
    instructions (accrue a debt, pay <=STEP cycles per step) instead of
    injecting the whole SYSCLKS_PER_LINE burst as one sync() lump between two
    whole instructions. Smooth is now the default; the lump is kept behind
    GRIFFIN_DMA_STALL_LUMP for A/B and intra-line tearing studies.
    Why: the coarse lump fast-forwards the shared clock ~a dozen instructions'
    worth in a single interrupt-blind gap at the video-scanline cadence. On
    the nommu/UP kernel that video-phased discontinuity mis-times a scheduler
    wakeup -- a freshly-created kthread never gets run, wait_for_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
    [emulator.cpp]
2026-07-25 emulator: PS/2 device-command responses + scripted keystroke injection
    Two additions to the GLUE PS/2 model so keyboard-input paths can be
    developed and tested unattended (issue: bradgrantham/griffin-linux#4):
    * Device command modeling: host TX bytes now get standard keyboard
    responses (0xFF reset -> 0xFA + BAT 0xAA after ~300 ms; 0xF2 GETID ->
    0xFA 0xAB 0x83; 0xED LEDs / 0xF3 typematic -> 0xFA + data -> 0xFA;
    0xF4/0xF5 -> 0xFA; 0xEE echo; unknown -> 0xFE), riding the existing
    1 ms/byte RX pacing. Lets Linux atkbd run its full GETID probe and
    u-boot/firmware do enable/LED writes exactly as on hardware. Runs
    without host TX are byte-identical to before.
    * --ps2-in FILE: script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
    [emulator.cpp]
2026-07-26 emulator: deterministic PC-sampling profiler (GRIFFIN_PROFILE=START:END)
    Histogram the PC once per instruction while the SYSCLK clock is inside the
    window; dump the hottest 64-byte buckets at exit for symbolization against
    System.map. Deterministic runs make the numbers exact. First catch: the
    7.5 s nommu exec cost is ~30% memcpy/memset (full-image copies), ~18%
    scheduler PELT load-average math through software 64-bit division, ~8%
    binfmt_flat proper -- and zero CF time when the page cache is warm.
    Claude-Session: https://claude.ai/code/session_01HhqVLa9iyYQxCtLNgMvEKK
2026-07-27 emulator: default to Release build; drop per-instruction time(2)
    Two host-side speedups for unattended iteration (the guest was running
    ~3x slower than necessary):
    * CMakeLists.txt now defaults CMAKE_BUILD_TYPE to Release when unset -- it
    had been building with no build type (plain -O0). ~3x on the
    interpreter core (200M cycles: 4.4s -> 1.5s).
    * The main loop called time(2) once per emulated instruction for the
    once-a-second stats line; sample it every 65536 instructions instead.
    Also adds DUART channel B endpoint wiring (--serialb-pty / --serialb-in/
    -out) and the second PTYConsole, for PPP-over-ttyS1 testing (issue #2).
    Clau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
    [emulator.cpp]
2026-07-27 emulator: skip framebuffer render when headless with no screenshot
    want_pixels=false when nobody views the fb (headless, no --screenshot):
    skip the per-scanline RAM peek + ARGB fill. DMA stall accounting still
    runs, so guest timing is byte-identical; measured a small host win, and
    it removes needless work from console-only iteration runs.
    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
    [emulator.cpp]
2026-07-27 emulator: --serialb-dev (connect channel B to an existing device)
    Opens an existing path (raw) as DUART channel B instead of allocating a
    fresh pty, so the host PPP peer can be set up ONCE against a stable
    endpoint (e.g. a socat pty bridge, or a symlink to the current pty) and
    survive many emulator restarts via pppd `persist` -- rather than
    re-running the host side per launch.
    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
2026-07-28 docs: video enhancement ideas -- bit depths, external LUT, component-wise modify
    Capture the post-streaming-DMA design discussion: 2bpp/4bpp bandwidth
    budgets, the external palette RAM in a feedback loop through VIDEO
    (preserving the output-FF accumulator so indexed and component-wise
    modify modes coexist), in-band per-line LUT writes via the reserved
    header bytes, parts-bin and pin-budget realities, and the ENGINE/VIDEO
    division of labor for future modes.
2026-07-28 upgraded expectations for PCB Rev 2
2026-07-28 set RAM back to 4M, add joys & paddles, offload decode
    Move SMT version of board to Rev 3
    Make Rev 2 just be a fixed-up Rev 1
    Set RAM to use 4MB and Rev 1 parts
    Set ROM to use Rev 1 parts
    Update emulator to RAM 4MB and 16-bit CF card
    Set firmware Makefile target to rom.bin
    Move bus-attached peripherals (AUDIO, JOYSTICK, PADDLE, CF) to a single 4MB region with IC decode
    [emulator.cpp, griffin.generated.h, griffin.yml, rom.cpp]
2026-07-28 fix comment about microham operation
    [video.v]
2026-07-28 add PORTS CPLD fit investigation
    Standalone fit experiment for a 4th ATF1508 (PORTS, peer of GLUE/VIDEO/
    ENGINE): PS/2 + joystick + paddle + audio-pop staging via ifdef wrapper
    configs, plus a GLUE rev-2 delta copy (glue_rev2_ports.v). Findings in
    pcbv2-ports-design.md; headlines:
    - two PS/2 channels overflow an ATF1508 by nodes+FB (109%) even alone
    - winning build: mouse + 2 joysticks + 2 paddles + HSYNC-tap line strobe
    (full-rate paddle tick, /2 audio FIFO pop at 15.73 kS/s + HF IRQ):
    111/128 LC (86%), first-pass fit
    - keyboard stays in GLUE: rev-2 delta logic fits (107/128 LC preassign
    ignore) but the rev-1 pinout does not route; rev 2 needs a fresh .pin
    and ends pin-full (60/64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
2026-07-28 adopt PORTS architecture in griffin.yml and griffin.md
    The cpld/ports fit experiment settled where the PS/2 mouse lives, and the
    answer reshapes the small-peripheral end of Rev 2. Two PS/2 frame engines
    will not share an ATF1508 (the pair alone needs 140 of 128 nodes, and every
    fitter lever and TQFP100 fail identically), so the keyboard stays in GLUE and
    everything else moves into a fourth ATF1508 called PORTS at 0xFC0000:
    * PS/2 mouse frame engine, at the same register offsets GLUE uses for the
    keyboard so ps2.cpp can become one base-parameterized driver
    * both joystick ports read as bytes -- retires the 2x 74HCT245
    * both paddle counters, 8-bit saturating, plus a PADDLE_CONTROL DUMP bi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
    [griffin.generated.h, griffin.yml]
2026-07-29 Add issues, video_config, schema update
    [emulator.cpp, griffin.generated.h, griffin.yml, hw_schema.yml]
2026-07-30 tighten up ISRs, move to RAM
    [ps2.h]
2026-07-31 promote PORTS and GLUE support of PORTS to POR
2026-07-31 Fix app linker script: 4MB RAM ceiling, EH section placement
    - LENGTH 0x77F000 -> 0x37F000: the app region ends at _firmware_ram
    (0x380000) on the 4MB board; the stale 8MB value let the app-side sbrk
    hand out firmware RAM instead of returning ENOMEM.
    - Place .gcc_except_table* explicitly in .text: as orphan sections the
    linker put them at 0x1000 ahead of .text.start, so the loader entered
    exception-table data instead of _start.
    - ALIGN(4) before .eh_frame: unaligned CIEs made crtbegin's
    __EH_FRAME_BEGIN__ point at padding, so the unwinder saw an empty
    table and abort()ed on the first throw.
    - ASSERT(_start == ORIGIN(APP)) so entry-point regressions fail the link.
    - Header comment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
2026-07-31 Add INPUTREADY/READDIR/GETTICKS/GETTIME syscalls and monitor shell
    Four new TRAP #15 calls (griffin.yml 9-12, dispatched in
    syscall_dispatch.cpp):
    - INPUTREADY wraps the existing console_input_ready(); apps poll it to
    implement BREAK without any line-discipline changes.
    - READDIR is stateless index-iteration over a directory (griffin_dirent.h
    entry struct, new sys_readdir in syscalls.c) so no fd-table pressure
    and nothing leaks if the app dies mid-listing.
    - GETTICKS returns get_milliseconds(); GETTIME returns boot_epoch +
    uptime. boot_epoch (rom.cpp) defaults to the firmware build time
    (BUILD_EPOCH stamped by the Makefile; rom.bin now differs per build)
    and stays a plain variabl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
    [griffin.generated.h, griffin.yml, loader.cpp, rom.cpp, syscall_dispatch.cpp]
2026-07-31 Add exctest exception/iostream gate app and mkcf.sh CF image builder
    apps/exctest exercises what the upcoming BASIC port needs from the app
    runtime: unwinding across frames with destructors, std::runtime_error,
    stoi -> invalid_argument, variant -> bad_variant_access, rethrow through
    nested try, and iostream/fstream (cout, getline(cin), ifstream from CF).
    All six pass in the emulator; exctest.bin is ~581 KB, the fixed cost of
    libstdc++ EH + iostream, well under the 3.6 MB loader cap. Permanent
    diagnostics (set_terminate handler, abort() override) stay in because
    the failure modes they catch are otherwise completely silent.
    apps/mkcf.sh builds a FAT16 superfloppy CF image with hdiutil from a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
    [main.cpp]
2026-08-01 Port BASIC interpreter as apps/basic, loadable from CF
    Copy of ../basic/basic.cpp with minimal edits; the interpreter core,
    iostream/fstream I/O, REPL fgets, LoadProgram/SaveProgram, usleep, and
    drand48 are unchanged from the host original -- they run against newlib
    plus the apps/lib POSIX layer as-is.
    Port edits: BreakException thrown from a check_break() poll (poll fd 0,
    timeout 0; any completed input line while a program runs is BREAK, and
    "BREAK IN <line>" returns to direct mode), a break-aware WAIT loop,
    cin.clear() + clearerr(stdin) at the INPUT Ctrl-D EOF path so input
    works again afterward, srand48(griffin_getticks()) seeding, a bad_alloc
    catch so an oversized DIM prints "Out of mem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
2026-08-01 Sync BASIC with upstream tokenize-at-entry redesign (~100x faster)
    Re-port of ../basic commit ffef663 onto apps/basic via 3-way merge (all
    Griffin port edits preserved; verified against the old port diff).
    Program lines are now tokenized once when entered or LOADed and cached
    as {source, TokenList} per line; execution, BuildDataList, and
    FindMatchingNext use the cached tokens by const reference. IsOneOf
    takes an initializer_list instead of building a std::set per call,
    flush_pending classifies numbers with strtol/strtod end pointers
    instead of stoi/stod exception control flow (two throw/unwind cycles
    per identifier token, the largest single cost), and a first-character
    keyword index replaces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
2026-08-13 Promote edma3 display-list DMA as the production ENGINE
    engine.v is now the descriptor-array display-list engine validated by the
    edma/edma2/edma3 fit experiments: 15-bit descriptor pointer into RAM's top
    64K, 4-word descriptors (wait-hblank, stop+IRQ, 22-bit source, 5-bit count,
    one-hot deposit strobes), bus released between descriptors, 2-cycle
    DTACK-less streaming. Fits the frozen Rev 1 pinout at 123/128 LC.
    The experiment sources and fit logs move to engine/super-engine-work/ as
    the design record (promotion done by Brad 2026-08-09).
2026-08-13 Add COMPOSITOR CPLD: VIDCMD instruction player (RUN/RUN_COLOR/SET)
    New ATF1508AS executing the VIDCMD stream: RUN spans (passthrough, held
    fg/bg, eight saturated RUN_COLOR literals), SET writing local held colors
    or forwarding 12-bit values to PIXEL over valid/target/commit. Hold-on-
    empty is the line-framing primitive: short fills replicate their last span
    to end of line, zero-fill lines cost nothing. Fits at 98/128 LC, 64 FF,
    free placement (no board yet).
    compositor_tb.v (iverilog, first RTL testbench in the repo) is the timing-
    semantics specification: 64 directed checks covering entry-edge SET commit,
    positional eagerness, overrun/merge/truncation behavior, and it measures
    the pipeli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
    [compositor.v, compositor_tb.v]
2026-08-13 Add PIXEL and TIMING CPLDs; the combined chip measurably does not fit
    pixel.v (ATF1508AS, 122/128 LC, 87 FF): VIDEO's successor. Unpacks the
    PIXELS FIFO byte stream - pure pixel bits, no in-band header - in 1bpp
    (40 words/line) or the new 2-bits-per-clock micro-HAM (80 words/line)
    through 12-bit SET registers (pal_fg/pal_bg/ham_held/mode/pixel_skip)
    into R4G4B4. Tile-last-word on underrun; two-stage SET path
    (capture-on-valid, apply-on-commit); raster arrives as PIX_CONSUME/
    PIX_PRELOAD/PIX_LAST strobes from TIMING.
    timing.v (ATF1504AS PLCC44, 31/64 LC): raster counters, syncs, /RS at
    vsync, the PIXEL event strobes, and the derived lead constants
    (DAC_LEAD = 4) that cancel every stage's p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
    [pixel.v, pixel_combined.v, timing.v]
2026-08-13 cpld: build the super-engine video path by default; retire VIDEO from all
    all: is now glue engine ports compositor pixel timing. make video still
    builds the Rev 1 in-band-header design for the Rev 1 board, but it cannot
    interoperate with the promoted display-list ENGINE, so it leaves the
    default set. New targets: compositor (+ compositor-sim, the iverilog
    testbench), pixel, and timing (ATF1504AS PLCC44). The three new chips
    have no boards, so they fit with free placement; their placements feed
    the Rev 2 layout.
2026-08-13 Add super-engine/: host-side validation suite for the display-list video path
    C++23, first host-test precedent in the repo (make check). descriptor.h
    holds the strawman encodings (descriptors, VIDCMD instructions, signal and
    SET numbering, geometry) with a fit-risk register; author.* builds M1-M5
    use-case display lists plus the tempest-web colored-span case into caller-
    provided spans (bare-metal-capable, meant to run on the 68010 eventually);
    interpret.* walks lists with engine.v's cycle costs; render.* models
    PIXEL/COMPOSITOR/AUDIO and rasterizes to PPM/WAV; main.cpp asserts budgets,
    FIFO occupancy, and pixel-exact semantics, and prints the per-case budget
    tables. set-timing.v is the cro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
2026-08-13 griffin.yml: interfaces section, super-engine constants; docs update
    griffin.yml gains: (1) an interfaces: section (schema key added) holding
    chip-to-chip contracts and support parts with their reasons, recorded at
    decision time - the VGA R4G4B4 output stage (mandatory 74AC541 buffers,
    E12 ladder DAC, layout constraints), the VIDCMD /RE NAND shaping option
    with its pending datasheet table, FIFO /RE//W source termination, and the
    TIMING lead-offset contract; capture ritual: read as a checklist before
    KiCad, diff the netlist distiller output after. (2) super-engine shared
    constants: signal mask bits, SET target numbering, FIFO depths, words/line
    per mode, and the derived pipeline lead constan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
2026-08-13 GLUE latches TIMING's VSYNC as the level-6 frame IRQ; audio FIFOs become 7200s
    VSYNC IRQ: with VIDEO retired, the frame interrupt source is TIMING —
    which has no CPU bus and so cannot host an interrupt acknowledge. GLUE
    therefore takes TIMING's VSYNC on its existing level-6 input pin (65, the
    rev-1 ~VIDEO_IRQ, renamed nVSYNC; net tee'd before the 74AC541 buffer),
    2-FF synchronizes it, edge-latches the assertion, and holds the IRQ until
    the ISR writes the new VSYNC_CLEAR register (0x17, W1C; VSYNC_STATUS reads
    the pending bit). A raw level would double-fire (the sync pulse is two
    lines, longer than the ISR) or be missed. Fits the frozen pinout:
    106/128 LC, 61 FF (+4: sync pair, edge reg,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
    [glue.v, griffin.generated.h, griffin.yml]
2026-08-13 COMPOSITOR: one VIDCMD word per pixel clock via the board NAND contract
    Replaces the registered nVIDCMD_RE with a falling-edge-registered want_pop
    driving the external 74AC00 gate (interfaces: entry). At this cadence Q
    advances every clock, so a 16-bit staged_word capture register is added and
    Q itself becomes a free second buffer slot (q_pending); the /EF guard moves
    from the pop to the capture, making a dry-FIFO restage impossible with zero
    cadence cost. TB: 70/70, back-to-back SETs on successive pixels, normative
    m0 pixel-exact at slot 1, 1-px spans render 1 px; H_ACTIVE must be stable
    across the whole cycle (new documented interface requirement). Fit: 99/128
    LC (+1), 81 FF (+17), 312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
    [compositor.v, compositor_tb.v]
2026-08-13 super-engine: sync to RTL truths; restructure for emulator inclusion
    TILE removed end-to-end (01 = reserved 1-slot no-op; m3 re-authored as
    RUN/RUN_COLOR spans, pixel-identical art). Fetch cadence 1 word/clock per
    the reworked compositor; record cost = duration exactly; measured pipeline
    constants from compositor_tb replace guesses. Micro-HAM pair ordering per
    pixel.v (both channels commit on the code's second pixel). Short-line/JIT
    hold framing is a first-class authoring mode (==640 cushion, <=640 + hblank
    delivery deadline JIT); m1-vscroll becomes the JIT case — 3 VIDCMD words
    per frame, exactly the firmware console's preamble. PIXEL tiles the last
    word on underrun. interpret/render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
    [author.cpp, author.h, descriptor.h, interpret.cpp, interpret.h, main.cpp, render.cpp, render.h]
2026-08-13 griffin.yml: display-list ENGINE registers; retire the VIDEO peripheral
    ENGINE now declares what engine.v implements: DESC (0x02, 16-bit write of
    the descriptor word address; write arms + clears IRQ) and CTRL (0x05 bit 0
    ENABLE; any write clears IRQ). SOURCE_PAGE/STATUS deleted — there is no
    read path. VIDEO keeps only its address range and DTACK (GLUE's frozen
    pinout still decodes the region) plus the video_timing raster spec TIMING
    implements; its registers and level-6 interrupt retire with the chip —
    VSYNC_IRQ_LEVEL constant replaces VIDEO_IRQ_LEVEL. 84-stride constants
    re-labeled as legacy image format only. New issue: PIXEL's SET value path
    at 1-word/clock cadence. Firmware and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
    [griffin.generated.h, griffin.yml]
2026-08-13 Emulator: display-list pipeline via the super-engine suite objects
    emulator.cpp includes the suite's EngineWalker/PixelUnit/CompositorUnit as
    the device models — one implementation shared with make check. RAM becomes
    word-backed so SuperEngine::Memory views it with no copy; DESC is a true
    16-bit write (the old fold-to-low-byte would have dropped 7 bits of the
    descriptor pointer); ENGINE/VIDEO reads are open bus. Per scanline the
    walker advances with a deposit sink routing PIXELS/VIDCMD/AUDIO; rendering
    uses the suite's blanking+active line drivers with x17 R4G4B4->ARGB.
    GLUE VSYNC_STATUS/VSYNC_CLEAR emulated; update_ipl gains the level-3
    ENGINE arm. Stall charged per descriptor from Wal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
    [emulator.cpp]
2026-08-13 Firmware: boot the display-list video pipeline (console + viewer)
    The console is a 996-descriptor list built once into a reserved window
    (0x3F8000 table / 0x3FF000 VIDCMD payload; the stack moved below it from
    0x400000): 3 VIDCMD words per frame ({SET pal_fg, SET pal_bg,
    RUN(passthrough,1)} + hold), 34 vblank-walk pacers, 480 x 2 PIXELS
    descriptors over a headerless 480x80 framebuffer (plain malloc - no 64K
    alignment, descriptors carry full addresses), trailing stop pacer. The
    vsync ISR acks GLUE_VSYNC_CLEAR and re-arms DESC (move.w of a word
    address); the mandatory ENGINE ISR acks CTRL with ENABLE=1. view_image
    reads the CF plane+palette files directly (the 84-byte stride only ever
    existe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
2026-08-13 COMPOSITOR->PIXEL SET values travel on a dedicated 12-bit registered bus
    The 1-word/clock fetch broke the old scheme (PIXEL tapped the FIFO's Q,
    which now advances every cycle). Two candidates were fully built, TB'd
    (88/88 each, end-to-end VALUE delivery checks), and fitted:
    strobe+stall: COMPOSITOR 120 LC/53 pins, PIXEL 122 LC unchanged, but
    PIXEL-target SETs become a permanent 2-slot special case
    value bus: COMPOSITOR 116 LC/63+3 pins (pin-closed, accepted — its
    interface is architecturally complete), PIXEL 109 LC/75 FF
    (down a whole fitter-ladder pass), uniform 1-slot records
    The bus won: smaller on both chips, no slot-arithmetic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
    [compositor.v, compositor_tb.v, griffin.yml, pixel.v]
2026-08-13 pixel_skip: declare the scrolled-line tail; clamp odd skip in HAM mode
    Decision 1 (declared feature limit): with nonzero skip the line's final
    partial byte is deliberately never fetched (an unconsumed byte would slide
    into the next line and compound), so the last 1..7 pixels of a fine-
    scrolled line re-shift the previous byte's pattern. That is the feature's
    contract — borders and overlay spans hide it; the correct-right-edge
    alternative (per-line fetched-byte counter + a padded PIXELS record, ~8 FF)
    remains affordable at PIXEL's current utilization if ever wanted.
    Decision 2 (hardware clamp): micro-HAM consumes exactly two stream bits per
    pixel clock, so an odd alignment mis-parses ever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
    [griffin.yml, pixel.v, render.cpp]
2026-08-13 view: wait for a decoded key-down, not a raw PS/2 byte
    Typed interactively, the Enter that launches 'view' lands its RELEASE code
    (F0 xx) tens of milliseconds after the wait begins; waiting on the raw
    scancode queue (ps2_received_ready) treated that break code as a keypress,
    so the image flashed for one frame and the console repainted — the exact
    symptom reported. Headless testing never caught it because console-stdio
    input produces no PS/2 traffic at all.
    The wait now sits above the make/break decoder (keyboard_ready), where
    releases are invisible, ORed with the raw DUART ready so a serial-only
    session can dismiss the image too; both queues are drained first so stale
    type-ahead cannot e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
2026-08-14 GLUE: gate the level-6 vsync IRQ behind CONFIG bit VSYNC_IRQ_EN
    The vsync_pending latch, VSYNC_STATUS readback and VSYNC_CLEAR W1C stay
    live with the bit clear (the reset state), so the CPU can poll vblank
    with no ISR -- the enabling mechanism for app direct-video access.
    Firmware opts in right after arming the console list; the emulator
    models the bit in update_ipl. Refit: 111/128 LC (was 106), named pins
    unchanged.
    [emulator.cpp, glue.v, griffin.generated.h, griffin.yml, rom.cpp]
2026-08-14 Syscalls: apps take and return the video ENGINE (direct access)
    SYS_VIDEO_DIRECT_START masks the vsync IRQ, gates the ISR re-arm, and
    hands the app the upper 32 KB of the descriptor page (griffin_abi.h
    carve constants + ownership contract). SYS_VIDEO_DIRECT_END restores
    vector 30, rebuilds the console list, and re-enables the IRQ; the
    loader reclaims automatically if an app exits still holding it. The
    display-list window grows to 40 KB (stack tops at 0x3F6000) so the
    console list + payload tile exactly up to the carve and survive an app
    owning it. Polling VSYNC_STATUS is the supported pacing model.
2026-08-14 apps/lib: direct-video and input helpers, the libgriffin seed
    griffin_video: direct start/end trap stubs plus the poll-mode vblank
    micro-API (wait = wait+ack, pending, ack), with the pacing contract
    documented. griffin_input: griffin_input_read() samples joysticks and
    paddle counts then runs the dump pulse -- a plain function, not a
    syscall, because it belongs to whoever owns vsync. The TRAP #15
    sequence moves to griffin_syscall.h so a second translation unit
    cannot diverge from the ABI. lib.mk is the opt-in build fragment for
    apps that link these objects.
2026-08-14 Emulator: audio reaches the host (--wav-out, SDL playback, key-joystick)
    An AudioOutput sink samples the DAC registers on every pop tick:
    --wav-out streams U8 stereo 15734 Hz WAV for headless verification, and
    a windowed run also plays through an SDL3 audio stream (never blocking;
    drops with one note if the host queue falls behind). --keys-to-joystick
    maps arrows/space/ctrl to joystick port 1 instead of PS/2 for playing
    without a gamepad. Verified guest-neutral: screenshots and console
    byte-identical to the pre-change binary.
2026-08-14 image-tools: micro-HAM encoder, sprite span tool, Smurf scene assets
    The encoder mirrors the suite's PixelUnit exactly (chroma codes
    saturate two channels to 0x0/0xF -- per-line pal_fg/pal_bg carry the
    image quality) and runs an exact shortest-path DP per line over the
    <=34 reachable held colors, with k-means palette candidates. The
    round-trip harness decodes every asset through the real suite objects:
    suite==own EXACT, 307200/307200 pixels, for all three backdrops plus a
    synthetic gradient. sprite2spans emits solid-span C arrays with a
    6-span/row delivery budget check; all shipped frames fit (worst row 5).
    .ham/.pal files are big-endian 68000 memory images, DMA-able verbatim.
    Co-Authored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
    [make_smurf_assets.cpp, microham.h, microham_encode.cpp, microham_roundtrip.cpp, sprite2spans.cpp, sprite_header_test.cpp]
2026-08-14 crt0: glue_config_{set,clear}_bits read the mask from the stack
    They read %d0, but their callers are C (extern void f(uint8_t)) and
    push the argument -- no caller ever loaded %d0, so GLUE CONFIG got
    stale return values. Boot worked by coincidence (printf's character
    count has bit 2 set, so VSYNC_IRQ_EN came up anyway -- with FLASH_WE_EN
    along for the ride); SYS_VIDEO_DIRECT_END's re-enable drew a different
    stale %d0 and the console never returned after direct video. Found by
    apps/dtest bring-up. The mask now comes from 13(%sp) with %d0
    preserved, and the convention is documented at the routines.
2026-08-14 apps/dtest: direct-video bring-up app (all-VIDCMD, input, restore)
    Proves the whole surface in one loop: START hands over the carve, the
    app double-buffers two 515-descriptor tables (34 pacers + 480 lines +
    stop), paces by polling the vsync latch, moves a RUN_COLOR square with
    the joystick and scales a bar with paddle A, and FIRE exits through
    END with the console text intact; 'dtest noend' exercises the loader
    reclaim path. Authoring discipline learned here and documented in the
    source: pre-encode invariant descriptors and author in bands -- a
    generic per-line emit cost 30 ms/frame and tore the display; banded
    authoring runs at exactly one frame per iteration.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
2026-08-14 crt0: load %sp from _stack_top, not the top of RAM
    The post-RAM-test reload put the supervisor stack back at 0x400000 --
    a leftover from before the display-list window existed -- so the stack
    lived inside the descriptor window (and the app carve) for the
    firmware's whole life. Nothing collided until smurf's 15.7 KB table
    reached the top of the carve and descriptors and stack frames
    overwrote each other. Found by apps/smurf bring-up.
2026-08-14 apps/smurf: Smurf Rescue on the display-list pipeline
    Micro-HAM flip-screen game, poll-mode direct video: 1964 descriptors
    per frame (34 pacers + 480 x {VIDCMD packet + 3 PIXELS bursts} + 9
    audio bursts + stop), two 15712-byte tables double-buffered in the
    carve. Static skeleton per scene; per-frame edits touch only the
    sprite-band packets (precompiled sprite rows) and the audio blocks
    (constant-block square/noise synth around 0x80). The VIDCMD packet
    cap of 24 words is derived from HBLANK delivery, asserted, and never
    hit (widest real row 9). Gameplay: title, 3 screens (fence to jump,
    bat to duck, Smurfette to rescue), lives, jingles; deterministic,
    frame-count driven. Steady state one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
2026-08-15 view: display micro-HAM .ham/.pal pairs, detected by file size
    76800 bytes = micro-HAM plane (with a 1920-byte R4G4B4 per-line
    palette), 38400 = the legacy 1bpp plane (960-byte R3G3B2 palette);
    anything else gets a message naming both. The HAM viewer list adds a
    1-word eager preamble ({SET pix_mode, MICRO_HAM} re-delivered every
    frame across /RS) and 32/32/16-word PIXELS bursts per line; palettes
    go out verbatim -- big-endian RGB444 on disk, big-endian CPU. Sizes
    come from f_stat (the newlib SEEK_END glue is off by one). Verified
    pixel-identical to the encoder's decoded preview (0/307200 differ)
    and byte-identical to HEAD firmware on the legacy path. rom.bin is
    now 128568 bytes -- 98.1%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
2026-08-15 microham_encode: dithering (ordered default, --dither fs for photos)
    The per-pixel objective preferred flat fills, so gradients banded.
    Ordered mode perturbs the target ALONG THE PALETTE AXIS (t*(F-B) from
    a 16x16 void-and-cluster blue-noise mask) so the DP's nearest-palette
    test fires proportionally to the pixel's position between the pair --
    the banding is the fg/bg gap, not the RGB444 step, and an isotropic
    perturbation measurably barely helped. Supporting pieces, each
    measured: an edge gate (activity > 64 fades the dither; speckle on
    posts/trunks otherwise), a 6-step axis cap, and low-frequency finalist
    scoring (per-DP costs are incomparable across perturbed targets).
    Serpentine FS mode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
    [microham.h, microham_encode.cpp, microham_roundtrip.cpp]
2026-08-24 rev 2 pre-schematic electrical review; barrel-jack power, DS1233-5 reset
    Comprehensive signaling/level/current review before schematic capture
    (rev2-electrical-review.md): no CPU-bus transceivers (rev-1 load counts,
    2026-08 datasheet checks), pull-up schedule incl. AS/UDS/LDS/R-W on DMA
    handover and IPL2:0, CF/PS2/joystick notes, audio output-stage divider,
    power budget 1.3-1.7A typ, procurement list.
    griffin.md: power input standardized on a 5.5x2.1mm center-positive
    barrel jack (5V regulated >=2.5A, silkscreened contract; replaces the
    rev-1 USB-C whose plain-Rd sink is only entitled to 500mA); reset
    supervisor is DS1233-5 (pushbutton detect, trip 4.50-4.75V, rail >=4.85V
    bring-up gate); c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
2026-08-24 griffin.yml: power/reset interface entry, pinned VIDCMD read-port table
    interfaces: new power-entry + DS1233-5 reset supervision record (barrel
    jack, wire-OR contract, no RC on the net, bring-up gate); VIDCMD FIFO
    read port RESOLVED 2026-08-18 -- registered /RE at 2 pixel clocks per
    word, 74AC00 shaping gate rejected on the pinned IDT7200L15/ATF1508AS-10
    worst-case table (structural, not marginal); /EF entry verified at the
    adopted cadence (+7.7 ns); 74HCT155 replaces the plain-TTL 74155.
    issues: cadence work recorded through the 2026-08-19 compositor rework
    and suite propagation (remaining: none -- closed in that entry); AUDIO
    FIFO /RS source gap found 2026-08-21 (7200 requires a power-up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
    [griffin.yml]
2026-08-24 super-engine + vidcmd-spec: 2-clock VIDCMD cadence propagation
    render.cpp models the RTL fetch engine equation-for-equation (RE level,
    ef_at_pop, park-on-Q; pre-edge sample -> consume -> capture/park ->
    fall/rise); the cadence-aware prefetch invariant returns as a
    vidcmd_plan_line() fetch simulation that sizes CUSHION fillers from
    executed occupancy; per-case cadence-vs-starved hold reporting.
    VIDCMD_SLOTS_PER_WORD 2, pair-gap and bank-depth constants. Suite all
    PASS; one visible-pixel change (m3-cursor 84->98, HOLD widens 1-px
    outline segments); m0/m2-split pixel-identical; tempest budgets
    unchanged (spread pitch was already 9 px; cadence floor measured at
    4-px pitch for 1-px spans).
    vidc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
2026-08-24 compositor: registered-/RE 2-clock fetch, 16-px MASK record, color0/1 rename
    Fetch engine reworked to the pinned electrical verdict: registered /RE
    driving the 7200 pair directly, two pixel clocks per word, park-on-Q
    banking (staged_word + Q held valid under /RE low), zero negedge
    registers. Banked-pair law: two banked records execute on consecutive
    slots. 102-check testbench is the timing spec.
    MASK record (01 prefix, replaces the reserved no-op): {01, 7 dibits} +
    {8 dibits}, pixel 0 implicit opaque color0 -- 16 px of per-pixel
    passthrough/color0/color1 in 2 words. Playback shifts staged_word in
    place with a mid-record reload off parked Q at px7; adjacent masks chain
    GAPLESS (the earlie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
    [compositor.v, compositor_tb.v]
2026-08-25 super-engine + spec: MASK propagation, two pure-VIDCMD screens, COLOR0/1 constants
    render.cpp models the 16-px MASK record at slot granularity mirroring
    compositor.v: implicit opaque-color0 px0, mid-record reload off parked Q
    (HOLD stretch on starvation), gapless mask->mask and RUN->mask chaining;
    descriptor.h gains encoders (planar select+opacity in, interleaved
    dibits out) and aliases SET_CMP_COLOR1/COLOR0, RUN_SRC_COLOR1/COLOR0;
    vidcmd_plan_line() accounts mask words/slots and SET seams.
    Measured/derived seams pinned by the suite: mask->SET->mask 2 slots,
    mask->SET,SET->mask 4 (the mask holds the bank, pairs cannot bank),
    RUN->SET,SET->mask 3.
    New cases: m6-console (80x60 text, display-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
2026-08-25 pixel: 2bpp indexed mode, half-rate flag, bit_pos capture-clock fix, testbench
    New modes on the existing mode register: mode[1] = 2bpp indexed (stream
    dibits index pal_bg/pal_fg/ham_held/black directly -- 4 colors, zero new
    palette registers, odd pixel_skip clamped as in micro-HAM; requires SET
    mode before SET ham_held, documented) and mode[2] = half rate (each
    group held 2 clocks -> 320-wide; 1bpp 20 words/line, 2bpp 40; masked
    off in HAM in hardware). Fit ladder: 116 baseline -> 108 with the fix
    -> 112 +2bpp -> 116/128 with both; no strategy flags needed.
    Fixes a pre-existing bit_pos bug: it sat in the byte engine priority
    chain where fifo_loading preempted the consumption increment, sli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
    [pixel.v, pixel_tb.v]
2026-08-26 pixel: fix the PIX_LAST tail in two-bit full-rate modes
    The 8-clock PIX_LAST fetch-suppression window is one byte in 1bpp but
    two in a 2-bit full-rate mode, so it swallowed the line's own final
    byte: pixels 636-639 of every full-rate micro-HAM/2bpp line re-shifted
    an emptied register. Worse than documented: the line then read 159 of
    its 160 bytes, leaving one byte in the ODD FIFO and desyncing the
    byte-interleaved halves for every subsequent line of the frame.
    Fix is one flip-flop of fetch-machinery phase (late_fetch_done): in
    two-bit full rate, PIX_LAST contains exactly two fetch_due events at
    any skip phase; the first is allowed, the second refused -- equivalent
    to shifting the window 4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
    [pixel.v, pixel_tb.v]
2026-08-26 cpld: freeze COMPOSITOR/PIXEL/TIMING pinouts from feature-complete fits
    //PIN: blocks appended (FROZEN 2026-08-26), harvested from -preassign
    ignore fits of the committed feature-complete bitfiles and re-verified
    IDENTICAL under -preassign keep; Makefile targets flipped to keep with
    the production strategy flags (JTAG = on, TDI/TMS pullups, power_reset)
    added first so the frozen placement is the production configuration --
    compositor/pixel/timing previously fit debug-only, without JTAG.
    Freeze fits: COMPOSITOR 122/128 LC 64/64 I/O (repacked from 121 under
    keep), PIXEL 105/128 46/64, TIMING 31/64 11/32 (ATF1504 PLCC44).
    pixel.v gains a one-wire correctness fix found BY the freeze: the RTL
    n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
    [compositor.v, pixel.v, timing.v]
2026-08-27 super-engine + spec: propagate PIXEL 2bpp-indexed and half-rate modes
    PixelUnit now mirrors pixel.v's bitwise mode register (mode[0] HAM,
    mode[1] indexed, mode[2] half rate; 11 reserved, HAM wins; half rate
    hardware-masked in HAM): indexed rendering with the ham_held stream
    lockout (SET mode before SET ham_held is now an observable, failing
    check, not a comment -- held_init modeled per-clock via a new
    PixelUnit::blank_clock), odd-skip clamp in both 2-bit modes, half-rate
    group holding with halved stream consumption. descriptor.h constants
    become the bitwise contract with derived words-per-line and
    static_asserts pinning 40/80/80/20/40; fixes a latent over-provision
    (words-per-line used the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
    [author.cpp, author.h, descriptor.h, main.cpp, render.cpp, render.h]
2026-08-27 docs: video-chain discipline in CLAUDE.md, TIMING contracts, datasheet in-repo
    CLAUDE.md gains the video-chain discipline section: the five-layer
    propagation lockstep (RTL / chip tb / shared model / suite / emulator),
    testbench rules (hand-derived expectations, halt on disagreement,
    mutation controls; TIMING's missing tb named as the known gap), frozen-
    pinout rules incl. production strategy flags, fit-ladder ritual, and
    the datasheet's role. griffin.yml gains a consolidated TIMING output
    contracts interfaces entry (nRS shape + FIFO strobe-quiet, H_ACTIVE
    lead, PIX_* strobe shapes, SPLIT_DAC_LEAD derivation, HSYNC/VSYNC tap
    consumers, frozen-pinout/spare-routing rule) to be read before any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
    [griffin.yml]
2026-08-27 timing: board time bases, HBLANK/nVSYNC_IRQ fan-out, timing_tb; PORTS ticks from TIMING
    TIMING becomes the single time base. Four outputs appended to the frozen
    //PIN block (original nine unmoved, fit 35/64 LC with power_reset on):
    PADDLE_TICK 17, AUDIO_TICK 18 -> PORTS 44/45: square waves toggling every
    line; PORTS counts FALLING edges -> 15.734 kHz events (paddles now at the
    2600 scanline rate, full scale 16.2 ms; audio pop unchanged).
    HBLANK 19 -> ENGINE pin 2: h_cnt >= 640 on every line, rising where
    PIX_CONSUME falls (the blank descriptor.h budgets; resolves the unpinned
    Rev-2 source of ENGINE's HBLANK).
    nVSYNC_IRQ 31 -> GLUE pin 65: VGA_VSYNC's waveform, polarity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
    [descriptor.h, emulator.cpp, engine.v, griffin.generated.h, griffin.yml, ports.v, timing.v]
2026-09-01 pre-capture net decisions: ENGINE strobes/status, CF sideband, reset topology, GLUE halt blink
    - ENGINE: nSIGNAL[6:0] -> nPIXELS/nVIDCMD/nAUDIO_FIFO_W + nSIGNAL_SPARE
    (pins 10/8/6/9); 40/41/46/81 released; nDTACK_BUS deleted; registered
    ENGINE_ACTIVE/ENGINE_WAITING status wires (80/4) to GLUE
    - GLUE: ENGINE_STATUS (0x19) and CF_PINS (0x1B) readback; CF INTRQ level-1
    IRQ gated by CONFIG.CF_IRQ_EN; IORDY-qualified CF DTACK; nHALT sourced
    from nSUPERVISOR_RESET (pin 63, DS1233 side of new reset diode);
    DEBUG_OUT halt-blink (vsync/32) while CPU halted; DEBUG_IN and
    nDUART_RESET removed (pins 64/24 = bodge spares, DUART RESET direct on
    ~RESET net)
    - griffin.yml: new registers/bits,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
    [descriptor.h, emulator.cpp, engine.v, glue.v, griffin.generated.h, griffin.yml, interpret.h]
2026-09-01 audio output stage + final pre-capture cleanup
    - Audio samples become two's complement (0x00 = silence): CD4049 inverts
    each FIFO Q7 into the unsigned R2R; emulator models it (^0x80), smurf
    mixes signed +-120
    - Audio output stage designed (closes last pre-capture issue): R2R ->
    10k divider (ladder Zout = top half) -> 3.3nF ~9.7kHz pole -> LM358
    unity -> 4.7k class-A pull-down -> 100uF/1k/100R -> jack; buzzer on L
    - No transceivers on D[15:0] re-affirmed and recorded in interfaces
    - griffin.md stale items fixed (q8_toggle, VGA analog done, GLUE spares,
    inter-CPLD signals decided); checklist audio section expanded
    - griffin.log: free-pin fitter experiment (pinout costs no capacity),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
    [emulator.cpp, griffin.yml]
2026-09-01 audio: volume pot + LM386 internal speaker; track griffin.log and checklist
    - Dual-gang 10kA pot replaces the 1k DC return (wiper -> 100R -> jack)
    - LM386 + 8-ohm internal speaker fed from the jack's NC switch contacts
    (2x10k sum, 47k bias, Zobel, 250uF); plug insertion mutes; rev-1
    buzzer retired
    - griffin.log and schematic-checklist.md added to version control
    (previously untracked: all decision ladders and the capture checklist)
    Claude-Session: https://claude.ai/code/session_014EsB1SCaHcG8LW2LVfQm2J
    [griffin.yml]
2026-09-02 update parts I've added
    [board.kicad_sch, composite.kicad_sch, cpu.kicad_sch, power-clock.kicad_sch]
2026-09-05 save current PIN mapping
2026-09-05 replace some pin numbers with names
2026-09-08 capture ENGINE in schematic; fix couple of shorts
    [board.kicad_sch, compact-flash.kicad_sch, composite.kicad_sch, cpu.kicad_sch, debug-led.kicad_sch, expansion.kicad_sch, glue.kicad_sch, io.kicad_sch]
2026-09-08 capture TIMING; add PLCC44 ATF1504; a few fixes
    [board.kicad_sch, composite.kicad_sch, glue.kicad_sch]
2026-09-08 fix placement of IO sub-schematic
    [io.kicad_sch]
2026-09-12 checkpoint CPLDs
    [board.kicad_sch, glue.kicad_sch, test-points.kicad_sch]
2026-09-12 add PIXELS FIFOs and placement scripts
    Claude-Session: https://claude.ai/code/session_01NsFH8WNb3Tja14xUfwuyqj
    [compositor.kicad_sch, pixel.kicad_sch, ports.kicad_sch]
2026-09-12 add VIDCMD FIFOs; FIFO strobe termination becomes a 0R-stuffed footprint
    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
    [compositor.kicad_sch, pixel.kicad_sch]
2026-09-12 rename AUDIO sheet to AUDIO_DAC (debug-led.kicad_sch -> audio-dac.kicad_sch)
    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
    [audio-dac.kicad_sch, board.kicad_sch]
2026-09-12 add AUDIO_FIFO sheet; fix PORTS ~AUDIO_FIFO_EF onto pin 48
    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
    [audio-fifo.kicad_sch, board.kicad_sch, ports.kicad_sch]
2026-09-13 add DEBUG_HEADER sheet (2x16 LogicAnalyzer V2 pinout); re-annotate AUDIO_FIFO
    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
    [audio-fifo.kicad_sch, board.kicad_sch, debug-header.kicad_sch]
2026-09-13 add debug header
    [audio-dac.kicad_sch, audio-fifo.kicad_sch, board.kicad_sch, debug-header.kicad_sch]
2026-09-13 CF card: True IDE pin names, 16-bit data, INTRQ/IORDY to GLUE
    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
2026-09-15 apps: includable app.mk so applications can build from outside the tree
    apps/app.mk carries the toolchain, flags, codegen and link rules; an app
    Makefile sets GRIFFIN, APP and APP_OBJECTS and includes it. The
    m68k-* wrappers accept GRIFFIN_MOUNT_ROOT so a sibling repository's app
    directory is inside the container mount; lib.mk takes GRIFFIN for its
    one path to the repo root. hello is converted as the example.
    griffin.log: audio mixer-vs-FIFO idea.
    Claude-Session: https://claude.ai/code/session_01YAgAwTbzeLZcQ6pnwiH78W
2026-09-20 emulator: charge the per-line video DMA stall again
    service_video() had discarded check_timer()'s return value since 76c8a9b,
    so only the arm-time preamble was charged and video DMA was free to the
    guest CPU. Restore the charge, and replace the fixed-rate pay-down (whose
    default clamped any load above ~34% of a line) with a proportional one that
    retires a line's charge by the line's last cycle and carries any excess
    over. GRIFFIN_DMA_STALL_STEP remains as an A/B knob for the old behaviour.
    Environment knobs documented in emulator/CLAUDE.md.
    Verified against the analytic cost model with apps/dmabench (not part of
    this commit): 1bpp console 76.1% CPU left (analytic 76.2%), pure-VIDCMD
    MASK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
2026-09-20 pixel: palette write pulse one clock earlier; full-clock data setup and hold
    /CLUT_WE used to rise on the edge set_pix_value changed, so the RAM's data
    hold was met only by inter-chip skew. IDX = clut_index now on clocks 1..3
    after the clut_data commit, /CLUT_WE low on clock 2 alone, inside the four
    clocks the {clut_data, same-value SET 7 filler} pair holds the bus.
    clut_pair_tb.v makes zero-hold a hard failure and the old sequence is kept
    as a whole-chip mutant that trips it. Disturbed window is now clocks 1..4.
    Costs +7 LC / +13 PT and the previous harvested pinout no longer routes;
    re-harvested: 123/128 LC, 94 FF, 384 PT, 43 I/O, pass 1. Pin block still
    PROPOSED, not frozen. Spec dra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
2026-09-20 video: indexed PIXEL through spec, griffin.yml, shared model, suite, emulator, firmware console (package 2)
    vidcmd-spec.md and griffin.yml now describe the index-only PIXEL (TIMING
    folded in, ganged 16-bit PIXELS read, four depths + half rate, attribute
    word, skip law with caps and record+1, palette RAM with the measured
    three-word entry and disturbed window 1..4). Micro-HAM is retired.
    super-engine: PixelUnit is a clocked state machine register-for-register
    with pixel.v and reads the FIFO on the chip's clocks; words per line and the
    108-cell mode x skip matrix match pixel_tb.v; new PaletteUnit (seeded-random
    power-up, measured write sequence, bad-filler and disturbed-pixel flags)
    matches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
2026-09-20 proposal: note the video-window use case
    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
2026-09-20 proposal: alternative B, direct-load zero-slot literal for 640-res patches
    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
2026-09-20 pixel: drop the DUART OP4..OP7 pin reservation; datasheet authoring rules; griffin.log
    The proposed PIXEL pin block used 56/57, which the header still reserved for
    DUART OP6/OP7. The reservation is removed: OP4..OP7 float until a raster
    selector is designed (pixel.v, timing.v comments, griffin.yml).
    Datasheet page: "Programming Notes" becomes "Authoring Rules and
    Limitations" and gains PN7..PN12 - the first PIXELS word and the mode/base/
    skip SETs are due 16 clocks before the line, the palette-entry rule, palette
    never reset, skip limits, 4bpp half rate only, and the line/CPU budget.
    griffin.log: the 2026-09-15..20 entries from the Smurf port and the indexed
    PIXEL work (DMA stall bug, fit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
2026-09-21 proposal: audio Form 2, SAMPLES + AUDCMD + a MIXER chip with voices in SRAM
    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
2026-09-22 emulator: profiler reports SYSCLK per bucket and covers the ROM
    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
2026-09-27 audio: MIXER host model and A/B, fit ladder record, plan and datasheet
    The Form 2.3 audio work of 2026-09-26 as it stood at the end of the CPLD
    phase: the shared host model (mixer/mixer.{h,cpp}), the PSG-bytes-to-SETs
    driver, the A/B tool that renders the recorded Smurf PSG stream through
    both the SN76489 reference and the model (pitch worst 1.82 cents, ladder
    within 0.46 LSB, invariants hold every tick, listening test passed), the
    plan with the pinned v0 semantics and their amendments, the audio
    datasheet page, and griffin.log entries for fit rung (i), the datasheet
    timing check (4-clock SRAM writes, MCM60L64P10) and fit rung (ii), where
    the whole PSG-subset chip fits an ATF1508 at exactly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
2026-09-27 audio: retire the CPLD MIXER, adopt a Z80 sound processor; protocol and parts in griffin.yml
    The whole PSG subset fitted one ATF1508 at exactly 128/128 with no LFSR
    and no headroom (griffin.log, rung (ii)), which Brad judged a
    substantial limitation for the porting goal. The sound section becomes
    a Z80B at 6 MHz with a 27C128 and one 6264, reading the rev-1 audio
    FIFO pair as one ganged 16-bit record stream on ENGINE's existing
    AUDIO_FIFO_W strobe, and writing two 74HC574 DAC latches in offset
    binary (the CD4049 inverters go). Every deposit is a record: SET,
    WAIT, inline PCM SAMPLES into an SRAM ring, VOICE table descriptors,
    LOAD/JUMP program uploads, RESET. No status path back to the 68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
2026-09-27 sound: Z80 feasibility test (z80emu harness, ROM tick in assembly, measured T budget)
    Hand-written Z80 ROM (sound/rom/rom.s) implementing the record stream
    and the tick law of mixer/mixer.h, run on the leathervision z80emu core
    in a flat-memory harness that replays the recorded Smurf PSG stream in
    lockstep with the C++ model. Every oracle passes with zero mismatches:
    NOP cadence, 10,000 synthetic ticks, the whole 1,285,764-tick Smurf
    trace with and without PCM, and every record type including LOAD/JUMP
    uploads and the three-overrun fallback. Measured cost: worst 1263 T per
    tick for Smurf's four voices against 381 T at 6 MHz and 508 at 8 MHz,
    about 138 T per square voice plus 226-347 T of f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
2026-09-27 sound: Z80 ROM v2, templated tick with SET patching; bit-exact, 816 T, gate fails again
    rom2.s and harness2.cpp implement the second form: a minimal NMI through
    a patched vector, the tick assembled from ROM templates into RAM at
    CONFIGURE time (voice count, mode, side, mono and PCM baked, no per-voice
    dispatch), SET patching INC, |AMP|, the sign opcode and the wavetable
    page into the live code, PCM popped straight from a restored SAMPLES
    FIFO pair, a 74HC244 status port in place of the 0xFF sentinel, and a
    DUMP record. The tick clock pauses on the hold stub during a rebuild
    and the harness pauses the model with it. Every oracle is bit-exact
    against mixer.h: 10,000 synthetic stereo ticks, t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
2026-09-28 audio: Paula-form AUDIO chip fits at 120/128; host model, scheduler, PSG channel driver, Smurf A/B
    cpld/audio/audio.v: four byte-wide sample FIFOs popped by 8-bit period
    counters at CLK/16, a fifth control FIFO for {register, value} records, and
    a binary-rate-multiplier volume gate per channel driving CD4066 switches
    into the analog summing nodes. Fit ladder in griffin.log (9-bit periods do
    not fit).
    audio/: the chip model as the executable spec, the 68000-side scheduler with
    its closed-form mirror of the pop law, the SN76489 channel driver (square
    tables per tone, LFSR sequence tables for noise), exact tests T1..T6, and
    the Smurf A/B: 0 underruns, mirror exact, ENGINE 1 % of the frame, sp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
2026-09-28 audio: RTL testbench against the model's vectors, with negative controls
    cpld/audio/audio_tb.v deposits the model's random stimulus into behavioural
    7200s and checks the pop schedule, the registers at every line end and the
    gate law on every clock; audio/tb_vectors.cpp writes the vectors. PASS on
    the first run; MUTATE 1..5 fail as required. The recipe greps the printed
    verdict because vvp exits 0 on $finish(1) in this oss-cad-suite.
    Claude-Session: https://claude.ai/code/session_018b9MKbrZWRZ9772rdAha3P
2026-09-28 audio: griffin.yml and griffin.md for the AUDIO chip; datasheet rewritten
    The AUDIO peripheral, its constants and interfaces entries describe the
    four-channel chip: the deposited word carries the FIFO destination in
    D[10:8] through a 74HC138 on the AUDIO strobe (ENGINE unchanged), the
    analog stage is 74HC4066 gates into 2.5 V-biased inverting summers, and
    AUDIO_TICK goes to a test pad. The Z80 record constants leave the YAML
    and live in sound/audio_records.h as the retired experiment's record.
    All consumers rebuild. griffin-audio-datasheet.html rewritten for the
    Paula form (artifact version 6).
    Claude-Session: https://claude.ai/code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
2026-09-28 audio datasheet: Paula form only; rev-1 and Z80 material removed (artifact v7)
    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
2026-09-28 ENGINE destination code with seven strobes; AUDIO raster-locked from HBLANK; two's complement samples
    ENGINE: descriptor word 0 bits 2:0 are a destination code decoded on chip
    (PIXELS, VIDCMD, AUDCTL, SAMPLES0..3), SPARE gone; pins freed for the
    fitter and re-frozen; 120/128, 64/64 pins. descriptor.h and every
    consumer migrate from SIGNAL_* masks to DEST_* codes; the super-engine
    suite passes.
    AUDIO: the by-16 divider is re-phased from PIXEL's HBLANK each line so
    steps sit at h_cnt 0 mod 16 (a per-step pulse on a pin failed grouping or
    cost six cells; PIXEL is unchanged); 121/128. The bench adds a skewed-
    reset run and a sixth negative control. Samples are two's complement
    again, one 74H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
2026-09-28 emulator: AUDIO chip model behind --audio-chip, and --selftest-audio
    The rev-2 chip's model (audio/audio_chip.cpp) is compiled in unchanged and
    fed by ENGINE destination codes 3..7, stepped 50 times per scanline; the
    WAV and SDL sinks hear its analog model. Drops are reported and a
    per-channel summary ends each run. --selftest-audio drives it through the
    real ENGINE walker with audio/scheduler.cpp building each frame's list:
    300 frames, no drops, no dry channels, mirror within 1, pitches as derived.
    The default stays rev 1 until package B.
    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
2026-09-28 Audio package B: retire the rev-1 audio path; bare-metal 68000 PSG driver
    Emulator always models the AUDIO chip (--audio-chip and the PORTS stereo
    pair removed). The super-engine suite's audio case streams two channels
    through the chip model. descriptor.h drops DEST_AUDIO_PAIR_REV1; firmware
    drops its audio init; griffin.yml drops PORTS AUDIO_CONTROL/AUDIO_STATUS.
    PORTS loses the pop logic and four pins (106/128). PIXEL keeps AUDIO_TICK
    to a test pad because removing it measured 3 LC worse.
    audio/psg_channels is bare metal: choices are lookups in psg_tables.h,
    generated on the host and checked by make tables-check; squares share one
    512-byte buffer; the scheduler repeats bytes for slow n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
2026-09-28 apps/smurf: play the soundtrack on AUDIO channels 0 and 2
    The mono buffers feed both channels (two descriptors per burst). Each
    frame's vblank preamble carries the control records and prime slots that
    fill the FIFOs on the first frame after startup or a rebuild, because the
    chip cannot pause while a separate prime list waits for vsync. 0 drops and
    0 dry events at 60 frames/s; dry events during play equal the demo's own
    late frames.
    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
2026-09-29 audio: FrameScheduler, a per-region table-and-carry driver (Tier 1)
    Pops per region from a table indexed by PERIOD (q, rem packed) with a
    per-channel remainder carried as PERIOD - COUNT; a PERIOD write reseeds by
    the difference. Deposits by reference into static rings. T9: the table
    exact against line_pops summed over the region on 917,504 cases; T8: chip
    output identical to the per-line Scheduler over the full PSG sweep and no
    underrun or drop on the Smurf trace. Scheduler, chip model and PsgChannels
    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
2026-09-29 AUDIO: offset-binary samples, left channels on D[15:8]
    Samples are offset binary (AUDIO_SILENCE 0x80, as 8-bit WAV): the 74HC04
    MSB inverter and its pull resistor go away; a bare ladder on a high-Z Q
    is harmless because the channel's switch is open while the FIFO is empty.
    Byte lanes are fixed by the FIFOs' data pins: channels 0 and 1 (left)
    read D[15:8], channels 2 and 3 (right) and the control FIFO read D[7:0].
    An 8-bit stereo WAV data chunk (L,R,L,R) therefore streams to a left and
    a right channel as two descriptors over the same words; a mono table
    carries its sample in both bytes (free: the other byte was discarded).
    D[7:0] drops from nine 7200 loads to seven, D[15:8] rises to six.
    de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
2026-10-03 apps/mandelbrot: Mandelbrot explorer; mouse, vsync IRQ and raw-console syscalls; whole-frame MASK cursor
    A 320x240 16-colour Mandelbrot explorer in Q4.28 fixed point driven by the
    PS/2 mouse: left click zooms in about the cursor, right click zooms out;
    a toggles palette animation, p steps through four palettes, q quits.
    Syscalls (griffin.yml): MOUSE_READ 15, VIDEO_VSYNC_IRQ 16, CONSOLE_RAW 17.
    GriffinMouseReport in griffin_abi.h is also the firmware's mouse_report_t.
    griffin_abi.h states the two display-list pacing models: a compute-bound
    app must arm ENGINE from its own level-6 handler because the vblank pacers
    count from the arm. The loader restores line editing after any app.
    Cursor: a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
2026-10-03 cpld/experiments/literal: LITERAL/HOLD fit ladder on COMPOSITOR
    Forms A and B do not fit the frozen pinout: block E (8 of the 12 RGB_OUT
    pins) already uses 39 of its 40 fan-in, and any new per-bit colour path adds
    8. Form C fits at 120/128: the literal writes cmp_color1 and selects it, an
    ordinary one-slot record, no KEEP/HOLD. Streaming RUN fits at 126/128 on the
    production chip; the two do not fit together. Ladder, seam constants and
    the bench in RESULTS.md.
    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
2026-10-03 cpld/experiments/literal: part 2, all pins free
    Form A (the always-two-slot literal) fits once the pinout is released:
    123/128 alone, 114 with HOLD on a 10-bit counter, and 118/128 with HOLD and
    streaming RUN together (pass 1, >= 5 fan-in spare in every block). Form B
    with KEEP fits no pinout; without KEEP it fits at 118 with no fan-in spare.
    An earlier run found a swap of four RGB_OUT pins with four VIDCMD_Q pins
    (8 pins moved) is enough for the 118/128 rung.
    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
2026-10-03 COMPOSITOR: LITERAL (form A), HOLD and streaming RUN; RUN_COLOR removed (package 1)
    The fitted rung R4st becomes production: LITERAL {00,11,colour12} holds the
    bank for its slot and always paints two slots; the fourth source is KEEP;
    HOLD is a RUN with count bits 11:10 = 0x, a streaming RUN 10 (SETs behind it
    execute while it counts, so a late word recolours late and the geometry
    holds), an ordinary RUN 11 with a 10-bit count -- every old RUN of 1..1023
    is valid bit for bit. 118/128 LC, 355 PT, pass 1, tightest block 34/40.
    Pinout PROPOSED rev-2, not frozen: four RGB_OUT pins swapped with four
    VIDCMD_Q pins. compositor_tb 258 checks with hand-derived expectations and
    five mutants; pixel, t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
2026-10-03 video: model, suite, emulator, apps and docs follow LITERAL / HOLD / STREAM RUN (package 2)
    descriptor.h: vidcmd_literal, vidcmd_hold, vidcmd_stream_run, a 10-bit
    vidcmd_run; RUN_COLOR and its helpers retired; the planner follows the
    RTL's consume rule. CompositorUnit equation-for-equation with compositor.v
    (streaming, literal hold, KEEP); 56 bench-derived traces reproduce
    compositor_tb's constants and never disagreed. Suite re-authored without
    RUN_COLOR; new m14 cases: literal rows exact at every x incl. 0..2,
    painter's-order slicing from static rows with no seam word, LITERAL+HOLD
    spans, a stream run that keeps its geometry under a late word, palette
    writes inside a stream run, FIFO lead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
2026-10-04 ABI: app descriptor carve 32 KB -> 56 KB; the display-list window is the whole page
    GRIFFIN_APP_DESC_BASE 0x3F2000, GRIFFIN_APP_DESC_BYTES 0xE000 (7,168
    descriptors). The firmware's console list moves to 0x3F0000 and the stack
    top with it. ROM 130,692 bytes; console boots, check-dma-stall and the suite
    pass, apps rebuild unchanged.
    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
2026-10-04 cursor: the per-line recipe is the default; the whole-frame chain is the advanced one
    Every line carries one fixed 4-word VIDCMD record delivered a line early: lines
    without the cursor point at one shared 640-slot passthrough record, the 16
    cursor lines at per-row records (gap RUN, MASK, tail RUN, exactly 640 slots).
    An x move patches at most three words a row, a y move re-points at most 32
    descriptors. ENGINE cost 10,560 SYSCLK a field (4.52%).
    Suite m15-cursor-per-line: pixel-exact at twelve positions and eight moves,
    six negative controls fail as designed; m12 (the chain, now
    griffin_cursor_chain.h) unchanged. Mandelbrot uses the per-line cursor.
    Known limit, recorded in griffin.log: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
2026-10-04 image-tools: fixup_encode and the .gcx picture, half-rate 16 colour with COMPOSITOR fix-ups
    A .gcx is a memory image: the 320x480 4bpp pixel plane, every line's VIDCMD
    words, and the ENGINE descriptor list prebuilt with file-relative sources.
    Group g carries line g's 80 PIXELS words and line g+1's packet, every line is
    framed at exactly 640 slots, and the default 82 VIDCMD words a line is the most
    that fits at arbitration 8 (414 SYSCLK at arbitration 4, limit 442).
    Per line: a few palette loads in hblank, then LITERAL (one exact pixel a word),
    LITERAL + HOLD (flat span), MASK (16 slots at 640 resolution, undithered only)
    and RUN(passthrough), chosen by a per-line dynamic programme run in pa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
2026-10-04 apps/view shows .gcx pictures; the view command leaves the ROM
    VIEW FILE.GCX reads the file into the heap, relocates its prebuilt descriptor
    list into the app carve and re-arms it at every polled vsync until Enter. No
    per-line CPU work.
    firmware/rom.cpp loses view, view_gc4, dl_build_gc4_list, the legacy 1bpp
    viewer and the DL_VIEWER_* regions; the console list is the firmware's only
    display list. ROM 130,692 -> 122,436 bytes. .gc4 files have no viewer now
    (smurf still reads its own).
    Emulator headless screenshots of VIEW MAYA2.GCX and VIEW ADOBE2.GCX differ
    from the encoder's preview in 0 of 307,200 pixels. Not run on hardware.
    griffin.log and the datasheet's image-viewer recipe carr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
2026-11-06 Rev-2 schematic to current design, RTC package, GLUE testbench, FIFO write buffers
    Board (rev 2 schematic; PCB and gerbers remain rev 1):
    - Sheets are now generated: board/cpld_map.py maps the six CPLDs to
    sheets, place_parts.py builds a sheet from a spec in board/sheets/,
    check_cpld_pins.py diffs every CPLD pin against the Verilog from a
    kicad-cli netlist export; label_cpld.py, layout_root.py,
    new_cpld_sheet.py, relabel_pins.py, remove_symbol.py do the rest.
    - New sheets: audio, audio-amp, engine (was expansion), panel, rtc,
    serial, vga; composite, mmu and test-points removed; root sheet on A3.
    - Two pairs of 74AHCT541 take the 7200 write data off the main bus
    (D_VIDEO_FIFO, D_A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
2026-11-06 BERR timeout as one GLUE fact; CPU probe and two-layout bus-error dump; emulator bus errors; rev 1 dead
    griffin.yml / codegen:
    - GLUE berr_timeout_clocks: 15 is the one bus-error timeout; the DUART's
    unconsumed berr_timeout: 256 is deleted (hw_schema.yml follows). codegen
    emits GLUE_BERR_TIMEOUT_CLOCKS (C++, .inc, .vh) and clamps every fixed
    DTACK threshold below it instead of a hard-coded 14. glue.v and
    glue_tb.v take the define. Generated thresholds unchanged; glue-sim
    74/74 plus 8 negative controls; GLUE re-fit 120/128 LC, 334 PT, pinout
    identical.
    - OPR reset state stated: the 68681 RESET pin clears OPR, so OP4..OP7 come
    up 1111 with no firmware action, and 1111 selects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
2026-11-07 IO data buffers: 74AHCT245 pair isolates GLUE, CF, DUART and PORTS from the main bus
    Item 4 of the open list, both parts. griffin.log 2026-11-06 carries the
    derivations from the datasheets on hand: the ENGINE deposit setup through
    the 74AHCT541 is safe (+19 ns at 14 MHz with -15 CPLDs, estimates
    included); the per-lane capacitance tally puts D[7:0] at ~164 pF of pins
    plus trace, over the 68010's 130 pF AC test load and the ~150 pF
    reopening threshold. Brad chose the conservative fallback.
    Schematic (glue sheet, board/sheets/io_buffers_spec.py):
    - U49/U50 74AHCT245: A = D_IO[15:0] (peripheral branch), B = D[15:0],
    DIR = R/~W, /OE = ~IO_BUFFER_OE; C92/C93 bypass.
    - R158/R159 10k SIP-9 pul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
2026-11-07 CLUT_INDEX post-increments after every palette write; two-word run-on entries
    pixel.v advances clut_index on the edge that ends the pulse clock (F wraps
    to 0); IDX is registered off the old value on that edge so the hold clock
    keeps the written address, and the next clut_data SET lands in the next
    entry. A clut_index SET sets, never adds, and outranks the increment.
    PIXEL 125/128 LC, 400 PT, pinout unchanged.
    pixel_tb.v case clut-autoinc with mutants 10 and 11; clut_pair_tb.v D6 and
    case S2r; render.cpp PixelUnit increment with SET precedence; suite S2r and
    run-on identity load; griffin.yml VIDCMD_WORDS_PER_CLUT_NEXT_ENTRY = 2;
    descriptor.h vidcmd_palette_next() and palette_table_words();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
